11lisov11/mic_practice/artifacts/ipm_sd_fix_20261006/REPORT_RU.md

# Исправление SD и рабочая прошивка, 06.10.2026

## Итог

Исправлена реакция реального MCSDK-образа на внешний SD/BKIN.
Новый build Nucleo: 2026100601. Он установлен и проверен на плате.
UNO Q остаётся на рабочем build 2026092901; Linux HMI ранее обновлён.
Конечное состояние SAFE/VF, PWM=0, частота=0, disarmed, HV-профиль.
Сеть, силовая шина и двигатель в этом прогоне не включались; J4 не включался.
Разрешение на моторный пуск от сети этим отчётом не выдаётся.

## Изменение кода

В TIMx_BRK_M1_IRQHandler оба источника BRK/BRK2 теперь вызывают
PWMC_DP_Handler вместо PWMC_OVP_Handler. SD больше не классифицируется
как перенапряжение и не устанавливает BrakeActionLock.
Пороги Vbus, температура, PWM, deadtime и AutomaticOutput не ослаблялись.
Регрессионные guards в preflight и safety-check отвергают возвращение OVP.
При регенерации проекта эту проверку нужно прогонять, иначе изменение
сгенерированного IRQ-файла может быть перезаписано Workbench.

## Доказательства

| Проверка | Результат |
|---|---|
| STM32CubeIDE сборка | 0 ошибок, 0 предупреждений |
| Реальные C-функции IRQ/DP с host stubs | 4 комбинации флагов Break прошли |
| Программные тесты | 20 групп прошли |
| Настройки BKIN на работающей Nucleo | 13 проверок прошли |
| Flash Nucleo | 39020 байт побайтово совпадают с BIN |
| Живые команды Wi-Fi | 8 командных проверок прошли; без ARM |
| Рабочий простой | 60 отсчётов, 48,734 с, +850 UART сообщений, max age 51 мс |
| PWM в простое | Все шесть выходов LOW |

BIN/readback SHA-256:
71a3b59b1fdca9c8fd0e01326e0467c3c40da08246341204a1995b7bf6ef7c82.
HEX SHA-256:
62860c54b1b45c718567373fad7f2c38dc3d6587c0992ff8fa094b8e102d5fb6.

### Реальный IRQ, без генерации PWM

Выполнено внутреннее событие TIM1 EGR.BG при уже снятом MOE.
Адреса CurrentFaults/PastFaults получены из DWARF именно прошитого ELF;
они не угаданы по layout структуры.
PastFaults: 0x0004 -> 0x0404; добавился MC_DP_FAULT=0x0400,
MC_OVER_VOLT=0x0002 не добавился. Saleae одновременно записал все шесть
выходов LOW; Wi-Fi продолжал показывать SAFE/PWM=0.
Тестовый DP-флаг очищен перезапуском того же рабочего образа:
PastFaults вернулся к 0x0004, штатному undervoltage при нулевой шине.

Это проверка программного IRQ на реальном MCU при выключенном PWM.
Она НЕ является новым физическим замыканием SD и НЕ подтверждает
активный shutdown силовых ключей под напряжением.
Первая попытка сохранила регистры, но не смогла экспортировать Saleae
из-за относительного пути; pass=false сохранён. Повтор с абсолютным
путём прошёл: internal_break_no_pwm_retry/report.json.

## Пакеты

Обновлены firmware/ready_to_flash, ready_to_flash_vf_air56b2_20260929,
готовый датированный ready_to_flash_sd_20261006 и все три ZIP.
По 30 артефактов проходят проверку; содержимое ZIP сверено с manifest.
Прежние Nucleo-образы сохранены в previous_release_images для восстановления.
Старые осциллограммы не переобозначены как проверка нового HEX.

## От оператора сейчас ничего не требуется

Принято его сообщение: перемычки штатные заводские, 15 В на драйвере нет.
Фото, перестановки перемычек и повторное замыкание через 1 кОм не запрашиваются.
Это исходные условия оператора, не заявленная независимая проверка перемычек.

После смены build нулевая точка Vbus заново связана с текущей идентичностью
через штатный API: использовано ранее подтверждённое оператором 0 В при той же
обесточенной конфигурации, собрано 20 новых MCU-отсчётов. Прежняя запись
сохранена. Высокая точка не выдумана и HV-разрешение не выставлено.

## Граница следующего этапа

Программный дефект SD исправлен, рабочие образы на платах актуальны.
Следующий контролируемый этап — питание драйверов J4 +15 В при физически
отключённом силовом источнике/DC-вводе, без ARM/START: оценить SD и датчики
через Wi-Fi. Это не разрешение подключать 220 В.
Внешний soft-start, реальные силовые токи/напряжения и работа ключей ещё
не испытаны этим прогоном. Формальные powered-HIL gates остаются открытыми;
нельзя закрыть их компиляцией, прежней диагностикой или нулевыми показаниями.
