11lisov11/mic_practice/artifacts/power_stage_audit_20261006/REPORT_RU.md

# Пассивная проверка силового тракта, 06.10.2026

Последующее исправление выполнено и установлено: Nucleo build 2026100601.
Актуальный результат: artifacts/ipm_sd_fix_20261006/REPORT_RU.md.
Ниже сохранены первоначальные findings, а не описание текущего дефекта.

ШИМ, ARM, START, питание, flash, reset и halt в этом прогоне не включались.
Прочитаны телеметрия по Wi-Fi и регистры G431 через ST-Link HOTPLUG.
Реальный силовой тест IGBT при нагрузке этим прогоном не выполнен.

## Что подтверждено на работающей прошивке

`live_readonly_retry/report.json`: все 13 проверок регистров прошли.
MOE=0; TIM1 Break включён; внешний BKIN активен LOW; инверсия источника
соответствует полярности Break; AutomaticOutput выключен. Interrupt BIE и
NVIC включены. PA6 настроен как AF6 TIM1, open-drain с pull-up, уровень HIGH.
До/после: SAFE, PWM=0, disarmed, Vdc=0, живая связь. Исходный регистровый
журнал сохранён в `registers.log`. Замыкание через 1 кОм повторно не требуется.

## Найденное несоответствие ПО

В `Src/stm32g4xx_mc_it.c` текущего MCSDK-проекта обработчик внешнего BRK
вызывает `PWMC_OVP_Handler`, устанавливающий OverVoltageFlag и BrakeActionLock.
В штатном профиле ST `STEVAL-IPM15B.json` линия MC1 описана как DriverProtection,
активная LOW. Сам IPM формирует SD при OC и UVLO; это не измерение перенапряжения
DC-шины. В библиотеке есть специализированный `PWMC_DP_Handler` с отключением
PWM и driverProtectionFlag. Требуется согласовать IRQ и конфигурацию проекта
с этим источником. Проверка исходников намеренно возвращает false.

Это не доказательство отказа аппаратного Break: его настройка подтверждена.
Это неверная программная классификация/обработка источника аварии. Силовое
включение не выполнялось; текущие MCU-образы этим аудитом не изменялись.
Дальнейшая правка требует сборки нового идентифицированного образа и тестов;
нельзя объявить старый HEX исправленным только по изменению исходников.

Источники: [схема STEVAL-IPM15B](https://www.st.com/resource/en/schematic_pack/steval-ipm15b_schematic.pdf),
[STGIB15CH60TS-L, раздел 4](https://www.st.com/resource/en/datasheet/stgib15ch60ts-l.pdf),
локальный официальный профиль ST MC SDK 6.4.2:
`Utilities/PC_Software/STMCWB/assets/hardware/board/power/STEVAL-IPM15B.json`.

## Перемычки: заводская конфигурация со слов оператора

Прошивка использует Rshunt=0,04 Ом, усиление 2,1 и температурную модель
штатного NTC: V0=0,408 В при 25 C, gain=0,025 В/C. Эти параметры соответствуют
профилю ST. TSO и NTC нельзя считать взаимозаменяемыми при одном коэффициенте.

| Перемычки | Ожидаемая конфигурация |
|---|---|
| SW1, SW2, SW4 | 1–2: усиленные токовые сигналы |
| SW3 | 2–3: NTC; не 1–2 TSO |
| SW5, SW6 | Разомкнуты: режим не single-shunt |
| SW7, SW8 | Замкнуты: три раздельных шунта |

Сверено визуально по UM2014, рисункам 4 и 7; SW3 дополнительно указан в
профиле ST. Оператор сообщил, что ничего не менял относительно завода.
Это принято как исходное условие; запрос фото снят. Независимая визуальная
проверка не заявляется. Ничего переставлять не требуется.

## Сохранённая проверка Vbus

На UNO Q найден один файл `~/.config/mic-ai/vbus_calibration.json`:
есть zero, meter=0 В, 20 отсчётов; high отсутствует. HMI сообщает
`known-HV capture is required`. Это описание сохранённого результата,
не утверждение, что оператор никогда раньше не выполнял измерение.
Повторное измерение в этом прогоне не запрашивалось и не выполнялось.

## Что нельзя подтвердить удалённо сейчас

Без питаемого силового тракта и независимых измерений нельзя проверить
выпрямитель/soft-start, фактические напряжения J4 и bootstrap, проводимость
IGBT, ток под нагрузкой, изоляцию и целостность силовых проводов. Saleae на
выводах Nucleo не измеряет эти величины; уровень SD HIGH не доказывает их.
Моторный пуск остаётся неподтверждённым. Несоответствие IRQ уже устранено
и проверено последующим прогоном; повторная фотография не требуется.
