11lisov11/mic_practice/artifacts/current_pwm_20261007/async_clear_708/REPORT_RU.txt

ОБНОВЛЕНИЕ ДИАГНОСТИКИ 2026100708: УСТАНОВЛЕНО И ПРОВЕРЕНО

Условия
Оператор отключил силовое питание, затем 15 В J4. Перед обновлением
пассивные проверки дождались шины <=2 В, SAFE, PWM=0 и ARM=0.
В этом прогоне двигатель не запускался; ENABLE/START не выдавались.

Что изменено
Nucleo: исправлен повторный захват пустого MCSDK_FAULT после CLEAR,
когда ACK уже очистил маски, но scheduler еще не перевел FAULT_OVER в IDLE.
Захват реальных масок и FAULT_NOW сохранен; блокировка ENABLE при
FAULT_OVER, реакции на UART_NE, watchdog, BKIN и остальные защиты сохранены.
Сверка SHA256 реконструированного исходника 707 подтвердило, что изменены
только build ID и условие захвата диагностического снимка. ADC, PWM и
силовые параметры в этом обновлении не менялись.
Uno Q: новый ID и разрешение декодирования диагностики Nucleo 708.
Linux HMI: сохранение ответа START и быстрых переходов в истории аварии,
без дополнительных RPC во время START; сохранена исходная калибровка.

Проверки на ПК
41 проверка исходного async-ACK сценария воспроизвела старую ошибку.
41 проверка исправленного сценария PASS.
412901 проверка production UART/control, 262144 сочетания команд,
256 однобитных повреждений и обнаружение 10 мутаций PASS.
66312 проверок декодера, 48 flight-recorder, 162 guard,
38 calibration identity, 41 безопасной установки,
12 доступа/heartbeat/STOP и 26 допуска ограниченного пуска PASS.
Статический контракт Uno/Nucleo PASS после актуализации ожидаемых build ID.
Это программные проверки, не измерение силовых токов или напряжений.

Запись и проверка плат
Uno Q 708 записан; loader/sketch verification PASSED (uno_verify.log).
Nucleo 708 записан; CubeProgrammer download verify PASSED.
Дополнительное считывание 40676 байт Nucleo побайтно совпало с BIN.
MCU IDs из Wi-Fi: 2026100708 / 2026100708, диагностика valid=1.
30 пассивных контрольных опросов за 42,292 с: +682 корректных сообщений,
bad_count=0, ошибок integrity/sequence нет. Все наблюдения SAFE/PWM=0/ARM=0,
в начале и в конце шина 1 В.
MCSDK_UNDER_VOLT при выключенной шине ожидается и не маскируется.

Промежуточные остановки установщика сохранены, а не удалены:
install_attempt1.json: Uno записан, Nucleo защелкнул timeout при перезапуске peer.
После проверки выключенных выходов и шины <=2 В выполнен только CLEAR.
install_attempt2.json: обе платы записаны, проверка остановилась на чтении
шины >2 В непосредственно после reset. До дальнейших действий выполнен
новый пассивный опрос: шина 1 В. Затем проведены readback и проверка связи.
Причина краткого показания >2 В отдельно не установлена; обход порога не применялся.
Итог: install_report.json, RESULTS.json; все команды восстановления записаны.

Хэши
Nucleo HEX: 1999ec79cce0bd36110c7b1a9f5481a3417577e032882da2110fad1065c2a6b0
Nucleo BIN: 66a0851c0d129ef9a4edbe5457a4ef8f4b0e6b5e2aad797e75842b03e47a2cce
Uno sketch: 774f2e06ef8719caaeea09f6381d2cf2c2293125e43d54370339764ea2c1e3be
Linux HMI: fbf9de8e875f4ecc565a8385c3f4c6e4f4d81b0bbd0c630c5b14308d10d82fbf
Исходная калибровка: a89603c26f3dfa6287c304134121028db6ebdb9adeda4b58d99040530ffeea17
Хэши HMI/калибровки подтверждены на плате после обновления.

Ограничения
UART_NE и I2C сбой при силовом ШИМ НЕ устранены этим обновлением.
Их физическая причина пока неизвестна. Движения в последнем HV-пуске не было.
Силовой запуск, фазные токи/напряжения, автономная устойчивость под коммутацией
и скорость AS5600 не приняты. Это не разрешение на следующий HV-пуск.
Готов архив diagnostic_update_2026100708.zip с точными образами и манифестом.
Предыдущий полный ready_to_flash пакет не заменялся.
Следующее действие: проверить реальные соединения UART/GND и питание плат/датчика
на обесточенном стенде, затем выбрать безопасный способ измерения помех при коммутации.
