11lisov11/mic_practice/artifacts/current_pwm_20261007/fault_context_logging_r1/REPORT_RU.txt

Логирование аварий установлено на Linux Uno Q 07.10.2026.

Установленный server.py:
8091c26a8e260ff016ff116ac21436a72b2fbce6b637c2508cdba15f5c748d64
Резервная копия предыдущего сервера:
/home/arduino/ArduinoApps/UNOQ_MOTOR/web_hmi/backups/vbus_reuse_20261007_161547
Прошивки Uno Q и Nucleo не изменены: обе 2026100707.
Калибровка не изменена; SHA256 файла:
a89603c26f3dfa6287c304134121028db6ebdb9adeda4b58d99040530ffeea17

Новый формат: MC_FAULT_CONTEXT, schema mic_ai.fault_context.v1.
При новом событии сохраняются последние доступные наблюдения за 5 секунд,
снимок аварии и дальнейшие наблюдения за 5 секунд под одним event_id.
Объём памяти ограничен 64 снимками. Во время активного управления берутся
существующие опросы watchdog; в простое добавлен опрос раз в секунду,
чтобы собирать предысторию даже без открытой страницы телефона.
Обычный STAT может ограничиваться частотой, запись нового события — нет.

Записываются UART NE/FE/ORE/PE, первая причина и последняя причина роста
счётчика, seq, снимок масок MCSDK, PWM/state, напряжение и его свежесть,
температура, ошибки/состояние I2C AS5600, параметры связи и идентичности.
Шаблон первого диагностического снимка MCSDK не выдаётся за текущую
аппаратную маску; отметка времени — момент наблюдения Linux, не точное
время аппаратного IRQ. Между опросами возможны незафиксированные импульсы.
Поля токов/скорости Uno Q не используются как доказательство физического
тока или вращения двигателя. Источник электрической помехи не установлен.

Событие хранится в существующем persistent-журнале Uno Q и выгружается
по Wi-Fi через защищённый /api/logs. В /api/status доступны
hmi_fault_log_schema, hmi_last_fault_event_id, hmi_last_fault_summary.
Холодный старт закономерно имеет пустую предысторию; дальнейшие события
получают накопленные снимки. Ротация журнала ограничивает срок хранения.

Проверки:
43 проверки регистратора, включая проигрывание неудачного силового пуска,
сохранение NE и роста I2C 0->5, параллельные запросы без дублей,
ограничения памяти, сброс/CLEAR, выгрузку JSON и автономный холостой опрос.
66056 проверок декодера причин, 162 проверки защит HMI,
12 проверок доступа/heartbeat/STOP, 35 проверок калибровки,
37 проверок безопасной установки сервера — пройдены.
Живая проверка: 671 новое сообщение за окно приблизительно 30 секунд,
новых ошибок нет; SAFE, PWM=0, ARM=0. По Wi-Fi скачаны 6 новых блоков
регистратора: одно событие низкого напряжения при старте сервиса и
5 последующих снимков. Это не новый силовой пуск и не доказательство
устранения помех UART.

Следующее действие оператора:
Для отдельного диагностического повторного пуска убрать USB обеих плат
от ПК и все провода логического анализатора, включая GND. Оставить
автономное питание и Wi-Fi. Силовой ввод до проверки автономного состояния
не подавать. После готовности выполняется отдельный ограниченный тест;
ошибка не игнорируется, защиты и обязательный STOP остаются включены.
