11lisov11/mic_practice/artifacts/current_pwm_20261007/full_debug_r1/REPORT_RU.txt

Дебаг стенда и программной части, 07.10.2026

Область: USB-подключённый обесточенный стенд, команды по Wi-Fi,
проверки кода на ПК и индикации. Это НЕ приёмка силового пуска двигателя.

Найдены и исправлены:
1. Веб-ползунок показывал локальную рабочую уставку freq вместо принятого
   задания freq_cmd. Задание теперь постоянно видно числом; проверены
   нулевое задание, режим SAFE, перетаскивание и некорректные числа.
2. Пассивная проверка связи ошибочно считала остановкой UART насыщение
   счётчика корректных пакетов на 65535. Теперь учитывается изменение
   номера принятого ответа; неизменный номер и устаревшие данные не проходят.
   После насыщения точное количество новых пакетов не заявляется.
3. Истёкший срок самотеста матрицы не очищался и мог снова считаться активным
   примерно через 25 суток. Исправлены очистка срока и переход millis через
   ноль. Общая функция используется и отрисовщиком, и телеметрией.

Установлено:
- Uno Q MCU: 2026100709; запись и независимая проверка образа прошли.
- Nucleo: остаётся 2026100708, в этом прогоне не перепрошивалась.
- Linux HMI и веб-индикация обновлены, резервные копии сохранены на Uno Q.
- Файл калибровки не изменён, совместимость подтверждена тестами.
- Отдельная обратная реконструкция исходника 708 побайтно подтверждает:
  изменения Uno ограничены идентификатором и временем самотеста матрицы.
  Алгоритмы управления, ADC, UART, защиты и формат измерений не менялись.

Подтверждено:
- 17 из 17 выбранных программных наборов тестов прошли на конечном коде.
  Это не утверждение о выполнении всех существующих тестов репозитория.
- 8 браузерных сценариев прошли на desktop/mobile; все запросы перехвачены,
  команд стенду браузерные проверки не посылали.
- Отрисовщик: 1000 значений частоты, 48148 проверок; тесты обнаруживают
  намеренную подмену задания нулевой уставкой и всех цифр нулём.
- На самой Uno Q прочитана SRAM матрицы без сброса, останова CPU и записи.
  Кадры для 0, 5 и 20 Гц соответствуют ожидаемым 104 пикселям;
  изменяющийся индекс сканирования подтверждает работу таймера матрицы.
- Повторный 30-секундный пассивный прогон после прошивки: 393 новых
  корректных сообщения, максимальный возраст ответа 49 мс, новых ошибок нет.
- AS5600 отвечает по I2C без ошибок, но сигнализирует слабое магнитное поле:
  enc_status=0x33, enc_ok=0. Угол и скорость не квалифицированы как измеренные.
- На конечной версии по Wi-Fi приняты MODE VF и задания 5/20/0 Гц,
  подтверждён STOP, выгружены журналы. Проверка прошла только без включения
  ШИМ; ARM/START не выдавались. Финально SAFE, ШИМ 0, задание 0, ARM 0.

Что остаётся открытым:
- Наблюдаемое пользователем свечение матрицы: результат видимого самотеста
  ещё не получен. Правильные кадры и работа таймера не заменяют фото/наблюдение
  физических LED. Причина сообщения «постоянные нули» пока не установлена.
- Причина UART NE при предыдущих силовых пусках не установлена. Исправление
  индикации и проверки счётчика не устраняет и не доказывает устранение NE.
- Питание от PC USB не подтверждает автономный общий провод после удаления
  отдельного GND-проводника UART.
- Release preflight не проходит два аппаратных пункта: подтверждение
  автономного soft-start и связанное с образом свидетельство SD/BKIN.
  Статические настройки и host-тест SD проходят, новые измерения силового
  тракта и аппаратного отключения в этой сессии не выполнялись.
- Старые готовые к прошивке пакеты автоматически не заменялись; актуальный
  образ Uno находится в подпапке uno_matrix_709 этого отчёта.

Итог: программный прогон выбранных частей и низковольтная связь проходят.
Полная приёмка проекта, физическое исправление матрицы и успешный пуск
двигателя НЕ объявляются. Силовое включение этим отчётом не разрешается.

Основные доказательства: RESULTS.json, regressions_709/report.json,
matrix_709_live/report.json, passive_709/report.json, matrix_709_install.json,
matrix_only_source_audit.json, release_preflight.json.
