11lisov11/mic_practice/artifacts/current_pwm_20261007/ground_wire_removed_usb_wifi_commands_r1/REPORT_RU.txt

ПРОВЕРКА ПОСЛЕ УДАЛЕНИЯ ОТДЕЛЬНОГО ПРОВОДА GND, USB ПЛАТ К ПК ОСТАЮТСЯ

07.10.2026, Uno Q / Nucleo: 2026100708 / 2026100708.
USB Uno Q обнаружен ADB, Nucleo обнаружена как ST-Link COM13.
Телеметрия перед тестом: SAFE, PWM=0, ARM=0, шина 0 В, UART counters=0.
Удаление провода сообщил оператор; маршрут общей опоры не измерен.

Пассивный прогон: ../ground_wire_removed_pc_connected_r1/report.json.
За окно наблюдения 30 с получено 389 новых корректных UART сообщений.
Максимальный наблюденный возраст UART: 53 мс.
Новых ошибок UART (включая аппаратный bad_count), integrity/sequence и I2C нет.
AS5600 отвечает, но magnet_angle_valid=false: скорость/угол не приняты.

Функциональная проверка по Wi-Fi: report.json и wifi_logs.txt.
MODE VF, SET FREQ 5, SET FREQ 20, SET FREQ 0 приняты.
Задания freq_cmd проверены отдельными чтениями телеметрии.
STOP подтвержден; все наблюдения SAFE/PWM=0/ARM=0 при нулевой шине.
ARM/START не выдавались, защиты не отключались, MCU не перепрошивались.
Изменение задания не означает измеренную электрическую частоту или вращение.

ОГРАНИЧЕНИЯ
USB обеих плат к ПК может обеспечивать общую землю через компьютер.
Этот прогон не доказывает общую опору после отключения ПК и не проверяет
устойчивость UART/I2C при коммутации силового инвертора.
Нельзя заключать, что устранены UART_NE или причина неудачного HV-пуска.
Следующий отдельный этап: автономная схема питания с подтвержденной общей
опорой для прямого UART, сначала без силового. Силовой тест при USB к ПК
для этого неизолированного стенда не выполняется.
