11lisov11/mic_practice/artifacts/current_pwm_20261007/production_trial_707_logging_r2/REPORT_RU.txt

ПУСК 07.10.2026 С РАСШИРЕННЫМ ЖУРНАЛОМ: НЕУСПЕШНЫЙ

Состояние: рабочие MCU 2026100707/2026100707, команды и журналы по Wi-Fi,
USB плат и анализатор отключены. Запрошен один ограниченный пуск V/f
с заданием 10 Гц. Повторного запуска после отказа не было.

Наблюдения
1. До START: SAFE, PWM=0, шина 322 В, bad_count=0, I2C errors=0.
2. После CLEAR: текущий fault=0, но first_reason сохранил MCSDK_FAULT,
   state=11 (FAULT_OVER), current/occurred masks=0/0, seq=32.
3. START принят: VF_RUN, PWM=1 по телеметрии контроллера, шина 319 В.
   Уже в ответе START AS5600 I2C bus_ok=0, errors=1, io_error=-5.
4. К первому наблюдению тестового цикла (1,297 с от начала запроса START):
   SAFE, PWM=0, bad_count=1, last_bad_reason=12 (UART_RX_ERROR), flags=0x04 (NE).
   Wi-Fi heartbeat без ошибок; шина 322 В. I2C связь к этому моменту восстановилась.
5. Финальный STOP подтвержден HTTP 200, SAFE, PWM=0, ARM=0, estop=1.
6. Оператор сообщил: вал не двигался, силовое питание выключено.
7. Последующий пассивный опрос: SAFE, PWM=0, ARM=0, шина 30 В.
   Это не подтверждение полного разряда и не разрешение подключения USB.

Полный журнал аварии
event_id: 5e3cada2c7bc5e12
7 наблюдений до ошибки и 5 после; последнее через 4,291 с после обнаружения.
История и хронология: fault_context_complete.json, fault_timeline.json.
Полный экспорт по Wi-Fi: wifi_logs_complete.txt.
Точность времени: время наблюдения Linux/RPC, не время IRQ микроконтроллера.
Самостоятельная история журнала не содержала короткого VF_RUN; его подтверждает
сохраненный start_response в report.json. Локальная доработка устраняет этот пробел.

Что установлено и что НЕ установлено
Команда по Wi-Fi дошла; контроллер сообщил работающий PWM, затем отказ RX UART.
Программная остановка с фиксацией ошибки подтверждена телеметрией.
Одновременное ухудшение UART/I2C воспроизвелось во втором HV-пуске.
Это основание исследовать сигнал RX, опорную землю и питание во время коммутации,
но не доказательство конкретного кабеля, источника помех или просадки питания.
Физические импульсы IPM, фазные напряжения и токи в этом пуске не измерялись.
Скорость AS5600 невалидна; местные speed/freq/ia/ib/ic Uno не являются
подтвержденными измерениями скорости и фазных токов двигателя.
Нельзя считать двигатель, силовой тракт или устойчивость UART при PWM принятыми.

Найденная отдельная ошибка диагностики
MCI_FaultAcknowledged очищает PastFaults и ставит команду ACK, но FAULT_OVER -> IDLE
происходит в следующем medium-frequency task. uno_send_reply успевает снова
записать MCSDK_FAULT с пустыми масками после CLEAR. Так исторический снимок
маскирует первую причину следующего отказа; поле last_bad все же сохраняет NE.
Раньше host mock MC_AcknowledgeFaultMotor1 синхронно устанавливал IDLE
и не моделировал этот переход.

Новый offline-тест: ../async_clear_diagnostics_r1/report.json.
Исходный код воспроизвел ошибку (41 проверка), диагностический кандидат
сохранил реальную первую причину (41 проверка). Кандидат меняет только
условие захвата пустого FAULT_OVER-снимка. FAULT_NOW, реальные fault masks,
запрет ENABLE при FAULT_OVER и остановка по NE сохраняются.
Кандидат проверен с host mocks, не собран и НЕ прошит на Nucleo.
Он исправляет атрибуцию ошибки, а не причину UART_NE.

Локальная доработка Linux-журнала (НЕ развернута на стенде)
Сохраняется уже полученный ответ при подтверждении START, без дополнительных RPC.
Краткие переходы state/PWM/fault/I2C сохраняются внутри обычного интервала
дискретизации; буфер по-прежнему ограничен 64 наблюдениями и окном 5 с.
48 проверок recorder PASS; 162 guard PASS; 66056 decoder PASS;
12 access/heartbeat/STOP PASS; 35 calibration identity PASS.
Защиты, калибровка, MCU прошивки, параметры PWM не менялись.

Дальше
Не повторять HV-пуск без разбора устойчивости UART и питания при коммутации.
Сначала завершить разряд; подключение ПК только после отключения силового ввода
и проверки напряжения мультиметром. Затем проверить реальные маршруты
RX/TX/GND, места соединения общих проводов и питание Uno/Nucleo/AS5600.
Измерения на включенном неизолированном силовом стенде требуют подходящих
изолированных средств; обычный USB-анализатор не использовать.
Не отключать реакцию на NE и не снимать защиты ради продолжения вращения.
