11lisov11/mic_practice/artifacts/live_bench_20261008/read_only_connected_r1/REPORT_RU.txt

ПАССИВНАЯ ПРОВЕРКА ПОДКЛЮЧЁННОГО СТЕНДА, 08.10.2026

Установленные версии по телеметрии: UNO Q 2026100709 / Nucleo 2026100708.
Подготовленная версия Nucleo 2026100801 ещё не записана.
Не выполнялись START, ARM, CLEAR, STOP, сброс или прошивка плат.

Wi-Fi и UART
Статус и журналы получены через HTTP по Wi-Fi 192.168.1.138:8080,
с транспортом WSL; данные не передавались через ADB-forward.
ADB использован отдельно для инвентаризации и чтения ключа доступа к логам.
За 30-секундный прогон: 399 новых UART-сообщений,
56 наблюдаемых изменений ACK-последовательности, максимальный возраст 52 мс.
Счётчики UART/целостности/последовательности не выросли, ошибок I2C нет.
В выборках SAFE, PWM=0, ARM=0, Vdc=0 по телеметрии, калибровка принята HMI.
Эти сведения не заменяют проверку мультиметром и физического отключения ввода.

Анализатор
Обнаружен физический Saleae A7D1BB81883C0092.
Сохранены capture.sal и CSV, выборка 4 МГц, фактическая длительность 0.24576 с.
Все CH0..CH5: LOW, 0 фронтов. CH6: HIGH, 0 фронтов.
CH6 трактуется как PA6 согласно ранее согласованной разводке;
само соответствие проводов независимо не проверялось.
Первый экспорт с относительным путём завершился ошибкой каталога.
Повтор с абсолютным путём успешен; это не ошибка прошивки.

Диагностика
Текущая зарегистрированная причина: MCSDK_FAULT.
В снимке first_current_mask=0x0004 (MC_UNDER_VOLT), UART flags=0.
Накопленная маска first_occurred_mask=0x0404:
MC_UNDER_VOLT | MC_DP_FAULT. Физическая причина исторического DP-флага
этим пассивным наблюдением не устанавливается; счётчики не очищались.
AS5600 отвечает по I2C без новых ошибок, но enc_ok=0, status=0x33.
Угол не подтверждён как достоверный; показание 340.8 градуса не используется
как доказательство исправности позиционной обратной связи.

Границы результата
Подтверждены Wi-Fi-чтение, продвижение UART и статические уровни входов Saleae.
Не подтверждены активная несущая ШИМ, фазировка, deadtime, реакция BKIN на
работающем ШИМ и работа с силовым питанием.
Новое исправление UART 801 на этой плате пока не проверено, поскольку стоит 708.
Новая ошибка UART в этом прогоне не наблюдалась.
