11lisov11/mic_practice/BLUEPILL_THERMAL_DIAGNOSTIC_RU.md

# Проверка нагрева Blue Pill

Эта процедура предназначена только для платы, у которой нагревается корпус STM32F103. Её нельзя подключать к STEVAL-IPM15B, двигателю или силовой шине во время диагностики.

## Подготовка

1. Полностью снять J7/310 В и 15 В со STEVAL.
2. Отсоединить от Blue Pill все провода: IPM, UNO Q, AS5600, Saleae, реле и датчики.
3. Осмотреть пайку, остатки флюса, перемычки и ориентацию STM32.
4. На обесточенной плате проверить сопротивление между `3V3-GND` и `5V-GND`; явное короткое замыкание блокирует дальнейшее включение.
5. Питать голую Blue Pill от источника с ограничением тока. Начать с лимита `50 мА`; если старт не происходит, поднять не более чем до `100 мА` только для диагностики.
6. Немедленно снять питание, если ток упирается в лимит, корпус STM32 быстро нагревается или температура корпуса превышает примерно `50 °C`.

## Этап 1: минимальная прошивка без UART

```powershell
py -3 -m platformio run -d C:\mic_practice\bluepill_uart_pwm_pio -e bluepill_thermal_diag -t upload
```

Прошивка использует только HSI 8 МГц и коротко мигает PC13 один раз в секунду. Все прикладные GPIO переведены в аналоговый высокоимпедансный режим, SWD оставлен включённым.

Оставить плату включённой не более 2 минут, контролируя ток и температуру. Если сам STM32 греется уже здесь на полностью голой плате, плата считается повреждённой и больше не используется с IPM.

## Этап 2: только UART

Выполнять только если этап 1 не вызвал нагрева.

```powershell
py -3 -m platformio run -d C:\mic_practice\bluepill_uart_pwm_pio -e bluepill_thermal_diag_uart -t upload
```

Подключение UART после запуска:

| Blue Pill | UART-адаптер или UNO Q | Назначение |
|---|---|---|
| `PA2/TX` | `RX` | строка `BLUEPILL_THERMAL_DIAG_UART` раз в секунду |
| `PA3/RX` | `TX` | вход, данные не обрабатываются |
| `GND` | `GND` | только в низковольтном тесте без STEVAL/J7 |

Сначала соединить только `GND` и `PA2 -> RX`. Если нагрева нет, добавить `TX -> PA3`. На обоих UART-сигналах допустим только уровень `3,3 В`.

## Интерпретация

- Нагрев на этапе 1 означает повреждение STM32, платы или стабилизатора/питания.
- Нагрев появляется после соединения UART: проверить перепутанные TX/RX, подачу 5 В на GPIO, питание двух плат от разных источников и обратное питание через сигнальные выводы.
- Нагрев появляется только на полной прошивке: не подключать IPM; проверять конфликт GPIO и внешнюю нагрузку по одному проводу.
- Исправная запасная Blue Pill в тех же условиях является контрольным образцом, но подозрительную плату нельзя возвращать в силовой стенд только потому, что она временно перестала греться.
