11lisov11/mic_practice/docs/AIR56_NAMEPLATE_WEB_AUDIT_RU.md

# Проверка АИР56 по открытым паспортам и совместимости с IPM15B

Дата проверки: 2026-08-21.

## Вывод

Одной надписи `АИР56` недостаточно: серия содержит разные мощности и числа полюсов. Оператор указал именно `АИР56В2`; для первого разомкнутого V/f используем паспортные данные официальной таблицы IEK. Это подтверждает конфигурацию выбранной модели, но не индивидуальные параметры конкретного экземпляра и не заменяет аппаратный допуск к силовому пуску.

Актуальный V/f-проект находится в `mcsdk_reference/AIR56B2_025KW_220V_DELTA_NAMEPLATE_VF_NOT_FOR_HV`. Старый Siemens reference не использовать для этого двигателя.

## Что дают открытые каталоги

В опубликованной таблице серии АИР/DRIVE приведены следующие разные исполнения с рамой 56 мм:

| Маркировка | Pn | n | U | In Delta/Y | Следствие |
| --- | ---: | ---: | --- | --- | --- |
| АИР56A2 | 0.18 kW | 2700 rpm | 220/380 V | 0.93/0.54 A | 1 пара полюсов |
| АИР56A4 | 0.12 kW | 1325 rpm | 220/380 V | 0.84/0.49 A | 2 пары полюсов |
| АИР56B2 | 0.25 kW | 2720 rpm | 220/380 V | 1.24/0.72 A | 1 пара полюсов |
| АИР56B4 | 0.18 kW | 1325 rpm | 220/380 V | 1.14/0.66 A | 2 пары полюсов |

Это только каталожная справка: у разных заводов и исполнений значения отличаются. В частности, опубликованные таблицы не подтверждают прежнее предположение `AIR56, 0.25 kW, 1380 rpm, 380 V Y` для данного экземпляра.

Для подтверждённой оператором модели `АИР56B2 0.25 kW` V/f-профиль `docs/mcsdk_acim_motor_profile.iek_air56b2_catalog_operator_confirmed_vf_candidate.json` использует `220 V Delta`, `1.24 A`, `50 Hz`, `2720 rpm`, `1` пару полюсов. Проверка `--control-mode vf` принимает этот профиль как паспортный кандидат; `--control-mode foc` отвергает его до измерения параметров модели. Оба режима отдельно требуют аппаратных HIL-доказательств.

Источник паспортных величин: [таблица IEK DRIVE](https://cdn-01.iek.ru/media/original/78c31060549010eaa9a1bb1f4f6d2d8cb3155062b138bfd13478f55521c38a47.pdf), строка `АИР56В2`.

## Напряжение и соединение

Официальная страница `STEVAL-IPM15B` указывает вход `125...400 V DC`. На схеме стенда 220 VAC после моста даёт примерно 310...325 V DC. Теоретический максимум линейного действующего напряжения инвертора в этом диапазоне примерно 220...230 V.

Поэтому:

- если на шильдике действительно `220/380 V Delta/Y`, для этой силовой части следует использовать `220 V Delta`; перемычки в клеммной коробке ставятся в Delta, а параметры MCSDK должны быть сгенерированы именно для Delta. `220 V Star` для такого мотора неверно: на каждой обмотке будет около `127 V`, то есть ниже номинала `220 V`;
- вариант `380 V Y` требует около `sqrt(2) * 380 = 537 V DC`, что одновременно выше шины стенда и выше официального предела `400 V DC` платы `STEVAL-IPM15B`; применять его с этой платой нельзя;
- если шильдик содержит только `380 V Y`, этот мотор несовместим с данным 220 VAC + IPM15B стендом без другой сертифицированной силовой части. Не пытаться получать 540 V DC на IPM15B.

Официальные данные платы: [ST STEVAL-IPM15B](https://www.st.com/en/evaluation-tools/steval-ipm15b.html), [UM2014](https://www.st.com/resource/en/user_manual/um2014-1500-w-motor-control-power-board-based-on-stgib15ch60tsl-sllimm-2nd-series-ipm-stmicroelectronics.pdf).

## Дальнейшая идентификация

Для начального V/f измеренные `Rs`, `Rr`, `Lls`, `Llr`, `Lm` и инерция не требуются. Перед FOC их получают на конкретном двигателе с протоколом измерения; каталожные значения нельзя выдавать за измеренные. Физическое соединение обмоток должно соответствовать паспортному варианту `220 V Delta`.

После идентификации создаётся отдельный измеренный профиль и заново генерируется FOC-проект. V/f-прошивка не превращается в FOC заменой одного JSON.
