11lisov11/mic_practice/docs/FIRMWARE_STAGES_RU.md

# Этапы прошивок MIC AI

## Базовая конфигурация

Целевой тракт: `UNO Q -> прямой UART -> NUCLEO-G431RB (STM32G431RBT6) -> X-NUCLEO-IHM09M2 -> STEVAL-IPM15B -> AIR56B2`, обмотки двигателя соединены треугольником на 220 В. UNO Q и Nucleo имеют общую `HOT_GND`, электрически равную `STEVAL J7 DC-`, и в силовом режиме находятся внутри закрытого корпуса; наружу выходит только Wi-Fi. Перед выпрямителем устанавливается автономный сетевой модуль плавного пуска с NTC и собственным внутренним реле. Контакта управления этим реле от Nucleo или UNO Q нет.

В протоколе UART старый бит `0x08` оставлен только для совместимости и всегда равен нулю. Nucleo измеряет шину, ждёт диапазон `250...385 В` непрерывно не менее `3,5 с` и только затем разрешает запуск MCSDK. `STOP`, E-stop, ошибка MCSDK или потеря UART немедленно выключают PWM.

## Последовательность

| Этап | Управление | Роль датчика | Текущее состояние |
|---|---|---|---|
| S1 | ACIM V/F бездатчиковое | не используется | исходники и бинарники собираются; первый аппаратный запуск |
| S2 | ACIM LSO-FOC бездатчиковое | не используется | заблокировано до измерения модели двигателя |
| S3 | принятый S1/S2 | AS5600 только эталон/разметка | I2C и ручное вращение проверены; поле при вращении нестабильно, скорость не принята |
| S4 | LSO-FOC основной | AS5600 только для оценки | AI работает в shadow-режиме и не влияет на PWM |
| S5 | AI-наблюдатель + LSO fallback | датчик не требуется в принятом режиме | заблокировано до HIL и доказанной автоматики возврата |

## S1: первый пуск

Используется только `ACIM-NUCLEOG431RB-IPM15B-VF_OL.hex`. Начиная с версии обеих плат `2026100705`, Uno Q передаёт конечное задание частоты; разгон выполняет только Nucleo. Длительность не менее 3 секунд и ограничение не быстрее 5 Гц/с: для 0→10 Гц задано 3 с, для 0→50 Гц 10 с. Неизменные heartbeat-команды не перезапускают разгон. Начинать с 5 Гц без нагрузки, с ограниченным временем запуска. Затем проверить 10, 20 и 30 Гц. Переход к 50 Гц допускается после проверки токов, температуры, формы PWM, направления вращения и стабильной телеметрии.

S1 считается принятым не по факту вращения, а после сохранения журнала: заданная частота, оценка оборотов, `Vbus`, токи, fault-код, состояние E-stop, тайм-аут связи и подтверждение PWM.

Версия `2026100705` отключает только неприменимый к данной топологии локальный порог тока по неподключённым ADC Uno Q; этот порог сохранён для старого локального PWM backend. Защиты MCSDK/IPM и BKIN не отключены. Токи фаз с Nucleo ещё не передаются как квалифицированное измерение. Потеря диапазона удержания шины `200...385 В` вызывает STOP в основном цикле Nucleo без ожидания новой команды UART; восстановление напряжения не снимает защёлку. Успешное вращение после этих изменений ещё не подтверждено. Результаты: `artifacts/startup_recheck_20261007/RESULTS.json`.

Повторная проверка 07.10.2026: Uno Q обновлена до `2026100706`, Nucleo остаётся `2026100705`. Задание 0 Гц в активном V/f вызывает штатный STOP, а не ENABLE с нулевой частотой. Повторный RUNLIMIT не продлевает уже действующий срок; RUNLIMIT=0 при активном приводе вызывает STOP. Нулевая временная метка при переполнении счётчика больше не отключает лимит. Проверки выполнены на исходном коде с заглушками; физический пуск после обновления ещё не принят.

## S2: LSO-FOC

Бинарник LSO-FOC нельзя формировать как готовый к силовой прошивке из каталожных данных. Перед генерацией нужны измеренные `Rs`, `Rr`, `Lls`, `Llr`, `Lm` и момент инерции с отчётом происхождения. Параметры из демонстрационного проекта ST не являются параметрами AIR56B2.

После заполнения профиля `source_kind=nameplate_and_measurement` отдельный проект создаётся командой:

```powershell
.\tools\prepare_air56_lso_foc.ps1 `
  -MotorProfile C:\path\to\air56_measured.json `
  -OutputProject C:\mic_practice\mcsdk_reference\generated\AIR56B2_LSO_FOC
```

Сценарий берёт LSO-структуру из официального примера MCSDK 6.4.2, переносит только измеренные параметры AIR56B2, сохраняет UNO Q interlock, собирает проект и требует полный release-gate. При неполном профиле бинарник не создаётся.

## S3: AS5600 как учитель

AS5600 не включается в контур первого пуска. После принятия S1 он используется для независимой разметки положения и скорости. Набор данных записывает `tools/capture_as5600_teacher_dataset.py`; файл отклоняется при ошибке датчика, fault-коде, активном устаревшем бите реле или недостаточной доле валидных отсчётов.

Текущий транспорт AS5600: Uno Q `SDA/D20/PB11` и `SCL/D21/PB10`, шина I2C2, адрес `0x36`, 100 кГц. Это контакты возле AREF, не A4/A5 и не Qwiic/I2C4. Питание модуля, поддерживающего 3,3 В, берётся с 3V3 Uno Q; GND общий. Старые схемы с Qwiic требуют актуализации перед монтажом. Драйвер в версии Uno Q `2026100612` опрашивает датчик в отдельной задаче Zephyr и не передаёт его угол в закон V/f. `enc_bus_ok` отражает свежий ответ шины, `enc_ok` дополнительно требует корректного магнитного поля; `enc_speed_ok` отличает валидную оценку скорости от прогрева и пропусков выборки. `enc_init_error`, `enc_scl`, `enc_sda` служат диагностикой, а не доказательством правильного монтажа.

Нельзя подключать AS5600 к UART, связывающему Uno Q MCU и Nucleo. Штатный разъём `Encoder/Hall` STEVAL предназначен для сигналов `A/B/Z`, а не для I2C. Чтение AS5600 ещё не является принятой аппаратной разметкой S3: требуется стабильное поле на полном обороте и оценка точности скорости. Сохранённая проверка Vbus повторяется только при изменении измерительного тракта или неизвестной прошивке; проверенные диагностические обновления сохраняют её согласно `docs/AUTONOMOUS_VBUS_CALIBRATION_RU.md`.

## Диагностика отказа при первом пуске

Пуск 07.10.2026 по Wi-Fi был принят рабочей Nucleo `2026100601`, но к 0,81 с от команды START контроллер уже вернулся в SAFE с кодом `5` и новым `bad_count=1`. Оператор движения вала не наблюдал. Причина этого старого события не восстановлена: прошивка объединяла несколько ветвей отказа в `UNO_FAULT_INTERNAL`. Нельзя называть это установленной перегрузкой, помехой UART или отказом IPM.

В окончательной версии пары Uno Q/Nucleo `2026100704` добавлено наблюдение, не отменяющее защиты и не меняющее V/f:

- первая обнаруженная причина, состояние MCSDK, текущая и накопленная маски MCSDK, последний принятый seq и HAL-статус TX;
- отдельно причина последнего увеличения `bad_count`, последние флаги USART `PE/FE/NE/ORE` и статус передачи;
- первая причина не заменяется STOP/ESTOP; сброс выполняется только штатным чистым CLEAR;
- причина выводится в API и HMI, запись `MC_FAULT_DIAG` не ограничивается периодом обычного журнала STAT;
- UART остаётся v0x02, 32 байта. Диагностический тег `0x90` использует свободные поля ответного кадра MCSDK; байт реле остаётся нулём, поля Vbus/температуры/build ID не сдвинуты. RPC v3 расширен с 79 до 91 элементов добавлением в конец;
- `ia/ib/ic` существующей Uno Q пока являются её локальными ADC-отсчётами, а не принятой телеметрией фазных токов Nucleo. По ним нельзя доказывать перегрузку двигателя или качество токового ограничения.

В обесточенном прогоне промежуточной `2026100702` обнаружено увеличение счётчика с `last_bad=UART_RX_ERROR`, `last_UART_flags=0x08` (ORE). Это конкретное переполнение USART, но не доказательство причины прежнего силового события. В `2026100704` приём перенесён в `USART1_IRQHandler`: включён аппаратный FIFO и SPSC-очередь на 128 байт (127 полезных). ISR только читает байты/флаги; разбор кадров, MCSDK-вызовы и фиксация остановки остаются в основном потоке. Приоритет UART `3` ниже ADC `2`, но выше SysTick `4`, чтобы принимать данные во время среднечастотной задачи; приоритеты существующих ADC/TIM не менялись. Аппаратный BKIN отключает таймер независимо от UART IRQ; новую задержку программного обработчика BKIN отдельно не измеряли. Ошибки USART и переполнение очереди по-прежнему останавливают привод и требуют CLEAR. Переполнение очереди имеет собственную причину `RX_BUFFER_OVERFLOW` (`14`).

Модельные проверки запускаются `tools/production_mcsdk_link_dynamic_selftest.py` и `tools/fault_diagnostics_selftest.py`. Только чтение с физического стенда и выгрузка журнала: `tools/capture_fault_diagnostics.py --logs --outdir <новый каталог>`. Однократный пуск: `tools/wifi_motor_first_start.py --confirm-operator-ready --outdir <новый каталог>`; требует обе сборки `2026100704`, достоверную диагностику, рабочую шину, отсутствие неисправностей и оператора у аварийного выключателя. Не выполнять с USB/ST-Link/Saleae на силовом стенде. Исправление RX и успешная диагностика не являются доказательством вращения двигателя или приёмкой силового режима.

## S4 и S5

В S4 нейросеть получает те же входные признаки, что планируются для бездатчикового режима, но её оценка только журналируется и сравнивается с AS5600. В S5 влияние AI на управление допускается лишь через ограничитель и с детерминированным возвратом к LSO-FOC. До выполнения этих условий отдельного «боевого» AI-бинарника нет.

Машинное описание этапов находится в `firmware/firmware_stages.json` и включается в пакет прошивки.
