11lisov11/mic_practice/docs/IPM_SD_BKIN_HIL_RU.md

# HIL-проверка аварийной линии STEVAL-IPM15B SD -> Nucleo BKIN

## Зачем нужен отдельный тест

Проверка шести сигналов PWM логическим анализатором подтверждает частоту, dead-time и отсутствие перекрытия логических сигналов. Отсутствие сквозного тока IGBT и аварийное отключение силового модуля этим не подтверждаются. Поэтому `ipm_sd_bkin_hardware_trip_validated` остаётся отдельным обязательным release-gate.

## Проверка MCSDK 6 октября 2026

Подготовлена и испытана отдельная обесточенная оснастка именно рабочего
MCSDK-бэкенда: [методика](MCSDK_LOGIC_BENCH_RU.md). Шесть выходов работают
на 16 кГц; измеренный минимальный deadtime около 1,333 мкс при задании
1350 нс, перекрытие не обнаружено. Проверены генератор V/f на 5/20 Гц,
непрерывные START/STOP/ESTOP, внутренний `EGR.BG` при активном PWM и
входной тракт BKIN краткой сменой входной полярности.

PA6 в этих опытах оставался HIGH; реальный SD-сигнал IPM не создавался.
Поэтому `ipm_sd_bkin_hardware_trip_validated` не изменён. Код ключевых
PWM/IRQ-функций сопоставлен с производственной сборкой; временные
изменения оснастки перечислены отдельно. Производственная прошивка
`2026100601` восстановлена с побайтовой проверкой flash.

## Ранее выполненные диагностические проверки

Отдельный тест `tools/run_wifi_nucleo_pwm_bench.py --software-break-test`
собирает временный образ с включённым TIM1 BKIN и автоматически генерирует
`TIM1 EGR.BG` через 1,2 с после начала ШИМ. Он проверяет аппаратный сброс
`MOE`, останов шести выходов и защёлку отказа в UART-контроллере. Это
**внутренний software break**, при котором уровень PA6 остаётся HIGH;
он не проверяет провод `STEVAL SD -> IHM09M2 -> PA6` и не закрывает
`ipm_sd_bkin_hardware_trip_validated`. После опыта сценарий возвращает обе
рабочие прошивки.

Захват `artifacts/wifi_nucleo_pwm_bench_20260929_live_r3` не является тестом
BKIN: диагностическая прошивка задаёт `BreakState = TIM_BREAK_DISABLE` и
принудительно держит PA6 низким. Её PWM не доказывает работу аппаратного
разрыва в рабочей прошивке. В рабочем MCSDK-проекте BKIN включён, но при
отключённом силовом входе и измеренных примерно 11 В на шине V/f не выдаёт
PWM: разрешение начинается только после 250 В и выдержки 3,5 с.

Поэтому пассивный захват `PA6=HIGH, CH0...CH5=LOW` при J4=15 В подтверждает
только состояние покоя. Нельзя заполнить `pass=true` ниже на основании
этого захвата, диагностического PWM или одной прозвонки земли. Оснастка
рабочего MCSDK с включённым TIM1 BKIN подготовлена и испытана 06.10.2026;
её отличия перечислены в методике выше. Для доказательства физического
SD остаются отдельные требования этого HIL-протокола. Такое
испытание цепи не заменит проверку рабочей прошивки при допустимой шине;
до неё пуск двигателя не считается подтверждённым. Первый отдельный
контролируемый ввод питания для проверки внешнего плавного пуска и показаний
Vbus без двигателя, ARM и START не является испытанием вращения.

По официальной документации ST:

- `STEVAL-IPM15B J2-1` называется `emergency stop` и электрически связан с двунаправленным open-drain выводом `SD`; контрольная точка этой цепи - `TP23`;
- `X-NUCLEO-IHM09M2 J7-1` проводит этот сигнал на `PA6/PA11 DIAG/ENABLE/BKIN1`;
- в текущем проекте `STM32G431RBT6` выбран `PA6 = TIM1_BKIN`, внешний сигнал активен низким уровнем, а `TIM_AUTOMATICOUTPUT_DISABLE` запрещает самопроизвольное восстановление PWM.

Источники: [ST UM2014](https://www.st.com/resource/en/user_manual/um2014-1500-w-motor-control-power-board-based-on-stgib15ch60tsl-sllimm-2nd-series-ipm-stmicroelectronics.pdf), [ST UM3030](https://www.st.com/resource/en/user_manual/um3030-getting-started-with-the-xnucleoihm09m2-motor-control-connector-expansion-board-for-stm32-nucleo-stmicroelectronics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), [схема X-NUCLEO-IHM09M2](https://www.st.com/resource/en/schematic_pack/x-nucleo-ihm09m2_schematic.pdf).

## Условия низковольтного HIL

Этот тест выполняется отдельно от силового пуска. На этом этапе ПК и Saleae подключать разрешается, потому что сеть и DC-шина физически отсутствуют.

Обязательные условия:

- сетевой ввод отсоединён;
- до подачи J4 мультиметр подтверждает разряд DC-шины до менее `2 В` между `DC+` и `DC-`; после подачи J4 значение на J1 измеряют и записывают отдельно (на этом стенде ранее наблюдалось около `11,7 В`);
- силовой разъём `STEVAL J1` (`INPUT-dc` на схеме и маркировке платы) физически отключён; в таблице разъёмов UM2014 этот же вход ошибочно назван `J7`, что не следует путать с `IHM09M2 J7`;
- двигатель отключён от `J3 U/V/W`;
- используется только низковольтное питание логики и вспомогательное питание `J4`, не выше предела платы;
- общий провод Saleae подключён к общей логической земле только при физически отключённом силовом входе и отсутствии сети; вспомогательные 15 В на J4 допустимы для этого низковольтного этапа.

Не считать отключение сетевого выключателя достаточным доказательством: требуется физически отключённый силовой вход `STEVAL J1` и измеренная разряженная шина.

## Что записать

На Saleae одновременно записываются:

| Канал | Сигнал Nucleo | Назначение |
|---|---|---|
| CH0 | `PA8` | `UH` |
| CH1 | `PA7` | `UL` |
| CH2 | `PA9` | `VH` |
| CH3 | `PB0` | `VL` |
| CH4 | `PA10` | `WH` |
| CH5 | `PB1` | `WL` |
| CH6 | `PA6` или `STEVAL TP23` | `SD/BKIN`, active-low |

Названия относятся к текущему проекту MCSDK для `NUCLEO-G431RB + IHM09M2`; старую распиновку Blue Pill применять нельзя.

Запись должна доказать полный цикл:

1. При высоком уровне `SD` все шесть PWM работают в разрешённом низковольтном тестовом режиме.
2. Перевод `SD` в низкий уровень аппаратно прекращает переключения всех шести выходов.
3. После отпускания `SD` PWM не возобновляется сам.
4. Телеметрия Nucleo содержит ненулевой защёлкнутый отказ и `PWM_ACTIVE=0`.
5. Повторный запуск невозможен без явных `CLEAR`, нового `ARM` и новой команды `START`.

Линию `SD/TP23` разрешается принудительно тянуть вниз только в заранее проверенной низковольтной оснастке с последовательным резистором. Не замыкать контрольную точку случайным проводом и не выполнять этот тест при подключённом силовом входе `STEVAL J1`.

## Протокол доказательства

Release-gate принимает только JSON `mic_ai.ipm_sd_bkin_hil.v1`, связанный SHA-256 с прошитым Nucleo HEX и исходным файлом захвата. Минимальная структура:

```json
{
  "schema": "mic_ai.ipm_sd_bkin_hil.v1",
  "pass": true,
  "tested_at": "2026-09-14T12:00:00+03:00",
  "operator": "Фамилия И.О.",
  "power_stage": "STEVAL-IPM15B",
  "adapter": "X-NUCLEO-IHM09M2",
  "mcu": "STM32G431RBT6",
  "trip_source": "external_sd_pin",
  "conditions": {
    "mains_disconnected": true,
    "dc_bus_below_2v": true,
    "j7_disconnected": true,
    "motor_disconnected": true,
    "auxiliary_vcc_only": true
  },
  "checks": {
    "sd_normal_high": true,
    "sd_forced_low": true,
    "all_six_pwm_inactive_on_trip": true,
    "mc_fault_latched": true,
    "pwm_stays_inactive_after_sd_release": true,
    "explicit_clear_and_rearm_required": true
  },
  "nucleo_hex_sha256": "<SHA-256 прошитого HEX>",
  "capture": {
    "path": "capture/sd_bkin_trip.csv",
    "sha256": "<SHA-256 исходного захвата>"
  }
}
```

Проверка запускается вместе со сборкой:

```powershell
powershell -ExecutionPolicy Bypass -File tools\build_firmware_bundle.ps1 `
  -IpmSdBkinEvidence C:\path\to\ipm_sd_bkin_hil.json
```

До появления такого протокола отсутствие ошибок компиляции, обычная осциллограмма PWM и программный `ESTOP` не закрывают этот gate.

## Результат низковольтной проверки 29.09.2026

При отключённых силовом входе и J4 пользователь измерил `0 В` на `STEVAL J1`. Команда `START` поступила по Wi-Fi на UNO Q и далее по UART на Nucleo. Временная диагностическая прошивка сформировала шесть PWM: около `10,025 кГц`, минимальный dead-time около `2,0 мкс`, без перекрытия верхнего и нижнего ключей. Через `1,2 с` программное событие `TIM1 EGR.BG` вызвало аппаратное снятие `MOE`; все шесть выходов стали низкими и оставались низкими до конца захвата. Nucleo сообщил защёлкнутый `FAULT_BREAK_SELFTEST=7`, повторный `START` без `CLEAR` был отклонён (`HTTP 409`). Во время теста `PA6/SD` оставался высоким.

Исходный отчёт и CSV: `artifacts/bkin_software_break_release_2026092901/report.json` и `software_break_capture/csv/digital.csv`. После автоматического восстановления образов рабочая прошивка UNO Q имеет build ID `2026092901`, Nucleo MCSDK — `2026091401`. Отдельная проверка рабочего простоя (`artifacts/production_2026092901_postbreak_idle/report.json`) прошла 60 выборок за 48,3 с: SAFE, PWM=0, шесть выходов LOW, новых ошибок UART нет, запуск без ARM запрещён.

Это доказательство внутреннего программного break и цепочки команд, а **не** проверки физического сигнала `STEVAL SD → PA6/BKIN` или работы IPM при поданных 15 В и силовой шине. Поле `hardware_validated` в пакете прошивок остаётся `false`; подавать сетевое напряжение на основании этого теста нельзя.

## Переход к автономному HV

После низковольтного HIL все провода ПК, ST-Link, USB, Saleae и осциллографа снимаются физически. Нулевая и рабочая точки Vbus затем проверяются отдельно с телефона по Wi-Fi и автономным мультиметром по `AUTONOMOUS_VBUS_CALIBRATION_RU.md`. Эти две проверки не заменяют друг друга.
