11lisov11/mic_practice/docs/MIC_AI_PDF_AUDIT_RU.md

# Аудит схемы `MIC_AI.pdf` от 2026-06-12

Статус: схема не является схемой сборки для текущего набора `NUCLEO-G431RB + X-NUCLEO-IHM09M2 + STEVAL-IPM15B + UNO Q`. Она показывает предыдущую архитектуру с `STM32F103C8T6` и не должна использоваться для включения силовой части.

## Блокирующие несоответствия

1. В PDF контроллер `U6` - `STM32F103C8T6` (Blue Pill). Фактический проект MCSDK собран для `STM32G431RB` на Nucleo. Номера и функции выводов между ними не переносимы.
2. Катушка `RELAY1` на исходном листе управлялась от `B1` Blue Pill. В актуальной архитектуре MCU-управляемого байпасного реле нет: перед выпрямителем устанавливается автономный внешний модуль плавного пуска, а `PB4` Nucleo оставлен свободным. Поэтому старую часть PDF с `RELAY1` использовать нельзя; в сформированной ревизии 2.2 она удалена.
3. Прошивка Nucleo не управляет внешним soft-start. Она разрешает запуск MCSDK только после непрерывного нахождения Vbus в диапазоне `250...385 В` не менее `3,5 с`; при падении ниже `200 В` или превышении `385 В` готовность сбрасывается. Аппаратное HIL-подтверждение внешнего модуля ещё не выполнено.
4. `U3` обозначен как сам модуль `STGIB15CH60TS-L`, а не как плата `STEVAL-IPM15B` с 32-pin интерфейсом и `X-NUCLEO-IHM09M2`. Поэтому документ не описывает фактические разъёмы, джамперы single/three-shunt и контактную распиновку используемых плат.
5. На листе не показан установленный DC-link bulk-конденсатор. По UM2014 у STEVAL-IPM15B на плате есть посадочное место, но конденсатор не ставится по BOM и должен быть выбран под приложение. Не включать мост, предзаряд или PWM, пока не определены его ёмкость, допустимый пульсационный ток, рабочее напряжение и монтаж.
6. Называть минус выпрямителя `GND` нельзя без уточнения домена. На листе такой `GND` повторяется и для HV-шины, и для 15/5/3.3 V. Это легко соединяет USB/ST-Link, ПК и логику с VDC-. У платы ST все цепи не изолированы от линейного ввода; подключение USB, Saleae или осциллографа допустимо только после проверки изоляционной архитектуры квалифицированным специалистом и с предусмотренной изоляцией измерений.
7. Для входа J1 не показаны PE, номиналы/характеристики F1, проводов, разъёмов и предохранителей. Для внешнего soft-start также нужны паспортные ток, мощность, напряжение, время шунтирования NTC и допустимый повторный пуск.
8. Линии `+220V` и `-220V` подписывают вход переменного тока. Их надо заменить на `AC_L` и `AC_N`; после моста использовать только `VDC+`/`VDC-`. Автономный soft-start должен стоять в разрыве AC-входа перед выпрямителем согласно своей паспортной схеме.
9. UART на старом PDF показан между UNO и Blue Pill. Текущая схема использует прямой UART `UNO D1 -> Nucleo PB7`, `Nucleo PB6 -> UNO D0` и общую `HOT_GND`. Изолятора нет, поэтому UNO Q, Nucleo и все их разъёмы находятся внутри закрытого HOT-корпуса; при силовом питании наружу выходит только Wi-Fi.

## Подтверждённые данные ST

Официальный предел `STEVAL-IPM15B` - `125...400 VDC`, входной источник должен дополнительно питать вход `VCC` до `20 VDC`. Руководство UM2014 указывает, что bulk capacitor не установлен по BOM, а оценочная плата работает с опасным высоким напряжением и её цепи не изолированы от линейного ввода.

Источники: [страница STEVAL-IPM15B](https://www.st.com/en/evaluation-tools/steval-ipm15b.html), [UM2014](https://www.st.com/resource/en/user_manual/um2014-1500-w-motor-control-power-board-based-on-stgib15ch60tsl-sllimm-2nd-series-ipm-stmicroelectronics.pdf).

## До следующего шага

Не использовать этот старый PDF для монтажа. Его заменяет `output/pdf/MIC_AI_NUCLEO_SYSTEM_WIRING.pdf` с Nucleo/IHM09/IPM15B, FC-34P, прямым UART и единой HOT-опорой. Следующий этап - проверка монтажа и низковольтный HIL без J7, затем автономный тест soft-start и первый V/f-пуск с аппаратным ограничением тока и без внешних проводов к цифровому контуру.
