11lisov11/mic_practice/firmware/ready_to_flash/FLASHING_RU.md

# Комплект прошивок MIC_AI

Этот комплект предназначен для `NUCLEO-G431RB` (`STM32G431RBT6`), переходной платы `X-NUCLEO-IHM09M2`, силового модуля `STEVAL-IPM15B` и `Arduino UNO Q`. Это именно UNO Q: бинарник не подходит для классической Arduino Uno AVR.

## Что прошивается

- `nucleo/ACIM-NUCLEOG431RB-IPM15B-VF_OL.hex` - MCSDK 6.4.2, разомкнутое скалярное V/f для IEK AIR56B2: 1 пара полюсов, 50 Гц, 2720 об/мин, двигатель соединён треугольником на 220 В.
- `uno_q_mcu/UNOQ_MOTOR.ino.elf-zsk.bin` - MCU-часть UNO Q: HMI/RPC, UART с Nucleo, ограничения запуска и тайм-ауты.
- `linux/web_hmi` - Linux-часть UNO Q: веб-интерфейс, журналирование и последовательность START/STOP.

## Перед записью

На новой UNO Q сначала завершить первичную настройку Arduino App Lab: сменить пароль пользователя `arduino` и настроить Wi-Fi. Заводское состояние `password must be changed` блокирует cron и не позволяет считать автозапуск готовым. Установщик проверяет это при использовании cron вместо systemd. Не запускать демонстрационные скетчи поверх прошивки проекта.

1. Полностью отключить J7/DC+ и DC-, дождаться разряда конденсаторов и проверить напряжение прибором.
2. Оставить двигатель и силовую сеть отключёнными. Питать только логическую часть плат от USB.
3. Штатный UART собрать напрямую: UNO Q `D1/TX` -> Nucleo `PB7/USART1_RX`; Nucleo `PB6/USART1_TX` -> UNO Q `D0/RX`; UNO Q `GND` -> Nucleo `GND`. Линии `3V3` плат не соединять.
4. После объединения GND UNO Q становится частью HOT-контура. В силовом режиме обе платы находятся внутри закрытого корпуса, а наружу выходит только Wi-Fi.
5. `PB4` никуда не подключать. Автономный сетевой soft-start устанавливается перед выпрямителем и не имеет управляющего соединения с Nucleo или Uno Q. Для отладки Nucleo использовать SWD (`PA13/PA14`), не полный JTAG.
6. При питании DC-шины от сетевого моста Nucleo относится к HOT-стороне. Перед подачей сети отключить от него USB/ST-Link и любые неизолированные приборы, связанные с ПК. Прошивка выполняется только при отключённой и разряженной DC-шине.

Из корня репозитория проверка пакета и пробный запуск без записи:

```powershell
py -3 tools/verify_board_flash_package.py firmware/ready_to_flash
.\tools\flash_mic_ai_boards.ps1 -Target All -UnoPort COM5
```

Из корня распакованного `ready_to_flash.zip` используются локальные команды:

```powershell
py -3 .\tools\verify_board_flash_package.py .
.\tools\flash_mic_ai_boards.ps1 -Target All -UnoPort COM5
```

Реальная запись трёх частей:

```powershell
.\tools\flash_mic_ai_boards.ps1 -Target All -UnoPort COM5 -Execute -ConfirmDcBusDisconnected
```

Можно прошивать отдельно через `-Target Nucleo`, `-Target UnoQ` или `-Target Linux`. Для нескольких ST-Link укажите `-StLinkSerial`, для нескольких ADB-устройств - `-AdbDevice`.

Для UNO Q скрипт явно задаёт путь `upload.artifacts.sketch`, чтобы Arduino CLI не добавлял расширение `.elf-zsk` повторно. После загрузки выполняется отдельное сравнение загрузчика и скетча с памятью платы через `verify_unoq_sketch.cfg`. Это проверка записи, а не проверка силового управления.

На чистой Linux-системе установщик создаёт каталоги и Python-окружение. При отсутствии `ensurepip` зависимость `msgpack` может быть доставлена с ПК через ADB как wheel для Python 3.13/aarch64; доступ платы к интернету для этого не требуется.

После записи, пока силовая часть физически отключена, выполнить read-only проверку. Она не отправляет команды двигателю:

```powershell
py -3 .\tools\board_bringup_readonly.py --device <ADB_ID> --output .\reports\board_bringup_readonly.json --samples 10 --expect-uart
```

Отчёт должен иметь `pass=true`, `state_safe_all_samples=true`, `pwm_disabled_all_samples=true`, одинаковые build ID обеих прошивок, живой UART и ровно один настроенный механизм автозапуска HMI. Для штатной установки ожидается `hmi_autostart_backend=systemd`, `hmi_service_active=active`, `hmi_service_enabled=enabled` и отсутствие `start_unoq_hmi.sh` в cron.

## Что проверено программно

- чистая сборка Nucleo: 0 ошибок, 0 предупреждений;
- сборка UNO Q для `arduino:zephyr:unoq`;
- совпадение UART-протокола v0x02 и числа пар полюсов;
- старый UART-бит реле всегда равен нулю, а GPIO управления реле в Nucleo отсутствует;
- PWM разрешается только после непрерывно допустимого Vbus `250...385 В` в течение не менее 3,5 с;
- переход к новой частоте V/f выполняется рампой 3 секунды;
- HMI ждёт фактический `PWM_ACTIVE` от Nucleo, а не только локальную команду START;
- контроль SHA-256 всех файлов пакета.
- append-only RPC v3 передаёт build ID Nucleo; сохранённая проверка Vbus автоматически аннулируется при смене любой из двух прошивок.

## Что нельзя подтвердить без стенда

Для V/f-кандидата AIR56B2 паспортные величины берутся из официальной таблицы IEK для указанной оператором модели; измеренную FOC-модель от него не требуют. В `reports/mcsdk_release_preflight.json` намеренно остаются открытыми аппаратная HIL-проверка внешнего soft-start и физический тест линии `STEVAL SD -> IHM09M2 -> PA6/TIM1_BKIN`. Прошивка является проверенным кандидатом для записи, но не доказательством готовности к вращению двигателя. Проверка soft-start и рабочей точки Vbus требует первого отдельного контролируемого силового ввода с заблокированным START, отключённым двигателем, физически снятыми проводными соединениями с ПК и независимыми средствами отключения. Этот ввод не заменяет проверку защиты и не разрешает автоматически запуск S1.

Первый низковольтный тест выполняется без двигателя и без силового входа STEVAL J1: проверить загрузку, UART, нулевой устаревший бит реле и телеметрию. При первом отдельном силовом вводе без двигателя и без START проверить ограничение пускового тока, время внутреннего шунтирования NTC, устойчивость DC-шины и повторное включение внешнего модуля. Только по результатам этой проверки можно менять `MIC_EXTERNAL_SOFTSTART_HIL_VALIDATED` на `1`; отдельно остаются проверка SD/BKIN и допуск к пуску S1 по `FIRMWARE_STAGES_RU.md`.

Проверка измерения DC-шины и последовательность действий без кабеля к ПК описаны в `AUTONOMOUS_VBUS_CALIBRATION_RU.md`, который входит в комплект прошивок.

Физическая проверка аварийного отключения выполняется отдельно, без сети, без `J7` и без двигателя, по `IPM_SD_BKIN_HIL_RU.md`. Обычная проверка формы шести PWM её не заменяет.
