11lisov11/mic_practice/artifacts/board_flash_20260908/UART_LINK_OK_RU.md

# UART UNO Q — Nucleo: связь подтверждена

Дата: 08.09.2026, итоговый прогон 20:36:39–20:37:50 МСК.
Проверка выполнена после повторного подключения проводов пользователем.
Прошивки, параметры UART и защиты в этом прогоне не менялись.

## Результаты

| Проверка | Результат |
|---|---|
| Linux UNO Q ↔ MCU UNO Q, RPC | PASS во всех 60 выборках |
| UART MCU UNO Q ↔ Nucleo | PASS во всех 60 выборках |
| Принятые ответы на UNO Q | 2354 → 3653, прирост 1299 |
| Принятые команды на Nucleo | 3887 → 5186, прирост 1299 |
| Ошибочные кадры на UNO Q | 0 |
| Ошибочные кадры на Nucleo | 0 |
| Возраст последнего ответа в выборках | 16–51 мс при пороге 300 мс |
| Режим и состояние UNO Q | VF, SAFE, PWM=0 |
| Все шесть ШИМ-выходов, физический анализатор | LOW, переключений нет |

Возрасты ответов не являются измерением задержки передачи или RTT.
Непрерывность вне зарегистрированных выборок отдельно не измерялась;
ошибок по накопительным счётчикам за прогон не зарегистрировано.

## Защитный статус не является ошибкой связи

В телеметрии `mc_status=9`: LINK_OK и FAULT. `mc_fault=5` является
общим кодом ошибки MCSDK в текущем UART-протоколе.

Причина установлена чтением SRAM через ST-Link: `Mci[0].CurrentFaults`
по адресу 0x20000744 равен 0x0004, `PastFaults` также 0x0004.
По `Inc/mc_type.h` текущей прошивки это `MC_UNDER_VOLT`.
Сообщаемое напряжение DC-шины 0 В. При отключённой силовой части
такой статус ожидаем; защита не отключалась и не обходилась.

## Подтверждённое соединение

- UNO Q D1/TX → Nucleo PB7 / CN7-21.
- UNO Q D0/RX ← Nucleo PB6 / CN10-17.
- Общий GND; силовая часть отключена.
- UART 115200, 8N1; рабочие прошивки из ready_to_flash.

## Доказательства

- `unoq_uart_recheck_03.json`: первый успешный прогон, 10 выборок.
- `unoq_uart_stability_01.json`: итоговый прогон, 60 выборок.
- `nucleo_uart_connected_safe_01/report.json`: физическая проверка LOW.
- `nucleo_uart_connected_safe_01/nucleo_pwm.sal`: исходный захват.

Дополнительные CH6/CH7 для поиска обрыва больше не обязательны:
двусторонний обмен подтверждён ответами и счётчиками обеих плат.

**Граница результата:** связь и выключенные выходы проверены.
Пуск двигателя, работа инвертора, силовые защиты и работа под нагрузкой
этим прогоном не подтверждаются. Команд START не отправлялось.
