11lisov11/mic_practice/artifacts/board_flash_20260908/UART_RECHECK_RU.md

# Повторная проверка UART, 08.09.2026

**Обновление 20:37 МСК:** после повторного подключения проводов связь
подтверждена. См. `UART_LINK_OK_RU.md`. Ниже сохранён прежний
диагностический протокол состояния до исправления подключения.

По запросу пользователя повторно проверены текущие платы без команд
START, без сброса и без перепрошивки.

## Наблюдения

- Два прогона HMI (10 и 5 выборок): Linux–MCU RPC работает, SAFE,
  PWM=0, `mc_good=0`, `mc_bad=0`, ответов Nucleo нет.
- Ядро Arduino Zephyr 0.90.0: Serial1 соответствует USART1 на PB6/PB7
  UNO Q, то есть физическим D1/TX и D0/RX. Скорость задана 115200 8N1.
- Прямое чтение UNO Q через встроенный SWD: USART1 включён,
  PB6/PB7 назначены AF7. За 3000 чтений GPIOB на PB6/TX обнаружены
  64 изменения уровня и 66 низких отсчётов; PB7/RX оставался высоким.
- Прямое чтение Nucleo через ST-Link: процессор работает, HAL tick
  вырос с 0x176088 до 0x1775eb (5475 мс). USART1 включён,
  PB6/PB7 назначены AF7, BRR=0x5c4 соответствует 115200 при 170 МГц.
- За 5000 чтений входов Nucleo PB6 и PB7 оставались высокими;
  изменений уровня не обнаружено. Структура приёмника `uno_link`
  оставалась нулевой до и после измерения.

Измерения двух плат выполнялись последовательно. Редкое чтение GPIO
через SWD не заменяет захват UART и не декодирует байты. Однако
наблюдаемая активность передатчика UNO Q при отсутствии активности
приёмника Nucleo указывает прежде всего на необходимость проверить
физический путь сигнала. Неисправность провода или неверный контакт
пока не доказаны; нельзя исключить проблему уровня сигнала или входа.

## Контакты повторно сверены

По ST UM2505, таблица 16, страницы 32–33:

- Nucleo PB7 = CN7-21: сюда приходит UNO Q D1/TX.
- Nucleo PB6 = CN10-17: отсюда сигнал идёт на UNO Q D0/RX.
- Общий GND, например Nucleo CN10-20.

Источник: https://www.st.com/resource/en/user_manual/um2505-stm32g4-nucleo64-boards-mb1367-stmicroelectronics.pdf

## Следующее измерение

При отключённой силовой части добавить CH6 логического анализатора
к UNO Q D1/TX и CH7 к Nucleo PB7/CN7-21. Существующий соединительный
провод и CH0–CH5 не снимать. Это два конца одной линии, не TX/RX-пара.
После подтверждения подключённых щупов выполнить пассивный захват
`tools/uart_wire_capture.py` с декодированием Saleae Async Serial.

## Доказательства

- `unoq_uart_recheck_01.json`, `unoq_uart_recheck_02.json`.
- `nucleo_uart_pins_recheck_01.log`.
- `unoq_uart_pins_recheck_01.log`.

Итог: связь UART не подтверждена, рабочие прошивки не менялись,
запуск двигателя не выполнялся.
