11lisov11/mic_practice/firmware/ready_to_flash/FIRMWARE_STAGES_RU.md

# Этапы прошивок MIC AI

## Базовая конфигурация

Целевой тракт: `UNO Q -> прямой UART -> NUCLEO-G431RB (STM32G431RBT6) -> X-NUCLEO-IHM09M2 -> STEVAL-IPM15B -> AIR56B2`, обмотки двигателя соединены треугольником на 220 В. UNO Q и Nucleo имеют общую `HOT_GND`, электрически равную `STEVAL J7 DC-`, и в силовом режиме находятся внутри закрытого корпуса; наружу выходит только Wi-Fi. Перед выпрямителем устанавливается автономный сетевой модуль плавного пуска с NTC и собственным внутренним реле. Контакта управления этим реле от Nucleo или UNO Q нет.

В протоколе UART старый бит `0x08` оставлен только для совместимости и всегда равен нулю. Nucleo измеряет шину, ждёт диапазон `250...385 В` непрерывно не менее `3,5 с` и только затем разрешает запуск MCSDK. `STOP`, E-stop, ошибка MCSDK или потеря UART немедленно выключают PWM.

## Последовательность

| Этап | Управление | Роль датчика | Текущее состояние |
|---|---|---|---|
| S1 | ACIM V/F бездатчиковое | не используется | исходники и бинарники собираются; первый аппаратный запуск |
| S2 | ACIM LSO-FOC бездатчиковое | не используется | заблокировано до измерения модели двигателя |
| S3 | принятый S1/S2 | AS5600 только эталон/разметка | регистратор выборки готов, аппаратный транспорт датчика уточняется на платах |
| S4 | LSO-FOC основной | AS5600 только для оценки | AI работает в shadow-режиме и не влияет на PWM |
| S5 | AI-наблюдатель + LSO fallback | датчик не требуется в принятом режиме | заблокировано до HIL и доказанной автоматики возврата |

## S1: первый пуск

Используется только `ACIM-NUCLEOG431RB-IPM15B-VF_OL.hex`. В Nucleo задан плавный переход к новой частоте за 3 секунды. Начинать с 5 Гц без нагрузки, с ограниченным временем запуска. Затем проверить 10, 20 и 30 Гц. Переход к 50 Гц допускается после проверки токов, температуры, формы PWM, направления вращения и стабильной телеметрии.

S1 считается принятым не по факту вращения, а после сохранения журнала: заданная частота, оценка оборотов, `Vbus`, токи, fault-код, состояние E-stop, тайм-аут связи и подтверждение PWM.

## S2: LSO-FOC

Бинарник LSO-FOC нельзя формировать как готовый к силовой прошивке из каталожных данных. Перед генерацией нужны измеренные `Rs`, `Rr`, `Lls`, `Llr`, `Lm` и момент инерции с отчётом происхождения. Параметры из демонстрационного проекта ST не являются параметрами AIR56B2.

После заполнения профиля `source_kind=nameplate_and_measurement` отдельный проект создаётся командой:

```powershell
.\tools\prepare_air56_lso_foc.ps1 `
  -MotorProfile C:\path\to\air56_measured.json `
  -OutputProject C:\mic_practice\mcsdk_reference\generated\AIR56B2_LSO_FOC
```

Сценарий берёт LSO-структуру из официального примера MCSDK 6.4.2, переносит только измеренные параметры AIR56B2, сохраняет UNO Q interlock, собирает проект и требует полный release-gate. При неполном профиле бинарник не создаётся.

## S3: AS5600 как учитель

AS5600 не включается в контур первого пуска. После принятия S1 он используется для независимой разметки положения и скорости. Набор данных записывает `tools/capture_as5600_teacher_dataset.py`; файл отклоняется при ошибке датчика, fault-коде, активном устаревшем бите реле или недостаточной доле валидных отсчётов.

Нельзя подключать AS5600 к тому же UART, который связывает Uno Q MCU и Nucleo. Окончательный датчиковый транспорт фиксируется после проверки доступных выводов на реальных платах. Штатный разъём `Encoder/Hall` STEVAL предназначен для сигналов `A/B/Z`, а не для I2C.

## S4 и S5

В S4 нейросеть получает те же входные признаки, что планируются для бездатчикового режима, но её оценка только журналируется и сравнивается с AS5600. В S5 влияние AI на управление допускается лишь через ограничитель и с детерминированным возвратом к LSO-FOC. До выполнения этих условий отдельного «боевого» AI-бинарника нет.

Машинное описание этапов находится в `firmware/firmware_stages.json` и включается в пакет прошивки.
