11lisov11/mic_practice/research/MODEL_VARIANT_GAP_AUDIT_RU.md

# Аудит вариантов математических моделей и базовых регуляторов

Дата исходного аудита: 27 августа 2026 г.
Дата закрывающего обновления: 28 августа 2026 г.

Область аудита: активная научная ветвь `C:\mic_practice`, документ
`research/MIC_AI_RESEARCH_AUDIT_RU.md`, срез `research/mic_ai_theory`, активный
модуль `motor_identification` и исследовательские ветви `model_identification`
и `snh_pwm`.

> Разделы 1-9 ниже сохраняют исходный gap-анализ до выполнения работ. Их
> формулировки о недостающем коде являются исторической точкой отсчёта.
> Актуальный статус после реализации приведён в разделе 10 и в машинном
> манифесте `artifacts/air56b2_research_manifest.json` версии v5. При
> расхождении приоритет имеют манифест v5 и раздел 10.

Ограничение исходных данных: для целевого двигателя AIR56B2 сейчас доступны
только паспортные данные. Рабочее соединение обмоток: `220 В Delta`. Аппаратные
измерения параметров эквивалентной схемы ещё не выполнены.

## 1. Итог аудита

В репозитории уже есть пригодная для исследований программная основа:

- потоковая модель асинхронного двигателя в неподвижных координатах alpha-beta;
- модель двухуровневого инвертора с допустимыми векторами, dead-time,
  минимальным импульсом и приближенными потерями;
- базовые FOC-SVM, FCS-MPC, DTC, DTC-SVM, deadbeat-current и исследовательский
  sensorless/adaptive FOC;
- прямые методы выбора вектора Protected H1, SNH-PWM и C6-RV-PWM;
- защитный шлюз с проверками тока, напряжения, температуры, dead-time,
  watchdog и атомарности последовательности;
- модельно-ориентированная идентификация с SVD/rank-gate, независимой
  валидацией и запретом выпуска deployment-профиля из синтетических данных;
- паспортно-ограниченный ансамбль AIR56B2, F1S/F2/F3, многорежимный V/f и
  encoder-observer FOC с раздельными train/validation/evidence-файлами;
- статистические валидаторы, парные Monte Carlo серии, conformal-анализ и
  машинные аудиты допустимых научных утверждений.

Главный пробел состоит не в количестве алгоритмов, а в отсутствии единого
физически независимого экспериментального контура. В большинстве host-сравнений
объект, предиктор и часть наблюдателя основаны на одной alpha-beta модели. Это
создаёт риск inverse crime: алгоритм может выигрывать на той же структуре, по
которой он прогнозирует. Кроме того, полные исходники обучения FOC+PPO в текущий
срез не перенесены, классический loss-model/flux-optimization baseline отсутствует
как исполняемый регулятор, а sensorless baseline ещё использует недоступные на
реальном стенде потоковые состояния.

Поэтому текущую модель AIR56B2 нельзя считать точной моделью конкретного
двигателя. На правильном этапе до получения плат следует строить и использовать
**nameplate-constrained ensemble**, то есть семейство физически допустимых моделей,
согласованных с паспортом, и проверять каждый алгоритм на всём семействе и на
отдельном holdout-семействе.

## 2. Граница знания об AIR56B2

### 2.1. Паспортные и прямо вычислимые величины

| Величина | Значение | Статус | Комментарий |
|---|---:|---|---|
| Номинальная механическая мощность `P_N` | `250 Вт` | паспорт | Не входная электрическая мощность. |
| Линейное напряжение `U_LL` | `220 В RMS` | паспорт | Только для соединения Delta. |
| Линейный ток `I_L` | `1,24 А RMS` | паспорт | Ток линии при Delta. |
| Коэффициент мощности `cos phi_N` | `0,78` | паспорт IEK | Используется для проверки активной входной мощности. |
| КПД `eta_N` | `0,68` | паспорт IEK | Используется для независимой проверки входной мощности и потерь. |
| Частота `f_N` | `50 Гц` | паспорт | Номинальная электрическая частота. |
| Скорость `n_N` | `2720 об/мин` | паспорт | Номинальная механическая скорость. |
| Число пар полюсов `p` | `1` | паспорт/следствие исполнения B2 | Даёт синхронную скорость 3000 об/мин при 50 Гц. |
| Схема обмоток | `Delta` | паспорт IEK: 220/380 В Delta/Y | Физическое напряжение каждой обмотки равно 220 В RMS. |
| Кратность пускового тока | `I_start/I_N = 5,3` | паспорт IEK | Ограничивает эквивалентную схему при `s=1`. |
| Кратность пускового момента | `M_start/M_N = 2,2` | паспорт IEK | Проверяется отдельной расширенной моделью пуска. |
| Кратность максимального момента | `M_max/M_N = 2,2` | паспорт IEK | Проверяется отдельной механической характеристикой. |
| Ток обмотки | `I_phase = I_L/sqrt(3) = 0,716 А RMS` | прямо вычисляется | Не заменять им линейный ток в поле MCSDK, если API ожидает линейный ток. |
| Эквивалентное phase-neutral напряжение MCSDK | `U_LL/sqrt(3) = 127,017 В RMS` | прямо вычисляется | Это координатный эквивалент для контроллера, а не физическое напряжение обмотки Delta. |
| Синхронная скорость | `n_sync = 60 f_N/p = 3000 об/мин` | прямо вычисляется | Для `p=1`. |
| Номинальное скольжение | `s_N = 9,33 %` | прямо вычисляется | `(3000-2720)/3000`. |
| Номинальная угловая скорость | `omega_N = 284,84 рад/с` | прямо вычисляется | Из 2720 об/мин. |
| Номинальный момент на валу | `M_N = P_N/omega_N = 0,878 Н·м` | прямо вычисляется | Средний момент при паспортной выходной мощности. |
| Полная входная мощность | `S_N = sqrt(3) U_LL I_L = 472,48 В·А` | прямо вычисляется | Не является активной мощностью и не определяет потери. |
| Активная мощность по `U/I/cos phi` | `P_1 = 368,55 Вт` | прямо вычисляется | Независимая паспортная проверка. |
| Активная мощность по `P_2/eta` | `P_1 = 367,65 Вт` | прямо вычисляется | Расхождение 0,246 % объясняется округлением паспорта. |
| Суммарные потери | `P_loss = 117,65 Вт` | прямо вычисляется | Их разбиение по видам не определяется однозначно. |

Официальный каталог позволяет вычислить активную входную мощность, КПД и общую
мощность потерь. Он не позволяет однозначно разделить потери и восстановить
`Rs/Rr/Lls/Llr/Lm/J/B`. Ранее записанные `cos_phi=0,68`, `eta=0,75` были
ошибочны и исправлены на паспортные `0,78` и `0,68`. Значение `J=0,01` никогда
не являлось паспортным и сохраняет только статус устаревшего simulation prior.

Значение `RS=0,35 Ом` в сгенерированном V/f-проекте также нельзя трактовать как
измеренное сопротивление AIR56B2. Для разомкнутого V/f оно является служебной
заготовкой и не разрешает выпуск LSO-FOC.

### 2.2. Невосстанавливаемые из паспорта параметры

| Параметр | Почему не определяется однозначно | Допустимое использование до измерений |
|---|---|---|
| `Rs` | Нужны DC/AC измерения обмотки и температура. Общие паспортные потери не разделяют медь статора и остальные потери. | Случайная положительная величина ансамбля; температурный закон задаётся отдельно. |
| `Rr` | Зависит от скольжения, схемы замещения и разделения потерь; одна номинальная точка недостаточна. | Случайная величина ансамбля с проверкой воспроизведения номинального скольжения. |
| `Lls`, `Llr` | Раздельные рассеяния структурно слабо различимы по доступным сигналам; текущий rank-аудит подтверждает потерю ранга. | Использовать наблюдаемое `Lsigma` и nuisance-коэффициент распределения между `Lls/Llr`. |
| `Lm` | Требуется опыт холостого хода или динамическая идентификация; по одному `U/I` нельзя отделить намагничивание от нагрузки и потерь. | Случайная величина ансамбля, возможно с нелинейной кривой насыщения. |
| `J` | Паспорт двигателя не задаёт инерцию ротора и присоединённой механики. | Широкое семейство `J_motor + J_load`; отдельно проверять чувствительность. |
| `B` | Механические, вентиляционные и нагрузочные потери не разделены. Часто закон не является чисто вязким. | Семейство моделей трения: вязкое, кулоновское и аэродинамическое. |

Ни оптимизация, ни нейросеть не могут превратить эти величины в идентифицированные
без дополнительных наблюдений. Подгонка к одной паспортной точке определяет
множество допустимых параметров, а не единственную физическую точку.

## 3. Инвентаризация моделей, регуляторов и валидаторов

Обозначения приоритета:

- `P0`: необходимо до публикационных выводов и обучения финальных политик;
- `P1`: необходимо до переноса FOC/MIC на плату;
- `P2`: необходимо до HIL/силового эксперимента прямого PWM;
- `P3`: расширение исследования после основного доказательства.

| Класс | Вариант | Что уже имеется | Текущий статус | Недостающий вариант или разрыв | Приоритет | Критерий готовности | Аппаратная зависимость |
|---|---|---|---|---|---|---|---|
| Объект | Паспортный профиль AIR56B2, 220 В Delta | Паспортный JSON, F1-ансамбль из 256 моделей, SHA-связанный manifest v4 | Nameplate-constrained ensemble реализован; эквивалентная схема конкретного двигателя неизвестна | Нужны аппаратное сужение семейства и структурно независимый OOD plant | P0 | Все члены семейства физически допустимы; train/validation/holdout разделены по seed; hardware claim отсутствует | Нет для построения; да для последующего сужения семейства |
| Объект | Alpha-beta потоковая модель АД | `snh_pwm/source/models/induction_motor_alpha_beta.py`: потоки статора/ротора, момент, механика, температура `Rs/Rr`, опциональное насыщение `Lm` | Реализована и протестирована | Независимая reference-plant модель с другой структурой и численным решателем | P0 | Контроллер обучается на одной модели, а принимается на независимой модели; проведён convergence test по `dt` | Нет |
| Объект | Модель для активной идентификации | `motor_identification/model.py` и `model_identification/source`: `Rs/Rr/Lsigma/Lm/J/B/Tload`, fit, SVD/Fisher | Реализована; синтетически проверена | Nameplate-only режим должен выдавать prior/ensemble, а не estimate; аппаратная оценка пока отсутствует | P0 | Без capture формируется только uncertainty family; deployment bundle разрешён только accepted hardware result | Измерение параметров требуется только для финальной валидации и FOC |
| Объект | Насыщение магнитной цепи | В alpha-beta модели есть простая зависимость `Lm(psi)` через `psi_sat/sat_exp` | Частично | Нет данных кривой намагничивания; нет независимого варианта насыщения и cross-saturation | P1 | Минимум три семейства: linear, bounded saturation, adverse saturation; вывод устойчив к выбору семейства | Аппаратная кривая улучшит модель, но не нужна для первого ensemble |
| Объект | Потери двигателя | Медные потери возникают через `Rs/Rr`; в статьях есть метрики мощности | Частично | Нет явной модели потерь в стали, механических и добавочных потерь, пригодной для loss-model baseline | P0 | Баланс мощности замыкается; потери разделены и неотрицательны; sensitivity по неопределённым loss coefficients опубликован | Аппаратные измерения нужны для калибровки, не для создания варианта |
| Объект | Механическая нагрузка | Постоянная, ступенчатая, случайная, периодическая, ударная, `two_mass_proxy`; V/f-матрица использует вентиляторный закон | Частично | Нет настоящей двухмассовой динамики, люфта и тягового профиля в канонической AIR56B2-проверке | P1 | Отдельные модели constant torque, fan/pump, traction profile, two-mass; одинаковая полезная работа при сравнении | Нет; параметры нагрузки позднее измеряются |
| Преобразователь | Идеальный инвертор | `model_identification/source/models/inverter_ideal.py` | Реализован | Использовать только как lower-fidelity reference, не как единственный plant | P1 | Результаты явно маркированы уровнем fidelity | Нет |
| Преобразователь | Двухуровневый инвертор с неидеальностями | `two_level_inverter.py`: векторы, SVM schedule, `R_on`, падение напряжения, dead-time/min-pulse, switching/conduction loss proxy, common-mode | Реализован и протестирован | Нет DC-link ripple, diode recovery, асимметрии ключей, измеренных IPM loss maps и реального dead-time distortion | P1 | Есть low/nominal/high uncertainty варианты; energy balance и dead-time polarity tests проходят | HIL/осциллограф нужны для окончательной калибровки |
| Регулятор | Разомкнутый scalar V/f | MCSDK V/f для G431; host `Air56B2ScalarVfBaselineController`; F1/F1S/F2/F3 и калибровка нуля ADC | 24/24 в канонической точке и 48/48 в матрице 5/15/30/50 Гц; скрытой обратной связи нет | Нужны fault matrix, энергетические профили и аппаратное подтверждение | P1 | Пик матрицы 3,470 А; 0 fault/reject/ADC clipping; результат не является hardware claim | Плата нужна для фактического допуска |
| Регулятор | FOC-SVM с PI | `foc_svm_key_baseline.py`, oracle sweep и отдельный encoder-observer F1/F1S/F2/F3 контур | Oracle holdout PASS; encoder-observer 24/24 PASS при 30 % скорости и 50 % нагрузки | Нет принятого честного sensorless режима, широкого operating matrix и аппаратной идентификации | P0 | Oracle и измерительный контракты разделены; true state запрещён API/evidence; диапазон скорости/нагрузки расширен | Нет для host; да для финальной настройки |
| Регулятор | FOC+PPO supervisory по `i_d_ref` | Статья, итоговые таблицы трёх двигателей, LUT и deploy contract; действие и reward описаны | Artifact-only в текущем срезе | Нет полного локального training environment, checkpoints, registry и воспроизводимого export pipeline | P0 | Из чистого checkout одной командой обучаются фиксированные seeds, строятся paired FOC/PPO результаты и бит-в-бит экспортируется LUT/policy | Нет |
| Регулятор | Классический loss-model/flux optimization | В статье есть offline `i_d_ref` headroom sweep | Не реализован как контроллер | Нужен физический loss-model optimizer, online search/LUT и простой extremum-seeking baseline | P0 | При одинаковой работе нагрузки сравниваются fixed-flux FOC, loss-model FOC, offline optimum, extremum seeking и PPO; PPO оценивается по добавочному выигрышу | Нет; измерения позднее калибруют коэффициенты потерь |
| Регулятор | FCS-MPC one-step | `fcs_mpc_baseline.py`, перебор восьми векторов, ток/момент/поток/коммутация/потери | Реализован и протестирован | Нужна робастная версия на ensemble и tuning parity по compute budget | P1 | Настройка выполняется на train family, оценка на holdout family; WCET proxy и число model evaluations публикуются | Нет; WCET требует G431/HIL |
| Регулятор | DTC hysteresis | `dtc_baseline.py` | Реализован и протестирован | Настройка полос и sensor-realistic flux estimator | P1 | Не использует истинный поток в validation режиме; настройка не хуже заранее заданного качества | Нет |
| Регулятор | DTC-SVM | `dtc_svm_baseline.py` | Реализован и протестирован | Та же проблема доступности потоковых состояний и tuning parity | P1 | Observer-fed paired benchmark на holdout ensemble | Нет |
| Регулятор | Deadbeat current | `deadbeat_current_baseline.py` | Реализован и протестирован | Robust/parameter-mismatch версия и явный voltage feasibility gate | P1 | Стабилен на holdout ensemble, не нарушает current/voltage limits, сравнивается при равной частоте | Нет |
| Наблюдатель | Current-voltage flux observer | `current_voltage_flux_observer.py`; F3 ADC, предзапусковая zero-current calibration, reconstructed voltage и дискретный AS5600 | Encoder-observer FOC принят на 24 моделях; истинное состояние не поступает в контроллер | Не является полноценным sensorless speed observer; нет low-speed blending и аппаратной калибровки offset/gain | P0 | Входы только `i_abc`, reconstructed voltage, Vdc и доступные датчики; истинные flux/speed запрещены API/evidence | Нет для simulation; AS5600 нужен для аппаратной валидации |
| Наблюдатель | Sensorless/adaptive FOC | `sensorless_adaptive_foc_baseline.py`, MRAS-like speed и `Rs` adaptation | Исследовательский proxy | В host-прогоне `measured_state` содержит истинные потоки; это не честный sensorless baseline | P0 | Контроллер получает только синтетические ADC/voltage samples; сравнение с true speed допускается только в метриках | Нет |
| Direct PWM | Protected AI-PWM H1 | `protected_ai_pwm_h1_baseline.py` и общий gateway | Реализован host baseline | Нет обученной политики и MCU mapping | P2 | Host/HIL trace проходит timing, fault injection и fixed-point equivalence | HIL и G431 нужны перед силовой частью |
| Direct PWM | SNH-PWM | `safe_neural_horizon_pwm.py`, MC30 на 31 сценарии, парное сравнение восьми контроллеров | Сильный host prototype | `NeuralCostShaper` имеет фиксированные веса; runtime twin остаётся physics model, residual weights evidence не включены; нет CUDA/vectorized ядра | P1 | Обучение/идентификация shaper и residual twin воспроизводимы; независимая plant validation; CPU/GPU numeric parity; universal claim не требуется | Нет для host; HIL/G431 для WCET |
| Direct PWM | C6-RV-PWM | `cyclic_robust_viability_pwm.py`, sigma points, CVaR, lazy predecessor, falsifier | Exploratory host result | MC5 недостаточно для publication; predecessor ни разу не отклонил кандидат; `braking` хуже FOC | P2 | MC30 с поправкой множественных сравнений; отдельное исправление braking; польза viability блока подтверждена ablation | Нет; WCET требует G431 |
| Uncertainty | C6-BCR conformal reachability | Полный код, replay, независимые серии и estimator-fed exploratory | Математически развито; строгий replication gate не пройден | Oracle-to-estimator gap огромен; нет drift gate и рекурсивной safety bound | P2 | Две заранее зафиксированные серии >=897 probes, estimator-fed coverage gate, другой motor family без смены score | Нет для статистики; hardware нужен для внешней валидности |
| Sim-to-real | Domain randomization | `randomized_motor_params` варьирует `Rs/Rr/Lm/J/B`; сценарии шумов, задержек, Vdc и отказов | Частично | Диапазоны не выведены из паспорта; не варьируются `Lsigma`, loss model, ADC/PWM timing и topology mismatch; train/test distributions не образуют единый паспортный ensemble | P0 | Версионированный sampler с hard constraints, disjoint train/validation/OOD seeds и отчётом coverage по каждому измерению | Нет |
| Sim-to-real | Sensor/actuator chain | F3 моделирует ADC quantization/offset/gain/delay, AS5600 quantization/delay, Vdc ripple и неидеальности ключей | Реализовано для V/f и encoder-observer FOC; zero-current calibration проверяется; 168/168 gateway fault cases PASS | Ещё нет окон реконструкции реальных фазных токов, UART/Wi-Fi jitter и динамических отказов датчиков внутри plant loop | P1 | Controller-in-the-loop использует только delayed quantized channels; источник каждого сигнала фиксируется | Нет для simulation; позднее калибруется на плате |
| Validator | Unit/regression tests | Изолированные серии охватывают `model_identification` и `snh_pwm`; текущий результат `158 + 17 = 175 passed` | Работает в `.venv-research-gpu`; manifest v4 проверяет SHA и feedback contracts | Нужна дальнейшая фиксация полного training environment для PPO | P1 | Одна команда повторяет обе серии, пересобирает F1/F1S/F2/F3, V/f matrix, fault matrix и oracle/encoder FOC | Нет |
| Validator | Snapshot provenance | `SNAPSHOT_MANIFEST.json`, `PROVENANCE.json`, `mic_theory_snapshot_check.py` | Проверка прошла, 222 файла | Срез MIC+PPO неполон относительно исходного `C:\mic_theory`; source worktree был dirty | P0 | Полный минимальный training/reproduce subset перенесён, hash-замкнут и не зависит от внешнего каталога | Нет |
| Validator | Paired scenario benchmark | SNH MC30: 31 сценарий, 30 общих реализаций, 0,2 с; CI и отрицательные результаты | Реализован | 0,2 с мало для энергетических и тепловых выводов; normal CI не всегда достаточен; tuning/test leakage нужно исключить | P0 | Электрические тесты плюс многосекундные mechanical/energy profiles; bootstrap/robust CI; frozen tuning split | Нет, но bench нужен для внешней валидации |
| Validator | Identification gate | SVD/Fisher/rank, bounded multistart, independent validation, hardware-only deployment gate | Реализован; synthetic evidence | Не проведён на AIR56B2; отдельные `Lls/Llr` правильно отклонены | P1 | Hardware capture с калибровками, разными run_id, независимым validation и accepted report | Да |
| Validator | Safety gateway | Shoot-through/dead-time/current/Vdc/temperature/confidence/watchdog tests и fault injection | Реализован на host | Нет соответствия реальному таймеру, драйверу и IPM propagation delay | P2 | SIL trace эквивалентен HIL/Saleae trace; fail-safe подтверждён при reset/brownout/timeout | Да |

## 4. Рекомендуемое семейство AIR56B2 до аппаратной идентификации

### 4.1. Не одна модель, а иерархия fidelity

Минимально необходимы пять уровней объекта:

1. `F0 linear`: линейная alpha-beta модель, идеальный инвертор, постоянный момент.
   Нужна для отладки формул и быстрых тысяч прогонов.
2. `F1 uncertainty`: та же электрическая структура, но ансамбль
   `Rs/Rr/Lsigma/Lm/J/B/Tload` и nuisance-разделение `Lls/Llr`.
3. `F1S starting`: феноменологическая потеря при большом скольжении, которая
   согласует пусковой и максимальный моменты с паспортом, но не выдаётся за
   уникально идентифицированную схему ротора.
4. `F2 loss-thermal`: насыщение, temperature-dependent `Rs/Rr`, потери в стали,
   механические потери и динамика температуры.
5. `F3 sim-to-real`: неидеальный инвертор, ripple Vdc, dead-time distortion,
   ADC/AS5600 quantization, offset, gain drift, sampling delay, packet jitter и
   отказы датчиков.

Финальный алгоритм не должен обучаться и приниматься на одном уровне. Например,
PPO обучается на смеси `F1/F2`, настраивается по отдельным seed, а окончательно
оценивается на невидимом `F3` и на структурно независимом reference plant.

### 4.2. Параметризация ансамбля

Рекомендуемый вектор неопределённости:

```text
theta = {
  Rs_20, alpha_Rs, Rr_20, alpha_Rr,
  Lsigma, leakage_split_k, Lm0, psi_sat, sat_exp,
  J_motor, J_load, B_viscous, T_coulomb, k_fan,
  Tload_profile,
  inverter_Ron, inverter_Vdrop, dead_time, Vdc_ripple,
  current_gain, current_offset, voltage_gain, sample_delay,
  speed_quantization, speed_delay
}
```

Положительные электрические параметры следует выбирать в log-space. Вместо
ложной отдельной идентификации `Lls/Llr` используется `Lsigma` и коэффициент
`leakage_split_k`, который остаётся nuisance-параметром. Для каждого кандидата
проверяются положительность параметров, невырожденность индуктивной матрицы,
численная устойчивость и допустимость токов.

Паспорт используется как система ограничений, а не как формула восстановления:

- при `50 Гц`, `220 В Delta` и нагрузке около `0,878 Н·м` должна существовать
  устойчивая номинальная область;
- скорость должна быть согласована с `2720 об/мин`, а линейный ток с `1,24 А`
  в заранее объявленных допусках;
- выходная механическая мощность должна быть согласована с `250 Вт`;
- модели, которым для этого нужны отрицательные потери, неустойчивая матрица или
  недопустимые токи, отбрасываются;
- паспортные `cos phi=0,78` и `eta=0,68` используются как независимые constraints;
  их согласованность по входной мощности проверяется с учётом округления.

Такой отбор оставит широкое множество параметров. Это правильный результат:
неопределённость должна сохраняться до аппаратных измерений.

### 4.3. Разделение выборок

Для каждого зафиксированного протокола нужны три непересекающихся семейства:

- `train ensemble`: обучение PPO, residual twin и настройка регуляторов;
- `validation ensemble`: выбор гиперпараметров и acceptance thresholds;
- `blind holdout ensemble`: итоговое сравнение, которое не используется при
  настройке;
- `OOD stress family`: параметры и структурные варианты за границей принятого
  паспортно-ограниченного семейства. Это проверка отказоустойчивости, а не часть
  заявления о nominal performance.

Seed, диапазоны, ограничения, число отклонённых кандидатов и причина отклонения
должны сохраняться в evidence JSON.

## 5. Минимальная матрица базовых методов

До вывода о научном преимуществе FOC+PPO следует сравнить при одной полезной
работе нагрузки и одинаковом измерительном интерфейсе:

1. Scalar V/f.
2. FOC с постоянным `i_d_ref`.
3. FOC с расписанием потока по скорости/нагрузке.
4. FOC с классической loss-model optimization.
5. FOC с extremum seeking по измеряемой входной мощности.
6. FOC+PPO supervisory.
7. Дистиллированная LUT из PPO.
8. Oracle offline optimum по `i_d_ref`, используемый только как верхняя граница.

Для прямого PWM это отдельная статья и отдельная матрица:

1. FOC-SVM.
2. DTC hysteresis.
3. DTC-SVM.
4. Deadbeat current control.
5. One-step FCS-MPC.
6. Robust FCS-MPC/C6-RV-PWM.
7. Protected H1.
8. SNH-PWM.

Смешивать FOC+PPO supervisory и direct PWM в один главный вывод не следует. Первый
вопрос: даёт ли интеллектуальная коррекция потока дополнительный энергетический
выигрыш относительно сильной классической оптимизации. Второй вопрос: может ли
прямой выбор вектора улучшить динамику/коммутации при сохранении независимой
защиты.

## 6. Приоритетный план до получения плат

### P0: сделать сейчас

1. Перенести в репозиторий полный минимальный FOC+PPO training/reproduce pipeline,
   включая environment, checkpoint registry, фиксированные seeds и export LUT.
2. Генератор nameplate-constrained ensemble AIR56B2 реализован; сохранить запрет
   на присвоение ему статуса hardware identification.
3. Добавить независимую reference-plant модель и запретить итоговую приёмку на
   той же модели, которую использует controller twin.
4. Реализовать классические loss-model, extremum-seeking и offline-oracle
   flux baselines.
5. Encoder-observer API уже запрещает true flux/true speed; отдельно переделать
   и принять полноценный sensorless validation API.
6. V/f operating matrix зафиксирована; отдельно нужны долгие энергетические
   сценарии с одинаковой полезной работой для FOC/loss-model/PPO.

### P1: завершить до FOC на плате

1. Расширить уже добавленные fidelity `F2/F3`: окна реконструкции токов,
   UART/Wi-Fi jitter, отказы датчиков и многосекундные модели нагрузки.
2. Выполнить common benchmark всех FOC-supervisory вариантов на ensemble.
3. Векторизовать наиболее дорогие прогоны и только после проверки CPU/GPU parity
   использовать RTX 5070. Простая установка CUDA PyTorch без переписывания
   Python-циклов ускорения не даст.
4. Подготовить аппаратный capture protocol для `Rs/Rr/Lsigma/Lm/J/B/Tload`, но
   не подставлять синтетические значения в MCSDK LSO-FOC.

### P2: после появления плат

1. Сузить ensemble по hardware capture, сохранив posterior uncertainty.
2. Проверить observer-fed FOC и MIC в shadow mode.
3. Измерить WCET, jitter, ADC timing и gateway transitions на G431/HIL.
4. Только затем переносить direct PWM и выполнять силовые испытания.

## 7. Критерий общей готовности исследования

Компьютерную часть можно считать готовой к переносу на платы, когда одновременно
выполнены следующие условия:

- ни один файл или отчёт не называет nameplate prior идентифицированной моделью;
- обучение и итоговая приёмка используют разные модели и разные seed;
- FOC+PPO полностью воспроизводится из этого репозитория;
- PPO сравнен с сильным классическим loss-model baseline и oracle bound;
- sensorless контроллер не получает истинные скрытые состояния;
- energy claim использует одинаковую полезную работу нагрузки и многосекундные
  сценарии;
- минимум 30 парных повторов или заранее рассчитанная статистическая мощность;
- все защитные и regression tests проходят в чистом зафиксированном окружении;
- результат содержит не только среднее, но CI, worst case, failure count и
  чувствительность к model family;
- hardware measurement явно остаётся будущей внешней валидацией, пока реальный
  capture не принят аппаратным gate.

## 8. Выполненные проверки аудита

- `.venv-research-gpu`: `158 passed` для SNH/PWM и `17 passed` для
  идентификации двигателя, всего `175` тестов.
- `tools/run_air56b2_research_pipeline.ps1`: PASS; пересобраны F1 (256),
  F1S/F2/F3 (256), scalar V/f (24 опыта), V/f operating matrix (48 опытов),
  fault matrix (168 случаев), oracle/encoder FOC и канонический manifest v4 с
  проверкой SHA-256, split и feedback contracts.
- `py -3 tools/mic_theory_snapshot_check.py`: `ok=true`, проверено `222` файла,
  нарушений hash/required-file состава нет.
- Тесты прошли через системный Python 3.12 с NumPy/SciPy. Текущая
  `C:\mic_practice\.venv` не содержит NumPy, поэтому её нельзя считать
  воспроизводимой научной средой без переустановки зависимостей.

## 9. Изменённые файлы

- `research/MODEL_VARIANT_GAP_AUDIT_RU.md` - новый файл аудита.

## 10. Закрывающее обновление программной части

На 28 августа 2026 г. программные пункты P0/P1, выполнимые без реального
двигателя и силовых плат, закрыты следующим образом:

| Исходный разрыв | Реализованный результат | Статус |
|---|---|---|
| Нет локального FOC+PPO-контура | Создан hash-связанный изолированный порт `research/mic_ai_foc_ppo`, профиль AIR56B2, детерминированный CUDA replay, checkpoint bundle и 34 теста | Закрыт для воспроизведения; длительное обучение и аппаратный результат не заявлены |
| Нет loss-model baseline | Добавлена модель медных, магнитных, механических и инверторных потерь; 480/480 режимов классической оптимизации `i_d_ref` | Закрыт как SIL baseline |
| Нет независимого объекта | Добавлена независимая current/flux RK4-модель с иным состоянием и решателем | Закрыт для текущей sensorless-проверки |
| Sensorless использует скрытые состояния | Новый observer получает только alpha-beta напряжение, ток и шаг времени; train/validation-модели разделены | Закрыт как честный интерфейс SIL; низкие скорости и стенд остаются открыты |
| Нет воспроизводимого policy/LUT export | Добавлены непересекающиеся train/validation/holdout, checkpoint replay, JSON-LUT и C-header | Закрыт для дистилляции классического оптимума; это не аппаратно обученная PPO-политика |
| Нет общего evidence-конвейера | `tools/run_air56b2_research_pipeline.ps1 -Full` запускает 220 тестов и все исследования; manifest v6 фиксирует 41 ворота и SHA-256 | Закрыт |
| Нет оформленного результата | Сформированы научно-технический отчёт и программа аппаратной верификации в DOCX/PDF | Закрыт |

За пределами программного этапа намеренно остаются только действия, для которых
нужны физические образцы: измерение `Rs/Rr/Lsigma/Lm/J/B`, калибровка каналов,
низковольтный V/f-пуск, encoder-assisted FOC, sensorless shadow mode, измерение
WCET/задержек защит и лишь затем перенос интеллектуального управления.

Финальное условие безопасности не изменено: `hardware_release_ready=false`.
Расчётный `PASS` разрешает переход к аппаратной идентификации по утверждённой
программе, но не разрешает подключение высоковольтной шины или автономный
силовой пуск.
