11lisov11/mic_practice/output/pdf/MIC_AI_REV2_SCHEMATIC.pdf

MIC_AI REV 2.2 | Архитектура и домены земли

Каноническая схема: SAFE_GND никогда напрямую не соединяется с HV_DC-/HOT_GND

Лист 1/6 2026-08-26

SAFE DOMAIN | ISOLATION BARRIER | HOT / HV DOMAIN

## UNO Q / ПК

Питание UNO Q: VIN 7-24V или USB-C 3.3V и 5V на UNO Q не подпитывать UART source: UNO Q либо PC USB-UART

## Saleae Logic

Только SAFE_GND
CH0..CH7 после ISO7740F
Изоляционная задержка не более десятков нс

## Аппаратный PWM inhibit

Нормально-замкнутый изолированный контур
Обрыв питания/провода = PWM STOP
Настоящий E-STOP также отключает сетевой контактор

## SAFE питание

SAFE_GND отдельно от PE и HOT_GND SAFE_3V3: UNO Q OUT либо внешний источник SAFE_5V питает только E-STOP loop

## U_UART_ISO

ISO7721DWR
UART 1 канал туда
1 канал обратно
8 mm creepage package

## U_LA1 + U_LA2

2 x ISO7740FDWR
8 hot-to-safe channels
PWM/EM_STOP/reserved
default LOW

## U_ESTOP_OPTO

LTV-817
Безопасный loop
74LVC1G14 + AND

НЕТ медного соединения земель

## Blue Pill

Питание только HOT_3V3
USART2 PA2/PA3
TIM1 PWM + safety
HOT_GND = HV_DC-

## STEVAL-IPM15B

J2 signals + J4 15V
J7: 125..400VDC
J2 GND = J7 DC-Внутри закрытого корпуса

AS5600

PB10 SCL / PB11 SDA
HOT_3V3 / HOT_GND
Кабель и модуль недоступны при включенной HV

## 4-pin PWM fan

HOT_12V постоянно
PB3 -> NPN open collector
PA11 TACH
3-pin: только полная скорость

## Силовое питание

230VAC -> F1/MOV -> autonomous soft-start -> KBPC5010 HV_DC- = HOT_GND только внутри опасного домена PE идет только на корпус/раму/двигатель, не на HV_DC-HLK-20M15 питает горячие 15V/12V/5V/3.3V

## Запрещено при поданной HV

USB Blue Pill, обычный ST-Link, прямой Saleae, заземленный осциллограф Любая пайка и перестановка проводов - только после разряда DC-шины

MIC_AI REV 2.2 | 230VAC, автономный soft-start, мост и питание

Soft-start установлен до BR1 и не имеет управляющего соединения с MCU

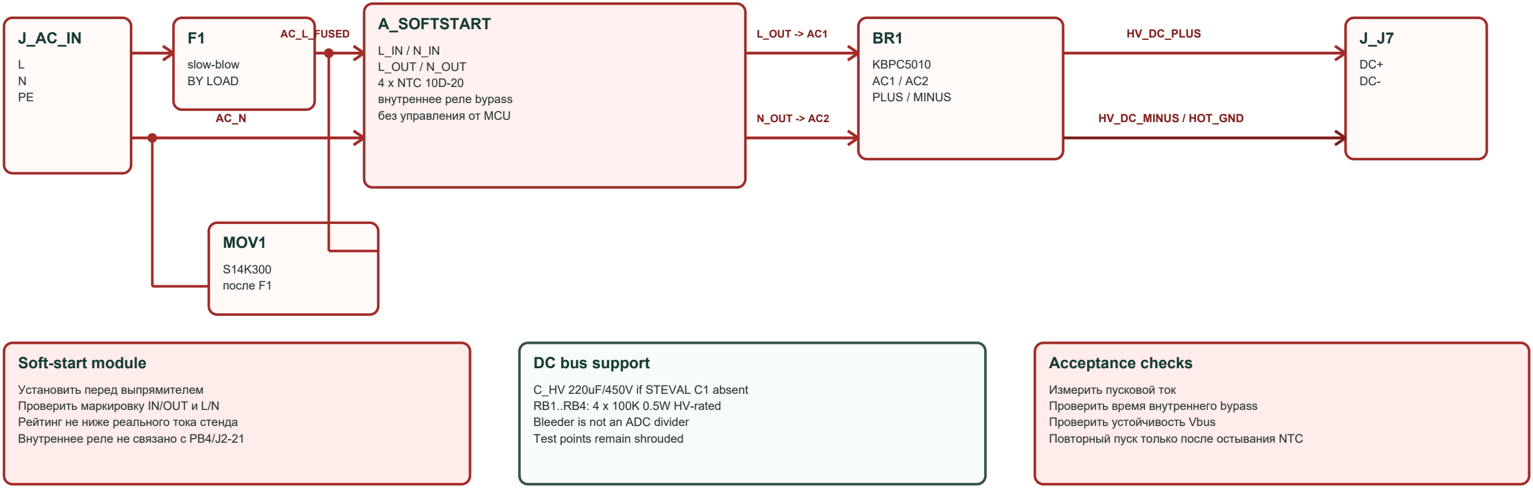
[picture p1: figure]
slow-blow BY LOAD; A_SOFTSTART; L_IN / N_IN L_OUT / N_OUT 4 x NTC 10D-20 внутреннее реле bypass без управления от MCU; KBPC5010 AC1 / AC2 PLUS / MINUS; MOV1; S14K300 после F1; AC_L_FUSED; L_OUT -> AC1; N_OUT -> AC2; HV_DC_PLUS; HV_DC_MINUS / HOT_GND; Soft-start module; Установить перед выпрямителем Проверить маркировку IN/OUT и L/N Рейтинг не ниже реального тока стенда Внутреннее реле не связано с PB4/J2-21; DC bus support; C_HV 220uF/450V if STEVAL C1 absent RB1..RB4: 4 x 100K 0.5W HV-rated Bleeder is not an ADC divider Test points remain shrouded; Acceptance checks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
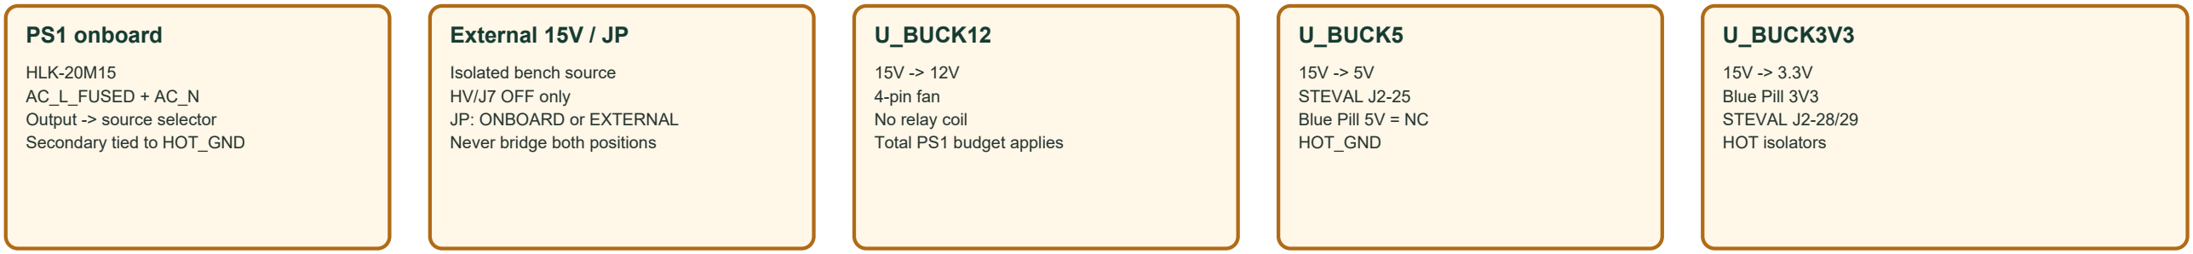
[picture p2: figure]
PS1 onboard; HLK-20M15 AC_L_FUSED + AC_N Output -> source selector Secondary tied to HOT_GND; External 15V / JP; Isolated bench source HV/J7 OFF only JP: ONBOARD or EXTERNAL Never bridge both positions; U_BUCK12; 15V -> 12V 4-pin fan No relay coil Total PS1 budget applies; U_BUCK5; 15V -> 5V STEVAL J2-25 Blue Pill 5V = NC HOT_GND; U_BUCK3V3; 15V -> 3.3V Blue Pill 3V3 STEVAL J2-28/29 HOT isolators

Лист 2/6 2026-08-26

Повторный пуск только после остывания NTC

HOT_15V существует только после JP_HOT15_SRC; внешний БП отключить перед подачей сети/HV.

ПЕРЕД 230VAC | Проверить омметром: AC_L-AC_N не КЗ; BR1 AC1/AC2 не соединены с MINUS; SAFE_GND изолирован от HOT_GND.

F1 выбирается только после известного тока двигателя и сечения проводов. Не увеличивать номинал для маскировки ошибки.

PCB/layout требует отдельного DRC по creepage/clearance, прорезей и ширины HV дорожек. Эта принципиальная схема не заменяет layout review.

MIC_AI REV 2.2 | Blue Pill - STEVAL-IPM15B J2

Все сигналы этого листа относятся к HOT_GND = J7 DC-; J2-21 и J2-34 намеренно не подключены

Лист 3/6 2026-08-26

J2 | Сигнал STEVAL | Blue Pill / питание | Примечание
1 | EM_STOP | PB12 через hardware interlock + 220R | LOW = shutdown
3 | PWM-1H | PA8 TIM1_CH1 через 33R | Saleae isolated CH0
5 | PWM-1L | PB13 TIM1_CH1N через 33R | Saleae isolated CH1
7 | PWM-2H | PA9 TIM1_CH2 через 33R | Saleae isolated CH2
9 | PWM-2L | PB14 TIM1_CH2N через 33R | Saleae isolated CH3
11 | PWM-3H | PA10 TIM1_CH3 через 33R | Saleae isolated CH4
13 | PWM-3L | PB15 TIM1_CH3N через 33R | Saleae isolated CH5
14 | HV bus voltage | PA5 ADC1_IN5 через 100R | 0..3.3V from STEVAL
15 | current phase A | PA0 ADC1_IN0 через 100R | ADC
17 | current phase B | PA1 ADC1_IN1 через 100R | ADC
19 | current phase C | PA4 ADC1_IN4 через 100R | ADC
21 | NTC bypass relay | NC | Сеть не используется на STEVAL-IPM15B
23 | dissipative brake PWM | PB9 TIM4_CH4 через 100R | Default OFF
25 | +V power | HOT_5V | Не GPIO
26 | heat sink temperature | PB0 ADC1_IN8 через 100R | SW3 = TSO 1-2
27 | PFC sync | PB5 через 100R | GPIO output
28 | VDD_m | HOT_3V3 | Power/reference
29 | PWM VREF | HOT_3V3 | PWM reference
31 | measure phase A | PA6 ADC1_IN6 через 100R | Real sample
33 | measure phase B | PA7 ADC1_IN7 через 100R | Real sample
34 | measure phase C | NC | Virtual C computed from A/B
2,4,6,8,10,12 | GND | HV_DC-/HOT_GND | Connect all
16,18,20,22,24 | GND | HV_DC-/HOT_GND | Connect all
30,32 | GND | HV_DC-/HOT_GND | Connect all
Важно: | PB4, PB1 и STEVAL J2-21 оставлены NC. Автономный soft-start не имеет MCU-control.

Blue Pill питается через HOT_3V3; его 5V pin остается NC. J4 RETURN - это HOT_GND, а не отрицательные -15V.

MIC_AI REV 2.2 | Изолированные интерфейсы и аппаратный запрет PWM

UART/monitor barrier рассчитан на гальваническое разделение SAFE и HOT доменов

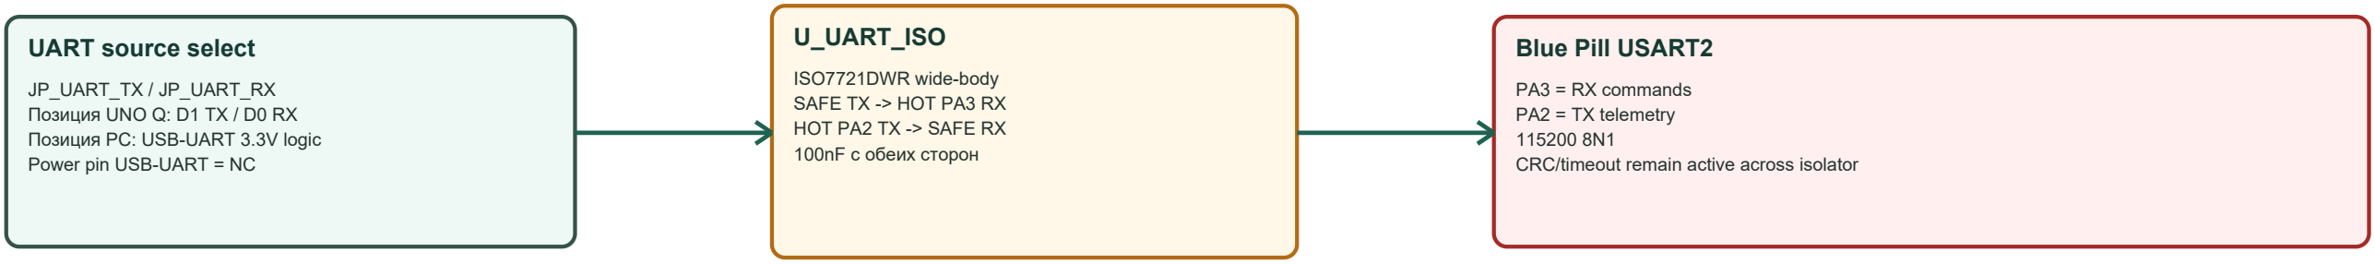
[picture p3: figure]
UART source select; JP_UART_TX / JP_UART_RX Позиция UNO Q: D1 TX / D0 RX Позиция PC: USB-UART 3.3V logic Power pin USB-UART = NC; U_UART_ISO; ISO7721DWR wide-body SAFE TX -> HOT PA3 RX HOT PA2 TX -> SAFE RX 100nF с обеих сторон; Blue Pill USART2; PA3 = RX commands PA2 = TX telemetry 115200 8N1 CRC/timeout remain active across isolator
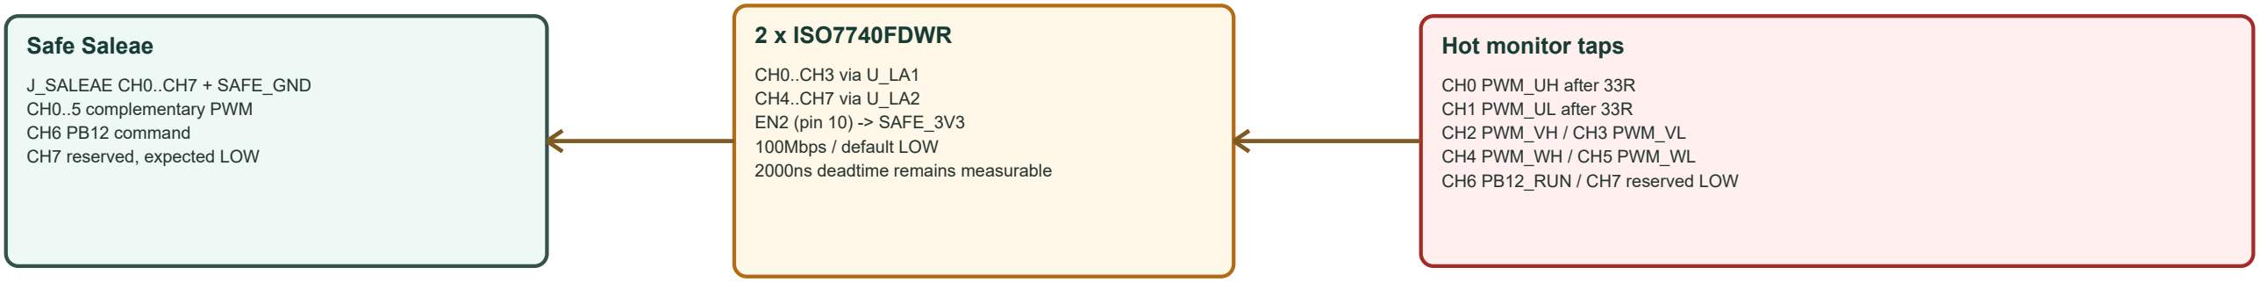
[picture p4: figure]
Safe Saleae; J_SALEAE CH0..CH7 + SAFE_GND CH0..5 complementary PWM CH6 PB12 command CH7 reserved, expected LOW; 2 x ISO7740FDWR; CH0..CH3 via U_LA1 CH4..CH7 via U_LA2 EN2 (pin 10) -> SAFE_3V3 100Mbps / default LOW 2000ns deadtime remains measurable; Hot monitor taps; CH0 PWM_UH after 33R CH1 PWM_UL after 33R CH2 PWM_VH / CH3 PWM_VL CH4 PWM_WH / CH5 PWM_WL CH6 PB12_RUN / CH7 reserved LOW
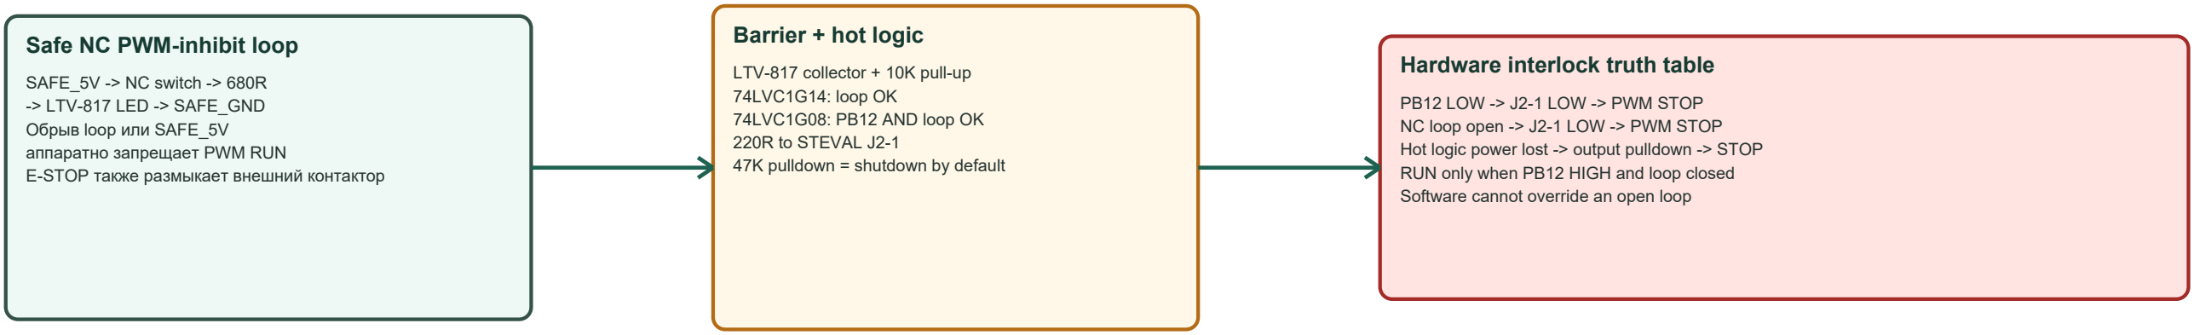
[picture p5: figure]
Safe NC PWM-inhibit loop; SAFE_5V -> NC switch -> 680R -> LTV-817 LED -> SAFE_GND Обрыв loop или SAFE_5V аппаратно запрещает PWM RUN E-STOP также размыкает внешний контактор; Barrier + hot logic; LTV-817 collector + 10K pull-up 74LVC1G14: loop OK 74LVC1G08: PB12 AND loop OK 220R to STEVAL J2-1 47K pulldown = shutdown by default; Hardware interlock truth table; PB12 LOW -> J2-1 LOW -> PWM STOP NC loop open -> J2-1 LOW -> PWM STOP; RUN only when PB12 HIGH and loop closed Software cannot override an open loop

Лист 4/6 2026-08-26

Hot logic power lost -> output pulldown -> STOP

SAFE_3V3 выбирается джампером: UNO Q OUT_3V3 либо внешний safe 3.3V. Это выход UNO Q, не вход питания платы.

Wide-body isolators и прорезь/keepout под barrier обязательны на PCB; дорожки или полигоны под корпусами изоляторов запрещены.

MIC_AI REV 2.2 | Вентилятор, AS5600, SWD и сборочные проверки

Стандартный fan header: 1 GND, 2 +12V, 3 TACH, 4 PWM open-collector

Лист 5/6 2026-08-26

## Fan power

HOT_15V -> buck -> HOT_12V +12V и GND подаются постоянно 100uF + 100nF у разъема
3-pin fan на контактах 1..3
работает только на полной скорости

## 4-pin PWM control

PB3 -> 1K -> MMBT2222A base
47K base pulldown
Collector -> FAN PWM; emitter -> HOT_GND 25kHz; timer polarity active-low
Loss of MCU drive -> fan full speed

## Fan tach

TACH -> 1K -> PA11
10K pull-up to HOT_3V3
Не использовать Blue Pill USB при PA11 Проверить pin order и ток вентилятора Вентилятор/кабель относятся к HOT domain

AS5600

PB10 -> SCL
PB11 -> SDA
HOT_3V3 -> VCC; HOT_GND -> GND
4.7K pull-ups DNP if module already has pull-ups AS5600 and cable stay inside insulated HV enclosure

## SWD

VREF HOT_3V3 / PA13 SWDIO / PA14 SWCLK HOT_GND / NRST
HV/J7 disconnected and bus discharged before use Do not power target from ST-Link
Unplug ST-Link before applying HV

## Предпусковая проверка A

1. Омметр: SAFE_GND - HOT_GND = разрыв.
2. Омметр: AC_N - HV_DC- = разрыв при снятом BR1.
3. Проверить BR1 по маркировке + / - / ~ / ~.
4. Проверить PB4/PB1/J2-21: NC.
5. Проверить все J2 GND pins.
6. Проверить UNO Q: только VIN или USB-C.

## Предпусковая проверка B

7. Выбрать один HOT_15V source; подать low voltage без J7.
8. Проверить E-STOP truth table.
9. Проверить UART и isolated Saleae static LOW.
10. Проверить soft-start отдельно от MCU.
11. Проверить PWM overlap при EM_STOP active.
12. E-STOP должен также снимать питание внешним контактором.

Эта ревизия исправляет принципиальную схему. PCB/макет на 230VAC нельзя включать без отдельной проверки зазоров и механической защиты.

MIC_AI REV 2.2 | Контроль физических выводов

Номера указаны для выбранных корпусов; ориентацию всегда проверять по метке pin 1 на корпусе

Лист 6/6 2026-08-26

## U_UART_ISO: ISO7721DWR

1,7 GND1 -> SAFE_GND; 3 VCC1 -> SAFE_3V3 4 OUTA -> SAFE RX; 5 INB <- SAFE TX
9,16 GND2 -> HOT_GND; 14 VCC2 -> HOT_3V3 12 OUTB -> PA3 RX; 13 INA <- PA2 TX 2,6,8,10,11,15 = NC
Корпус DW-16 wide-body, вид сверху

## U_LA1/U_LA2: ISO7740FDWR

1 VCC1 -> HOT_3V3; 2,8 GND1 -> HOT_GND
3 INA / 4 INB / 5 INC / 6 IND <- HOT signals
7 = NC
9,15 GND2 -> SAFE_GND; 16 VCC2 -> SAFE_3V3 10 EN2 -> SAFE_3V3 (выходы разрешены)
14 OUTA / 13 OUTB / 12 OUTC / 11 OUTD -> Saleae Суффикс F: при потере входа выход LOW

## Аппаратный PWM inhibit

LTV-817: 1 LED_A, 2 LED_K, 3 E, 4 C SN74LVC1G14DBVR: 1 NC, 2 A, 3 GND, 4 Y, 5 VCC SN74LVC1G08DBVR: 1 A, 2 B, 3 GND, 4 Y, 5 VCC DBV = SOT-23-5, вид сверху
J2-1 имеет 47K pulldown: питание пропало -> STOP

## Автономный soft-start

L_IN/N_IN <- F1/MOV и сеть L_OUT/N_OUT -> BR1 AC1/AC2 Внутри: 4 x NTC 10D-20 + bypass relay Нет контакта управления от MCU Сверить маркировку реального модуля Проверить ток и изоляционные расстояния

## Вентилятор

Q_FAN_N MMBT2222A-7-F: 1 B, 2 E, 3 C J_FAN: 1 GND, 2 +12V, 3 TACH, 4 PWM
PWM = open collector, 25kHz
PA11 принимает TACH через 1K
3-pin fan: только pins 1..3, без регулирования

## Силовые маркировки

BR1: использовать только marks ~, ~, +, - на корпусе J7: PLUS -> DC+, MINUS -> DC- / HOT_GND
SS14: полоса на корпусе обозначает катод
PE никогда не соединять с HOT_GND на этой плате SAFE_GND никогда не соединять с HOT_GND

## ОБЯЗАТЕЛЬНО ПЕРЕД ПАЙКОЙ

1. Сверить фактический MPN каждой микросхемы с MIC_AI_REV2_PINMAP.csv; заменять производителя без повторной проверки pinout нельзя.
2. Soft-start оформить как внешний четырёхпроводный модуль; не переносить его неизвестную разводку на основную PCB.
3. После разводки выполнить ERC/DRC, проверку creepage/clearance и прозвонку SAFE_GND - HOT_GND - PE - AC_N как четырех разных сетей.
4. Номинал F1 остаётся F1_VALUE_BY_LOAD до расчёта по двигателю, проводам и допустимому току входа.
