11lisov11/mic_practice/research/mic_ai_theory/snh_pwm/historical_host_release/trace_evidence/trace_summary.csv

scenario | controller | mean_abs_speed_error | speed_error_rms | current_rms | current_max | current_thd_like | current_high_freq_energy_ratio | current_dominant_freq_hz | torque_rms | torque_thd_like | torque_high_freq_energy_ratio | torque_dominant_freq_hz | torque_ripple_rms | switch_events | feedback_usage_ratio | fallback_count | fault_latch_count | safety_violations
load_step | protected_ai_pwm_h1_baseline | 44.84299539795818 | 50.978660347773044 | 2.687188362753245 | 3.6217727185897814 | 0.8372125270575164 | 0.02096735462433032 | 19.53125 | 3.347363964410101 | 1.1880713269579088 | 0.008357286270842767 | 19.53125 | 0.08701978997194527 | 177.0 | 0.9609375 | 2.0 | 0.0 | 0.0
load_step | fcs_mpc_one_step_baseline | 44.232858435807124 | 49.489792649699396 | 2.7300056345057078 | 3.4777527264372505 | 0.9487869582735018 | 0.0595735446912621 | 19.53125 | 3.125833502025199 | 1.219104261992171 | 0.016754695560495723 | 19.53125 | 0.09155261188544643 | 233.0 | 1.0 | 0.0 | 0.0 | 0.0
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
