11lisov11/mic_practice/artifacts/current_pwm_20261007/REPORT.md

# Проверка ШИМ анализатором, 07.10.2026

Итоговый прогон: `capture_r3/report.json`, PASS. Анализатор: физический Saleae `A7D1BB81883C0092`, Logic 2.4.46. Команды пуска и остановки передавались по LAN Wi-Fi.

Питание силовой шины и J4 отключено по подтверждению оператора. Перед прошивкой телеметрия показывала 0 В, SAFE, ARM=0. Uno Q `2026100706` не перепрошивалась. Nucleo временно использовала явно обозначенную нулевую стендовую копию `2026100799`, созданную из рабочей `2026100705`.

## Измерено

| Проверка | Результат |
|---|---|
| Шесть логических выходов | Все активны |
| Несущая каждого канала | 16 000 Гц |
| Минимальный deadtime U/V/W | Приблизительно 1,333 мкс |
| Перекрытие верхнего и нижнего ключа | Не обнаружено в записях |
| STOP по Wi-Fi | Все шесть выходов LOW, хвост записи 2,112 с |
| E-STOP по Wi-Fi | Все шесть выходов LOW, хвост 1,982 с |
| SET FREQ 0 по Wi-Fi | Штатный STOP, fault=0, LOW 2,063 с |
| RUNLIMIT | Автоматическое отключение, LOW 1,981 с |
| Ошибки контроллера в четырёх проверках | bad_count=0 |

Deadtime измерен короткой записью на 24 МГц; шаг дискретизации около 41,7 нс. Записи переходов выполнены на 4 МГц. Это цифровые уровни Nucleo, не токи двигателя и не напряжения затворов IPM. Задания 5 и 20 Гц проверены в коротком пуске; установившаяся электрическая частота этих заданий этим прогоном не подтверждена.

Осциллограмма реальных данных: `capture_r3/oscillogram.png`. Исходные `.sal` и CSV сохранены в каталогах `high_resolution`, `STOP`, `ESTOP`, `FREQ_ZERO`, `RUNLIMIT` внутри `capture_r3`.

## Найдено И Исправлено

Первый прогон прерван ReadTimeout анализатора на длинной записи 24 МГц. Рабочая прошивка восстановлена; неудачная запись не засчитана. Для последующего прогона использованы короткая запись 24 МГц и длинные записи 4 МГц.

Второй прогон обнаружил после SET FREQ 0 тайм-аут контроллера и аварийную реакцию HMI. Точный механизм задержки UART не установлен. Wi-Fi-команда 0 Гц теперь использует подтверждаемую процедуру STOP с немедленным снятием ARM вместо простого изменения задания. Регрессионный HTTP-тест подтверждает отправку STOP, подтверждение выключенных выходов и снятие ARM. После установки исправления третий физический прогон прошёл все четыре проверки.

Установленный HMI `server.py`: SHA256 `b915f07648692e13e06a4ca50a235c385310cbb4439d1cd14accc41ec17f4c79`. Исходная калибровка сохранена без новых измерений. Предыдущий архив `startup_update_2026100706.zip` содержит более ранний HMI без этого исправления; не использовать его Linux-файл для отката текущего сервера.

## Восстановлено

После теста Nucleo прошита исходным рабочим HEX `2026100705`; проверка записи и отдельное чтение BIN совпали. Итоговая пара: Uno Q `2026100706`, Nucleo `2026100705`, HMI-профиль HV, SAFE, PWM=0, Vbus=0, калибровка действительна.

Функции включения/выключения PWM, обработчики TIM1 и процедура защиты сравнивались по машинному коду объектов и совпали между рабочей прошивкой и копией. Инициализация таймера также совпала. Стендовая копия отличается разрешением работы при измеренной нулевой шине и виртуальным напряжением только для нормирования модуляции; при реальной шине выше 2 В копия блокирует выходы. Производственный исходный код не изменён этой генерацией.

Активный ШИМ неизменённого производственного образа с рабочим напряжением шины, силовой IPM, вращение и токи двигателя этим тестом не приняты. Новый физический тест внешнего BKIN не выполнялся. Стендовая прошивка не оставлена на плате.
