11lisov11/mic_practice/artifacts/mcsdk_logic_bench_final_production_20261006/REPORT_RU.md

# Проверка MCSDK ШИМ по Wi-Fi 6 октября 2026

Логический этап завершён: испытан V/f-бэкенд рабочего проекта MCSDK на
обесточенном стенде. Производственная прошивка Nucleo `2026100601`
восстановлена и побайтово сверена. UNO Q `2026092901` и Linux HMI
не перепрошивались. Заключение относится к логическим выходам и управлению,
не к переключению силовых IGBT или вращению двигателя.

## Результаты

| Проверка | Итог |
|---|---|
| Wi-Fi -> UNO Q -> UART -> MCSDK | START, задания 5/20 Гц, STOP и ESTOP прошли |
| Генератор V/f в MCU | Достигнуты 5,0 и 20,0 Гц; это не измерение скорости ротора |
| Частота модуляции из скважностей, независимо от MCU RAM | 4,99953 и 19,99937 Гц |
| Относительные фазы U/V/W из записи | 0 / -120,05 / +119,91 градуса на 5 Гц; 0 / -120,01 / +119,99 на 20 Гц |
| Несущая на CH0...CH5 | 16,000 кГц |
| Deadtime U/V/W | Минимум около 1,333 мкс на 24 Мвыб/с; настройка 1350 нс |
| Перекрытие H/L | Не обнаружено во всём исходном захвате |
| Непрерывные START/STOP и START/ESTOP | Рабочая пачка PWM и затем устойчивый LOW у всех шести выходов |
| EGR.BG во время PWM | Шесть выходов выключены; в журнале MCI защёлкнут MC_DP_FAULT 0x0400 |
| START без CLEAR после Break | HTTP 409, запуск отклонён |
| Входной тракт BKIN | При краткой инверсии входной полярности PWM отключён и не возобновился после восстановления |
| GPIO и полярность после теста | Исходные настройки сохранены/восстановлены |
| Восстановление flash | Совпадение всех 39020 байт производственного BIN |

Итоговый сквозной протокол со свежими сборкой и захватами, без повторного
использования подпроверок:
`../mcsdk_logic_one_command_20261006_r1/live/report.json`.
В нём явно сохранены хеши временного и рабочего образов, сравнение
машинных секций шести PWM/IRQ-функций и совпадение исходного
инициализатора TIM1. Это не утверждение об идентичности всего временного
образа рабочему: нормировка 310 В и разрешение работы без HV существуют
только в отдельно перечисленной оснастке.

Предыдущий успешный протокол `r18` использовал прошедшие подпроверки
`r14` при совпадении хешей образов. Общий отрицательный статус `r14`
сохранён: первая попытка непрерывной записи потеряла событие после
ReadTimeout. В сквозном прогоне вся последовательность выполнена заново
одной командой, код возврата 0; результаты модуляции находятся в
`../mcsdk_logic_one_command_20261006_r1/modulation/report.json`.

## Достоверность измерений

Сохранены исходные SAL и CSV. Для установившегося deadtime отдельно
указано исключение первых 4096 отсчётов из-за ранее установленного
буферного артефакта Saleae; проверка перекрытия охватывает и этот участок.
Непрерывные START/STOP/ESTOP анализируются целиком. Задержка HTTP STOP
до отключения ключей не вычислялась: часы хоста и анализатора не
синхронизированы.

После EGR.BG зарегистрирован LOW-хвост дольше одной секунды. Входной
опыт использует реальный высокий уровень PA6 и временную инверсию
TIM1.AF1.BKINP; PA6 не притягивался к земле, авария IPM не генерировалась.
Штатная аппаратная блокировка GPIO не снималась. Неудачная попытка
изменить режим PA6 сохранена в `r17` и не объявлена успешной.

## Конечное состояние

Рабочий HEX SHA-256:
`62860c54b1b45c718567373fad7f2c38dc3d6587c0992ff8fa094b8e102d5fb6`.
Рабочий BIN/readback SHA-256:
`71a3b59b1fdca9c8fd0e01326e0467c3c40da08246341204a1995b7bf6ef7c82`.

В конце протокола: SAFE/VF, PWM=0, профиль HV, ARM=0, Vbus не выше 2 В по
стабилизированному фильтру. Пассивный аудит `readonly/report.json`
проверяет 13 настроек Break/GPIO на рабочем образе. Отказ undervoltage
при нулевой шине является ожидаемым состоянием производственной защиты.

## Что остаётся вне этого заключения

После сквозного прогона выполнена дополнительная проверка рабочего
простоя: `production_idle_final/report.json`. За 48,5 с добавилось 842
корректных сообщения между первым и последним отсчётами; максимальный
возраст UART 51 мс. Накопленный счётчик ошибок целостности, оставшийся
после диагностических сеансов, сохранён: 5 до и 5 после; ошибок
последовательности 0 до и 0 после. Новых ошибок нет. Все шесть выходов
LOW, итог SAFE/VF без ARM.

Питание J4 и силовой ввод в этом испытании отключены; двигатель не работал.
Не проверены реальные фазные токи, переключение IGBT, генерация SD
самим IPM, энергетическая работа внешнего soft-start и двухточечная
калибровка Vbus при известном рабочем напряжении. Сохраняются
`hardware_validated=false` и незакрытые powered-HIL gates.

Таким образом, прежний круг «нужен HV для проверки PWM» устранён:
MCSDK-логика проверена без HV. Следующий этап является отдельным
контролируемым вводом силового тракта, а не повторением логического теста.
