11lisov11/mic_practice/artifacts/motor_start_checks_20261006/REPORT_RU.md

# Проверки перед пуском двигателя: 06.10.2026

## Условия и итог

Оператор подтвердил: силовой J1 отсоединён, двигатель и J4 отключены,
мультиметр показывает 0 В. Разрешение на силовой пуск не выдано.

Актуализация рабочего образа: SD/DriverProtection исправлен, новый Nucleo
build 2026100601 прошит и проверен. Итог: artifacts/ipm_sd_fix_20261006/REPORT_RU.md.
Предыдущие образные IDs и findings ниже сохранены как история испытаний.
Запросы фото и повторного замыкания сняты: заводская конфигурация принята
со слов оператора. Силовое питание в последующем прогоне не включалось.

Последующий пассивный аудит силового тракта сохранён отдельно:
`artifacts/power_stage_audit_20261006/REPORT_RU.md`. Все 13 регистровых проверок
рабочего BKIN проходят, но выявлено несоответствие: SD вызывает OVP-handler,
хотя штатный профиль ST описывает эту линию как DriverProtection.
Фактические перемычки требуют фото; новые силовые измерения не выполнялись.
Этот новый результат добавлен в `acceptance_results.json` как непрошедшая
проверка исходников. Он не отменяет ранее снятые осциллограммы и не скрывается
за успешными тестами HMI. MCU-прошивки данным пассивным аудитом не менялись.

## Финальное уточнение: хвосты и подтверждение STOP

После просьбы продолжить выполнен отдельный контролируемый опыт
`stop_tail_persistent_halt_final/report.json`: PASS, три цикла.
START и STOP выдавались по Wi-Fi. После STOP ядро G431 удерживалось
остановленным постоянным соединением OpenOCD. До и после двух захватов
прочитаны регистры: TIM1 CEN=0, MOE=0, шесть CCER enable-битов=0;
все шесть GPIO в режиме push-pull output, ODR=0 и IDR=0. S_HALT=1
сохранялся до завершения захватов. Первый захват при этом содержал хвост:

| Дискретизация | Последний фронт, мс | Последний фронт, номер отсчёта |
|---|---:|---:|
| 2 МГц | 0,512 | 1024 |
| 4 МГц | 0,512 | 2048 |
| 24 МГц | 0,085333 | 2048 |

Во всех трёх циклах следующий захват полностью LOW. Файлы `persistent_halt.log`
и `result.json` содержат аппаратные инварианты и исходные записи.
Повторное программное включение ШИМ в этом окне исключено: ядро остановлено,
таймер выключен, выводы статически LOW. Хвост относится к трактам получения
данных, а не доказывает повторный запуск Nucleo. Остаточный буфер — основное
объяснение; внутренний механизм USB/драйвера отдельно не инструментирован.
Это не измерение задержки HTTP STOP и не проверка силовых ключей.

Первый опыт `stop_tail_halted_probe` не удержал ядро на всём окне:
CubeProgrammer возобновляет его при завершении команды. Две промежуточные
попытки `stop_tail_persistent_halt` и `_retry` остановились на накопленном
счётчике ошибок UART после длительного debug halt. Их `pass=false` сохранён.
В диагностическом bridge CLEAR не обнуляет lifetime bad_count; в итоговом
опыте после каждого halt явно начата новая диагностическая сессия reset,
без ослабления ARM-guard и без изменения прошивочного счётчика.

### Исправление HMI

Воспроизведён баг: `stop_sequence` мог подтверждать outputs_off по старым
SAFE-значениям при stale/link-down. Теперь STOP/ESTOP всегда отправляется,
но подтверждение требует свежей связи и LINK_OK Nucleo. Отрицательный возраст
телеметрии также отвергается. Без ключа безопасный STOP по-прежнему разрешён;
при непроверяемом выключении ответ остаётся неуспешным, а не ложным OK.

- Все 19 групп офлайн-проверок прошли. HMI guards: 162 случая; HTTP/auth: 11.
- Исправление реально установлено на UNO Q, сервис перезапущен без root;
  remote/source/package SHA-256 совпадают:
  `97ac3e61136da65b847a7615a21b27cab57354eed9b92bcb71c8c4b8ac952114`.
- Обновлены Linux HMI в обоих пакетах и ZIP; каждый пакет проходит проверку
  30 артефактов. MCU-бинарники и пороги защит не менялись.
- `production_guards_after_stop_fix`: восемь живых проверок команд прошли.
- `stop_confirmation_fix/public_stop_after_deploy.json`: STOP без токена
  по Wi-Fi подтверждён, HTTP 200, SAFE/VF/disarmed.
- `stop_confirmation_fix/production_tim1_readonly.json`: MOE=0 рабочей
  прошивки подтверждён отдельным read-only чтением через ST-Link.

После итогового опыта рабочие MCU-образы восстановлены и верифицированы,
HMI возвращён в HV-профиль без ARM, все шесть выходов LOW.
Повторное замыкание через 1 кОм не проводилось.

`production_idle_after_stop_fix/report.json`: итоговая проверка проходит,
60 отсчётов за 48,438 с, 840 новых сообщений UART, максимальный возраст 51 мс,
новых integrity/sequence ошибок нет. Все шесть выходов LOW; SAFE/VF,
freq_cmd=0, disarmed, HV-профиль. Нулевая точка сохранена, рабочая точка
по-прежнему не измерена: `known-HV capture is required`.
Актуальный сводный результат и хеши — `acceptance_results.json`.
Готовность к силовому пуску остаётся false; контрольный опыт исключил
повторный программный запуск как причину хвостов, но не измерил задержку
STOP рабочей MCSDK-прошивки под напряжением.

## Новый прогон после переподключения UNO Q

ADB восстановлен. Конфликт двух экземпляров Logic 2 устранён: остановлен
запущенный агентом лишний процесс, API включён в уже открытом экземпляре
оператора. Физический Saleae A7D1BB81883C0092 снова доступен.
Первая повторная попытка `software_break_live_retry` остановилась до прошивки
из-за отсутствия анализатора в API; этот неудачный отчёт сохранён отдельно.

### ШИМ и внутренний break

`software_break_live_retry2/report.json`: PASS. Реальные команды через Wi-Fi,
захват семи каналов физическим Saleae при 4 МГц. На шести выходах измерено
10025,06 Гц, минимальный deadtime всех трёх плеч 2,00 мкс, HIGH-перекрытий нет.
После 1,20 с ШИМ внутренний TIM1 BG выключил выходы; LOW сохранялся до конца
захвата 0,629 с. PA6 оставался HIGH: это НЕ физический внешний тест BKIN.
Повторный START без CLEAR отвергнут, HTTP 409.

### Автоматические сценарии Wi-Fi

`wifi_all_scenarios_live/report.json`: PASS по заданным критериям.
29 записей проверок, включая захваты состояний, и 3 непрерывные записи
START/STOP/ESTOP. Повторные пуски, авторизация, отсутствие ARM, неправильная
фраза ARM, защёлка ESTOP, запрет повторного пуска, лимит работы и потеря
heartbeat проверены. При watchdog 3 с остановка замечена через 3,047 с
после последней команды; лимит 3 с завершил работу, наблюдение выключения
через 3,640 с от начала HTTP-запроса START. Это времена наблюдения хостом,
не аппаратные задержки по синхронизированным часам.

В первых отдельных захватах после STOP/ESTOP/таймаутов сохранены хвосты PWM
длительностью 0,256...1,024 мс от начала записи. Следующие захваты полностью
LOW. Непрерывные записи содержат один PWM-пакет и LOW после остановки.
На этом этапе причина хвостов (буфер анализатора или реальный переход) не была доказана;
гарантию нулевых выбросов и точное время от HTTP STOP до выключения не даём.
См. `capture_observations` и `stop_capture_tail_summary.json`; исходные
неудачные LOW-захваты сохранены, а не заменены успешными. Последующее
уточнение с остановленным ядром приведено в начале этого отчёта.

Оба прогона использовали диагностические образы, а НЕ рабочий MCSDK V/f.
После каждого рабочие образы реально записаны назад и проверены:
CubeProgrammer подтвердил Nucleo, OpenOCD — загрузчик и sketch UNO Q.
Журналы записи/верификации находятся в каталогах `logs` каждого прогона.

### Рабочая прошивка после восстановления

- `production_guard_semantics_retry/report.json`: все 8 проверок прошли.
  Без токена — 401; FOC принудительно остаётся VF; частота ограничена 0...50 Гц;
  NaN/inf отвергаются; START при нулевой шине запрещён. После каждой команды
  сохранён полный статус. ARM не выдавался, логи скачаны по Wi-Fi.
- `production_final_idle_retry/report.json`: PASS, 60 отсчётов за 48,516 с.
  Счётчик UART 211 → 1051, максимальный возраст телеметрии 51 мс,
  integrity/sequence ошибок нет, CLEAR завершён. Все шесть выходов LOW.
  SAFE, VF, PWM=0, disarmed, HV-профиль; build UNO Q 2026092901,
  Nucleo 2026091401. Fault=5 при 0 В — штатный undervoltage, а не разрешение пуска.
- `vbus_zero_capture/report.json`: нулевая точка записана штатным API по
  подтверждённому оператором показанию мультиметра 0 В. 20 отсчётов raw/Vdc:
  среднее и отклонение 0. Рабочая HV-точка отсутствует, разрешение HV снято.

Проверочный код дополнен `verify_production_guard_semantics.py` с 6 офлайн
регрессиями. В `verify_production_wifi_idle.py` исправлено ложное определение
зависшей связи при насыщении счётчика 65535: учитывается изменение соседних
номеров UART-пакетов, включая wrap; stale и неизменные значения отвергаются.
Все 5 регрессий idle-верификатора и повторные 21 тест анализатора проходят.
Рабочие алгоритмы и пороги защит этим изменением не ослаблялись.

Оператор напомнил о выполненном ранее замыкании через 1 кОм и отказался
от повторения этого опыта. Повторный диагностический TP23/SD/BKIN снят
с текущего чеклиста; новых действий по замыканию не требуется. Используем
сохранённый внешний захват 29.09 и его повторный анализ ниже. Его область
применимости не расширяется на рабочий MCSDK-образ. ШИМ выключен.

## Выполнено до переподключения

- Все 17 групп программных проверок прошли: прошивочные guards, UART-контракт,
  HMI/авторизация, протокол, сценарии анализатора, обработка аварии, пакеты.
  Подробности: `software_summary.json` и индивидуальные журналы.
- Собраны оба диагностических образа Nucleo: внутренний TIM1 BG и внешний
  SD/BKIN; также собран диагностический образ UNO Q. Это не рабочие образы.
- Прочитаны 39020 байт действительной flash Nucleo, начиная с 0x08000000.
  Полное побайтовое совпадение с рабочим BIN подтверждено; SHA-256
  `7580682b9959be3cd7ca805c5e28d267c597d291663d6071549b12da2d49897b`.
  Запись flash при этой проверке не выполнялась. Лог и подтверждение:
  `nucleo_flash_readback.log`, `nucleo_flash_readback.verification.json`.
- Восстановлен запуск Logic 2 с API автоматизации. Физический анализатор
  A7D1BB81883C0092 обнаружен. Новый пассивный захват: все шесть выходов LOW,
  PA6 HIGH; `logic_reconnected_idle/analysis.json`.
- Исправлен анализатор внешнего BKIN: требуется непрерывный LOW-интервал,
  а не сумма коротких импульсов. Синтетическая регрессия отвергает 25 импульсов
  по 1 мс; допускается погрешность одного отсчёта для границы 20 мс.
  После исправления все 21 тест анализатора прошли.
- Старый внешний захват 29.09 повторно разобран текущим анализатором:
  диагностический PWM соответствует критериям, непрерывный LOW 108,72 мс,
  выключение всех шести выходов через 0,5 мкс; повторный анализ проходит.
  Это исторический тест диагностического образа, НЕ новый физический тест
  и НЕ доказательство рабочего MCSDK-образа. Сохранён отдельно в
  `historical_bkin_reanalysis.json`; исходный старый отчёт не переписан.

## История первого отказа активного теста

`software_break_live/report.json`: ADB-соединение UNO Q стало `offline`.
Сценарий остановился при чтении токена, ДО записи на любую плату, ДО ARM/START.
Флаги `restored=true` в этом раннем отказе означают, что образ не менялся,
а не что выполнено восстановление после нового физического теста.
Повторное соединение и перезапуск ADB на ПК не восстановили устройство.
Wi-Fi HMI продолжает отвечать SAFE, PWM=0; ST-Link работает.

На этом этапе требовалось переподключить USB UNO Q. План был: внутренний break,
Wi-Fi START/STOP/потеря heartbeat/ограничение времени/ESTOP, затем отдельный
внешний BKIN с согласованным действием оператора. После каждого диагностического
опыта рабочие образы восстанавливаются и проверяются; их проверки не подменяются
результатами диагностики.

## Замечание о дополнительном тестовом скрипте

`production_negative_guards.json` содержит исходный неудачный эксперимент
с неверным предположением о HTTP-кодах. Он НЕ является доказательством
неисправности всех проверяемых guards: отсутствие токена штатно даёт 401,
а не предполагавшийся 403; прошивка намеренно переводит запрос FOC в VF,
ограничивает частоту диапазоном 0..50 Гц и отвергает NaN. После запросов
подтверждены SAFE/PWM=0/disarmed/VF/freq_cmd=0. Строгая проверка семантики
повторена в `production_guard_semantics_retry` с правильными ожидаемыми результатами и сохранением каждого
промежуточного статуса. Этот исходный `pass=false` не скрывается и не объявляется
успешным тестом.

## Что остаётся до пуска

1. Проверка защиты рабочего MCSDK-образа; диагностическое замыкание через
   1 кОм уже выполнено ранее и повторно в текущем чеклисте не требуется.
2. Проверка внешнего soft-start на реальном силовом тракте и устойчивости Vbus.
3. Рабочая точка Vbus по независимому мультиметру; нулевая точка уже записана,
   HMI сообщает `known-HV capture is required`. Нельзя подставить выдуманную точку.
4. Подтверждение токовых измерений, настроек и соединения конкретного двигателя.
5. Контролируемый пуск рабочей VF-прошивки автономно по Wi-Fi, без проводного
   соединения ПК/анализатора с неразвязанной силовой установкой.

Все эти пункты нельзя закрыть одним фактом успешной компиляции или статическим
LOW-захватом. Пакет VF прошёл проверку 30 артефактов, но его два физических
release-gate остаются открытыми: soft-start HIL и рабочий SD/BKIN HIL.
