11lisov11/mic_practice/artifacts/startup_recheck_20261007_repeat/REPORT.md

# Повторная проверка 07.10.2026

Установлено: Uno Q `2026100706`, Nucleo `2026100705`. Новая прошивка Uno Q проверена чтением обратно. Nucleo в этом прогоне не перепрошивалась: её образ не менялся, предыдущая проверка записи сохранена, текущий ID подтверждён через Wi-Fi.

## Дополнительно исправлено

- При задании 0 Гц во время работы отправляется штатный STOP, а не ENABLE с нулевой частотой. Добавлена защита также на уровне формирования кадра.
- Повторный RUNLIMIT не продлевает срок текущего пуска. Сокращение разрешено; RUNLIMIT=0 при работающем приводе вызывает STOP.
- Переполнение счётчика времени до нулевой временной метки не отключает лимит.
- Комплект обновления проверяет соответствие ID в отчёте и манифестах обоих образов, в том числе при разных версиях Uno Q и Nucleo.

Регрессионный тест выполнил настоящий обработчик RUNLIMIT с заглушками оборудования: до исправления он падал на повторной настройке лимита, после исправления проходят 20 проверок, включая настоящий фрагмент обработки нулевой частоты.

## Проверки

Повторены 390882 проверки обработчика Nucleo, 250636 проверок задания частоты/разгона, 66055 проверок декодера, 162 проверки командного допуска HMI. Все восемь намеренно внесённых ошибок в тестовых копиях обнаружены. Проверки не модифицировали прошивку на платах.

После обновления: 60 секунд чтения по Wi-Fi, 93 отсчёта, 859 новых сообщений UART, новых ошибок нет. Текущий код 5 расшифрован как ожидаемое отсутствие напряжения шины (`MC_UNDER_VOLT`, маска `0x0004`), а не ошибка UART. ШИМ и ARM оставались выключенными.

Команды 5→20→0 Гц подтверждены по Wi-Fi в состоянии SAFE; завершающий STOP подтверждён, HTTP 200. ARM и START не отправлялись. Исходная калибровка сохранена без новых измерений.

## Не Подтверждено Этим Прогоном

Физический активный ШИМ и вращение после обновления не измерены. Проверка команд при выключенном ШИМ не заменяет эту проверку. Токи фаз Nucleo ещё не являются квалифицированной телеметрией. Старые измерения deadtime не объявляются новым измерением текущей пары прошивок. Силовой пуск в этом прогоне не выполнялся; автоматических повторных попыток не было.

Подробные результаты и контрольные суммы: `RESULTS.json`. История предыдущих проверок и прошивка 705 сохранены отдельно, не перезаписаны. Старый общий `firmware/ready_to_flash` не обновлялся.
