11lisov11/mic_practice/artifacts/current_pwm_20261008/recheck_801_r2/REPORT_RU.txt

ПОВТОРНАЯ ПРОВЕРКА 801, РЕВИЗИЯ ОТЧЁТОВ R2, 08.10.2026

Новых дефектов в проверенных программных сценариях не обнаружено.
Все 27 наборов прошли. Прошивки и сервер HMI не изменялись.
Nucleo: 2026100801. Uno Q: 2026100709. Платы не прошивались.

Новая проверка
Ранее функция чтения FIFO в host-тесте была заглушкой с постоянным false.
Новый тест выполняет производственный USART1_IRQHandler с моделью FIFO:
- все 32 позиции частичного кадра и пачки по 0..160 байт;
- точную границу переполнения 128-байтной кольцевой очереди (127 доступных);
- все 15 непустых сочетаний NE/FE/ORE/PE вместе с принятыми байтами;
- CLEAR с ошибкой и последующий чистый CLEAR без автоматического START;
- 225 сочетаний последовательных ошибок с отдельными first/last причинами;
- насыщение счётчика ошибок;
- timeout 0..600 мс, в том числе с переполнением 32-битного времени.

Новый тест: 8994 сценария, 86371 проверка, PASS.
Все четыре намеренные регрессии обнаружены:
невыставленный overflow, приём ошибочных данных, перезапись первой причины,
срабатывание watchdog на миллисекунду раньше.
Длительность чтения реального FIFO и прерываний на Cortex-M4 не измерялась.

Повторены общие проверки команд, V/f-рампы, STOP/ESTOP, UART-защёлки,
SD/BKIN-кода, диагностики, HMI, доступа, калибровки, логов и AS5600.
Основной динамический тест: 412901 проверка, 262144 сочетания команд,
256 однобитных повреждений, 10 обнаруженных намеренных регрессий.
Тест границ IRQ/START: 2240 сценариев очереди и 1844 API-сценария;
START и рампа после опубликованной ошибки: 0.
Негативный контроль удаления USART1-секции остаётся чувствительным.
Архив прошёл 14 проверок целостности и достоверности квалификационных отчётов.

Комплект с расширенными отчётами:
C:/mic_practice/firmware/updates/uart_guard_2026100801_r2.zip
SHA-256: 177b4d0a66fdf821582d8ae06d38865fa123945798ffd4e2bc1e378263206ac7
Бинарные образы те же, что в uart_guard_2026100801.zip.

Это программная проверка, а не аппаратная квалификация силового стенда.
Нет доступа к платам и команд START/ARM в этом задании.
Источник силовых UART-помех, физический deadtime/ШИМ, длительность USART1-
секции и аппаратное отключение новой прошивки остаются неподтверждёнными.
Разрешение на 220 В не выдавалось, прежние ограничения защиты не ослаблены.
