11lisov11/mic_practice/artifacts/current_pwm_20261008/uart_guard_801/REPORT_RU.txt

ПОВТОРНАЯ ПРОГРАММНАЯ ПРОВЕРКА, 08.10.2026

Итог: подготовлен исправленный комплект UNO Q 2026100709 / Nucleo 2026100801.
Платы не прошивались. Команды стенду не отправлялись.

Обнаружение
Расширены точки инъекции UART IRQ: возврат из последней проверки ошибок
и граница вызова MCSDK START. В версии 2026100710 выявлены 8 случаев START
после уже опубликованной ошибки UART из 1860 проверенных API-сценариев.
Результат сохранён отдельно: ../recheck_710_commit_boundaries/report.json.
Прежний успешный тест не проверял эти границы; его результаты не переписаны.

Исправление
Проверка RX-флагов и публикация рампы/START объединены USART1-only секцией.
ADC/TIM защитные прерывания не маскируются. MCSDK API здесь только ставят
команды в очередь, без ожидания UART. После разрешения USART1 ошибки
обрабатываются повторно с STOP, защёлкой и сохранением причины.
Пороговые защиты, протокол v2, 115200 бод и преобразования измерений сохранены.
HMI допускает новую пару версий для неизменённого измерительного контракта.

Результаты
- 26 программных наборов: PASS.
- Основной динамический тест: 412901 проверка, 262144 сочетания команд,
  256 однобитных повреждений; все 10 намеренных регрессий обнаружены.
- Планировщик UART: 2240 сценариев очереди и 1844 API-сценария.
  START после опубликованной ошибки: 0; рампа после ошибки: 0.
  STOP и фиксация причины проверены во всех этих сценариях.
- Негативный контроль: удаление новой USART1-секции воспроизводит
  12 нарушений START и 4 нарушения рампы; тест чувствителен к исправлению.
- Рампа: 250636 проверок математической семантики и производственных helpers.
- Nucleo собрана: 0 ошибок, 0 предупреждений.
- HEX и ELF преобразованы в BIN: все три содержимых идентичны.
- Uno Q пересобрана: flash-образ идентичен ранее проверенной версии 709.
- Архив: 157 файлов с SHA-256, автономный verifier работает из комплекта.
- Проверка архива: 14 случаев PASS, включая повреждения образов,
  неверные build IDs, ложное аппаратное подтверждение и противоречивые отчёты.

Комплект
C:/mic_practice/firmware/updates/uart_guard_2026100801.zip
SHA-256: a8b5b1b0a50a7a2a0d59e51072ed762b22184e8b2954a829832e897a9b555908
Nucleo BIN SHA-256:
b10b9cda5bc2cf7ed6329bef7c14b42527ac6c745f76a75f304bc945014b4275
Uno Q flash SHA-256:
8390249e06eae200c793b8652fe37f7476ba8f67d3ac3338154ba9a97a76c06b

Границы вывода
Тесты используют реальный производственный код с host HAL/MCSDK mocks.
Перебор не является доказательством всех инструкционных чередований.
Физические ШИМ/deadtime, задержки отключения, работа с нагрузкой и источник
UART_NE при силовом запуске в этом задании не проверены.
Preflight сохраняет незакрытые аппаратные проверки soft-start и SD/BKIN.
Новая USART1-секция требует проверки длительности на целевой плате.
Готовность к 220 В не подтверждается. Старый архив 710 оставлен как история,
но заменён версией 801 для дальнейшей установки и проверки.
