11lisov11/mic_practice/artifacts/live_bench_20261008/uno_timing_803/REPORT_RU.txt

АЛЬТЕРНАТИВА ПАРАЛЛЕЛЬНОМУ UART-ПРОБНИКУ, 08.10.2026

Оператор не может подключить CH7 параллельно существующему UART-проводу.
Выбран другой подход: пассивные счётчики времени в Uno Q при сохранённой связи.
Проверка TX одной платы отдельно допустима только как отдельная проверка
передатчика; она не воспроизводит замкнутую командно-ответную связь при пуске.

Подготовлена Uno 2026100803. НЕ ЗАПИСАНА на плату.
Текущая наблюдаемая пара остаётся Uno 2026100802 / Nucleo 2026100801.
Новых START/ARM, сбросов или flash в этом задании не выполнялось.

Счётчики
uno_loop_active_max_us: максимальная пауза между итерациями основного цикла
на границе активного управления, включая выход из активного состояния.
uno_tx_active_max_gap_us: максимальная пауза между завершениями вызовов
Serial1.write при активном запросе или на его выходной границе.
uno_rx_active_max_gap_us: пауза между принятыми коррелированными ответами.
uno_tx_call_max_us: максимальная длительность вызова Serial1.write.
uno_rpc_max_us: построение текстового ответа get, без последующей сериализации
и передачи библиотекой RouterBridge. В ответе показывается максимум прошлых вызовов.
uno_tx_short_writes: число вызовов write, вернувших не 32 байта.
uno_tx_count / uno_rx_count: насыщаемые счётчики вызовов отправки и принятия ответа.

Счётчики не доказывают наличие фронтов на физическом TX-пине.
Максимумы копятся от загрузки, не стираются CLEAR; для опыта нужны исходные
и итоговые значения. Независимые снимки двух MCU не синхронизированы.
Дополнительный текст телеметрии может влиять на измеряемую нагрузку;
нельзя автоматически считать корреляцию с get доказанной причиной сбоя.

Что сохранено
UART 115200, период отправки 50 мс, протокол v2 и 300-мс watchdog Nucleo.
Защиты и алгоритм управления не заменены независимым heartbeat-потоком.
Краткие IRQ-lock секции защищают только диагностические обновления/снимки;
вызовы Serial1.write и построение строки не выполняются под этим lock.
В HMI отсутствующие метрики старых прошивок обозначаются None, а не нулём.
Новая совместимость калибровки разрешена только для пары 803/801.

Проверки
Отдельный native тест link_timing_selftest: PASS, включая rollover,
насыщение, границы активного/неактивного режима и старую телеметрию.
Все 27 основных программных наборов в regression_final: PASS.
Ранее заблокированный тест декодера выполнен: 67081 случай, без повторов запуска.
Защита Windows не отключалась; причину прежних ошибок исполнения это не устанавливает.
Исправленный build: uno_q_rebuild_r2, flash-образ 128712 байт.
Первая предварительная сборка uno_q_rebuild не предназначена для установки:
счётчик loop был поставлен в неактивную тестовую ветку. Проверка места вызова
добавлена в selftest, во второй сборке счётчик находится в рабочем loop.

Почему запись пока не выполнена
ADB serial 3880458060 отображается offline. Одна попытка adb reconnect
не восстановила USB-канал; плата не перезагружалась.
По Wi-Fi она отвечает: SAFE, PWM=0, ARM=0, Vdc=0 по телеметрии.
Нужно переподключить только USB Uno Q к ПК, не менять UART-провода,
оставляя ранее отключённые 15 В и 220 В выключенными.
После записи можно искать паузу без CH7; причина LINK_TIMEOUT пока не доказана.
