11lisov11/mic_practice/POWER_INPUT_NO_RELAY_RU.md

# Силовой Ввод Без Управляемого Реле K1

## Принятая Конфигурация

В текущей сборке управляемое реле предзаряда/байпаса отсутствует.

- `K1`, диод катушки, транзистор драйвера и его резисторы не устанавливать.
- Blue Pill `PB4` никуда не подключать. Прошивка держит его в аналоговом высокоомном режиме.
- STEVAL-IPM15B `J2-21 NTC bypass relay` и Blue Pill `PB1` оставить `NC`.
- Saleae `CH7` оставить свободным. Для ШИМ использовать `CH0..CH5`, для аппаратного разрешения `CH6/PB12`.
- Команда `PRECHARGE ON` запрещена. Статусы `precharge` и `bp_ext & 0x08` всегда должны быть равны нулю.

Удаление K1 не является защитой микроконтроллера от силового напряжения. Эту защиту обеспечивают разделение `SAFE_GND/HOT_GND`, изолированный UART, изолированные каналы анализатора и запрет USB/ST-Link при подключенной силовой шине.

## Что Обязательно Остается Перед Выпрямителем

Силовую шину нельзя подключать напрямую к сети и накопительному конденсатору без ограничения броска тока. Ранее такое включение уже приводило к перегоранию предохранителя.

Обязательная последовательность:

`AC_L -> двухполюсный выключатель/контактор -> F1 -> ограничитель пускового тока -> BR1.AC1`

`AC_N -> двухполюсный выключатель/контактор -> ограничитель пускового тока по схеме производителя -> BR1.AC2`

`BR1.PLUS -> HV_DC+`, `BR1.MINUS -> HV_DC-/HOT_GND`.

Ограничителем должен быть готовый сетевой модуль soft-start/inrush limiter либо рассчитанный под реальный входной ток NTC/аналогичное устройство. Номинал нельзя выбирать без емкости DC-шины, мощности двигателя и максимального входного тока. Постоянные резисторы `20 Ом 5 Вт` и `68 кОм 5 Вт` для этой функции не подходят.

Пока ограничитель не выбран и не проверен, подача 230 В запрещена. Программные защиты STM32 не ограничивают первый заряд конденсатора, потому что бросок возникает до запуска прошивки и ШИМ.

## Поведение Прошивок

- Blue Pill: `USE_PRECHARGE_RELAY=0`, `PB4` high-Z, протокольный бит `0x08` маскируется.
- UNO Q: `PRECHARGE ON` отклоняется, передаваемый бит `0x08` всегда сброшен.
- Wi-Fi HMI: `START` выполняет safety-check, устанавливает ограничение времени, отправляет `START` и подтверждает `pwm=1`; релейного шага нет.
- `STOP`, `ESTOP`, watchdog и потеря связи по-прежнему выключают ШИМ и аппаратное разрешение IPM.

## Контроль Перед Низковольтным Тестом

1. Отключить сеть и J7, разрядить DC-шину и измерить ее мультиметром.
2. Проверить отсутствие деталей K1/Q1/Dcoil и отсутствие провода на PB4.
3. Подать только низковольтные питания логики.
4. Требовать `SAFE`, `pwm=0`, `precharge=0`, `(bp_ext & 0x08)=0`, `bp_fault=0`, `bp_bad=0`.
5. На Saleae проверить CH0..CH5 и CH6. CH7 в новой конфигурации не используется.

## Архивная Схема

Материалы `hardware/mic_ai_rev2` и `FLUX_AI_PCB_TASK_RU.md` описывают предыдущую ревизию с K1. Их нельзя использовать для изготовления текущей платы без переработки силового ввода и повторного ERC/DRC/ревью.
