11lisov11/mic_practice/firmware/ready_to_flash_vf_air56b2_20260929/MCSDK_LOGIC_BENCH_RU.md

# Логическая проверка рабочего MCSDK без силового питания

Проверка воспроизводит рабочий V/f-бэкенд Nucleo, а не прежний отдельный
генератор PWM на PlatformIO. Производственная прошивка остаётся
`2026100601`; временный стендовый образ имеет идентификатор `2026100699`
и хранится только в каталоге артефактов. Для силового питания он запрещён.

## Граница проверки

Тест подтверждает логические выходы Nucleo, доставку команд по Wi-Fi,
STOP/ESTOP, внутренний Break и входную цепь BKIN при отключённой силовой
части. Он не подтверждает вращение, токи двигателя, переключение IGBT,
физическую генерацию аварии IPM или готовность всей установки к сети.

Перед активным тестом силовой J1, J4 и двигатель физически отключены,
мультиметр показывает менее 2 В на DC-шине. Для воспроизводимости
тестовый инструмент требует явного подтверждения этого состояния.

UNO Q и Linux HMI используются без изменения прошивок. START, задания
частоты, STOP и ESTOP приходят по HTTP через Wi-Fi, не через ADB-forward
или отладчик. ADB читает только токен доступа; SWD загружает/проверяет
Nucleo и создаёт контролируемые аварийные стимулы.

## Отличия временной сборки

В отдельную копию проекта внесены три изменения исходных файлов:

- `main.c`: отдельный build ID; разрешение стендового режима по свежим
  низковольтным показаниям вместо ожидания 250 В и 3,5 с.
- `mc_tasks.c`: в этой оснастке снимается только ожидаемый undervoltage;
  сохраняются температура, overvoltage и Driver Protection. После
  стабилизации отслеживается штатное отфильтрованное напряжение не выше
  2 В, свежесть ADC и ограничение непрерывного PWM 15 секундами.
- `acim_vf_control.c`: внутренняя нормировка модуляции использует виртуальные
  310 В. Передаваемая телеметрия Vbus не заменяется этим числом.

Код включения/отключения PWM, обновления CCR, IRQ Break/Update и Driver
Protection сравнивается по машинным секциям объектных файлов. Инициализатор
TIM1 сравнивается по исходному тексту, поскольку компилятор встраивает его
в `main`. Это не побайтовая идентичность всего образа: перечисленные
стендовые изменения остаются явными.

## Измерительные условия

Рабочая настройка: 16 кГц, программный deadtime 1350 нс. На Saleae пишутся
CH0...CH5: PA8, PA7, PA9, PB0, PA10, PB1; CH6: PA6.

Установившиеся сигналы измеряются на 24 Мвыб/с. Полный исходный захват
проверяется на перекрытие; для измерения установившегося deadtime первые
4096 отсчётов отдельно исключаются как зона ранее установленного
буферного артефакта Saleae. Исходный CSV сохраняется. Непрерывные захваты
START/STOP/ESTOP на 4 Мвыб/с анализируются целиком, без такого исключения.

Команды внутри непрерывного захвата выполняются только после успешного
`start_capture`. Нельзя повторить только запись после ReadTimeout и
засчитать её как запись ранее выполненного события.

MCSDK при запуске инициализирует фильтр Vbus средним между порогами
защиты. До его стабилизации это не измеренное напряжение. Поэтому
оснастка ждёт готовности тракта до CLEAR и ARM. Сырые отсчёты от
обесточенной платы сохраняются как диагностика, но не выдаются за
независимо измеренное напряжение шины.

## Проверки Break

`EGR.BG` проверяет внутреннее событие Break при уже работающем PWM.
Дополнительный тест кратко меняет `TIM1.AF1.BKINP`, превращая существующий
высокий уровень внешнего входа в активный. Затем исходная полярность
восстанавливается; GPIO не меняются и PA6 остаётся HIGH. Это проверка
входного тракта таймера, не физическое притягивание SD и не авария IPM.

Штатная блокировка GPIO MCSDK не отключается. Попытка заменить режим
PA6 на GPIO была отвергнута аппаратной защёлкой; этот отрицательный
диагностический опыт не считается успешным тестом SD.

## Повторный прогон

Из корня исходного репозитория (не архива готовых прошивок), при указанных физических условиях:

```powershell
powershell -NoProfile -ExecutionPolicy Bypass -File tools\test_mcsdk_logic_fixture.ps1 `
  -ConfirmIsolatedZeroBus `
  -OutputDirectory C:\mic_practice\artifacts\mcsdk_fixture_next_run
```

Команда проверяет оснастку на ПК, клонирует и собирает проект, выполняет
активный тест и в `finally` восстанавливает производственный HEX.
Затем flash считывается и побайтово сравнивается с производственным BIN;
проверяются SAFE, PWM=0, профиль HV без ARM и стабилизированная шина.
При ошибке смотреть `live/report.json`, особенно поля восстановления.
После восстановления анализатор скважностей независимо восстанавливает
частоту модуляции, направление вращения её вектора и разность фаз
U/V/W из CSV. Это не измерение частоты вращения ротора или фазного напряжения.

Успешный протокол 06.10.2026:
`artifacts/mcsdk_logic_bench_live_20261006_r18/report.json`.
Установившиеся 5/20 Гц взяты из прошедших подпроверок
`artifacts/mcsdk_logic_bench_live_20261006_r14/report.json` при совпадающих
хешах обоих образов. Общий неуспешный статус прежнего прогона не изменён.

Затем вся команда выполнена повторно со свежей сборкой и свежими захватами,
без повторного использования подпроверок:
`artifacts/mcsdk_logic_one_command_20261006_r1/live/report.json`.
Все проверки и анализ модуляции прошли, производственный образ восстановлен.
