11lisov11/mic_practice/artifacts/active_probe_pilot_20260909/ABORTED_RU.md

# Незавершённая ревизия 1

Расчёт остановлен после 87/224 заданий из-за замечаний независимого ревью.
Полный study.json и манифест результата не опубликованы. Это не пилотный итог.
Продолжение: active_probe_pilot_20260909_rev2. Протокол сохранён для истории.
