11lisov11/mic_practice/artifacts/active_probe_refinement_20260909/ABORTED_RU.md

# Незавершённая ревизия 1

Расчёт остановлен после 12/21 заданий из-за замечаний независимого ревью.
Это не проверка сходимости. Продолжение: active_probe_refinement_20260909_rev2.
