11lisov11/mic_practice/artifacts/probe_budget_pilot_20260909/ASSUMPTIONS_RU.md

# Проверка предпосылок и компонентов метода

Диагностика выполнена после основной серии. Истинная мощность парного исходного прогона
используется только здесь, не в регуляторе. Проверка на прореженной сетке способна опровергать
предпосылки, но не доказывает их выполнение между сохранёнными отсчётами.

| Горизонт, с | Ступень нагрузки | Проверенных адаптивных прогонов | Нарушена полоса исходной мощности | Нарушен предел превышения мощности |
|---|---|---:|---:|---:|
| 3 | нет | 32 | 4 | 0 |
| 3 | да | 32 | 32 | 0 |
| 6 | нет | 32 | 4 | 0 |
| 6 | да | 32 | 32 | 0 |

## Попарное отключение ограничений

Это дополнительное описательное сравнение на общей пригодной выборке четырёх вариантов с
запланированным возвратом. Исходный fit не включён в эту выборку, поскольку у него другой
протокол завершения. Число исключённых сценариев показано; статистическая значимость не заявляется.

| Горизонт, с | Общих сценариев / всего | Бюджет против ungated, Дж | Окупаемость против ungated, Дж | Оба против ungated, Дж |
|---|---:|---:|---:|---:|
| 3 | 16/16 | 0.00294 | 0.00000 | 0.00294 |
| 6 | 16/16 | -0.67660 | -0.63565 | -0.67660 |

Нарушение априорных границ отменяет их теоретическую гарантию, даже если ток и скорость
прошли численные критерии. Успешный возврат и отказ от настройки сами по себе не доказывают
энергетического преимущества. Фигуры: budget_all_cases.png и budget_trace.png.
