11lisov11/mic_practice/research/AIR56B2_ENERGY_CORE_THEORY_RU.md

# AIR56B2: энергетически согласованная модель и динамическая адаптация

Дата: 08.09.2026. Исследовательская версия, не идентифицированная модель стенда.
Активная прошивка первого запуска остаётся V/f; приведённый код работает на ПК.

## 1. Исправляемая физическая проблема

В предшествующем статическом эксперименте потери стали прибавлялись к мощности,
но ток стали не входил в электрические уравнения. Такая функция годится как
суррогатная целевая функция, но недостаточна для проверки измеряемой мощности
и энергии переходов. В новой модели сопротивление Rc находится параллельно
ветви намагничивания, после сопротивления и индуктивности рассеяния статора.
Такое расположение используется в динамических моделях асинхронных машин
с потерями стали [1].

Здесь и далее координаты alpha-beta амплитудно-инвариантные, токи и напряжения
пиковые. Все роторные величины приведены к статору. p обозначает число пар полюсов,
Jm - момент инерции. Оператор K(a,b)=(-b,a), произведение a×b=aαbβ-aβbα.

## 2. Уравнения объекта

Состояния: x = (ψsα, ψsβ, ψrα, ψrβ, ψmα, ψmβ, ω).

\[
 i_s=(\psi_s-\psi_m)/L_{\ell s},\qquad
 i_r=(\psi_r-\psi_m)/L_{\ell r},
\]
\[
 i_m=\frac{\psi_m}{L_m}
       \left(1+\kappa\frac{|\psi_m|^2}{\psi_k^2}\right),\qquad
 i_c=i_s+i_r-i_m.
\]
\[
 \dot\psi_s=v-R_si_s,\quad
 \dot\psi_r=-R_ri_r+p\omega K\psi_r,\quad
 \dot\psi_m=R_ci_c.
\]
\[
 T_e=-\frac32p(\psi_r\times i_r),\qquad
 J_m\dot\omega=T_e-T_L-B\omega-T_c\tanh(\omega/\epsilon).
\]

Крутящий момент нагрузки TL - внешний знаковый момент. Механическое трение
добавляется ровно один раз. Постоянный положительный TL не моделирует пассивный
тормоз при реверсе: в данной серии рассматривается положительное вращение.
Нельзя переносить в эту систему прежнюю формулу момента без поправки на ток стали.

Накопленная энергия:

\[
 W=\frac34L_{\ell s}|i_s|^2+\frac34L_{\ell r}|i_r|^2+
 \frac32\left(\frac{|\psi_m|^2}{2L_m}
 +\frac{\kappa|\psi_m|^4}{4L_m\psi_k^2}\right)
 +\frac12J_m\omega^2.
\]

Из приведённых уравнений непосредственно получаем:

\[
 \dot W=\frac32v\cdot i_s-
 \frac32(R_s|i_s|^2+R_r|i_r|^2+R_c|i_c|^2)
 -T_L\omega-B\omega^2-T_c\omega\tanh(\omega/\epsilon).
\]

Это собственный вывод для реализованной модели. При положительных сопротивлениях,
индуктивностях, инерции и неотрицательных коэффициентах трения и насыщения
внутренние потери неотрицательны. Параметры проверяются, состояния не обрезаются.

## 3. Численная схема и границы гарантии

Rc и малые индуктивности рассеяния создают жёсткую систему. Использован
неявный дискретный градиент [3]. Квадратичные члены вычисляются в средней точке,
а ток намагничивания на шаге h задаётся как

\[
 \bar i_m=\frac{\psi_{m,1}+\psi_{m,0}}{2L_m}
 \left[1+\kappa\frac{|\psi_{m,1}|^2+|\psi_{m,0}|^2}{2\psi_k^2}\right].
\]

Он точно воспроизводит приращение нелинейной магнитной энергии. Семь неизвестных
следующего шага решаются совместно методом Ньютона с аналитическим якобианом
и уменьшением шага коррекции. Невязка или несходимость запрещает обновление состояния.
Входная работа, потери и работа вала интегрируются по тем же средним величинам.

Равенство баланса на дискретном шаге не доказывает точность траектории.
Средняя точка не L-устойчива и может сохранять быстрые знакопеременные моды.
Поэтому отдельно проверяются сходимость при уменьшении h, решение Radau,
пассивное затухание, якобиан конечными разностями и динамический опыт
при h = 100, 50 и 25 мкс. Вывод о точности относится к проверенным режимам,
не ко всем возможным возмущениям и значениям Rc.

В основной итоговой серии h объекта = 50 мкс, период регулятора = 100 мкс.
Дополнительное измельчение объекта: 25 и 12,5 мкс, без изменения регулятора.
Исходная 100-мкс сетка объекта не выдержала принятого допуска по вариации
энергии; знак выигрыша сохранился, но основная серия была пересчитана.

В дополнительном опыте уменьшается только шаг объекта при неизменном
100-мкс периоде контроллера/датчиков и тех же отсчётах шума. Отдельный тест
начинается с намагниченного состояния, проверяет всю траекторию токов
и интегралы потерь при Rc = 1200 и 4000 Ом, а не только конечную точку.
Для этого быстрого перехода нужна существенно более мелкая сетка (0,5 мкс).

## 4. Какие параметры известны, а какие предполагаются

- Паспорт берётся из единого `Air56B2Nameplate`; в нём нет скрытых измерений двигателя.
- F1 даёт ограниченное паспортом семейство схем, а не единственное решение идентификации.
- Rs, Rr, механические потери и коэффициент изменения потерь стали берутся из явных F2-приоров.
- Rc = Rc_F1 / scale_F2. Это сохранение опорного сопротивления, а не новая идентификация стали.
- Насыщение: kappa = 0 или 0,4; ψk = 0,5 Вб (амплитуда), отдельная новая гипотеза.
- Постоянный Rc описывает квадратичную зависимость от ЭДС. Гистерезис, неодинаковая
  зависимость от частоты и вращения потока требуют более общей модели [2].
- Сопротивления постоянны в каждом коротком опыте; нагрев во времени не интегрируется.
- Проверка этой расширенной модели по всем паспортным точкам, включая пусковые
  отношения, остаётся отдельной задачей. Никакая поправка момента F1S не вводится:
  независимое масштабирование момента разрушило бы энергетическое равенство.

## 5. Регулятор и измерительное окно

Использованы PI-регуляторы, ограничение напряжения и anti-windup из существующего
FOC. Модель усреднённая: генератор ШИМ, коммутационные потери и аппаратный шлюз
не исполняются. Граница мощности - клеммы двигателя, не сеть и не звено DC.

Для ориентации используется токовый наблюдатель с измеренной скоростью:

\[
 \dot{\hat\psi}_r=
 (-R_r/L_r+jp\hat\omega)\hat\psi_r+(R_rL_m/L_r)i_s.
\]

Шаг вычисляется аналитически при постоянных на шаге измеренных токе и скорости.
Такой подход к sensored FOC описан, в частности, в документации TI [4].
Наблюдатель не получает истинного потока, но остаётся параметрическим: ошибки
Rr/Lr, насыщения и неучтённого тока стали никуда не исчезают. Это не sensorless
и не model-free FOC. AS5600 здесь используется для механической скорости,
а угол потока не отождествляется с механическим углом ротора.

Надстройка получает только наблюдения мощности, тока, напряжения, скорости
и задание скорости. Пять последовательных окон включают повтор исходного
режима и проверку кандидата. По трём установившимся точкам аппроксимируется
P(id)=a id²+b/id²+c; при непригодной аппроксимации используется допустимая
измеренная точка. Такой кандидат требует новой проверки, а не немедленного применения.

Проверенный скачок нагрузки происходит во время проб (2,6 с). После принятия
кандидат удерживается; продолжается проверка конечности наблюдений и электрических
пределов. Повторный запуск оптимизации при более поздней смене режима ещё не
реализован. Для нового цикла требуется новый supervisor или отдельная событийная
логика с паузой между опытами. Поэтому тест отказа при дрейфе нельзя трактовать
как доказательство непрерывного отслеживания оптимума.

## 6. Проверяемые гипотезы следующего этапа

H1. Выгода изменения потока зависит от скорости, нагрузки и ожидаемой длительности
режима; частые полные пробы способны увеличить общие потери. Следует сравнить
периодические пробы с событийным запуском по ожидаемой окупаемости и неопределённости.

H2. Нейросеть полезнее проверять как предсказатель выгодности/необходимости пробы
и начального кандидата. Она должна экономить измерения при тех же ограничениях,
а не получать скрытый момент или дополнительные привилегии относительно аналитического метода.

H3. Для адаптации Rr/Lr требуется возбуждение, достаточное для различения параметров.
Одна постоянная рабочая точка не гарантирует идентифицируемость; нужно исследовать
ранг и обусловленность чувствительностей наблюдаемых величин к параметрам.

H4. Пусковые отношения следует уточнять структурой объекта, а не независимым
множителем момента. Кандидат для следующей проверки - две пассивные роторные
ветви: ψrj = Llj irj + ψm, dψrj/dt = -Rrj irj + pωKψrj,
ic = is + ir1 + ir2 - im; Te = -(3/2)p Σj(ψrj×irj).
В энергию добавляется (3/4) Σj Llj|irj|². При положительных параметрах
такая конструкция сохраняет тот же баланс с суммой роторных медных потерь.
Это предложенная постановка, ещё не реализованная и не идентифицированная:
паспортных отношений недостаточно, чтобы однозначно определить обе ветви.

Новые нейронные веса в этой серии не обучались и не переносились на платы.
Требуются разделение данных по объектам, независимый validation-набор,
включение переходов/отказов и проверка против аналитического метода с тем же бюджетом проб.

## Источники

1. De la Barrera et al. On-line iron loss resistance identification by a state observer
   for rotor-flux-oriented control of induction motor. 2008.
   https://doi.org/10.1016/j.enconman.2008.03.021
2. Ranta et al. Inclusion of hysteresis and eddy current losses in dynamic induction
   machine models. 2009.
   https://aaltodoc.aalto.fi/items/c0c04436-2f08-49d8-a374-fe9561c0eb06
3. McLachlan, Quispel, Robidoux. Geometric integration using discrete gradients. 1999.
   https://doi.org/10.1098/rsta.1999.0363
4. Texas Instruments. Sensored Field Oriented Control of 3-Phase Induction Motors.
   https://www.ti.com/lit/an/sprabp8/sprabp8.pdf

## Воспроизведение и файлы

`tools/run_air56b2_dynamic_power.ps1` запускает тесты, основную серию,
проверку шага и генерацию результатов. Итоги:
`research/AIR56B2_DYNAMIC_POWER_RESULTS_RU.md`.
