11lisov11/mic_practice/research/mic_ai_theory/model_identification/RESEARCH_RU.md

# Модельно-ориентированная идентификация параметров MIC AI

Дата расчетной ревизии: 9 августа 2026 г.

## Задача

Цель этапа — определить, какие параметры асинхронного двигателя действительно
можно восстановить по доступным сигналам стенда, а не просто получить результат
численного оптимизатора. Используются известные векторы напряжения `v_alpha`,
`v_beta`, два тока статора и скорость ротора. Истинные параметры синтетического
двигателя доступны только после подгонки для вычисления ошибки.

Целевые параметры:

- `Rs`, `Rr` — сопротивления статора и ротора;
- `Lm` — индуктивность намагничивания;
- `J` — момент инерции;
- `B` — эффективный коэффициент вязкого трения.

В подгонку дополнительно включены два nuisance-параметра:

- `Lsigma=(Lls+Llr)/2`, потому что `Lls` и `Llr` отдельно неразличимы;
- `Tload`, потому что неизвестный постоянный момент иначе смещает оценку `B`.

## Исправленные ошибки прежнего контура

1. Старый `run_full_identification` инициализировал `J` и `B` истинными
   параметрами симулятора. Утечка удалена; теперь используются только явные
   priors или переданное пользователем начальное приближение.
2. `DirectVoltageEnv.set_torque_command()` фактически подавал q-напряжение, но
   называл его моментом. Теперь этот канал обозначается `iq_ref` и не разрешает
   механическую идентификацию как по известному моменту.
3. Оптимизатор раньше возвращал параметры без проверки ранга. Новый контур
   вычисляет чувствительность по логарифмам физических параметров, SVD,
   Fisher-матрицу, condition number и корреляции. Неполный ранг блокирует fit.

## Экспериментальный профиль

Профиль `c6_multiscale` состоит из трех частей:

1. Заблокированный ротор: все шесть активных векторов инвертора проходят
   выдержки `1, 2, 4, 8, 16` тактов с нулевыми интервалами.
2. Свободный ротор: C6-сбалансированная последовательность выполняет прямой
   разгон, выбег, реверс и второй выбег.
3. Измеряемый механический выбег: начальная скорость `20 рад/с`, напряжение
   равно нулю, длительность `5 с`. Он разделяет `B`, `J` и `Tload`.

Односекторный baseline имеет ранг `6/7` после добавления общего выбега и поэтому
блокируется. Если пытаться оценивать `Lls` и `Llr` отдельно, получается ранг
`7/8`; подстановка симметричной комбинации `Lsigma` дает полный ранг `7/7`.

## Протокол проверки

Выполнены две независимые серии с корневыми seed `20260820` и `20260821`.
Каждая содержит 12 неизвестных двигателей. Варьируются `Rs`, `Rr`, `Lm`, `J`,
`B`, отдельно `Lls/Llr` в диапазоне ±20%, неизвестный постоянный момент в
диапазоне ±0,005 Н·м и измерительный шум. На каждый двигатель выполняется
двухзапусковая ограниченная подгонка в логарифмическом пространстве.

Для проверки дизайна в каждой серии C6 сравнивается с 32 новыми PRBS-профилями.
Итоговый confirmatory-аудит не требует, чтобы C6 выигрывал каждую конечную
ошибку. Он требует полный ранг, D-информационный выигрыш минимум над 90% PRBS,
медианную максимальную ошибку пяти целевых параметров не более 5% и отсутствие
превышения модельного ограничения тока.

## Результаты

### Информативность

- C6: `log10 det(Fisher)=37,8281`, condition number `74,8235`.
- Exploratory PRBS: медиана `35,6417`, диапазон `34,4162...37,2389`.
- Confirmatory PRBS: медиана `36,1299`, диапазон `35,1583...37,0663`.
- C6 выиграл `32/32` сравнений в каждой серии; односторонний sign-test
  `p=2,3283e-10` в каждой серии.

Condition number не дает универсального преимущества C6. В exploratory-серии
condition выбранного PRBS был `32,9212`, то есть ниже C6; в confirmatory —
`80,5125`, то есть выше C6. Поэтому утверждается увеличение D-информации, а не
улучшение всех направлений чувствительности.

### Точность пяти целевых параметров

- Exploratory C6: медианная максимальная ошибка `0,5581%`.
- Confirmatory C6: медианная максимальная ошибка `0,9194%`.
- Exploratory PRBS: `0,3838%`.
- Confirmatory PRBS: `0,5499%`.
- В парном сравнении C6 дал меньшую максимальную ошибку только на `9/24`
  двигателях; медианное отношение ошибки C6/PRBS равно `1,3610`.

Это отрицательный, но важный результат: больший Fisher determinant в локальной
модели не гарантирует меньшую ошибку при структурном расхождении `Lls != Llr`.
Результат PRBS нельзя скрывать или называть проигрышем.

### Ток и границы

- Максимальный ток C6 в двух сериях: `0,735 А` при лимите `1,75 А`.
- Максимальный ток PRBS: `0,541 А`; превышений нет.
- Односекторный baseline достигал `2,56 А` и дополнительно должен быть
  заблокирован токовым gate до физического исполнения.
- Это только расчет в цифровой модели. MCU, HIL и силовая часть не проверялись.

## Научная значимость

Защищаемый кандидат формулируется так:

**Идентификационно-гейтированное C6-многомасштабное возбуждение конечными
векторами инвертора с явными nuisance-параметрами рассеяния и нагрузки для
совместной оценки электрических и механических параметров асинхронного
двигателя.**

Его научная значимость состоит в объединении четырех проверяемых элементов:

1. Предварительный запрет оценки при неполном ранге, а не проверка только
   сходимости оптимизатора.
2. Использование циклической симметрии реального двухуровневого инвертора и
   нескольких временных масштабов возбуждения.
3. Автоматический переход от неразличимых `Lls/Llr` к наблюдаемому `Lsigma` и
   совместная оценка неизвестного `Tload`.
4. Раздельная отчетность D-информации и фактической ошибки, включая случай,
   когда более информативный профиль оказался менее точным из-за model mismatch.

По целевому поиску не найден прямой предшественник с точно такой комбинацией.
Это обосновывает проверяемый кандидат предметной новизны, но не мировой
приоритет. Нужны систематический обзор и физическая валидация.

## Граница относительно литературы

Идентификация асинхронных двигателей по напряжениям, токам и скорости известна;
из-за ненаблюдаемого потока ротора не все исходные параметры можно оценить
независимо. Это явно обсуждается в работе по LS/GA-идентификации
[Alonge et al., 2001](https://doi.org/10.1016/S0967-0661(01)00024-7).

Чувствительность отдельных комбинаций даже при persistent excitation ранее
показана в
[IFAC, 2002](https://doi.org/10.3182/20020721-6-ES-1901.00285), а локальные
условия наблюдаемости сопротивлений и момента — в
[IFAC, 2013](https://doi.org/10.3182/20130703-3-FR-4038.00056).

Современный экспериментальный метод уже использует многочастотную инжекцию
`5/200 Гц` и отдельный динамический тест для электрических параметров и инерции:
[IEEE Access, 2024](https://doi.org/10.1109/ACCESS.2024.3467381). Модельная
идентификация по пусковым данным промышленных датчиков также показана в
[Fagiano et al., 2019](https://doi.org/10.1109/TCST.2018.2859209).

Следовательно, новизна не может состоять в «оценке параметров двигателей» как
таковой. Проверять нужно конкретно C6-многомасштабный дизайн, rank-gate и работу
с nuisance-параметрами.

## Следующий физический этап

До силового теста необходимы:

1. Калибровка двух токовых каналов, Vbus и энкодера с сохранением сырых данных.
2. Реализация профиля с масштабированием напряжения по току; расчетные `48 В`
   не являются разрешением напрямую повторять профиль на шине `310 В`.
3. Аппаратный fail-closed gate по току, STO/SD и времени команды.
4. Низковольтный standstill-тест, затем свободный реверсивный тест и выбег.
5. Слепая оценка параметров без паспортных ответов, затем проверка на другом
   профиле скорости и нагрузки.

## Воспроизведение

```powershell
.\.venv\Scripts\python.exe tools\run_model_based_identification_study.py `
  --seed 20260820 --motors 12 --steps-per-stage 1920 --starts 2 `
  --design-repetitions 32 --output outputs\model_based_identification\exploratory_20260820.json

.\.venv\Scripts\python.exe tools\run_model_based_identification_study.py `
  --seed 20260821 --motors 12 --steps-per-stage 1920 --starts 2 `
  --design-repetitions 32 --output outputs\model_based_identification\confirmatory_20260821.json

.\.venv\Scripts\python.exe tools\analyze_model_based_identification_study.py `
  outputs\model_based_identification\exploratory_20260820.json `
  outputs\model_based_identification\confirmatory_20260821.json `
  --output outputs\model_based_identification\aggregate_20260820_20260821.json
```
