11lisov11/mic_practice/research/mic_ai_theory/snh_pwm/c6_conformal_reachability/RESEARCH_RU.md

# C6-BCR: блочно-конформное множество достижимости для FCS-привода

Дата фиксации гипотезы: 9 августа 2026 г.

## Статус результата

Сформулирован **кандидат научной новизны** и получено воспроизводимое свидетельство
уменьшения гиперобъёма. Исправленный inferential-контур использует независимые пары
`calibration -> одна test-траектория`. В двух prospectively locked сериях агрегат
`759/800` прошёл exact 99% coverage non-inferiority gate, а медианный C6/raw volume
ratio составил `0,784784`. Строгий общий replication gate не пройден: индивидуальные
LCB `0,918599` и `0,915549` ниже заранее заданного порога `0,92`. Мировая новизна не
установлена; также отсутствуют HIL-, MCU- и аппаратные гарантии.

Рабочее название метода: **C6-BCR** (`C6 Block-Conformal Reachability`).

## Научная проблема

Робастный FCS-контроллер C6-RV-PWM использовал вручную заданные радиусы параметров
`Rs`, `Rr`, `Lm`, `J`. Такое множество легко сделать слишком узким или слишком
консервативным, но оно не имеет конечновыборочной гарантии покрытия фактической ошибки
модели. Обычный conformal-box также теряет геометрическую эффективность: остатки из
шести электрических секторов накладываются в неподвижных координатах alpha-beta и
раздувают осевой гиперпрямоугольник.

## Предложенный метод

Для каждого перехода вычисляется пятикомпонентный остаток

`r_t = x_(t+1) - f_nom(x_t, u_t)`,

где компоненты соответствуют потокам статора и ротора по alpha-beta и механической
скорости. Сектор `k_t` определяется по углу потока статора. Две пары электрических
компонентов поворачиваются на `-k_t*pi/3`, то есть переход приводится к одному
каноническому представителю C6-орбиты. Скорость не поворачивается.

Независимая обучающая выборка определяет только форму `a_j` нормирующего
гиперпрямоугольника. Для каждой калибровочной траектории из `H` переключений строится
один блочный score:

`S_i = max_(t=1..H, j=1..5) |[T_(-k_t) r_(i,t)]_j| / a_j`.

По `n` обменным калибровочным траекториям берётся порядковая статистика ранга

`ceil((n + 1) * (1 - alpha))`.

Один score на всю траекторию принципиален: независимость соседних PWM-тактов не
предполагается, а событием покрытия считается одновременное попадание всех пяти
компонент на всех `H` тактах. После обратного C6-поворота получается секторно
адаптивное множество ошибки в физических alpha-beta координатах.

## Конечновыборочное утверждение

Пусть обучающая выборка независима, а `n` калибровочных траекторий и одна будущая
траектория обменны как целые блоки. Тогда их scores обменны. При отсутствии случайных
совпадений ранг test-score среди `n+1` scores равномерен, поэтому квантиль с поправкой
`n+1` обеспечивает

`P(S_test <= q_(1-alpha)) >= 1 - alpha`.

Следовательно, весь остаточный блок длины `H` одновременно содержится в обратных
C6-поворотах канонического гиперпрямоугольника с маргинальной вероятностью не ниже
`1-alpha`. Доказательство не требует независимости внутри блока. Сам conformal-факт
сохраняется для любой детерминированной канонизации; C6-эквивариантность нужна для
физически корректной геометрии и уменьшения консерватизма.

Это утверждение **не** является условной гарантией для каждого фиксированного split,
рекурсивной гарантией бесконечного горизонта или гарантией при distribution shift.

## Зафиксированный протокол

- `alpha=0.05`, целевое маргинальное покрытие `95%`;
- 24 независимых разбиения на серию;
- 220 обучающих, 400 калибровочных, 800 контрольных и 200 OOD-траекторий на разбиение;
- 20 тактов burn-in и 40 оцениваемых PWM-тактов на траекторию;
- калибровочный ранг `381` из `400`;
- три метода: неподвижный global-box, шесть независимых sectorwise-box и C6-канонический box;
- параметры двигателя случайно изменяются по `Rs/Rr +/-40%`, `Lm +/-15%`,
  `J/B +/-50%`; для OOD радиусы умножаются на `1.75`;
- train, calibration, test и OOD используют разные seed; повёрнутые копии не
  считаются независимыми наблюдениями.
- для inferential coverage-gate дополнительно используются не менее 400 независимых
  пар `calibration -> одна test-траектория` при фиксированной отдельной training-выборке;
  только эти Bernoulli-наблюдения используются для exact Clopper-Pearson lower bound;
- заранее задан non-inferiority margin `3 п.п.`: односторонняя 99%-ная нижняя
  граница coverage должна быть не ниже `0,95 - 0,03 = 0,92`; простое
  неотклонение гипотезы undercoverage не считается положительным доказательством;
- 800 test-траекторий каждого основного split используются описательно для coverage,
  OOD и sharpness, но не объединяются в биномиальный p-value.
- sharpness-гипотеза проверяется относительно порога `C6/raw < 0,90`, ties
  исключаются из exact sign-test;
- JSON содержит SHA-256 полного протокола, параметров базовой модели и исходников;
  независимый analyzer повторно генерирует траектории по seed и пересчитывает tube,
  scores, coverage, sharpness и C6-equivariance;
- predictor использует точное текущее состояние и сектор истинного потока, поэтому
  результат относится к one-step oracle-state модели, а не к estimator-fed контуру.

## Независимая ревалидация 20260826/20260827

Протокол и root seeds были зафиксированы в Git до вычислений. Обе серии прошли
детерминированный replay и все проверки целостности.

- seed `20260826`: `380/400`, coverage `0,95000`, exact 99% LCB `0,918599`,
  C6/raw ratio `0,793302`, wins `20/24`, sign-test `p=0,00077194`;
- seed `20260827`: `379/400`, coverage `0,94750`, exact 99% LCB `0,915549`,
  C6/raw ratio `0,781685`, wins `20/24`, sign-test `p=0,00077194`;
- агрегат: `759/800`, coverage `0,94875`, exact 99% LCB `0,927645`, C6/raw ratio
  `0,784784`, wins `40/48`, sign-test `p=1,6526e-6`.

Агрегированный coverage-gate и sharpness-gate пройдены. Итоговый
`confirmatory_replication_pass=false`, поскольку оба индивидуальных coverage-gate
не пройдены. При истинном coverage `0,95` мощность одной серии из 400 проб равна
только `0,467970`, а совместного прохождения двух таких серий - `0,218996`.
Post-run power-анализ не меняет результат; новый протокол должен заранее задавать
не менее 897 проб на серию для мощности 90% или 1069 для мощности 95%.

## Estimator-fed exploratory-этап

Добавлен voltage/current observer, который не получает истинные потоки. Его входы -
измеренные токи alpha-beta, восстановленное приложенное напряжение и обработанная
скорость энкодера. В paired-серии из восьми split median sector accuracy составила
`0,973875`, median estimator-fed coverage - `0,9550` описательно, а C6/raw volume
ratio - `0,824788`. Полный replay прошёл.

При этом estimator/oracle volume ratio достиг `6,73e6`: ошибка наблюдения полностью
доминирует над почти нулевым oracle residual. Это важный отрицательный результат,
показывающий, что перенос C6-BCR на реальный привод требует offset/Rs correction,
модели дискретного энкодера и отдельной estimator-fed calibration. Подробности:
`revalidation/ESTIMATOR_FED_20260828_RU.md`.

## Архивные результаты до исправления coverage-аудита

Ниже сохранены исходные bulk coverage и sharpness-результаты. Числа coverage являются
описательными. Приведённые в старых JSON pooled-binomial p-value больше не считаются
валидным подтверждением маргинального coverage, поскольку 800 test-блоков одного
split используют общий случайный calibration tube.

### Seed 20260809: development evidence

Этот корневой seed пересекается с коротким exploratory-прогоном rev2 и поэтому не
используется как независимая подтверждающая серия.

- совокупное C6-покрытие: `94.765625%` при цели `95%`;
- прежний pooled p-value `0.0710672` исключён из inferential gate;
- медианное отношение C6/global 5D-гиперобъёма: `0.759127`;
- C6 меньше global в `19/24` разбиениях;
- парный односторонний sign-test: `p=0.00330538`;
- OOD-покрытие: `53.604167%`.

### Seed 20260810

- совокупное C6-покрытие: `94.973958%`;
- прежний pooled p-value `0.438859` исключён из inferential gate;
- медианное отношение C6/global 5D-гиперобъёма: `0.707827`;
- C6 меньше global в `22/24` разбиениях;
- парный односторонний sign-test: `p=1.7941e-5`;
- OOD-покрытие: `54.791667%`.

### Seed 20260811: второй слепой confirmatory seed

- совокупное C6-покрытие: `95.151042%`;
- прежний pooled p-value `0.835628` исключён из inferential gate;
- медианное отношение C6/global 5D-гиперобъёма: `0.750623`;
- C6 меньше global в `20/24` разбиениях;
- парный односторонний sign-test: `p=0.00077194`;
- OOD-покрытие: `54.5625%`.

### Агрегат слепых seed 20260810 и 20260811

- 48 разбиений и 38 400 ранее не виденных контрольных траекторий;
- описательное совокупное покрытие: `95.0625%`; прежний p-value `0.716102`
  исключён из inferential gate;
- медианное отношение C6/global гиперобъёма: `0.739117`;
- C6 меньше global в `42/48` разбиениях;
- парный sign-test: `p=5.04374e-8`;
- совокупное OOD-покрытие: `54.677083%`.

Таким образом, две архивные слепые серии воспроизвели сжатие медианного гиперобъёма
примерно на `26%`. Они не подтверждают и не опровергают целевое маргинальное coverage
на выбранном уровне значимости после исправления единицы статистического анализа.
Результат sharpness относится к отношению смешанных по единицам 5D-гиперобъёмов;
абсолютный гиперобъём физического смысла не имеет.

## Важные отрицательные результаты

Первый вариант канонизировал остаток по направлению приложенного вектора, а не по
потоку статора. Он ухудшил медианный объём в `1.6538` раза. Этот вариант отклонён.

В короткой второй серии канонизация по потоку уже дала отношение `0.8344`, но два
фиксированных split показали низкое условное coverage. Это не противоречит
маргинальной split-conformal гарантии и дополнительно показывает, почему bulk test
одного calibration split нельзя выдавать за независимые marginal coverage-пробы.

При увеличении радиусов неопределённости в `1.75` раза OOD-покрытие падает примерно
до `54%`. Следовательно, метод нельзя использовать как distribution-free защиту от
произвольного дрейфа: нужен online drift gate или адаптивная перекалибровка.

## Граница относительно литературы

- Split conformal prediction и поправка `n+1` известны.
- Общая predictive inference при групповых симметриях дана в
  [SymmPI](https://doi.org/10.1093/jrsssb/qkaf022).
- Симметризация conformal prediction предобученного predictor предложена в
  [eCP](https://arxiv.org/abs/2602.03986).
- Conformal prediction уже объединяется с reachability и safe control в
  [Conformal Reachability](https://arxiv.org/abs/2602.03799) и
  [Adaptive Conformal Safe Control](https://arxiv.org/abs/2407.03569).
- FCS-MPC силовой электроники и его вычислительное ускорение известны, например
  [High-Speed FCS-MPC](https://arxiv.org/abs/1510.05578).

По выполненному целевому поиску не найден прямой предшественник, который одновременно
использует C6-канонизацию остатка физической модели двухуровневого инвертора,
траекторный max-score по PWM-тактам и состояниям и split-conformal калибровку
множества ошибки асинхронного FCS-привода. Это обосновывает **кандидат** новизны, но
не право писать «впервые в мире».

## Защищаемая формулировка

Предложен метод C6-канонической блочно-конформной калибровки множества ошибки
конечновыборочной модели асинхронного электропривода. Метод использует физическую
циклическую симметрию инвертора для приведения остатков шести секторов к общей
системе координат и применяет один nonconformity score ко всем состояниям и тактам
траектории. Для обменных траекторий сохраняется теоретическое конечновыборочное
маргинальное покрытие всего блока. В новой независимой ревалидации агрегированный
5D-гиперобъём оказался на `21,5%` меньше обычного conformal-box, а aggregate exact
99% coverage lower bound превысил `0,92`. Строгий replication gate не пройден из-за
двух отрицательных индивидуальных lower-bound tests.

## Что делать дальше

1. До нового запуска зафиксировать две серии минимум по 897 независимых проб для
   мощности 90% или по 1069 проб для мощности 95%.
2. Добавить дискретную модель AS5600, offset/Rs correction и low-speed observer gate.
3. Проверить метод на другом наборе параметров двигателя и другой дискретизации,
   не меняя формулу score.
4. Добавить online-тест обменности/drift и fail-closed возврат к робастному
   сигма-множеству при OOD.
5. Преобразовать conformal flux-box в строгую верхнюю границу тока и встроить её
   в gateway C6-RV-PWM.
6. Сравнить WCET C6-box, sectorwise-box и девяти сигма-точек на Nucleo G431.
7. Провести систематический обзор IEEE Xplore, Scopus, Web of Science и патентов
   перед публикационным заявлением о мировой новизне.

## Воспроизведение

```powershell
py -3 -u tools\run_cyclic_conformal_reachability_lab.py `
  --repetitions 24 --train 220 --calibration 400 --test 800 --ood 200 `
  --steps 40 --burn-in 20 --coverage-probes 400 --seed 20260826 --out result.json

py -3 -u tools\analyze_cyclic_conformal_reachability_lab.py result.json `
  --out-json result_audit.json --out-md result_audit.md

py -3 -u tools\aggregate_cyclic_conformal_reachability.py seed_20260826.json seed_20260827.json `
  --out-json confirmatory_audit.json --out-md confirmatory_audit.md

py -3 -u tools\plan_binomial_noninferiority_power.py `
  --assumed-coverage 0.95 --threshold 0.92 --error-probability 0.01 `
  --out-json power.json --out-md power.md
```
