11lisov11/mic_practice/research/mic_ai_theory/snh_pwm/c6_rv_pwm/RESEARCH_RU.md

# C6-RV-PWM: математическая исследовательская ветка

## Статус

Это host-only исследование. Оно не является прошивкой, HIL-доказательством или
допуском к силовой шине. Новизна не считается установленной до систематического
обзора и внешнего рецензирования.

## Проверяемая гипотеза

Для двухуровневого трёхфазного инвертора проверяется комбинация трёх механизмов:

1. Циклическая симметрия `C6` переводит электрическое состояние и допустимые
   активные векторы между шестью секторами без изменения тока и момента.
2. Каждый кандидат оценивается не на одной модели, а на девяти сигма-точках
   параметров `Rs`, `Rr`, `Lm`, `J`; стоимость объединяет среднее, CVaR и худший
   случай.
3. Рядом с плановой границей тока лениво включается predecessor-проверка:
   для каждого прогнозируемого члена множества должно существовать хотя бы одно
   следующее переключение, сохраняющее ток внутри планового множества.

Для поворота на `k * pi/3` численно проверяется метаморфное соотношение

`T_k f(x, u, p) = f(T_k x, R_k u, p)`,

где `T_k` поворачивает потоки в плоскости alpha-beta, а `R_k` переставляет
векторы инвертора. Это тест симметрии конкретной дискретизированной модели, а не
общая теорема об аппаратном приводе.

## Почему это не просто ещё одна нейросеть

Рабочий контроллер не содержит обучаемых весов. Неопределённость представлена
явным конечным множеством моделей, риск — CVaR/наихудшей стоимостью, а безопасность
остаётся за независимым gateway. Нейросетевой SNH-PWM используется только как один
из базовых алгоритмов сравнения.

## Результат rev3

Протокол: 31 сценарий, 5 парных повторов, 2000 шагов по 100 мкс, четыре основных
контроллера, шесть абляций, 500 тестов симметрии и отдельный cross-entropy поиск
контрпримеров.

- C6-эквивариантность: максимальный численный остаток порядка `1.3e-15`.
- Ошибка скорости относительно текущего FOC-SVM: лучше в 29 сценариях, хуже в
  `braking`, статистически неразличима в `reverse`.
- Максимальный ток модели: `4.580244 А` при trip-пороге `6.125 А`.
- Неожиданных fault latch и программных shoot-through нарушений не найдено.
- Fault injection ожидаемо вызвал OC-защёлку без shoot-through.
- C6-вариант использовал около 4-5 кандидатов вместо восьми.
- Ленивый horizon снизил типичную цену примерно с 360 до 40-45 модельных
  переходов на такт; в OOD проверка активировалась чаще.
- Predecessor не отверг ни одного кандидата. Его вклад в качество или безопасность
  текущими данными не доказан.
- Falsification не нашёл небезопасный пример, но нашёл область с положительным
  speed-regret. Это ограничение, а не ошибка инструмента.

## Граница относительно известных работ

FCS-MPC, длинные горизонты, робастные модели, CVaR, barrier-функции, conformal
uncertainty и автоматический falsification известны по отдельности. В частности:

- multistep/high-speed FCS-MPC: [Stellato, Geyer, Goulart](https://arxiv.org/abs/1510.05578);
- терминальные периодические множества и гарантии предельного цикла FCS-MPC:
  [Xu, Lazar](https://arxiv.org/abs/2407.07615);
- робастное предсказание момента и потока асинхронного двигателя:
  [IEEE 9335479](https://ieeexplore.ieee.org/abstract/document/9335479/);
- Wasserstein distributionally robust nonlinear MPC:
  [Zhong et al.](https://arxiv.org/abs/2211.14595);
- adaptive conformal uncertainty с safety constraints:
  [Zhou, Zhang, Luo](https://arxiv.org/abs/2407.03569);
- автоматический поиск нарушающих входов по формальным требованиям:
  [Peltomaki, Porres](https://doi.org/10.1007/s10515-025-00503-x).

Поэтому допустимая формулировка — «кандидатная C6/robust/lazy-viability интеграция
для FCS-управления асинхронным приводом». Формулировка «первый в мире метод» по
текущему поиску недоказуема.

## Следующие математические гипотезы

1. Заменить ручные радиусы сигма-множества conformal-квантилизацией ошибки модели
   и проверить покрытие на отложенных seed.
2. Добавить периодическое terminal set для режима установившегося вращения и
   отдельно исследовать `braking`/`reverse`.
3. Проверить глубину predecessor больше одного шага только в области с малой
   текущей margin, используя branch-and-bound и memoization.
4. Добавить dual-control критерий информационной различимости параметров, но
   разрешать probing только внутри робастно безопасного множества.
5. Перевести требования в количественную temporal-logic robustness и направлять
   falsification не агрегированным score, а минимальной STL-робастностью.
6. Провести полный MC30 для 31 сценария, bootstrap-интервалы и коррекцию
   множественных сравнений до любых публикационных выводов.

## Воспроизведение

```powershell
python tools\run_cyclic_robust_viability_lab.py --scenarios <list> --mc 5 --steps 2000 --workers 16 --output result.json
python tools\analyze_cyclic_robust_viability_lab.py result.json --out-json audit.json --out-md audit.md
```
