11lisov11/mic_practice/research/AIR56B2_ACTIVE_PROBE_IDENTIFIABILITY_RU.md

# Что можно доказать по парным измерениям, а что нельзя

## 1. Точная компенсация только аффинной составляющей

Пусть мощность исходного режима при отсутствии пробы равна B(t)=a+b*t.
Для любого окна усреднения с нормированными неотрицательными весами
средняя мощность равна B(t_bar), где t_bar есть взвешенный центр времени.
Поэтому опора для окна пробы в момент t_B:

    B_hat(t_B) = (1-alpha)*P_A1 + alpha*P_A2,
    alpha = (t_B-t_A1)/(t_A2-t_A1)

точна при отсутствии ошибки измерения и влияния пробы на опорные окна A.
Это следует непосредственной подстановкой a+b*t. Неравномерность расстояний
между окнами не мешает, если использовать действительные временные центры.
Утверждение касается общего аддитивного дрейфа, не изменения эффекта пробы
под нагрузкой. Это известный принцип измерительных ABA-сравнений, не новизна.

Реализация использует мощность предыдущего такта и время его середины;
тест `test_bracket_cancels_affine_drift_and_measures_return_separately`
проверяет компенсацию и отдельный учёт положительной цены возврата.

## 2. Почему два опорных окна не доказывают точность между ними

Рассмотрим B0(t) и B1(t)=B0(t)+K*h(t), где h гладкая, равна нулю на обоих
опорных окнах и ненулевая в окне пробы. Показания в A одинаковы при любом K.
Отсюда два окна сами по себе не дают конечной гарантированной границы ошибки
между ними. Если неизвестен эффект пробы, можно одновременно изменить его
на K*h(t), сохранив также наблюдаемую мощность B во время воздействия.
Тогда доступная последовательность измерений одинакова при разном истинном
контрфактическом выигрыше. Это контрпример в классе произвольных аддитивных
нестационарных возмущений, не доказательство физической реализуемости всех
таких функций данным двигателем и не невозможность любых методов управления.

Для точечных опор и дополнительно известного |B''(t)| <= M стандартная
ошибка линейной интерполяции внутри интервала ограничена:

    |B(t)-B_hat(t)| <= M/2 * (t-t_A1)*(t_A2-t).

Для средних окон нужны ещё поправки на кривизну внутри самих окон. В проекте
M не измерена и не взята из паспорта, поэтому эта формула не превращена
в вымышленный численный сертификат. Нельзя заменить её обычным разбросом
отсчётов мощности: малый шум не исключает большой скрытый тренд.

## 3. Граница выводов об энергии

Для адаптивного опыта A и постоянного контрольного опыта 0:

    S_loss = E_in,0 - E_in,A
             - (A_shaft,0-A_shaft,A)
             - (Delta W_0-Delta W_A).

В цифровом испытании все слагаемые доступны независимому оценщику. Регулятор
их не получает. На стенде равные задания скорости не гарантируют одинаковой
работы вала, а возвращение задания возбуждения не гарантирует одинакового
магнитного запаса. Поэтому нельзя объявить наблюдаемое снижение входных
джоулей снижением потерь без контроля остальных слагаемых.

Цена завершённого цикла ABA может быть измерена относительно принятой модели
опоры. Цена следующего цикла остаётся прогнозом: скрытый поток, нагрузка и
температура меняют динамику. Даже если прошлый максимум не превышен в двух
измерениях, это не доказывает верхнюю границу на третьем.

## 4. Проверяемая научная гипотеза вместо обещания

Узкая постановка: при явно ограниченном семействе изменений режима можно ли
получать из причинной истории совместную область неопределённости выигрыша,
стоимости и времени возврата, достаточную для полезного выбора следующей
пробы? Требуются не только границы, но и проверка их информативности: метод,
который всегда отказывает, не демонстрирует полезной адаптации.

Текущий прототип проверяет дешёвую эвристическую реализацию этой идеи.
Он не оценивает множество физических состояний и не доказывает достижимость
возврата по каждому состоянию. Семейство квадратичных откликов, взаимная
информация и перенос эмпирической цены сами по себе известные приёмы.
Научный результат потребует более сильной конструкции и проверки против
аналогов, перечисленных в `AIR56B2_ACTIVE_PROBE_PRIOR_ART_RU.md`.
