11lisov11/mic_practice/research/AIR56B2_ACTIVE_PROBE_PRIOR_ART_RU.md

# AIR56B2: ближайшие работы по активному выбору парных проб

Дата проверки первоисточников: 09.09.2026. Целевой, не исчерпывающий поиск; утверждений о научном приоритете нет.

## 1. Предмет сравнения

Прочитаны `AIR56B2_NOVELTY_AUDIT_20260909_RU.md` и `AIR56B2_RESEARCH_DECISIONS_20260909_RU.md`. Здесь рассматривается следующий вопрос, а не повторный аудит бюджетного фильтра: **выбор по данным амплитуды, порядка, длительности и повторов пары воздействий на возбуждение, с измерением цены полного цикла проба/возврат и решением продолжить/принять/отказаться при неопределённости**. Селектору не предоставляются параметры истинной модели двигателя, скрытый поток или будущая нагрузка.

«Без модели двигателя» не означает «без предположений»: нужны явно заданные условия измерения, допустимого изменения нагрузки и исполнения возврата. Это также не утверждение, что внутренний FOC не использует параметры. Изменение задания `id` в коротком окне нельзя отождествлять с известным изменением физического потока.

## 2. Шесть ближайших работ

**Т**: прочитан доступный первичный текст в указанных разделах, не выполнена независимая проверка доказательств. **А**: проверена первичная аннотация и доступные издательские фрагменты; отсутствие признака в полном тексте не устанавливалось. Последняя колонка содержит наше сопоставление постановок, не заявление об отсутствии аналогов вообще.

| Работа и прямой первоисточник | Существенное пересечение | Ограничение переноса на парные пробы AIR56B2 |
|---|---|---|
| **[1] Borisevich, 2015.** [Numerical Method for Power Losses Minimization of Vector-Controlled Induction Motor](https://ijpeds.iaescore.com/index.php/IJPEDS/article/view/5148). IJPEDS 6(3), 486-497; DOI `10.11591/ijpeds.v6.i3.pp486-497`. **А**. | Поиск минимума омических потерь по потокосоздающему току IM; предварительная компенсация динамики и адаптация управляющего воздействия для ускорения сходимости. Заявлены симуляция и стендовая проверка. Это близкий предметный предшественник поиска тока возбуждения с учётом переходного поведения. | Аннотация не подтверждает ни полностью безмодельную реализацию, ни обучение цене возврата, ни вероятностный stop. Нельзя объявить отличием просто поиск по току, адаптивный шаг или обработку перехода. [PDF издателя](https://ijpeds.iaescore.com/index.php/IJPEDS/article/download/5148/4412) при прямом открытии выдал защитную страницу; детальные формулы здесь не атрибутируются. |
| **[2] Carnevale, Mimmo, Notarstefano, 2024; v3 от 12.06.2025.** [Data-Driven LQR with Finite-Time Experiments via Extremum-Seeking Policy Iteration](https://arxiv.org/pdf/2412.02758v3). **Т**, §III-B, (9)-(10), Algorithm 1, §VI. | EXP-LQR меняет коэффициенты обратной связи по стоимости конечных экспериментов с dither; матрицы системы и квадратичного критерия неизвестны. Уже присутствует сочетание extremum seeking, обучения из интегрального критерия и ограниченной длительности эксперимента. | Для точной оценки критерия используются эксперименты с начальными состояниями `x0 = e_i`. Цена подготовки этих состояний не входит в определение `J_T`. Пример: линейная модель **асинхронной машины двойного питания**, постоянная скорость и квадратичный LQR-критерий, не клеммные джоули короткозамкнутого IM. В Algorithm 1 нет статистического правила остановки. Это не готовый метод последовательных проб без сброса состояния. |
| **[3] Swanson, Schlamminger, 2010.** [Removal of zero-point drift from AB data and the statistical cost](https://arxiv.org/pdf/1009.1894). Measurement Science and Technology 21, 115104; DOI `10.1088/0957-0233/21/11/115104`. **Т**, §1, начало §2. | ABA/ABBA устраняют линейную аддитивную составляющую дрейфа; предложена обработка ABAB для полиномиального дрейфа с анализом дисперсии. Обсуждаются неодинаковое влияние переключения на повторные B и потеря пригодности неполной последовательности. | Исходная модель: равномерные времена, постоянный полезный контраст, некоррелированный стационарный шум. «Statistical cost» означает рост неопределённости, **не энергию восстановления**. Смена нагрузки, меняющая сам контраст, и скрытая динамика возбуждения не становятся аддитивным дрейфом автоматически. Сама схема baseline/probe/baseline и компенсация тренда уже известны. |
| **[4] Li, Chen, Yang, Yan, 2023/2024.** [Dual Control of Exploration and Exploitation for Auto-Optimisation Control with Active Learning](https://arxiv.org/pdf/2301.11984). IEEE TASE; DOI `10.1109/TASE.2024.3375373`, прочитана v3. **Т**, §II-III, (1)-(3), (11)-(14), Assumptions 1-2. | DCEE выбирает управление с учётом приближения к оцениваемому оптимуму и уменьшения неопределённости; ансамбль оценивателей обновляется онлайн. Это прямое пересечение с выбором полезного следующего измерения, а не фиксированного dither. | Используются заданная параметризация критерия `J = phi(y)^T theta`, линейная динамика `A,B,C` в прогнозе и доступ к состоянию. Для анализа нужны возбуждение и условия шума. Пример MPPT не является IM. Дисперсия ансамбля не равна автоматически доверительному интервалу экономии; в рассмотренной постановке нет измеряемого полного цикла возврата возбуждения. |
| **[5] Liu, Wang, Wei, 2023.** [Bayesian Optimization with Switching Cost: Regret Analysis and Lookahead Variants](https://www.ijcai.org/proceedings/2023/0446.pdf). IJCAI, 4011-4018; DOI `10.24963/ijcai.2023/446`. **Т**, §2.1, §3, (9)-(16), Algorithm 1. | GP-оценка неизвестной функции, неопределённость, выбор следующего эксперимента с зависящей от пути ценой, многошаговый прогноз и прекращение поиска при недостаточном бюджете. Наиболее близкий здесь общий аналог **выбора эксперимента с учётом затрат**. | Цена задана евклидовым расстоянием между точками, а не обучается из измерений физического возврата. Функция цели статична, шум гауссовский с общей дисперсией. Бюджетная остановка не является проверкой достоверности положительной экономии. Замена расстояния эмпирическими джоулями сама по себе не создаёт нового принципа; стоимость со скрытой памятью требует иной модели данных. |
| **[6] Stumper, Dotlinger, Kennel, 2013.** [Loss Minimization of Induction Machines in Dynamic Operation, авторский полный текст](https://www.researchgate.net/publication/260540718_Loss_Minimization_of_Induction_Machines_in_Dynamic_Operation). IEEE TEC 28(3), 726-735; DOI `10.1109/TEC.2013.2262048`. **Т**, §II-IV. [Метаданные TUM](https://portal.fis.tum.de/en/publications/loss-minimization-of-induction-machines-in-dynamic-operation/). | Оптимизация потока учитывает переходные омические и железные потери при заданном отклике момента; экспоненциальная аппроксимация траектории пересчитывается онлайн. Эксперимент сравнивает режимы с одинаковым требуемым откликом. Учёт переходных энергетических затрат уже является предметом исследований IM. | Оптимизация опирается на модель машины; она не выбирает статистически информативные пары по измеренной цене возврата. Нельзя приписывать статье необходимость знать всю будущую нагрузку: авторы специально переходят от прежних офлайн-траекторий к причинному онлайн-расчёту. Различие следует искать в информации и идентификации стоимости, не просто в словах «динамический» или «без будущей нагрузки». |

## 3. Известные компоненты и непроверенный вопрос

**Известные компоненты:** поисковая адаптация возбуждения [1], конечные эксперименты для extremum seeking без известных матриц [2], компенсация дрейфа парными сравнениями [3], выбор действия по неопределённости [4], планирование с ценой переключения [5], энергетическая оптимизация переходов IM [6]. Их соединение в один супервизор следует пока трактовать как комбинацию известных методов. Нейросеть вместо регрессии, AIR56B2 вместо другой машины или новое название этого не меняют.

**Не установленный здесь результат:** получение из причинной истории достаточно точной и проверяемой оценки *совместной неопределённости* контраста, длительности восстановления и полной цены следующей пары, позволяющей улучшить решение при том же риске ошибки и том же бюджете. Полный цикл в измерениях не эквивалентен прогнозу цены ещё не выполненного цикла. В проверенных разделах не установлено решение всей этой задачи; это ограниченный вывод данного сравнения, не доказательство отсутствия решения в литературе.

Если длительность и амплитуда всегда фиксированы, а данные используются лишь для допуска или отбраковки, это не демонстрирует активного выбора параметров пары. Даже выбор из сетки по эвристике «дисперсия/цена» не доказывает оптимального уменьшения ошибки решения.

## 4. Сильнейшие научные риски

1. **Неидентифицируемость эффекта нагрузки и возбуждения.** Симметричные `id0 +/- delta` не образуют ABBA автоматически. Для схемы A-B-A интерполированная опора в момент `tB` имеет веса `(1-alpha), alpha`, где `alpha = (tB-tA1)/(tA2-tA1)`; для средних окон нужны их временные центры. Это убирает линейный общий тренд, но не скачок нагрузки, нелинейный тренд или взаимодействие нагрузки с пробой. Возврат мощности к прежнему значению не исключает скрытого изменения потока. Это наше следствие ограничений модели сравнения [3], не дополнительная гарантия.

2. **Подмена экономии разрядом запасённой энергии.** Измерять следует весь переход, выдержку и физическое восстановление. По балансу `E_terminal = E_loss + E_shaft + Delta W_magnetic + Delta W_kinetic`. Даже полный возврат задания не доказывает равенства конечных запасов; одинаковая скорость не доказывает одинаковой работы вала. Отсутствие датчика момента требует явно ограничивать неопределённость полезной работы, а не называть снижение клеммной энергии снижением потерь. Отдельно показывать знаковую разность энергий и положительный перерасход; не считать магнитную энергию повторно поверх полного интеграла.

3. **Измеренная цена не является верхней границей следующей цены.** Прошлый максимум времени/энергии возврата не даёт гарантии при иной нагрузке, температуре и скрытом потоке. Незавершённые и аварийно прерванные циклы нельзя исключать из статистики как будто дорогих наблюдений не было. Известная цена перехода в [5] и задаваемое начало эксперимента в [2] скрывают трудности, которые здесь остаются физическими.

4. **Ложная уверенность при адаптивном stop.** Выбор лучшей пары и повторная проверка на тех же данных создают селекционное смещение; обычный интервал для заранее фиксированного окна не обеспечивает заявленную ошибку при многократном просмотре. Общие baseline-окна создают ковариацию контрастов; частота отсчётов не равна числу независимых наблюдений. Нужны условия шума и контроль ошибки для всей последовательности, включая отказы; эмпирический разброс нельзя без проверки называть доверительной гарантией. Это методологическое требование к прототипу, не свойство, заимствованное из теорем [2-5].

5. **Неизвестное будущее исключает безусловную окупаемость.** Из положительного локального контраста не следует экономия на неизвестном остатке режима. При обоснованных `g_L > 0` и `C_U` можно сообщить условный срок `H_pay = C_U/g_L`, но нельзя выдавать его за гарантированную длительность полезной работы. Stop должен различать нехватку бюджета, недостаток информации и отсутствие обнаруженного выигрыша. Неопределённость означает «не установлено», а не «кандидат бесполезен».

## 5. Что различит механизм в исследовании

Минимальное сравнение на ПК: фиксированные парные пробы; поисковый регулятор с теми же ограничителями; активный селектор с постоянной ценой; тот же селектор с обучаемой ценой полного цикла. Всем дать одинаковые измерения, физическое непрерывное состояние, общий бюджет и время; параметры истинной модели, будущую нагрузку и контрфактический baseline оставить только независимому оценщику.

Отдельно отключать адаптацию амплитуды/длительности, учёт стоимости и коррекцию дрейфа. Варьировать порядок low/high; учитывать все опорные окна, повторы, отказы и восстановления без двойного начисления общих интервалов. Измерять итоговую энергию при сопоставимой работе и конечном состоянии, долю неверных принятий, покрытие интервалов, время решения и долю отказов. Выигрыш только от запрета почти всех проб не доказывает более полезного обучения. Модельный метод [6] допустим как отдельно обозначенный информированный ориентир, не как безмодельный конкурент.

## 6. Поиск и ограничения

Основные выполненные запросы: `induction motor loss minimization extremum seeking control flux current input power model free`; `paired measurements drift cancellation ABBA optimization extremum seeking`; `optimal experiment design online optimization transient cost Bayesian optimization experiments switching costs`; `Removal of zero-point drift from AB data`; `Loss Minimization of Induction Machines in Dynamic Operation pdf`. Затем открыты первичные ссылки таблицы; проверены определения затрат, исходных состояний и условий измерения.

Для [1] доступ ограничен; [2-6] прочитаны в обозначенных разделах. У [6] DOI подтверждён первой страницей авторского текста и карточкой TUM; разночтение старого каталога, отмеченное предыдущим аудитом, не принято за другой результат. Поиск не является полным обходом цитирований, патентов и платных баз. Теоремы первоисточников на будущий код не переносятся автоматически.

Эта записка фиксирует литературную часть, не испытание прототипа. Последующее программное ревью и исправления описаны отдельно в `AIR56B2_ACTIVE_PROBE_REVIEW_RU.md`. Проверка литературы не является аппаратной валидацией.
