11lisov11/mic_practice/research/AIR56B2_ACTIVE_PROBE_PROTOCOL_RU.md

# Протокол: парные пробы, измеряемая стоимость и выбор следующего измерения

## Статус и вопрос

Протокол записан до нового пилота. Предыдущий фиксированный бюджет не дал
преимущества. Здесь проверяется другая, ещё не признанная новой гипотеза:
поможет ли выбор проб по информации о полезном решении с учётом эмпирически
оценённой цены полного цикла, включая возврат? Нейросеть не обучается.
Это предварительное исследование метода экспериментального выбора, не решение
всех проблем асинхронного электропривода и не готовая прошивка.

## Только доступная информация

Регулятор получает время, оценку мощности на зажимах, ток, напряжение,
измеренную энкодером скорость и её задание. Параметры горячего объекта, истинный
поток, момент нагрузки, будущий скачок нагрузки и парный контрольный прогон
ему недоступны. Холодная модель внутри базового FOC остаётся: весь привод
не является model-free. Супервизор не использует электрические параметры.

## Измерительная процедура

1. Установившееся окно в исходном режиме A.
2. Плавная смена задания возбуждения на B и измерительное окно.
3. Возврат на A и новое окно при допустимой ошибке скорости и разбросе мощности.
4. Линейная интерполяция между временными центрами двух окон A даёт оценку
   контрфактической мощности в окне B. Разность с B оценивает выигрыш.
5. На каждом интервале полного цикла интегрируются знаковая разность и её
   положительная часть относительно той же интерполяции. Возврат учитывается
   также отдельно. Короткая экстраполяция до конца последнего окна записывается.

При строго аффинной зависимости исходной мощности от времени интерполяция
устраняет её дрейф точно (для одинакового временного усреднения). При нелинейном
дрейфе и изменении нагрузки это не гарантия. Можно добавить к исходной мощности
функцию, нулевую в обоих опорных окнах и ненулевую между ними: показания A
останутся прежними, а ошибка оценки в B изменится. Поэтому ширина интервала
«1 Вт + разброс окна + дрейф его концов» является эвристической, не доверительной
и не детерминированной границей. Это проверяется отдельно на парном объекте.

Возврат подтверждается мощностью и скоростью, но не измерением потокосцепления.
Окончательная оценка результата обязана вычитать изменение запасённой энергии.
Затраты незавершённых циклов не пропадают: они входят в полную энергию прогона,
хотя для них нельзя построить завершённую A-B-A оценку стоимости.

## Выбор пробы и остановка

Используются четыре задания между 0,65 и 1,00 А, исходное 0,83 А.
Семейство гипотез локального выигрыша: g(x)=a*x-b*x², где x нормировано
на максимальное отклонение задания; a=-24,-22,...,24 Вт, b=0,2,...,16 Вт.
Это 225 рабочих гипотез кривой отклика, не параметры двигателя из паспорта.
Гипотезы исключаются по завершённым парным измерениям. Пустое множество
означает отказ метода, а не подгонку нового семейства под результат.

Следующая проба максимизирует взаимную информацию квантованного исхода о
лучшем решении (включая сохранение A), делённую на прогноз стоимости.
Равные веса гипотез и квантование 2 Вт являются эвристикой, а не апостериорной
вероятностью. Прогноз после первой пробы использует максимальную измеренную
положительную цену цикла, запас 1,5, добавку 0,1 Дж и квадратичное масштабирование
при увеличении амплитуды. До измерений действует приор 10 Вт на время цикла.
Это прогноз, не доказанная верхняя граница; проверяем ошибки на новых циклах.

Не более двух проб. При согласии гипотез в пределах 2 Вт можно закончить раньше.
При исчерпании проб допустим лучший измеренный кандидат без доказательства
глобальной оптимальности. Для принятия требуются повторное окно B, запас
выигрыша не менее 2 Вт и положительная прогнозная окупаемость после учёта уже
потраченной энергии и ещё одного полного цикла. При смене задания, отклонении
скорости/мощности, пропуске отсчётов или электрическом нарушении выполняется
возврат. Прогноз при раннем возврате аннулируется. Аппаратные защиты не заменяются.

## Сравнение и воспроизводимость

Семь методов: постоянное возбуждение; прежний поиск с плановым возвратом без
ограничений; прежний фиксированный бюджет; полный факторный эксперимент 2x2:
фиксированный/информационный порядок и фиксированная/измеренная цена.
В парных методах остальная измерительная процедура и пороги одинаковые.

Новый seed 92062, два исходных F1 двигателя, по два варианта насыщения, скорости
0,3 и 0,7 номинальной, горизонт 3 и 6 с, без скачка и со скачком нагрузки
в 2,6 с. Варианты одного двигателя не независимые реплики. Это не подтверждающая
статистика: пилот только на двух ранее не использованных здесь исходных моделях.
Все методы в сценарии получают одинаковый шум seed 730. Все начальные
переходные процессы и пробы входят в полную энергию; бесплатных сбросов нет.

Основная метрика: снижение суммарных потерь относительно постоянного режима.
Также сохраняются входная энергия, работа вала, запасённая энергия, ток,
ошибка скорости, незавершённые пробы, отказы, ошибки цены и дрейфа.
Пригодная пара: оба прогона PASS, завершённая процедура, работа вала отличается
не более чем на 1% (масштаб не ниже 1 Дж). Основное сравнение на общей пригодной
выборке всех методов. Все непригодные случаи показываются отдельно.

Шаг регулятора 100 мкс; объекта 50 мкс. Отдельная заранее выбранная проверка:
первый двигатель без насыщения, скорость 0,7, без скачка, 6 с; шаг объекта
50/25/12,5 мкс при том же регуляторе, все семь методов. Критерий уточнения:
одинаковые исходы, разброс экономии потерь <0,05 Дж и пикового тока <0,05 А.
Наблюдатель, инвертор и ограничения те же, что в предыдущем исследовании.

Программные тесты и диагностический smoke могут выявить ошибки реализации.
Изменения параметров после просмотра пилота должны быть новой ревизией, а не
скрытой заменой результата. Источники и входы замораживаются SHA-256 на запуск.
Положительные результаты этого малого опыта не устанавливают научную новизну.

## Ревизия 2 после программного ревью

Пилот ревизии 1 остановлен до публикации: 87/224 завершённых заданий в консоли,
уточнение 12/21. Эти неполные серии не являются результатом. Диагностический
smoke сохранён отдельно. По ним не перенастраивались численные параметры селектора.

Исправлены контроль смены задания на всех измерительных стадиях, приоритет
некорректных/опасных наблюдений над плановым возвратом, применение лимита цены
также к финальной проверке. Добавлен журнал прерванных и финальных эпизодов,
включая возврат. При пропусках измерений он не восполняет неизвестную энергию
догадкой; общий интеграл объекта остаётся независимой оценкой полных затрат.

Добавлен одинаковый для всех методов участок восстановления 1 с после горизонта
3/6 с. Теперь полный опыт длится 4/7 с, вся энергия включена. Для пригодности
конечное задание должно вернуться к исходному, отличие скорости <=0,1 рад/с,
запасённой энергии <=0,01 Дж и каждого двухкомпонентного потокового состояния
<=0,001 Вб после выравнивания общего электрического угла по потоку ротора.
Это фазово-инвариантное сравнение симметричной модели, не датчик в регуляторе.
Контрольная поправка по запасённой энергии сохраняется и после этого фильтра.

Средние публикуются и на общей пригодной выборке, и описательно на всей сетке.
Первое всё равно условно по результатам отбора и не является несмещённой
оценкой эффективности на случайном двигателе. Непригодные исходы не скрываются.
