11lisov11/mic_practice/research/AIR56B2_ACTIVE_PROBE_REVIEW_RU.md

# Программное ревью активных проб

## Замечания и исправления ревизии 2

1. Изменение задания скорости внутри измерительной процедуры смешивало режимы.
   Теперь оно вызывает отказ также в baseline/query/return/candidateverify.
2. Возврат задания и расчёт изменения запасённой энергии не оплачивали возможный
   оставшийся переход. Добавлена общая 1 с восстановления с учётом энергии;
   пригодность требует совпадения конечных состояний с явными допусками.
3. Финальная проверка могла обойти лимит прогнозируемой стоимости.
   Этот лимит теперь применяется до выбора лучшего допустимого кандидата.
4. Прерванные и финальные эпизоды не имели журнала стоимости возврата.
   Журнал дополнен; незакрытый эпизод экспортирует известную входную энергию,
   длительность измерений, пропуски и прогноз. Полная цена остаётся неизвестной.
5. Плановый возврат мог скрыть NaN или превышение тока на той же отметке времени.
   Некорректные и опасные наблюдения теперь имеют приоритет; прогноз аннулируется.
6. Среднее по всей сетке могло превратить ранний аварийный выход в экономию.
   Сопоставимая экономия для неполного временного горизонта теперь null;
   авария сохраняется в исходах, но разность разно-длительных опытов не усредняется.
7. Дорогой лучший кандидат мог блокировать второго, допустимого по бюджету.
   Допустимость проверяется до ранжирования финальных кандидатов.
8. Незакрытый эпизод терял при экспорте пропуски и известную часть энергии.
   Эти сведения теперь сохраняются отдельно от неизвестной полной цены.

Все перечисленные случаи покрыты регрессионными тестами. Научные предпосылки
эта проверка не доказывает: аффинная опора, форма отклика, перенос стоимости
и сохранение будущего режима остаются рабочими гипотезами.

## Проверки перед повторным пилотом

- 112 целевых тестов нового метода, сравнения и независимого оценщика.
- 922 теста основного исследовательского набора.
- 34 теста FOC/PPO.
- Проверка манифеста исследовательского среза: PASS, 284 файла.
- Источники моделей и алгоритмов зафиксированы SHA-256 на начало каждого опыта.

Первый полный пилот и уточнение остановлены после замечаний ревью, не опубликованы
как законченные результаты. Диагностический smoke ревизии 1 сохранён с исходным
манифестом. Повторная серия имеет отдельные каталоги с суффиксом `_rev2`.

Аппаратные платы, прошивки, Wi-Fi/UART и силовая часть в этом этапе не менялись.
