11lisov11/mic_practice/research/AIR56B2_BUDGET_PROTOCOL_RU.md

# Протокол проверки энергетического бюджета проб

Дата фиксации: 2026-09-09, до вычислительной серии.

## Статус

Это механизм для проверки гипотезы, не заявка на установленную научную новизну.
FOC, аналитический подбор потока, conservative exploration и энергетическая
оптимизация переходных процессов уже известны. Само объединение этих слов не
является научным результатом. Отдельная таблица ближайших аналогов фиксирует
пересечения. Нейросеть и активный выбор следующей пробы пока не реализуются.

## Вопрос и опровержение

Может ли надзорный алгоритм, учитывающий неопределённость мощности, конечный
горизонт и физическое время возврата, уменьшить неудачные затраты на настройку
без потери большей части доступной экономии? Нулевая гипотеза: добавленные
ограничения не дают преимущества перед той же последовательностью проб.
Отказ от всех проб не считается успешной оптимизацией.

Прямые опровержения: нарушение бюджета при выполненных предпосылках; неверный
знак предсказанной чистой экономии при выполненных предпосылках; преимущество
только после удаления неудачных опытов; выигрыш, объясняемый недоотпуском работы
либо незавершённым переходом запасённой энергии.

## Условная граница

Пусть измеренная исходная мощность равна b, ошибка каждого измерения/среднего
не больше eps, а неизвестная контрфактическая мощность исходного регулятора
отличается от исходного уровня не быстрее rho_b Вт/с. Тогда на шаге k:

    q_k = max(0, P_meas,k - b + 2 eps + rho_b (t_k - t_anchor))
    B_k = sum(q_k * dt_k)

B_k ограничивает сверху сумму положительных превышений ЭНЕРГИИ ПО ИНТЕРВАЛАМ
при этих предпосылках и при корректной интерпретации отсчёта как средней
мощности предыдущего интервала. Это дискретная метрика: интеграл положительной
части непрерывной мощности может быть больше, если знак меняется внутри шага.
Без межотсчётной огибающей гарантии для такого непрерывного интеграла нет.
Это также не измеренная энергия потерь: мощность включает полезную работу и
изменение запасённой энергии.

Для возврата резервируется C_ret = q_max (|id-id0|/slew + T_settle).
Перед следующим шагом резерв включает также энергию шага и возможное увеличение
расстояния возврата на один шаг. При q <= q_max и соблюдении времени восстановления
индукция по шагам даёт B + C_ret <= B_max. Если предпосылки не выполнены,
гарантия не действует. Программное прибытие задания к id0 не равно физическому
установлению потока; T_settle здесь явный, пока не подтверждённый приор.

Для трактовки валидационной пробы как нижней границы выигрыша g0 ошибка eps
должна покрывать не только датчик, но и разницу среднего окна с мощностью на
его конце. Малая дисперсия и существующие пороги установления сами по себе этого
не гарантируют. Проверка runner по мгновенной ошибке реконструкции недостаточна
для полной проверки этой предпосылки. При допущении
g(t) >= g0 - rho_g t на будущем интервале H:

    G_lower = g0 H - rho_g H^2 / 2 - B_probe - C_ret.

Неравенство получается интегрированием, это не новый общий математический
результат. Отрицательную будущую экономию нельзя обрезать до нуля. Кандидат
принимается только при G_lower > margin. Неизвестная будущая нагрузка не
передаётся регулятору: он знает лишь объявленный срок окончания задания.
Сохранение режима до этого срока НЕ гарантировано. Поэтому вычисленная граница
условна, а не статистический доверительный интервал и не сертификат безопасности.

## Сравнения и фиксированные настройки

- `fixed`: исходный поток, без проб.
- `fit`: существующий аналитический подбор с проверкой мощности, без новой логики.
- `ungated`: та же проба с запланированным возвратом, без обоих новых ограничений.
- `budget_only`: только накопленный бюджет и резерв возврата.
- `payback_only`: только условная окупаемость.
- `budget_payback`: оба ограничения.

Все адаптивные методы получают одинаковые измерения и имеют тот же период FOC.
Новые варианты возвращаются к исходному заданию до конца объявленного горизонта;
поэтому `ungated` обязателен для отделения эффекта возврата от эффекта ограничений.
Параметры до результатов: Bmax=8 Дж, eps=1 Вт, rho_b=rho_g=0.5 Вт/с,
qmax=10 Вт, Tsettle=0.27 с, margin=0.1 Дж. Это приоры, не паспортные величины.
При их опровержении серия сохраняется, а граница отмечается неподтверждённой.

Матрица: два исходных F1-образца, два значения насыщения, скорости 30/70 %,
нагрузка 25 % с/без ступени до 50 % на 2.6 с, горизонты 3 и 6 с.
Период контроллера 100 мкс, шаг объекта 50 мкс. Одна реализация шума 730,
общая внутри сравнения. Всего 192 прогона. Это пилот, не оценка популяционной
статистики. Варианты одного двигателя не считаются независимыми двигателями.

## Измерения результата

Сохраняются все исходы, включая отказы, нарушения предпосылок и незавершённые
пробы. Для сравнимой энергии нужны завершение, ток <=3.1 А, MAE скорости <3 рад/с
после 1.2 с и отличие полезной работы <=1 %. Отдельно показываются доля пригодных
сравнений и данные непригодных: нельзя улучшать среднее отбрасыванием провалов.
Отчитываются входная энергия, потери, работа вала и запасённая энергия, число
принятий/отказов, затраты проб и объяснения отказов. Теоретическая граница не
сравнивается напрямую с энергией потерь: у них разные границы учёта.

Модель усреднённая, на клеммах двигателя, с энкодером. Потери инвертора, ШИМ,
реальное время MCU, аппаратная защита и бездатчиковость не проверяются.
Гауссовский измерительный шум не имеет конечной абсолютной границы; eps=1 Вт
не даёт безусловной гарантии даже при отсутствии обнаруженных нарушений.

## Поправки по независимому ревью реализации

Первый пилот `probe_budget_pilot_20260909` сохраняется как диагностическая
ревизия до исправлений. Ревью дало воспроизводимые контрпримеры; численные
параметры бюджета после просмотра исходов не подбираются. Исправленная серия
должна сохраняться отдельно с новым манифестом.

1. Для g0 учитывается средний возраст проверочного окна плюс один период
   измерения: поправка rho_g * (mean(t_now-t_sample) + dt). Предпосылка rho_g
   распространяется на окно и будущее, а не только на будущее после окна.
2. При раннем возврате прежняя проекция окупаемости помечается отменённой;
   число остаётся исторической записью, а не гарантией полученного результата.
3. Пропуск измерения при удержании отменяет предпосылки и запускает возврат.
4. Возврат завершён не раньше действительного прибытия задания и выдержки
   Tsettle. Эта выдержка всё равно не доказывает установление физического потока.
5. Отказ до первого изменения задания не расходует бюджет эксперимента.

Область Bmax - пробы и возврат. Во время принятого удержания этот счётчик
заморожен. Следовательно, Bmax не является верхним пределом положительного
перерасхода за весь цикл, особенно если допустимая огибающая g0-rho_g*t
становится отрицательной. Суммарная знаковая окупаемость проверяется отдельно.
