11lisov11/mic_practice/research/AIR56B2_ENERGY_VALUE_ADDITIONAL_REFINEMENT_RU.md

# Дополнительная проверка принятого режима

10.09.2026, во время выполнения основной замороженной серии rev4.

Обязательное заранее назначенное уточнение первого held-out двигателя сохраняется.
Оно может не включать принятие нового задания, поэтому дополнительно проверяется
первая по лексикографическому порядку `(case, speed_fraction)` пригодная траектория
EV с `ever_committed=true`, без скачка нагрузки, на горизонте 12 с.
Знак/величина экономии не участвуют в выборе. Если таких траекторий нет, опыт
не подменяется удачным случаем: записывается, что принятого режима не найдено.

Все восемь методов повторяются на выбранном сценарии с подшагами 2/4/8.
Исходники контроллера, объекта, пороги и настройки остаются строго теми же,
что в основном опыте. Допуски прежние: полный горизонт, работа вала 1%,
конечные состояния 0,001 Вб / 0,1 рад/с / 0,01 Дж, разброс экономии <0,05 Дж,
разброс пика тока <0,05 А, одинаковый исход на трёх шагах.

Это дополнительная проверка численной устойчивости ветви принятия, условно
выбранной по исходу. Она не заменяет первичную выборку, не является ещё одним
независимым двигателем и не используется для оценки среднего эффекта в популяции.
Малый разброс не объявляется доказательством физической достоверности модели.
