11lisov11/mic_practice/research/AIR56B2_ENERGY_VALUE_LIGHT_LOAD_PROTOCOL_RU.md

# Дополнительная гипотеза: малая нагрузка

Дата: 10.09.2026. Протокол записан до запуска новой серии. Это расширение области
исследования после просмотра промежуточных исходов основной проверки, а не часть
первоначальной независимой выборки. На момент решения основная серия ещё шла;
в первых 560 строках не было принятых кандидатов. Этот факт не скрывается, новая
серия не заменяет исходную и не используется для улучшения её среднего.

## Физический вопрос

При небольшой механической нагрузке проверяем, может ли снижение возбуждения
уменьшить суммарные потери без уменьшения полезной работы. Направление эффекта
не предполагается гарантированным: уменьшение потерь на намагничивание может
сопровождаться увеличением токовых потерь и затрат на переходы. Существующий
FOC и энергетический супервизор rev4 остаются без изменения.

## Проспективная матрица

- Новые seeds 92067 и 92068, по два исходных F1-двигателя; оба насыщения 0/0,4.
- Постоянная нагрузка 10% номинального момента, скорости 0,3 и 0,7.
- Горизонт 12 с плюс общая 1 с восстановления. Все восемь прежних методов.
- Шаг регулятора 100 мкс, объекта 50 мкс, тот же шум seed 730.
- Холодный контроллер прежний: первый F1 из seed 92062, не параметры нового объекта.
- Всего 128 прогонов. Никаких подборов seeds, порогов или порядка по результатам.
- Численное уточнение: заранее первый случай s92067_motor0_k0, скорость 0,7,
  тот же режим, шаг объекта 50/25/12,5 мкс, все методы; 24 прогона.

Допуски и правила парного сравнения совпадают с исходным протоколом.
Для вывода о полезной адаптации нужны действительное принятие нового задания,
положительное среднее относительно fixed, сопоставимая работа и конечные состояния.
Положительный эффект, если найден, относится только к новой условной области
10% нагрузки; не доказывает универсальное преимущество, нейроуправление или новизну.
Четыре F1 являются четырьмя исходными моделями, не 16 независимыми двигателями.

Показываются все исходы, все исходные модели и прямые сравнения с сильными
конкурентами. Уточнение одного заранее выбранного случая не доказывает сходимость
всей матрицы. Положительный development-результат не переносится в эту серию.

## Воспроизведение

```powershell
.\.venv-research-gpu\Scripts\python.exe tools/run_air56b2_light_load.py --stage light_load --out artifacts/energy_value_light_load_reproduction --workers 14
.\.venv-research-gpu\Scripts\python.exe tools/run_air56b2_light_load.py --stage light_load_refinement --out artifacts/energy_value_light_load_refinement_reproduction --workers 14
```
