11lisov11/mic_practice/research/AIR56B2_ENERGY_VALUE_PROTOCOL_RU.md

# Протокол проверки энергетической ценности следующей пробы

Записан до новой серии. Цель: получить воспроизводимый положительный эффект,
не менять выводы за счёт отбора удачных случаев, ослабления защиты или скрытой
информации о двигателе. Нейросеть не обучается, новизна не считается установленной.

## Изменённый механизм

Процедура измерения, допуска, повторной проверки и возврата наследуется от
активных парных проб без изменения порогов. Вместо энтропии определяется
ожидаемая будущая энергия после следующей пробы: время двух переходов и окон
вычитается из горизонта, цена пробы оплачивается независимо от её исхода,
последующая проверка и возврат также имеют цену. Допустимы только измеренные
кандидаты. Сохранение исходного режима имеет нулевую будущую ценность; ранее
потраченная энергия сохраняется в условии полной окупаемости.

Неизвестная цена планируется по трём рабочим долям 0,25/0,5/1 от текущего
консервативного прогноза допуска, с одинаковыми весами. Для исходной проверки
допуска используется полный прогноз, не его четверть. Все 225 гипотез отклика
также имеют равные веса. Это явные приоры планирования, не калиброванные
вероятности и не доказанные границы. После измерений цена и допустимые отклики
обновляются той же существующей процедурой. Параметры паспортом не объявляются.

Сравниваются восемь вариантов: постоянное возбуждение; прежний поиск;
прежний поиск с таким же контролем смены режима при удержании; прежний
информационный селектор; простой алгоритм «первая подтверждённая выгодная
проба low/high»; тот же first-good с порядком high/low; first-good с полным меню
четырёх заданий (не более двух исполненных проб); новый энергетический выбор. Это предотвращает объявление
простого раннего принятия или дополнительной защиты научным преимуществом.

## Разделение данных

- Разработка: только уже использованный seed 92062, два исходных двигателя,
  насыщение 0/0,4, скорости 0,3/0,7, 6/12 с, постоянная нагрузка 25%.
- Основная проверка: ранее не использованные seed 92063/92064, по два исходных
  двигателя, насыщение 0/0,4, скорости 0,3/0,7, горизонты 3/6/12 с, без скачка
  и со скачком 25% -> 50% в 2,6 с. Всего 768 прогонов.
- Дополнительная проверка: новые seed 92065/92066, по два двигателя, оба
  насыщения и скорости; 6 с, поздний скачок 25% -> 50% в 4,2 с и постоянная
  нагрузка 50%. Всего 256 прогонов. Анализируется отдельно, не смешивается
  с основной выборкой для улучшения среднего.
- Уточнение: первый двигатель seed 92063, без насыщения, скорость 0,7,
  постоянная нагрузка 25%, 6/12 с; шаг объекта 50/25/12,5 мкс, все методы (48 прогонов).

## Журнал до раскрытия независимых данных

Ревизия 1: 48 development-прогонов, архив сохранён без перезаписи. На горизонте
6 с энергетический селектор оставил исходное задание во всех восьми сценариях.
Ревизия 2, до held-out: добавлен 12-секундный горизонт, чтобы проверить окупаемость
при более длительном удержании; короткие горизонты сохранены. Добавлен first-good
обратного порядка по независимому ревью. Ожидание теперь группирует одинаковые
наблюдаемые исходы (интервалы шириной два error floor) вместо отдельного решения
для каждой скрытой гипотезы (ширина интервала равна двум прогнозируемым ширинам
ошибки окна). Приоры, бюджет, электрические и итоговые допуски
не менялись. Это выбор дизайна по development, не независимое открытие эффекта.

Ревизия 3, также до held-out: по регрессионным тестам независимого ревью
исправлен прогноз бюджета второй операции: после гипотетически измеренной цены
пробы применяется полный штатный эмпирический прогноз verification/return,
а не ещё одно умножение на долю цены. Время первой пробы включает накопленный
прогноз возврата. В охраняемом поиске авария имеет приоритет перед плановым
возвратом; потеря отсчётов прекращает удержание. First-good LH/HL ограничены
своими двумя заданиями, дополнительный greedy_menu имеет те же четыре задания,
что EV. Все исходы rev2 development сохранены с архивом исходников.

В суррогате будущая цена завершённой пробы считается наблюдаемой. Свежая проверка
прогнозируется успешной. Эти предположения проверяются фактической симуляцией
и не являются гарантией.

Ревизия 4, 10.09.2026, до первого held-out: закрыт последний пункт ревью R6,
авария во время уже начавшегося возврата теперь также записывается в журнал.
Добавлено сохранение каждого завершённого расчёта и ошибок работников в JSONL.
Численная политика rev3 не менялась: её 128 development-прогонов завершены,
исходники сохранены в архиве. Последнее изменение журнала проверяется отдельными
тестами; новая версия замораживается на основную, стрессовую и уточняющую серии.

Холодный контроллер одинаков во всех сериях: первый двигатель seed 92062.
Истинные параметры новых объектов не передаются ему. Шум seed 730 одинаков
в парных методах. Во всех случаях есть дополнительная общая секунда
восстановления, и её энергия включена. Цифровой объект усреднённый, с энкодером.

## Критерии

Сохраняются допуски предыдущей серии: полное время, отсутствие нарушения
токовых/численных критериев, завершённая процедура, работа вала в пределах 1%,
конечные состояния в пределах 0,001 Вб / 0,1 рад/с / 0,01 Дж после выравнивания
общего электрического угла. Неполное время не даёт оценки экономии.

Положительный результат относительно постоянного возбуждения: положительное
среднее снижение потерь на независимой проверке, реальные принятые кандидаты,
сохранённые ограничения и воспроизведение знака при уточнении шага.
Отдельно показываются все исходы, каждый исходный двигатель и обе скорости.
Преимущество именно нового критерия требует дополнительного выигрыша над
простым greedy и охраняемым прежним поиском на тех же сценариях. Если это
не выполнено, можно сообщить полезную адаптацию, но не преимущество усложнения.

Общая пригодная выборка и все завершённые по времени случаи публикуются
раздельно. Общая выборка условна по исходам и не является несмещённой оценкой
популяции. Варианты насыщения и режимы не считаются независимыми двигателями.
После просмотра основной проверки код не подстраивается под неё: любые
следующие изменения требуют новой серии и нового статуса проверки.
