11lisov11/mic_practice/research/AIR56B2_ENERGY_VALUE_PUBLICATION_REVIEW_RU.md

# AIR56B2: узкое ревью инструментов публикации

Дата: 10.09.2026. Проверены только анализатор, accepted-refinement runner и
PowerShell wrapper. Контроллер, методика, пороги и source freeze не менялись.
**Текущие trials, неполные и завершённые результаты исследования не читались.**
Все контрпримеры синтетические; файлы данных и результаты тестируемых функций
живут в памяти. Объект и реальные jobs не исполнялись. Wrapper проверен статически,
не запускался. Исходные тестовые наборы и полные матрицы не запускались.

## Находки

**[P1] P1. Количество строк не проверяет состав и уникальность матрицы.**
[load, строка 50](C:/mic_practice/tools/analyze_air56b2_energy_value.py:50)
принимает две копии одного полного блока вместо двух различных запланированных
сценариев. При том же числе строк проходят также незапланированные case, скорость,
подшаг или noise seed. Хеши синтетических файлов при этом корректны.
[Accepted runner](C:/mic_practice/tools/run_air56b2_accepted_refinement.py:42)
вообще не проверяет полноту родительской матрицы до select_case: половина набора
запускает 24 mock-job уточнения. Это позволяет отбирать случай до проверки полного
набора. Нужно сравнивать точное множество уникальных job keys с protocol и
проверять согласованность rows/pairs; одинаковая длина недостаточна. Шесть падений.

**[P1] P2. Численное уточнение может сопоставить разные сценарии.**
[refine, строка 117](C:/mic_practice/tools/analyze_air56b2_energy_value.py:117)
группирует только по методу и горизонту. Три записи с substeps 2/4/8, но разными
двигателями, скоростями, нагрузками, моментами скачка либо dt регулятора проходят
как успешное уточнение при одинаковых энергиях. Нужно проверять идентичность
всего scenario key, кроме plant_substeps, и однозначное соответствие rows/pairs.
Это проверка воспроизводимости прежней постановки, не новый допуск. Пять падений.

**[P1] P3. Устаревшие флаги pairs превращают усечённую строку в экономию.**
[direct_comparisons](C:/mic_practice/tools/analyze_air56b2_energy_value.py:69)
берёт full_horizon/eligible из сохранённых pairs без сверки с rows. Если EV-row
имеет FAIL, complete=False и 10 шагов вместо 130000, но pairs остались прежними,
получается eligible=True и преимущество +3 Дж. Нужно отказать при противоречии
или перепроверить длительность/пригодность по исходным строкам. При согласованных
метаданных обычное усечение корректно даёт null. Одно падение.

**[P1] P4. Accepted-refinement не привязан к публикуемой validation-серии.**
[main анализатора](C:/mic_practice/tools/analyze_air56b2_energy_value.py:303)
сравнивает только source manifests. Проходит accepted-refinement с заведомо чужим
`source_study_sha256`, хотя поле записывает сам runner. Совпадающие исходники
не означают одинаковый родительский набор. Нужно проверить этот SHA-256 против
study.json именно выбранной validation-серии до записи analysis/report.
Синтетический тест сейчас публикует несовместимые серии в память. Одно падение.

**[P2] P5. Проверка целостности допускает нехешированный study.json.**
[load, строка 43](C:/mic_practice/tools/analyze_air56b2_energy_value.py:43)
проверяет только перечисленные outputs. Удаление study.json из manifest не мешает
загрузке. До чтения результата нужно требовать как минимум хеши study.json и
protocol.json, затем сверять содержимое. Само несовпадение присутствующего хеша
обнаруживается правильно. Одно падение.

**[P2] P6. Отчёт не раскрывает условный выбор принятого случая.**
[report](C:/mic_practice/tools/analyze_air56b2_energy_value.py:232)
не выводит `conditional_selection` и `selection_rule`. Общее предупреждение об
endpoint-conditioned выборке не объясняет, что дополнительный сценарий выбран
по факту пригодности и принятия EV после просмотра исходной серии. Нужно явно
подписать accepted-refinement как условную диагностическую проверку выбранной
траектории, не независимую репликацию, и указать правило выбора. Само правило
select_case менять не требуется. Одно падение.

## Что проходит

- Правильный знак: `loss_competitor - loss_EV`; перестановка строк не меняет парность.
- Усечённый опыт с согласованными rows/pairs не получает экономию.
- Прямое сравнение проверяет endpoint между EV и конкурентом: два отклонения
  +/-0,09 рад/с от fixed не превращаются в допустимую разность 0,18 рад/с.
- Отказы, смена исхода и отсутствующий подшаг не исчезают из refine.
- Accepted-case выбирается лексикографически, а не по наибольшей экономии;
  при отсутствии принятого случая сохраняется NO_ACCEPTED_CASE без подмены.
- Runner формирует ровно 8 методов x 3 подшага и сохраняет хеш родительского study.
  В тесте executor только возвращает готовые строки; вызов run_job запрещён ловушкой.
- Wrapper проверяет exit code каждого процесса, условно добавляет дополнительное
  уточнение при наличии study.json и восстанавливает рабочий каталог.

## Проверка и статус

Создан [test_air56b2_energy_value_publication_review.py](C:/mic_practice/tests/test_air56b2_energy_value_publication_review.py).
Запускался только этот файл: **26 случаев, 11 passed, 15 failed**, exit code 1.
Падения не помечены xfail/skip. Старые 1035 тестов не перезапускались. Обычный
`pytest -q` wrapper использует другие testpaths, поэтому этот review нужно вызвать
явно, как ниже; существующие зелёные наборы не заменяют эту проверку публикации.

```powershell
python -B -m pytest -p no:cacheprovider -q --tb=short tests/test_air56b2_energy_value_publication_review.py
```

SHA-256 до/после ревью совпали:

| Инструмент | SHA-256 |
|---|---|
| analyze_air56b2_energy_value.py | E21C830873272160AC0ED7AEB62909D3E7EFC299A498FB4108649D0431295F61 |
| run_air56b2_accepted_refinement.py | 25616056F03C9B73EB429B46DFAC0D08550B02C1CF50DB93543A8454330CD67A |
| run_air56b2_energy_value.ps1 | 959A3BC256ED37D3C00BC08DFF5616719F0219E40D22E969E5BDE21BA40A3789 |

**Вывод:** перечисленные проверки следует закрыть до публикации и отбора
дополнительного случая. Это дефекты валидации/описания публикационного набора,
а не доказательство повреждения фактических независимых результатов. Оснований
изменять контроллер, пороги, правила опыта либо подбирать seeds этот аудит не даёт.
Исправление публикационных проверок само по себе не требует пересчёта численных
серий. Записаны только новый review-тест и эта краткая записка.

## Закрытие находок, 10.09.2026

Основной агент исправил P1-P6 в инструментах публикации: проверяется точное
множество заданий, пары и сводки пересчитываются из строк, уточнение требует
одного сценария, дополнительная серия связана с родительским SHA-256,
обязательные файлы должны иметь хеши, условный отбор раскрыт в отчёте.
Субагент согласовал положительные синтетические фикстуры с этим контрактом;
намеренно повреждённые данные не смягчены. Повтор: **26 passed**.
Совместный запуск с 15 тестами анализа основным агентом: **41 passed**.
Приведённые выше 11/15 и хеши относятся к исходному состоянию до исправлений.
Эти изменения не меняют замороженный регулятор и фактические результаты опытов.
