11lisov11/mic_practice/research/AIR56B2_NOVELTY_AUDIT_20260909_RU.md

# AIR56B2: аудит научной новизны энергетически ограниченной адаптации

Дата поиска: 09.09.2026. Статус: предварительный исследовательский аудит, не подтверждение новизны, не патентное заключение и не доказательство безопасности стенда.

## 1. Объект и вывод

Рассматривается заданный контракт кандидата поверх `DynamicProbeSupervisor`: измеренная опорная мощность с явными границами погрешности и дрейфа; верхняя оценка накопленной положительной избыточной энергии на клеммах двигателя; резерв на ограниченное по скорости изменение задания и физическое восстановление; проверка окупаемости на оставшемся горизонте. Обучение нейросети, выбор информативности/длительности проб и адаптивное планирование эксперимента в этот этап **не входят**.

Прочитаны существующий `C:/mic_practice/research/mic_ai_theory/snh_pwm/source/control/air56b2_dynamic_probe.py` и `C:/mic_practice/research/AIR56B2_ENERGY_CORE_THEORY_RU.md`. Исходный супервизор выполняет фиксированную последовательность baseline / low / high / baseline_repeat / candidateverify, проверяет наблюдения и ограничивает скорость задания. Его документация прямо исключает сертификацию установления тока/потока по этим наблюдениям. Реализация нового энергетического слоя другим агентом здесь не проверялась.

**Главный вывод:** сейчас обоснована инженерная конкретизация известных подходов, а не новый общий метод. Оптимизация потока и переходных потерь, гибрид «модель + поиск», обучение оптимальным траекториям, консервативный бюджет относительно базовой стратегии, неизвестная базовая эффективность и прогнозная стоимость резервной политики уже представлены в первичных работах ниже. Особенно близок SOOPER [12]. Отсутствие идентичного названия статьи или модели AIR56B2 ничего не доказывает.

## 2. Матрица ближайших первоисточников

Уровень чтения: **Т** = доступен первичный текст, проверены указанные разделы; **А** = первичная аннотация/издательские фрагменты, полный текст не проверен. Правая колонка содержит гипотезу для проверки, а не установленное отсутствие признака у предшественника.

| № | Первичный источник и доступ | Существенное пересечение | Точное потенциальное отличие и его статус |
|---|---|---|---|
| 1 | Pryymak, Moreno-Eguilaz, Peracaula, 2006. [Neural network flux optimization using a model of losses in induction motor drives](https://www.sciencedirect.com/science/article/pii/S0378475406000486). DOI `10.1016/j.matcom.2006.02.015`. **А** | Нейросеть выдаёт оптимальный поток асинхронного двигателя по модели потерь с магнитными и температурными отклонениями; входы включают момент, скорость, сопротивление ротора. | Кандидат ограничивает цену онлайн-пробы по измеренной энергии, а не обучает отображение оптимального потока. Возможное отличие относится к сертификату эксперимента; «NN для экономии энергии» уже известно. |
| 2 | Stumper, Dötlinger, Kennel, 2013. [Loss Minimization of Induction Machines in Dynamic Operation](https://www.researchgate.net/publication/260540718_Loss_Minimization_of_Induction_Machines_in_Dynamic_Operation). IEEE TEC 28(3), 726-735; DOI `10.1109/TEC.2013.2262048`. **Т**, авторская копия, разделы II-III | Оптимизация траектории потока с учётом переходных медных/стальных потерь и требуемого отклика момента; стационарный оптимум может давать дорогой переход. | Бюджет допустимого ущерба от неизвестного кандидата относительно ненаблюдаемой базовой траектории, включая возврат, отличается от оптимизации по заданной модели. Наличие такого сертификата у нас ещё требует обоснования; сам учёт переходов не нов. |
| 3 | Plathottam, 2017. [Optimal Control Of Induction Machines To Minimize Transient Energy Losses](https://commons.und.edu/theses/2313/). Диссертация, UND. **А** | Оптимальное управление переходными потерями с состояниями скорости/потока и ограничениями качества; NN аппроксимирует численные оптимальные траектории, используется supervisory logic и FEM в реальном времени моделирования. | Не обученный оптимальный переход, а ограничение стоимости короткого измерительного эксперимента без доступа к истинным потерям. Нельзя заявлять впервые «NN + супервизор + динамическая энергооптимизация»; полный текст диссертации требует дальнейшего сравнения. |
| 4 | Farhani, Zaafouri, Chaari, 2017. [Real time induction motor efficiency optimization](https://www.sciencedirect.com/science/article/abs/pii/S001600321730073X). DOI `10.1016/j.jfranklin.2017.02.012`. **А** | Быстрая модельная оценка потока, затем адаптивный поиск simulated annealing; обсуждаются внезапная нагрузка, устойчивость и плавность оптимизации. | Явный интегральный лимит энергии эксперимента и остаточная окупаемость могут отличаться от гибридного поиска. Простые fit, fallback и проверка кандидата сами по себе новой гибридной архитектуры не образуют. |
| 5 | Ishnazarov и соавт., 31.07.2026. [Energy-Optimal and Thermally Robust Predictive Flux Control of Industrial Induction Motor Drives](https://www.mdpi.com/1996-1073/19/15/3608). DOI `10.3390/en19153608`. **А**, издательские фрагменты | Конечногоризонтный экономический MPC асинхронного привода: потери машины/инвертора, температурная адаптация и резервирование потока при ожидаемом росте нагрузки. Количественные результаты только симуляционные. | Предполагаемый сертификат относительно неизвестного контрфактического baseline и фиксированная цена проб, а не модельный минимум потерь. Ни конечный горизонт, ни резерв потока отдельно не являются достаточным отличием. Теоремы этой работы не проверялись. |
| 6 | Wu, Shariff, Lattimore, Szepesvari, 2016. [Conservative Bandits](https://arxiv.org/abs/1602.04282). **А** | Ограничение накопленного ухудшения относительно baseline равномерно по времени при исследовании альтернатив; вероятностные/ожидаемые гарантии в соответствующих постановках. | Предлагается абсолютный бюджет в джоулях для положительной части перерасхода и физические переходы. Это иная специализация стоимости, но не доказанная новая концепция консервативного исследования. |
| 7 | Kazerouni, Ghavamzadeh, Abbasi-Yadkori, Van Roy, 2017. [Conservative Contextual Linear Bandits](https://arxiv.org/html/1611.06426v2). [NeurIPS](https://proceedings.neurips.cc/paper_files/paper/2017/hash/bdc4626aa1d1df8e14d80d345b2a442d-Abstract.html). **Т**, §2.2, §4, Algorithm 2 | CLUCB2 уже работает с неизвестным вознаграждением базовой политики, строит доверительные множества и проверяет консервативное условие. | Отличие пришлось бы доказывать для зависимой от состояния динамики асинхронной машины, накопленной магнитной энергии и платного восстановления. «Неизвестный baseline» сам по себе занят; заданная вручную полоса дрейфа проблему идентификации не решает. |
| 8 | Li, Chen, Yang, Yan, 2023/2024. [Dual Control of Exploration and Exploitation for Auto-Optimisation Control with Active Learning](https://arxiv.org/abs/2301.11984). DOI `10.1109/TASE.2024.3375373`. **А** | Управление совмещает поиск неизвестного оптимума и уменьшение неопределённости через ансамбль оценивателей; активное исследование встроено в действие. | Текущий кандидат является фильтром допуска фиксированных проб, не DCEE: нет информационного критерия и адаптивного плана. Возможное будущее отличие: ограничение физической цены информации и её окупаемости, но оно ещё не реализовано и не проверено. |
| 9 | Zuo, Yu, Yang, Chen, 2024. [Auto-Optimized Maximum Torque Per Ampere Control of IPMSM Using Dual Control for Exploration and Exploitation](https://arxiv.org/abs/2404.18176). **А** | DCEE для электропривода, несколько RLS-оценивателей параметров и поиск MTPA; проверка в симуляции. | Это **IPMSM, синхронная машина с внутренними постоянными магнитами, не асинхронный двигатель**. Перенос постановки на IM требует иной динамики потока и потерь, но замена типа машины не доказывает самостоятельной новизны. |
| 10 | Varshney, Jain, 2025. [Developing dynamic models of inverter-based motor loads using active probing-based system identification techniques](https://www.sciencedirect.com/science/article/abs/pii/S0378779625004973). EPSR 248, 111906; DOI `10.1016/j.epsr.2025.111906`. **А** | Активные возмущения и измерения для динамических моделей инверторных моторных нагрузок; аппаратная валидация, моделирование сетевых переходов. | Цель кандидата: снижение энергии управления IM при ограниченной стоимости проб, а не получение агрегированной модели нагрузки для сети. Не следует приписывать статье именно наш тип двигателя/FOC по одному названию. Пробирование моторной нагрузки уже известно. |
| 11 | Wabersich, Zeilinger, 2018/2021. [A predictive safety filter for learning-based control of constrained nonlinear dynamical systems](https://arxiv.org/abs/1812.05506). DOI `10.1016/j.automatica.2021.109597`; [издатель](https://www.sciencedirect.com/science/article/pii/S0005109821001175). **А** | Модульный фильтр предложения управляющего действия, прогноз с неопределённостью, ограничения состояний/входов и резервная политика. | Бюджет энергии можно добавить как состояние известного safety filter. Отличие могло бы состоять в вычислимой IM-специфичной границе стоимости восстановления по малым данным, а не в архитектуре «предложение + проверка + rollback». |
| 12 | Wendl, As, Prajapat, Pollak, Coros, Krause, 2026. [Safe Exploration via Policy Priors](https://arxiv.org/html/2601.19612v1). [ICLR 2026, первичный текст](https://openreview.net/pdf/37f8892bcfcb3ed70c715fed7806e0263fed138f.pdf). **Т**, §3-4, Algorithm 1, Theorem 1 | **Наиболее близкий общий аналог:** SOOPER сравнивает уже накопленную стоимость плюс пессимистическую стоимость действия с последующей резервной политикой с бюджетом. Постановка использует ожидаемую дисконтированную стоимость CMDP; гарантии условны по калибровке и предположениям. | Возможная специализация: недисконтированный конечный горизонт, детерминированные границы, положительный перерасход относительно неизвестного baseline, измеряемая энергия клемм IM и её разделение с запасённой энергией. Каждый признак может оказаться обычной модификацией известной схемы; превосходство и новый результат не установлены. |

Библиографическая оговорка к [2]: [карточка TUM](https://mediatum.ub.tum.de/1183905) содержит иной DOI `10.1109/TEC.2013.2278772`. Выше использован DOI, напечатанный на первой странице авторской копии самой статьи: `10.1109/TEC.2013.2262048`. Разночтение не скрыто.

## 3. Что именно может означать энергетическая гарантия

Это анализ условий контракта, **не доказательство корректности нового кода**.

1. **Неизвестный контрфактический режим.** `P0(t)` означает мощность при неизменной базовой политике, одинаковом начальном состоянии и той же внешней нагрузке. После начала пробы этот сигнал непосредственно не измеряется. Опорное окно даёт `P_anchor`, но полоса `P0(t) >= P_anchor - eps_anchor - D(t)` требует отдельного предположения о дрейфе, нагрузке и погрешности окна. Два совпавших baseline-окна не доказывают покрытие между ними или в будущем.
2. **Условная верхняя оценка.** Пусть на всём интервале `I_j` известны действительные границы `P(t) <= P_U,j` и `P0(t) >= P0_L,j`. Тогда по монотонности положительной части:

   `E_plus(t_k) = integral [P(t)-P0(t)]_+ dt <= U_k = sum_j |I_j| max(0, P_U,j-P0_L,j)`.

   Это элементарное интервальное неравенство, не новая теорема управления. `E_plus` не равно ни знаковой разности энергий, ни положительной части её интеграла. Выигрыш других интервалов не пополняет этот бюджет. Точечные отсчёты или средняя мощность не дают границу непрерывного `E_plus` без межотсчётного ограничения/оценки интегрирования; ограниченность среднего не исключает краткого пика.
3. **Резерв должен быть перспективным.** Допуск следующего действия требует `U_k + D_next^U + R_rollback^U <= B` до его применения, с учётом всех достижимых следующих состояний. `D_next^U` покрывает задержку до реакции, `R_rollback^U` покрывает возврат задания, реальные токи/поток и установление. Остановка после наблюдаемого превышения уже не предотвращает превышение. Верхний предел скорости изменения задания сам по себе не задаёт верхней границы времени физического восстановления; нужны гарантии исполнения, дискретизации и динамики. Достижение `id_ref = baseline_id` не означает возврата состояния двигателя.
4. **Не переносить измеренный предел в будущее.** Прошлые `current_peak`/`voltage_peak`, дисперсия окна, эмпирический максимум или несколько стандартных отклонений не являются детерминированным ограничением будущей мощности. Нарушение принятой полосы, пропуск данных или неизвестная задержка должны явно снимать сертификат. Энергетический бюджет не заменяет быструю аппаратную токовую/напряженческую защиту.
5. **Окупаемость является отдельным условием.** Например, достаточный условный gate: `g_L * H_use >= U_spent + C_remaining^U + margin_J`. Здесь `g_L > 0` действительно ограничивает снизу будущую экономию мощности; `H_use` исключает оставшиеся пробы, переходы и восстановление; правая часть не считает уже учтённые затраты повторно. Измеренный выигрыш в одном окне не гарантирует `g_L` на остатке горизонта. При прогнозируемой, но не гарантированной длительности режима это эвристическая экономическая проверка, а не гарантия выигрыша. До получения кандидата его положительный `g_L` вообще может быть неизвестен.
6. **Мощность клемм не равна потерям.** Для согласованной границы модели: `E_terminal = E_loss + E_shaft + Delta W_magnetic + Delta W_kinetic`. Снижение потока способно временно уменьшать потребление за счёт запасённой энергии. Сравнение потерь требует одинаковой полезной работы и сопоставимых конечных запасов либо явной поправки; сравнение энергии эксперимента должно включать восстановление. Не следует прибавлять магнитную энергию второй раз, если она уже учтена интегралом клеммной мощности полного цикла. Это также не гарантия экономии со стороны сети/DC: потери инвертора находятся за выбранной границей.

При истинных интервальных предположениях и обеспеченном резерве можно формулировать условную сохранность **заданного бюджета**. Из неё не следуют устойчивость FOC, идентифицируемость параметров, оптимальность, физическая безопасность во всех режимах или обязательная положительная итоговая экономия.

## 4. Наиболее сильный оставшийся исследовательский вопрос

**Можно ли по короткой причинно доступной последовательности электрических измерений и скорости получить невырожденный сертификат конечногоризонтной экономии асинхронного привода относительно ненаблюдаемой базовой траектории, явно ограничив неопределённость магнитной энергии, дрейф нагрузки и стоимость физического возврата, без полного заранее идентифицированного двигателя и без бесплатных сбросов состояния?**

Здесь «невырожденный» означает, что сертификат разрешает полезные изменения, а не запрещает все пробы. Основная трудность не в суммировании джоулей: необходимо обосновать узкие границы контрфактической мощности и восстановления из доступной информации. Без ограничений внешней нагрузки, скрытого потока и межотсчётного поведения конечные данные допускают разные ненаблюдаемые продолжения; достаточность дополнительной информации должна стать частью результата.

Возможный вклад, пока не доказанный: связанная с физическим состоянием оценка `R_rollback^U` и полосы `P0`, которая при том же подтверждённом уровне ограничений заметно менее консервативна, чем постоянные worst-case пределы. Сам детерминированный супервизор с задаваемыми пользователем границами может остаться полезной **инстанциацией известных методов**. Наличие иной метрики, малого двигателя или меньшего объёма кода не заменяет сравнительного результата.

Минимальные различающие проверки для следующего этапа, не выполненные этим аудитом:

- Сравнить фиксированный baseline, исходные фиксированные пробы и энергетический фильтр при одинаковых наблюдениях, лимитах и времени; добавить одинаковый ограничитель к разным селекторам кандидата.
- Снять по одному бюджет, резерв возврата и gate окупаемости; отделить эффект запрета дорогих проб от собственно лучшего поиска оптимума.
- Проверить короткий остаток режима, смену нагрузки внутри/после проверки кандидата, смещение датчика, паузы измерений, границы дрейфа и задержки, размагничивание/намагничивание. Показывать знаковую энергию и положительный перерасход отдельно.
- Сопоставлять одинаковую работу вала и конечное состояние либо учитывать их интервальные различия; истинную baseline-траекторию использовать только для независимой проверки в симуляции, не отдавать супервизору.
- Установить происхождение каждого bound и область покрытия; сравнить с бюджетным фильтром общего вида [11-12]. Дополнительный исследовательский результат нужен сверх условного интервального неравенства. Аппаратная проверка потребует отдельного безопасного протокола и в этот этап не входит.

## 5. Воспроизводимый журнал поиска

Выполнены web-поиск и открытие первоисточников 09.09.2026. Ниже ключевые фактически выполненные запросы, пригодные для повторного поиска; выдача изменяется со временем. Указания результата обозначают найденные работы, не отсутствие остальных.

| Группа | Точный запрос или прямое открытие | Результат / ограничение |
|---|---|---|
| Q01 | `"10.1016/j.matcom.2006.02.015"`; `"Neural network flux optimization using a model of losses in induction motor drives"` | [1], подтверждены название/метод издателем. |
| Q02 | `"Neural network flux optimization" Pryymak UPC`; `"Neural network flux optimization using a model of losses" site:upc.edu` | Дополнительный поиск авторской копии; выводы опираются на ScienceDirect. |
| Q03 | `Stumper 2013 induction motor dynamic loss minimization`; `"Loss Minimization of Induction Machines in Dynamic Operation" "pdf" Stumper` | [2], авторская полная копия и карточка TUM с разночтением DOI. |
| Q04 | `"Loss Minimization of Induction Machines in Dynamic Operation" site:arxiv.org`; `"Loss Minimization of Induction Machines in Dynamic Operation" "2262048" IEEE` | Дополнительная проверка доступа/метаданных, не доказательство отсутствия копий. |
| Q05 | `"10.1016/j.jfranklin.2017.02.012"`; `"Real time induction motor efficiency optimization" hybrid loss search Farhani` | [4], гибридный алгоритм и экспериментальная направленность. |
| Q06 | Открыты `https://commons.und.edu/theses/2313/`, `https://arxiv.org/abs/1602.04282`, `https://arxiv.org/abs/2301.11984`, `https://arxiv.org/abs/2404.18176` | Первичные аннотации [3,6,8,9]; IPMSM отделён от IM. |
| Q07 | `"S0378779625004973"`; `"S0378779625004973" motor`; `"active probing" "motor" inverter 2025`; `"active probing" "motor loads"` | [10]; прямые открытия ScienceDirect иногда возвращали ошибку. |
| Q08 | `"Developing dynamic models of inverter-based motor loads" authors 2025` | [10], Varshney/Jain, DOI и том; дата выпуска November 2025, не дата обхода поисковика. |
| Q09 | `conservative linear bandits unknown baseline performance Kazerouni 2017`; открытие `https://arxiv.org/html/1611.06426v2` | [7], проверен §4 и CLUCB2, неизвестный baseline уже рассмотрен. |
| Q10 | `"predictive safety filter" Wabersich Zeilinger 2021 nonlinear control safety learning` | [11], общая прогнозная архитектура ограничения и резервной политики. |
| Q11 | `"Loss-Minimizing Flux Level Control of Induction Motor Drives" Qu Ranta`; `"Efficiency-optimized flux trajectories" Lorenz Yang` | Дополнительные исторические направления поиска; не подменяют детальное сравнение включённых 12 работ. |
| Q12 | `"induction motor" "energy budget" "optimization"`; `"induction motor" "loss minimization" "finite horizon"` | Второй запрос привёл к свежей работе [5]; первый давал также нерелевантные энергетические балансы. |
| Q13 | `"induction motor" "extremum seeking" "transient" energy`; `"induction motor" "payback" optimization flux` | Поиск по функции, не по совпадению заголовка; payback преимущественно выводил экономику замены двигателя. |
| Q14 | `"safe exploration" "cumulative cost" "backup" control`; `"Safe Exploration via Policy Priors" SOOPER` | [12], выявлено близкое условие accumulated cost + pessimistic fallback cost. |
| Q15 | `"Energy-Optimal and Thermally Robust Predictive Flux Control of Industrial Induction Motor Drives" "2026"` | [5], первичная издательская страница и авторский препринт; использована журнальная версия. |
| Q16 | Открытие `https://arxiv.org/html/2601.19612v1`; поиск внутри: `Online cost tracking`, `expected`, `Theorem 1` | [12], проверены различия ожидаемой дисконтированной и детерминированной конечногоризонтной стоимости. |

## 6. Ограничения и допустимая формулировка результата

- Отбор целевой, не систематический и не исчерпывающий: нет полного обхода цитирований, платных баз, патентов, непроиндексированных диссертаций и всех русскоязычных работ. Включены первичные источники до даты аудита, в том числе 2026 года.
- Для строк **А** выводы ограничены аннотациями и доступными фрагментами самого издателя/автора. Ошибка прямого открытия не считалась отсутствием работы: использовалась индексированная выдача первичной страницы. Вторичные агрегаторы служили только навигационными подсказками, не основанием технических выводов.
- Чтение раздела с теоремой не равно независимой проверке доказательства. Гарантии bandits, DCEE, MPC и SOOPER нельзя автоматически переносить на код AIR56B2, иной шум, иной горизонт и иную измерительную границу.
- Нет обучения NN, новых симуляций, аппаратного запуска или численно установленного превосходства в рамках этого аудита. Прочие существовавшие изменения рабочего дерева не затрагивались; создан только настоящий файл.

Корректная рабочая формулировка: **«Предварительный детерминированный энергетический фильтр допуска проб для асинхронного привода с явно заданными границами погрешности/дрейфа, резервом восстановления и проверкой остаточной окупаемости. Самостоятельная научная новизна и физическая применимость границ пока не установлены».**
