11lisov11/mic_practice/research/AIR56B2_RESEARCH_DECISIONS_20260909_RU.md

# Решение по кандидату научной новизны: энергетический бюджет проб

## Что было проверено

Кандидат добавляет к существующему аналитическому поиску потока счётчик
избыточной энергии, резерв на возврат и условную проверку окупаемости.
Это ещё не новый обучающийся регулятор: последовательность проб фиксирована,
нейросеть не обучается, параметры физических моделей не подменяются паспортом.

Аудит 12 близких первичных работ находится в
`AIR56B2_NOVELTY_AUDIT_20260909_RU.md`. Он выявил существенное пересечение
с conservative exploration, predictive safety filters и SOOPER (2026).
Поэтому бюджет с резервной политикой как общий принцип не объявляется новизной.

## Чему научило независимое ревью

Регрессионные тесты воспроизвели пять ошибок первой реализации: начисление
стоимости непринятого эксперимента, устаревание среднего окна, сохранение
проекции после раннего отказа, удержание кандидата при пропуске данных и
преждевременное завершение физически задержанного возврата задания.
В ревизии 2 они исправлены. Дополнительно сужена трактовка бюджета:
положительные средние превышения по шагам не ограничивают все внутритактовые
пики, а бюджет проб/возврата не является бюджетом всего интервала удержания.

Зелёные тесты подтверждают эти программные свойства, а не достоверность модели,
достаточность приоров и научную новизну. Методика: `AIR56B2_BUDGET_PROTOCOL_RU.md`.

## Почему нельзя гарантировать выигрыш по любому короткому фрагменту

Рассмотрим только иллюстративное семейство установившихся потерь

    L(i,b) = a*i^2 + b/i^2,    a>0, b>=0.

Это известная упрощённая форма конкурирующих составляющих потерь, не новая
модель AIR56B2 и не замена динамического испытания. При выборе i1<i0:

    L(i0,b)-L(i1,b) = (i0^2-i1^2) * (a - b/(i0^2*i1^2)).

Следовательно, уменьшение возбуждения полезно при b < a*i0^2*i1^2 и вредно
при b > a*i0^2*i1^2. Два режима могут иметь одинаковую историю до момента
решения, но разные будущие нагрузки, меняющие b по разные стороны порога.
По прошлым измерениям заранее различить такие продолжения нельзя.

Это алгебраический контрпример к безусловной гарантии для фиксированной настройки
на будущем интервале, не доказательство невозможности адаптивного управления
вообще. Для гарантий нужны ограничения изменения нагрузки, новая информация
или повторное решение с контролируемой задержкой и стоимостью возврата.
Более мощная нейросеть не устраняет эту информационную границу.

## Какой вопрос остаётся для нового метода

Не добавление ещё одного фиксированного порога, а **получение достаточно узких
и проверяемых оценок стоимости восстановления и полезности следующего измерения
из доступной истории**, при неопределённом потоке и изменении нагрузки.

Возможный следующий эксперимент, пока не выполненный:

1. Сохранять множество допустимых состояний/параметров, а не одну угаданную
   модель; явно учитывать неразличимые по прошлым измерениям варианты.
2. Строить связанную с этим множеством границу энергии и времени возврата.
   Сам по себе баланс пассивности даёт не любую нужную верхнюю границу;
   необходимы отдельные динамические предпосылки и проверка достижимости.
3. Выбирать следующую пробу по ожидаемому сокращению неопределённости решения
   и её полной цене, включая восстановление; короткий режим может требовать
   отказа от пробы ещё до её начала.
4. Сравнить с фиксированным бюджетом и ближайшим общим бюджетным фильтром
   при одинаковом подтверждённом уровне ограничений, без бесплатного сброса
   состояния между пробами и без доступа к будущей нагрузке.

Критерий продолжения: разрешённые полезные изменения и воспроизводимый выигрыш
на новых двигателях/режимах, который сохраняется после учёта всех затрат и
исчезает при отключении предполагаемого нового механизма. Новизна этого
следующего решения также ещё должна пройти проверку литературы.

## Разделение с аппаратным проектом

Этот этап выполняется только на ПК. Прошивки, управляющие команды и параметры
подключённых плат не менялись. Из результатов не следует готовность ИИ/FOC
к силовому запуску. Работы по Wi-Fi/UART и аппаратной безопасности сюда не входят.
