11lisov11/mic_practice/research/AIR56B2_SIMULATION_STATUS_RU.md

# AIR56B2: статус компьютерного моделирования

Динамический этап 08.09.2026: [баланс энергии и полная стоимость адаптации](AIR56B2_DYNAMIC_POWER_RESULTS_RU.md),
[модель и теоретические ограничения](AIR56B2_ENERGY_CORE_THEORY_RU.md).
Статические нейросетевые веса не прошли перенос в этот новый динамический контур.

Дата фиксации: 28 августа 2026 г.

Дополнение 08.09.2026: прежние результаты оптимизации потерь и нейрополитики
ниже являются историческими. Выявлены ошибки интерпретации момента и формулы
напряжения; они исправлены в отдельном новом измерительном эксперименте.
Актуальная интерпретация: [результаты](AIR56B2_MEASUREMENT_ADAPTATION_RESULTS_RU.md)
и [математическая постановка](AIR56B2_MEASUREMENT_ADAPTATION_THEORY_RU.md).
Это уточнение не относится автоматически ко всем независимым динамическим
V/f, FOC и защитным моделям проекта.

## 1. Исходные данные

Единственный первичный источник чисел двигателя — официальный каталог IEK для
AIR56B2: 0,25 кВт; 220/380 В Delta/Y; 1,24/0,72 А; 50 Гц; 2720 об/мин;
`cos phi=0,78`; `eta=0,68`; две полюсные ступени, одна пара полюсов;
`I_start/I_N=5,3`; `M_start/M_N=2,2`; `M_max/M_N=2,2`.

Источник: <https://cdn-01.iek.ru/media/original/78c31060549010eaa9a1bb1f4f6d2d8cb3155062b138bfd13478f55521c38a47.pdf>

Физическое соединение двигателя для инвертора 220 В — треугольник. Внутри
alpha-beta/dq-модели используется эквивалентная звезда: 127,017 В фазного RMS и
1,24 А фазного RMS. Это математическое преобразование не меняет перемычки на
клеммнике двигателя.

Однозначно вычислены:

- синхронная скорость: 3000 об/мин;
- номинальное скольжение: 9,333 %;
- угловая скорость: 284,838 рад/с;
- момент на валу: 0,87769 Н·м;
- полная мощность: 472,503 В·А;
- входная активная мощность по `U/I/cos phi`: 368,553 Вт;
- входная активная мощность по `P2/eta`: 367,647 Вт;
- суммарные потери: 117,647 Вт.

Два расчёта входной мощности расходятся на 0,246 %, что соответствует
округлению паспортных значений.

## 2. Что рассчитано, но не измерено

`Rs`, `Rr`, `Lls`, `Llr`, `Lm`, сопротивление ветви потерь в стали, `J` и `B`
не восстанавливаются из одной паспортной точки единственным образом. Поэтому
`models/air56b2_nameplate_ensemble.py` строит детерминированное семейство, а не
объявляет один набор истинным.

В активной конфигурации эти величины не входят в `NAMEPLATE_DEFAULT`. Удалён
старый эвристический путь с `J=0,01 кг·м²`, фиксированными индуктивностями и
произвольным разбиением потерь. `create_default_env()` теперь выбирает
центральный наблюдавшийся элемент канонического ансамбля (256 моделей,
seed 560225); источник результата явно остаётся `simulation prior only`.

В JSON параметры разделены на три класса: `official_nameplate`,
`deterministically_derived` и `constrained_estimates`. Только первый класс
считается паспортными данными, второй вычисляется из него однозначно, третий
зависит от явно записанных границ и до стендовой идентификации не является
параметрами конкретного экземпляра двигателя.

Каждая модель семейства проходит установившийся расчёт схемы замещения и
воспроизводит ток, `cos phi`, выходную мощность, КПД и пусковую кратность в
пределе 1 %. Центральный пакет из 256 моделей находится в
`artifacts/air56b2_nameplate_ensemble.json`. Это `F1 linear`: насыщение не
включено, поскольку кривая намагничивания отсутствует.

Кратности момента из паспорта не подменяются модельными значениями:
`M_start/M_N=2,2`, `M_max/M_N=2,2`. Проверка выявила ограничение F1:
одноклеточная линейная схема при согласовании перечисленных выше пяти величин
даёт `M_start/M_N=5,91...6,48` и такую же нижнюю границу максимального момента.
Поэтому F1 запрещено использовать как количественное доказательство пускового
момента. Паспортные кратности сохранены как точные цели валидации. Для пуска
добавлен уровень `F1S`: феноменологическая добавочная потеря при большом
скольжении сохраняет номинальную точку F1, пусковой ток `5,3 I_N` и приводит
пусковой и максимальный моменты к паспортным `2,2 M_N`. Для 256 моделей
максимальная относительная ошибка этих двух моментных целей не превышает
`1,12e-15`. Параметр перехода `0,15` явно помечен как допущение, отсутствующее
в паспорте. Это не идентифицированная двухклеточная схема и не замена испытанию
короткого замыкания. Полный результат находится в
`artifacts/air56b2_fidelity_bundle.json`.

Уровень `F2` вводит ограниченные priors температуры, насыщения и механических
потерь. Уровень `F3` вводит ripple DC-bus, dead-time, падение напряжения ключей,
сопротивление открытого ключа, разрядность, смещение, масштаб и задержку АЦП,
а также квантование и задержку AS5600. Нижняя граница диапазона канала тока
проверяется по пиковому паспортному пусковому току, а канала напряжения — по
максимальному DC-bus с ripple. Все эти величины остаются simulation priors.
В текущем V/f-прогоне температурно-масштабированные сопротивления, насыщение,
вязкое и кулоновское трение входят в динамику, но коэффициент потерь в стали
пока только записывается в метаданные F2: отдельная динамическая ветвь core-loss
ещё не реализована. Добавочная потеря F1S также пока не связана с тепловым
состоянием.

Инженерный prior для суммарной индуктивности рассеяния `4...15 мГн` записан в
манифесте. Более широкие корни должны использоваться как OOD-проверка, а не
скрываться. Аппаратные опыты холостого хода, короткого замыкания, DC-тест и
выбег позднее сузят семейство.

## 3. Исправления и контракты FOC

В host FOC исправлены четыре ошибки:

1. скольжение теперь вычисляется как `(Rr/Lr)*(iq/id)`, а не размерностно
   неверное выражение через момент и поток;
2. внешний PI скорости имеет conditional anti-windup;
3. PI токов имеет anti-windup с обратным расчётом при ограничении напряжения;
4. перекрёстная компенсация использует `sigma*Ls`, а q-канал учитывает поток
   ротора; preflux входит в общее ограничение напряжения.

Старый контур настройки получает полное состояние моделируемого двигателя. Он
теперь явно маркируется `oracle_full_simulated_state` и используется только как
верхняя оценка реализуемости алгоритма. Отдельный encoder-observer контур получает
задержанные квантованные токи alpha-beta, DC-bus и скорость, вычисленную из
AS5600. Перед подачей PWM выполняется калибровка нуля токовых каналов; истинные
потоки, скорость, угол и фактический момент нагрузки контроллеру не передаются.
Это encoder-assisted FOC, а не бездатчиковый FOC.

## 4. Зафиксированные результаты

Oracle-настройка выполнена на шести train-моделях, выбор — на десяти
validation-моделях. Blind holdout при настройке не использовался.

Выбранная конфигурация: кандидат 3 в
`artifacts/air56b2_foc_matched_tuning.json`.

Validation, 20 опытов:

- худшая установившаяся ошибка скорости: 0,221 рад/с;
- худшая финальная ошибка: 0,110 рад/с;
- максимальный ток alpha-beta: 3,321 А;
- нарушений защиты и fault latch: 0;
- gate: PASS.

Blind holdout, 30 новых моделей и 60 опытов по 0,5 с:

- model-matched FOC: установившаяся ошибка 0,091 рад/с, финальная 0,105 рад/с,
  пик 3,293 А, gate PASS;
- frozen central nameplate model: gate FAIL;
- hardware release: запрещён до измерения параметров.

Для encoder-observer FOC проведена отдельная настройка по измерительному
контракту F3: три train-модели и шесть непересекающихся validation-моделей.
Выбран кандидат 5. На независимом каноническом наборе из 24 моделей по 1,0 с
получено 24/24 PASS: пик истинного тока 3,929 А, худшая средняя установившаяся
ошибка скорости 4,965 рад/с, худшая финальная ошибка 2,828 рад/с, 0 отказов
шлюза и 0 обращений к истинному состоянию объекта. Максимальное мгновенное
расхождение оценки скорости наблюдателя составило 22,971 рад/с. Режим проверки:
30 % номинальной скорости, вентиляторная нагрузка 50 %, разгон 0,2 с.

Sensorless scalar V/f прогнан через общую цепочку F1/F1S/F2/F3 на 24
комбинациях priors по 0,4 с. Контроллер получает только команду частоты,
задержанный квантованный модуль тока и задержанный квантованный DC-bus; истинные
скорость, угол, поток и фактический момент нагрузки ему не передаются. AS5600
записывается только как будущий teacher-канал. При задании 15 Гц и вентиляторной
нагрузке 50 % получено: 24/24 PASS, пик истинного тока 2,595 А, конечная скорость
855,46...876,44 об/мин, 0 отказов шлюза и 0 клиппингов АЦП. Это проверка
программной интеграции, а не доказательство поведения реального двигателя.

Дополнительно V/f проверен на одной и той же выборке из 12 моделей в четырёх
режимах: 5/15/30/50 Гц и вентиляторная нагрузка 25/50/75/100 %. Все 48 опытов
длительностью 1,0...2,5 с прошли; суммарное модельное время 72 с, пик тока
3,470 А, отказов шлюза и клиппингов АЦП нет. Минимальная конечная доля
синхронной скорости по режимам: 0,98; 0,96; 0,88 и 0,76 соответственно. Это
многорежимная проверка запуска и установления, но ещё не энергетический
benchmark и не fault-injection campaign.

Защитный шлюз дополнительно проверен на 24 вариантах F3 по семи критическим
авариям: overcurrent, under/overvoltage, overtemperature, watchdog, nonfinite
current и invalid vector. Все 168 случаев прошли: запрос отклоняется, PWM и все
шесть затворов отключаются, fault остаётся защёлкнутым на следующей исправной
команде и снимается только явным reset. Это SIL-проверка логики; задержки DESAT,
UVLO, аппаратного компаратора и драйвера IPM должны измеряться на HIL/стенде.

Канонический состав и SHA-256 каждого evidence-файла фиксируются в
`artifacts/air56b2_research_manifest.json`. Статус `PASS` означает готовность
компьютерной части к аппаратной идентификации, но не разрешение силового пуска.

Итог трактуется строго: oracle-FOC показывает алгоритмическую реализуемость, а
encoder-observer FOC показывает работу измерительного контура в текущей
симуляции. Один паспорт не гарантирует устойчивость реального замкнутого FOC.
Честный sensorless speed observer ещё не принят. Первый аппаратный пуск остаётся
scalar V/f; FOC включается только после принятого отчёта идентификации.

## 5. Воспроизведение

Создание или восстановление среды:

```powershell
powershell -ExecutionPolicy Bypass -File tools/setup_research_gpu_env.ps1
```

Быстрая проверка:

```powershell
powershell -ExecutionPolicy Bypass -File tools/run_air56b2_research_pipeline.ps1
```

Конвейер выполняет три изолированные тестовые серии: 167 тестов SNH/PWM, 34
теста перенесённого FOC+PPO-контура и 17 тестов идентификации двигателя, всего
218. Раздельный запуск нужен из-за разных корней импортов исследовательских
срезов.

Полная перестройка ансамбля, V/f-матрицы, oracle/encoder FOC-настройки и blind
holdout:

```powershell
powershell -ExecutionPolicy Bypass -File tools/run_air56b2_research_pipeline.ps1 -Full
```

Среда: `.venv-research-gpu`, PyTorch CUDA 12.8, RTX 5070. Пошаговая модель
двигателя пока выполняется на CPU; CUDA используется для будущего обучения
сетей. Перенос объекта на Torch допускается только вместе с проверкой численного
совпадения CPU/GPU.

## 6. Закрытие программного этапа 28 августа 2026 г.

После исходной фиксации добавлены и включены в единый конвейер:

- изолированный воспроизводимый порт FOC+PPO с паспортным профилем AIR56B2,
  поддержкой CUDA, фиксированными seed, checkpoint bundle и запретом
  аппаратного выпуска;
- явная модель медных, магнитных, механических и инверторных потерь и
  классическая оптимизация `i_d_ref`: 480/480 сопоставимых режимов, медианный
  расчётный выигрыш 9,649 %, ухудшений нет;
- независимая RK4-модель объекта и sensorless observer, принимающий только
  приложенное напряжение и ток: на 15/30/45 Гц средняя относительная ошибка
  скорости 3,351 %, доля валидного времени 1,0;
- детерминированная дистилляция классического оптимума в нейросетевую политику
  с непересекающимися train/validation/holdout: 600 holdout-режимов, 0 нарушений
  ограничений, медианный разрыв с классическим оптимумом 0,373 %;
- JSON-LUT и C-заголовок для последующего переноса, в которых аппаратный выпуск
  принудительно выключен до приёмки стендовых измерений.

Полный конвейер завершён со статусом `PASS`; манифест версии v5 проверяет 39
ворот и SHA-256 evidence-файлов. Флаг `hardware_release_ready` остаётся `false`.
Это означает завершение доступной компьютерной части, но не подтверждение
работы конкретного двигателя, инвертора, датчиков или защиты.

Оформленные результаты:

- `output/documents/AIR56B2_научно_технический_отчет_2026-08-28.docx`;
- `output/documents/AIR56B2_программа_аппаратной_верификации_2026-08-28.docx`;
- соответствующие PDF в `output/pdf`;
- машинный итог `artifacts/air56b2_research_manifest.json`;
- краткий протокол `research/AIR56B2_FINAL_RESULTS_RU.md`.
