11lisov11/mic_practice/research/MIC_AI_RESEARCH_AUDIT_RU.md

# MIC AI: критический аудит и научная значимость

Дата аудита: 9 августа 2026 г.

Ревизия статистики C6-BCR: 26 августа 2026 г.

## Итог в одном абзаце

Проект содержит пять связанных, но разных научных результатов. Первый — MIC AI как
защищённая надстройка над FOC, изменяющая только задание намагничивающего тока и
переносимая в LUT. В цифровой модели на трёх двигателях она дала среднюю экономию
положительной входной мощности `0,849 %`; минимальное среднее по двигателю и режиму
в итоговой приёмочной таблице составило `0,356 %`. Второй — SNH-PWM, архитектура
прямого выбора вектора инвертора с коротким горизонтом, адаптацией функции стоимости,
событийной обратной связью и независимым защитным шлюзом. Второй результат пока
подтверждён только программно: в полном парном исследовании ошибка скорости была
статистически меньше, чем у текущей настройки FOC-SVM, в 26 из 31 сценария, больше
в трёх и статистически неразличима в двух. Поэтому универсальное превосходство не
подтверждено. Третий — не нейросетевой C6-RV-PWM: робастный конечный выбор
вектора с использованием циклической симметрии инвертора, CVaR по множеству
параметров и ленивой проверкой достижимости безопасного следующего состояния. В
MC5-серии на 31 сценарии он дал меньшую ошибку скорости в 29 сценариях, большую в
`braking` и статистически неразличимую в `reverse`; это перспективная гипотеза.
Четвёртый результат — C6-BCR, блочно-конформная калибровка ошибки модели FCS-привода.
Две архивные слепые серии показали описательное bulk coverage около 95% и уменьшили
агрегированный медианный 5D-гиперобъём на 26,1% относительно обычного conformal-box.
Прежний pooled-binomial coverage-тест признан некорректным из-за общего calibration
tube для test-блоков одного split. Новые prospectively locked серии дали `759/800`
независимых покрытий и aggregate exact 99% LCB `0,927645`, но строгий общий gate не
пройден: индивидуальные LCB `0,918599` и `0,915549` ниже порога `0,92`. Кандидат
новизны сохраняется как гипотеза; мировая новизна без полного поиска и рецензирования
не объявляется. Пятый —
модельно-ориентированная идентификация `Rs/Rr/Lm/J/B`: оптимизация разрешается
только после SVD-проверки ранга, а C6-многомасштабный профиль совместно оценивает
наблюдаемое рассеяние `Lsigma` и неизвестный момент `Tload`. В двух независимых
сериях C6 превысил `64/64` случайных PRBS-дизайна по Fisher determinant и сохранил
медианную максимальную ошибку пяти целевых параметров ниже 1%, но PRBS чаще давал
меньшую конечную ошибку. Поэтому заявляется D-информативность, а не универсальная точность.

## Что подтверждено

### MIC AI над FOC

- Итоговый пакет содержит три двигателя: AIR56, AL31 и AO2; все три прошли
  собственные модельные acceptance-gates.
- Среднее снижение `Pвх+` по трём двигателям равно `0,8491405 %`.
- Минимум показателя из приёмочной таблицы равен `0,3555319 %`.
- Среднее изменение интегрального КПД равно `+1,0281771 %`, но минимальное
  значение `-0,000206 %`; поэтому нельзя писать, что КПД улучшался в каждом
  отдельном случае.
- Это результаты физически параметризованного цифрового двойника, а не
  физического стенда.

### SNH-PWM

- Исторический host-release воспроизводим по своему манифесту и содержит 31
  сценарий, 8 контроллеров, MC100/MC500 smoke evidence и программные проверки
  защитного шлюза.
- Исправлена ошибка: нейросетевой формирователь стоимости раньше всегда получал
  `current_ratio=0`; теперь используется ток, вычисленный из состояния модели.
- Сравнение контроллеров сделано парным: один и тот же trial seed задаёт одни и
  те же параметры двигателя и шумы для каждого контроллера.
- В результаты добавлены `time_step_s`, `simulated_duration_s` и автоматический
  gate: вывод о механической динамике запрещён при длительности менее `0,2 с`.
- Исправленная ревизия проходит 43 целевых теста, включая полное совпадение
  последовательного и многопроцессного расчёта и feedback-решения с фактически
  использованной обратной связью.
- Финальная серия охватывает `31 сценарий × 30 парных повторов × 8 контроллеров ×
  2000 шагов`, то есть 7440 контроллер-прогонов длительностью `0,2 с` каждый.
- Автоматический аудит дал `host_long_horizon_ready=true`, но намеренно оставил
  `hardware_ready=false` и `universal_superiority_supported=false`.

### C6-RV-PWM без нейросети

- Электрическая модель и векторы инвертора прошли 500 метаморфных C6-тестов;
  максимальный численный остаток составил примерно `1,3e-15`.
- Финальная exploratory-серия содержит 31 сценарий, 5 парных повторов и окно
  `0,2 с`; это полный набор режимов, но ещё не публикационный MC30.
- Относительно текущего FOC-SVM ошибка скорости статистически меньше в 29
  сценариях, больше в `braking`, неразличима в `reverse`.
- Максимальный ток модели равен `4,580244 А` при `i_trip=6,125 А`; неожиданных
  защёлок и программных shoot-through нарушений не обнаружено.
- C6-сокращение оставляет около 4-5 кандидатов вместо восьми. Ленивый constraint
  horizon уменьшил типичную вычислительную цену примерно с 360 до 40-45 модельных
  переходов на такт, активируясь чаще в OOD.
- Predecessor-проверка ни разу не отклонила кандидат. Её самостоятельная польза
  текущим экспериментом не подтверждена.
- Автоматический falsification не нашёл небезопасного примера, но нашёл область
  параметров с положительным speed-regret; поиск является неполным.

### C6-BCR: смешанный результат locked-ревалидации

- Остаток однопереходной модели по четырём потоковым координатам и скорости
  канонизируется поворотом `C6` по сектору потока статора.
- Один nonconformity score берёт максимум по пяти состояниям и всем 40 PWM-тактам
  траектории. Поэтому гарантия относится ко всему блоку и не предполагает
  независимость соседних тактов.
- Train, calibration, test и OOD seed разделены; повёрнутые копии не выдаются за
  независимые наблюдения. Квантиль использует конечновыборочный ранг
  `ceil((n+1)(1-alpha)) = 381` при `n=400`, `alpha=0,05`.
- Серия `20260809` дала описательное coverage `94,765625%` и отношение C6/global `0,759127`,
  но её seed пересекается с exploratory rev2; это development evidence, а не
  независимое подтверждение.
- В слепой серии `20260810` описательное coverage составило `94,973958%`, отношение
  гиперобъёма `0,707827`, C6 выиграл `22/24`, sign-test `p=1,7941e-5`.
- В слепой серии `20260811` описательное coverage составило `95,151042%`, отношение
  гиперобъёма `0,750623`, C6 выиграл `20/24`, sign-test `p=0,00077194`.
- Агрегат двух слепых серий: 48 разбиений, описательное coverage `95,0625%`, отношение
  гиперобъёма `0,739117`, `42/48` выигрышей, sign-test `p=5,04374e-8`.
- Прежние p-value совокупного недопокрытия исключены из inferential gate: test-блоки
  одного split условно зависимы через общий calibration tube. Новый exact gate
  использует одну test-траекторию на каждую независимую calibration-выборку и
  требует одностороннюю 99%-ную Clopper-Pearson lower bound не ниже `0,92` при
  целевом coverage `0,95` и non-inferiority margin `0,03`.
- Обновлённый analyzer проверяет SHA-256 протокола и повторно генерирует траектории,
  tube и scores по seed; согласованного вручную JSON недостаточно для pass.
- Новые locked-серии `20260826/20260827` дали соответственно `380/400` и `379/400`
  покрытий. Aggregate `759/800` имеет coverage `0,94875` и exact 99% LCB `0,927645`,
  поэтому aggregate gate пройден; индивидуальные LCB `0,918599/0,915549` не прошли.
- Агрегированный C6/raw ratio равен `0,784784`, строгих выигрышей `40/48`, exact
  sign-test `p=1,6526e-6`. Полный replay обеих серий прошёл.
- Power-анализ показал, что 400 проб дают лишь `46,8%` мощности при истинном
  coverage `0,95`; для 90% мощности требуется минимум 897 проб на серию.
- Estimator-fed exploratory-серия исключила истинный flux из входов и использовала
  токи, восстановленное напряжение и обработанную encoder-speed. Median sector
  accuracy равна `0,973875`, C6/raw ratio `0,824788`, полный replay прошёл.
- Estimator/oracle volume ratio `6,73e6` показывает, что ошибка наблюдения доминирует
  над oracle residual; estimator-fed coverage `0,955` остаётся описательным и ещё
  не прошло независимый coverage-gate.
- Текущая модель использует точное состояние и сектор истинного потока, поэтому
  C6-BCR evidence относится к one-step oracle-state predictor, не к estimator-fed
  контроллеру.
- Первый вариант по направлению приложенного вектора ухудшил объём в `1,6538`
  раза и сохранён как отрицательный результат.
- При OOD-радиусах `1,75x` покрытие падает примерно до `54%`; произвольный
  distribution shift методом не покрывается.

### C6-ID: модельно-ориентированная идентификация параметров

- В `C:\mic_practice` добавлен активный офлайн-модуль `motor_identification`, а
  не только исследовательский скрипт: JSON/CSV-контракт реальных записей,
  преобразование фазных величин в αβ, SVD/rank-gate, bounded multi-start fit,
  независимый validation, CLI и read-only HTTP API без команд на PWM.
- Контракт требует разные `run_id` для fit/validation, обнаруживает точное
  повторное использование выборок, требует калибровки тока/напряжения/скорости,
  хеш прошивки, равномерный высокочастотный sampling и отдельные standstill,
  free-run и coast эксперименты.
- Программный end-to-end self-test имеет ранг `7/7`, fit NRMSE `1,016`,
  validation NRMSE `0,996` и максимальную относительную ошибку шести оцениваемых
  параметров `1,93%` на независимой синтетической записи.
- Выход совместим с существующим `mic_theory`-загрузчиком параметров; отображение
  наблюдаемого рассеяния фиксировано как `Ls=Lr=Lm+Lsigma`.
- Science-readiness намеренно отклоняет синтетический PASS: требуется свежий
  `accepted=true` результат с `source_kind=hardware`. Поэтому программная
  реализация закончена, но параметры физического двигателя ещё не определены.
- Удалена утечка истинных `J/B` в начальное приближение старого `auto_id`.
- q-напряжение больше не выдается за калиброванный момент: такой канал помечается
  `iq_ref` и не разрешает механическую идентификацию старым методом.
- Односекторный профиль имеет ранг `6/7` и блокируется до оптимизации. Раздельные
  `Lls/Llr` дают ранг `7/8`; используется наблюдаемая комбинация `Lsigma`.
- C6-профиль объединяет многомасштабный standstill, прямой/обратный разгон и
  пятсекундный измеряемый выбег. Совместно оценивается неизвестный `Tload`.
- В сериях `20260820/20260821` использовано по 12 новых двигателей, ±20% скрытого
  разброса рассеяния, неизвестный момент ±`0,005 Н·м`, шум и по 32 PRBS-дизайна.
- C6 получил `log10 det(Fisher)=37,8281` и выиграл `32/32` D-информационных
  сравнений в каждой серии (`p=2,3283e-10`). Ранг равен `7/7`.
- Медианная максимальная ошибка C6 составила `0,558%` и `0,919%`; максимальный
  модельный ток `0,735 А` при лимите `1,75 А`.
- PRBS оказался точнее по конечной ошибке: C6 выиграл только `9/24` пар. Это
  сохраненный отрицательный результат о различии локальной информации и
  устойчивости к structural model mismatch.
- Результат является simulation evidence. Полный отчет: `model_identification/RESEARCH_RU.md`.

## Что выявила перепроверка

Исторический SNH-PWM release использовал `60` шагов по `100 мкс`, то есть только
`6 мс`. Такое окно подходит для smoke-проверки вычислений и коммутационной
безопасности, но недостаточно для вывода о разгоне и ошибке скорости асинхронного
двигателя. Кроме того, случайные реализации ранее последовательно расходовались
разными контроллерами, поэтому сравнение не было строго парным.

Первый парный прогон длиной `0,2 с` выявил OC-защёлки в `dc_sag` и
`sensor_dropout`. Причиной была не только настройка контроллера, но и небезопасный
host fallback: при мягком токовом ограничении шлюз удерживал предыдущий активный
вектор. В rev2 пороги защиты не повышались; добавлены robust current envelope,
барьер в стоимости и переход на ближайший нулевой вектор. Затем токовый риск был
отделён от риска модели, чтобы штатное токовое ограничение не вызывало ложный
OOD-fallback.

Финальный MC30-прогон по всем 31 сценариям не выявил неожиданных критических
отказов. Максимальный ток модели составил `5,652610 А` при неизменном пороге
`i_trip=6,125 А`; сценарий `fault_injection_runtime` ожидаемо вызвал защитную
реакцию. Решение event-trigger во всех сценариях совпало с фактическим применением
обратной связи. Confidence fallback сохранился в `regeneration`, `sensor_delay`,
`sensor_dropout` и `speed_sensor_failure`, что зафиксировано как предупреждение, а
не скрыто как успешный штатный режим.

Относительно текущей настройки FOC-SVM парные 95%-интервалы показали меньшую
ошибку скорости в 26 сценариях, большую в `reverse`, `braking` и `ood`, а в
`overload` и `rr_error` разница статистически неразличима. Дополнительные метрики
тока, коммутаций, пульсаций момента и fallback остаются частью Pareto-компромисса.
Это основание для дальнейшего исследования, но не доказательство универсального
превосходства.

Термин «neural twin» также нужно использовать осторожно. В рабочем контроллере
сейчас действует физическая модель с оценкой остатка и доверия. Обученные веса
остаточной модели присутствуют как отдельное evidence, но ещё не включены в
runtime-контроллер. Поэтому допустима формулировка «physics twin with a neural
cost shaper»; формулировка «обученный нейросетевой двойник в контуре» пока
недоказана.

### Вычислительный контур

На компьютере доступна RTX 5070 с 12 ГБ видеопамяти, но текущая среда
`C:\mic_theory\.venv` содержит CPU-сборку PyTorch, а основной расчёт SNH-PWM
реализован последовательными Python-циклами и не использует tensor/CUDA API.
Поэтому видеокарта в этой ревизии не ускоряет исследование. Вместо фиктивного
«GPU-ускорения» добавлено детерминированное выполнение через процессы. Финальная
серия `31 × 8 × 30 × 2000` завершилась примерно за 240 с на 16 worker-процессах;
её JSON совпал с контрольным расчётом при одинаковых seed. Рациональный следующий шаг — пакетная векторизация модели,
проверка численного совпадения CPU/GPU и только затем CUDA; установка CUDA-сборки
PyTorch без переписывания вычислительного ядра эффекта не даст.

## Научная значимость

Научная значимость MIC AI состоит не в самом применении PPO, LUT, FOC или MPC —
эти элементы известны по отдельности. Значимым результатом проекта является
проверяемая двухуровневая постановка безопасного интеллектуального управления:

1. Для энергоэффективности AI ограничен supervisory-уровнем и корректирует только
   `i_d_ref`, не получая прямого доступа к ключам инвертора.
2. Для исследования прямого AI-PWM введена независимая граница доверия: любой
   предложенный вектор проходит детерминированный шлюз тока, напряжения,
   температуры, минимального импульса, dead-time, watchdog и доверия.
3. Для сравнения вводится единый воспроизводимый протокол: парные возмущения,
   фиксированные seed, машинные acceptance-gates, provenance и явное разделение
   simulation, HIL и bench evidence.
4. Для проверки того, что выигрыш связан не только с AI, добавлен полностью
   не нейросетевой контур: симметрийное сокращение, явное множество моделей,
   tail-risk и автоматический поиск контрпримеров.
5. Для снижения ручного консерватизма предложен C6-BCR: остатки физической модели
   приводятся к каноническому сектору, а единый conformal-score калибрует
   одновременное множество ошибки по состояниям и PWM-тактам.
6. Для определения параметров добавлен identifiability gate: оптимизатор не
   сообщает физические параметры при неполном ранге, а неразличимые и нагрузочные
   компоненты явно учитываются как `Lsigma` и `Tload`.

Таким образом, общий защищаемый научный вклад формулируется как **методика
безопасного включения обучаемого или адаптивного оптимизатора в управление
асинхронным электроприводом с машинно проверяемой границей полномочий и
воспроизводимым межалгоритмическим сравнением**. Новизна SNH-PWM может заявляться
только как проверяемая host-архитектурная комбинация событийной обратной связи,
адаптивной функции стоимости, конечного поиска векторов и fail-closed шлюза.

Отдельный кандидат новизны формулируется точнее: **C6-каноническая
блочно-конформная калибровка множества ошибки конечновыборочной модели
асинхронного FCS-привода, сохраняющая конечновыборочное маргинальное покрытие
целой траектории и уменьшающая секторный геометрический консерватизм**.

Второй предметный кандидат: **идентификационно-гейтированное C6-многомасштабное
возбуждение конечными векторами инвертора с nuisance-параметрами рассеяния и
нагрузки для совместной оценки электрических и механических параметров**. Пока
подтверждена только его D-информативность в синтетической модели; меньшая ошибка
относительно PRBS не подтверждена.

## Чего пока нельзя утверждать

- Что MIC AI уже дал экономию на физическом стенде.
- Что SNH-PWM лучше настроенного FOC, FCS-MPC или DTC.
- Что текущий SNH-PWM готов к MCU, HIL или силовой шине.
- Что C6-RV-PWM является новым в мировой литературе или лучше FOC во всех режимах.
- Что C6-BCR уже доказан как первый в мире, прошёл строгий replication gate,
  сохраняет покрытие при OOD или даёт
  рекурсивную/аппаратную гарантию безопасности.
- Что C6-ID уже определяет параметры физического двигателя, превосходит PRBS по
  точности или разрешает напрямую повторить модельные `48 В` на шине `310 В`.
- Что отсутствие небезопасного примера в неполном falsification является
  доказательством безопасности.
- Что отсутствие сквозного открытия в модели доказывает его отсутствие в драйвере,
  IPM и реальной разводке.
- Что текущая активная LUT в `UNOQ_MOTOR` получена из итогового трёхмоторного
  release: она является отдельной стендовой заготовкой и требует привязки к
  конкретному двигателю.

## Следующий научный эксперимент

1. Зафиксировать паспорт двигателя, схему измерения, калибровки Vbus/токов,
   температуру, нагрузку и версии прошивок.
2. На низком напряжении подтвердить HIL/Saleae safety-gates и WCET.
3. Выполнить парные FOC/MIC серии на одинаковых профилях скорости и нагрузки,
   не менее трёх повторов на точку.
4. Измерять энергию на входе и механическую работу на валу; без измерения работы
   нагрузки нельзя исключить «экономию» из-за недовыработки момента.
5. Публиковать среднее, разброс, доверительный интервал и все отказы, а не только
   лучший прогон.
6. Перенести фиксированную ревизию на целевой Nucleo G431, измерить WCET и jitter,
   затем подтвердить защитные переходы в HIL до подключения силовой шины.
7. Для C6-RV-PWM выполнить MC30, bootstrap и коррекцию множественных сравнений;
   отдельно переработать `braking`.
8. Для C6-BCR сначала добавить дискретный AS5600, offset/Rs correction и low-speed
   observer gate; затем prospectively зафиксировать estimator-fed серии минимум по
   897 независимых calibration/test-проб, проверить другой двигатель без изменения
   score, добавить drift-gate и сравнить WCET на G431.
9. Для C6-ID откалибровать токи/Vbus/энкодер, затем выполнить низковольтные
   standstill, реверсивный и coast-тесты с аппаратным токовым gate; проверить
   найденные параметры на отдельном профиле, не использованном при fit.

## Контекст относительно литературы

FCS-MPC, настройка весов нейросетями, событийное управление и цифровые двойники
уже представлены в литературе по отдельности. Например, нейросетевая оптимизация
весов FCS-MPC экспериментально исследована в работе
[Yao et al., IEEE TPEL, DOI 10.1109/TPEL.2023.3323627](https://doi.org/10.1109/TPEL.2023.3323627),
а event-triggered управление электродвигателем — в
[Zhang et al., 2018](https://doi.org/10.1155/2018/2394535).
Экспериментальный FCS-MPC для асинхронного двигателя также существовал до этой
работы, например
[Finite Control Set-Model Predictive Speed Control for Induction Motors with Optimal Duration](https://doi.org/10.1016/j.ifacol.2017.08.1056).
Поэтому научную новизну нужно доказывать для конкретной интеграции и протокола
безопасности, а не для каждого составляющего блока.

Для C6-BCR границу дополнительно задают общая статистика групповых симметрий
[SymmPI](https://doi.org/10.1093/jrsssb/qkaf022), симметризованная conformal
prediction [eCP](https://arxiv.org/abs/2602.03986) и
[Conformal Reachability](https://arxiv.org/abs/2602.03799). По выполненному
целевому поиску не найден прямой предшественник, который одновременно использует
C6-канонизацию остатка физической модели инвертора, траекторный max-score по
PWM-тактам и split-conformal множество ошибки асинхронного FCS-привода. Это
обосновывает кандидат предметной новизны, но не доказанный мировой приоритет.

Для идентификации границу задают известные методы по напряжениям, токам и
скорости, анализ чувствительности и многочастотная инжекция. Ненаблюдаемый поток
ротора и неразличимые комбинации параметров описаны в
[Alonge et al., 2001](https://doi.org/10.1016/S0967-0661(01)00024-7), а
современный многочастотный динамический тест — в
[IEEE Access, 2024](https://doi.org/10.1109/ACCESS.2024.3467381). Поэтому кандидат
C6-ID относится к конкретной комбинации C6-профиля, rank-gate и nuisance-модели,
а не к идентификации двигателя как таковой.
