11lisov11/mic_practice/output/documents/Марикин_А_Н_и_др_Исследование_прямого_нейроуправления_27_08_2026_скорость_момент_сокращено.docx

УДК 681.518:621.313.333

ИССЛЕДОВАНИЕ ОСОБЕННОСТЕЙ НЕЙРОУПРАВЛЕНИЯ АСИНХРОННЫМ ДВИГАТЕЛЕМ С ОБУЧЕНИЕМ В ЦИФРОВОМ ДВОЙНИКЕ

А. Н. Марикин, А.М. Евстафьев, В. Г. Жемчугов, А. Д. Онофрийчук

Петербургский государственный университет путей сообщения Императора Александра I, Российская Федерация, 190031, Санкт-Петербург, Московский пр., 9

Для цитирования: Марикин А.Н., Евстафьев А.М., Жемчугов В.Г., Онофрийчук А.Д. Исследование особенностей нейроуправления асинхронным двигателем с обучением в цифровом двойнике // Известия Петербургского государственного университета путей сообщения. СПб.: ПГУПС, 2026. – Т. 16, вып. 1. – С. 25–34. DOI:

Аннотация.

Цель: Оценить возможность прямого нейросетевого управления асинхронным электроприводом без полной предварительной идентификации конкретного двигателя и сопоставить MIC с FOC при постоянном задании скорости и изменении момента нагрузки.

Методы: Исследование выполнено на модели системы «инвертор - асинхронный двигатель - регулятор» в среде цифрового двойника. RL-агент обучали формировать управляющие воздействия в d-q координатах, после чего результаты сопоставляли с FOC по среднеквадратичному току статора, активной мощности и ошибке регулирования скорости.

Практическая значимость: Политику предполагается адаптировать к конкретному двигателю по короткому окну измерений и переносить на встроенную платформу, сокращая объём предварительной параметрической идентификации.

Ключевые слова: асинхронный электродвигатель; электропривод; обучение с подкреплением; цифровой двойник; нейросетевое управление; векторное управление.

Для асинхронного электропривода сохраняет актуальность задача одновременного обеспечения точного регулирования скорости, приемлемых динамических свойств и умеренного энергопотребления. На практике она, как правило, решается средствами векторного управления. Однако качество настройки FOC в заметной степени зависит от параметров двигателя и условий его работы, поэтому при их изменении требуется дополнительная корректировка регуляторов [1, 2].

В связи с этим представляет интерес схема, в которой закон управления не задаётся заранее структурой регуляторов, а формируется в процессе обучения агента при взаимодействии с моделью привода. В такой постановке методы обучения с подкреплением позволяют искать управляющие воздействия по критерию, одновременно учитывающему ошибку регулирования и энергетические показатели [3, 4].

Научная новизна состоит в прямом формировании RL-агентом воздействий в d-q координатах без токового каскада PI-регуляторов. Политика обучается на семействе цифровых моделей и адаптируется по короткому окну измерений, поэтому рабочий контур не требует полной идентификации конкретного двигателя.

В отличие от DeepMPC, использующего обучаемую модель в предиктивном контуре [6], MIC непосредственно формирует воздействия на инвертор. Агент обучается методом проб и ошибок по функции вознаграждения [4], что сокращает ручную настройку.

Цель работы состоит в оценке возможности обеспечения прямого нейросетевого управления асинхронным электроприводом для снижения потребления активной мощности по сравнению с FOC без заметного ухудшения качества регулирования скорости. Для этого RL-агент обучали в среде цифрового двойника, после чего анализировали устойчивость сформированной стратегии в типовых режимах и сопоставляли полученные результаты с базовым вариантом векторного управления. Такая постановка позволяет судить о практической применимости метода ещё до перехода к физическому стенду.

На рисунке 1 показан переход MIC (Motor Intelligent Control) от разработки к эксплуатации. Этап 1 (модельный): MIC обучается в среде математической модели АД на наборе режимов и разбросе параметров. Цель этапа – получить устойчивую стартовую политику и отладить процедуру обучения без риска для оборудования, обеспечив переносимость на разные двигатели. Этап 2 (перенос на стенд): MIC переносится на реальный привод (АИН–АД) и выполняется ускоренная адаптация под конкретный двигатель с использованием БЭК (бесконтактного энкодера) как источника обратной связи и средства контроля качества. Цель этапа – быстро подстроить политику к реальным нелинейностям, потерям, насыщению и задержкам, минимизируя число экспериментов. Этап 3 (эксплуатация без БЭК): обучение отключается, энкодер выводится из контура, и MIC управляет АИН без обратной связи по скорости, используя выученный закон управления [5]. Цель этапа – обеспечить работу привода без датчика скорости и снизить требования к измерительной части при сохранении заданного качества управления. В отличие от классической иерархии (скорость – ток – напряжение), здесь нейросеть решает задачу оптимального управления за один шаг.

Рисунок 1 – Схема обучения алгоритма MIC

Прямое обучение на реальном стенде на начальном этапе работы представляется нецелесообразным, поскольку большое число пробных воздействий повышает вероятность аварийных режимов и существенно увеличивает время отладки. Поэтому агент обучался на цифровом двойнике асинхронного двигателя. В этой среде многократно воспроизводились разгон, торможение и установившиеся режимы без риска для оборудования. Функция вознаграждения задавалась по двум основным признакам: ошибке по скорости и уровню потребляемой мощности. Тем самым агент настраивался не только на достижение требуемой скорости, но и на выбор более экономичного режима работы. Использование цифрового двойника позволило рассмотреть большое число эпизодов и получить стратегию, в которой динамические и энергетические требования учитываются одновременно.

Цифровой двойник использовался не только как безопасная среда обучения, но и как инструмент оценки чувствительности алгоритма к изменению параметров привода. В модели варьировали нагрузку, момент инерции и параметры двигателя, после чего проверяли, сохраняется ли работоспособность обученной политики. При переносе алгоритма с модели на физический объект необходимо учитывать эффект sim-to-real, то есть возможное расхождение между поведением цифрового двойника и реального привода. Для уменьшения этого расхождения целесообразно вводить случайный разброс параметров уже на этапе обучения. В таком случае агент взаимодействует не с единственным вариантом модели, а с семейством близких режимов, что обычно повышает устойчивость его поведения при переходе к реальному объекту [8-10].

Для обучения агента использовались современные алгоритмы глубокого RL, предназначенные для задач с непрерывным пространством действий. В частности, применялся метод Twin Delayed DDPG (TD3) и сравнительно – Proximal Policy Optimization (PPO). Эти алгоритмы на каждом шаге симуляции обновляют параметры нейросети агента, стремясь увеличить суммарное дисконтированное вознаграждение за эпизод. Обучение проводилось online – агент взаимодействовал с цифровым двойником в ходе множества эпизодов, постепенно улучшая стратегии.

Эпизоды моделировали стандартные рабочие циклы привода: разгон до требуемой скорости, удержание нагрузки, торможение. По мере накопления опыта агент уменьшал ошибку слежения за скоростью и энергопотребление, приближаясь к оптимальной политике по заданному критерию.

После завершения обучения полученную политику необходимо согласовать с вычислительными ограничениями встроенной платформы. Исходная модель агента, обученная в симуляции, содержит слишком большое число параметров для устойчивого выполнения в реальном времени на микроконтроллере. Поэтому на следующем этапе использовалась дистилляция: компактную сеть обучали воспроизводить действия исходного агента на тех же входных состояниях [7]. Такой приём позволяет уменьшить размер модели без существенной потери качества управления. В итоге формируется облегчённая политика, пригодная для исполнения на встроенном устройстве и сохраняющая основные особенности поведения исходного агента.

Обучение проводится офлайн на более мощном вычислителе, но итоговая инференс-модель приводится к форме, пригодной для микроконтроллера. Такой подход обеспечивает автономность системы MIC: после этапа лабораторного обучения «интеллектуальный» контроллер можно загрузить во встроенный блок управления привода и эксплуатировать подобно обычному частотному преобразователю, без постоянного подключения к внешнему компьютеру.

В MIC RL-агент по измеряемым скорости и токам формирует воздействия на инвертор. Цифровой двойник используется при обучении, а короткое окно измерений — при адаптации к конкретному приводу. После сжатия политика исполняется на встроенной платформе внутри независимых ограничений по току, напряжению, температуре и состояниям силовых ключей.

Сравнение MIC и FOC выполнено при неизменном задании скорости и двух значениях момента нагрузки: 0,5Mном (стадия 0) и 1,0Mном (стадия 1). Оценивались ток статора, активная мощность и ошибка скорости.

Энергетический эффект применения MIC оценивали по временной зависимости активной мощности и сопоставляли с результатами, полученными для FOC. В переходном процессе различие между кривыми оставалось небольшим, однако после выхода в установившийся режим зависимость для MIC располагалась ниже, чем для FOC. На выбранном интервале усреднения снижение активной мощности составило 8,4 %. Этот результат согласуется с уменьшением среднеквадратичного тока статора и показывает, что выигрыш по энергии достигается не за счёт ухудшения регулирования скорости, а вследствие более экономичного режима работы привода в установившемся состоянии.

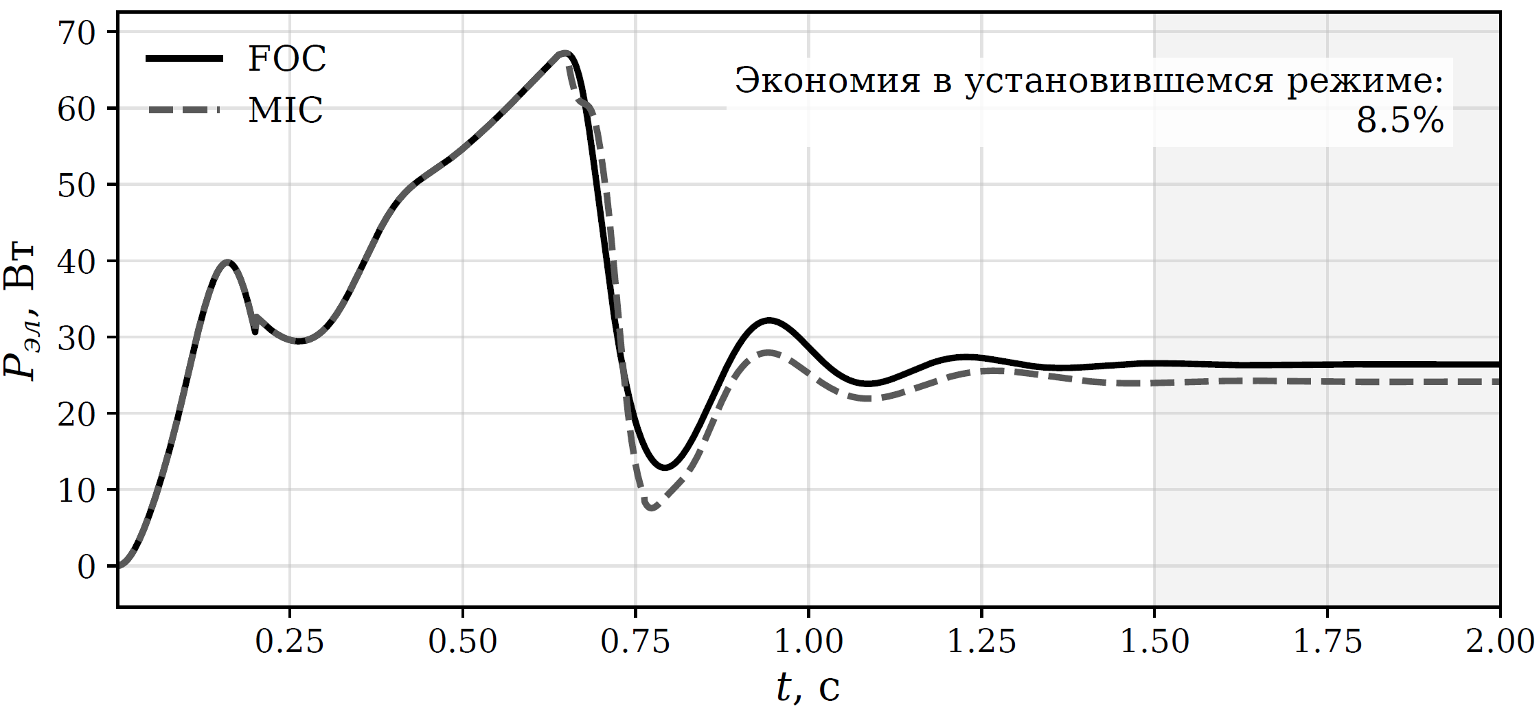
[picture p12: figure]

Рисунок 2 – Сравнение потребляемой электрической мощности при постоянном задании скорости и ступенчатом изменении момента нагрузки

На рисунке 3 представлены рабочие характеристики привода АИР-56 при управлении FOC и MIC.

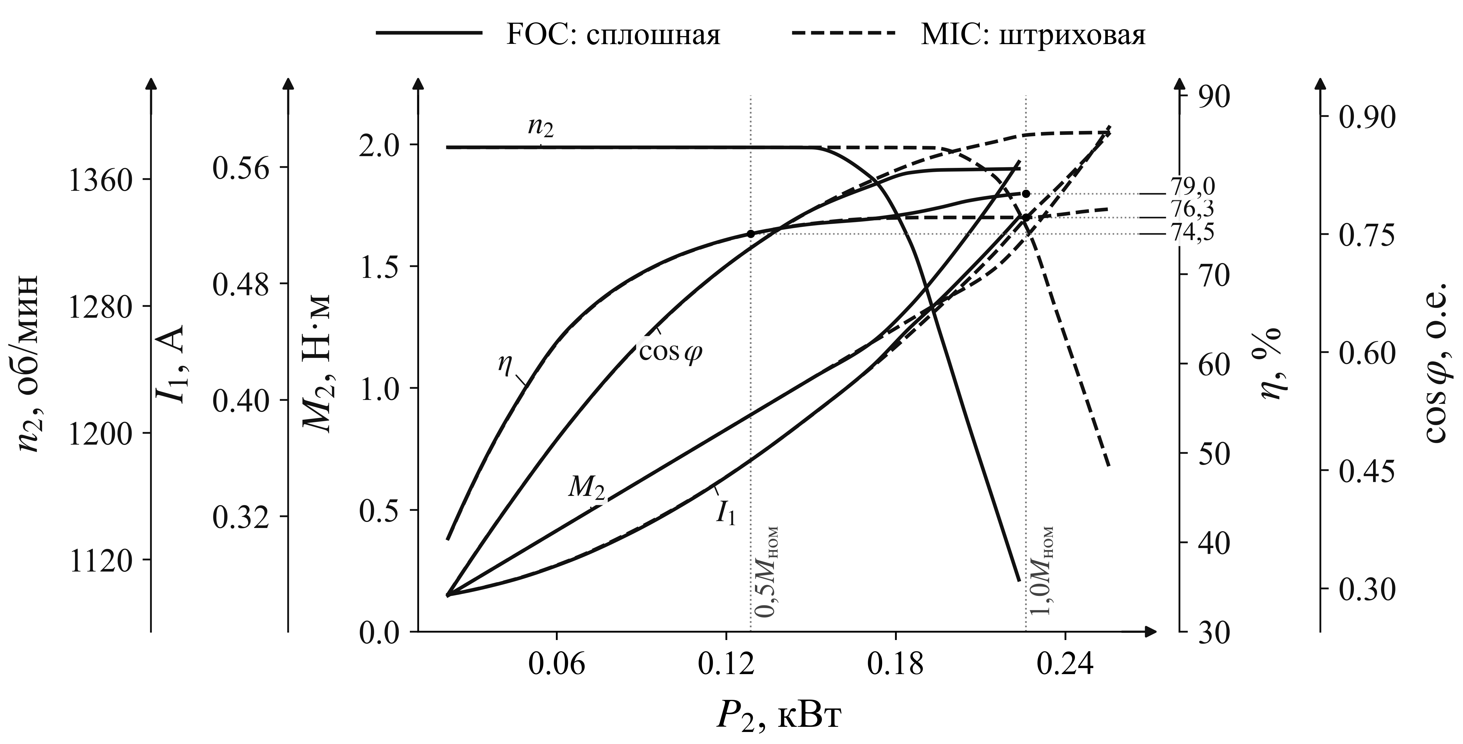
[picture p13: figure]
Рабочие характеристики асинхронного двигателя АИР-56 при FOC и MIC

Рисунок 3 – Рабочие характеристики при одинаковом задании скорости и изменении момента нагрузки

На рисунке 3 стадии 0 и 1 соответствуют нагрузкам 0,5Mном и 1,0Mном при одинаковом задании скорости. В первом режиме стратегии практически совпадают. Во втором MIC повышает скорость и выходную мощность на 10,4 %, но также ток на 7,6 %, входную мощность на 13,3 % и снижает КПД на 2,0 процентного пункта. Поэтому безусловный энергетический выигрыш не подтверждён.

По результатам моделирования могут быть сформулированы следующие выводы.

1. MIC формирует воздействия в d-q координатах; цифровой двойник используется только при обучении.

2. При 0,5Mном различий почти нет; при 1,0Mном ток MIC выше на 7,6 %, поэтому его снижение не подтверждено.

3. Снижение мощности на 8,4 % относится только к интервалу рисунка 2 и не доказывает общую экономию.

4. Энергетический эффект требует одинаковых скорости, момента и выходной мощности, а также повторных опытов.

5. Подход работоспособен и готов к стендовой адаптации с независимой защитой.

Библиографический список

1. Kazemikia D. Reinforcement Learning for Motor Control: A Comprehensive Review [Электронный ресурс] // arXiv preprint. 2024. – URL: https://arxiv.org/abs/2412.17936 (дата обращения: 15.12.2025).

2. Field-Oriented Control of PMSM Using Reinforcement Learning [Электронный ресурс] // MathWorks Motor Control Blockset Example. – URL: https://www.mathworks.com/help/mcb/gs/foc-of-pmsm-using-reinforcement-learning.html (дата обращения: 15.12.2025).

3. Benmalek E., Rayyam M., Gege A. et al. AI-Based Field-Oriented Control for Induction Motors // IAPGOS. 2024. Vol. 14, No. 4. P. 75–81. – URL: https://doi.org/10.35784/iapgos.6253 (дата обращения: 15.12.2025).

4. Saurabh P., Nagabhooshanam N., Kumar D. et al. Enhanced Induction Motor Control Using Deep Reinforcement Learning and PWM with DTC // Electric Power Components and Systems. 2023. Vol. 51, № 12. P. 1083–1095. – URL: https://doi.org/10.1080/15325008.2023.2274357 (дата обращения: 15.12.2025).

5. Abdullah Q., Farah N., Ahmed M. S. et al. Sensorless Speed Control of Induction Motor Drives Using Reinforcement Learning and Self-Tuning Simplified Fuzzy Logic Controller // IEEE Access. 2024. Vol. 12. P. 136485–136501. – URL: https://doi.org/10.1109/ACCESS.2024.3435529 (дата обращения: 15.12.2025).

6. Lenz I., Knepper R., Saxena A. DeepMPC: Learning Deep Latent Features for Model Predictive Control // Proc. of Robotics: Science and Systems. 2015. – URL: https://doi.org/10.15607/RSS.2015.XI.012 (дата обращения: 15.12.2025).

7. Xu Z., Wang J., Xu X. et al. A Survey of Reinforcement Learning-Driven Knowledge Distillation: Techniques, Challenges, and Applications [Электронный ресурс] // Preprints. 2025. – URL: https://doi.org/10.20944/preprints202503.0903.v2 (дата обращения: 15.12.2025).

8. Eschmann J., Albani D., Loianno G. RLtools: A Fast, Portable Deep Reinforcement Learning Library for Continuous Control // Journal of Machine Learning Research. 2024. Vol. 25, № 301. P. 1–19. – URL: https://www.jmlr.org/papers/v25/24-0248.html (дата обращения: 15.12.2025).

9. Szydlo T., Jayaraman P. P., Li Y. et al. TinyRL: Towards Reinforcement Learning on Tiny Embedded Devices // Proc. of the 31st ACM Int. Conf. on Information and Knowledge Management (CIKM). 2022. P. 4985–4988. – URL: https://doi.org/10.1145/3511808.3557206 (дата обращения: 15.12.2025).

10. Mouk Elele M. J., Pau D., Zhuang S., Facchinetti T. Enhancing Field-Oriented Control of Electric Drives with Tiny Neural Network Optimized for Micro-controllers [Электронный ресурс] // arXiv preprint. 2025. – URL: https://arxiv.org/abs/2502.00532 (дата обращения: 15.12.2025).

Дата поступления: 20.01.2026

Решение о публикации: 20.01.2026

Контактная информация

МАРИКИН Александр Николаевич - доктор техн. наук, профессор

ЕВСТАФЬЕВ Андрей Михайлович - доктор техн. наук, профессор

ЖЕМЧУГОВ Валерий Григорьевич - канд. техн. наук, доцент, zhemchugov@pgups.ru

ОНОФРИЙЧУК Андрей Дмитриевич – аспирант, 11lisov11@gmail.com

Study of Direct Neural Control of an Induction Motor Trained in a Digital Twin

A. N. Marikin, A. M. Evstafyev, V. G. Zhemchugov, A. D. Onofriychuk

Emperor Alexander I Petersburg State Transport University, 9, Moskovsky pr., Saint Petersburg, 190031, Russian Federation

For citation: Marikin A.N., Evstafyev A.M., Zhemchugov V.G., Onofriychuk A.D. Study of Direct Neural Control of an Induction Motor Trained in a Digital Twin. Proceedings of Petersburg Transport University, 2026, vol. 16, iss. 1, pp. 25–34. (In Russian) DOI:

Summary
Objective: To compare MIC with FOC at a constant speed reference under changing load torque without complete prior identification of the particular motor. Methods: A digital twin was used; current, active power, and speed error were evaluated at 0.5 and 1.0 rated torque. Practical importance: The policy can be adapted from a short measurement window and deployed on an embedded platform.

Keywords: induction motor; electric drive; reinforcement learning; digital twin; neural network control; field-oriented control.

References

1. Kazemikia D. Reinforcement Learning for Motor Control: A Comprehensive Review // arXiv preprint. 2024. URL: https://arxiv.org/abs/2412.17936 (accessed: 15.12.2025).

2. Field-Oriented Control of PMSM Using Reinforcement Learning // MathWorks Motor Control Blockset Example. – URL: https://www.mathworks.com/help/mcb/gs/foc-of-pmsm-using-reinforcement-learning.html (accessed: 15.12.2025).

3. Benmalek E., Rayyam M., Gege A. et al. AI-Based Field-Oriented Control for Induction Motors // IAPGOS. 2024. Vol. 14, No. 4. P. 75–81. – URL: https://doi.org/10.35784/iapgos.6253 (accessed: 15.12.2025).

4. Saurabh P., Nagabhooshanam N., Kumar D. et al. Enhanced Induction Motor Control Using Deep Reinforcement Learning and PWM with DTC // Electric Power Components and Systems. 2023. Vol. 51, No. 12. P. 1083–1095. – URL: https://doi.org/10.1080/15325008.2023.2274357 (accessed: 15.12.2025).

5. Abdullah Q., Farah N., Ahmed M. S. et al. Sensorless Speed Control of Induction Motor Drives Using Reinforcement Learning and Self-Tuning Simplified Fuzzy Logic Controller // IEEE Access. 2024. Vol. 12. P. 136485–136501. – URL: https://doi.org/10.1109/ACCESS.2024.3435529 (accessed: 15.12.2025).

6. Lenz I., Knepper R., Saxena A. DeepMPC: Learning Deep Latent Features for Model Predictive Control // Proc. of Robotics: Science and Systems. 2015. – URL: https://doi.org/10.15607/RSS.2015.XI.012 (accessed: 15.12.2025).

7. Xu Z., Wang J., Xu X. et al. A Survey of Reinforcement Learning-Driven Knowledge Distillation: Techniques, Challenges, and Applications // Preprints. 2025. – URL: https://doi.org/10.20944/preprints202503.0903.v2 (accessed: 15.12.2025).

8. Eschmann J., Albani D., Loianno G. RLtools: A Fast, Portable Deep Reinforcement Learning Library for Continuous Control // Journal of Machine Learning Research. 2024. Vol. 25, No. 301. P. 1–19. – URL: https://www.jmlr.org/papers/v25/24-0248.html (accessed: 15.12.2025).

9. Szydlo T., Jayaraman P. P., Li Y. et al. TinyRL: Towards Reinforcement Learning on Tiny Embedded Devices // Proc. of the 31st ACM Int. Conf. on Information and Knowledge Management (CIKM). 2022. P. 4985–4988. – URL: https://doi.org/10.1145/3511808.3557206 (accessed: 15.12.2025).

10. Mouk Elele M. J., Pau D., Zhuang S., Facchinetti T. Enhancing Field-Oriented Control of Electric Drives with Tiny Neural Network Optimized for Micro-controllers // arXiv preprint. 2025. URL: https://arxiv.org/abs/2502.00532 (accessed: 15.12.2025).

Received: January 20, 2026
Accepted: January 20, 2026

Author’s information
MARIKIN Alexander Nikolaevich – D.E.S, Professor

EVSTAFYEV Andrey Mihailovich – D.E.S, Professor

ZHEMCHUGOV Valery Grigoryevich - PhD in Engineering, Associate Professor

ONOFRIYCHUK Andrey Dmitrievich – Postgraduate student, 11lisov11@gmail.com
