11lisov11/mic_practice/docs/dissertation_2_9_3/Dissertation_2_9_3_ACIM_AI_working_draft.docx

ФЕДЕРАЛЬНОЕ АГЕНТСТВО ЖЕЛЕЗНОДОРОЖНОГО ТРАНСПОРТА

Федеральное государственное бюджетное образовательное учреждение высшего образования

«ПЕТЕРБУРГСКИЙ ГОСУДАРСТВЕННЫЙ УНИВЕРСИТЕТ ПУТЕЙ СООБЩЕНИЯ ИМПЕРАТОРА АЛЕКСАНДРА I»

На правах рукописи

[ФАМИЛИЯ ИМЯ ОТЧЕСТВО]

ПОВЫШЕНИЕ ЭНЕРГЕТИЧЕСКОЙ ЭФФЕКТИВНОСТИ АСИНХРОННОГО ТЯГОВОГО ЭЛЕКТРОПРИВОДА НА ОСНОВЕ ИНТЕЛЛЕКТУАЛЬНОЙ АДАПТАЦИИ АЛГОРИТМОВ ВЕКТОРНОГО УПРАВЛЕНИЯ

Специальность 2.9.3 — Подвижной состав железных дорог, тяга поездов и электрификация

Диссертация на соискание учёной степени кандидата технических наук

Научный руководитель:
[Ф.И.О., учёная степень, учёное звание]

Санкт-Петербург — 2026

# СТАТУС РУКОПИСИ

Настоящий документ является развёрнутой рабочей редакцией диссертации, подготовленной на основе фактических исходных кодов, конфигураций, каталожного профиля двигателя и результатов программной проверки проекта MIC_AI. Поля с фамилией соискателя, научным руководителем, апробацией, публикациями и актами внедрения оставлены для заполнения после согласования с научным руководителем.

В документе строго разделены три класса доказательств: подтверждённые сборкой и статическими проверками результаты; результаты моделирования на персональном компьютере; будущие стендовые и высоковольтные испытания. Моделирование не выдается за физический эксперимент, а подготовленный образ V/f не считается допуском к силовому пуску до измерения параметров двигателя, проверки предзаряда и аппаратных защит.

Таблица 1 — Статус основных частей исследования

Часть | Статус | Разрешённая формулировка
Скалярное V/f | Прошивка + SIL 48/48 | Кандидат S1; требуется стендовая проверка
Векторное FOC | Encoder-observer SIL 24/24 | Перенос после идентификации двигателя
ИИ-настройка | Policy holdout 600 точек | Расчётный выигрыш; supervisor обязателен
ИИ-ШИМ | Исследовательский прототип | Без утверждения о превосходстве и готовности к MCU

Перед подачей в диссертационный совет рабочая редакция должна быть дополнена протоколами экспериментов, подтверждёнными публикациями по теме, сведениями об апробации, актами внедрения при их наличии и итоговыми выводами, согласованными с научным руководителем.

ОГЛАВЛЕНИЕ

СПИСОК СОКРАЩЕНИЙ И ОБОЗНАЧЕНИЙ 4

ВВЕДЕНИЕ 5

1 АНАЛИЗ МЕТОДОВ УПРАВЛЕНИЯ АСИНХРОННЫМ ТЯГОВЫМ ЭЛЕКТРОПРИВОДОМ 11

1.1 Требования тягового применения 11

1.2 Скалярное управление V/f 12

1.3 Векторное управление и идентификация 13

1.4 Интеллектуальные методы и требования к доказательству 13

1.5 Постановка научной задачи 15

1.6 Выводы по главе 1 15

2 МАТЕМАТИЧЕСКИЕ МОДЕЛИ И КРИТЕРИИ КАЧЕСТВА 17

2.1 Каталожный профиль и расчётная модель двигателя АИР56В2 17

2.2 Модель асинхронной машины в координатах dq 18

2.3 Скалярный закон, номинальная область и ослабление поля 19

2.4 Преобразования Clarke и Park, структура FOC 20

2.5 Пространственно-векторная модуляция и ограничения 21

2.6 Критерии энергетической эффективности и робастности 23

2.7 Граница переноса к тяговому электроприводу 23

2.8 Выводы по главе 2 24

3 ПРОГРАММНО-АППАРАТНАЯ ПЛАТФОРМА И ПРОСЛЕЖИВАЕМОСТЬ 25

3.1 Архитектура стенда 25

3.2 Конфигурация MCSDK и двигателя 26

3.3 Контракт связи UNO Q — Nucleo 27

3.4 Безопасное состояние и аппаратные защиты 29

3.5 Сборка, хэширование и управление конфигурацией 30

3.6 Готовность к расширению 31

3.7 Выводы по главе 3 31

4 КОНЦЕПЦИЯ МЕТОДА ОГРАНИЧЕННОЙ ИНТЕЛЛЕКТУАЛЬНОЙ АДАПТАЦИИ FOC 33

4.1 Иерархическая организация управления 33

4.2 Адаптация параметров модели и регуляторов 34

4.3 Перспективное расширение: горизонтный выбор векторов 35

4.4 Safety Gateway и проверяемые инварианты 35

4.5 Цифровой двойник и цикл обучения 36

4.6 Программа сравнения алгоритмов 38

4.7 Выводы по главе 4 39

5 ПРОГРАММНАЯ ПРОВЕРКА И МЕТОДИКА ЭКСПЕРИМЕНТАЛЬНОГО ИССЛЕДОВАНИЯ 40

5.1 Подтверждённые результаты программной проверки 40

5.2 Результаты воспроизводимого SIL-исследования 41

5.3 Последовательность HIL- и стендовых испытаний 44

5.4 План экспериментов и измерительные каналы 45

5.5 Статистическая обработка 46

5.6 Критерии завершения этапов 47

5.7 Выводы по главе 5 48

ЗАКЛЮЧЕНИЕ 49

СПИСОК ИЛЛЮСТРАТИВНОГО МАТЕРИАЛА 51

СПИСОК ЛИТЕРАТУРЫ 52

ПРИЛОЖЕНИЕ А Каталожный и расчётный профиль двигателя АИР56В2 54

ПРИЛОЖЕНИЕ Б Таблица соединения UART верхнего уровня 55

ПРИЛОЖЕНИЕ В Форма протокола стендового испытания 56

ПРИЛОЖЕНИЕ Г Чек-лист допуска к силовому запуску 57

ПРИЛОЖЕНИЕ Д Матрица трассируемости задач и доказательств 58

# СПИСОК СОКРАЩЕНИЙ И ОБОЗНАЧЕНИЙ

Таблица 2 — Принятые сокращения

Обозначение | Расшифровка
АД | асинхронный двигатель
ВАК | Высшая аттестационная комиссия при Минобрнауки России
ДПТ | дискретное преобразование координат и/или данных
ИИ | искусственный интеллект
КПД | коэффициент полезного действия
МК | микроконтроллер
ПЧ | преобразователь частоты
ШИМ | широтно-импульсная модуляция
ACIM | asynchronous induction motor
FOC | field-oriented control, векторное управление с ориентацией по полю
HIL | hardware-in-the-loop, испытание аппаратуры в замкнутом контуре
MCSDK | STM32 Motor Control Software Development Kit
OCP | аппаратная защита от сверхтока
PI | пропорционально-интегральный регулятор
SVPWM | space-vector pulse-width modulation
UART | асинхронный последовательный интерфейс
V/f | скалярное управление с заданным отношением напряжения к частоте

# ВВЕДЕНИЕ

Актуальность темы исследования определяется необходимостью повышения энергетической эффективности, управляемости и диагностируемости тягового электропривода железнодорожного подвижного состава. Асинхронная машина в сочетании с полупроводниковым преобразователем обладает высокой конструктивной надёжностью, однако фактические потери, динамические качества и устойчивость управления зависят от качества идентификации параметров, структуры регуляторов, закона модуляции и ограничений силовой части. Для транспортного применения особенно важны воспроизводимость алгоритмов, отказобезопасное состояние и возможность доказать границы применимости результата.

Паспорт научной специальности 2.9.3 включает исследования тягового привода и силовых преобразователей, автоматизацию и управление подвижным составом, оценку энергетических потерь, а также компьютерное моделирование и испытания. Разрабатываемый подход соответствует этим направлениям, поскольку связывает модель асинхронного двигателя, микроконтроллерное управление преобразователем, программно-аппаратные защиты и методику сравнительных испытаний [1]. Лабораторный двигатель мощностью 0,25 кВт рассматривается как масштабная исследовательская установка, а не как непосредственный тяговый двигатель.

Степень разработанности темы характеризуется наличием хорошо исследованных законов V/f, векторного управления, прямого управления моментом и прогнозирующего управления [6-12]. Современные работы расширяют классические контуры нейросетевой идентификацией, настройкой регуляторов и оцениванием переменных состояния [13-18]. Вместе с тем публикационная новизна не может сводиться к простой замене PI-регулятора нейронной сетью. Требуется архитектура, в которой обучаемая часть действует в формально ограниченной области, а детерминированный контур реального времени сохраняет приоритет защиты.

Исходная инженерная база исследования включает NUCLEO-G431RB на микроконтроллере семейства STM32G431RBTx, переходную плату X-NUCLEO-IHM09M2, силовой модуль STEVAL-IPM15B, асинхронный двигатель IEK АИР56В2 и вычислительный узел Arduino UNO Q. Для этой конфигурации подготовлена сборка официального примера MCSDK ACIM V/f Open Loop, разработан программный контракт прямого UART внутри общего HOT-домена, сформирован комплект ELF, BIN и HEX и выпущена многостраничная схема соединений. Аппаратный UART-тракт, силовые платы и двигатель ещё не прошли совместные стендовые испытания, поэтому текущий результат является программно проверенным кандидатом.

До появления плат выполнен воспроизводимый SIL-этап: сформирован ансамбль из 256 допустимых вариантов неопределённых параметров, проверены V/f и матрица защит, настроен encoder-observer FOC, исследован независимый sensorless-наблюдатель и проведено парное сравнение стратегий управления на 600 отложенных режимах. Эти результаты уточняют научную гипотезу и сокращают объём будущей отладки, но не заменяют идентификацию параметров и аппаратный эксперимент.

Структура и оформление рабочей редакции приняты с учётом ГОСТ Р 7.0.11-2011 [2], действующего порядка присуждения учёных степеней [3], регламента диссертационного совета ПГУПС [4] и доступного примера защищённой диссертации по тематике подвижного состава [5]. Служебная страница статуса сохраняется только в рабочей редакции и перед официальной подачей удаляется.

Цель работы — разработать и экспериментально проверить метод ограниченной адаптации векторного управления, обеспечивающий статистически подтверждённое снижение удельных энергозатрат относительно настроенного FOC-SVPWM при неухудшении заданных показателей динамики и безопасности в установленном множестве параметрических и режимных возмущений.

Для достижения цели поставлены следующие задачи:

1. выполнить анализ методов управления асинхронным тяговым электроприводом и определить границы применения скалярного, векторного и интеллектуального управления;

2. разработать математическую модель асинхронного двигателя, преобразователя и измерительного тракта, пригодную для идентификации и сравнительного моделирования;

3. подготовить воспроизводимую программную конфигурацию и проект подключения платформы на базе NUCLEO-G431RB, STEVAL-IPM15B, АИР56В2 и UNO Q;

4. реализовать безопасный базовый режим V/f как исходную точку стендовой проверки;

5. разработать метод векторного управления и процедуру идентификации параметров целевого двигателя;

6. разработать метод ограниченной адаптации параметров модели и регуляторов FOC с детерминированной проверкой допустимости каждой коррекции;

7. сформировать программу HIL- и стендовых испытаний, систему метрик и правила статистического сравнения;

8. проверить программные контракты, воспроизводимость сборки и прослеживаемость результатов.

Объект исследования — процессы электромеханического преобразования энергии и управления в асинхронном тяговом электроприводе с автономным инвертором напряжения.

Предмет исследования — закономерности влияния параметрической неопределённости и ограниченной интеллектуальной адаптации модели и регуляторов FOC на энергетические, динамические и защитные показатели электропривода.

Методы исследования включают теорию электрических машин и электропривода, преобразования координат, теорию автоматического управления, численное моделирование, идентификацию параметров, анализ конечного множества состояний инвертора, методы машинного обучения, статическую проверку исходного кода и экспериментальный дизайн.

Научная гипотеза состоит в том, что энергетические и динамические показатели асинхронного привода могут быть улучшены без передачи обучаемому алгоритму неограниченного доступа к ключам инвертора, если разделить систему на детерминированный контур FOC, медленный адаптивный уровень и Safety Gateway, проектирующий каждое интеллектуальное действие на допустимое множество.

К проверяемым элементам научной новизны относятся: метод событийной ограниченной адаптации параметров модели и регуляторов FOC, отличающийся проекцией обновлений на физически допустимое множество и блокировкой адаптации при снижении достоверности идентификации; критерий допустимости интеллектуальной коррекции, совместно учитывающий ошибку регулирования, энергетические потери, коммутационную нагрузку и запас до ограничений; процедура доказательного сравнения адаптивного и базового управления при одинаковых режимах и ограничениях. Окончательные формулировки должны содержать численный эффект, доверительный интервал и область применимости.

Теоретическая значимость работы состоит в формализации условий включения ограниченного адаптивного уровня в детерминированную структуру FOC, определении допустимого множества изменяемых параметров и критериев перехода к базовому управлению при нарушении ограничений, выходе за область идентификации или превышении вычислительного времени.

Практическая значимость состоит в создании платформы, где версия протокола, профиль двигателя и хэши бинарных артефактов фиксируются совместно. Текущий SHA-256 однозначно идентифицирует готовый файл, но полная воспроизводимость происхождения потребует дополнительно хэшировать профиль, исходники, Git commit, версию компилятора и команду сборки. Такой подход снижает риск случайной прошивки неподходящего образа и позволяет постепенно переходить от V/f к FOC и интеллектуальному управлению.

Положения, подлежащие экспериментальной проверке, в рабочей редакции сформулированы как проверяемые утверждения; численные поля заполняются только после стендовой серии:

1. проекция событийного обновления на Θ сохраняет θk∈Θ при θ0∈Θ, а блокировка по информативности, доверию и времени выдержки предотвращает изменение оценки вне разрешённых условий; влияние на удельную энергию составляет [ΔE, CI95] в области [режимы];

2. логически обособленная детерминированная проверка коррекции исключает её применение при нарушении токовых, напряженческих, тепловых и временных ограничений; полнота обнаружения составляет [результат fault-injection];

3. прослеживаемая цепочка профиль—исходники—сборка—манифест—протокол обеспечивает воспроизводимость программной конфигурации с точностью до зафиксированных хэшей и версий;

4. перенос лабораторного результата к тяговой задаче допустим только через модель (2.18)-(2.19), тяговый цикл и ограничения сцепления; численная применимость устанавливается для [серия подвижного состава, цикл].

Достоверность будущих выводов будет обеспечиваться использованием официальной документации компонентов, независимой проверкой программных контрактов, сопоставлением расчётной и измеренной модели, повторными опытами, доверительными интервалами, A/B-сравнением на одинаковых режимах и публикацией отрицательных результатов. На текущем этапе достоверно подтверждены только перечисленные в главе 5 программные проверки.

Апробация и публикации: [заполнить фактическими докладами, статьями из перечня ВАК, свидетельствами о регистрации программ и иными результатами после их появления].

Структура работы. Диссертация включает введение, пять глав, заключение, список литературы и приложения. В первой главе сформулирована научная задача; во второй приведены модели; в третьей описана программно-аппаратная платформа; в четвёртой предложен интеллектуальный метод; в пятой представлены подтверждённые программные результаты и программа эксперимента.

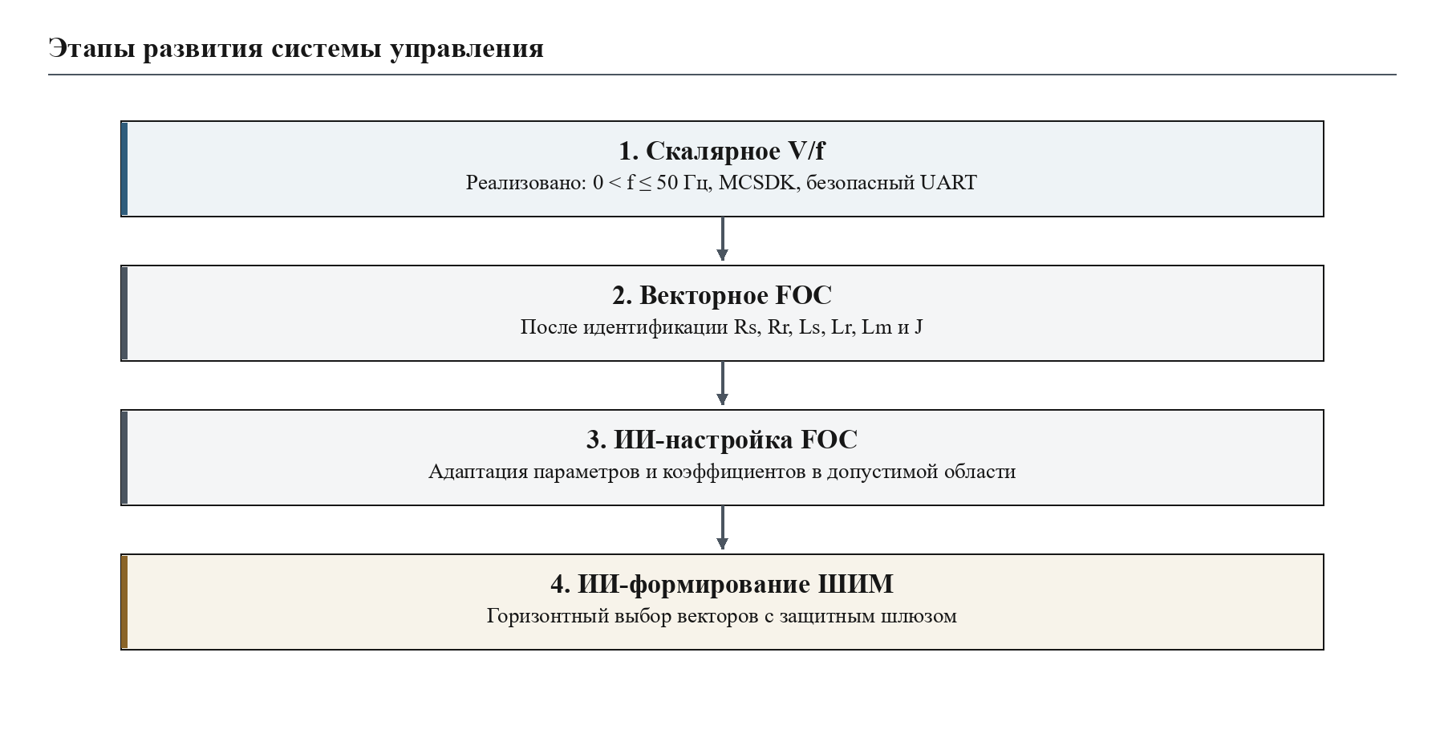
[picture p14: figure]
Рисунок 1 — Логика поэтапного развития исследуемой системы управления

Рисунок 1 — Логика поэтапного развития исследуемой системы управления

Последовательность на рисунке 1 является обязательной логикой получения доказательств. Каждый следующий уровень наследует измеренные ограничения предыдущего: FOC вводится после безопасной проверки силового тракта в режиме V/f; интеллектуальная настройка проверяется относительно устойчивого FOC; интеллектуальное формирование ШИМ допускается только после подтверждения логически обособленного защитного шлюза и аппаратных защит. Поэтому незавершённый аппаратный этап не маскируется результатами компьютерного моделирования следующего уровня.

Рабочая редакция фиксирует исходное состояние исследования и одновременно задаёт проверяемую программу его завершения. После получения стенда расчётные разделы должны быть дополнены протоколами идентификации, осциллограммами, балансом погрешностей и статистикой повторных опытов. Такая организация позволяет обновлять выводы без изменения заранее заявленных критериев качества и исключает выбор метрик после ознакомления с результатом.

# 1 АНАЛИЗ МЕТОДОВ УПРАВЛЕНИЯ АСИНХРОННЫМ ТЯГОВЫМ ЭЛЕКТРОПРИВОДОМ

## 1.1 Требования тягового применения

Тяговый электропривод работает в широком диапазоне скоростей и нагрузок, включая пуск, ограничение сцепления, ослабление поля, выбег, электрическое торможение и воздействие возмущений со стороны контактной сети. Критерий качества не может ограничиваться ошибкой скорости: существенны удельное энергопотребление, потери в меди и стали, пульсации момента, температура полупроводников, число коммутаций, устойчивость к изменению сопротивлений и поведение при отказах датчиков.

Для железнодорожного подвижного состава отказ алгоритма управления может перейти в опасное состояние силовой части. Поэтому обучаемый компонент допустим только при наличии детерминированного ограничения тока, напряжения, температуры, dead-time и последовательности включения. Связь с верхним уровнем не должна быть единственным каналом аварийной остановки. Эти требования определяют архитектуру, в которой UNO Q задаёт ограниченные параметры, а STM32G431 выполняет жёсткий цикл управления и аппаратные защиты.

Лабораторная установка мощностью 0,25 кВт не воспроизводит электромагнитные, тепловые и механические постоянные тягового двигателя в абсолютных единицах. Научно корректное масштабирование должно использовать относительные величины: ток и поток в долях номинальных, электромагнитный момент в долях базового, частоту коммутации относительно электрической постоянной времени, а тепловую нагрузку относительно допустимого нагрева. Вывод о применимости к тяге требует дополнительной проверки на модели соответствующего класса мощности.

Группы показателей и способы их подтверждения сведены в таблицу 1.1.

Таблица 1.1 — Группы требований к системе управления

Группа | Контролируемые показатели | Средство подтверждения
Энергетика | КПД, потери, Udc, ток | Баланс мощности, анализатор
Динамика | Ошибка скорости, момент, время перехода | Осциллограммы и идентичные задания
Качество тока | RMS, спектр, THD | Синхронная выборка токов
Безопасность | OCP, break, E-stop, watchdog | Fault injection, HIL
Воспроизводимость | Версии, хэши, профиль | Автоматизированная сборка

## 1.2 Скалярное управление V/f

Скалярный закон V/f поддерживает приблизительное постоянство магнитного потока за счёт пропорционального изменения амплитуды основной гармоники напряжения при изменении частоты. Его достоинствами являются простота, малое число требуемых параметров и удобство первичного запуска. Именно поэтому V/f выбран первым этапом: он позволяет проверить фазировку, направления, защиту, связь и силовой тракт до ввода чувствительной к параметрам модели FOC.

Недостатки V/f проявляются при низкой скорости, резком изменении нагрузки и необходимости регулировать момент. Падение напряжения на сопротивлении статора и инверторе нарушает пропорциональность потока, поэтому вводится низкочастотная добавка Uboost. Без обратной связи скольжение определяется нагрузкой и температура ротора влияет на рабочую точку. Следовательно, V/f является базовой линией сравнения, но не конечным способом высокодинамичного тягового управления.

В текущем проекте команда START задаёт частоту статора в диапазоне 0 < f ≤ 50 Гц. Нулевая частота реализуется командами STOP/OFF и не является допустимым заданием запуска. Поле амплитуды в UART-кадре сохранено для совместимости, но Nucleo его игнорирует: профиль V/f формируется средствами MCSDK. Это исключает возможность обхода паспорта двигателя произвольным коэффициентом, поступившим с верхнего уровня.

## 1.3 Векторное управление и идентификация

Векторное управление преобразует измеренные фазные токи в систему координат, связанную с оцененным потокосцеплением. Компонента тока по оси d регулирует поток, а компонента по оси q — электромагнитный момент. При корректной ориентации достигается приближённое развязывание каналов, аналогичное независимому управлению возбуждением и моментом машины постоянного тока [7-10].

Качество FOC зависит от сопротивлений статора и ротора, взаимной и рассеяющих индуктивностей, параметров датчиков и задержек вычисления. Сопротивление ротора заметно меняется при нагреве, а неточная взаимная индуктивность искажает оценку потока. Для предварительной V/f-конфигурации принятых каталожных данных достаточно, но для FOC их недостаточно. Параметры Rs, Rr, Lls, Llr, Lm и момент инерции должны быть измерены и помещены в версионируемый профиль.

Идентификация должна выполняться до высоковольтного пуска или в безопасной процедуре с ограниченным напряжением и током. Результат следует проверять не только по совпадению одного переходного процесса, но и на нескольких частотах и уровнях нагрузки. Неопределённость параметров становится входом для последующей интеллектуальной адаптации, а не скрывается подбором коэффициентов.

## 1.4 Интеллектуальные методы и требования к доказательству

Нейросетевые и адаптивные методы применяются для оценивания скорости, идентификации параметров, настройки регуляторов и непосредственного выбора управляющего воздействия [13-17]. Их потенциальное преимущество связано со способностью аппроксимировать нелинейные зависимости и учитывать контекст режима. Одновременно возникают риски поведения вне обучающей выборки, вычислительной недетерминированности и отсутствия физической интерпретируемости.

Научное сравнение должно включать сильные классические базовые алгоритмы: настроенный FOC-SVPWM, DTC, DTC-SVM, одношаговый FCS-MPC и регулятор тока конечного времени. Сравнение с заведомо слабой реализацией не подтверждает новизну. Для каждого алгоритма фиксируются ограничения тока и напряжения, частота дискретизации, вычислительный бюджет и процедура настройки.

В проекте имеется архивный host-прототип Safe Neural Horizon PWM. Он объединяет модельный прогноз, нейросетевую коррекцию стоимости, конечный поиск векторов и защитный шлюз. Прототип прошёл программную матрицу из 31 сценария, но не переносился на MCU, HIL или физический стенд. Поэтому его данные используются для формирования гипотез и программы исследования, а не как доказательство превосходства.

Сопоставление основных групп методов, доступных доказательств и ограничений приведено в таблице 1.2. Оно показывает, что исследовательский разрыв связан не с отсутствием ещё одного регулятора, а с недостатком прослеживаемых ограничений, тяговых сценариев и статистически доказанного выигрыша адаптации.

Таблица 1.2 — Критический обзор методов управления и адаптации

Подход | Подтверждённые достоинства | Ограничение для настоящей работы
V/f [6, 7] | Простота, малая параметрическая чувствительность | Низкая точность момента и низкоскоростных режимов
FOC [8-11] | Раздельное управление потоком и моментом | Зависимость от Rs, Rr, Lm и оценки состояния
DTC, FCS-MPC [12] | Быстрый отклик и явный выбор состояния | Пульсации, вычислительная стоимость, настройка стоимости
Нейросетевая идентификация [13, 14, 16, 17] | Аппроксимация нелинейностей и дрейфа | OOD-риск и недостаток детерминированных ограничений
Архивный SNH-PWM | Воспроизводимый host-прототип и fault-сценарии | Нет MCU, HIL и физической верификации

## 1.5 Постановка научной задачи

Требуется разработать и экспериментально проверить метод, который сохраняет детерминированную основу FOC, допускает адаптацию к нагреву и неопределённости параметров и обеспечивает статистически подтверждаемое снижение удельных энергозатрат при неухудшении заданных показателей динамики и безопасности в установленном множестве возмущений. Интеллектуальный уровень не должен формировать необработанные сигналы ключей, пока действие не прошло детерминированную проверку допустимости.

| min J = wₑEloss + wₙeₙ² + wᵢ||eᵢ||² + wₜrₜ + wₛwNₛw + wₛPₛ | (1.1)

Здесь Eloss — энергия потерь или её заранее определённый измеримый прокси, eₙ — ошибка скорости, eᵢ — ошибка токов, rₜ — показатель пульсации момента, Nₛw — число переключений, Pₛ — штраф за приближение к ограничениям. Робастность определяется как сохранение ограничений и допустимого качества во всём заданном множестве вариаций Rs, Rr, Lm, нагрузки, Udc и измерительных ошибок. Весовые коэффициенты и множество возмущений фиксируются до испытаний.

## 1.6 Выводы по главе 1

Выполненный анализ позволяет сформулировать следующие результаты первой главы:

1. скалярный режим V/f принят как обязательная базовая линия, обеспечивающая проверку фазировки, измерительных каналов и защит при минимальном числе неизвестных параметров;

2. векторное управление выбрано детерминированной основой перспективной системы, поскольку оно разделяет управление потокосцеплением и моментом и допускает формальное ограничение внутренних контуров;
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
