11lisov11/mic_practice/artifacts/active_probe_pilot_20260909_rev2/active_trace.png

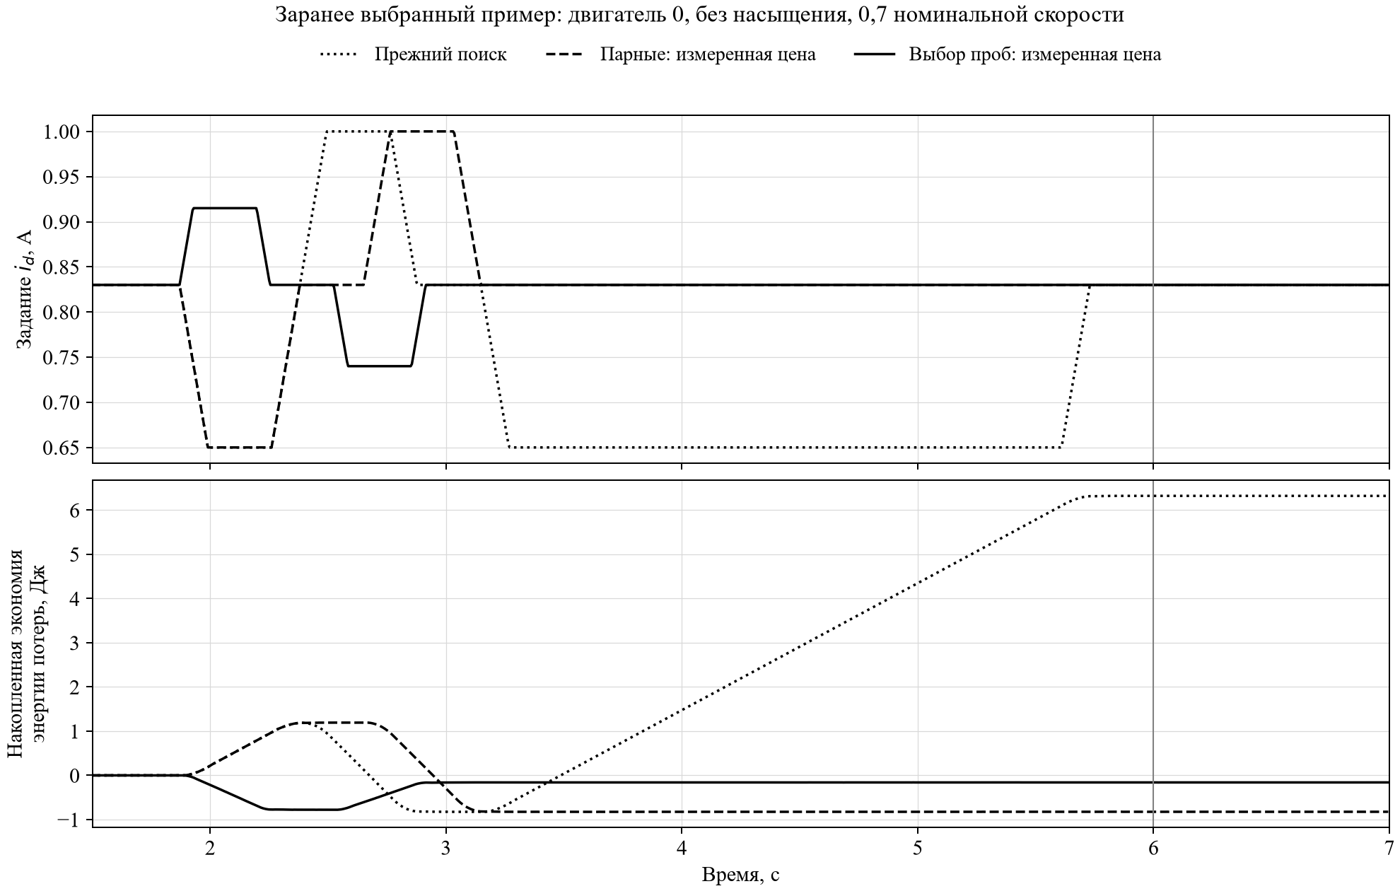
artifacts/active_probe_pilot_20260909_rev2/active_trace.png
