11lisov11/mic_practice/artifacts/active_probe_smoke_20260909/active_all_cases.png

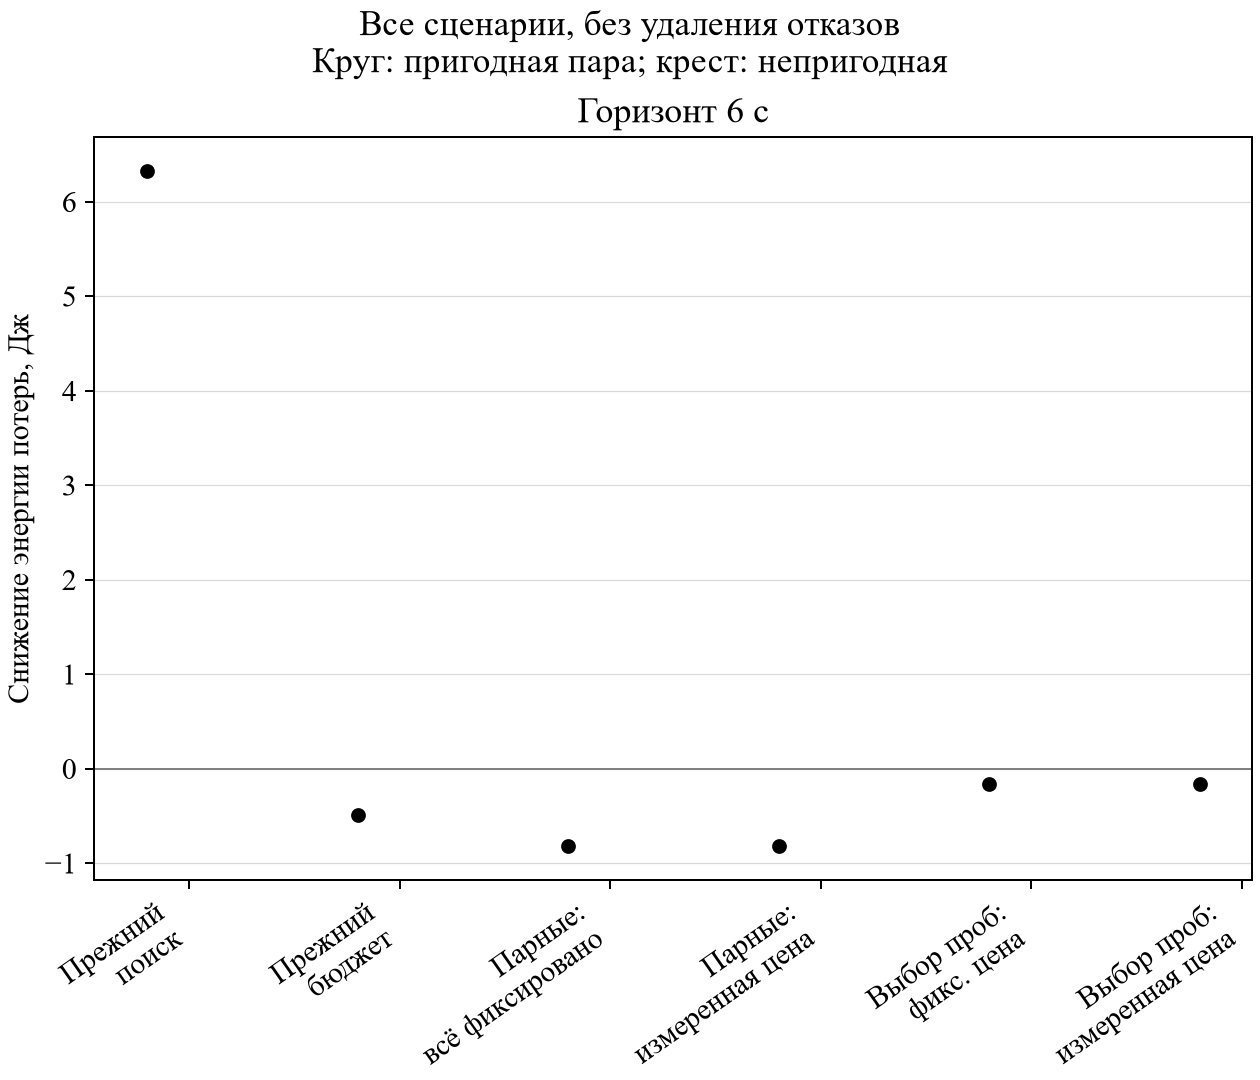
artifacts/active_probe_smoke_20260909/active_all_cases.png
