11lisov11/mic_practice/artifacts/current_pwm_20261007/capture_r3/oscillogram.png

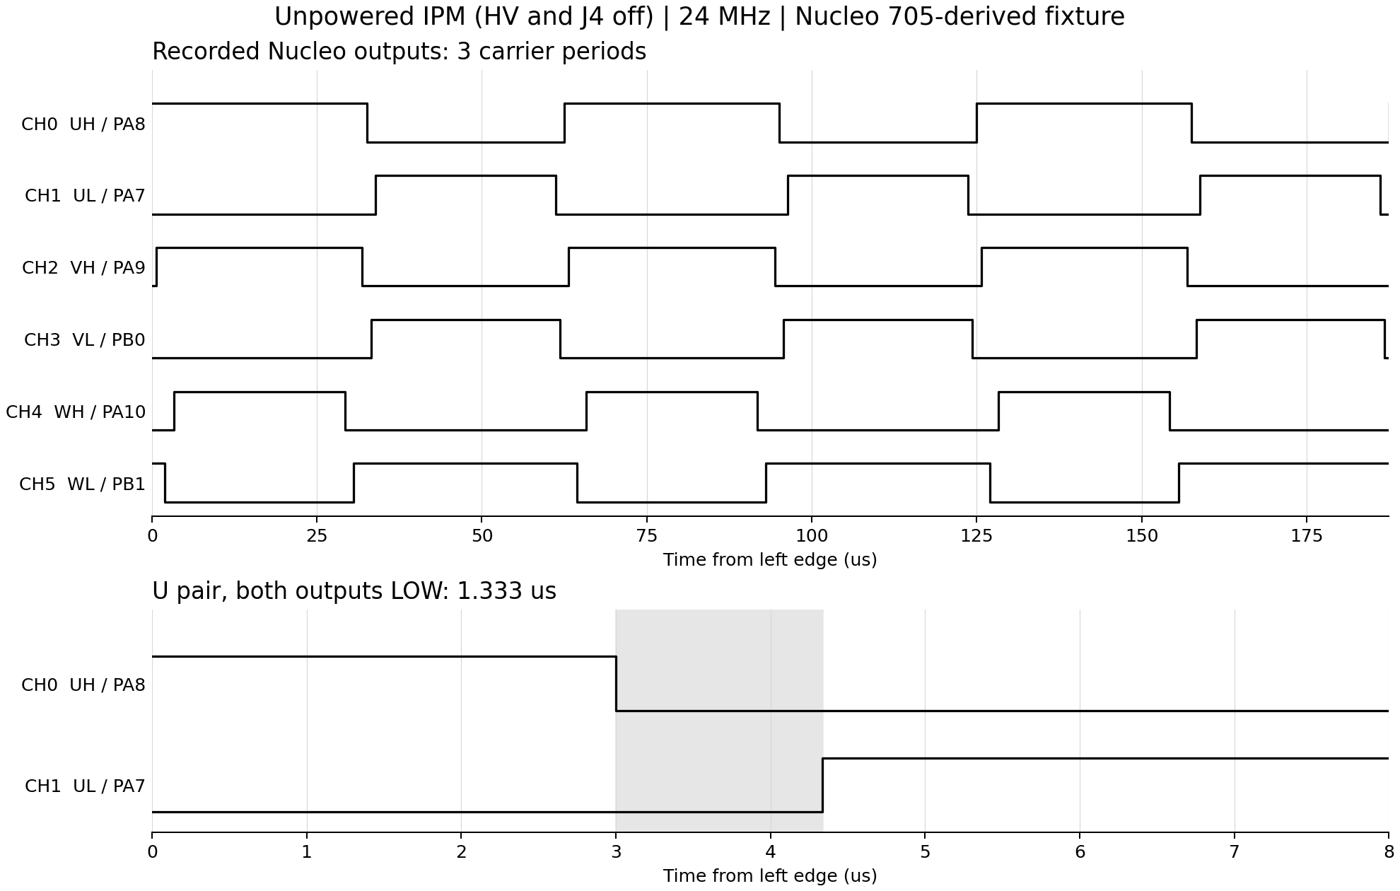
artifacts/current_pwm_20261007/capture_r3/oscillogram.png
