11lisov11/mic_practice/artifacts/energy_value_development_20260909_rev3/energy_value_trace.png

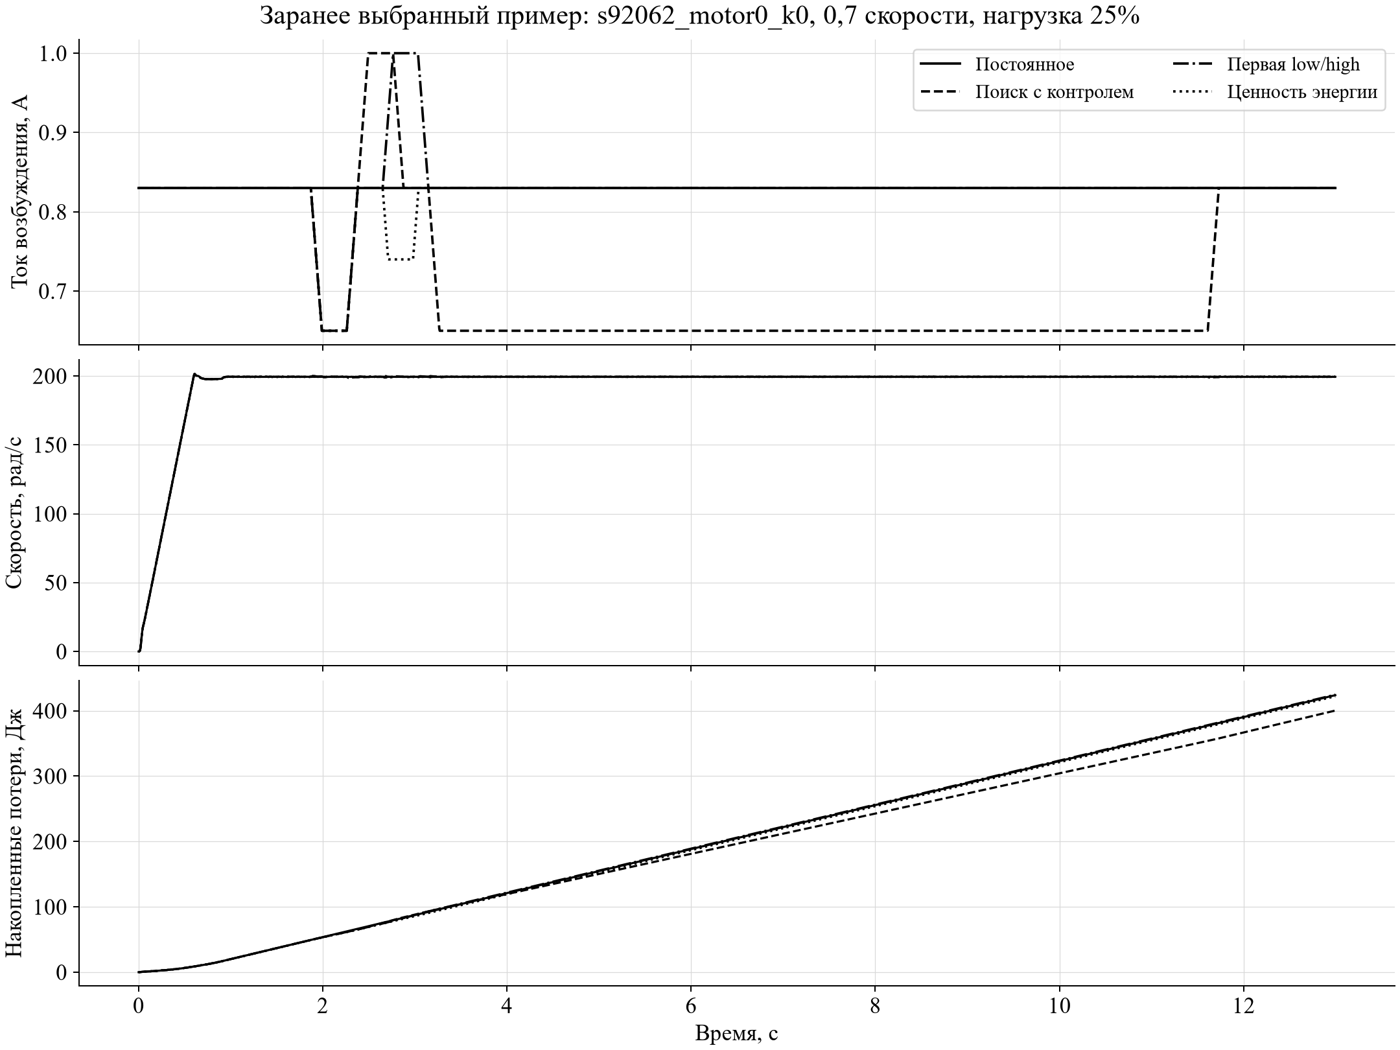
artifacts/energy_value_development_20260909_rev3/energy_value_trace.png
