11lisov11/mic_practice/artifacts/power_stage_audit_20261006/um2014_page7.png

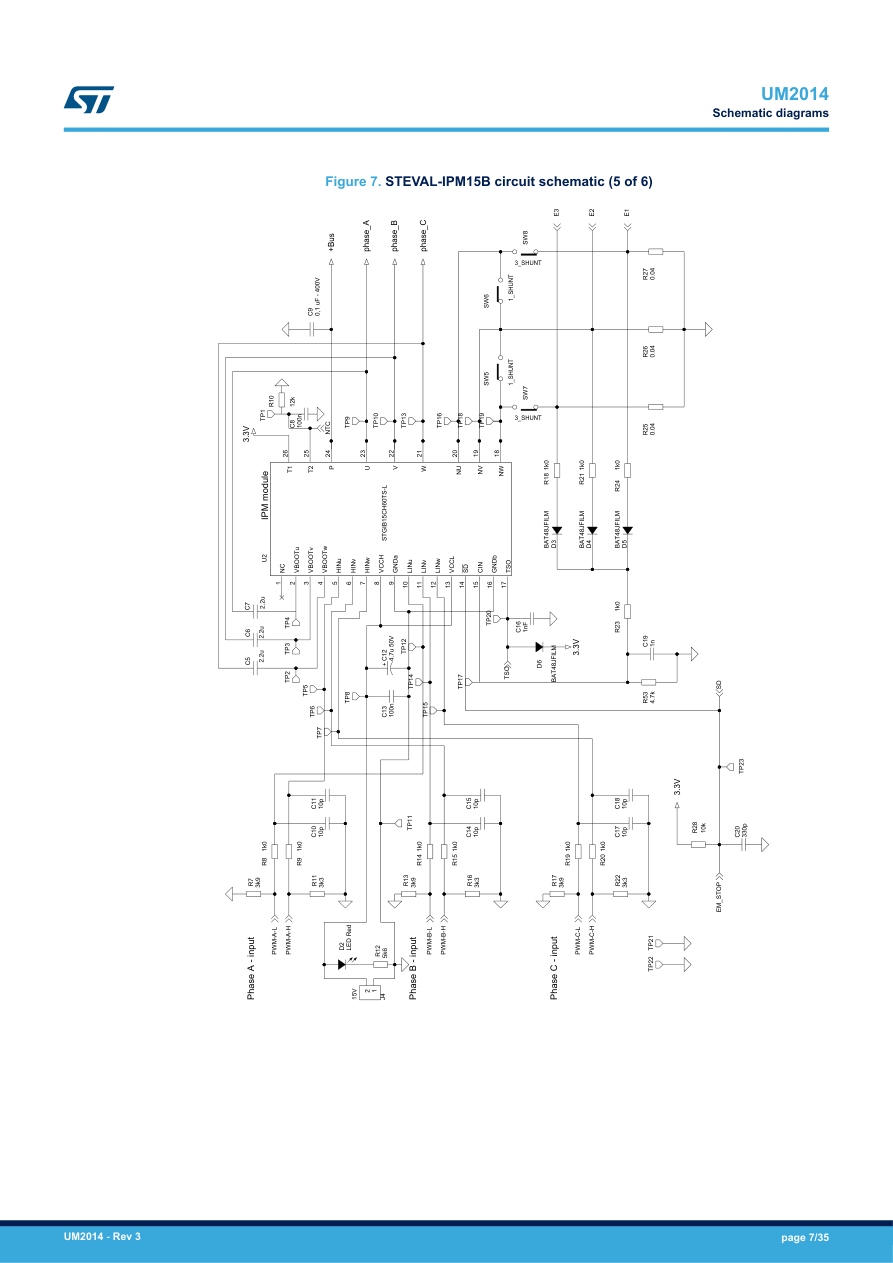
artifacts/power_stage_audit_20261006/um2014_page7.png
