11lisov11/mic_practice/artifacts/probe_budget_pilot_20260909_rev2/budget_all_cases.png

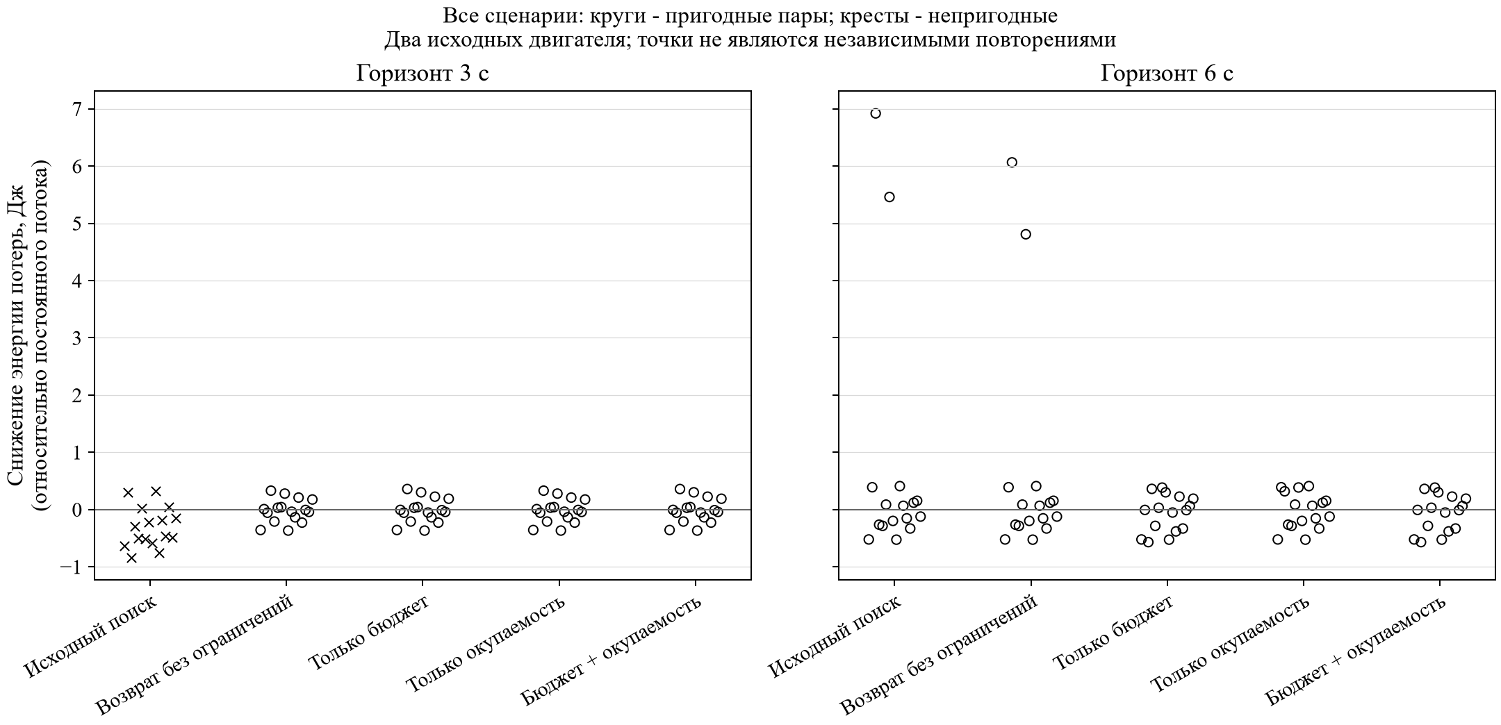
artifacts/probe_budget_pilot_20260909_rev2/budget_all_cases.png
