11lisov11/mic_practice/docs/dissertation_2_9_3/figures/fig03_vf_curve.png

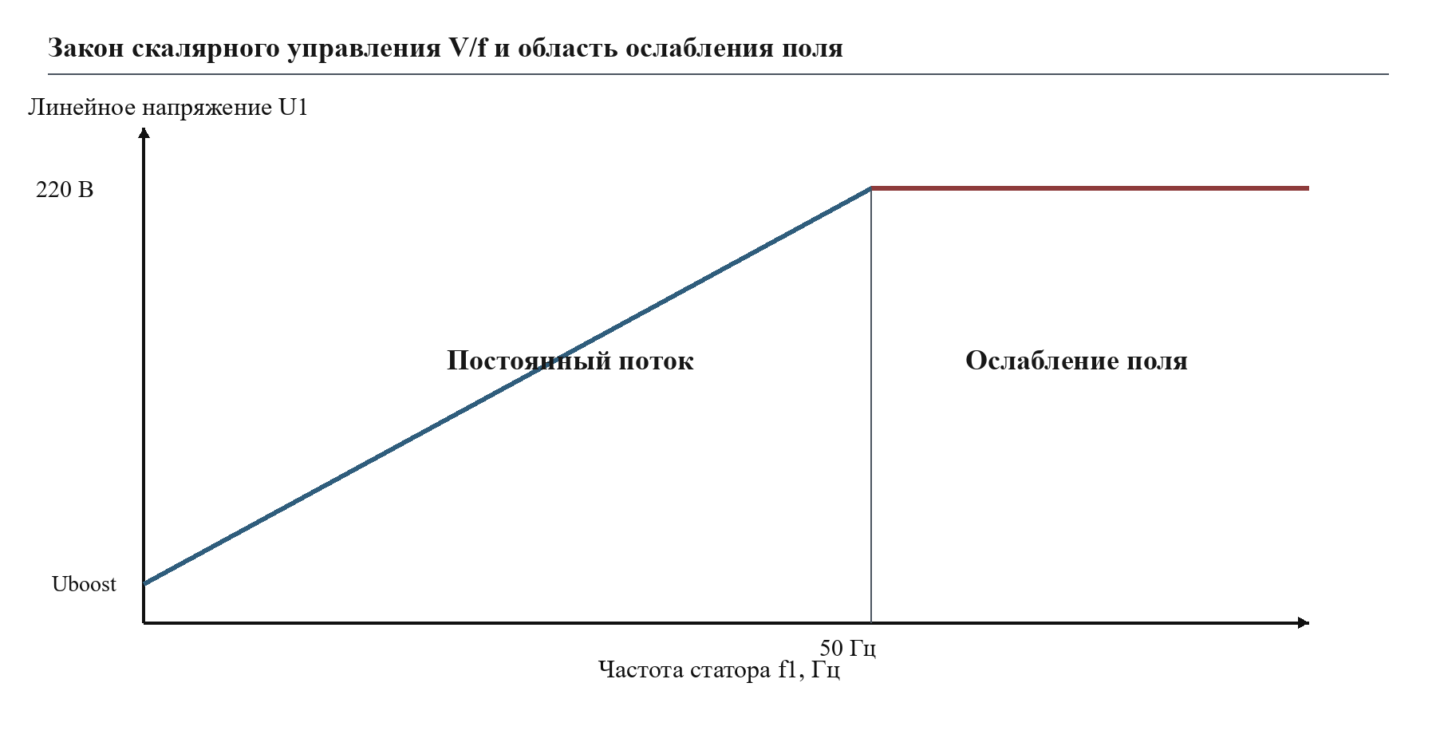
docs/dissertation_2_9_3/figures/fig03_vf_curve.png
