11lisov11/mic_practice/docs/dissertation_2_9_3/figures/fig08_states.png

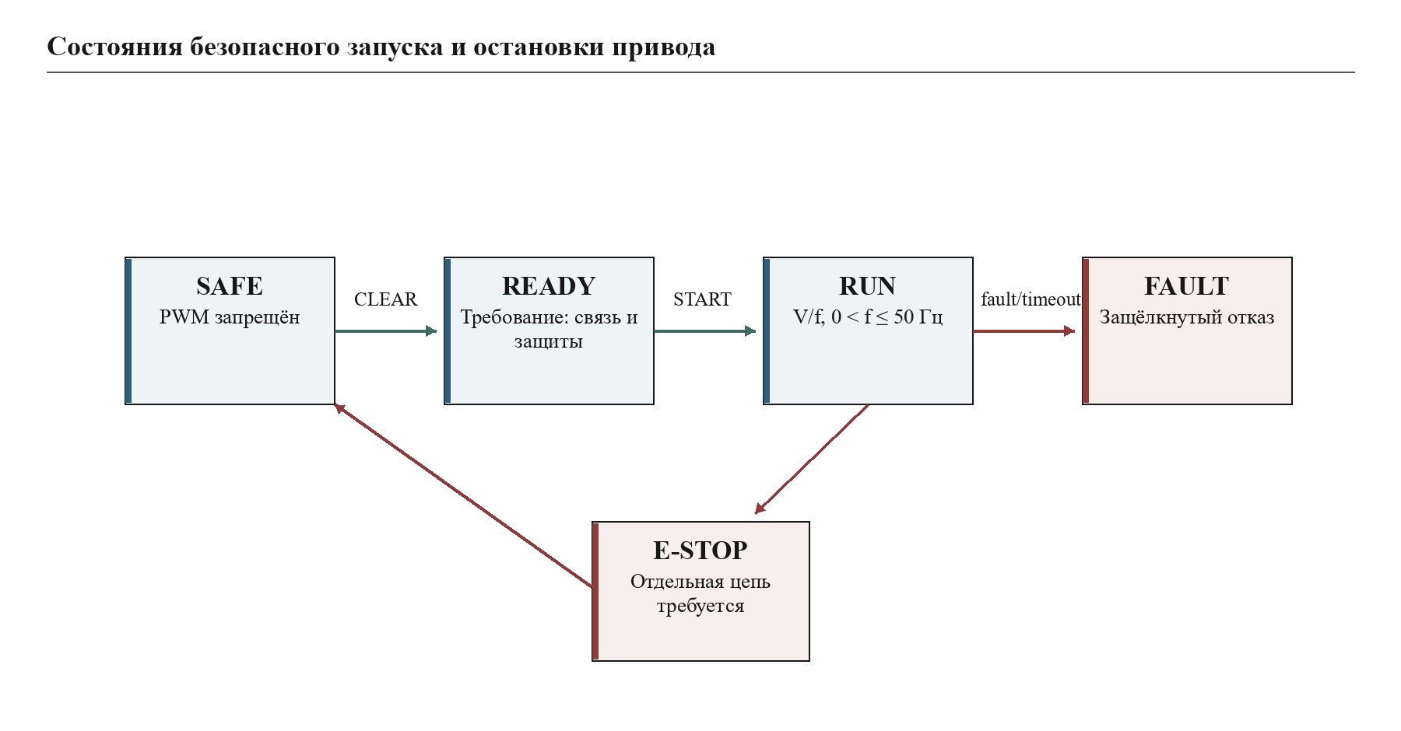
docs/dissertation_2_9_3/figures/fig08_states.png
