11lisov11/mic_practice/docs/dissertation_2_9_3/figures/fig10_ai_pipeline.png

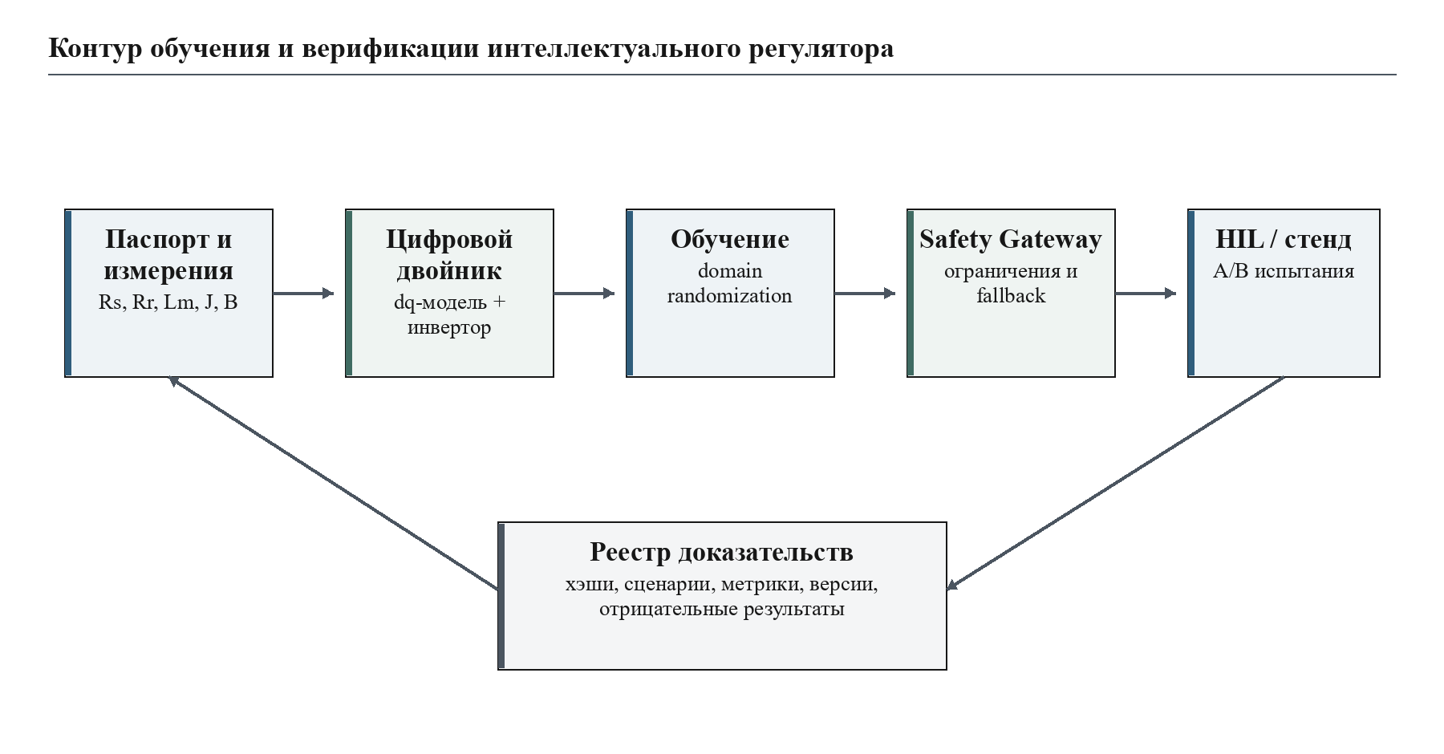
docs/dissertation_2_9_3/figures/fig10_ai_pipeline.png
