11lisov11/mic_practice/docs/dissertation_2_9_3/figures/fig12_evidence.png

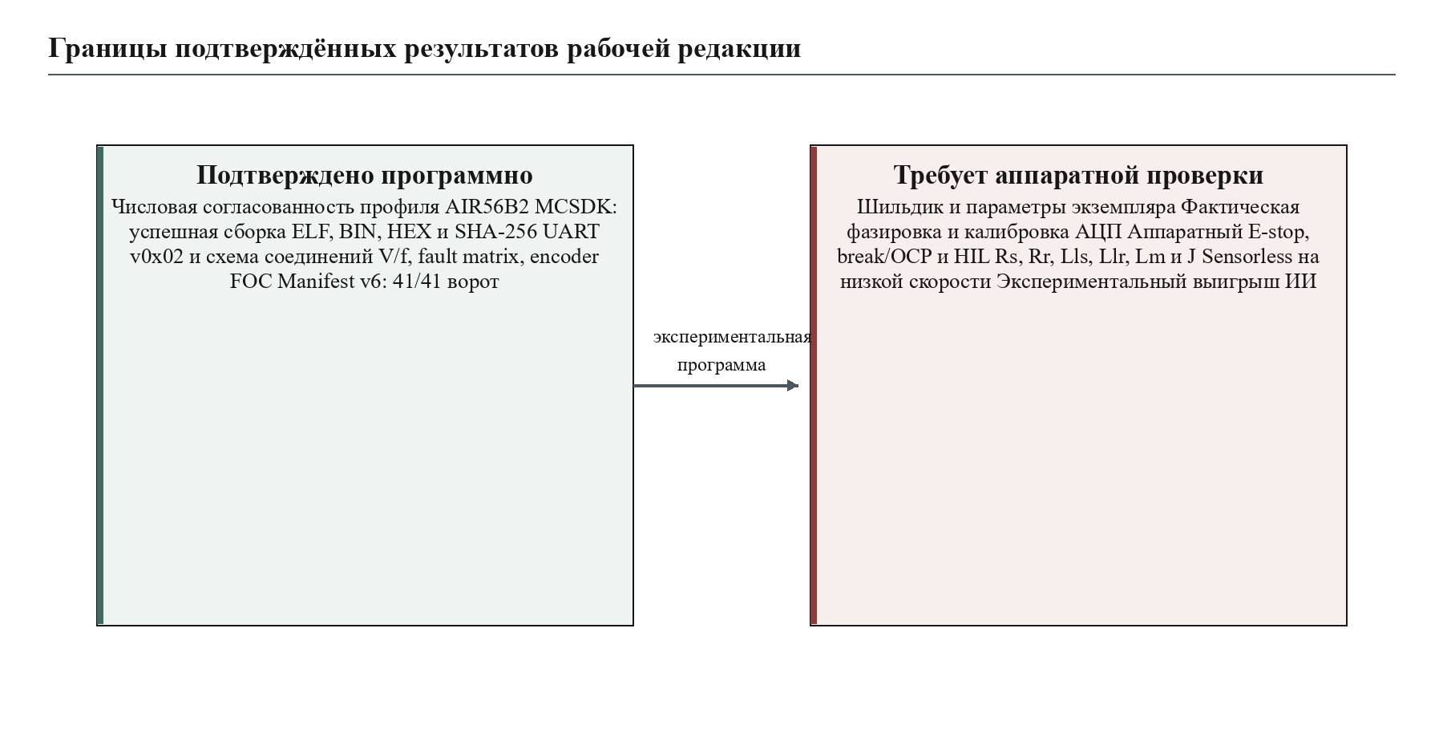
docs/dissertation_2_9_3/figures/fig12_evidence.png
