11lisov11/mic_practice/output/documents/air56b2_report_assets/pipeline.png

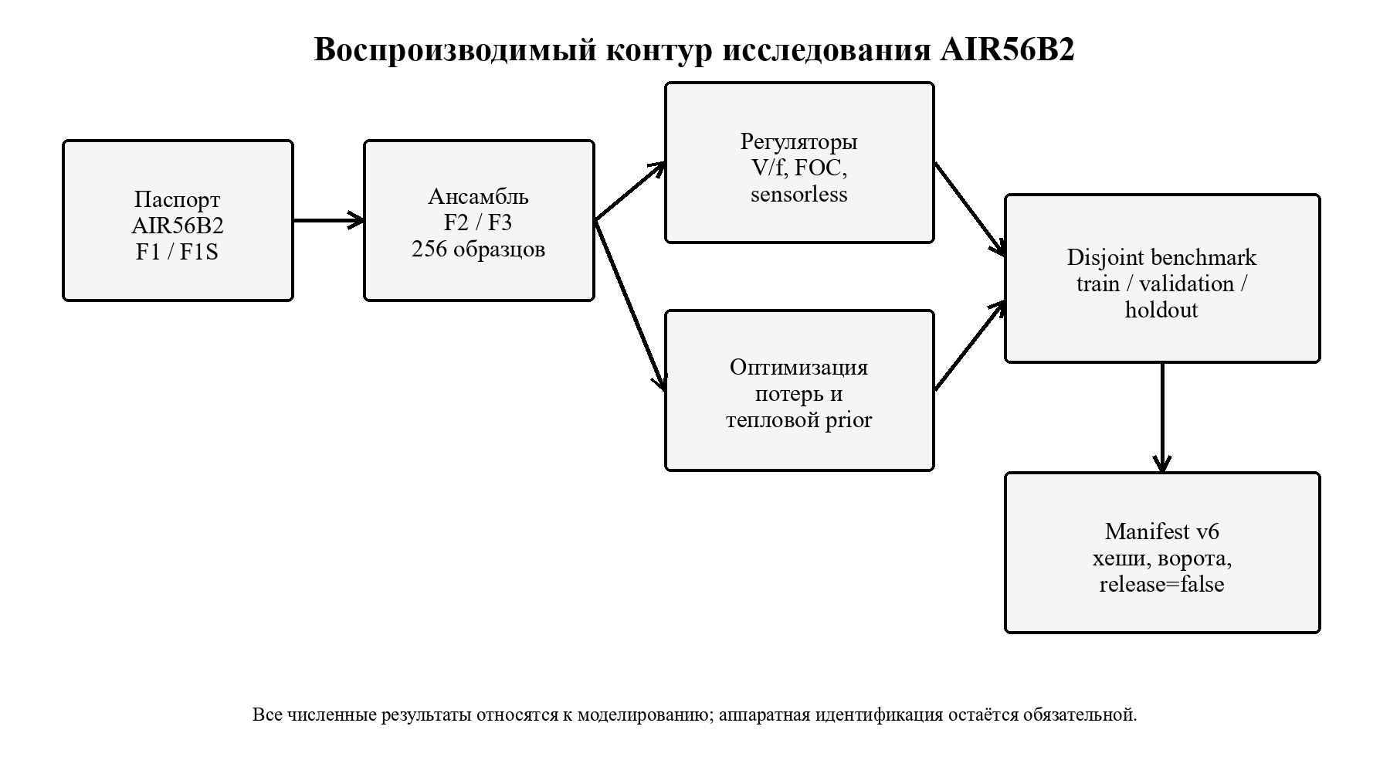
output/documents/air56b2_report_assets/pipeline.png
