11lisov11/mic_practice/output/documents/air56b2_report_assets/policy_holdout.png

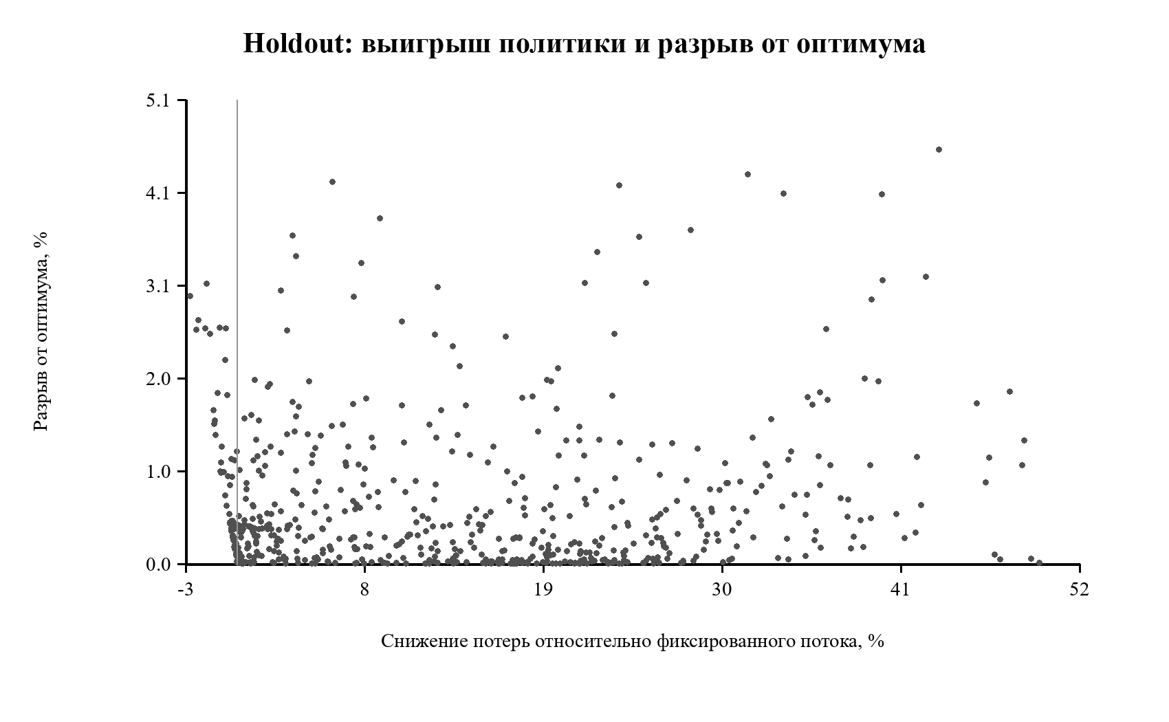
output/documents/air56b2_report_assets/policy_holdout.png
