11lisov11/mic_practice/output/figures/dynamic_power_adaptation_20260908/dynamic_probe_energy.png

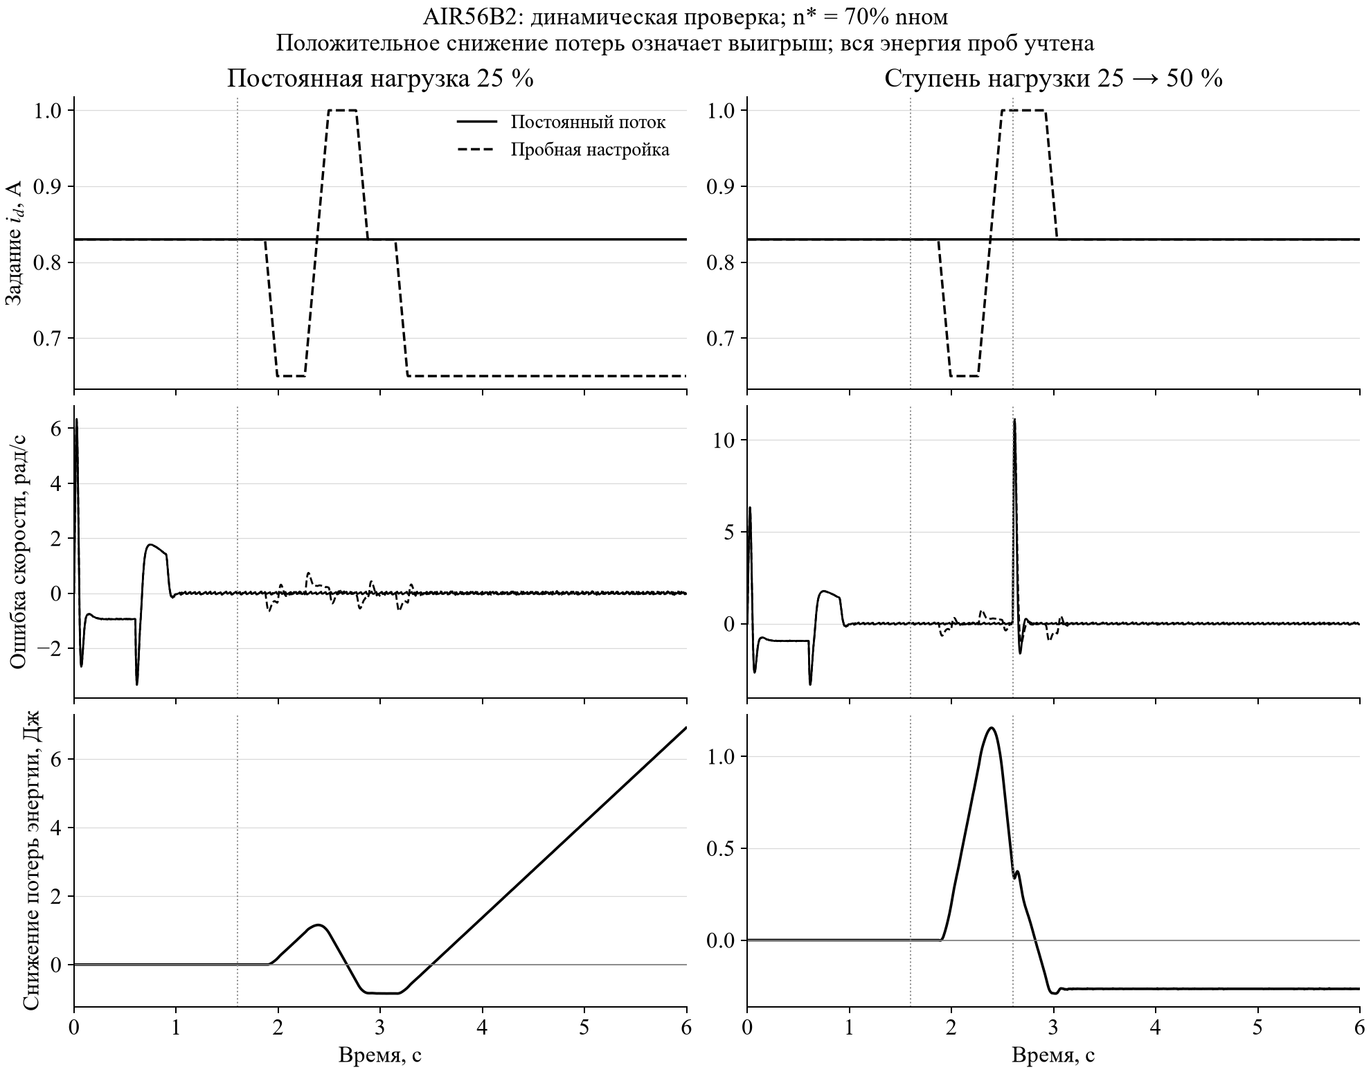
output/figures/dynamic_power_adaptation_20260908/dynamic_probe_energy.png
