11lisov11/mic_practice/output/figures/dynamic_power_adaptation_20260908/pdf_render_check.png

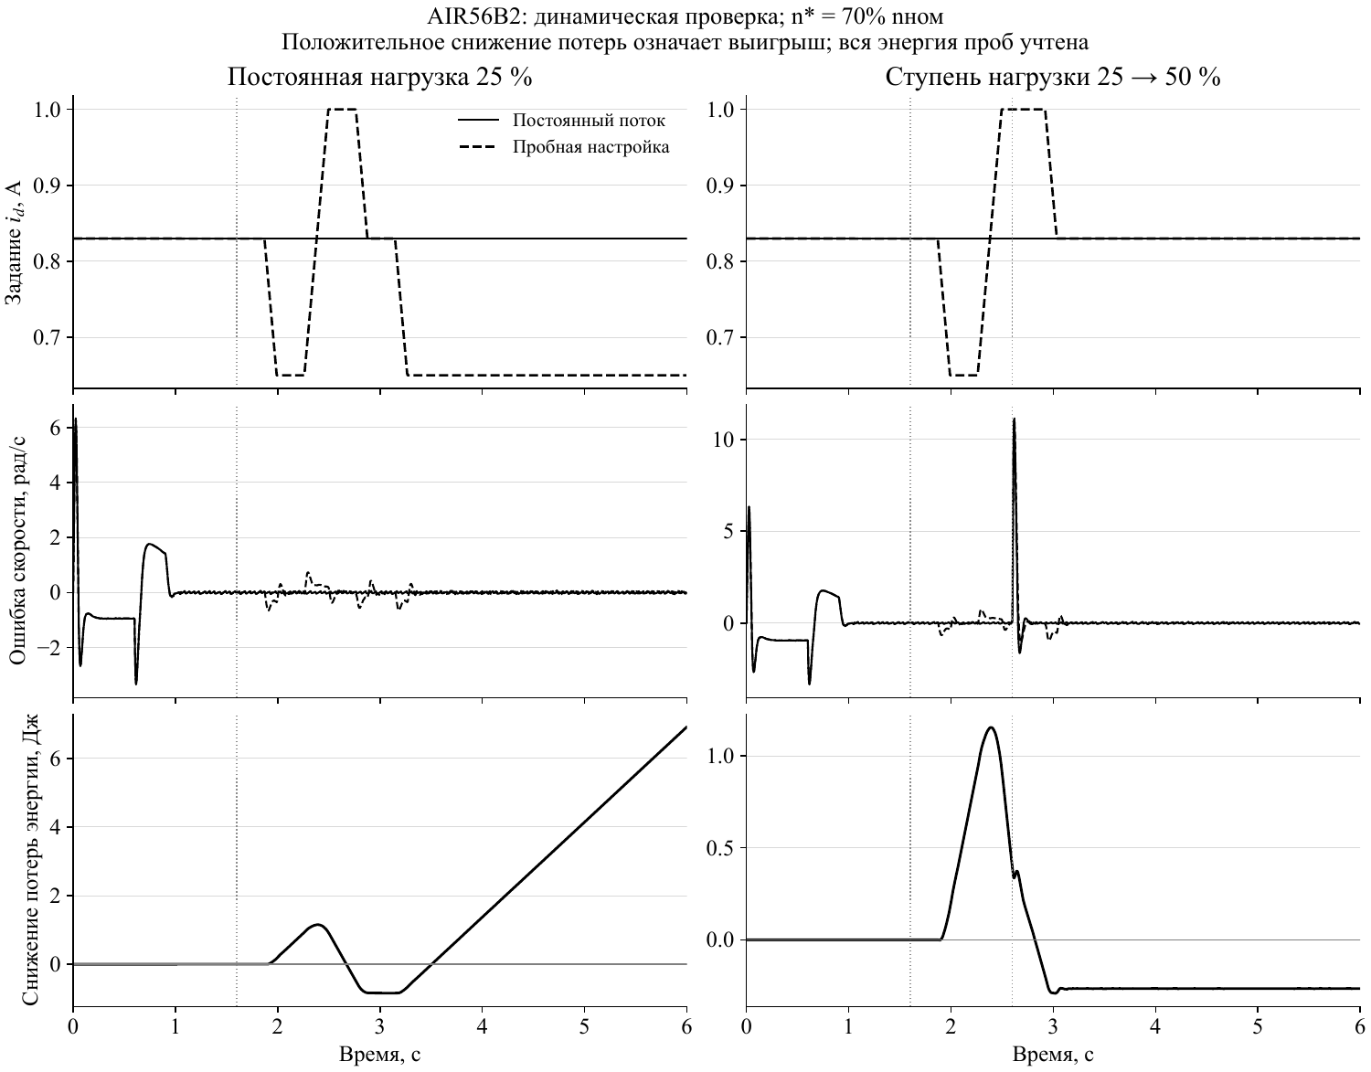
output/figures/dynamic_power_adaptation_20260908/pdf_render_check.png
