11lisov11/mic_practice/output/playwright/fault_diagnostics_20261007/uart_ore_1440.png

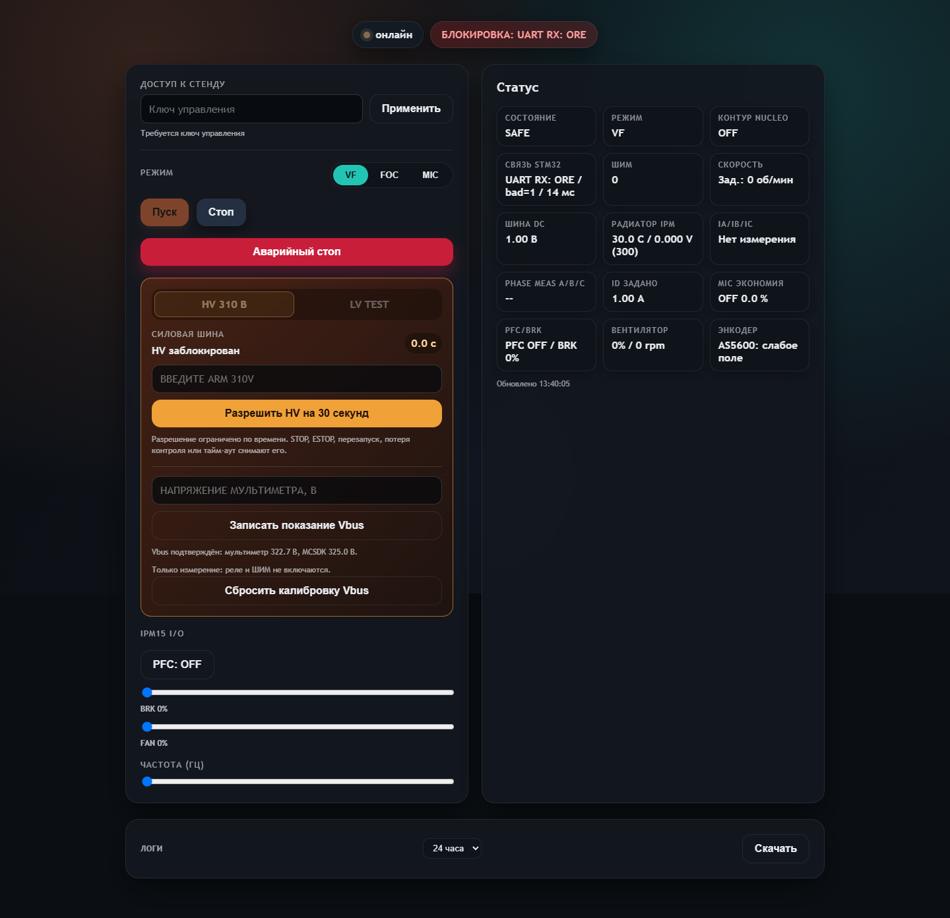
output/playwright/fault_diagnostics_20261007/uart_ore_1440.png
