11lisov11/mic_practice/output/playwright/frequency_setpoint_20261007/setpoint_20_1440.png

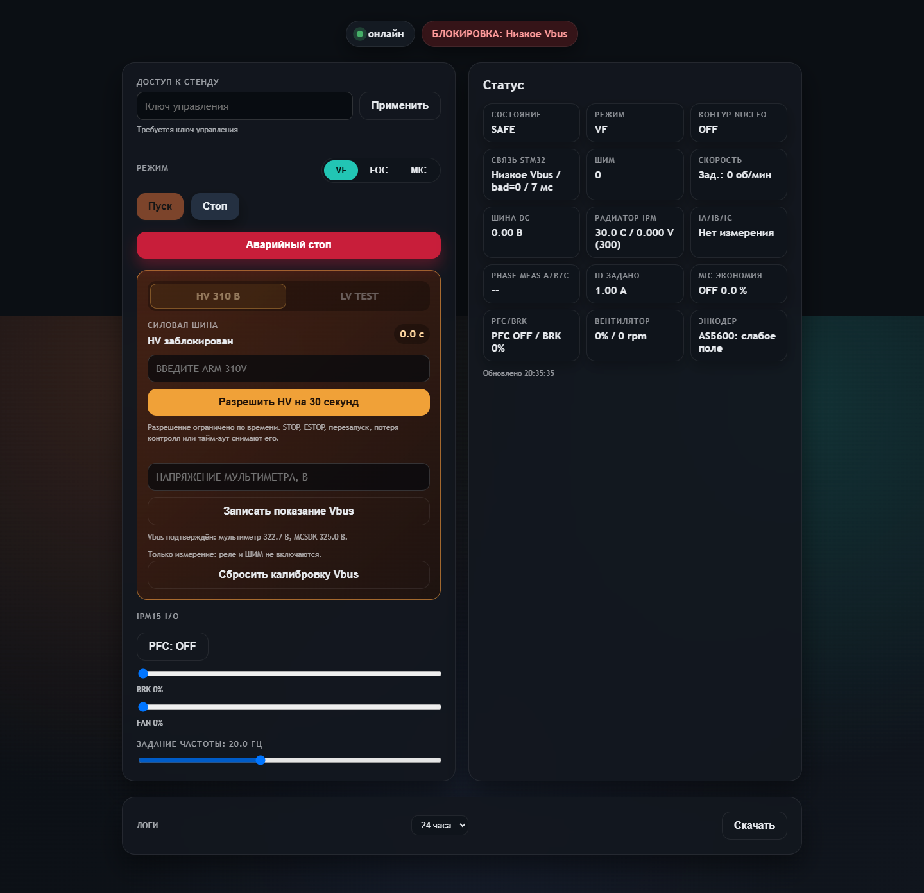
output/playwright/frequency_setpoint_20261007/setpoint_20_1440.png
