11lisov11/mic_practice/hardware/nucleo_system_wiring/ASSEMBLY_RU.md

# MIC_AI: схема соединения Nucleo

Главный документ: `../../output/pdf/MIC_AI_NUCLEO_SYSTEM_WIRING.pdf`.

## Принятая архитектура

`Телефон/ноутбук <-Wi-Fi-> Arduino UNO Q -> прямой UART -> NUCLEO-G431RB -> X-NUCLEO-IHM09M2 -> FC-34P 1:1 -> STEVAL-IPM15B -> AIR56B2`.

- S1: бездатчиковое V/f, AIR56B2 соединён треугольником 220 В.
- AS5600 вводится только на S3 и подключается к QWIIC UNO Q; датчик и его кабель являются частью HOT-контура.
- Внешний soft-start автономный; управляющего провода от MCU нет.
- `PB4` не подключён; `PC10/J2-21` физически есть в 34-жильном шлейфе, но не используется прошивкой.
- UNO Q и Nucleo соединены прямым UART 3.3 В и общей `HOT_GND`; их шины 3.3 В не соединяются.
- На STEVAL `HOT_GND` электрически является `J1 DC-` (общая опорная точка VDC- по UM2014); это не SELV.
- При сетевом выпрямителе UNO Q, Nucleo, AS5600 и STEVAL являются HOT-стороной и находятся в закрытом корпусе.
- В силовом режиме наружу выходит только Wi-Fi. USB/ST-Link/Ethernet/HDMI разрешены только при физически отключённом силовом входе STEVAL J1, отключённой сети и измеренно разряженном DC-link.
- HMI работает через существующий роутер (STA) или автономную WPA2-точку доступа UNO Q (AP); журналы хранятся на UNO Q и скачиваются через HMI.
- Команды и скачивание логов защищены отдельным ключом; потеря операторского heartbeat более 3 секунд вызывает STOP/ESTOP.

## Генерация

```powershell
& C:\Users\USER\.cache\codex-runtimes\codex-primary-runtime\dependencies\python\python.exe .\tools\generate_nucleo_system_wiring.py
```

Генератор одновременно обновляет PDF, семь SVG-листов, CSV соединений и `manifest.json`.
