11lisov11/mic_practice/docs/dissertation_2_9_3/figures/fig11_test_steps.png

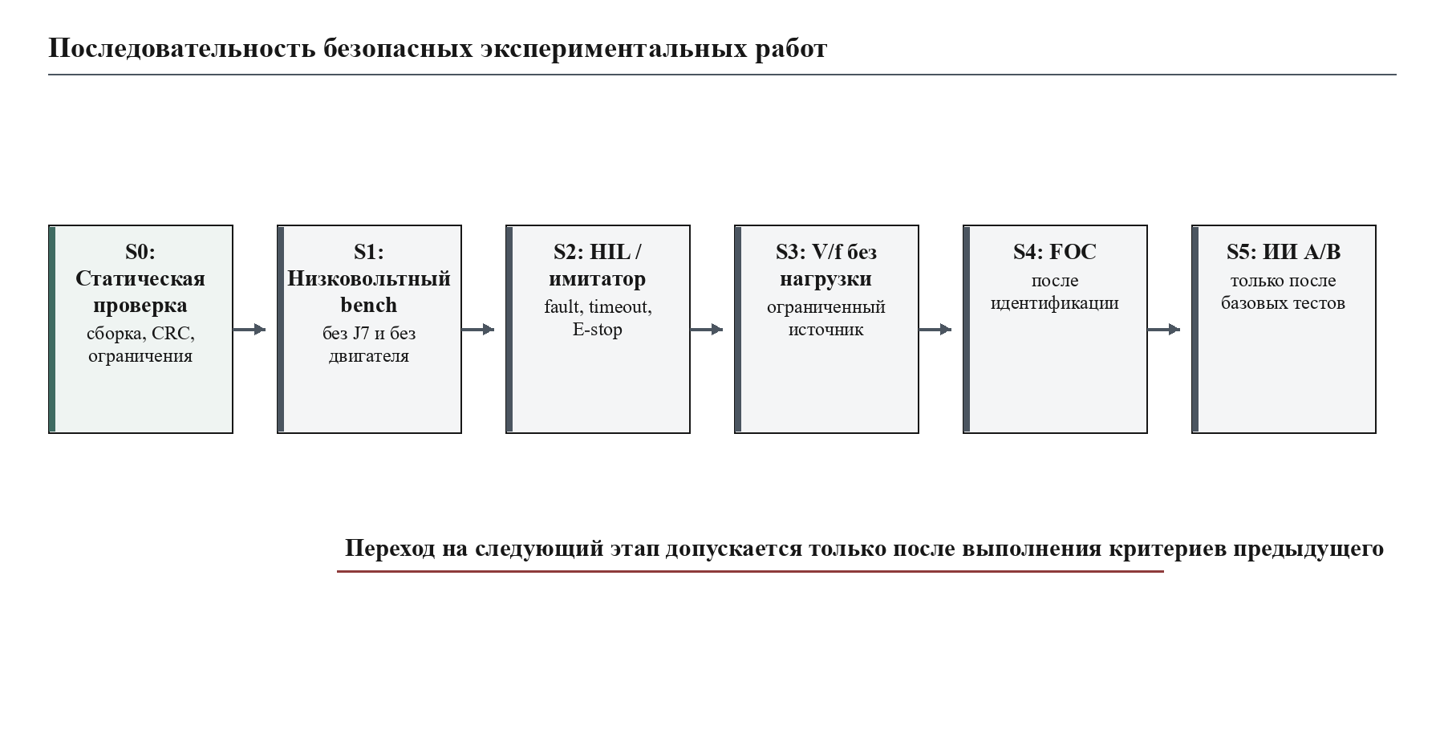
docs/dissertation_2_9_3/figures/fig11_test_steps.png
