11lisov11/mic_practice/output/png/MIC_AI_NUCLEO_SYSTEM_WIRING/contact-sheet.png

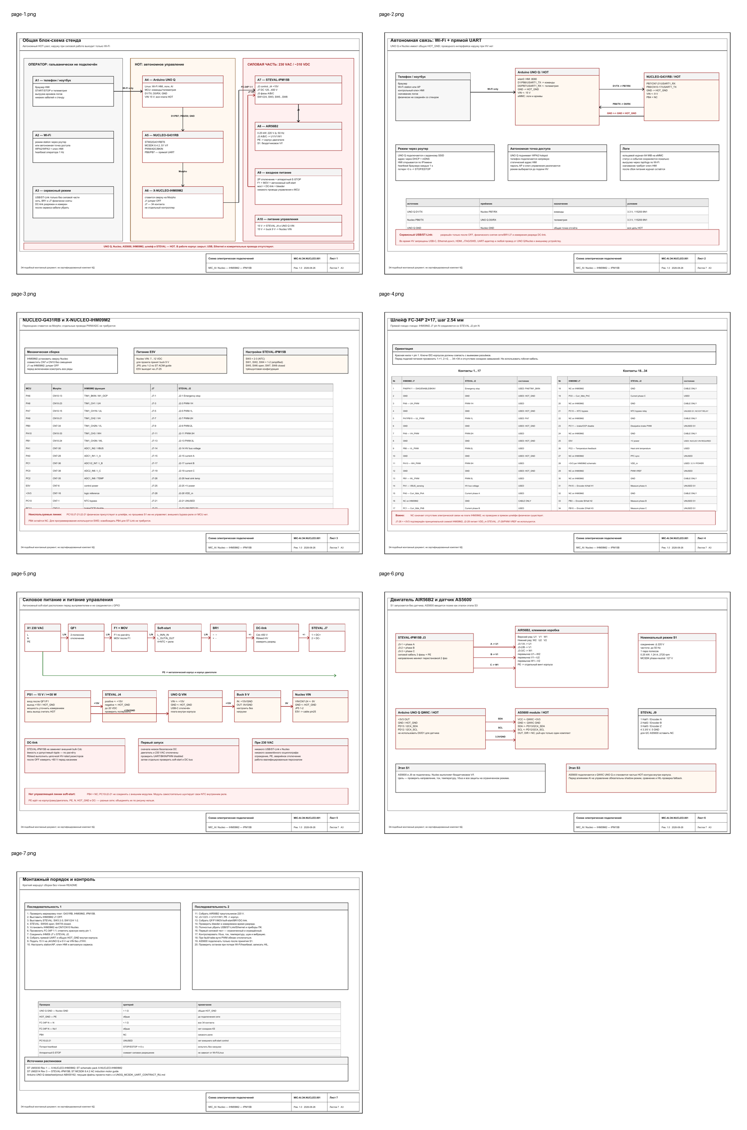
output/png/MIC_AI_NUCLEO_SYSTEM_WIRING/contact-sheet.png
