11lisov11/mic_practice/output/png/MIC_AI_NUCLEO_SYSTEM_WIRING/page-5.png

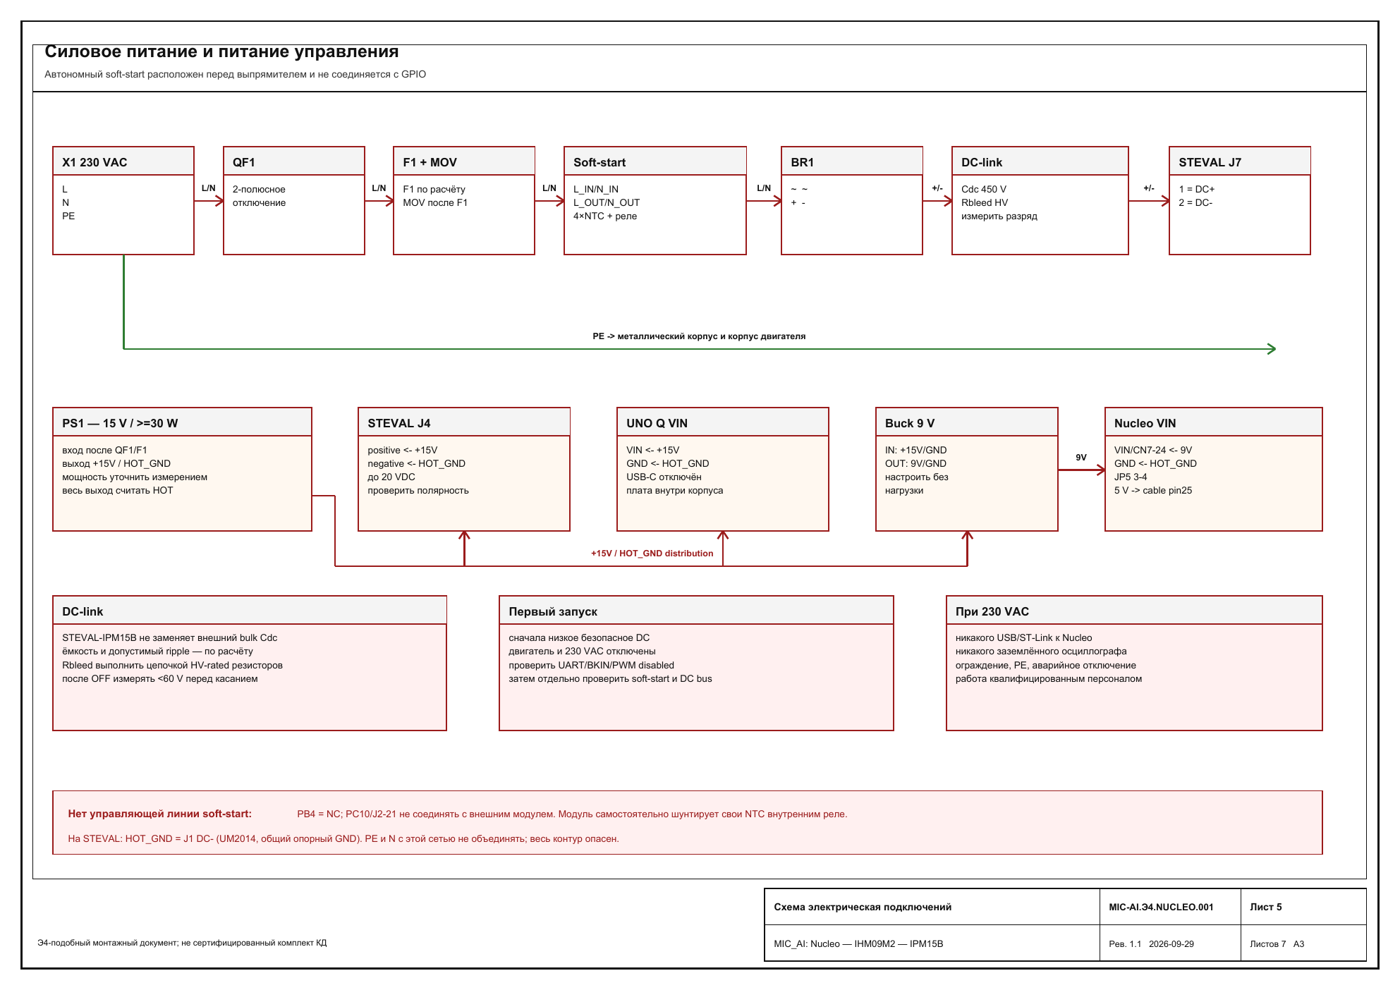
output/png/MIC_AI_NUCLEO_SYSTEM_WIRING/page-5.png
