11lisov11/mic_practice/output/png/MIC_AI_NUCLEO_SYSTEM_WIRING/page-7.png

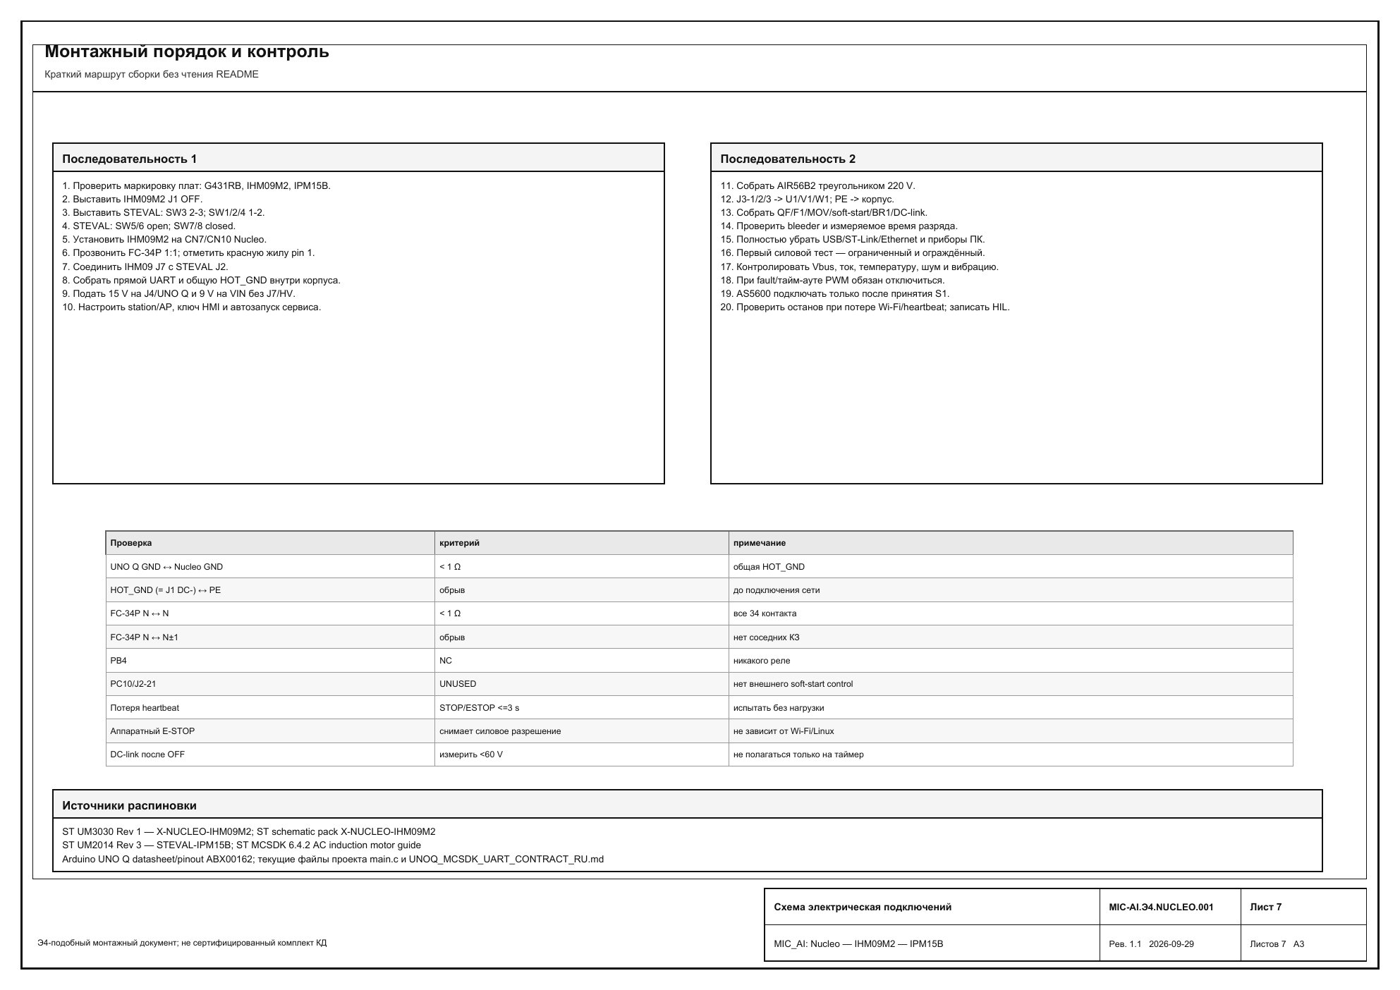
output/png/MIC_AI_NUCLEO_SYSTEM_WIRING/page-7.png
