11lisov11/mic_practice/AUTONOMOUS_HV_CALIBRATION_RU.md

# Автономная Проверка И Калибровка HV Bus

## Назначение

Сценарий переводит стенд из низковольтной проверки с ПК в автономный режим:

`телефон -> изолированная Wi-Fi сеть -> UNO Q -> изолированный UART -> STM32 -> STEVAL-IPM15B`.

Во время подачи силового напряжения USB, ST-Link, Saleae и заземленный осциллограф отключены. ПК не участвует в управлении.

## Жесткие Условия Остановки

Не подавать силовое напряжение, если выполнено хотя бы одно условие:

- `state != SAFE`, `pwm != 0`, `estop != 0`;
- `bp_fault != 0`, `bp_bad_cnt != 0`, `bp_rsp_age_ms > 1000`;
- `precharge != 0`, `pfc != 0`, `brake != 0`, `bp_ext != 0` до начала утвержденной последовательности;
- температура TSO недостоверна или `bp_temp_fault != 0`;
- нет внешнего E-STOP, предохранителя, штатного предзаряда/ограничения тока или закрытого корпуса;
- подключен любой нештатный USB, ST-Link, Saleae или заземленный щуп к HOT-домену;
- напряжение на конденсаторе не проверено мультиметром;
- нулевой сигнал `J2-14 -> PA5` плавает или не соответствует физическому напряжению.

Программные блокировки не заменяют аппаратный shutdown IPM, предохранитель, предзаряд и внешний E-STOP.

## Подтвержденная Низковольтная Точка

Историческая калибровка, которую пока сохраняем до получения второй известной точки:

- `raw_zero = 1763` при 0 В;
- `raw_cal = 3256` при 315 В.

Мультиметром подтверждено одинаковое напряжение `0.09 В` на `STEVAL J2-14` и `STM32 PA5` относительно одной `HOT_GND`. Следовательно, провод, контакт J2 и общая земля исправны.

До исправления режима выборки АЦП показание плавало с диапазоном около `61..196`. После перехода на длинное время выборки, отбрасывания первой конверсии после переключения канала и усреднения 64 выборок получено:

- среднее `raw = 123.28`;
- стандартное отклонение `2.81` отсчета;
- диапазон `119..130`, размах `11` отсчетов;
- эквивалентное напряжение входа АЦП около `0.099 В`.

Низковольтная точка устойчива и соответствует мультиметру. Коэффициенты `ADC_VBUS_*` и `BP_VBUS_*` не менять до получения второй точки при известном напряжении шины; запуск двигателя во время этой калибровки запрещен.

## Этап 1. Низковольтный Допуск С ПК

1. Физически отключить 310 В и проверить мультиметром разряд шины ниже 5 В.
2. Подать только штатные низковольтные питания.
3. Проверить `J2-14 -> PA5` и `J2 GND/HV_DC- -> HOT_GND`.
4. Прогнать build-only regression.
5. Прогнать PWM self-test CH0..CH6 и проверить три комплементарные пары.
6. Прогнать три цикла реле с контролем CH7.
7. Прошить production-профиль `bluepill_uart_pwm` с включенной температурной защитой.
8. Подтвердить static LOW на CH0..CH6.
9. Получить `ready_for_active_pwm=true` в bench-gate.

Критерии PWM:

- активность всех шести PWM-линий подтверждена;
- overlap каждой пары равен нулю;
- минимальный handoff gap не меньше 1 мкс;
- после теста все PWM-линии LOW.

## Этап 2. Подготовка Автономной HMI

1. При отключенной и разряженной HV установить HMI с режимом `--standalone-hv`.
2. Перезапустить UNO Q и STM32 от их штатных источников питания.
3. Проверить с телефона `http://<UNOQ_IP>:8080`.
4. В статусе требовать `hmi_hv_enabled=1` и `hmi_hv_armed=0`.
5. При 0 В кнопка `Разрешить HV` обязана отказать, потому что Vbus ниже 100 В.
6. Ввести в поле мультиметра `0.0` и нажать `Записать показание Vbus`.

Кнопка Vbus только читает 20 выборок. Она не включает PWM, реле, PFC или тормоз. Результат сохраняется в журнале строкой `VBUS_CAPTURE`.

Критерии устойчивой нулевой точки:

- диапазон `raw_max - raw_min <= 20` отсчетов;
- стандартное отклонение `raw_std <= 5` отсчетов;
- сигнал не находится у 0 или 4095;
- повторные захваты отличаются по среднему не более чем на 10 отсчетов.

## Этап 3. Полное Отделение От ПК

1. Отправить `STOP`, выключить реле и убедиться в `SAFE/pwm=0`.
2. Отключить USB UNO Q от ПК.
3. Отключить USB-UART, ST-Link и USB Blue Pill.
4. Отключить Saleae и все щупы осциллографа от HOT-домена.
5. Оставить UNO Q на отдельном штатном питании и связь с STM32 только через изолированный UART.
6. Оставить телефон и UNO Q в одной изолированной Wi-Fi сети без VPN-маршрутизации управления.
7. Проверить внешний E-STOP, предохранитель, предзаряд и закрытие корпуса.

## Этап 4. HV-Точка Только Для Калибровки

На этом этапе двигатель не запускается, `ARM 310V` не вводится и кнопка `Пуск` не нажимается.

1. Подать 15 В и дождаться `SAFE`, исправной температуры и живого UART.
2. Подать силовое питание через штатный ограничитель тока/предзаряд.
3. Измерить мультиметром напряжение строго между `DC+` и `DC-`.
4. С телефона проверить, что `pwm=0`, реле/PFC/тормоз выключены и нет fault.
5. Ввести фактическое значение мультиметра в поле HMI.
6. Нажать `Записать показание Vbus` и сохранить результат/скриншот.
7. Не нажимать `Разрешить HV` и `Пуск` до проверки новой калибровки.
8. Отключить сеть, дождаться разряда ниже 5 В и подтвердить это мультиметром.
9. При сохраненном низковольтном питании записать вторую точку `0.0 В`.

## Этап 5. Расчет Калибровки

Из двух записей взять:

- `raw_zero` как среднее устойчивой точки при 0 В;
- `raw_hv` как среднее при известном `meter_vdc`.

Расчет:

```text
scale_v_per_count = meter_vdc / (raw_hv - raw_zero)
vbus = max(0, raw - raw_zero) * scale_v_per_count
```

Обновить одинаковые точки в двух местах:

- `bluepill_uart_pwm_pio/include/config.h`: `ADC_VBUS_ZERO_RAW`, `ADC_VBUS_CAL_RAW`, `ADC_VBUS_CAL_V`;
- `UNOQ_MOTOR/UNOQ_MOTOR.ino`: `BP_VBUS_ZERO_RAW`, `BP_VBUS_CAL_RAW`, `BP_VBUS_CAL_V`.

После изменения прошивать платы только при отключенной и разряженной HV.

## Этап 6. Проверка Новой Калибровки

1. Повторить нулевую точку без HV.
2. Полностью отключить ПК и повторить известную HV-точку с телефона.
3. Требовать расхождение HMI и мультиметра не более `max(3 В, 2%)`.
4. Проверить отсутствие скачков, saturation ADC и stale telemetry.
5. Снова отключить и разрядить шину.

Только после прохождения этого этапа разрешается отдельный план первого ограниченного запуска двигателя.
