11lisov11/mic_practice/docs/AUTONOMOUS_VBUS_CALIBRATION_RU.md

# Автономная проверка Vbus перед HV-пуском

## Назначение

Процедура подтверждает, что показание DC-шины, получаемое MCSDK на Nucleo, согласуется с независимым мультиметром. Она не изменяет коэффициент делителя и не заменяет аппаратные защиты. До успешной нулевой и рабочей точек HMI не выдаёт разрешение HV.

Для `STEVAL-IPM15B` документация ST указывает диапазон входной DC-шины `125...400 В` и делитель измерения `1/125`. В схеме платы делитель образован `470 кОм + 470 кОм + 7,5 кОм`, что даёт `7,5 / 947,5 = 0,00791557`. Этот коэффициент уже задан в MCSDK. Проверка выполняется около фактической рабочей шины `310...325 В`, а не на произвольном низком напряжении.

Источники: [ST UM2014, STEVAL-IPM15B](https://www.st.com/resource/en/user_manual/um2014-1500-w-motor-control-power-board-based-on-stgib15ch60tsl-sllimm-2nd-series-ipm-stmicroelectronics.pdf), [страница STEVAL-IPM15B](https://www.st.com/en/evaluation-tools/steval-ipm15b.html), [ST UM3030, X-NUCLEO-IHM09M2](https://www.st.com/resource/en/user_manual/um3030-getting-started-with-the-xnucleoihm09m2-motor-control-connector-expansion-board-for-stm32-nucleo-stmicroelectronics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).

## Обязательная топология

- UNO Q, Nucleo, IHM09M2 и STEVAL находятся внутри закрытого стенда.
- UNO Q и Nucleo питаются автономно. К ним не подключены USB, ST-Link, Ethernet, HDMI, UART-адаптер, Saleae или осциллограф.
- Управление выполняется с телефона через Wi-Fi.
- Напряжение измеряет автономный мультиметр не ниже `CAT III 600 V` с исправными щупами соответствующей категории.
- На данном экземпляре STEVAL силовой вход маркирован `J1` (`J1-2` = `+Bus`, `J1-1` = DC− по принципиальной схеме UM2014). Щупы закрепляются между этими контактами только при отключённой сети и разряженной шине. Таблица разъёмов UM2014 называет вход `J7`, но на схеме и плате он `J1`; не путать с 34-контактным `IHM09M2 J7`. К открытым проводникам при поданном питании не прикасаться.
- Аппаратный двухполюсный выключатель и независимый E-stop остаются доступными оператору.

## Шаг 1. Нулевая точка

1. Отключить сеть двухполюсным выключателем.
2. Дождаться разряда DC-link и мультиметром подтвердить `0...2 В` между `DC+` и `DC-`.
3. В HMI убедиться: `SAFE`, `PWM=0`, E-stop не активен, связь с Nucleo живая.
4. Ввести фактическое показание мультиметра и нажать «Записать показание Vbus».
5. HMI собирает 20 отсчётов, держит HV-разрешение снятым и допускает только штатный MCSDK undervoltage. Показание MCSDK должно быть не выше `5 В`, стандартное отклонение не выше `0,5 В`.

После шага 1 интерфейс показывает: «Нулевая точка записана; рабочая HV-точка ещё не подтверждена». Запуск остаётся заблокирован.

## Шаг 2. Рабочая точка

1. Закрыть корпус и убедиться, что все внешние проводные интерфейсы физически отключены.
2. Включить сеть через внешний автономный soft-start и дождаться завершения его задержки.
3. Дождаться устойчивого показания мультиметра. Допустимая точка проверки HMI: `250...360 В`; рекомендуется фактическая рабочая область `300...340 В`.
4. Если после заряда сохранён штатный undervoltage, выполнить `CLEAR` в HMI. Перед захватом должны быть `SAFE`, `PWM=0`, `fault=0`, `bad=0` и свежая телеметрия.
5. Ввести точное показание мультиметра и нажать «Записать показание Vbus».
6. HMI собирает 20 отсчётов. Допуск расхождения равен большему из `5 В` и `3 %`; допустимое стандартное отклонение равно большему из `1 В` и `0,5 %` показания.

Только после успешного шага 2 появляется статус «Vbus подтверждён». Затем оператор отдельно выполняет обычную последовательность `ARM` и `START`; автоматического пуска после калибровки нет.

## Что хранится

Запись `~/.config/mic-ai/vbus_calibration.json` содержит обе точки, статистику, build ID UNO Q, build ID Nucleo, версию RPC и SHA-256 контроль целостности. Файл записывается атомарно с правами `0600`.

Нулевая и рабочая точки сохраняются между включениями; повторять процедуру перед каждым пуском не требуется. Разрешены следующие проверенные пары `(Uno Q, Nucleo)`: `(2026092901, 2026100601)`, `(2026100612, 2026100601)`, `(2026100701, 2026100601)`, `(2026100701, 2026100701)`, `(2026100702, 2026100601)`, `(2026100702, 2026100701)`, `(2026100702, 2026100702)`. Требуются RPC `3`, возможности `VF` и телеметрия MCSDK. Добавление AS5600 и диагностики причин отказа в этих сборках не меняет измерительные параметры Nucleo или масштаб Vbus (`0,1 В` на единицу слова UART), не сдвигает поля Vbus и не сбрасывает точки. Исходная запись, её измерения и build ID не переписываются автоматически. Смешивание старого моста и нового диагностического формата вне этого списка не разрешается. Это правило действует в обновлённом HMI; установленный экземпляр нужно обновить отдельно при снятом силовом питании.

Для версий моста `2026100703` и `2026100704` дополнительно проверены сочетания с Nucleo `2026100601` и диагностическими сборками от `2026100701` до номера самого моста включительно. Обновление IRQ/FIFO меняет только приём UART и диагностику отказа, не меняя измерение Vbus. Предыдущие пары сохраняют прежние ограничения. Обе точки переносятся без перезаписи исходного файла.

Разрешение автоматически теряет силу при:

- смене прошивки UNO Q вне указанной проверенной пары;
- смене прошивки Nucleo;
- переходе на старую RPC-схему без build ID Nucleo;
- повреждении или ручном изменении файла;
- нажатии «Сбросить калибровку Vbus».

## Если точки не совпали

Не запускать двигатель и не расширять допуск. Выполнить `STOP`, отключить сеть, дождаться разряда и только в сервисном режиме проверить цепь Vbus, номиналы делителя и `VBUS_PARTITIONING_FACTOR` в `power_stage_parameters.h`. После изменения MCSDK обе прошивки собираются и прошиваются заново, а процедура повторяется с нулевой точки.

Успешная проверка Vbus не подтверждает фазировку двигателя, токовые каналы, аппаратный break/OCP, внешний soft-start или устойчивость привода под нагрузкой. Эти пункты остаются отдельными воротами HIL.
