11lisov11/mic_practice/artifacts/j4_15v_live_20260929_retry/RESULT_RU.md

# J4 15 V: пассивная проверка рабочей прошивки

При поданных пользователем 15 В на J4 проверены только показания рабочей
прошивки по Wi-Fi и уровни входов Saleae. Команды ARM, START, CLEAR и
перепрошивка не выполнялись.

- Пять ответов HMI: `SAFE`, `PWM=0`, `mc_fault=5`, `mc_softstart_ready=0`,
  `hmi_hv_armed=0`; возраст ответа UART 10-51 мс, `mc_bad_cnt=1` без роста.
- Показание `Vbus` стабилизировалось на 11 В. Это программное показание,
  не новое измерение мультиметром на J1. В предыдущем опыте пользователь
  измерил 11,7 В непосредственно между DC+ и DC- J1 при питании J4.
- [Пассивный захват Saleae](csv/digital.csv): CH0-CH5 постоянно LOW,
  CH6/PA6 постоянно HIGH, фронтов нет. [Исходный захват](capture.sal).

Это подтверждает состояние покоя и свежую связь в текущем низковольтном
режиме. Не проверены переключение PWM рабочей прошивкой, отключение через
SD/BKIN, работа силового каскада или двигатель. Пользователь исправил
сообщение о `1,44 В` между землями: это было ошибочное значение; на
обесточенном стенде он подтвердил прозвонку J4- и GND Nucleo. Этот
пассивный опыт не заменяет первый контролируемый силовой ввод.
