11lisov11/mic_practice/artifacts/j4_15v_readonly_20260929/RESULT_RU.md

# Пассивная проверка после подачи 15 В на J4

На J4 подано вспомогательное питание 15 В; по сообщению пользователя других источников питания силовой шины нет. Пользователь уточнил и подтвердил точку измерения: мультиметр показывает **11,7 В между «+» и «−» разъёма J1 самой STEVAL-IPM15B**, не J7 (также сообщалось 11,9 В). Это не измерение между клеммами Nucleo и не нулевая шина в точке J1. Напряжение непосредственно на разъёме, обозначенном J7, отдельно не измерялось. Ранее записанное здесь «менее 2 В» было ошибочным переносом предварительного подтверждения на состояние после включения J4. Проверка выполнялась без команд START, ARM, CLEAR и без перепрошивки.

## Наблюдения

- HMI по Wi-Fi: `SAFE`, `PWM=0`, `bp_status=9`, `bp_fault=5`, HV-разрешение снято. Показание Nucleo `vdc` после включения J4 изменилось от 9 до 11 В, что согласуется с мультиметром на J1 (11,7 В).
- На A1/PA1 относительно GND Nucleo измерено `0,0943 В`. При коэффициенте делителя `0,00791557` это соответствует примерно `11,9 В` на линии `+Bus`. Разница с измеренными на J1 11,7 В около 0,2 В; по этим данным **ошибки масштаба измерения Vbus не обнаружено**.
- Исправление со слов пользователя: сообщение о `1,44 В` между минусом J4 и GND Nucleo было ошибочным. Позднее он проверил цепь на обесточенном стенде и сообщил об уверенной прозвонке. Не считать `1,44 В` измеренным напряжением или блокером запуска.
- Поле `bp_vbus_raw=110` в текущем MCSDK-протоколе означает 110 десятых долей вольта, а не 110 отсчётов АЦП: Nucleo передаёт уже пересчитанное напряжение. Поэтому расхождение нельзя объяснить только форматированием HMI.
- За 30 секунд Wi-Fi-наблюдения: 38 выборок; `vdc` от 10 до 11 В; `bp_bad` вырос с 2 до 3; `bp_bad_cnt` остался 5. Счётчик `bp_good` достиг насыщения 65535, поэтому его неизменность не доказывает остановку обмена; возраст последнего ответа оставался 3–51 мс. [Сводка](wifi_30s/summary.json). Ретроспективный прогон с `--max-vdc 2` был поставлен по ошибочной предпосылке о нулевой шине: его отказ по напряжению не свидетельствует о неисправности АЦП. Рост `bp_bad` остаётся отдельной проблемой UART.
- Read-only диагностика Uno Q: `bp_bad_integrity=0`, `bp_bad_sequence=3`, `bp_superseded=0`, `bp_clear_pending=0`. Третья ошибка на Uno Q относится к последовательности ответов, не к проверке целостности. Счётчик Nucleo `bp_bad_cnt=5` может увеличиваться при ошибках UART, CRC или передаче ответа; конкретная причина не выведена в текущую телеметрию.
- Пассивная запись Saleae после подачи J4: CH0–CH5 статически низкие, CH6/PA6 статически высокий. [CSV](saleae/csv/digital.csv). Рабочий PWM и реакция аппаратного BKIN этой записью не проверены.

## Вывод и дальнейшая проверка

По [принципиальной схеме ST, рисунок 5](https://www.st.com/resource/en/user_manual/um2014-1500-w-motor-control-power-board-based-on-stgib15ch60tsl-sllimm-2nd-series-ipm-stmicroelectronics.pdf), **J1 на STEVAL-IPM15B** (`INPUT-dc`) соединён с линиями `+Bus` и GND, а делитель R1/R2/R4 измеряет именно `+Bus`. Пользователь подтвердил, что измерял J1 STEVAL: ненулевой сигнал PA1 согласуется с **измеренными 11,7 В на нём**. В том же UM2014 таблица разъёмов называет разъём DC-питания J7, хотя схема и перечень элементов обозначают его J1; для данного экземпляра ориентироваться на маркировку платы J1. Это не `IHM09M2 J7` (34-контактный интерфейсный разъём). При единственном заявленном источнике 15 В путь появления 11,7 В отдельно не установлен, но это не свидетельствует о наличии сетевого напряжения и не является самостоятельным запретом низковольтного теста. Делитель и программный масштаб Vbus сейчас менять нельзя.

[Регламент нулевой точки](../../docs/AUTONOMOUS_VBUS_CALIBRATION_RU.md) применим только после фактического разряда шины, а не при наличии измеренных 11,7 В. Сейчас его результат нельзя считать провалом калибровки. Активный ШИМ и подача сетевого/HV питания не разрешены из-за невыясненного пути питания шины и разности земель; затем отдельно нужно разобрать новые ошибки UART и провести низковольтный HIL `SD/BKIN`.
