11lisov11/mic_practice/artifacts/wifi_scenarios_20260927_r4/RESULT_RU.md

# Проверка управления по Wi-Fi, 27.09.2026

## Условия и метод

Пользователь подтвердил отключение силового питания и снятый J7 либо отсутствие подключения IPM. Управляющие команды передавались HTTP на 192.168.1.138:8080; этот адрес подтверждён на wlan0 UNO Q. ADB использовался для получения ключа без его вывода, USB/ST-Link для загрузки и восстановления прошивок. Измерения выполнены физическим Saleae A7D1BB81883C0092.

Активные испытания выполнены на диагностических образах UNO Q и Nucleo. Nucleo выдаёт фиксированный комплементарный ШИМ и синтетическую телеметрию нулевой шины. Это проверка цепочки команд, таймера и остановки; она не подтверждает работу производственного MCSDK V/f, вращение двигателя или регулирование тока. Фазы диагностического ШИМ не являются трёхфазной синусоидальной модуляцией.

## Подтверждено

- START через штатный HMI start-sequence приводит к физическому ШИМ на всех шести подключённых каналах.
- Измеренная частота первого захвата: 10020,84 Гц; минимальный dead time каждой пары: 2,00 мкс. Одновременный высокий уровень верхнего и нижнего каналов не обнаружен.
- Три повторных цикла START/STOP: активный ШИМ и последующее устойчивое выключение подтверждены захватами.
- Запуск без ключа управления отклонён HTTP 401; без ARM, с неверной фразой ARM, после STOP без нового ARM и при защёлкнутом ESTOP отклонён HTTP 409.
- ESTOP выключает ШИМ и устанавливает защёлку аварийного останова.
- Ограничитель времени 3 с выключает ШИМ при продолжающемся heartbeat. После активного захвата до наблюдения выключения прошло 2,09 с; это не точное измерение длительности импульсного пакета.
- При прекращении heartbeat и сохранении только GET /api/status наблюдено выключение и ESTOP через 3,38 с. Независимый лимит MCU в этом сценарии установлен 8 с. Журнал HMI содержит OPERATOR_HEARTBEAT_LOST age=3.30s и успешные STOP/ESTOP.
- 29 проверок сценариев завершились успешно в указанной области проверки.
- Рабочие прошивки обеих плат восстановлены и проверены загрузчиками. После восстановления: SAFE, VF, PWM=0, HV ARM=0, версия обеих плат 2026091401. Финальный захват: все шесть каналов LOW.
- На рабочих прошивках отдельно подтверждён отказ START при mc_fault=5 (нулевая шина) и отказ HV ARM при отсутствии калибровки Vbus.

## Открытые замечания

- В пяти первых захватах после останова были начальные переключения. Независимые повторные захваты подтвердили устойчивый LOW. Причина начальных переключений не установлена: задержка выключения и отсутствие коротких импульсов в момент STOP не доказаны. Нужен непрерывный захват, охватывающий саму команду STOP, и независимая привязка времени команды.
- Зафиксировано семь ReadTimeout Saleae; все шесть затронутых захватов завершены повтором, ошибки сохранены в capture_errors.json. Надёжность непрерывного захвата остаётся открытым вопросом.
- CH6 не подтвердил удержание PA6/SD в LOW. Подключение этого канала не подтверждено; аппаратный SD/BKIN не проверен. Диагностическая прошивка не выполняет тест BKIN производственного MCSDK.
- Физический обрыв UART, отключение питания, реальное отключение Wi-Fi-радиоканала, силовые аварии и двигатель под нагрузкой не испытывались. Потеря heartbeat проверена прекращением запросов клиента.
- На рабочей прошивке остаётся один накопленный ошибочный UART-кадр. Калибровка Vbus и аппаратные условия выпуска остаются незакрытыми.

## Материалы

- report.json: команды, 29 проверок, результаты анализа, замечания и восстановление образов.
- production_wifi_guards.json: проверки рабочих прошивок и строка журнала watchdog.
- Подкаталоги сценариев: исходные capture.sal и CSV; при повторных попытках данные находятся в retry_N.
- logs: сборка, запись и проверка восстановления прошивок.

Итог: цепочка Wi-Fi -> UNO Q -> UART -> диагностический PWM и перечисленные программные блокировки подтверждены. Полная аппаратная готовность к силовому пуску не подтверждена.
