11lisov11/mic_practice/artifacts/board_flash_20260908/nucleo_pwm_active_02/RESULT_RU.md

# Проверка подключённых плат, 08.09.2026

**Обновление 20:37 МСК:** последующая проверка UART прошла после
повторного подключения проводов. См. `../UART_LINK_OK_RU.md`.
Раздел о нерешённом UART ниже описывает состояние во время теста ШИМ.

## Область проверки

Пользователь подтвердил отключение Nucleo от IPM и силовой части.
Проверены только логические выходы платы. Двигатель не запускался.
Использована отдельная диагностическая прошивка, не рабочий режим MCSDK.
Это не подтверждение готовности силового стенда, FOC или ИИ-регулятора.

## Оборудование и прошивки

- NUCLEO-G431RB, ST-Link `003A002C3335510933383531`, питание 3,26 В.
- Физический логический анализатор `A7D1BB81883C0092`, 24 Мвыб/с.
- UNO Q, ADB `3880458060`, MCU обновлён до сборки `2026082601`.
- Linux HMI обновлён; хеши пяти файлов совпадают с пакетом.
- MCU UNO Q и Linux RPC отвечают, режим VF, состояние SAFE, PWM=0.
- Установлен запуск HMI через cron; перезагрузка в этом прогоне не проверялась.

## ШИМ: полный повторный прогон пройден

| Канал | Сигнал | Вывод Nucleo | Измеренный коэффициент заполнения |
|---|---|---|---|
| CH0 | UH | PA8 / CN10-23 | 17,845 % |
| CH1 | UL | PA7 / CN10-15 | 77,861 % |
| CH2 | VH | PA9 / CN10-21 | 47,852 % |
| CH3 | VL | PB0 / CN7-34 | 47,851 % |
| CH4 | WH | PA10 / CN10-33 | 77,845 % |
| CH5 | WL | PB1 / CN10-24 | 17,863 % |

Задания фаз 20/50/80 % различаются намеренно, чтобы выявлять перестановку
каналов. Длительности высокого уровня уменьшены за счёт dead-time.

- Несущая на всех шести каналах: 16 032 Гц (номинально 16 000 Гц).
- Минимальная измеренная пауза в каждой паре: 1,333 мкс.
- Шаг регистрации: 41,67 нс. Это цифровой замер, не измерение формы
  фронтов и не проверка сквозного тока силовых транзисторов.
- Одновременный высокий уровень в парах U/V/W: не обнаружен в записи.
- Интервал от первого до последнего переключения: 299,425 мс.
- TIM2 завершил тест штатно, диагностическое состояние 3 (DONE).
- До команды все выходы были LOW.
- Повторная команда без сброса не создала новых импульсов.
- После возврата рабочей прошивки все шесть выходов оставались LOW.

В первом прогоне (`../nucleo_pwm_active_01`) сам ШИМ прошёл проверки,
но при следующем захвате Saleae вернул USB ReadTimeout. Первый прогон
оставлен со статусом FAIL. Второй прогон завершился полностью: PASS.

## Возврат рабочей прошивки

Диагностическая прошивка снята. Восстановлен и проверен программатором
`ACIM-NUCLEOG431RB-IPM15B-VF_OL.hex` из `firmware/ready_to_flash`.
Дополнительно считаны обратно 39 004 байта Flash; они совпадают с BIN.

SHA-256 рабочего BIN и считанной Flash:
`693eec675ce2599ad45dd608b2baab7c2e365dda09af8afb7a1ff34544341ebe`.

Рабочие ограничения запуска и защиты не отключались.

## Нерешённое: UART UNO Q — Nucleo

10 последовательных чтений HMI после теста: `mc_good=0`, ответов нет.
Состояние `uno_link` в SRAM Nucleo после восстановления прошивки:
60 нулевых байтов, включая счётчики принятых и ошибочных кадров.
Это указывает на отсутствие зарегистрированного обмена, но само по себе
не устанавливает причину: требуется проверить проводку и сигналы UART.

Правильные соединения для текущей прошивки:

- UNO Q D1/TX → Nucleo PB7 / CN7-21.
- UNO Q D0/RX ← Nucleo PB6 / CN10-17.
- Общий GND; выходы питания 3,3/5 В между платами не объединять.
- UART 115200, 8N1, уровни 3,3 В. Nucleo D0/D1 здесь не используются.

Следующий диагностический шаг: при отключённой силовой части проверить
эти три провода; при необходимости добавить CH6 к PB7 и CH7 к PB6,
не снимая CH0–CH5, и записать обе линии UART.

## Файлы доказательств

- `report.json`: полный машинный протокол, PASS только логического теста.
- `burst/capture.sal`: исходный захват, открыт в Logic 2.
- `burst/csv/digital.csv`: исходные переходы всех шести каналов.
- `pwm_measured.png`: увеличение реальной записи, не синтетический график.
- `production_flash_readback.bin`: считанная рабочая прошивка.
- `production_uart_state.bin`: состояние приёмника UART Nucleo.
- `../unoq_after_pwm_uart.json`: проверка UNO Q, общий FAIL из-за UART.

**Итог:** логический ШИМ проверен; UART и работа силового привода пока
не подтверждены. Подача высокого напряжения этим тестом не разрешается.
