11lisov11/mic_practice/research/mic_ai_theory/snh_pwm/revalidation/FINAL_MC30_SUMMARY_RU.md

# SNH-PWM rev4: итоговая длинная перепроверка

## Протокол

- Сценарии: все 31 сценарий из исследовательской матрицы.
- Контроллеры: 8, включая FOC-SVM, FCS-MPC, DTC и SNH-PWM H2.
- Повторы: 30 парных реализаций с общими случайными параметрами и шумами.
- Длительность: `2000 × 100 мкс = 0,2 с` на каждый контроллер-прогон.
- Объём: 7440 контроллер-прогонов, выполненных в 16 процессах.
- Пороги защиты: `i_soft=4,375 А`, `i_trip=6,125 А`; пороги при исправлениях не повышались.
- Претензия на аппаратное подтверждение: `false`.

## Результат автоматического аудита

- `host_long_horizon_ready=true`.
- `hardware_ready=false`.
- Неожиданных критических отказов: 0.
- Максимальный ток модели: `5,652610 А`, ниже `i_trip=6,125 А`.
- Защитная реакция в `fault_injection_runtime`: ожидаемо подтверждена.
- Несовпадений решения event-trigger с фактической обратной связью: 0.
- Confidence fallback зафиксирован в `regeneration`, `sensor_delay`,
  `sensor_dropout` и `speed_sensor_failure`.

## Сравнение с FOC-SVM

Парная разность определена как `SNH-PWM минус FOC-SVM`; для ошибки скорости
отрицательное значение лучше. По нормальной 95%-аппроксимации доверительного
интервала получено:

- лучше: 26 сценариев;
- хуже: 3 сценария (`reverse`, `braking`, `ood`);
- статистически неразличимо: 2 сценария (`overload`, `rr_error`).

Эти данные не подтверждают универсальное превосходство SNH-PWM. Они подтверждают,
что исправленная host-реализация выдержала заданный длинный программный протокол и
в большинстве сценариев уменьшила ошибку скорости относительно конкретной
текущей настройки FOC-SVM. Для научного вывода по реальному приводу необходимы
WCET, HIL и парные стендовые измерения энергии и механической работы.

## Воспроизводимость

Канонический результат:
`snh_paired_mc30_all31_0p2s_rev4_final.json`.

Машинный аудит:
`snh_paired_mc30_all31_0p2s_rev4_final_audit.json`.

Повторный финальный расчёт совпал с предыдущим rev4 JSON после исключения нового
служебного блока `safety_thresholds`; тем самым подтверждена детерминированность
результата при фиксированных seed.
