11lisov11/mic_practice/research/mic_ai_theory/snh_pwm/revalidation/REV3_SUMMARY_RU.md

# SNH-PWM rev3: парная перепроверка

## Протокол

- Сценарии: `start_no_load`, `load_step`, `dc_sag`, `sensor_dropout`.
- Контроллеры: восемь, включая FOC-SVM, FCS-MPC, DTC и SNH-PWM H2.
- Повторы: `10` общих random-number trials на сценарий.
- Длительность: `2000 × 100 мкс = 0,2 с`.
- Выполнение: восемь worker-процессов; последовательный и параллельный режимы
  проверены на полное совпадение JSON-результатов.
- Hardware claim: `false`.

## Результат SNH-PWM H2 относительно FOC-SVM

Парная разность определена как `SNH-PWM минус FOC-SVM`; отрицательная ошибка
скорости лучше. Интервалы ниже — нормальная 95%-аппроксимация для десяти пар.

| Сценарий | Средняя ошибка SNH, рад/с | Парная разность ошибки, рад/с | 95% ДИ разности | Доля побед | Максимальный ток, А |
|---|---:|---:|---:|---:|---:|
| start_no_load | 47,201 | -33,647 | [-39,460; -27,834] | 1,0 | 3,908 |
| load_step | 59,474 | -18,733 | [-31,381; -6,086] | 0,7 | 3,902 |
| dc_sag | 68,872 | -16,124 | [-28,628; -3,620] | 0,8 | 4,155 |
| sensor_dropout | 51,257 | -28,060 | [-44,670; -11,451] | 1,0 | 3,890 |

Во всех четырёх сценариях: `feedback_decision_mismatch_count=0`,
`fault_latch_events=0`, `OC steps=0`, `safety_violations=0`. Пороги
`i_soft=4,375 А` и `i_trip=6,125 А` не повышались.

## Интерпретация

Исправление устранило host-level OC-защёлки: robust current envelope входит в
стоимость горизонта, а soft-current fallback переводит инвертор в ближайший
нулевой вектор вместо удержания предыдущего активного вектора. В rev3 решение
event-trigger вычисляется один раз и совпадает с реально использованным feedback.
При этом SNH-PWM
улучшил слежение за скоростью относительно текущей настройки FOC-SVM, но потребовал
больше среднего тока, коммутаций, пульсаций момента и fallback. Следовательно,
результат подтверждает Pareto-компромисс, а не универсальное превосходство.

Следующий обязательный gate: полный набор из 31 сценария с длинным окном,
MC не менее 30, затем WCET/HIL. До этого MCU/bench claim запрещён.
