11lisov11/mic_practice/research/mic_ai_theory/snh_pwm/c6_conformal_reachability/revalidation/ESTIMATOR_FED_20260828_RU.md

# Estimator-fed C6-BCR: exploratory-ревалидация

Дата выполнения: 26 августа 2026 г.  
Root seed: `20260828`.

## Цель

Предыдущий C6-BCR использовал истинные потоки, скорость и сектор потока как вход
predictor. Такой oracle-интерфейс недоступен на Nucleo. В этой серии добавлен
детерминированный наблюдатель, принимающий только:

- измеренные токи статора в координатах alpha-beta;
- восстановленное по состоянию ключей и Vbus приложенное напряжение alpha-beta;
- обработанную механическую скорость от энкодера, соответствующего роли AS5600.

Поток статора интегрируется по voltage model `d psi_s/dt = u_s - Rs*i_s`.
Поток ротора восстанавливается из потокосцепления статора и измеренного тока по
номинальной индуктивной матрице. Истинный поток не передаётся наблюдателю и
используется только как simulation target и для диагностических метрик.

## Протокол

- 8 независимых разбиений;
- 120 training, 200 calibration, 400 test и 100 OOD траекторий на split;
- 20 burn-in и 40 оцениваемых PWM-тактов;
- одинаковые actual plant, векторы, нагрузки и random streams для oracle/estimator;
- шум тока `0,4% I_limit`, постоянный offset `0,2% I_limit`;
- ошибка масштаба напряжения sigma `0,5%`, шум/offset напряжения `0,1% Vdc`;
- шум обработанной скорости `0,40 рад/с`, bias `0,20 рад/с`;
- разброс `Rs/Rr +/-40%`, `Lm +/-15%`, `J/B +/-50%`;
- OOD-радиусы увеличены в `1,75` раза.

## Результаты

- полный детерминированный replay: `pass`;
- median estimated-sector accuracy: `0,973875`;
- median oracle C6 coverage: `0,9575`, описательно;
- median estimator-fed C6 coverage: `0,9550`, диапазон `0,9150..0,9825`;
- median estimator-fed OOD coverage: `0,8450`, диапазон `0,7400..0,9000`;
- median estimator C6/raw volume ratio: `0,824788`, то есть C6 уменьшает
  estimator-fed box примерно на `17,5%`;
- median estimator/oracle volume ratio: `6,731681e6`;
- median oracle log10-volume: `-11,141148`;
- median estimator log10-volume: `-4,298299`;
- stator-flux RMSE alpha/beta: `0,008595/0,008289 Вб`;
- rotor-flux RMSE alpha/beta: `0,008905/0,008577 Вб`;
- speed RMSE: `0,268117 рад/с`;
- flux clip events: `0`.

Рост относительно oracle на несколько порядков не является переполнением. Oracle
prediction стартует из точного состояния и имеет почти нулевой однопереходный
остаток. Estimator-fed tube дополнительно покрывает накопленную ошибку интегратора,
offset датчиков, неизвестный load torque и параметрический разброс. Поэтому для
практического алгоритма сравнение C6 с estimator raw-box информативнее, чем отношение
к искусственно сильному oracle.

Высокое описательное OOD coverage также не означает OOD-устойчивость: estimator tube
намного шире, и увеличение coverage оплачено потерей sharpness.

## Ограничения

- Bulk test-траектории одного split используют общий calibration tube; их coverage
  не образует независимый биномиальный inferential gate.
- Скорость подаётся как уже обработанное измерение. Реальные задержка, частота
  обновления, квантование и пропуски AS5600 пока не воспроизведены.
- Voltage model чувствителен к offset тока, ошибке `Rs`, dead-time и дрейфу при
  малой скорости.
- Истинный flux-target доступен только в host-модели; для аппаратной калибровки
  потребуется независимый reference или иная наблюдаемая target-переменная.
- Не проверены recursive safety, HIL, WCET и fixed-point реализация на G431.

## Следующий этап

1. Добавить модель дискретного энкодера с независимой частотой, quantization,
   transport delay и dropout.
2. Добавить offset/Rs correction и low-speed observability gate.
3. Повторить independent calibration/test coverage probes уже для estimator-fed
   residual, заранее рассчитав размер выборки.
4. После появления платы измерить ADC offsets, Vbus scale и реальную скорость
   обновления энкодера, затем выполнить низковольтную HIL/стендовую проверку.
