11lisov11/mic_practice/research/mic_ai_theory/snh_pwm/c6_conformal_reachability/revalidation/STATUS_RU.md

# Статус C6-BCR revalidation

Дата пересмотра coverage-аудита: 26 августа 2026 г.

Файлы `c6_conformal_lab_seed_20260809..20260811*` и агрегированный аудит сохранены
как исторические артефакты. Их bulk coverage, OOD coverage и сравнение гиперобъёмов
остаются воспроизводимой описательной информацией.

Прежние `pooled_undercoverage_p_value` больше не являются подтверждающей
статистикой. В каждом split сотни test-траекторий проверялись одним случайным
calibration tube и поэтому не образуют независимую биномиальную выборку.

Актуальный генератор использует отдельный inferential-контур:

- фиксируется независимая training-выборка, определяющая форму score;
- для каждой coverage-пробы заново формируется calibration-выборка;
- из того же распределения формируется ровно одна независимая test-траектория;
- exact one-sided Clopper-Pearson 99% lower bound применяется только к таким пробам;
- положительный coverage-gate требует lower bound не ниже `0,92` при цели `0,95`
  и заранее заданном non-inferiority margin `0,03`;
- bulk test-траектории используются только описательно.

Параметры и два root seed до запуска зафиксированы в
`PROTOCOL_LOCK_20260826_RU.md`: `20260826` и `20260827`. Фиксация является
внутренней записью в Git и не называется внешней пререгистрацией.

Обе серии выполнены и полностью воспроизведены независимым analyzer:

- seed `20260826`: `380/400`, coverage `0,95000`, exact 99% LCB `0,918599`;
- seed `20260827`: `379/400`, coverage `0,94750`, exact 99% LCB `0,915549`;
- агрегат: `759/800`, coverage `0,94875`, exact 99% LCB `0,927645`;
- агрегированный C6/raw hypervolume ratio: `0,784784`, wins `40/48`, sign-test
  `p=1,6526e-6`.

Агрегированный coverage и sharpness gates пройдены. Строгий общий replication gate
остаётся **не пройден**, потому что зафиксированный протокол требовал LCB не ниже
`0,92` также отдельно в каждой серии. Подробности и power-анализ приведены в
`RESULTS_20260826_20260827_RU.md`.

```powershell
py -3 -u tools\run_cyclic_conformal_reachability_lab.py `
  --repetitions 24 --train 220 --calibration 400 --test 800 --ood 200 `
  --steps 40 --burn-in 20 --coverage-probes 400 --seed 20260826 `
  --out c6_conformal_lab_seed_20260826.json
```

Вторая серия запускается с той же конфигурацией и `--seed 20260827`. Сохранённые
JSON и audit-файлы являются результатами этих команд.
