11lisov11/mic_practice/artifacts/live_bench_20261008/ACTIVE_PWM_RESULT_RU.txt

АКТИВНЫЙ ОБЕСТОЧЕННЫЙ ПРОГОН, 08.10.2026

Оператор подтвердил: 15 В и 220 В выключены.
Использован отдельный тестовый Nucleo 2026100899, производный от 2026100801.
Контроль нулевой ADC-шины, свежести ADC и ограничение выходов 15 сек сохранены.
Профиль HMI LV ограничивает каждый запуск 3 сек; этот лимит не увеличивался.
Команды START/STOP/задания отправлялись по Wi-Fi; анализатор снимал сигналы.

Подтверждено физическими захватами
- Импульсы на всех шести логических выходах.
- Несущая около 16000 Гц.
- В коротком захвате 24 МГц минимальный комплементарный зазор 1.333 мкс.
- В проверенных захватах перекрытия комплементарных импульсов не обнаружены.
- Есть захват непрерывного пуска/остановки с заданием 5 Гц на 4 МГц
  с исправленным декодером Uno 802 (active_pwm_801_r6).

Это не подтверждает устойчивое достижение электрических 5 или 20 Гц,
частоту ротора, пуск двигателя или защиту силового IPM.
Снятые импульсы относятся к ограниченному переходному процессу.
Производственная прошивка 801 при нулевой шине не запускалась: она сохраняет
защиту от недостаточного напряжения. Тест выполнен на отдельном образе 899.

Обнаруженные ограничения и дефекты
1. Тест ошибочно ждал дольше лимита LV 3 сек. Исправлено время захвата;
   защиты не ослаблены. Ошибочные ранние результаты сохранены как FAIL.
2. Длинный захват 24 МГц сорвался с ReadTimeout. Динамические захваты
   перенесены на 4 МГц; успешный короткий высокоточный подрезультат не скрывает
   общего FAIL предшествующего прогона.
3. В Uno 709 новые ID Nucleo 801/899 не были разрешены декодером диагностики.
   Причины аварий отображались как unavailable, а резервные байты могли
   отображаться как фиктивная телеметрия вентилятора.
   Исправлен только список известных диагностических ID и build ID Uno (802).
   Образ Uno 802 собран, записан и проверен штатным OpenOCD verify.
   Пассивно на плате подтверждено mc_diag_valid=1 для 801; причина LINK_TIMEOUT
   при тесте 899 также расшифрована. Режим управления не менялся.
4. В активном прогоне повторилась настоящая LINK_TIMEOUT: Nucleo зарегистрировала
   больше 300 мс без принятой команды. В снимке state=RUN (6), UART flags=0,
   MCSDK masks=0, first reason=13. Отсутствие принятой команды не означает,
   что физическая причина паузы уже найдена.
   Нельзя объявлять это NE-помехой, повышать watchdog или игнорировать аварию.
5. Отдельный host-тест нового декодера в Windows не выполнился: запуск
   decoder.exe получил access/sharing denial, затем файл не найден.
   Настройки защиты Windows/антивируса не отключались. Все 27 наборов для
   нового изменения не считаются пройденными: 26 PASS, один запуск заблокирован.
   Это ограничение сохранено в uno_decoder_802/regression_final/report.json.

Не завершено
Устойчивый пуск с заданием 20 Гц, полная последовательность STOP/ESTOP,
нулевого задания, runlimit, независимый heartbeat timeout и аппаратный BKIN.
Последовательность прерывалась и восстанавливала рабочую прошивку при сбое.
Нельзя считать выключенный уровень после watchdog доказательством STOP-команды.
Нельзя считать программный TIM1 BG доказательством всей защиты IPM; до этого
сценария данный прогон не дошёл.

Окончательное состояние
Рабочая Nucleo 2026100801 восстановлена после тестов и побайтно сверена
с подготовленным BIN: b10b9cda5bc2cf7ed6329bef7c14b42527ac6c745f76a75f304bc945014b4275.
Uno Q: 2026100802, исправленный диагностический декодер.
Её штатный flash verify прошёл; SHA-256 образа:
af84249cf0a0ada8b7ab5be186749d86bc69e2240563b6b7c9ea6add9aaeae23.
HMI обновлена для совместимости 802/801. Калибровка не переписана:
a89603c26f3dfa6287c304134121028db6ebdb9adeda4b58d99040530ffeea17.
В финальном 10-секундном Wi-Fi наблюдении: SAFE, PWM=0, ARM=0,
132 новых UART-сообщения, новых ошибок нет, максимальный возраст 52 мс.
AS5600 отвечает, но статус угла остаётся недостоверным.

Следующее необходимое действие
Добавить CH7 параллельно проводу Uno TX/D1 -> Nucleo RX/PB7, не разрывая UART.
Это позволит сопоставить принятые/переданные команды с ШИМ и измерить паузу.
220 В не подавать: полный прогон и физическая причина таймаута не закрыты.
