11lisov11/mic_practice/artifacts/production_recheck_20260927/RESULT_RU.md

# Повторная проверка стенда, 27.09.2026

## Результат

Рабочая прошивка UNO Q обновлена до **2026092702**, запись и чтение для проверки завершились успешно. Nucleo осталась на **2026091401**. Стенд оставлен в SAFE, VF, PWM=0, разрешение силового запуска снято. Высокое напряжение не подавалось.

## Исправления

1. При постоянной ошибке пониженного напряжения CLEAR раньше повторялся бесконечно. Nucleo при каждом CLEAR обнуляла счётчик ошибок приёма, что могло маскировать ошибки связи. Теперь завершение CLEAR подтверждается соответствующим ответом на конкретный запрос при выключенных выходах. Физическая ошибка напряжения сохраняется и продолжает блокировать запуск.
2. Проверка рабочего состояния теперь контролирует завершение CLEAR и изменение накопительных счётчиков ошибок, которые CLEAR не сбрасывает. Проверяются обе версии прошивок, конечный STOP, отсутствие разрешения запуска и корректность числовой телеметрии.
3. Утилита обновления по Wi-Fi теперь передаёт отдельный ключ управления для восстановительного CLEAR. Без него команда не отправляется; ключ прошивки не подставляется вместо ключа управления. Отсутствующие, отрицательные и нечисловые значения состояния больше не принимаются за исправный контроллер. Ошибка undervoltage по-прежнему не считается готовностью к работе двигателя.
4. Исправлены устаревшие тестовые данные STOP и тест номера сборки. Добавлены проверки отказа при неподтверждённом выключении выходов и отсутствующем ключе управления.

## Реальные измерения

Источник: `idle_validation/report.json`.

- 240 опросов за 195,218 с; принято 3428 новых ответов UART.
- Максимальный возраст ответа: 52 мс.
- CLEAR завершён: `bp_clear_pending=0` до и после наблюдения.
- Ошибки целостности: 0 -> 0; ошибки последовательности: 1 -> 1.
- Одна ошибка последовательности уже существовала до начала окна наблюдения. Её причина этим измерением не установлена. Корректный вывод: новых ошибок за окно не обнаружено, а не «ошибок никогда не было».
- Сбрасываемые счётчики ошибок на всём интервале равны нулю.
- Ожидаемая ошибка Nucleo: 5, undervoltage при отключённой шине.
- Запрос START без разрешения отклонён по Wi-Fi: HTTP 409.
- Физический Saleae, 24 Мвыб/с, фактическая запись 0,256 с: CH0-CH5 постоянно LOW, переходов нет. Это проверка выключенных выходов, не активного ШИМ.
- Завершающий STOP по Wi-Fi: HTTP 200, состояние SAFE подтверждено.
- 14 проверок отчёта пройдены.

Управляющие запросы отправлялись напрямую на Wi-Fi HTTP-интерфейс. ADB использовался для прошивки, чтения ключа и дополнительного чтения счётчиков, а не для управления двигателем.

## Программные проверки

Успешно выполнены:

- `verify_production_wifi_idle_selftest.py`: 4 теста.
- `superseded_reply_selftest.cpp`: проверка запоздалых ответов и подтверждения CLEAR.
- `uno_nucleo_mcsdk_contract_check.py`.
- `nucleo_firmware_safety_check.py`.
- `web_hmi_command_guard_selftest.py`: 155 проверок.
- `web_hmi_control_access_selftest.py`: 10 проверок.
- `unoq_wifi_firmware_update_selftest.py`.
- `configure_unoq_autonomous_wifi_selftest.py`.
- `mcsdk_release_preflight_selftest.py`.
- `saleae_pwm_analyze_selftest.py`.
- `run_wifi_nucleo_pwm_bench_selftest.py`: 13 тестов.
- `verify_board_flash_package_selftest.py`.

## Пакет и ограничения

Обновлены `firmware/ready_to_flash` и ZIP. Проверены 30 артефактов. Отчёт выключенных выходов привязан к текущим образам по SHA-256. Проверка физической силовой части остаётся `hardware_validated=false`.

Предыдущие активные диагностические испытания находятся в `artifacts/wifi_transitions_20260927_r7`. Они проводились с диагностическими прошивками и не являются испытанием активного ШИМ текущего рабочего образа. Предыдущий длительный тест нулевых счётчиков недостаточен сам по себе из-за обнаруженного повторения CLEAR; настоящий отчёт дополнительно проверяет несбрасываемые счётчики.

Не подтверждены аппаратное отключение SD/BKIN, точное подключение CH6 и питание J4, калибровка измерений шины, испытание внешнего плавного пуска и соответствие реального двигателя конфигурации. Для SD/BKIN необходимо уточнить фактическую схему подключения; ответ «вроде да» не доказывает её. Разрешение на силовой запуск этим отчётом не выдаётся.
