11lisov11/mic_practice/artifacts/active_probe_pilot_20260909_rev2/RESULTS_RU.md

# AIR56B2: информационный выбор парных проб

Численное исследование с энкодером и усреднённым инвертором. Не стенд и не доказательство новизны.
Прогонов: 224; численные критерии PASS: 224.
Незавершённые процедуры, отказы и отрицательная экономия не удалены.

Ревизия 2: после горизонта управления всем дан общий 1-секундный участок восстановления.
Его затраты включены. Проверяются также конечные потоковые состояния (с точностью общего угла),
скорость и запасённая энергия. Это численная сопоставимость с заданным допуском, не точное равенство.

| Горизонт, с | Метод | Пригодно / всего | Общая выборка | Принятий | Среднее снижение потерь, Дж |
|---|---|---:|---:|---:|---:|
| 3 | ungated | 15/16 | 15 | 0 | 0.121745 |
| 3 | budget_payback | 15/16 | 15 | 0 | 0.225213 |
| 3 | paired_fixed | 16/16 | 15 | 0 | 0.000000 |
| 3 | paired_cost | 16/16 | 15 | 0 | 0.000000 |
| 3 | active_fixed_cost | 16/16 | 15 | 0 | 0.000000 |
| 3 | active_cost | 16/16 | 15 | 0 | 0.000000 |
| 6 | ungated | 16/16 | 15 | 4 | 1.507090 |
| 6 | budget_payback | 15/16 | 15 | 0 | 0.232172 |
| 6 | paired_fixed | 15/16 | 15 | 0 | 0.181380 |
| 6 | paired_cost | 15/16 | 15 | 0 | 0.181380 |
| 6 | active_fixed_cost | 16/16 | 15 | 0 | -0.496445 |
| 6 | active_cost | 16/16 | 15 | 0 | -0.496445 |

Общая выборка требует пригодности всех шести адаптивных методов в одном сценарии.
Это условное сравнение после отбора по исходам, не несмещённая оценка на всей популяции.
Все затраты пуска, проб, удержания и возврата включены. Выигрыш по входной энергии не подменяет
снижение потерь: работа вала и запасённая энергия сохранены отдельно в study.json.

## Вся сетка: завершённые по времени

Средние ниже описательные: отказ или нарушение критериев не превращается в успешный опыт.
Аварийно прерванные временные горизонты не имеют сопоставимой экономии и в среднее не входят.
| Горизонт, с | Метод | Полный горизонт / всего | Среднее, Дж | Несовпавшие конечные состояния |
|---|---|---:|---:|---:|
| 3 | ungated | 16/16 | 0.118363 | 1 |
| 3 | budget_payback | 16/16 | 0.215364 | 1 |
| 3 | paired_fixed | 16/16 | 0.000000 | 0 |
| 3 | paired_cost | 16/16 | 0.000000 | 0 |
| 3 | active_fixed_cost | 16/16 | 0.000000 | 0 |
| 3 | active_cost | 16/16 | 0.000000 | 0 |
| 6 | ungated | 16/16 | 1.808055 | 0 |
| 6 | budget_payback | 16/16 | 0.186625 | 1 |
| 6 | paired_fixed | 16/16 | 0.118511 | 1 |
| 6 | paired_cost | 16/16 | 0.118511 | 1 |
| 6 | active_fixed_cost | 16/16 | -0.475384 | 0 |
| 6 | active_cost | 16/16 | -0.475384 | 0 |

## Проверка оценщика

Эталон ниже использует парный постоянный режим только после расчёта. Он недоступен регулятору.
Диагностика на редкой сетке трассы 5 мс, а не непрерывная или сертифицированная граница.
Завершённых парных циклов с сопоставимой трассой: 112; несопоставимых трасс: 0; оценка выигрыша вне своей эвристической ширины: 32.
Занижений прогнозной цены относительно редкосеточной оценки: 8; занижений времени возврата: 16.
Отдельно проверено эпизодов с учётом прерванных/финальных: 112; занижений цены без удержания: 8; незакрытых: 0.
Эти числа включают повторения сценариев разными методами и не являются независимой статистикой.

## Исходы

- 3 с, ungated: {'scheduled_return': 16}.
- 3 с, budget_payback: {'scheduled_return': 7, 'probe_energy_budget': 9}.
- 3 с, paired_fixed: {'no_profitable_measured_candidate': 16}.
- 3 с, paired_cost: {'no_profitable_measured_candidate': 16}.
- 3 с, active_fixed_cost: {'no_profitable_measured_candidate': 16}.
- 3 с, active_cost: {'no_profitable_measured_candidate': 16}.
- 6 с, ungated: {'insufficient_improvement': 4, 'baseline_repeat_drift': 8, 'scheduled_return': 4}.
- 6 с, budget_payback: {'insufficient_improvement': 3, 'probe_energy_budget': 12, 'payback_not_established': 1}.
- 6 с, paired_fixed: {'response_hypotheses_falsified': 2, 'baseline_drift': 8, 'no_profitable_measured_candidate': 6}.
- 6 с, paired_cost: {'response_hypotheses_falsified': 2, 'baseline_drift': 8, 'no_profitable_measured_candidate': 6}.
- 6 с, active_fixed_cost: {'no_profitable_measured_candidate': 8, 'baseline_drift': 8}.
- 6 с, active_cost: {'no_profitable_measured_candidate': 8, 'baseline_drift': 8}.

## Уточнение шага

Один заранее выбранный сценарий, шаг объекта 50/25/12,5 мкс; шаг регулятора неизменен.
| Метод | Разброс экономии, Дж | Разброс тока, А | Критерии выполнены |
|---|---:|---:|---|
| ungated | 0.021140 | 0.000650907 | True |
| budget_payback | 0.024716 | 0.000650907 | False |
| paired_fixed | 0.000958 | 0.000259441 | False |
| paired_cost | 0.000958 | 0.000259441 | False |
| active_fixed_cost | 0.000163 | 0.0002564 | True |
| active_cost | 0.000163 | 0.0002564 | True |

## Ограничения

Форма гипотез, линейность дрейфа, перенос цены между амплитудами и будущее сохранение режима
не доказаны. Завершение по мощности/скорости не удостоверяет восстановление магнитного состояния.
Два исходных двигателя не дают подтверждающего вывода о популяции. Нейросеть не обучена,
прошивки не менялись, научная новизна не установлена. Ближайшие известные методы разобраны
в research/AIR56B2_ACTIVE_PROBE_PRIOR_ART_RU.md; нельзя выдавать их сочетание за новое решение.
