11lisov11/mic_practice/artifacts/active_probe_smoke_20260909/RESULTS_RU.md

# AIR56B2: информационный выбор парных проб

Численное исследование с энкодером и усреднённым инвертором. Не стенд и не доказательство новизны.
Прогонов: 7; численные критерии PASS: 7.
Незавершённые процедуры, отказы и отрицательная экономия не удалены.

| Горизонт, с | Метод | Пригодно / всего | Общая выборка | Принятий | Среднее снижение потерь, Дж |
|---|---|---:|---:|---:|---:|
| 6 | ungated | 1/1 | 1 | 1 | 6.323307 |
| 6 | budget_payback | 1/1 | 1 | 0 | -0.495296 |
| 6 | paired_fixed | 1/1 | 1 | 0 | -0.823984 |
| 6 | paired_cost | 1/1 | 1 | 0 | -0.823984 |
| 6 | active_fixed_cost | 1/1 | 1 | 0 | -0.159588 |
| 6 | active_cost | 1/1 | 1 | 0 | -0.159588 |

Общая выборка требует пригодности всех шести адаптивных методов в одном сценарии.
Все затраты пуска, проб, удержания и возврата включены. Выигрыш по входной энергии не подменяет
снижение потерь: работа вала и запасённая энергия сохранены отдельно в study.json.

## Проверка оценщика

Эталон ниже использует парный постоянный режим только после расчёта. Он недоступен регулятору.
Диагностика на редкой сетке трассы 5 мс, а не непрерывная или сертифицированная граница.
Завершённых парных циклов: 8; оценка выигрыша вне своей эвристической ширины: 0.
Занижений прогнозной цены относительно редкосеточной оценки: 1; занижений времени возврата: 0.
Эти числа включают повторения сценариев разными методами и не являются независимой статистикой.

## Исходы

- 6 с, ungated: {'scheduled_return': 1}.
- 6 с, budget_payback: {'probe_energy_budget': 1}.
- 6 с, paired_fixed: {'no_profitable_measured_candidate': 1}.
- 6 с, paired_cost: {'no_profitable_measured_candidate': 1}.
- 6 с, active_fixed_cost: {'no_profitable_measured_candidate': 1}.
- 6 с, active_cost: {'no_profitable_measured_candidate': 1}.

## Уточнение шага

Не выполнено для этого отчёта; численные выводы предварительные.

## Ограничения

Форма гипотез, линейность дрейфа, перенос цены между амплитудами и будущее сохранение режима
не доказаны. Завершение по мощности/скорости не удостоверяет восстановление магнитного состояния.
Два исходных двигателя не дают подтверждающего вывода о популяции. Нейросеть не обучена,
прошивки не менялись, научная новизна не установлена. Ближайшие известные методы разобраны
в research/AIR56B2_ACTIVE_PROBE_PRIOR_ART_RU.md; нельзя выдавать их сочетание за новое решение.
