11lisov11/mic_practice/artifacts/energy_value_validation_20260910_rev4/RESULTS_RU.md

# AIR56B2: энергетическая ценность измерений

Источник результата: цифровая модель, усреднённый инвертор, энкодер и неизменный FOC.
Нейросеть, бездатчиковое управление и аппаратная безопасность этим опытом не подтверждаются.
Новый критерий исследуется как эвристика; научный приоритет не установлен.

## validation

Полная матрица: 768 прогонов; статусы {'PASS': 768}.

| T, с | Метод | Пригодны / всего | Принятия | Общая выборка n | Средняя экономия, Дж | Все полные, Дж |
|---|---|---|---|---|---|---|
| 3 | ungated | 31/32 | 0 | 31 | -0.0403 | -0.0507 |
| 3 | guarded_fit | 31/32 | 0 | 31 | -0.0403 | -0.0507 |
| 3 | entropy | 32/32 | 0 | 31 | 0.0000 | 0.0000 |
| 3 | greedy | 32/32 | 0 | 31 | 0.0000 | 0.0000 |
| 3 | greedy_high | 32/32 | 0 | 31 | 0.0000 | 0.0000 |
| 3 | greedy_menu | 32/32 | 0 | 31 | 0.0000 | 0.0000 |
| 3 | energy_value | 32/32 | 0 | 31 | 0.0000 | 0.0000 |
| 6 | ungated | 32/32 | 2 | 31 | 0.3240 | 0.3177 |
| 6 | guarded_fit | 32/32 | 2 | 31 | 0.3240 | 0.3177 |
| 6 | entropy | 32/32 | 0 | 31 | -0.5011 | -0.5309 |
| 6 | greedy | 31/32 | 0 | 31 | -0.1298 | -0.1020 |
| 6 | greedy_high | 31/32 | 0 | 31 | -0.8658 | -0.8974 |
| 6 | greedy_menu | 31/32 | 0 | 31 | -0.1298 | -0.1020 |
| 6 | energy_value | 32/32 | 0 | 31 | 0.0000 | 0.0000 |
| 12 | ungated | 32/32 | 2 | 31 | 1.4108 | 1.3587 |
| 12 | guarded_fit | 32/32 | 2 | 31 | 1.4108 | 1.3587 |
| 12 | entropy | 31/32 | 0 | 31 | -0.5176 | -0.5312 |
| 12 | greedy | 32/32 | 0 | 31 | -0.1471 | -0.1020 |
| 12 | greedy_high | 32/32 | 0 | 31 | -0.8572 | -0.8974 |
| 12 | greedy_menu | 32/32 | 0 | 31 | -0.1471 | -0.1020 |
| 12 | energy_value | 32/32 | 0 | 31 | 0.5854 | 0.6077 |

Общая выборка условна по исходам всех методов. Все полные прогоны включают
непригодные случаи и служат диагностикой, не доказательством эквивалентности работы.

Диагностика прогноза: 464 парных проб; выходов за эвристическую ширину: 144; недооценок цены эпизодов: 76 из 464 записей.

| T, с | EV минус конкурент | Прямо сопоставимы / всего | Преимущество EV, Дж |
|---|---|---|---|
| 3 | guarded_fit | 31/32 | 0.0403 |
| 3 | greedy | 32/32 | 0.0000 |
| 3 | greedy_high | 32/32 | 0.0000 |
| 3 | greedy_menu | 32/32 | 0.0000 |
| 3 | entropy | 32/32 | 0.0000 |
| 6 | guarded_fit | 32/32 | -0.3177 |
| 6 | greedy | 31/32 | 0.1298 |
| 6 | greedy_high | 31/32 | 0.8658 |
| 6 | greedy_menu | 31/32 | 0.1298 |
| 6 | entropy | 32/32 | 0.5309 |
| 12 | guarded_fit | 32/32 | -0.7510 |
| 12 | greedy | 32/32 | 0.7096 |
| 12 | greedy_high | 32/32 | 1.5050 |
| 12 | greedy_menu | 32/32 | 0.7096 |
| 12 | entropy | 31/32 | 1.1030 |

### Каждый исходный двигатель: EV

| Двигатель | T | Скорость | Скачок | Нач. нагрузка | Пригодны/всего | Экономия, Дж | Потери, % |
|---|---|---|---|---|---|---|---|
| s92063_motor0 | 3 | 0.3 | False | 0.25 | 2/2 | 0.0000 | 0.0000 |
| s92063_motor0 | 3 | 0.3 | True | 0.25 | 2/2 | 0.0000 | 0.0000 |
| s92063_motor0 | 3 | 0.7 | False | 0.25 | 2/2 | 0.0000 | 0.0000 |
| s92063_motor0 | 3 | 0.7 | True | 0.25 | 2/2 | 0.0000 | 0.0000 |
| s92063_motor0 | 6 | 0.3 | False | 0.25 | 2/2 | 0.0000 | 0.0000 |
| s92063_motor0 | 6 | 0.3 | True | 0.25 | 2/2 | 0.0000 | 0.0000 |
| s92063_motor0 | 6 | 0.7 | False | 0.25 | 2/2 | 0.0000 | 0.0000 |
| s92063_motor0 | 6 | 0.7 | True | 0.25 | 2/2 | 0.0000 | 0.0000 |
| s92063_motor0 | 12 | 0.3 | False | 0.25 | 2/2 | 0.2381 | 0.0868 |
| s92063_motor0 | 12 | 0.3 | True | 0.25 | 2/2 | 0.0968 | 0.0202 |
| s92063_motor0 | 12 | 0.7 | False | 0.25 | 2/2 | 1.1000 | 0.2197 |
| s92063_motor0 | 12 | 0.7 | True | 0.25 | 2/2 | 0.6767 | 0.0941 |
| s92063_motor1 | 3 | 0.3 | False | 0.25 | 2/2 | 0.0000 | 0.0000 |
| s92063_motor1 | 3 | 0.3 | True | 0.25 | 2/2 | 0.0000 | 0.0000 |
| s92063_motor1 | 3 | 0.7 | False | 0.25 | 2/2 | 0.0000 | 0.0000 |
| s92063_motor1 | 3 | 0.7 | True | 0.25 | 2/2 | 0.0000 | 0.0000 |
| s92063_motor1 | 6 | 0.3 | False | 0.25 | 2/2 | 0.0000 | 0.0000 |
| s92063_motor1 | 6 | 0.3 | True | 0.25 | 2/2 | 0.0000 | 0.0000 |
| s92063_motor1 | 6 | 0.7 | False | 0.25 | 2/2 | 0.0000 | 0.0000 |
| s92063_motor1 | 6 | 0.7 | True | 0.25 | 2/2 | 0.0000 | 0.0000 |
| s92063_motor1 | 12 | 0.3 | False | 0.25 | 2/2 | 0.1639 | 0.0506 |
| s92063_motor1 | 12 | 0.3 | True | 0.25 | 2/2 | 0.0606 | 0.0105 |
| s92063_motor1 | 12 | 0.7 | False | 0.25 | 2/2 | 1.0949 | 0.1851 |
| s92063_motor1 | 12 | 0.7 | True | 0.25 | 2/2 | 0.6991 | 0.0853 |
| s92064_motor0 | 3 | 0.3 | False | 0.25 | 2/2 | 0.0000 | 0.0000 |
| s92064_motor0 | 3 | 0.3 | True | 0.25 | 2/2 | 0.0000 | 0.0000 |
| s92064_motor0 | 3 | 0.7 | False | 0.25 | 2/2 | 0.0000 | 0.0000 |
| s92064_motor0 | 3 | 0.7 | True | 0.25 | 2/2 | 0.0000 | 0.0000 |
| s92064_motor0 | 6 | 0.3 | False | 0.25 | 2/2 | 0.0000 | 0.0000 |
| s92064_motor0 | 6 | 0.3 | True | 0.25 | 2/2 | 0.0000 | 0.0000 |
| s92064_motor0 | 6 | 0.7 | False | 0.25 | 2/2 | 0.0000 | 0.0000 |
| s92064_motor0 | 6 | 0.7 | True | 0.25 | 2/2 | 0.0000 | 0.0000 |
| s92064_motor0 | 12 | 0.3 | False | 0.25 | 2/2 | 0.1505 | 0.0625 |
| s92064_motor0 | 12 | 0.3 | True | 0.25 | 2/2 | 0.0529 | 0.0118 |
| s92064_motor0 | 12 | 0.7 | False | 0.25 | 2/2 | 1.0940 | 0.2568 |
| s92064_motor0 | 12 | 0.7 | True | 0.25 | 2/2 | 0.7040 | 0.1128 |
| s92064_motor1 | 3 | 0.3 | False | 0.25 | 2/2 | 0.0000 | 0.0000 |
| s92064_motor1 | 3 | 0.3 | True | 0.25 | 2/2 | 0.0000 | 0.0000 |
| s92064_motor1 | 3 | 0.7 | False | 0.25 | 2/2 | 0.0000 | 0.0000 |
| s92064_motor1 | 3 | 0.7 | True | 0.25 | 2/2 | 0.0000 | 0.0000 |
| s92064_motor1 | 6 | 0.3 | False | 0.25 | 2/2 | 0.0000 | 0.0000 |
| s92064_motor1 | 6 | 0.3 | True | 0.25 | 2/2 | 0.0000 | 0.0000 |
| s92064_motor1 | 6 | 0.7 | False | 0.25 | 2/2 | 0.0000 | 0.0000 |
| s92064_motor1 | 6 | 0.7 | True | 0.25 | 2/2 | 0.0000 | 0.0000 |
| s92064_motor1 | 12 | 0.3 | False | 0.25 | 2/2 | 0.4497 | 0.1719 |
| s92064_motor1 | 12 | 0.3 | True | 0.25 | 2/2 | 0.2605 | 0.0577 |
| s92064_motor1 | 12 | 0.7 | False | 0.25 | 2/2 | 1.7322 | 0.3843 |
| s92064_motor1 | 12 | 0.7 | True | 0.25 | 2/2 | 1.1487 | 0.1712 |

Процент относится к потерям двигателя в данном сценарии, не к его КПД в процентных пунктах.

## Интерпретация

Положительная экономия относительно fixed означает полезную адаптацию в указанных режимах,
но не превосходство над лучшим простым поиском. Для последнего нужны прямые сравнения выше.
В деталях сохранены каждый двигатель, скорость, нагрузка, отказы и неполные/несопоставимые опыты.
Варианты насыщения и режимы одного F1 не являются независимыми двигателями.
Цена прогнозируется эвристически; её 8 Дж не являются доказанным физическим ограничением.
Симуляция оплачивает электрические переходы и общий возврат, но не энергию процессора и задержки расчёта.
Все версии development сохранены; независимые результаты не использованы для изменения кода.

Архив source_snapshot.zip содержит вычислительное ядро, входные параметры и анализатор.
Это не полный репозиторий: установленный Python и полный набор тестов в архив не входят.
PowerShell-команда полного воспроизведения рассчитана на рабочий репозиторий с зависимостями.
