11lisov11/mic_practice/artifacts/probe_budget_pilot_20260909/RESULTS_RU.md

# AIR56B2: пилот энергетического бюджета проб

Новизна и преимущество не установлены заранее. Это усреднённая модель с энкодером, не стенд.
Предпосылки границ заданы приорами. Даже отсутствие обнаруженного нарушения не доказывает их выполнение.

Прогонов: 192; PASS численных критериев: 192.
Отказы и незавершённые пробы не удалены из study.json. Варианты насыщения не являются независимыми двигателями.

| Горизонт, с | Метод | Пригодно / всего | Общая выборка | Принятия | Средняя экономия потерь на общей выборке, Дж |
|---|---|---:|---:|---:|---:|
| 3 | fit | 0/16 | 0 | 0 | нет общей выборки |
| 3 | ungated | 16/16 | 0 | 0 | нет общей выборки |
| 3 | budget_only | 16/16 | 0 | 0 | нет общей выборки |
| 3 | payback_only | 16/16 | 0 | 0 | нет общей выборки |
| 3 | budget_payback | 16/16 | 0 | 0 | нет общей выборки |
| 6 | fit | 16/16 | 16 | 2 | 0.69870 |
| 6 | ungated | 16/16 | 16 | 2 | 0.60454 |
| 6 | budget_only | 16/16 | 16 | 0 | -0.07207 |
| 6 | payback_only | 16/16 | 16 | 0 | -0.03111 |
| 6 | budget_payback | 16/16 | 16 | 0 | -0.07207 |

Общая выборка требует пригодности всех пяти адаптивных вариантов в том же сценарии.
Её отсутствие не исправляется усреднением разных удобных подмножеств. В JSON дополнительно есть среднее
по завершившимся численно допустимым прогонам: это диагностика, а не сопоставимый итог.

## Исходы

- 3 с / fit: {'unfinished': 16}; предпосылки не опровергнуты наблюдениями: 0/16.
- 3 с / ungated: {'scheduled_return': 16}; предпосылки не опровергнуты наблюдениями: 8/16.
- 3 с / budget_only: {'scheduled_return': 8, 'probe_energy_budget': 8}; предпосылки не опровергнуты наблюдениями: 8/16.
- 3 с / payback_only: {'scheduled_return': 16}; предпосылки не опровергнуты наблюдениями: 8/16.
- 3 с / budget_payback: {'scheduled_return': 8, 'probe_energy_budget': 8}; предпосылки не опровергнуты наблюдениями: 8/16.
- 6 с / fit: {'insufficient_improvement': 6, 'baseline_repeat_drift': 8, 'held_candidate': 2}; предпосылки не опровергнуты наблюдениями: 0/16.
- 6 с / ungated: {'insufficient_improvement': 6, 'baseline_repeat_drift': 8, 'scheduled_return': 2}; предпосылки не опровергнуты наблюдениями: 8/16.
- 6 с / budget_only: {'insufficient_improvement': 4, 'probe_energy_budget': 12}; предпосылки не опровергнуты наблюдениями: 8/16.
- 6 с / payback_only: {'insufficient_improvement': 6, 'baseline_repeat_drift': 8, 'payback_not_established': 2}; предпосылки не опровергнуты наблюдениями: 8/16.
- 6 с / budget_payback: {'insufficient_improvement': 4, 'probe_energy_budget': 12}; предпосылки не опровергнуты наблюдениями: 8/16.

## Границы

Граница окупаемости относится к входной энергии, таблица показывает потери. Работа вала и запасённая
энергия сохранены отдельно в pairs. Прогноз будущей нагрузки отсутствует; объявленный срок задания
не гарантирует постоянства режима. Проверка погрешности мощности использует истинную энергию объекта
только для оценки результата, не передаёт её регулятору. Отдельный прогон с уменьшенным шагом для нового
механизма ещё необходим перед окончательными численными выводами. ИИ здесь не обучался.
