11lisov11/mic_practice/artifacts/probe_budget_smoke_20260909/RESULTS_RU.md

# AIR56B2: пилот энергетического бюджета проб

Новизна и преимущество не установлены заранее. Это усреднённая модель с энкодером, не стенд.
Предпосылки границ заданы приорами. Даже отсутствие обнаруженного нарушения не доказывает их выполнение.

Прогонов: 6; PASS численных критериев: 6.
Отказы и незавершённые пробы не удалены из study.json. Варианты насыщения не являются независимыми двигателями.

| Горизонт, с | Метод | Пригодно / всего | Общая выборка | Принятия | Средняя экономия потерь на общей выборке, Дж |
|---|---|---:|---:|---:|---:|
| 3 | fit | 0/1 | 0 | 0 | нет общей выборки |
| 3 | ungated | 0/1 | 0 | 0 | нет общей выборки |
| 3 | budget_only | 0/1 | 0 | 0 | нет общей выборки |
| 3 | payback_only | 0/1 | 0 | 0 | нет общей выборки |
| 3 | budget_payback | 0/1 | 0 | 0 | нет общей выборки |

Общая выборка требует пригодности всех пяти адаптивных вариантов в том же сценарии.
Её отсутствие не исправляется усреднением разных удобных подмножеств. В JSON дополнительно есть среднее
по завершившимся численно допустимым прогонам: это диагностика, а не сопоставимый итог.

## Исходы

- 3 с / fit: {'held_candidate': 1}; предпосылки не опровергнуты наблюдениями: 0/1.
- 3 с / ungated: {'scheduled_return': 1}; предпосылки не опровергнуты наблюдениями: 1/1.
- 3 с / budget_only: {'scheduled_return': 1}; предпосылки не опровергнуты наблюдениями: 1/1.
- 3 с / payback_only: {'scheduled_return': 1}; предпосылки не опровергнуты наблюдениями: 1/1.
- 3 с / budget_payback: {'scheduled_return': 1}; предпосылки не опровергнуты наблюдениями: 1/1.

## Границы

Граница окупаемости относится к входной энергии, таблица показывает потери. Работа вала и запасённая
энергия сохранены отдельно в pairs. Прогноз будущей нагрузки отсутствует; объявленный срок задания
не гарантирует постоянства режима. Проверка погрешности мощности использует истинную энергию объекта
только для оценки результата, не передаёт её регулятору. Отдельный прогон с уменьшенным шагом для нового
механизма ещё необходим перед окончательными численными выводами. ИИ здесь не обучался.
