11lisov11/mic_practice/docs/experiments/AIR56B2_PREREGISTRATION_RU.md

# Предрегистрация стендового исследования AIR56B2

Версия: 1.0

Дата фиксации: 2026-08-28
Статус: подготовлено до получения силовых плат; аппаратные результаты отсутствуют.

## 1. Цель

Проверить, снижает ли ограниченная адаптация потоковой уставки расчётные и затем измеренные электрические потери асинхронного привода AIR56B2 относительно двух базовых алгоритмов: фиксированного потока и классической оптимизации потерь. Сравнение выполняется при совпадающих скорости, нагрузке, температурном коридоре и временном окне.

## 2. Проверяемые гипотезы

- H0: средняя парная разность первичной метрики между исследуемым алгоритмом и настроенным классическим FOC равна нулю или хуже нуля.
- H1: исследуемый алгоритм уменьшает первичную метрику без ухудшения заранее заданных ограничений по току, скорости, температуре и срабатываниям защиты.
- Результат не считается положительным, если снижение входной энергии получено за счёт меньшей механической нагрузки, меньшей скорости или неполного выполнения задания.

## 3. Алгоритмы и порядок допуска

1. `VF_FIXED`: скалярное V/f, только ввод в эксплуатацию и проверка фазировки.
2. `FOC_FIXED`: FOC с фиксированной потоковой уставкой после аппаратной идентификации.
3. `FOC_CLASSICAL`: классическая ограниченная оптимизация потерь или проверенный LUT.
4. `AI_SHADOW`: нейронная политика вычисляет предложение, но оно не применяется.
5. `AI_ACTIVE`: предложение политики проходит supervisor, ограничения скорости изменения и fallback.
6. `EXTREMUM_SEARCH`: ограниченный поиск экстремума допускается только после определения измеримого прокси потерь и времени установления режима.

Переход через этап запрещён, если не закрыт предыдущий gate. Порядок активных алгоритмов внутри разрешённой серии рандомизируется; V/f не участвует в энергетическом сравнении с FOC как равноправный оптимум.

## 4. Первичная и вторичные метрики

Первичная метрика до установки датчика момента: парная входная энергия звена постоянного тока на установившемся интервале при совпадающих скорости и внешней нагрузке,

`E_dc = integral(U_dc * I_dc dt)`.

Если установлен и откалиброван датчик момента или нагрузочная машина, первичной метрикой становится КПД `eta = P_mech / P_dc`, а входная энергия сохраняется вторичной метрикой.

Вторичные метрики: средняя и максимальная ошибка скорости, RMS и пик фазного тока, температура двигателя и радиатора, число переключений, оценка пульсаций момента, число fallback, OOD-события, fault-коды и время безопасной остановки.

## 5. Факторы и блокирование

- Частоты: 5, 15, 30 и 50 Гц. Sensorless-режим при 5 Гц заранее считается неподтверждённым и исследуется только диагностически.
- Нагрузки: 25, 50, 75 и 100 % номинального момента после допуска нагрузочной системы.
- Температурные блоки: холодный и прогретый; границы уточняются пилотной серией и затем не меняются.
- Каждый блок содержит парные прогоны алгоритмов на одном механическом режиме.
- Между прогонами контролируются начальная температура, напряжение звена и состояние защит.

## 6. Объём выборки

Сначала выполняется пилотная серия не менее пяти полных пар на безопасной нагрузке. По дисперсии парных разностей рассчитывается число повторов для двустороннего уровня значимости `alpha=0,05` и мощности не ниже `0,8`. Пилотные данные не объединяются с подтверждающей серией, если по ним изменялись алгоритм, метрика, фильтрация или критерии исключения.

Доверительные интервалы строятся парным bootstrap. Кластером является физический цикл или температурный блок, а не отдельный отсчёт телеметрии. Для множественных вторичных сравнений заранее применяется поправка Holm.

## 7. Критерии включения и исключения

Включается только опыт с валидными хэшами прошивок и конфигурации, завершённой калибровкой, совпадающим заданием, устойчивым интервалом и полным журналом.

До анализа исключаются:

- операторский аварийный останов по внешней причине;
- потеря питания измерительной системы;
- доказанный обрыв или насыщение измерительного канала;
- выход начальной температуры за заранее установленный коридор;
- изменение механической нагрузки или конфигурации между членами пары.

Fault, OOD, fallback, превышение тока, потеря UART/Wi-Fi и срабатывание защиты не исключаются как «неудобные данные». Они остаются результатом опыта и учитываются как нарушение ограничений.

## 8. Критерии безопасности и остановки

Серия немедленно прекращается при превышении аппаратного или программного тока, отказе break/OCP/E-stop, недопустимом нагреве, потере управления PWM, неустойчивом росте скорости, неверной фазировке либо невозможности подтвердить разряд звена. Средняя экономия не компенсирует ни одного нарушения безопасности.

## 9. Прослеживаемость

Для каждого опыта обязательны Git commit и tag, SHA-256 прошивок Nucleo и UNO Q, версия MCSDK, ревизии плат, идентификатор двигателя, схема соединений, напряжение звена, лимиты тока, калибровки, температура, алгоритм, seed рандомизации и полный fault-log. Исходные журналы являются неизменяемыми; очищенные наборы строятся отдельным воспроизводимым скриптом.

## 10. Границы текущего утверждения

SIL-результаты формируют гипотезу и проверяют программную реализацию. Они не доказывают экономию на физическом двигателе. Аппаратная формулировка допускается только после выполнения настоящего протокола и публикации сырых журналов, калибровок, кода обработки и доверительных интервалов.

До закрытия всех стендовых ворот программный флаг `hardware_release_ready=false` не изменяется.
