11lisov11/mic_practice/artifacts/live_bench_20261008/uno_async_804/RESULT_RU.txt

РЕЗУЛЬТАТ ОТЛАДКИ БЕЗ ВМЕШАТЕЛЬСТВА В UART-ПРОВОДА, 08.10.2026

Установлены: Uno Q 2026100804 / Nucleo 2026100801.
Изменение проводки и параллельный CH7 не потребовались.
Силовое и J4 выключены; активные логические проверки выполнялись на отдельном
Nucleo 2026100899, производном от 801, с контролем нулевой шины и лимитом 15 сек.
HMI LV ограничивает каждую попытку 3 сек; этот лимит не увеличивался.
Рабочая Nucleo 801 восстановлена после каждого прогона и сверена с BIN.

Наблюдавшаяся проблема
В версии Uno 803 измерена пауза основного цикла 365867 мкс,
между завершениями вызовов отправки 365866 мкс, ответов 423832 мкс.
Максимальный вызов write занимал 77 мкс, неполных write не было.
Nucleo зафиксировала LINK_TIMEOUT без флагов UART hardware errors.
Это показывает локальную задержку обслуживания на Uno, но не является
прямым измерением фронтов на TX и не устанавливает точную длительность
какого-либо одного mutex/RPC ожидания.

Изменение 804
Убраны синхронные Monitor-логи и bridge_tick из основной петли.
Логи попадают в ограниченную очередь 16 x 96 байт; служба низкого приоритета
обслуживает Monitor/RPC, регистрация и переподключение разрешены вне активного PWM.
Отложенные строки помечаются LOG DEFERRED с исходным MCU timestamp, не выдаются
за текущую STAT-телеметрию. Переполнение/слишком длинная строка считаются явно.
UART-отправка и все управляющие/защитные решения остаются на прежнем пути.
Не создан отдельный поток, бесконтрольно продолжающий ENABLE при зависшем цикле.
115200, 50 мс, 300-мс watchdog и пределы ARM/RUNLIMIT сохранены.

Проверки ПО
27 основных наборов: PASS. Дополнительные link_timing_selftest и
deferred_log_selftest: PASS. Проверены FIFO/переполнение очереди, насыщение,
переходы активного/неактивного состояния, rollover и отсутствие blocking IPC
в основной петле. Образ 804 собран, записан и сверён штатным flash verify.
Ранее блокировавшийся тест декодера теперь выполнился без изменения защиты ОС.

Два последовательных активных логических прогона
active_pwm_804_async_r1/report.json: PASS.
active_pwm_804_async_r2/report.json: PASS.
В обоих прошли снимки несущей/комплементарных выходов при заданиях 5 и 20 Гц,
STOP, ESTOP, частота 0, RUNLIMIT, программное событие TIM1 BG и отказ повторного
START после защиты. После прекращения heartbeat выходы LOW; в логе есть
OPERATOR_HEARTBEAT_LOST. Точная независимая задержка этой остановки не измерена.
Высокоточный короткий подрезультат deadtime (~1.333 мкс, 24 МГц) взят из
предыдущего захвата с идентичным Nucleo-образом и Uno 709; его происхождение
и общий FAIL старого прогона явно сохранены в high_resolution_reuse.
Текущие непрерывные переходы снимались на 4 МГц, перекрытия не обнаружены.

Показатели 804
После r1: loop max=171062 мкс, TX gap max=211296 мкс, RX gap max=219059 мкс.
После r2: loop max=171601 мкс, TX gap max=215575 мкс, RX gap max=219059 мкс.
Счётчики Uno между этими прогонами не перезагружались; вторые значения —
накопленные максимумы, не независимая статистическая выборка.
Снижение наблюдаемого TX max относительно проблемного 803: около 41%.
Неполных write=0, потерянных логов=0, очередь после прогона пуста.
Новых ошибок целостности/последовательности в финальной телеметрии нет.
Это поддерживает гипотезу о блокирующем IPC в основном пути, но не является
сертифицированной границей jitter, доказательством всех нагрузок или EMI-тестом.

Финальная проверка
По Wi-Fi за 15 сек: 182 новых UART-сообщения, без новых ошибок,
максимальный возраст 53 мс. SAFE, PWM=0, ARM=0, Vdc=0 по телеметрии.
Профиль HMI восстановлен HV, существующая калибровка сохранена побайтно:
a89603c26f3dfa6287c304134121028db6ebdb9adeda4b58d99040530ffeea17.
Uno 804 flash SHA-256:
fa2410d4775bdf264c35d77a10c44d283deaf39cea02444eda312a0137a43c36.
Рабочая Nucleo 801 BIN SHA-256:
b10b9cda5bc2cf7ed6329bef7c14b42527ac6c745f76a75f304bc945014b4275.

Не подтверждено
Работа производственной 801 с силовым питанием, истинная установившаяся
электрическая частота 20 Гц и вращение ротора, физическая цепь PA6/IPM OC/UVLO,
силовой soft-start, поведение при исходных силовых NE-помехах.
AS5600 отвечает, но angle_ok остаётся false (status 0x33).
Программный BG не заменяет физический стимул PA6/защиты IPM.
Логический прогон не является разрешением включить 220 В.
