11lisov11/mic_practice/research/AIR56B2_ACTIVE_PROBE_RESULTS_RU.md

# AIR56B2: результат следующего исследовательского этапа

Дата: 09.09.2026. Основной результат: `artifacts/active_probe_pilot_20260909_rev2`.
Это законченная проверка конкретного прототипа, не завершение всей научной задачи.

## Краткий вывод

Информационный выбор парных проб с эмпирической ценой возврата **не дал
преимущества** в этом пилоте. Он не принимается как основной метод исследования
или кандидат доказанной научной новизны. Настройки ради положительного итога
не подгонялись; отрицательные результаты и отказы сохранены.

Разработаны причинный супервизор ABA, отбор гипотез отклика, выбор пробы по
информации о решении, оценка цены цикла/возврата по измерениям, повторная
проверка кандидата и журнал завершённых/прерванных эпизодов. Контроллер не
получает истинные параметры объекта, скрытый поток, будущую нагрузку или
результат парного контрольного прогона. Это не обучение нейросети.

## Итог по энергии

224 прогона: 32 сценария, семь методов. Два исходных двигателя, два варианта
насыщения каждого, две скорости, два горизонта, без скачка/со скачком нагрузки.
Все 224 прошли численные критерии, но не все пары прошли конечные допуски.

Ниже среднее снижение потерь относительно постоянного возбуждения, на **одной
общей пригодной выборке 15 сценариев**. Горизонт управления 6 с, после него
ещё 1 с восстановления у всех методов; энергия посчитана за полные 7 с.

| Метод | Снижение потерь, Дж |
|---|---:|
| Прежний поиск с плановым возвратом, без бюджетных ограничений | +1,507090 |
| Прежний фиксированный бюджет | +0,232172 |
| Парные пробы фиксированного порядка | +0,181380 |
| Информационный выбор проб | -0,496445 |

Включение измеренной цены вместо фиксированной не изменило ни одной
управляющей траектории в обоих порядках выбора: максимальное отличие `id_ref`
равно нулю, последовательности фаз и суммарные потери совпадают. Значит,
полезность именно обучения стоимости данным опытом **не показана**.

Все четыре парных варианта приняли ноль кандидатов. На горизонте 3 с они
вообще не меняли исходное задание: одинаковые нулевые результаты не являются
успешным обучением. Прежний поиск принял четыре кандидата на горизонте 6 с.

Общая выборка условна по исходам и не является несмещённой оценкой популяции.
На всей сетке из 16 завершённых 7-секундных опытов описательные средние:
прежний поиск +1,808055 Дж; парные фиксированные +0,118511 Дж;
активный выбор -0,475384 Дж. Здесь также присутствуют случаи, не прошедшие
допуски конечного состояния; они не объявлены пригодными задним числом.

## Проверка самого оценщика

Офлайн-аудит на сетке трассы 5 мс, не строгая непрерывная граница:

- 112 завершённых парных циклов; в 32 оценка выигрыша вышла за свою
  эвристическую ширину. Все эти нарушения пришлись на сценарии со скачком
  нагрузки: 32 из 48 циклов против 0 из 64 без скачка.
- Прогноз цены занижен в восьми циклах варианта `paired_cost`.
- Прогноз длительности возврата занижен в 16 циклах фиксированного порядка.
- Одинаковые сценарии повторены разными методами: 112 циклов не означают
  112 независимых двигателей или независимых статистических испытаний.

Дрейф опорного режима обнаруживался после измерения, и кандидат отвергался.
Но такой отказ не делает предыдущую оценку выигрыша достоверной. Эмпирическая
цена, разброс окна и максимум прошлых возвратов не стали сертификатами.

## Уточнение шага и ограничения

21 дополнительный прогон: один заранее выбранный сценарий, семь методов,
шаг объекта 50/25/12,5 мкс при неизменном шаге регулятора 100 мкс.
Для активного селектора разброс итоговой экономии всего 0,000163 Дж:
его отрицательный результат в этом примере не исчез при уточнении.

Прежний бюджет и оба фиксированных парных варианта не прошли **полный** критерий
уточнения: на шаге 50 мкс конечное отличие скорости составляло 0,129-0,132 рад/с
при заранее принятом допуске 0,1. Поток и запасённая энергия укладывались
в свои допуски; разброс энергии между шагами был менее 0,025 Дж.
Допуски не ослаблялись.

Дополнительная, не предзаданная диагностика среднего за последние 0,2 с дала
отличия скорости 0,0003-0,0025 рад/с. Это указывает на чувствительность проверки
по единственному конечному отсчёту, а не доказывает устойчивое невосстановление
скорости. Эта диагностика не меняет исходную пригодность. Для будущего опыта
нужен заранее определённый критерий восстановления по окну и состояниям.

Это усреднённый цифровой объект с энкодером и модельным внутренним FOC.
Переключательные потери, реальное железо, sensorless и нейропрошивка не проверены.
Двух исходных моделей недостаточно для подтверждающего статистического вывода.

## Что действительно продвинулось

1. Закрыты восемь замечаний программного/методического ревью, включая ложную
   экономию при раннем аварийном выходе и потерю журналов прерванного возврата.
2. Проверены 922 теста основного исследования и 34 теста FOC/PPO.
3. Получено разделение: измеренная стоимость прошлого цикла, прогноз будущего
   и независимая оценка результата. Они больше не выдаются друг за друга.
4. Зафиксирована граница идентифицируемости: ABA точно убирает аффинный общий
   тренд, но не произвольную смену нагрузки или скрытое изменение состояния.
5. Шесть ближайших первичных работ не позволяют объявить само сочетание ABA,
   активного обучения и цены переключения новым научным принципом.

## Следующая проверяемая постановка

Сначала проверить оценивание и различимость, затем выбор действия. Нужна
совместная область допустимых **эффекта нагрузки, полезного контраста и
состояния восстановления**, а не только множество стационарных кривых мощности.
При неразличимости правильный результат может быть «нужна дополнительная
проба/измерение», но полезность такого запроса должна окупаться.

Отдельная рабочая гипотеза: выбирать пробу по ожидаемому уменьшению ошибки
энергетического решения, а не по количеству бит информации о номере лучшего
кандидата. Это ещё не реализованный и не доказанно новый метод. Нужны сравнение
с value-of-information/dual-control аналогами, калибровка ошибок при меняющейся
нагрузке и независимые двигатели. Простая замена сетки гипотез нейросетью
выявленные ограничения не устраняет.

## Файлы и воспроизведение

- `research/AIR56B2_ACTIVE_PROBE_PROTOCOL_RU.md`: протокол и исправления v2.
- `research/AIR56B2_ACTIVE_PROBE_IDENTIFIABILITY_RU.md`: выводы и контрпримеры.
- `research/AIR56B2_ACTIVE_PROBE_PRIOR_ART_RU.md`: шесть близких первоисточников.
- `research/AIR56B2_ACTIVE_PROBE_REVIEW_RU.md`: замечания и регрессионные тесты.
- `artifacts/active_probe_pilot_20260909_rev2/RESULTS_RU.md`: автоматически
  построенные таблицы; рядом полные `study.json`, аудит, PNG/SVG и манифесты.
- `artifacts/active_probe_pilot_20260909_rev2/source_snapshot.zip`: 74 исходных
  файла/входа из манифеста плюс протокол и средства сборки отчёта. Это снимок
  исходников, не архив установленной среды Python.

Из корня репозитория одна команда, с новым каталогом результата:

```powershell
powershell -ExecutionPolicy Bypass -File tools/run_air56b2_active_probe.ps1
```

Платы и прошивки в этом этапе не трогались.
