11lisov11/mic_practice/research/AIR56B2_BUDGET_RESULTS_RU.md

# AIR56B2: результат проверки кандидата с бюджетом проб

Дата: 09.09.2026. Основной результат: **преимущество текущей конфигурации не
подтвердилось, самостоятельная научная новизна не установлена**. Это не означает
бесполезность любых энергетических ограничений; отклоняется именно проверенный
набор механизма, приоров и фиксированной последовательности проб как основание
для заявления о новом эффективном регуляторе.

## Что выполнено

- Аудит 12 ближайших первичных работ, включая 2026 год.
- Реализованы счётчик дискретных энергозатрат проб, резерв возврата и условная
  проверка окупаемости; выполнены отключения каждого ограничения отдельно.
- Первая серия 192 опытов сохранена как диагностическая ревизия.
- Независимое ревью выявило контрпримеры; исправлены устаревание среднего,
  преждевременное завершение возврата, пропуски данных при удержании,
  историческая проекция после раннего отказа и стоимость не начатой пробы.
- Основная исправленная серия: 192 опыта, все прошли численные критерии модели.
  810 исследовательских тестов и отдельные 34 теста FOC/PPO прошли.
- Рисунки PNG/SVG открыты и визуально проверены. Прошивки и платы не изменялись.

## Сопоставимые результаты

Два исходных F1-образца, два варианта насыщения, две скорости, наличие/отсутствие
ступени нагрузки и два горизонта. Варианты одного двигателя не считаются
независимыми двигателями. Одна реализация шума, без статистического обобщения.
Сравнение относительно FOC с постоянным возбуждением; положительная величина
означает снижение полной энергии потерь, отрицательная - её увеличение.

Горизонт 6 с, общая пригодная выборка 16/16 сценариев для всех методов:

| Метод | Принято настроек | Среднее снижение потерь, Дж |
|---|---:|---:|
| Исходный аналитический поиск | 2/16 | +0,69870 |
| Поиск с запланированным возвратом, без новых ограничений | 2/16 | +0,60454 |
| Только бюджет | 0/16 | -0,07207 |
| Только проверка окупаемости | 0/16 | -0,03111 |
| Бюджет и окупаемость | 0/16 | -0,07207 |

В сравнении с одинаковым протоколом возврата добавленные ограничения ухудшили
среднюю экономию на 0,67660 Дж за 6 с. Это описательное среднее небольшого пилота,
не доверительный интервал. Отказы не исключались из сравнения. Полезная работа
между сравниваемыми опытами отличается не более чем на 1 %; запасённая энергия
и входная энергия опубликованы отдельно.

За 3 с исходная последовательность не завершилась в 16/16 сценариев, поэтому
общая пригодная выборка с этим методом отсутствует. Четыре варианта с возвратом
завершились, но не приняли ни одной новой настройки. Дополнительное сравнение
между ними дало около +0,00294 Дж эффекта бюджета, при этом сам бюджетный вариант
в среднем расходовал на 0,02123 Дж больше энергии потерь, чем постоянный поток.
Такой небольшой межалгоритмический эффект не используется как доказательство
нового преимущества, тем более без отдельной проверки шага для коротких циклов.

## Почему нет энергетического сертификата

В 72 из 128 офлайн-проверок четырёх вариантов с бюджетным учётом истинная
контрфактическая мощность исходного прогона вышла за заданную полосу дрейфа.
Это включает все проверенные случаи ступени нагрузки и часть стационарных
случаев; число 128 не является числом независимых двигателей.

Онлайн-супервизор этой истинной мощности не получал. В офлайн-проверке она
использовалась только для попытки опровергнуть предпосылки. Даже отсутствие
выявленного выхода на прореженной сетке не доказывает межотсчётное покрытие.
Для исходного `fit` эта проверка неприменима, поскольку он не строит бюджетных
границ; ноль в служебном счётчике его отчёта не означает провал такой гарантии.

Фиксированные границы оказались одновременно ограничительными для полезных
настроек и недостаточно обоснованными для изменяющегося режима. Простой подбор
более удобных порогов после этих результатов не будет новым методом.

## Проверка численного шага

Дополнительно выполнены 12 прогонов: один исходный объект `motor0_k0`, скорость
70 %, без ступени нагрузки, постоянный период регулятора/датчиков 100 мкс и
шаги объекта 50 / 25 / 12,5 мкс. Настройки, датчики и шум при измельчении объекта
не менялись. Разброс экономии потерь: `ungated` 0,014261 Дж, `payback_only`
0,001972 Дж, `budget_payback` 0,005477 Дж. Все три проверки прошли порог
0,05 Дж; исходы решений сохранились. Максимальный разброс пикового тока
около 0,000096 А. Это проверка одного контрольного случая, не всех 32 сценариев.

Данные: `artifacts/probe_budget_refinement_20260909_rev2/refinement.json`.
Они дополняют основной автоматически сформированный отчёт, созданный до
завершения проверки шага; итог проверки включён в `ASSUMPTIONS_RU.md`.

## Решение по исследованию

Текущий код сохраняется как воспроизводимый сравнительный метод и отрицательный
результат. Не переносится в прошивку как новый ИИ-регулятор. Более содержательная
следующая гипотеза: получать связанную с неопределённым состоянием двигателя
оценку стоимости восстановления и выбирать информативные пробы по их цене.
Она пока не реализована и не признана новой: см. `AIR56B2_RESEARCH_DECISIONS_20260909_RU.md`.

## Файлы и воспроизведение

- `artifacts/probe_budget_pilot_20260909_rev2/RESULTS_RU.md`: автоматически сформированная таблица.
- `artifacts/probe_budget_pilot_20260909_rev2/ASSUMPTIONS_RU.md`: диагностика предпосылок и отключений.
- `artifacts/probe_budget_pilot_20260909_rev2/study.json`: все 192 опыта и парные результаты.
- `artifacts/probe_budget_pilot_20260909_rev2/budget_all_cases.png`: все сценарии, включая непригодные пары.
- `artifacts/probe_budget_pilot_20260909_rev2/budget_trace.png`: иллюстративные траектории, не средний результат.
- `AIR56B2_BUDGET_PROTOCOL_RU.md`: предпосылки, исходный протокол и поправки ревью.
- `AIR56B2_NOVELTY_AUDIT_20260909_RU.md`: литература и границы новизны.

Из корня проекта одной командой:

```powershell
powershell -ExecutionPolicy Bypass -File tools/run_air56b2_probe_budget.ps1
```

Команда выполняет тесты, серию, анализ, рисунки и проверку измельчения объекта.
Она требует нового выходного каталога, чтобы не перезаписать предыдущий опыт.
Манифесты фиксируют исходники, настройки и контрольные суммы результатов.
Модель усреднённая, с энкодером; потери инвертора, ШИМ и аппаратная безопасность
в эту проверку не входят. Паспортное соответствие расширенной модели во всех
режимах и аппаратное подтверждение остаются отдельными задачами.
