11lisov11/mic_practice/research/AIR56B2_DYNAMIC_POWER_RESULTS_RU.md

# AIR56B2: динамическая проверка энергетической адаптации

## Статус и границы вывода

Это воспроизводимый вычислительный пилот, не испытания двигателя и не подтверждение готовности прошивки. Проверяется усреднённая модель на клеммах двигателя. Потери инвертора, переключения ключей, аппаратная защита, Wi-Fi/UART и время исполнения на MCU в этот эксперимент не входят. Энкодер используется; бездатчиковый режим не проверен.

- Прогонов: 32; прошли численные критерии: 32.
- Независимых исходных F1-образцов: 2; варианты насыщения, скоростей и нагрузок не считаются новыми независимыми двигателями. В этой серии используется одна реализация измерительного шума для каждой пары, без статистического обобщения на парк двигателей.
- Допустимых пар для сравнения: 16 из 16. Оба прогона должны завершиться, сохранить допустимые ток и ошибку скорости; различие полезной работы не более 1 %. Нужен завершённый цикл проб, включая откат.
- Финальное принятие настройки: 2 из 16.
- Среднее снижение энергии потерь по допустимым парам за 6 с: 0.6987 Дж. Отрицательный результат означает увеличение потерь. Это описательное среднее, не доверительный интервал.
- Максимальная невязка баланса одного шага: 2.634e-14 Дж.

Токовый критерий: максимальная наблюдаемая в расчёте амплитуда вектора тока не более 3,1 А. Скоростной критерий: средняя абсолютная ошибка на интервале от 1,2 с до конца опыта менее 3 рад/с. Это не ограничение мгновенного всплеска ошибки; переходы нагрузки включены в это среднее.

## Методика

Сравниваются одинаковые разгон, нагрузка, модель двигателя и реализация шума. Регулятор получает ток, реконструированное напряжение и оценку скорости по квантованному энкодеру. Истинные момент нагрузки, температуры и поток регулятору не передаются. Для всех объектов используются одни холодные параметры первого F1-образца.

Исходная F1-модель ограничена округлёнными паспортными данными. Горячие сопротивления и механические потери взяты из F2-приоров. Новая ветвь Rc влияет на ток, а не добавляется к мощности постфактум. Насыщение задано отдельной пассивной гипотезой, не параметрами, якобы измеренными по паспорту. После изменения структуры модели паспортное соответствие всех режимов заново не доказано.

Последовательность: исходный поток → пониженный → повышенный → повтор исходного → проверка кандидата. Учитываются ограничение скорости изменения задания, выдержка, устойчивость мощности и скорости, дрейф повторной пробы и минимальный выигрыш 2 Вт. Нарушение условий вызывает отказ и возврат к исходному заданию. Это надзорная логика, не аппаратная защита.

Ступень нагрузки в этой серии задаётся на 2,6 с, во время проб. После принятия кандидата сохраняется проверка корректности наблюдений и электрических пределов, но повторная оптимизация после позднего изменения нагрузки автоматически не запускается. Для неё нужен отдельный детектор смены режима.

Полезная работа и изменение запасённой энергии учитываются отдельно: Eвх = Aвала + ΔW + Eмедь_с + Eмедь_р + Eсталь + Eтрение. Поэтому разгон, недоотпущенная работа и изменение магнитной энергии не выдаются за снижение потерь.

## Все парные результаты

| Объект | Скорость / nном | Ступень нагрузки | Допустима | ΔEвх, Дж | ΔEпотерь, Дж | ΔAвала, Дж | ΔW, Дж |
|---|---:|---|---|---:|---:|---:|---:|
| motor0_k0 | 30% | Нет | Да | -0.5241 | -0.5238 | -0.0000 | 0.0003 |
| motor0_k0 | 70% | Нет | Да | 6.9996 | 6.9194 | 0.0095 | -0.0898 |
| motor0_k0 | 30% | Да | Да | 0.3835 | 0.3883 | 0.0048 | -0.0000 |
| motor0_k0 | 70% | Да | Да | -0.2701 | -0.2653 | 0.0048 | 0.0000 |
| motor0_k0.4 | 30% | Нет | Да | -0.2865 | -0.2865 | 0.0000 | -0.0000 |
| motor0_k0.4 | 70% | Нет | Да | 5.5030 | 5.4590 | 0.0229 | -0.0669 |
| motor0_k0.4 | 30% | Да | Да | 0.0649 | 0.0849 | 0.0200 | 0.0000 |
| motor0_k0.4 | 70% | Да | Да | -0.2199 | -0.1998 | 0.0203 | -0.0002 |
| motor1_k0 | 30% | Нет | Да | -0.5275 | -0.5276 | -0.0000 | -0.0001 |
| motor1_k0 | 70% | Нет | Да | 0.0651 | 0.0641 | -0.0001 | -0.0009 |
| motor1_k0 | 30% | Да | Да | 0.4023 | 0.4080 | 0.0057 | 0.0000 |
| motor1_k0 | 70% | Да | Да | -0.1609 | -0.1546 | 0.0061 | 0.0001 |
| motor1_k0.4 | 30% | Нет | Да | -0.3326 | -0.3327 | -0.0000 | -0.0001 |
| motor1_k0.4 | 70% | Нет | Да | 0.1514 | 0.1520 | 0.0001 | 0.0005 |
| motor1_k0.4 | 30% | Да | Да | 0.0960 | 0.1179 | 0.0218 | 0.0001 |
| motor1_k0.4 | 70% | Да | Да | -0.1446 | -0.1242 | 0.0229 | -0.0025 |

ΔE = постоянный поток минус адаптация; ΔAвала и ΔW = адаптация минус постоянный поток.

## Исходы проб

- `baseline_repeat_drift`: 8.
- `committed`: 2.
- `insufficient_improvement`: 6.

## Проверка численного шага

Контрольный случай: первый объект, линейное намагничивание, скорость 70 % номинальной, нагрузка 25 %.
В whole-loop меняются также частота регулятора и физическая постоянная фильтра скорости. В plant-only период регулятора и датчиков остаётся 100 мкс; напряжение и нагрузка удерживаются между обновлениями, используются те же отсчёты шума. Это отделяет дискретизацию объекта от изменения контроллера.

| Проверка | Шаг объекта, мкс | Шаг регулятора, мкс | ΔEпотерь, Дж | Исход |
|---|---:|---:|---:|---|
| Основная | 50 | 100 | 6.91941 | committed |
| Whole-loop | 50 | 50 | 7.00906 | committed |
| Whole-loop | 25 | 25 | 7.01057 | committed |
| Plant-only | 50 | 100 | 6.91941 | committed |
| Plant-only | 25 | 100 | 6.93421 | committed |
| Plant-only | 12.5 | 100 | 6.93490 | committed |

Контроль сходимости объекта при неизменном контроллере: PASS. Разброс снижения потерь 0.01549 Дж (порог 0,05 Дж); разброс пикового тока 0.00010 А (порог 0,05 А). Дополнительно во всех вариантах требуются сохранение допустимости пары, токового критерия и исхода принятия настройки. Whole-loop показан отдельно: смена регулятора/фильтра не является чистой ошибкой интегрирования объекта.
Основная серия использует шаг объекта 50 мкс при периоде регулятора 100 мкс. Исходный шаг объекта 100 мкс дал около 7,002 Дж в контрольном опыте, но не выполнил допуск 0,05 Дж относительно измельчения объекта; поэтому он не оставлен основным результатом.

Отдельный тест сравнивает всю траекторию токов и интегралы потерь с Radau при Rc = 1200 и 4000 Ом из предварительно намагниченного состояния. Шаг 100 мкс не разрешает произвольный быстрый переход тока стали; при 0,5 мкс в проверенном тесте ошибка траектории меньше 0,005 А. Сохранение энергии не подменяет эту проверку.

## Что это меняет в гипотезе исследования

1. Статический минимум потерь недостаточен. Критерий запуска проб должен учитывать ожидаемую длительность режима и полную энергию настройки. Проверять нужно условие Eзатрат < ΔP × Tоставшееся, а не только ΔP > 0.
2. Устойчивость наблюдателя важнее малой прибавки эффективности. Токовый наблюдатель избегает чистого интегрирования ошибки Rs, но сохраняет зависимость от Rr/Lr и ошибки из-за насыщения и тока стали. Его преимущество не является доказательством model-free управления.
3. Старые нейросетевые веса пока нельзя объявлять пригодными для этой динамики: они обучались на другом статическом отображении мощности. Следующий набор данных должен содержать полные переходы, время установления, затраты проб и отказы. Разделять обучение и проверку нужно по двигателям, а не по соседним отсчётам.
4. При сравнении ИИ с аналитическим регулятором нужны одинаковые датчики, токовые ограничения, качество отработки нагрузки и бюджет проб. Отказы остаются в статистике; итоговое улучшение не обещается заранее.

## Воспроизведение

`powershell -ExecutionPolicy Bypass -File tools/run_air56b2_dynamic_power.ps1`

Данные: `artifacts/dynamic_power_adaptation_20260908/`. Манифест сохраняет хеши исходников, параметров и результатов. Рисунок: `output/figures/dynamic_power_adaptation_20260908/`. Уравнения и источники: `research/AIR56B2_ENERGY_CORE_THEORY_RU.md`.
