11lisov11/mic_practice/research/AIR56B2_ENERGY_VALUE_VALIDATION_REVIEW_RU.md

# AIR56B2: независимое ревью проверки энергетической ценности проб

Дата: 09.09.2026. Статус: **предлагаемый проспективный протокол, не результат испытаний**.
Последующее ревью реализаций rev2/rev3 и актуальное решение перед held-out находятся
в дополнении в конце документа; исходная проектная записка сохранена ниже.
В этой работе прочитаны результаты, prior art, протокол v2, супервизоры и средства
сравнения. Новая реализация не проверялась; расчёты объекта и тесты не запускались.
Изменён только этот документ. Код, платы, прошивки и прежние результаты не менялись.

## 1. Вопрос и граница вывода

Проверяемая гипотеза: при неизменной измерительной процедуре выбор следующего
действия по прогнозу **чистой энергии за оставшийся горизонт**, включая время и
цену пробы, проверки и возврата, полезнее прежнего information/cost. Действия:
сохранить A, проверить и принять уже измеренного кандидата, выполнить ещё одну ABA.
Раннее принятие означает переход в `candidateverify`, а не обход свежей проверки.

Положительный результат требует сравнения не только с неудачным информационным
селектором, но и с прежним сильным аналитическим поиском `ungated` и простым
парным first-good. Преимущество над entropy/cost само по себе недостаточно.

Основание: в [результатах пилота](C:/mic_practice/research/AIR56B2_ACTIVE_PROBE_RESULTS_RU.md)
на общей пригодной выборке 15 сценариев с горизонтом 6 с прежний ungated дал
`+1,507090 Дж`, информационный селектор `-0,496445 Дж` относительно постоянного
возбуждения. Все парные варианты приняли ноль кандидатов; при 3 с не двигали
задание. Это уже просмотренные design-данные, не независимое подтверждение
следующей гипотезы. Их условную выборку нельзя переносить в новый опыт.

Ожидаемый вклад пока следует называть **проверкой KG/VOI-подобной эвристики
управления измерениями**. Новый научный принцип, байесовская оптимальность,
калиброванная вероятность и аппаратная безопасность не установлены.

## 2. Неизменяемый контракт

Главная реализация: decision-only subclass от `ActiveProbeSupervisor`.
Допустимы новая логика `_decide`, чистые функции оценки действий и её журнал.
Не менять `step`, `_accept_window`, сбор окон, ABA-оценку, отсев гипотез,
slew, проверку кандидата, возврат, приоритет аварии или критерии оценки результата.
Для одинаковой истории и принудительно одинакового решения измерительный автомат
должен выдавать те же фазы и задания, что исходный класс.

Настройки сверены с [активным супервизором](C:/mic_practice/research/mic_ai_theory/snh_pwm/source/control/air56b2_active_probe.py),
[измерительным автоматом](C:/mic_practice/research/mic_ai_theory/snh_pwm/source/control/air56b2_dynamic_probe.py)
и [протоколом v2](C:/mic_practice/research/AIR56B2_ACTIVE_PROBE_PROTOCOL_RU.md).

| Что заморожено | Значение / правило |
|---|---|
| Задания | A = 0,83 А; low = 0,65; high = 1,00; внутренние = 0,74 и 0,915 А |
| Измерения | Начало не ранее 1,6 с; slew 1,5 А/с; settle 0,15 с; окно 0,12 с; deadline стадии 1,2 с |
| Установление и допуск | Ошибка скорости 3 рад/с; power CV 0,03; абсолютный допуск мощности 2 Вт; repeat drift 4 Вт |
| Электрические ограничения | Ток 3,1 А; напряжение 170 В; наблюдаемый voltage cap может только ужесточать предел |
| Эвристические ограничения | gain error floor 1 Вт; baseline slope 4 Вт/с; improvement margin 2 Вт |
| Бюджет парных методов | Не более 2 проб; прогноз потраченного плюс следующего цикла <= 8 Дж; projected net строго > 0,1 Дж |
| Прогноз цены | Приор 10 Вт; floor 0,1 Дж; multiplier 1,5; прежний перенос по амплитуде без изменений |
| Прогноз времени возврата | Прежняя `return_s`, включая margin 0,15 с и эмпирическое увеличение времени |
| Модель отклика | Те же 225 гипотез; пустое множество = отказ; не расширять сетку после неудачи |
| Время опыта | Горизонт T = 3 или 6 с; затем одинаковый хвост восстановления 1 с; энергия за 4 или 7 с |
| Численная схема | Регулятор 100 мкс; объект 50 мкс; уточнение 25/12,5 мкс при том же регуляторе |

`decision_regret_w = 2` остаётся неизменным у прежнего entropy-селектора.
Его использование как старого правила остановки не обязательно для нового EV:
именно сравнение stop/continue заменяется. Это не разрешение менять порог
фактического принятия 2 Вт или энергетический порог 0,1 Дж.

Сохранить FOC, его tuning, наблюдатель, инвертор, датчики и начальные состояния
объекта, интеграторов, угла, фильтров и истории энкодера. Каждый метод стартует
из одинакового состояния сценария; внутри прогона никаких сбросов или бесплатного
preconditioning. Предыдущий измерительный интервал поступает до нового действия.
Разрешены время, измеренные мощность/ток/напряжение, скорость энкодера и её задание.
Истинные внутренние состояния объекта, нагрузка и парный контрольный прогон
доступны только офлайн-оценщику. Объявленный T доступен всем; будущий скачок
нагрузки недоступен.

## 3. Проверяемое определение ценности действия

### 3.1. Одинаковый момент отсчёта

Решение принимается после исходного окна A или завершённого ABA, при времени t
и причинной истории D. Два разных регистра затрат не смешивать:

- `S_plus(D)`: прежний положительный перерасход завершённых циклов, для бюджета
  и существующего payback gate. Он не обнуляется при новом решении.
- Знаковая энергия полного прогона: итог эффективности, включая все отказы,
  отрицательные выигрыши, восстановление и незаконченные эпизоды.

Для ранжирования **будущих** действий уже понесённая стоимость общая и сокращается.
Нельзя вычесть её только из commit, но не из probe, или повторно на каждом уровне
lookahead. При этом прежний допуск принятия, включающий `S_plus`, сохраняется:
данный эксперимент не проверяет отмену этого консервативного ограничения.

### 3.2. Stop, commit и ещё одна проба

Обозначения: `K(D)` = уже измеренные кандидаты, допустимые по прежним gates;
`g_k` = прогноз контраста мощности; `C_vr(k)` = стоимость перехода на k, свежей
проверки и окончательного возврата; `tau_vr(k)` = их суммарное время.
Безразмерных битов в энергетической оценке нет: Вт умножаются на секунды.

```text
H_k(t) = max(0, T - t - tau_vr(k))
U(k | D,t) = E[g_k * H_k(t) - C_vr(k) | D]
V_stop(D,t) = max(0, max_{k in K(D)} U(k | D,t))

Q_probe(q | D,t) = E_Y[-C_ABA(q,Y) + V_stop(D_qY, t + tau_ABA(q,Y)) | D]
Delta_probe(q) = Q_probe(q | D,t) - V_stop(D,t)
```

Здесь 0 означает оставаться в A **с текущего момента**, а не стереть ранее
истраченную энергию. `D_qY` содержит результат гипотетического наблюдения Y и
обновлённый бюджет. Стоимость ABA включает её собственный возврат; `C_vr` относится
к следующему отдельному эпизоду verification/hold/return. Ни один возврат не
учитывается дважды. Общий хвост 1 с не добавляется к выгодному времени удержания.

Это эталон смысла оценки, а не требование добавить модель двигателя. Если
используются прежние `cycle_cost` по положительному перерасходу и равные веса
гипотез, U/Q являются **энергетическим суррогатом**, не математическим ожиданием
фактической знаковой экономии. Не приписывать ему точную байесовскую интерпретацию.
Если возможность отказа свежей проверки не моделируется, явно записать допущение
успешной проверки и проверить его ошибки; не называть такой прогноз безусловным.

Сначала применять прежние ограничения допустимости; затем сравнивать лучший
commit, лучшую пробу и A на одном остатке времени. Продолжать только если лучшая
проба строго выгоднее остановки. При равенстве предпочесть допустимый commit,
затем A; ничьи проб разрешать исходным индексом. Численную точность сравнения
заморозить до held-out, не превращать её в подбираемый энергетический запас.
Перед commit и после свежего окна выполняются **все прежние** пороги принятия.

Для ветви q -> k прогноз должен тратить время/цену q и затем k, а не два раза
дешёвой q. Исходный `3*stage_s(q)+return_s(q)` не доказывает осуществимость
будущего перехода на другое k. Проверять остаток, накопленный бюджет и возможность
verification/return отдельно в каждой ветви. Невыполнимая ветвь заканчивается A
с уже уплаченной ценой, а не удаляется из среднего.

Одношаговый lookahead с энергетическим горизонтом следует так и называть.
Он не решает точно всю конечногоризонтную задачу: две последовательно полезные
пробы могут иметь ценность, не видимую одношаговому правилу. Рекурсию глубины 2,
если она выбрана вместо глубины 1, необходимо объявить до теста, а не включать
после просмотра неудачи. Ограничение исполнения в две пробы не меняется.

### 3.3. Защита от оракула в ожидании

Правильная структура: усреднить по наблюдению Y, **внутри каждой наблюдаемой
ветви** выбрать действие по условному среднему оставшихся гипотез.
`E_Y[max_k E[U_k | D,Y]]` не равно `E_h[max_k U_k(h)]`: второе разрешает
узнать истинную гипотезу бесплатно и систематически завышает пользу исследования.
При одинаковом Y решение должно быть одинаковым, даже если скрытые h разные.

Заморозить разбиение исходов, веса, прогноз ширины нового окна и правило
обновления. Каждая гипотеза/шумовой исход учитывается один раз; вероятности ветвей
суммируются в 1. Перекрывающиеся интервалы совместимости нельзя считать
непересекающимися исходами. Пустые, дорогие, неокупаемые и дрейфующие ветви не
выбрасывать с перенормировкой на благоприятные. Жёсткий отсев и равные веса
существующего набора не превращаются автоматически в posterior.

## 4. Обязательные конкуренты и контроль механизма

| Метод | Точное назначение |
|---|---|
| `fixed` | Постоянные 0,83 А; полный одинаковый горизонт и хвост; опорный энергетический контроль |
| `ungated` | Существующий `BudgetedDynamicProbeSupervisor` с `budget_gate=False`, `payback_gate=False`; аналитический fit, штатная проверка и плановый возврат |
| `greedy_LH` | ABA(low); при первом достаточном измеренном кандидате немедленно штатная verification; иначе ABA(high), затем штатное решение или отказ |
| `greedy_HL` | То же с заранее обращённым порядком; обязательная защита от специально неудобного порядка у простого baseline |
| `active_cost` | Прежний information/cost с измеренной ценой без изменений |
| `energy_value` | Новый порядок/stop по энергетическому суррогату, тот же измерительный автомат и цена |

**First-good**: достаточность определяется прежним измеренным нижним суррогатом
выигрыша, временем, бюджетом и projected net; не ожиданием доказательства
глобального максимума. Он не обязан выполнить high после уже достаточного low.
Если свежая проверка не прошла, сохраняется штатный отказ, без нового бесплатного
поиска. Budget, cost learning, возврат, журналирование и отказы гипотез такие же,
как у нового парного метода; меняется только решение. Две отдельные ABA, а не
low/high без промежуточного A. Равные бюджеты не требуют равного фактического
числа проб: именно возможность потратить меньше и проверяется.

`ungated` нельзя ослабить, добавив ему новый gate 8 Дж/0,1 Дж, или заменить
прежним неудачным `budget_payback`. Он намеренно ungated, с исходной ценой
реального исполнения. Его аналитический fit может предлагать промежуточное
задание: запрещать это ради равенства с четырьмя точками нового метода нельзя.
Это сравнение полных методов, а не контролируемая абляция одной строки.

Для утверждения о механизме, а не только об эффективности пакета, до теста
назначить две абляции: EV-порядок с first-good stop; фиксированный low/high-порядок
с EV-stop. Все остальные правила прежние. Поскольку EV может выбирать внутренние
точки, дополнительно сравнить EV с тем же меню `{low, high}` либо явно ограничить
вывод эффектом всего пакета «меню + порядок + stop». Нельзя приписывать выигрыш
сложному VOI, если его воспроизводит простой first-good или только смена меню.
Для отдельного заявления об обучении цены нужны fixed-cost/learned-cost варианты
с реально различными действиями. Это не обязательное заявление данного этапа.

## 5. Design, заморозка и held-out

1. **Design:** seeds 92061 и 92062 вместе со всеми уже просмотренными вариантами,
   smoke, rev1/rev2 и уточнениями. На них разрешены выбор глубины, discretization,
   tie-break и исправление ошибок. Их результаты не входят в prospective summary.
2. **Заморозка:** одна основная версия кандидата, сравнения, матрица, число исходных
   двигателей, прогнозная модель, метрики, допуски и правила остановки серии.
   Сохранить SHA-256 точных файлов, конфигов, генераторов и входов, версии среды.
   Git HEAD недостаточен: исследовательские файлы сейчас также untracked/modified.
3. **Ограниченный следующий пилот:** предлагается seed 92063, первые 8 базовых F1;
   у каждого насыщение 0/0,4, скорости 0,3/0,7, T=3/6, без/со скачком в 2,6 с.
   Получается 128 сценариев и 768 прогонов шести основных методов. Шум seed 730
   одинаков по времени для методов сценария. Это фиксированный объём, не расчёт
   мощности подтверждающего исследования. Иной ресурсный объём допустим только
   как явно записанная замена **до открытия held-out**.
4. **Следующие seeds 92064+:** не резерв «искать до успеха». Для репликации заранее
   задать полный диапазон и N либо отдельную следующую серию. После просмотра
   92063 любые изменения делают его design для новой версии; результаты первой
   версии остаются опубликованными. Повтор того же seed не новый holdout.
5. Все методы получают те же исходные модели/сценарии и детерминированные шумовые
   последовательности, не RNG, расход которого зависит от числа проб. Нельзя
   передавать селектору seed, case id или disturbance flag как подсказку будущего.

Предварительно проверить фактическую неизученность 92063 по журналам основного
исследования. В `build_cases(count, seed)` генератор F2 использует `seed+1`:
число 92063 могло уже использоваться как **другой** поток случайности. Само
совпадение чисел не доказывает повтор двигателей, а новый номер не доказывает
независимость; проверять роль потока и фактические векторы параметров. Не менять
генератор после обнаружения неудобных двигателей. При overlap до оценки энергии
отвести новую непересекающуюся серию. Основанием замены служит пересечение наборов,
а не энергетический исход; сохранить причину и все уже полученные результаты.

В [генераторе прогона](C:/mic_practice/research/mic_ai_theory/snh_pwm/source/tools/run_air56b2_dynamic_power.py)
холодная модель FOC строится из `f1[0]` для всей серии. Нельзя дать EV отдельный
FOC или ретюнинг по held-out. Для статистики различать независимые базовые моторы
и общий случайно полученный контроллер серии: вариации насыщения, режимы, шумы,
циклы и разные методы не являются независимыми двигателями. Если FOC меняется
между seed-блоками по прежнему генератору, вывод условен для этих блоков; нельзя
считать каждый режим независимой репликой нового привода.

## 6. Энергетический исход и полный знаменатель

Основной эффект против каждого конкурента B:

```text
d_i(B) = loss_j(B, i) - loss_j(energy_value, i)
```

Положительное значение означает преимущество EV. Обе энергии за один полный
опыт 4/7 с, от общего начала; не среднее только после commit. Основная матрица
равновзвешена по базовым двигателям и 16 режимам внутри каждого. Отдельные
таблицы 3/6 с, со скачком/без него и насыщения обязательны, но не выбирают
главный результат задним числом. Экономия против `fixed` и прямой эффект
против `ungated`/greedy показываются одновременно.

Баланс: `E_terminal = E_loss + E_shaft + Delta W`. Поэтому
`loss_B-loss_EV = input_B-input_EV - (shaft_B-shaft_EV) - (DeltaW_B-DeltaW_EV)`.
Показывать все члены и остаток. Не вычитать магнитную энергию ещё раз из уже
посчитанной `loss_j`. Контроллер оптимизирует суррогат клеммной мощности, а не
имеет доступ к истинным потерям; их совпадение требует проверки работы и состояний.

Сохранить существующие `PASS` и пригодность из
[средства сравнения](C:/mic_practice/research/mic_ai_theory/snh_pwm/source/tools/run_air56b2_active_probe.py):

- Полный горизонт и число шагов; нет observer clipping; нет превышений 3,1 А
  на подшагах объекта; установившаяся MAE скорости < 3 рад/с; ошибка баланса
  каждого шага < 1e-8 Дж. Не заменять это одним флагом «вернулся».
- Работа относительно fixed отличается не более чем на `0,01*max(abs(W_fixed),1 Дж)`.
- Финальное задание равно 0,83 А с прежней точностью `1e-12`; отличие скорости
  <= 0,1 рад/с, изменения запасённой энергии <= 0,01 Дж, потокового состояния
  после прежнего выравнивания общего угла <= 0,001 Вб; процедура завершена.

Для прямого EV-B вывода дополнительно показывать их взаимные work/state-разности:
пригодность каждого относительно fixed сама по себе не гарантирует такой же
допуск между ними. Требование прямой сопоставимости может только ужесточить
сравнение, не исправляет старые отказы.

**Три обязательных представления, без смены знаменателя:**

1. Полный список запланированных сценариев: PASS/FAIL, endpoint/work mismatch,
   таймаут, invalid measurements, отказ гипотез, отказ проверки, ранний возврат,
   пропуски и незаконченные эпизоды. Отказ без движения не равен аварии, но
   остаётся исходом стратегии; нулевая экономия не равна успешному обучению.
2. Энергия всех полно-длительных прогонов, включая непригодные по допускам,
   с явной меткой «описательная, не доказательство равноценной работы».
   При аварийном усечении `d_i=null`, не ноль и не выгодная разность с полным B.
3. Общая пригодная выборка основных методов и парные пригодные выборки,
   с числами исключений по причинам и всем двигателям. Среднее здесь условно
   по исходам и не является несмещённым средним всей популяции.

Отдельно дать таблицу для каждой пары: оба пригодны / только EV / только B /
оба непригодны; внутри первой группы выигрыши, ничьи, проигрыши. Это не
энергетическая импутация авариям. Не «компенсировать» новые аварии средними джоулями.
Для безусловного заявления об энергетическом превосходстве на всей матрице
нужны полные и сопоставимые исходы всех обязательных сравнений. Иначе допускается
только явно условный энергетический вывод вместе с результатом по отказам.

## 7. Что считать положительным результатом

**Следующий малый пилот:** честный положительный описательный результат возможен,
если на заранее назначенной сетке EV экономит относительно fixed и обоих сильных
типов конкурентов, выдерживает неизменные допуски и уточнение. Числа и отрицательные
страты публикуются целиком. Это результат на этих цифровых объектах, не доказанная
эффективность на случайном двигателе. Победа только над `active_cost` означает
исправление прежней неудачной стратегии, а не превосходство над поиском вообще.

**Для подтверждающего вывода:** до отдельного held-out назначить число независимых
базовых объектов, минимально значимый эффект и анализ мощности по design, с учётом
внутридвигательной зависимости. Два design-мотора не дают надёжной оценки мощности.
Предлагаемый минимальный эффект для протокола: `delta = 0,10 Дж` за полный опыт,
а не 0,1 Вт или процент от выбранной части траектории. Это отдельный критерий
результата, хотя численно он совпадает с прежним payback margin.

Для каждого независимого базового объекта сначала получить среднее парное d по
его режимам. Доверительные интервалы строить по этим объектам/независимым блокам,
не по отсчётам, ABA и строкам методов. При cluster bootstrap сохранять вместе
все варианты объекта; метод и RNG анализа фиксируются до теста. Малое число
независимых блоков не исправляется большим числом bootstrap-повторов.

Четыре заранее назначенных энергетических требования: против fixed, ungated,
greedy_LH, greedy_HL. Консервативный критерий: односторонние нижние границы с
Bonferroni `alpha=0,05/4` каждая выше delta, без ухудшения допустимости; проверка
численной устойчивости тоже обязательна. Нельзя выбрать лучший seed, один
горизонт или удобный порядок greedy по итогам. Непройденная граница означает
«преимущество не установлено», а не равенство методов. Простое ненахождение
значимого роста отказов не является доказательством неухудшения безопасности.

Механизм оценивать отдельно: число и амплитуды проб, время входа в verification
и commit, оставшееся удержание, стоимость query/return и verification/return,
ошибки прогнозов, доля ложных принятий и отказов. Определение ложного принятия
заморозить: например, `ever_committed` при неположительной полной экономии
относительно fixed среди сопоставимых опытов; несопоставимые принятые вынести
отдельно. Показать также случаи полезного удержания, не окупившего прошлые пробы.
Одинаковые `id_ref` и фазы означают отсутствие доказанного влияния компонента.

## 8. Минимальный независимый аудит до раскрытия held-out

Это задания основной реализации/проверке, **не выполненные здесь тесты**.

1. На ручных конечных примерах: дорогая/долгая информативная проба проигрывает
   доступному commit; дешёвая проба, способная изменить решение, выигрывает;
   нулевой остаток времени не разрешает probe/commit; отсутствие полезных
   кандидатов сохраняет A. Включить вариант, где ценна только пара будущих проб,
   чтобы явно показать ограничение одношаговой аппроксимации.
2. Проверить условное ожидание по совпадающим наблюдениям, массу ветвей,
   невозможный исход, все отрицательные выигрыши, дорогого лучшего кандидата
   и второго допустимого. Проверить реальную стоимость перехода q -> A -> k.
3. Sunk cost: равная прибавка к прошлым затратам не меняет разность будущих
   ценностей при неактивных gates; при срабатывании прежнего бюджета/payback
   отказ законен. Нет обнуления spent, бесплатной verification, отрицательной
   длительности, двойного кредита полезного участка или возврата.
4. Replay одной и той же истории при разных скрытых параметрах/метках будущего
   даёт одинаковое решение. Контрфактический fixed, истинные потери и будущие
   измерения отсутствуют среди входов селектора и его rollout.
5. При принудительно одинаковых решениях автомат наследника совпадает с исходным.
   Регрессии: NaN/ток/напряжение одновременно с scheduled return; смена задания
   во всех фазах; sample gap; пустое множество гипотез; отказ свежей проверки;
   прерванный возврат. Опасное измерение имеет приоритет над плановым завершением.
6. Независимый бухгалтер проверяет отсутствие дыр и двойного учёта интервалов.
   Исторические окна A могут коррелировать контрасты; частота 10 кГц не создаёт
   10 тысяч независимых наблюдений в секунду. При скачке нагрузки прежняя
   эвристическая ширина не превращается в доверительную границу.
7. Воспроизвести прежние design-выводы и траектории untouched-конкурентов в пределах
   прежней численной схемы. Не использовать новые значения только у baseline.
   Для прогнозов стоимости/длительности публиковать ошибки и недооценки, включая
   открытые эпизоды с неизвестной полной ценой, а не только удачные завершения.

Отдельно измерить время вычисления решения и память lookahead. Усреднённая
симуляция с неизменным dt не оплачивает автоматически задержку вычислений:
соблюдение периода 100 мкс на железе и энергия процессора здесь не проверяются.
Не объявлять выигрыш энергии двигателя выигрышем всего вычислительного привода.

Уточнение заранее: первый held-out мотор, без насыщения, скорость 0,7, без скачка,
T=6; **все основные методы**, подшаг 50/25/12,5 мкс. Требования прежние:
одинаковые исходы, разброс экономии < 0,05 Дж, пика тока < 0,05 А и полный
endpoint/work PASS на каждом шаге. Дополнительно знак прямого преимущества
EV-ungated/greedy не должен исчезать. Если новая политика меняет победителя
при уточнении, это нерешённая численная чувствительность, не подтверждение.
Диагностику по последним 0,2 с можно показать, но она не заменяет конечный отсчёт.
Расширение уточнения на дополнительные случаи не должно вытеснять этот тест.

## 9. Главные способы получить ложное превосходство

| Ловушка | Защита протокола |
|---|---|
| Сравнить только с неудачным entropy или gated budget | Обязательны исходный ungated и first-good обоих порядков |
| Заставить greedy всегда сделать две пробы | Принять первый достаточный измеренный вариант через штатную verification |
| Выдать экономию от early stop за новый VOI | Отдельные абляции порядка/stop и контроль одинакового меню |
| Максимизировать отдельно для каждой скрытой h | Решение одно на наблюдаемую ветвь; максимум условных средних |
| Считать биты, умноженные на T, энергетической ценностью | U/Q в джоулях, явные gain, time, costs и branch feasibility |
| Не оплатить задержку, проверку, повтор или возврат | Общий физический таймер, отдельные полные эпизоды, общий хвост |
| Назвать равные веса posterior, а floor доверительным интервалом | Явная модельная эвристика; независимый аудит ошибок и смены режима |
| Прогнозировать успешную проверку во всех ветвях | Указать допущение и ошибки; не удалять неудачные исходы из ожидания |
| Получить эффект за счёт разряда потока или меньшей работы | Полный баланс, work/state допуски и прямое сравнение EV-B |
| Выбросить невосстановившиеся/аварийные сценарии | Полный знаменатель, null для усечения, таблица всех причин |
| Ослабить endpoint после неудобного финального отсчёта | Прежние допуски; окно только как дополнительная диагностика |
| Перенастроить сетку, FOC, noise, horizon или вернуть holdout в тест | Заморозка и журнал ревизий; новый просмотренный набор становится design |
| Использовать 128 режимов как 128 независимых двигателей | Кластер базового F1; учитывать общий FOC seed-блока |
| Остановить серию после положительного среднего | Фиксированные N, seed-список и полный список jobs до запуска |

Все попытки сохраняются: параметры, исходники/хеши, строки каждого job, полные
доступные трассы, решения до наблюдения исхода, завершённые и открытые эпизоды,
исключения и причины остановки. Новый каталог каждой ревизии; никаких перезаписей
rev1 положительным rev2. Сбой инфраструктуры отличать от отказа метода; повторять
только тот же зафиксированный job с сохранением обеих попыток. Публикация должна
объяснять каждую отсутствующую строку, даже если процесс не дошёл до `study.json`.

## 10. Три ближайших первичных VOI/KG-источника

Поиск и чтение первичных текстов выполнены через web 09.09.2026. Запросы:
`Frazier Powell Dayanik knowledge gradient sequential information collection`,
`knowledge gradient stopping rule ranking selection cost`,
`Ryzhov Powell Frazier finite horizon online learning`. Проверены указанные
разделы, не воспроизведены доказательства. Это целевой поиск, не полный обзор.

| Первичный источник | Что уже известно | Граница переноса на AIR56B2, наша оценка |
|---|---|---|
| **Frazier, Powell, Dayanik (2008), A Knowledge-Gradient Policy for Sequential Information Collection.** SIAM J. Control Optim. 47(5), 2410-2439, DOI `10.1137/070693424`. [Авторский PDF, разделы 2-4](https://optimallearning.princeton.edu/Papers/FrazierPowellDayanik_KnowledgeGradientSICON.pdf) | Измерение выбирается по ожидаемому улучшению ценности конечного решения, а не только вероятности угадать номер лучшего варианта. Одношаговый KG и различие линейной и 0-1 потери уже сформулированы. | Нормальные независимые исходы с известной общей дисперсией и заданным числом измерений. Это не динамический двигатель с оплачиваемым восстановлением; равновесный набор 225 кривых не удовлетворяет предпосылкам автоматически. |
| **Frazier, Powell (2008), The Knowledge-Gradient Stopping Rule for Ranking and Selection.** WSC, 305-312, DOI `10.1109/WSC.2008.4736082`. [Первичный PDF proceedings, разделы 3-4, (5)-(7)](https://www.informs-sim.org/wsc08papers/035.pdf) | Совместно выбираются следующая проба и остановка: терминальная ценность минус стоимость измерений; остановка сравнивается с ещё одним измерением. Следовательно, само «commit сейчас или платить за ещё одну пробу» не ново. | Стоимость задаётся выпуклой неубывающей функцией числа измерений, а не измеряется как зависящий от состояния возврат. KG может останавливаться слишком рано; результат статьи об этой ошибке нельзя переносить на некалиброванный EV-суррогат. |
| **Ryzhov, Powell, Frazier (2012), The Knowledge Gradient Algorithm for a General Class of Online Learning Problems.** Operations Research 60(1), 180-195, DOI `10.1287/opre.1110.0999`. [Авторский PDF, разделы 2-3, (9)-(14)](https://optimallearning.princeton.edu/Papers/Ryzhov%20Powell%20Frazier%20-%20KG%20for%20oneline%20learning_OR_March2012.pdf) | Конечногоризонтное online learning сочетает текущую награду и ценность информации для оставшихся решений; рассматривается stop-learning policy. Это особенно близко к обмену времени удержания на новую пробу. | Гауссовские награды и заданная модель знаний, а не ABA со скрытой динамикой, длительностью окна и ограничениями возврата. Множитель остатка горизонта не освобождает от физической цены и задержки измерения. |

Дополняет, но не заменяет [предыдущий prior-art аудит](C:/mic_practice/research/AIR56B2_ACTIVE_PROBE_PRIOR_ART_RU.md),
где уже рассмотрены switching-cost BO, DCEE и потери IM в переходах.
Наш вывод из сопоставления: научно честная цель следующего опыта состоит не в
переименовании известного KG, а в воспроизводимом улучшении энергетического
решения при тех же доступных измерениях, допусках и полной цене исполнения.

## Решение ревью

**Допустить к отдельному prospective-пилоту после проверки перечисленных
инвариантов и заморозки протокола.** Сейчас положительное превосходство не
установлено. Сильный приемлемый исход: выигрыш над ungated и first-good на новой
заранее назначенной сетке с полным учётом цены и неизменной пригодностью.
Также научно значим отрицательный исход: простой first-good объясняет эффект,
прогноз EV не калибруется при скачке, или дополнительная информация не окупается.
Ни один из этих исходов не разрешает подбирать следующий seed до победы.

## Дополнение: проверка реализации rev2 до held-out

Дата: 09.09.2026. **Рекомендация: не раскрывать held-out до устранения замечаний
ниже и новой фиксации исходников.** Это программное ревью с unit-тестами, не
проверка экономии на двигателе. Симуляции, development/validation/stress/refinement
runner не запускались, их результаты не открывались. Изменены только этот файл
и [test_air56b2_energy_value_review.py](C:/mic_practice/research/mic_ai_theory/snh_pwm/source/tests/test_air56b2_energy_value_review.py).
Падающие регрессии оставлены без `xfail`/`skip`, чтобы не скрывать несоответствия.

Прочитан обновлённый [протокол rev2](C:/mic_practice/research/AIR56B2_ENERGY_VALUE_PROTOCOL_RU.md).
Добавление 12 с явно объявлено после development, но до held-out; это допустимый
выбор дизайна, **не замечание о cherry picking**. Проектные числа предыдущих
разделов этого ревью не заменяют зафиксированную основную матрицу: сейчас
92063/92064, четыре базовых двигателя, 3/6/12 с, семь методов; стресс отдельно.
В runner холодный FOC заморожен по 92062, исходный ungated сохранён рядом с guarded.
Причин для пересмотра этих настроек по данному аудиту нет.

### Подтверждённые дефекты

**[P1] R1. GuardedFixed маскирует электрическую ошибку плановым возвратом.**
В [step нового компаратора](C:/mic_practice/research/mic_ai_theory/snh_pwm/source/control/air56b2_energy_value_probe.py:46)
электрические входы проверяет родитель после своей логики scheduled return.
В [Budgeted.step](C:/mic_practice/research/mic_ai_theory/snh_pwm/source/control/air56b2_probe_budget.py:207)
раньше защёлкивается нормальный отказ; затем
[Dynamic._reject](C:/mic_practice/research/mic_ai_theory/snh_pwm/source/control/air56b2_dynamic_probe.py:237)
не повышает уже существующий отказ до аварии.

Контрпример: committed, T=12 с, t=11,6099 с, ток 4 А. Получается
`reason='scheduled_return', aborted=False`, вместо `current_limit` и аннулирования
прогноза. Аналогично превышение напряжения, NaN электрического канала, отрицательный
ток и недопустимый/пониженный voltage cap. Ошибка на следующем отсчёте уже начатого
возврата также теряется. При одновременном дрейфе мощности и превышении тока
сохраняется `observed_regime_change`, а электрическая причина исчезает.
У EV, наследующего исправленный Active.step/_reject, эти же тесты проходят.

Это прежде всего ошибка классификации отказа и статуса прогноза: возврат команды
в данном примере всё равно начинается. Не утверждается, что весь offline PASS
обязательно станет ложноположительным: независимый токовый контроль объекта может
обнаружить превышение. Но новая обёртка не сохраняет заявленный приоритет fault.
Исправление основной реализации: проверять все входы до normal stop и повышать
нормальный возврат до fault при ошибке в его процессе, не отключая ungated search.

**[P2] R2. GuardedFixed продолжает holding после пропуска измерения.**
В [holding guard](C:/mic_practice/research/mic_ai_theory/snh_pwm/source/control/air56b2_energy_value_probe.py:36)
нет проверки интервала. Родитель только отмечает `bounds_valid=False`; при
`payback_gate=False` это не прекращает holding. При интервале 200 мкс вместо
100 мкс новый компаратор остаётся `committed=True, completed=True`, EV возвращается
с `sample_gap` и аннулирует прогноз. Заявление об одинаковом контроле удержания
поэтому неверно для потерянных отсчётов. Исправление: одинаковое правило gap во
время holding, без включения бюджетного/payback gate у сильного компаратора.

**[P2] R3. EV оценивает как доступную будущую verification, которую собственный
полный прогноз бюджета после наблюдения отвергает.**
[Скидка cost_fraction](C:/mic_practice/research/mic_ai_theory/snh_pwm/source/control/air56b2_energy_value_probe.py:94)
используется не только для ожидаемой стоимости, но и внутри проверки допустимости.
В [ветви после запроса](C:/mic_practice/research/mic_ai_theory/snh_pwm/source/control/air56b2_energy_value_probe.py:118)
обновляется spent, но не воспроизводится штатное обновление `cycle_cost` по этому
уже считающемуся наблюдаемым циклу.

При стандартных временных настройках полный приор low = 7,804 Дж. Реальная
плановая ветвь fraction=0,5 даёт наблюдаемую цену 3,902 Дж. После добавления такого
цикла штатный forecast следующей verification равен
`0,1 + 1,5*3,902 = 5,953 Дж`: вместе 9,855 Дж, больше лимита 8 Дж. Воссозданный
post-query `_decide` корректно останавливается. Но изолированная та же ветвь
lookahead даёт `+157,98 Дж` вместо `-3,902 Дж` за уже оплаченную бесполезную пробу.
В тесте fraction=0,5 выделена из существующих трёх исходов, новый приор для
исследования не вводился.

**Это не обнаруженный обход реального runtime-бюджета.** Вход в реальную query
и непосредственная verification используют полный forecast и соответствующие
тесты проходят. Дефект в ценности планируемого действия: оно получает кредит
за запрещённое последующее исполнение. Задекларированная неопределённость цены
не делает доступным действие, уже недопустимое по известной истории той ветви.
Исправление: разделить ожидаемую цену и полный admission forecast и применять
последний к обновлённой истории каждой ветви, включая её бюджет и amplitude transfer.

**[P2] R4. EV не резервирует собственный обученный возврат будущей query.**
[duration = 2*stage_s](C:/mic_practice/research/mic_ai_theory/snh_pwm/source/control/air56b2_energy_value_probe.py:99)
отводит query два минимальных stage, хотя `return_s` уже может быть больше по
истории завершённых возвратов. `_hold_s` резервирует такой возврат только один
раз, для окончательного deployment. Возврат самой query остаётся укороченным.

Unit-контрпример: наблюдавшийся high-return 1 с, t=2 с, синтетический deadline
4,6 с. Для low `stage_s=0,3902 с`, `return_s=1,156667 с`; query + verification +
оба прогнозируемых возврата требуют 3,093733 с, доступно 2,6 с. Несмотря на это,
`expected_query_value=+6,232740 Дж`. Это отдельный тест граничного состояния,
**не добавленный горизонт симуляционного протокола**. Исправление: query должна
тратить собственное время возврата перед расчётом остатка для verification/hold.
Даже после исправления return_s остаётся прогнозом, а не физической гарантией.

**[P2] R5. Reverse first-good может незаявленно заменить low внутренней пробой.**
[Перебор query_order](C:/mic_practice/research/mic_ai_theory/snh_pwm/source/control/air56b2_energy_value_probe.py:133)
для greedy включает все четыре точки; выбирается первая допустимая, а не только
следующая из объявленных high/low. Если первая high дала недостаточный выигрыш
и стоила 3 Дж, полный forecast low с увеличением амплитуды превышает остаток:
сумма около 8,145 Дж. Внутренняя high-half 0,915 А укладывается в 7,6 Дж.
Вместо stop компаратор начинает именно эту query. В обычном случае high -> low
и принятие первого хорошего high работают: ошибка только в fallback вне меню.

Это не обязательно ослабляет baseline; направление влияния на энергию неизвестно.
Но проверяется уже другая стратегия, не заявленный простой двухточечный high/low.
Исправление основной реализации: ограничить меню simple greedy двумя крайними
точками. Четырёхточечный вариант можно оставить отдельно обозначенным методом,
но не менять смысл существующего компаратора после раскрытия held-out.

### Что проверку прошло

- В rev2 один расчёт действия на пару `(bin, cost_fraction)`, не на скрытую
  гипотезу. Тест с двумя h в одном bin и третьей в другом проверяет число вызовов
  и взвешенную ценность; перестановка/полное дублирование гипотез не меняют ответ.
- Изменение h внутри того же bin и недоступных координат других кандидатов не
  меняет условный прогноз данной query. Это проверяет отсутствие прежнего
  per-hypothesis oracle, но не делает bin midpoint байесовским средним.
- Первоначальный допуск query использует полную цену, включает spent; граница
  8 Дж сохранена. Непосредственный commit не допускает дорогого кандидата и
  выбирает второго доступного, если он есть. Runtime-превышения бюджета не найдено.
- Оба порядка first-good начинают с нужной крайней точки и сразу переходят к
  свежей verification первого достаточного измеренного кандидата, не выполняя
  обязательную вторую пробу. Этот переход ещё не означает `ever_committed`.
- GuardedFixed остаётся ungated; отдельные дрейф мощности, ошибка скорости и
  смена задания вызывают возврат. Точные границы допусков сохранены. Опора holding
  берётся из среднего verification-окна, не последнего отсчёта мощности.
- Ошибки GuardedFixed до scheduled return, когда нет конкурирующего normal stop,
  обрабатываются правильно; некорректное время не меняет внутреннее состояние.

### Тесты и воспроизведение

Запускался только новый review-файл, без построения `EnergyCoreMotor`, генерации
двигателей и вызова study runner. Применены синтетические истории/окна и отдельные
наблюдения супервизоров. Команда из `C:\mic_practice`:

```powershell
python -B -m pytest -p no:cacheprovider -q --tb=short research/mic_ai_theory/snh_pwm/source/tests/test_air56b2_energy_value_review.py
```

Итог: **60 тестовых случаев, 47 passed, 13 failed**, exit code 1. R1 даёт девять
падений: семь одновременных electrical/scheduled случаев, fault после начала
normal rollback и electrical/holding-drift priority. R2-R5 дают по одному.
Падения показывают ожидаемое исправленное поведение, а не закрепляют баг как норму.
Полный набор тестов и аппаратные измерения не запускались.

Проверенная реализация `air56b2_energy_value_probe.py`, SHA-256:
`6A048F5F74DABB719106518718E3AFECBB66AEBE2FB444E02DBD79076EAD6E33`.
Протокол rev2, SHA-256:
`6A0DC4C3B6F6871522499FC59DF5CF551349E9D1C3559893206C36F54808EFC5`.
Runner, SHA-256:
`E1C374D2F40BA5A9D28B4EF1B2C1CBE45914348186D2F1841BC52FFB7E35B93B`.
Хеши 110 существовавших к началу аудита Python-файлов/протокола сохранены в
контексте проверки и сверены после тестов: изменений этих файлов не обнаружено.
Параллельно появился отдельный `test_air56b2_energy_value_audit.py`; этот sidecar
его не создавал, не менял и не запускал.

Исправления здесь не применялись из-за development freeze. До повторной фиксации
не следует начинать held-out и затем объяснять обнаруженные ошибки подбором
горизонта, порогов или seed. Выводов о знаке фактической экономии этот аудит не даёт.

## Завершение аудита rev3: один открытый пункт

Дата: 09.09.2026. Объём проверки закрыт, методика дальше не расширяется.
Пять замечаний rev2 устранены в проверенных сценариях. Старые падающие регрессии
проходят без ослабления; исправлено только устаревшее ожидание аргумента mock:
теперь `deployment_cost_j = 0,475 / 0,85 / 1,6 Дж`, а не fraction.
Проверки группировки, числа вызовов и итоговой взвешенной ценности сохранены.

Добавлены 12 сверок `forecast_after_query` с живым `cycle_cost` после append
гипотетического завершённого bracket: без истории и с историей, рост/уменьшение
амплитуды, доминирование старой/новой цены, нулевая цена и `learned_cost=False`.
Проверено отсутствие изменения исходной истории. Все сверки проходят.
`greedy_full_menu` отдельно разрешает внутренний fallback, сохраняет first-good
и лимит двух проб; простой greedy остаётся двухточечным. Подключение восьмого
компаратора проверено с заглушкой `run_trial`, без объекта и симуляции.

**[P2] R6, OPEN: событие fault-upgrade отсутствует в журнале GuardedFixed.**
В [GuardedFixed._reject](C:/mic_practice/research/mic_ai_theory/snh_pwm/source/control/air56b2_energy_value_probe.py:25)
при электрической ошибке во время уже начатого scheduled rollback поля `reason`,
`aborted`, `payback_status` теперь меняются правильно. Но новый `DynamicProbeEvent`
не создаётся; родительский `_reject` уже защёлкнут. Поэтому хронология событий
не содержит фактическое время и причину новой ошибки, хотя итоговый статус верен.
[Регрессионный тест](C:/mic_practice/research/mic_ai_theory/snh_pwm/source/tests/test_air56b2_energy_value_review.py:475)
падает только для guarded; тот же случай у EV проходит. Это остаточный дефект
журналирования, не прежняя ошибка управления или приоритета защит.

Фактический итог review-файла: **83 passed, 1 failed**. Совместно с исходным
`test_air56b2_energy_value_probe.py`: **94 passed, 1 failed**, exit code 1.
Никаких `xfail`/`skip` для сокрытия замечания не добавлено.

```powershell
python -B -m pytest -p no:cacheprovider -q --tb=short research/mic_ai_theory/snh_pwm/source/tests/test_air56b2_energy_value_review.py research/mic_ai_theory/snh_pwm/source/tests/test_air56b2_energy_value_probe.py
```

Проверенный rev3 source SHA-256:
`C643A0211524D2924D2E63EE2895ED57D98349E0DA1F40FDE18950819CD0341D`.
Протокол SHA-256:
`1DFCB91A4EE66EE793F05E7D5C2643A034C43CE624EA2B26BDAE546EB292E7B8`.
111 существовавших к началу этого повторного аудита Python-файлов/протокола
сверены по хешам и не изменились. Изменены только review-тест и эта записка.

Согласованный следующий шаг основной работы: завершить и архивировать текущую
development-серию, добавить событие `return_fault`, выполнить тесты и зафиксировать
rev4 **до held-out**. Исправление rev4 здесь ещё не проверено, R6 не закрывается
авансом. По сообщению основной работы development-проходы штатные; пересчёт серии
этим аудитом не выполнялся и не требуется как новое условие. Новых требований
к матрице, порогам, seeds или методике не добавляется. Независимые серии могут
начаться после указанного исправления, успешных тестов и новой фиксации.

### Закрытие R6 основным исполнителем, 10.09.2026

После завершения всех 128 development-прогонов rev3 сохранён архив исходников.
В rev4 добавлено событие `return_fault`; правило управления не менялось.
Review-тесты вместе с тестами сохранения прогонов: 87 passed. Полный корневой
набор на момент фиксации: 1035 passed; FOC отдельно: 34 passed.
Это повторная проверка основным исполнителем, не заявление о новом независимом
аудите. Замороженная rev4 запущена на ранее не использованных seed 92063/92064
и на обязательное уточнение шага. R6 закрыт тестом фактической записи события.
