11lisov11/mic_practice/research/AIR56B2_FINAL_RESULTS_RU.md

# AIR56B2: итог программного исследовательского этапа

Новый отдельный динамический пилот: [энергетическая модель и стоимость проб](AIR56B2_DYNAMIC_POWER_RESULTS_RU.md).
Он не подтверждает автоматически старые проценты экономии и не заменяет стендовую проверку прошивки.

Дата: 28 августа 2026 г.

Обновление 08.09.2026: документ ниже сохраняет историческую контрольную точку.
Новый аудит выявил подмену момента на валу электромагнитным и неполное
рассеяние в формуле напряжения модели потерь. Численные выводы об экономии,
оптимуме и нейрополитике ниже требуют пересчёта и не являются окончательными.
Новый исправленный эксперимент и ограничения:
[результаты измерительной адаптации](AIR56B2_MEASUREMENT_ADAPTATION_RESULTS_RU.md),
[теория и дальнейшие гипотезы](AIR56B2_MEASUREMENT_ADAPTATION_THEORY_RU.md).

Объект: IEK AIR56B2, 0,25 кВт, 220 В, физическое соединение обмоток Delta.
Назначение документа: единая точка фиксации воспроизводимых результатов до
получения двигателя, NUCLEO-G431RB и силового модуля.

## 1. Итоговый статус

Запланированный на 28.08.2026 программный этап был выполнен. Полный конвейер
`tools/run_air56b2_research_pipeline.ps1 -Full` выполнен успешно. Пройдено 218
автоматических тестов: 167 SNH/PWM, 34 FOC+PPO и 17 идентификационных. Манифест
`artifacts/air56b2_research_manifest.json` имеет схему v5, статус `PASS`, 39
успешных ворот и SHA-256 всех обязательных evidence-файлов.

Статусы трактуются раздельно:

- `pc_research_ready_for_hardware_identification=true` - компьютерная часть
  готова к началу измерений и низковольтной наладки;
- `hardware_release_ready=false` - силовой пуск, FOC и ИИ на реальном стенде
  ещё не приняты и автоматически не разрешены.

## 2. Зафиксированные результаты

| Контур | Проверка | Результат |
|---|---|---:|
| Паспортный ансамбль | Физически допустимые F1-модели | 256 |
| Scalar V/f | Канонический набор | 24/24 PASS |
| Scalar V/f | 5/15/30/50 Гц, 25/50/75/100 % нагрузки | 48/48 PASS |
| Защитный шлюз | 7 классов аварий на 24 вариантах F3 | 168/168 PASS |
| Encoder-observer FOC | Независимый evidence-набор | 24/24 PASS |
| Классическая loss optimization | Сопоставимые режимы | 480/480 |
| Классическая loss optimization | Медианное снижение расчётных потерь | 9,649 % |
| Независимый sensorless observer | 15/30/45 Гц | 3,351 % средней относительной ошибки скорости |
| Нейросетевая `i_d`-политика | Blind holdout | 600 режимов, 0 нарушений |
| Нейросетевая `i_d`-политика | Медианный разрыв с offline optimum | 0,373 % |
| Нейросетевая `i_d`-политика | Медианный выигрыш против fixed flux | 12,295 % |

Нейросетевая политика является детерминированной дистилляцией классического
оптимума в симуляции. Она не называется PPO-результатом, не обучалась на
реальном двигателе и не имеет аппаратного допуска. FOC+PPO-код перенесён,
проверен на воспроизводимый smoke/replay и подготовлен к будущему обучению.

## 3. Готовые артефакты

- `output/documents/AIR56B2_научно_технический_отчет_2026-08-28.docx` -
  оформленный научно-технический отчёт;
- `output/pdf/AIR56B2_научно_технический_отчет_2026-08-28.pdf` - PDF отчёта;
- `output/documents/AIR56B2_программа_аппаратной_верификации_2026-08-28.docx` -
  пошаговая программа стендовых испытаний;
- `output/pdf/AIR56B2_программа_аппаратной_верификации_2026-08-28.pdf` - PDF
  программы;
- `artifacts/air56b2_research_manifest.json` - машинный статус и контрольные
  суммы;
- `artifacts/air56b2_nameplate_ensemble.json` - паспортный ансамбль;
- `artifacts/air56b2_loss_optimization_study.json` - классический baseline;
- `artifacts/air56b2_sensorless_independent_plant_study.json` - независимая
  sensorless-проверка;
- `artifacts/air56b2_policy_benchmark.json` - blind holdout нейрополитики;
- `artifacts/air56b2_id_ref_lut.json` и `.h` - отключённый до стенда LUT-export.

## 4. Воспроизведение

Подготовка среды:

```powershell
powershell -ExecutionPolicy Bypass -File tools/setup_research_gpu_env.ps1
```

Полное повторение результатов:

```powershell
powershell -ExecutionPolicy Bypass -File tools/run_air56b2_research_pipeline.ps1 -Full
```

Сборка DOCX-отчёта и программы испытаний:

```powershell
.venv-research-gpu\Scripts\python.exe tools/build_air56b2_final_report.py
```

## 5. Аппаратный этап

Проверка работы с реальным двигателем требует аппаратуры и выполняется последовательно:

1. Проверка разводки без сети и калибровка измерительных каналов.
2. DC-тест обмоток, холостой ход, короткий тест с ограничением и выбег;
   формирование принятого профиля `Rs/Rr/Lsigma/Lm/J/B`.
3. Первый низковольтный запуск только scalar V/f с внешним аварийным
   отключением.
4. Encoder-assisted FOC с AS5600 и сопоставлением логов с SIL.
5. Sensorless observer только в shadow mode, затем отдельная приёмка.
6. Интеллектуальная коррекция потока, а direct neural PWM - последним этапом
   после проверки WCET, dead-time, токовых защит и аппаратного shutdown.

До выполнения этих пунктов никакой расчётный результат не является основанием
для подключения высоковольтной шины. Именно поэтому все экспортируемые политики
и LUT сохраняют `hardware_release_ready=false`.

Теоретическое развитие до получения плат продолжается: измерительные контракты,
согласованная модель потерь, динамические пробы и адаптация при неопределённости.
