11lisov11/mic_practice/research/AIR56B2_MEASUREMENT_ADAPTATION_RESULTS_RU.md

# AIR56B2: результаты адаптации по измерительному окну

Дата: 08.09.2026. Источник: `artifacts/measurement_adaptation_20260908_v2/study.json`.
Тип результата: квазистационарное моделирование, не стендовые измерения.
Мощность поступает от виртуального ваттметра. Ветвь потерь в стали пока не
согласована с измерительными токами и напряжениями; реальный оценщик мощности
и динамика FOC этим опытом не проверены.

## Главный результат

Нейросеть с наблюдаемым контекстом уступила аналитической настройке.
При шуме измерений её среднее снижение расчётных потерь относительно общего
фиксированного тока 0,83 А составляет 9.299%,
у аналитического метода 9.364%.
Парная разность потерь «аналитика минус НС» равна -0.0615 Вт,
95%-интервал [-0.0848; -0.0380] Вт. Знак плюс означал бы преимущество НС.
Это небольшой эффект в модели; перенос такой точности на физический стенд не доказан.

Дополнительные пробы относительно абляции нейросети дают
+0.0027 Вт, интервал
[-0.0073; +0.0138] Вт.
Сами по себе более богатые входы не обеспечили доказанного практического выигрыша.

## Что реально выполнено

- Семейство AIR56B2 взято из существующего F1/F2/F3-пакета. Новые измеренные
  параметры двигателя не выдумывались; сопротивления, насыщение и тепловые
  константы остаются симуляционными допущениями.
- Разбиение по моделям: 96 train,
  32 validation, 32 holdout,
  32 отдельных моделей для изменённых параметров.
- На модель приходится 24 режима: три скорости, четыре момента на валу,
  два тепловых состояния. Эти режимы общие у train/test; проверка не является
  тестом переноса на невиданные скорости и нагрузки.
- Обучены две архитектуры с 3 начальными seed:
  полное измерительное окно и абляция с током, напряжением и скоростью
  исходной пробы. 4555 обучающих и 1530 проверочных окон.
- Каждый обучающий seed проверен на тех же 2 реализациях
  измерительного шума. Их выбор не зависит от порядка перечисления seed.
- Исключения при подготовке обучения: `{'measurement_gate': 1, 'infeasible_training_probe': 26}`;
  при подготовке validation: `{'measurement_gate': 2, 'infeasible_training_probe': 2}`. Все запланированные
  тестовые режимы сохранены, включая недопустимые.
- Обучение выполнено на `cuda`, PyTorch `2.11.0+cu128`.
  Битовый повтор обучения с тем же seed: `True`.
- Сохранено 115200 записей сравнения пяти методов и пяти сценариев.
  Это не 115200 независимых двигателей: независимыми кластерами
  для доверительных интервалов служат модели, а seed и режимы остаются внутри них.

## Сравнение при шуме

Во всех строках сравниваются одинаковые скорость и момент на валу.
Потери и входная мощность имеют разные знаменатели. Временные переходы и
затраты энергии на получение проб в эти проценты не входят.

| Метод | Снижение потерь, среднее % | Снижение входной мощности, среднее % | Медианный разрыв с оптимумом, % | Ухудшений |
|---|---:|---:|---:|---:|
| Фиксированный ток | 0.000 | 0.000 | 10.353 | 0 |
| Лучшая проба | 9.196 | 5.481 | 0.000 | 0 |
| Аналитическая настройка | 9.364 | 5.577 | 0.000 | 3 |
| НС: исходная проба | 9.283 | 5.531 | 0.085 | 0 |
| НС: полное окно | 9.299 | 5.542 | 0.096 | 0 |

Оптимум рассчитан офлайн на том же ограниченном интервале 0,55–1,11 А.
Это не глобальный оптимум по всему диапазону токов. Идеальный регулятор
момента внутри модели предполагается, но не реализуется этой нейросетью.
В 55.99% чистых тестовых режимов ограниченный оптимум находится
на границе этого интервала. Аналитический метод достигает границы точно,
а выход sigmoid приближается к ней. Это один из факторов сравнения данной
архитектуры; результат не доказывает бесполезность любых нейросетевых методов.

Сравнение методов

## Проверка отказов и ограничений

Таблица относится к нейросети с полным окном. «Сопоставимые» означает общую
выборку, где исходный режим и результаты всех пяти методов допустимы в модели
и ни один метод не запросил STOP. Это условное сравнение потерь на успешно
обслуженных режимах, его нужно читать вместе с частотой отказов.
Остановки и недопустимые действия не засчитываются как экономия. Все отклонённые и недопустимые
опыты сохранены в `rows.jsonl.gz`.

| Сценарий | Все записи | Сопоставимые | STOP | Нарушения в пробах | В проверочной пробе | После решения | Ухудшений |
|---|---:|---:|---:|---:|---:|---:|---:|
| Без шума | 4608 | 4608 | 0 | 36 | 0 | 0 | 0 |
| Дрейф нагрузки | 4608 | 4608 | 0 | 0 | 0 | 0 | 0 |
| Шум измерений | 4608 | 4608 | 0 | 36 | 0 | 0 | 0 |
| Изменённые параметры | 4608 | 4389 | 216 | 726 | 3 | 3 | 3 |
| Систематическая ошибка | 4608 | 4608 | 0 | 36 | 0 | 0 | 45 |

Сначала диагностический прогон выявил ошибку постоянного ограничения напряжения.
В ревизии v2 оно следует за измеренной DC-шиной; исходный режим, нарушающий
измеренное ограничение, запрашивает STOP. Данные первого прогона сохранены
в `artifacts/measurement_adaptation_20260908` и не подменены улучшенной ревизией.

Сохранившиеся нарушения во время проб показывают предел этого протокола.
Отклонение результата после измерения не защищает саму пробу. Потребуется
динамический ограничитель тока и предварительный выбор допустимого возбуждения.
Ноль нарушений после решения нельзя выдавать за безопасность всей траектории.

## Проверка гипотез

| Сценарий | Соперник НС | Средняя разность потерь, Вт | 95%-интервал, Вт |
|---|---|---:|---|
| Без шума | Аналитическая настройка | -0.0809 | [-0.0999; -0.0629] |
| Без шума | НС: исходная проба | +0.0007 | [-0.0097; +0.0118] |
| Шум измерений | Аналитическая настройка | -0.0615 | [-0.0848; -0.0380] |
| Шум измерений | НС: исходная проба | +0.0027 | [-0.0073; +0.0138] |
| Систематическая ошибка | Аналитическая настройка | -0.0079 | [-0.0260; +0.0118] |
| Систематическая ошибка | НС: исходная проба | +0.0099 | [-0.0056; +0.0259] |
| Дрейф нагрузки | Аналитическая настройка | +0.0000 | [+0.0000; +0.0000] |
| Дрейф нагрузки | НС: исходная проба | +0.0000 | [+0.0000; +0.0000] |
| Изменённые параметры | Аналитическая настройка | -0.0870 | [-0.1218; -0.0572] |
| Изменённые параметры | НС: исходная проба | +0.0307 | [+0.0043; +0.0603] |

Интервалы получены парным bootstrap по моделям двигателя; все повторы одной
модели переносятся в выборку вместе. При каждом повторе пересчитывается
отношение суммы к числу строк, что совпадает с оценкой среднего в таблице.
Это интервалы для исследованного семейства
priors при фиксированных обучающих выборках, а не доверительные границы ошибки
физической модели. Основное сравнение зафиксировано до открытия новых holdout
результатов. Ревизия v2 использует уже просмотренные наборы и является
исследовательской перепроверкой, не независимым подтверждающим испытанием.

## Вывод для дальнейшей разработки

Текущий результат обосновывает простую аналитическую адаптацию как обязательную
базу сравнения. Обучать более крупную сеть только ради уменьшения ошибки на том
же стационарном наборе сейчас недостаточно: разность мала, а систематическая
ошибка измерителя и допустимость проб влияют сильнее.

Следующие содержательные направления: согласованная электрическая модель
с потерями в стали; динамическое планирование проб; проверенный оценщик мощности;
обучаемая остаточная поправка и выбор момента повторной адаптации. Для sensorless
ветки требуется отдельное исследование наблюдателя с AS5600 как эталоном скорости.

Математика, критерии опровержения и первичные источники:
[AIR56B2_MEASUREMENT_ADAPTATION_THEORY_RU.md](AIR56B2_MEASUREMENT_ADAPTATION_THEORY_RU.md).

## Воспроизведение

```powershell
powershell -ExecutionPolicy Bypass -File tools/run_air56b2_measurement_adaptation.ps1
```

Только проверка контрольных сумм:

```powershell
.venv-research-gpu/Scripts/python.exe tools/build_air56b2_measurement_report.py --verify-only
```

Артефакты: шесть checkpoint-файлов, protocol, summary, полные сжатые записи,
manifest SHA-256, рисунок PNG/SVG/PDF. Прошивки плат этим этапом не изменялись.
`hardware_release_ready=false`.
