11lisov11/mic_practice/research/AIR56B2_MEASUREMENT_ADAPTATION_THEORY_RU.md

# AIR56B2: адаптация потока по короткому измерительному окну

Дата: 08.09.2026. Статус: исследовательская постановка и воспроизводимый
квазистационарный эксперимент. Этот этап относится к будущей надстройке над FOC;
первый запуск стенда остаётся скалярным V/f.

## 1. Что именно проверяем

Практическая цель: выбрать ток намагничивания по наблюдаемому отклику двигателя,
без передачи нейросети истинного момента нагрузки, температур обмоток и
параметров схемы замещения. Полная идентификация двигателя и определение
достаточных для управления признаков являются разными задачами.

Исследуем отображение

\[
 i_d^*=\pi_\theta(z),\qquad
 z=g\bigl(\{i_{d,k},\widehat P_k,\widehat I_k,\widehat U_k\}_{k=1}^{4},
          \widehat\omega\bigr).
\]

Нейросеть обучается на симуляционных примерах. Истинные параметры доступны
только генератору обучающих целей и оценщику результатов. В рабочее отображение
они не передаются. Это дистилляция решения задачи оптимизации, а не PPO,
прямая нейронная коммутация инвертора или доказанное sensorless-управление.
Скорость пока считается измеренной, например AS5600. Динамика внутреннего FOC
предполагается идеальной и в данном эксперименте не моделируется.

## 2. Энергетически корректное сравнение

Для одинаковых положительных скорости и момента на валу:

\[
 T_e=T_{\rm shaft}+B\omega_m+T_c,\qquad
 P_{\rm in}=T_{\rm shaft}\omega_m+P_{\rm loss}.
\]

Требуемый электромагнитный момент включает трение. Механические потери
добавляются в баланс мощности ровно один раз. Иначе можно занизить необходимый
ток и получить неверный оптимум потока.

При фиксированной рабочей точке и локально постоянной индуктивности:

\[
 \psi_r=L_m i_d,\quad
 i_q=\frac{T_e}{1.5p(L_m/L_r)\psi_r},\quad
 L_\sigma=L_{ls}+\frac{L_mL_{lr}}{L_r},
\]
\[
 u_d=R_si_d-\omega_eL_\sigma i_q,\qquad
 u_q=R_si_q+\omega_e\left(L_\sigma i_d+\frac{L_m}{L_r}\psi_r\right).
\]

Эти выражения согласуют электрическую мощность без ветви потерь в стали:

\[
 \frac32(u_di_d+u_qi_q)=P_{s,cu}+P_{r,cu}+T_e\omega_m.
\]

В старом расчёте использовалось только статорное рассеяние в формуле напряжения,
а заданный момент на валу сразу подставлялся в формулу электромагнитного момента.
Новая обёртка `evaluate_shaft_point` исправляет оба места. Исторические проценты
энергоэффективности от 28.08.2026 требуют пересчёта; их старый статус PASS
подтверждает прохождение тогдашних проверок, но не устраняет найденные ошибки.

Потери в стали и инверторе пока остаются добавочными функциями. Поэтому
`P_in` здесь является выходом **виртуального ваттметра**. Мы не утверждаем,
что этот сигнал уже можно корректно восстановить из реальных АЦП и PWM.
Для такого утверждения нужен согласованный электрический объект с ветвью
потерь в стали и отдельно проверенный измеритель мощности.

## 3. Сильный простой соперник нейросети

При постоянной нагрузке уменьшение потока снижает часть потерь, но повышает
моментный ток. Локальная аппроксимация имеет вид

\[
 P(i_d)\simeq a i_d^2+\frac b{i_d^2}+c,\qquad
 i_d^*=\left(\frac ba\right)^{1/4},\quad a,b>0.
\]

Три различных значения тока позволяют оценить три коэффициента. Постоянное
смещение измерителя мощности входит в `c` и не меняет оптимум. Это можно
проверить численно независимо от конкретного двигателя. При почти совпадающих
пробах задача становится плохо обусловленной: оценку нужно отклонять.
Три точки точно интерполируются тремя коэффициентами, поэтому нулевой остаток
по трём точкам сам по себе не доказывает отсутствие шума или правильность модели.

Идентификация `a,b,c` не означает идентификацию `Rs,Rr,Lm,Lsigma,J,B`.
Для выбора действия иногда достаточно отношения `b/a`; восстановление всех
физических параметров из того же короткого окна может быть неединственным.
Локальная чувствительность оптимума:

\[
 \frac{\delta i_d^*}{i_d^*}\simeq\frac14
 \left(\frac{\delta b}{b}-\frac{\delta a}{a}\right).
\]

Насыщение, изменение скольжения, частотно-зависимые потери в стали и падение
напряжения ключей нарушают точность этой простой формы. Именно остаточную
ошибку аппроксимации может быть полезно обучать; само наличие нейросети
не является достаточным основанием ожидать выигрыш.

## 4. Измерительный протокол

Общий исходный ток: 0,83 А. Это фиксированный ток, не утверждение о поддержании
паспортного потока. Последовательность: 0,83; 0,55; 1,11; 0,83 А.
Четыре установившихся окна дают три различных уровня возбуждения и повтор
исходного режима. После предложения действия допускается пятое окно проверки.
Нейросеть, аналитическая аппроксимация и выбор лучшей измеренной пробы получают
одинаковые данные, пределы действий и правило принятия.

Разность мощности двух исходных проб больше 4 Вт отклоняет окно как
нестационарное. Это проверка суммарного изменения за окно: промежуточный
скачок с возвратом она может не обнаружить. Кандидат принимается только
при измеренном улучшении больше 2 Вт и соблюдении измеренных ограничений.
Предел напряжения следует за измеренной DC-шиной:

\[
 U_{\rm lim}=\min\left(170\text{ В},\;0.95\widehat U_{dc}/\sqrt3\right).
\]

Непригодный исходный режим формирует STOP. Остановке не присваиваются нулевые
потери и положительная экономия: она считается отказом обслуживания режима.
Нарушения ограничений во время проб и проверочного воздействия считаются
отдельно от состояния после возврата. Проверка после пробы не доказывает
безопасность самой пробы или перехода между ними.

Нет доказанного времени адаптации в миллисекундах: усреднение, установление
потока, механические переходы и затраты энергии на возбуждение ещё не включены
в этот квазистационарный опыт. Число измерительных окон можно сравнивать уже
сейчас; скорость адаптации и интегральную экономию энергии пока нельзя.

## 5. Проверяемые гипотезы

| Гипотеза | Критерий | Что может её опровергнуть |
|---|---|---|
| H1: доступные измерения достаточны для полезной настройки | Снижение потерь на новых моделях относительно общего 0,83 А при той же полезной мощности | Ошибки, STOP, нарушения ограничений и отрицательная экономия |
| H2: нейросеть лучше аналитической аппроксимации | Положительный парный 95%-интервал разности потерь в ваттах, одинаковый бюджет измерений | Интервал включает ноль или преимущество аналитики |
| H3: дополнительные пробы полезнее одного рабочего наблюдения | Нейросеть с полным контекстом лучше абляции с исходными током, напряжением и скоростью | Нет различимой прибавки качества |
| H4: повтор исходной пробы отсеивает дрейф нагрузки | Доля отклонённых окон в заранее заданном сценарии дрейфа | Пропуск нестационарности или ложные отклонения |
| H5: проверка мощности гарантирует отсутствие ухудшений | Нет ухудшений при шуме и систематической ошибке | Хотя бы один ложно принятый кандидат |

H5 особенно строга. Если ошибка измерения каждой мощности ограничена `epsilon`,
то при постоянной полезной мощности запас принятия должен превышать
`2 epsilon`. Гауссовский шум не имеет конечной абсолютной границы, поэтому
фиксированный запас без вероятностной модели не даёт строгой гарантии.
Зависящая от возбуждения ошибка измерителя `b(i_d)` неотличима от части
истинной функции потерь: наблюдается `P(i_d)+b(i_d)`. Повтор одной и той же
пробы такое смещение также не устраняет.

## 6. Что дорабатывать дальше

1. Согласовать модель потерь в стали с токами и напряжениями. Проверять баланс
   мощности во всём диапазоне скоростей, нагрузки и насыщения.
2. Перенести протокол в динамический FOC с наблюдателем: ограничить скорость
   изменения `i_d`, ждать установления, учитывать накопленную энергию и
   моментные пульсации. Проценты потерь заменить интегралом энергии при равной
   полезной работе.
3. Проверить динамическое сужение диапазона проб по измеренным запасам тока
   и напряжения. Сначала исключить опасные пробные режимы, затем обучать политику.
4. Для дообучения использовать неопределённость и нестационарность измерителя:
   остаточную поправку к аналитическому решению, выбор момента повторной
   адаптации и отказ от настройки при недостаточной информации. Сравнить
   с такой же адаптивной классической стратегией.
5. После появления стенда калибровать наблюдения и оценить перенос на двигатель.
   AS5600 использовать как эталон скорости для обучения и проверки sensorless
   наблюдателя. Поток ротора асинхронного двигателя не равен механическому углу.

## 7. Граница научной новизны и источники

Обучение нейросети оптимальному потоку по модели потерь уже описывалось
Pryymak, Moreno-Eguilaz и Peracaula в 2006 г., включая влияние температуры
и магнитной нелинейности. Поэтому «нейросеть вместо формулы оптимального
потока» сама по себе не новая идея:
[Neural network flux optimization using a model of losses in induction motor drives](https://doi.org/10.1016/j.matcom.2006.02.015).

Гибридное сочетание модели и поиска по установившейся мощности тоже известно:
[Blanusa, Simple Hybrid Model for Efficiency Optimization of Induction Motor Drives with Its Experimental Validation, 2013](https://doi.org/10.1155/2013/371842).

Обучаемая адаптация по истории наблюдений и действий имеет прецеденты в
управлении движением, например RMA. Это методологическая аналогия, а не
подтверждение результата для асинхронного электродвигателя:
[Kumar et al., RMA, RSS 2021](https://roboticsproceedings.org/rss17/p011.html).

Для данного проекта проверяемый кандидат вклада: ограниченная по бюджету
измерений адаптация регулятора асинхронного привода с явной проверкой
стационарности, неопределённости измерений и потери качества при переносе.
Утверждать мировую новизну или превосходство алгоритма до сравнений нельзя.

Численные результаты формируются одной командой в
`research/AIR56B2_MEASUREMENT_ADAPTATION_RESULTS_RU.md`.
