11lisov11/mic_practice/research/mic_ai_theory/snh_pwm/c6_conformal_reachability/revalidation/RESULTS_20260826_20260827_RU.md

# Результаты независимой ревалидации C6-BCR

Дата выполнения: 26 августа 2026 г.

Протокол, критерии и root seeds были зафиксированы и отправлены в Git коммитом
`49a8f5d` до вычислений. Это внутренняя prospective-фиксация, а не внешняя
пререгистрация.

## Итог

Строгий заранее заданный общий gate **не пройден**. Обе серии прошли полный
детерминированный replay, проверку seed-потоков, хеша протокола, C6-эквивариантности
и sharpness, но каждая отдельно не достигла exact 99% lower coverage bound `0,92`.

| Метрика | Seed 20260826 | Seed 20260827 | Агрегат |
|---|---:|---:|---:|
| Независимые coverage-пробы | 400 | 400 | 800 |
| Покрытые пробы | 380 | 379 | 759 |
| Эмпирическое coverage | 0,95000 | 0,94750 | 0,94875 |
| Exact 99% lower bound | 0,918599 | 0,915549 | 0,927645 |
| Coverage lower-bound gate | fail | fail | pass |
| Медиана C6/raw volume ratio | 0,793302 | 0,781685 | 0,784784 |
| Строгие sharpness wins | 20/24 | 20/24 | 40/48 |
| Exact sign-test p-value | 0,00077194 | 0,00077194 | 0,000001653 |
| Детерминированный replay | pass | pass | pass |

Описательное bulk coverage агрегата равно `0,950495` по 38 400 test-траекториям.
Оно не используется как биномиальная inferential-выборка. Описательное OOD coverage
при радиусах неопределённости `1,75x` равно `0,522917`.

## Интерпретация

Агрегат 800 независимых calibration/test-пар проходит coverage non-inferiority gate,
а C6-box воспроизводимо примерно на `21,5%` компактнее raw global box. Однако
зафиксированный протокол требовал также положительного результата каждой серии,
поэтому `confirmatory_replication_pass=false`. После просмотра данных ослаблять этот
критерий нельзя.

Отрицательный индивидуальный gate не является свидетельством систематического
недопокрытия: точечные оценки близки к цели `0,95`. Причина связана с мощностью
строгого exact 99% теста. При истинном coverage `0,95`:

- 400 проб требуют минимум 381 успех и имеют мощность `0,467970`;
- совместное прохождение двух независимых 400-probe серий имеет мощность `0,218996`;
- 800 объединённых проб имеют мощность `0,853783`;
- для мощности не менее 90% требуется минимум 897 проб на серию;
- для мощности не менее 95% требуется минимум 1069 проб на серию.

Этот post-run power-анализ объясняет результат, но не исправляет непройденный
протокол. Следующее исследование должно отдельно и заранее зафиксировать новый
размер выборки и новые seeds.

## Граница вывода

Получено программное свидетельство aggregate marginal block-coverage
non-inferiority и воспроизводимого уменьшения гиперобъёма в one-step oracle-state
модели. Не подтверждены прохождение строгого replication gate, estimator-fed или
recursive coverage, устойчивость к OOD, аппаратная безопасность и мировая новизна.
