11lisov11/mic_practice/research/mic_ai_theory/snh_pwm/c6_conformal_reachability/revalidation/PROTOCOL_LOCK_20260826_RU.md

# Внутренняя фиксация протокола C6-BCR

Дата фиксации: 26 августа 2026 г.

Этот файл фиксирует вычислительный протокол до запуска двух новых серий. Это
внутренняя prospective-фиксация в истории Git, а не внешняя пререгистрация и не
подтверждение научной новизны.

## Гипотезы и критерии

1. Для каждой серии 400 индикаторов покрытия строятся независимо условно на одной
   заранее сформированной training-выборке: новая calibration-выборка и ровно одна
   новая test-траектория на каждую пробу.
2. Целевое покрытие равно `0,95`. Non-inferiority margin заранее установлен равным
   `0,03`, поэтому exact one-sided Clopper-Pearson 99% lower bound должен быть не
   ниже `0,92` отдельно в каждой серии и после объединения 800 проб.
3. Отношение гиперобъёма C6 canonical tube к raw global tube должно иметь медиану
   не выше `0,90`. Односторонний exact sign test считает успехом только строгое
   `ratio < 0,90`; значения, равные порогу, исключаются как ties; требуется
   `p < 0,05` отдельно в каждой серии и после объединения.
4. Все seed-потоки должны быть уникальны и не пересекаться. Хеш полного протокола
   и исходников должен совпадать между сериями. Независимый анализатор должен
   полностью воспроизвести сохранённые результаты из seeds.
5. Bulk held-out coverage и OOD coverage являются только описательными величинами
   и не входят в положительный статистический gate.

## Зафиксированная конфигурация

| Параметр | Значение |
|---|---:|
| repetitions | 24 |
| training trajectories | 220 |
| calibration trajectories | 400 |
| bulk test trajectories | 800 |
| OOD trajectories | 200 |
| scored steps | 40 |
| burn-in steps | 20 |
| independent coverage probes | 400 |
| alpha | 0,05 |
| shape quantile | 0,80 |
| coverage error probability | 0,01 |
| root seed, серия A | 20260826 |
| root seed, серия B | 20260827 |

## Границы вывода

Модель использует истинное состояние и сектор потока статора как oracle-вход.
Эксперимент проверяет одношаговое marginal block coverage при принятых модельных
распределениях. Он не устанавливает recursive coverage, корректность оценивателя,
аппаратную безопасность, внешнюю пререгистрацию или мировую научную новизну.
