11lisov11/mic_practice/output/figures/measurement_adaptation_20260908/measurement_adaptation_comparison.pdf

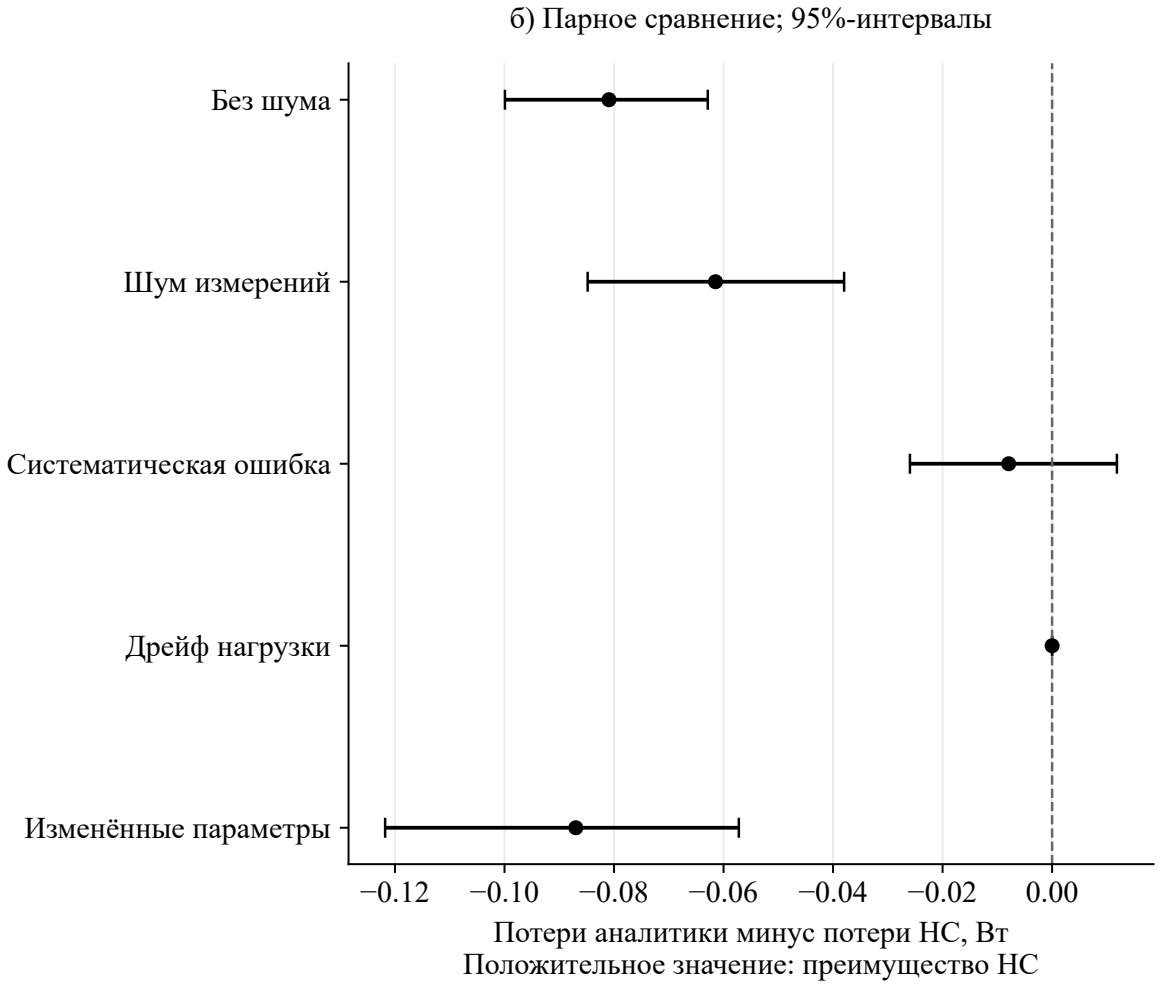
[picture p66: figure]
Потери аналитики минус потери НС, Вт Положительное значение: преимущество НС; Без шума; Шум измерений; Систематическая ошибка; Дрейф нагрузки; Изменённые параметры; б) Парное сравнение; 95%-интервалы

0 | 2 | 4 | 6 | 8 | 10
Снижение расчётных потерь, %

Лучшая проба

Аналитическая настройка

НС: исходная проба

НС: полное окно

а) Одинаковые скорость и нагрузка
