11lisov11/mic_practice/artifacts/board_flash_20260908/nucleo_pwm_active_02/pwm_measured.png

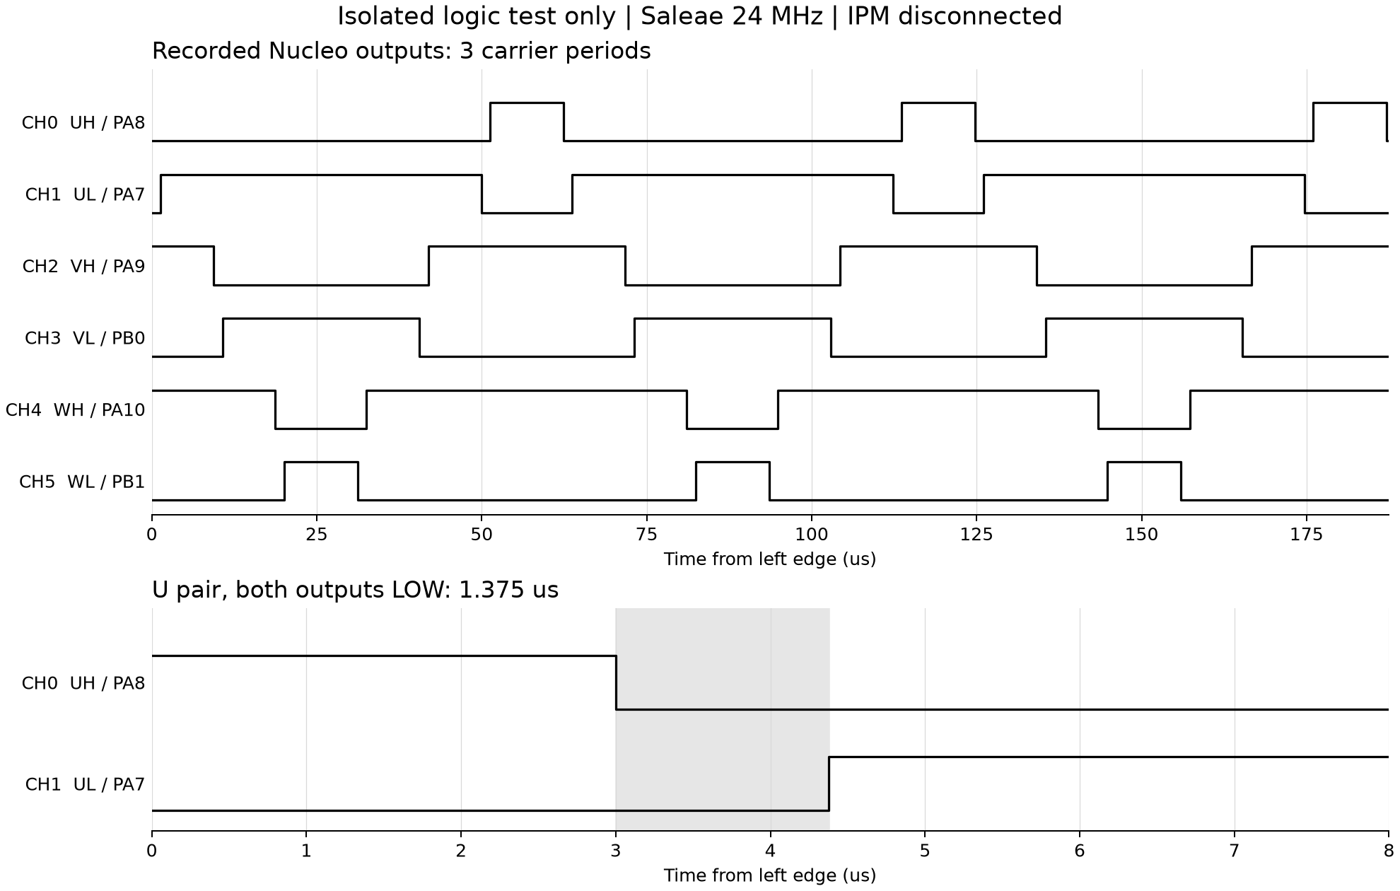
artifacts/board_flash_20260908/nucleo_pwm_active_02/pwm_measured.png
