11lisov11/mic_practice/artifacts/energy_value_validation_20260910_rev4/energy_value_comparison.png

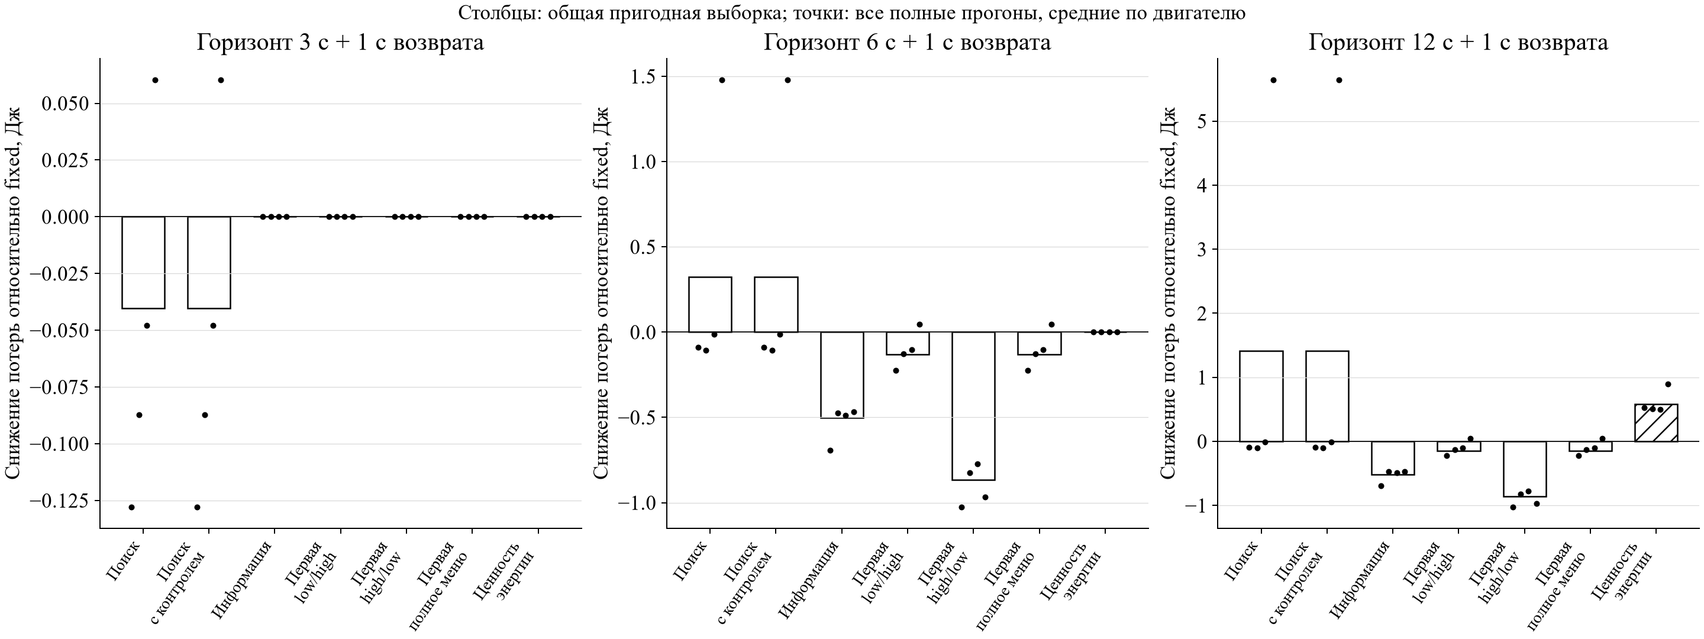
artifacts/energy_value_validation_20260910_rev4/energy_value_comparison.png
