11lisov11/mic_practice/docs/dissertation_2_9_3/figures/fig13_common_benchmark.png

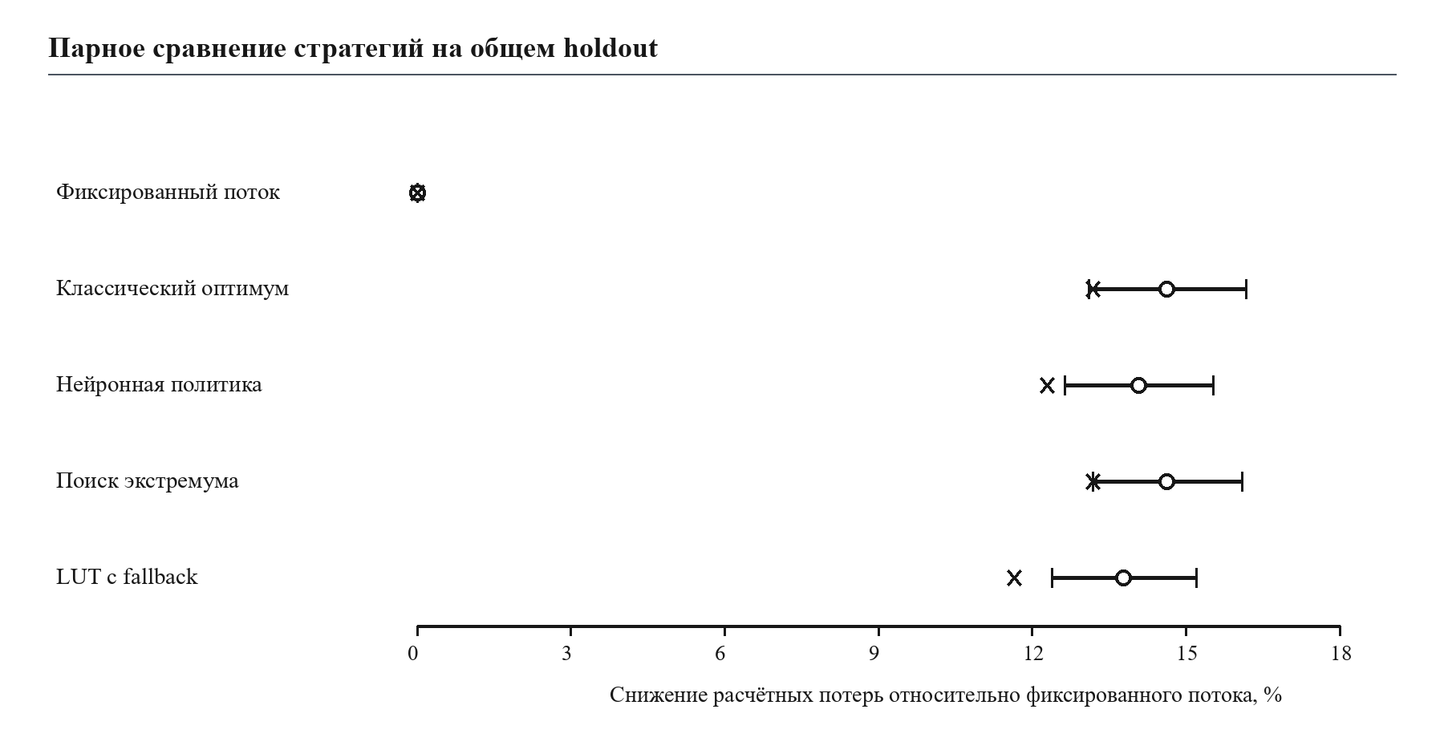
docs/dissertation_2_9_3/figures/fig13_common_benchmark.png
