11lisov11/mic_practice/output/documents/air56b2_report_assets/common_control_benchmark.png

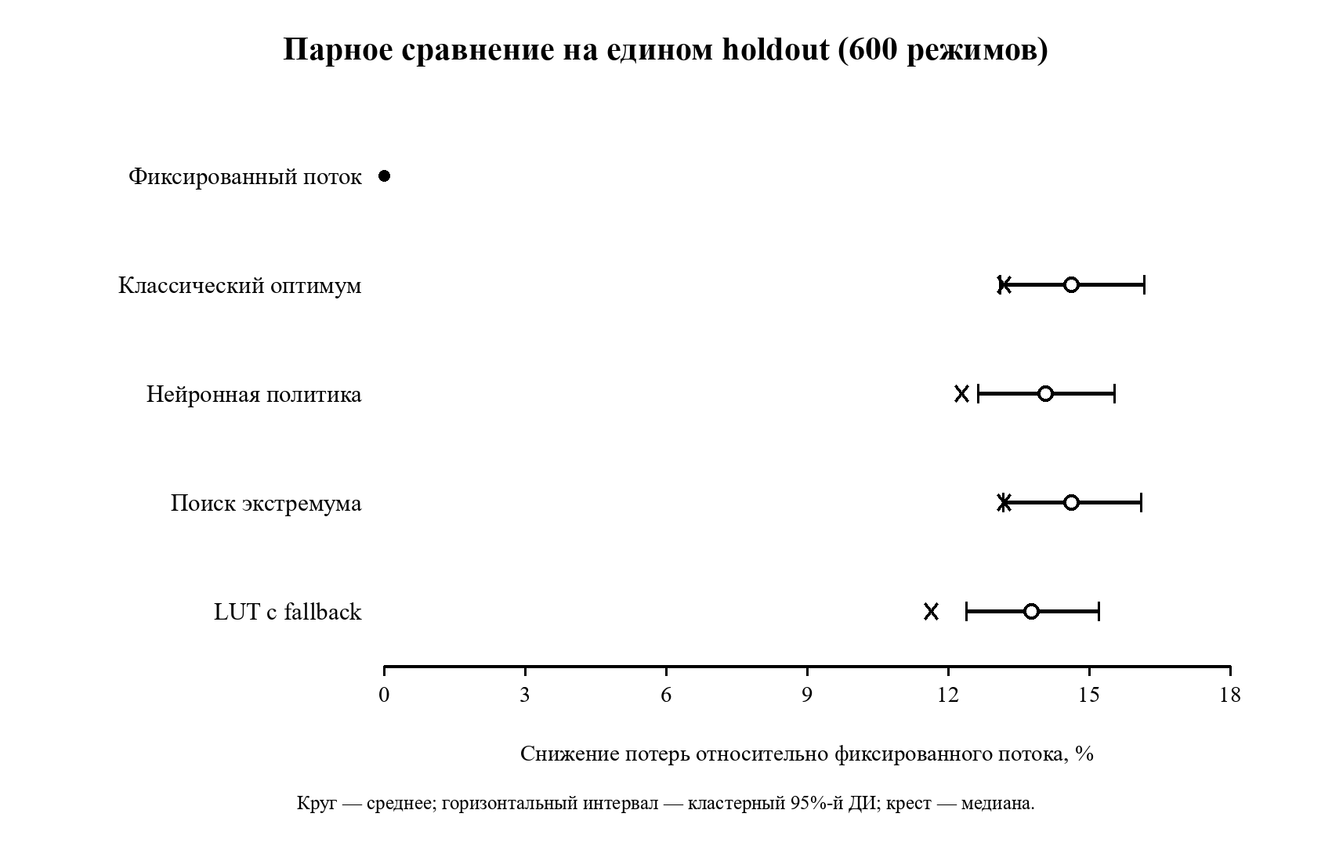
output/documents/air56b2_report_assets/common_control_benchmark.png
