11lisov11/mic_practice/output/figures/measurement_adaptation_20260908/measurement_adaptation_comparison.png

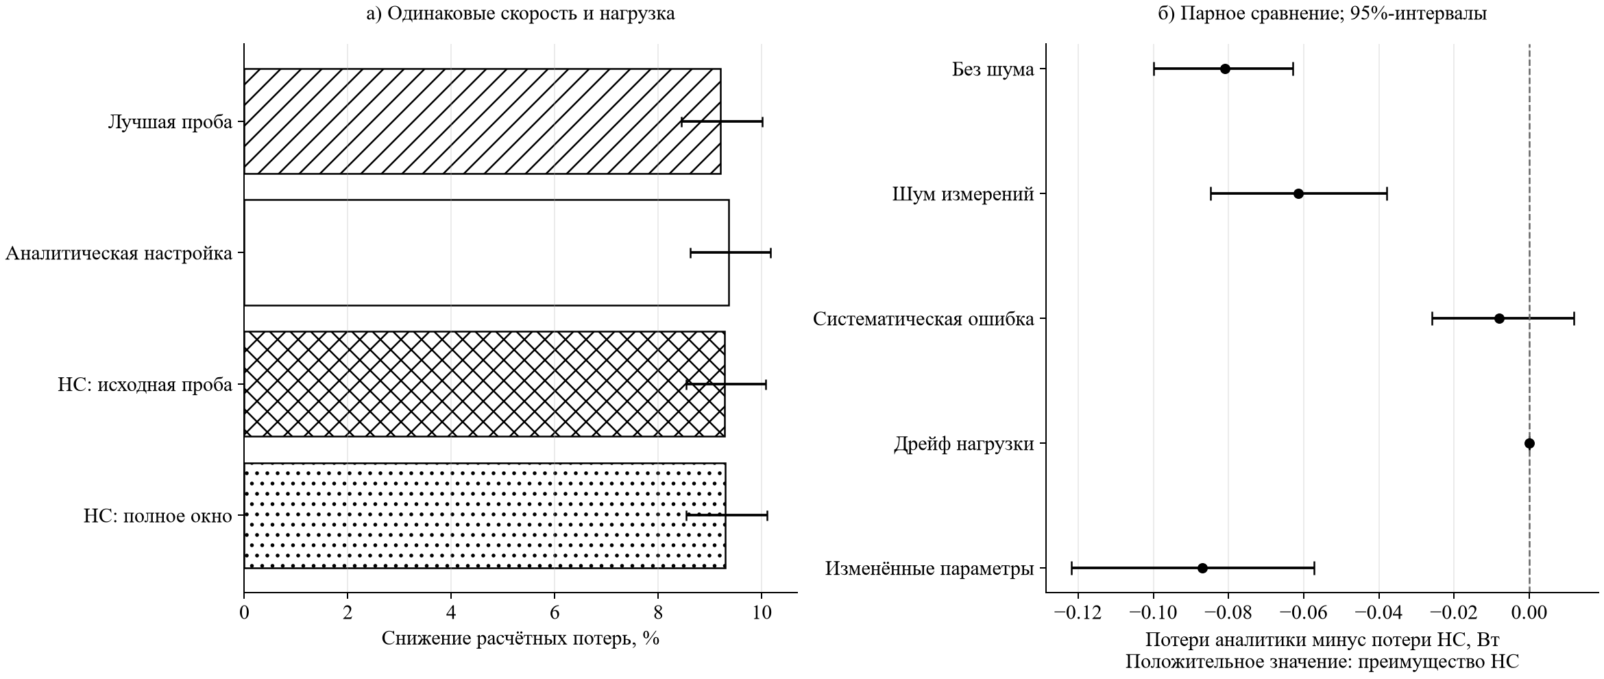
output/figures/measurement_adaptation_20260908/measurement_adaptation_comparison.png
