11lisov11/mic_practice/output/figures/dynamic_power_adaptation_20260908/dynamic_probe_energy.pdf

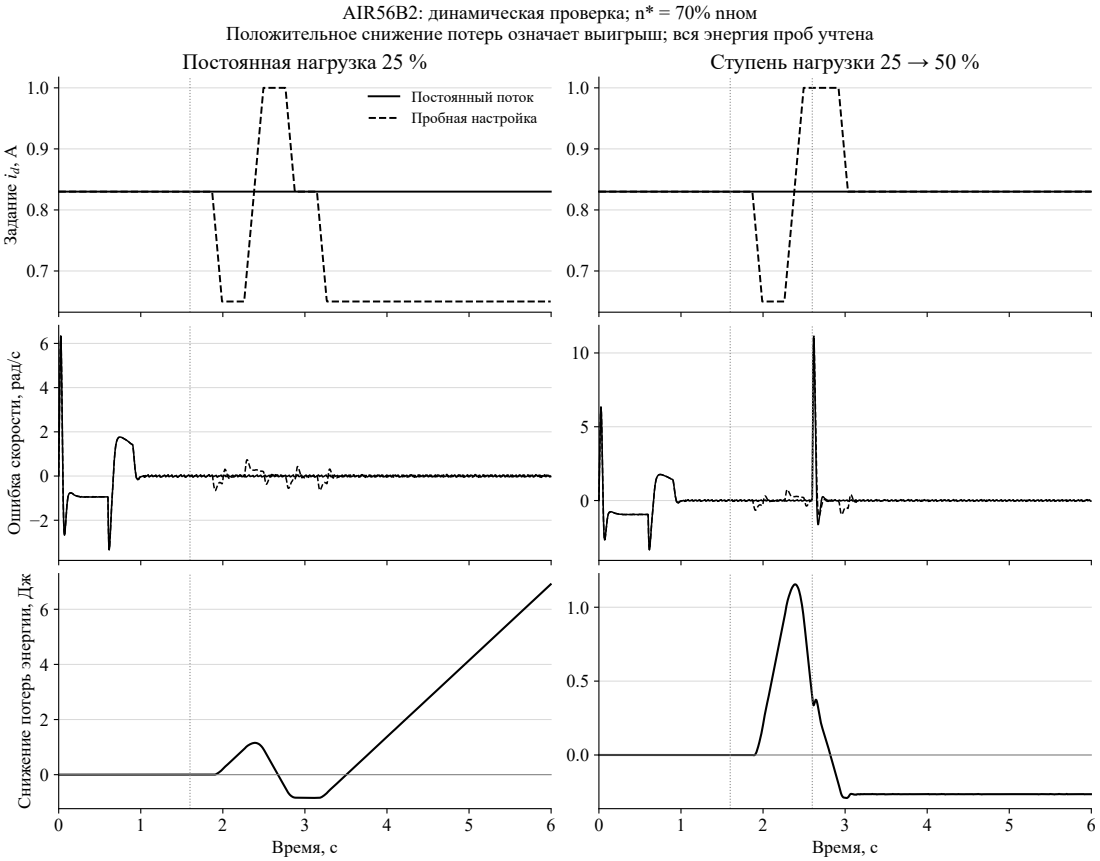
[picture p72: page 1]
Постоянный поток Пробная настройка; Ступень нагрузки 25 → 50 %; Время, с

AIR56B2: динамическая проверка; n* = 70% nном

Положительное снижение потерь означает выигрыш; вся энергия проб учтена
Постоянная нагрузка 25 %

Ошибка скорости, рад/с

Снижение потерь энергии, Дж
