11lisov11/mic_practice/firmware/updates/uart_guard_2026100801/source/nucleo/Inc/parameters_conversion.h

#define PARAMETERS_CONVERSION_H
#include "mc_math.h"
#include "arm_math.h"
#include "parameters_conversion_g4xx.h"
#include "acim_motor_parameters.h"
#include "drive_parameters.h"
#include "acim_lso_parameters.h"
#include "acim_vf_parameters.h"
#include "power_stage_parameters.h"
#define PI_VF_SPEED_OUTPUT_LIMIT (0.10f*NOMINAL_FREQ*2.0f*PI)
#define ACIM_VF
#define ADC_REFERENCE_VOLTAGE  3.30
#define TF_REGULATION_RATE 	(uint32_t) ((uint32_t)(PWM_FREQUENCY)/(REGULATION_EXECUTION_RATE))
#define TF_REGULATION_RATE_SCALED (uint16_t) ((uint32_t)(PWM_FREQUENCY)/(REGULATION_EXECUTION_RATE*PWM_FREQ_SCALING))
#define DPP_CONV_FACTOR (65536/PWM_FREQ_SCALING)
#define REP_COUNTER 			(uint16_t) ((REGULATION_EXECUTION_RATE *2u)-1u)
#define SYS_TICK_FREQUENCY          2000
#define UI_TASK_FREQUENCY_HZ        10
#define SERIAL_COM_TIMEOUT_INVERSE  25
#define SERIAL_COM_ATR_TIME_MS 20
#define MEDIUM_FREQUENCY_TASK_RATE	(uint16_t)SPEED_LOOP_FREQUENCY_HZ
#define CURRENT_CONV_FACTOR                    (uint16_t)((65536.0 * RSHUNT * AMPLIFICATION_GAIN)/ADC_REFERENCE_VOLTAGE)
#define CURRENT_CONV_FACTOR_INV                (1.0 / ((65536.0 * RSHUNT * AMPLIFICATION_GAIN) / ADC_REFERENCE_VOLTAGE))
#define MF_TASK_OCCURENCE_TICKS  (SYS_TICK_FREQUENCY/SPEED_LOOP_FREQUENCY_HZ)-1u
#define UI_TASK_OCCURENCE_TICKS  (SYS_TICK_FREQUENCY/UI_TASK_FREQUENCY_HZ)-1u
#define SERIALCOM_TIMEOUT_OCCURENCE_TICKS (SYS_TICK_FREQUENCY/SERIAL_COM_TIMEOUT_INVERSE)-1u
#define SERIALCOM_ATR_TIME_TICKS (uint16_t)(((SYS_TICK_FREQUENCY * SERIAL_COM_ATR_TIME_MS) / 1000u) - 1u)
#define MAX_APPLICATION_SPEED_UNIT ((MAX_APPLICATION_SPEED_RPM*SPEED_UNIT)/U_RPM)
#define MIN_APPLICATION_SPEED_UNIT ((MIN_APPLICATION_SPEED_RPM*SPEED_UNIT)/U_RPM)
#define MAX_APPLICATION_SPEED_UNIT2 ((MAX_APPLICATION_SPEED_RPM2*SPEED_UNIT)/U_RPM)
#define MIN_APPLICATION_SPEED_UNIT2 ((MIN_APPLICATION_SPEED_RPM2*SPEED_UNIT)/U_RPM)
#define OVERVOLTAGE_THRESHOLD_d   (uint16_t)(OV_VOLTAGE_THRESHOLD_V*65535/\
                                  (ADC_REFERENCE_VOLTAGE/VBUS_PARTITIONING_FACTOR))
#define UNDERVOLTAGE_THRESHOLD_d  (uint16_t)((UD_VOLTAGE_THRESHOLD_V*65535)/\
                                  ((uint16_t)(ADC_REFERENCE_VOLTAGE/\
                                                           VBUS_PARTITIONING_FACTOR)))
#define INT_SUPPLY_VOLTAGE          (uint16_t)(65536/ADC_REFERENCE_VOLTAGE)
#define DELTA_TEMP_THRESHOLD        (OV_TEMPERATURE_THRESHOLD_C- T0_C)
#define DELTA_V_THRESHOLD           (dV_dT * DELTA_TEMP_THRESHOLD)
#define OV_TEMPERATURE_THRESHOLD_d  ((V0_V + DELTA_V_THRESHOLD)*INT_SUPPLY_VOLTAGE)
#define DELTA_TEMP_HYSTERESIS        (OV_TEMPERATURE_HYSTERESIS_C)
#define DELTA_V_HYSTERESIS           (dV_dT * DELTA_TEMP_HYSTERESIS)
#define OV_TEMPERATURE_HYSTERESIS_d  (DELTA_V_HYSTERESIS*INT_SUPPLY_VOLTAGE)
#define ALIGNMENT_ANGLE_S16      (int16_t)  (M1_ALIGNMENT_ANGLE_DEG*65536u/360u)
#define PWM_PERIOD_CYCLES (uint16_t)(ADV_TIM_CLK_MHz*\
                                      (uint32_t)1000000u/((uint32_t)(PWM_FREQUENCY)))
#define DEADTIME_NS  SW_DEADTIME_NS
#define DEAD_TIME_ADV_TIM_CLK_MHz (ADV_TIM_CLK_MHz * TIM_CLOCK_DIVIDER)
#define DEAD_TIME_COUNTS_1  (DEAD_TIME_ADV_TIM_CLK_MHz * DEADTIME_NS/1000uL)
#if (DEAD_TIME_COUNTS_1 <= 255)
#define DEAD_TIME_COUNTS (uint16_t) DEAD_TIME_COUNTS_1
#elif (DEAD_TIME_COUNTS_1 <= 508)
#define DEAD_TIME_COUNTS (uint16_t)(((DEAD_TIME_ADV_TIM_CLK_MHz * DEADTIME_NS/2) /1000uL) + 128)
#elif (DEAD_TIME_COUNTS_1 <= 1008)
#define DEAD_TIME_COUNTS (uint16_t)(((DEAD_TIME_ADV_TIM_CLK_MHz * DEADTIME_NS/8) /1000uL) + 320)
#elif (DEAD_TIME_COUNTS_1 <= 2015)
#define DEAD_TIME_COUNTS (uint16_t)(((DEAD_TIME_ADV_TIM_CLK_MHz * DEADTIME_NS/16) /1000uL) + 384)
#else
#define DEAD_TIME_COUNTS 510
#endif
#define DTCOMPCNT (uint16_t)((DEADTIME_NS * ADV_TIM_CLK_MHz) / 2000)
#define TON_NS  500
#define TOFF_NS 500
#define TON  (uint16_t)((TON_NS * ADV_TIM_CLK_MHz)  / 2000)
#define TOFF (uint16_t)((TOFF_NS * ADV_TIM_CLK_MHz) / 2000)
#define SAMPLING_TIME ((ADC_SAMPLING_CYCLES * ADV_TIM_CLK_MHz) / ADC_CLK_MHz)
#define TRISE ((TRISE_NS * ADV_TIM_CLK_MHz)/1000U)
#define TDEAD ((uint16_t)((DEADTIME_NS * ADV_TIM_CLK_MHz)/1000U))
#define TNOISE ((uint16_t)((TNOISE_NS*ADV_TIM_CLK_MHz)/1000U))
#define HTMIN 1
#define TW_BEFORE ((uint16_t)((ADC_TRIG_CONV_LATENCY_CYCLES + ADC_SAMPLING_CYCLES) * ADV_TIM_CLK_MHz) / ADC_CLK_MHz  + 1U)
#define TW_BEFORE_R3_1 ((uint16_t)((ADC_TRIG_CONV_LATENCY_CYCLES + ADC_SAMPLING_CYCLES*2 + ADC_SAR_CYCLES) * ADV_TIM_CLK_MHz) / ADC_CLK_MHz  + 1U)
#define TW_AFTER ((uint16_t)(((DEADTIME_NS+MAX_TNTR_NS)*ADV_TIM_CLK_MHz)/1000U))
#define MAX_TWAIT ((uint16_t)((TW_AFTER - SAMPLING_TIME)/2U))
#define M1_VIRTUAL_HEAT_SINK_TEMPERATURE_VALUE   25U
#define M1_TEMP_SW_FILTER_BW_FACTOR      250U
#define PQD_CONVERSION_FACTOR (float_t)(((1.732 * ADC_REFERENCE_VOLTAGE) /\
             (RSHUNT * AMPLIFICATION_GAIN)) / 65536.0f)
#define USART_IRQHandler USART2_IRQHandler
#define COM_ENABLE | OPT_COM
#define DAC_ENABLE | OPT_DAC
#define DAC_OP_ENABLE | UI_CFGOPT_DAC
#define FW_ENABLE
#define DIFFTERM_ENABLE
 #if (!defined(MAIN_LSO_FOC)&&(!defined(MAIN_VF_OL)))
  #define MAIN_SCFG UI_SCODE_ENC
 #else
  #define MAIN_SCFG UI_SCODE_LSO
 #endif
#define AUX_SCFG 0x0
#define PLLTUNING_ENABLE
#define UI_CFGOPT_PFC_ENABLE
#define UI_CONFIG_M1 ( UI_CFGOPT_NONE DAC_OP_ENABLE FW_ENABLE DIFFTERM_ENABLE \
  | (MAIN_SCFG << MAIN_SCFG_POS) | (AUX_SCFG << AUX_SCFG_POS) | UI_CFGOPT_SETIDINSPDMODE PLLTUNING_ENABLE UI_CFGOPT_PFC_ENABLE | UI_CFGOPT_PLLTUNING)
#define UI_CONFIG_M2
#define DIN_ACTIVE_LOW Bit_RESET
#define DIN_ACTIVE_HIGH Bit_SET
#define DOUT_ACTIVE_HIGH   DOutputActiveHigh
#define DOUT_ACTIVE_LOW    DOutputActiveLow
#define M1_PULSE_NBR ( (4 * (M1_ENCODER_PPR)) - 1 )
#define M1_ENC_IC_FILTER  12
#define SPD_TIM_M1_IRQHandler TIM2_IRQHandler
#define MAX_MODULE 32439
#define SAMPLING_CYCLE_CORRECTION 0.5
#define LL_ADC_SAMPLINGTIME_1CYCLES_5 LL_ADC_SAMPLINGTIME_1CYCLE_5
#define LL_ADC_SAMPLING_CYCLE(CYCLE) LL_ADC_SAMPLINGTIME_ ## CYCLE ## CYCLES_5
#define DEFAULT_TORQUE_COMPONENT (DEFAULT_TORQUE_COMPONENT_A * CURRENT_CONV_FACTOR)
#define DEFAULT_FLUX_COMPONENT (DEFAULT_FLUX_COMPONENT_A * CURRENT_CONV_FACTOR)
#define M1_MAX_READABLE_CURRENT  (ADC_REFERENCE_VOLTAGE / (2 * RSHUNT * AMPLIFICATION_GAIN))
#define M2_MAX_READABLE_CURRENT (ADC_REFERENCE_VOLTAGE / (2 * RSHUNT2 * AMPLIFICATION_GAIN2))
