11lisov11/mic_practice/firmware/updates/uart_guard_2026100710/source/nucleo/Inc/main.h

#define Start_Stop_Pin GPIO_PIN_13
#define Start_Stop_GPIO_Port GPIOC
#define Start_Stop_EXTI_IRQn EXTI15_10_IRQn
#define M1_CURR_AMPL_W_Pin GPIO_PIN_0
#define M1_CURR_AMPL_W_GPIO_Port GPIOC
#define M1_CURR_AMPL_V_Pin GPIO_PIN_1
#define M1_CURR_AMPL_V_GPIO_Port GPIOC
#define M1_TEMPERATURE_Pin GPIO_PIN_2
#define M1_TEMPERATURE_GPIO_Port GPIOC
#define M1_CURR_AMPL_U_Pin GPIO_PIN_0
#define M1_CURR_AMPL_U_GPIO_Port GPIOA
#define M1_BUS_VOLTAGE_Pin GPIO_PIN_1
#define M1_BUS_VOLTAGE_GPIO_Port GPIOA
#define UART_TX_Pin GPIO_PIN_2
#define UART_TX_GPIO_Port GPIOA
#define UART_RX_Pin GPIO_PIN_3
#define UART_RX_GPIO_Port GPIOA
#define M1_OCP_Pin GPIO_PIN_6
#define M1_OCP_GPIO_Port GPIOA
#define M1_PWM_UL_Pin GPIO_PIN_7
#define M1_PWM_UL_GPIO_Port GPIOA
#define M1_PWM_VL_Pin GPIO_PIN_0
#define M1_PWM_VL_GPIO_Port GPIOB
#define M1_PWM_WL_Pin GPIO_PIN_1
#define M1_PWM_WL_GPIO_Port GPIOB
#define M1_PWM_UH_Pin GPIO_PIN_8
#define M1_PWM_UH_GPIO_Port GPIOA
#define M1_PWM_VH_Pin GPIO_PIN_9
#define M1_PWM_VH_GPIO_Port GPIOA
#define M1_PWM_WH_Pin GPIO_PIN_10
#define M1_PWM_WH_GPIO_Port GPIOA
#define TMS_Pin GPIO_PIN_13
#define TMS_GPIO_Port GPIOA
#define TCK_Pin GPIO_PIN_14
#define TCK_GPIO_Port GPIOA
