11lisov11/mic_practice/firmware/updates/uart_guard_2026100801_r2/source/nucleo/Inc/acim_motor_parameters.h

/**
  ******************************************************************************
  * @file    acim_motor_parameters.h
  * @author
  * @version
  * @date
  * @project
  * @path
  * @brief   This file contains the parameters needed for the Motor Control SDK
  *          in order to configure the ACIM FOC speed and current control.
  *      It is created by the ACIM GUI solving compatibility issues with the official release.
  *
  ******************************************************************************
  * @attention
  *
  * <h2><center>&copy; Copyright (c) 2026 STMicroelectronics International N.V.
  * All rights reserved.</center></h2>
  *
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
  ******************************************************************************
  */

/* Define to prevent recursive inclusion -------------------------------------*/
#ifndef __ACIM_MOTOR_PARAMS_H
#define __ACIM_MOTOR_PARAMS_H

/* Private defines ------------------------------------------------------------*/
#define RAD3DIV3        0.577350269f

/* Motor parameters ----------------------------------------------------------*/
#define POLE_PAIR_NUM   1 /* Number of motor pole pairs */
#define RS              0.35 /* Stator resistance , ohm*/
#define NOMINAL_CURRENT 1.24

/* Required by V/f control */
#define NOMINAL_PHASE_VOLTAGE  127 /* Nominal stator phase-to-neutral voltage, Vrms */

/* K = Vn/fn , it should be defined considering the pulsation we instead the frequency */
#define FLUX_K          ((float)(0.5717009))

#define NOMINAL_FREQ    50 /* Nominal frequency, Hz */

#define MOTOR_MAX_SPEED_RPM    3000 /*!< Maximum rated speed  */

/* ##@@_USER_CODE_START_##@@ */
/* ##@@_USER_CODE_END_##@@ */

#endif /*__ACIM_MOTOR_PARAMS_H*/

/******************* (C) COPYRIGHT 2026 STMicroelectronics *****END OF FILE****/
