11lisov11/mic_practice/UNOQ_MOTOR/UNOQ_MOTOR.ino

// Arduino UNO Q motor-control sketch (RouterBridge RPC + Nucleo UART)
// Target: arduino:zephyr:unoq (STM32U585)
//
// IMPORTANT (UNOQ): /dev/ttyHS1 on the Linux side is the control link to the MCU.
// In RouterBridge mode the core maps that internal link to the router serial and
// exposes debug/control logs through Monitor. D0/D1/Serial1 stay dedicated to
// the Nucleo motor-controller link.
#define USE_ROUTER_BRIDGE 1
#define USE_MSGPACK_RPC 0
#include <Arduino.h>
#include <Arduino_LED_Matrix.h>
#include <SPI.h>
#if USE_ROUTER_BRIDGE
#include <Arduino_RouterBridge.h>
#endif
#if defined(ARDUINO_ARCH_ZEPHYR)
#include <zephyr/kernel.h>
#endif
#include "id_ref_lut_motor1.h"

#include <stdint.h>
#include <string.h>
#include <stdlib.h>
#include <math.h>
#include "uno_q_control.h"
#include "superseded_reply.h"
#include "as5600_teacher.h"
#include "nucleo_fault_diagnostics.h"
#include "mcsdk_supervisory.h"
#include "link_timing.h"
static LinkTiming g_link_timing;
#include "deferred_log.h"
static DeferredLogQueue g_deferred_log;
#if USE_ROUTER_BRIDGE
#define LOG_SERIAL Monitor
#elif USE_MSGPACK_RPC
// Router RPC link to the Linux side (/dev/ttyHS1).
#define LOG_SERIAL Serial1
#else
#define LOG_SERIAL Serial
#endif
// RouterBridge aliases Serial to Monitor on UNO Q. Serial1 is the physical D0/D1
// UART used for the Nucleo link; do not also poll it as a text UI stream.
#if USE_ROUTER_BRIDGE
#define NUCLEO_SERIAL Serial1
#else
#define NUCLEO_SERIAL Serial
#define UI_SERIAL Serial1
#endif
#define RPC_BAUD 115200
static const uint32_t FW_BUILD_ID = 2026100804U;
static const uint8_t RPC_SCHEMA_VERSION = 3U;
static const uint8_t MC_CAP_VF = 0x01U;
#ifndef UART_ECHO_TEST
#define UART_ECHO_TEST 0
#endif
#ifndef PIN_TOGGLE_TEST
#define PIN_TOGGLE_TEST 0
#endif
#ifndef UART_TEST_SERIAL1
#define UART_TEST_SERIAL1 0
#endif
// ----------------------- Pins -----------------------
// PWM pins for IPM (6 signals)
// J2: 3=PWM-1H, 5=PWM-1L, 7=PWM-2H, 9=PWM-2L, 11=PWM-3H, 13=PWM-3L
static const uint8_t PWM_UH_PIN = 3;   // D3  (TIM3_CH3) -> PWM-1H
static const uint8_t PWM_UL_PIN = 5;   // D5  (TIM1_CH4) -> PWM-1L (invert in overlay)
static const uint8_t PWM_VH_PIN = 6;   // D6  (TIM3_CH4) -> PWM-2H
static const uint8_t PWM_VL_PIN = 8;   // D8  (TIM3_CH1) -> PWM-2L (enable PWM)
static const uint8_t PWM_WH_PIN = 9;   // D9  (TIM4_CH3) -> PWM-3H
static const uint8_t PWM_WL_PIN = 10;  // D10 (TIM4_CH4) -> PWM-3L (invert in overlay)
static const bool PWM_LOW_INVERTED = true;
// Safety mode: drive only high-side PWM, keep low-sides OFF to avoid shoot-through.
static const bool PWM_THREE_PWM_MODE = true;
// External PWM bridge to Nucleo (SPI/UART) for hardware dead-time + complementary outputs.
static const bool USE_EXTERNAL_PWM = true;
// MCSDK owns the PWM pins and accepts only a scalar V/F setpoint over UART.
#if defined(UNOQ_LOGIC_BENCH) && UNOQ_LOGIC_BENCH
// Logic-only image used with the isolated Nucleo PWM bench. Never release it
// as the production UNO Q firmware.
static const bool NUCLEO_MCSDK_ACIM_BACKEND = false;
#else
static const bool NUCLEO_MCSDK_ACIM_BACKEND = true;
#endif
static const bool USE_NUCLEO_SPI = false;
static const bool FORCE_SPI_BITBANG = false;
static const bool USE_NUCLEO_UART_FALLBACK = true;
static const uint32_t NUCLEO_UART_BAUD = 115200;
static const uint32_t NUCLEO_HEARTBEAT_MS = 50;
// Nucleo closes the fast control loops; UNO Q only sends supervisory setpoints.
// A 20 Hz command stream survives concurrent RouterBridge status polling without
// overflowing the small Zephyr UART receive buffer.
static const uint32_t NUCLEO_RUN_MIN_SEND_US = 50000;
// Scalar V/f is generated locally by the Nucleo. The same 20 Hz heartbeat is
// enough for the frequency ramp and cuts UART activity near switching nodes.
static const uint32_t NUCLEO_SCALAR_MIN_SEND_US = 50000;
static const uint32_t NUCLEO_RUN_REPLY_GUARD_US = 8000;
// Motor-controller UART protocol. BP_* identifiers are retained as wire-ABI
// compatibility names; the active peer is the STM32G431RB Nucleo firmware.
static const size_t BP_FRAME_LEN = 32;
static const size_t BP_CRC_OFF = BP_FRAME_LEN - 1;
static const uint8_t BP_VER = 0x02;
static const uint8_t BP_FLAG_ENABLE = 0x01;
static const uint8_t BP_FLAG_ESTOP = 0x02;
static const uint8_t BP_FLAG_DIAG_PWM = 0x04;
static const uint8_t BP_FLAG_CLEAR_FAULT = 0x08;
static const uint8_t BP_FLAG_VECTOR_ROTATE = 0x10;
static const uint8_t BP_STATUS_LINK_OK = 0x01;
static const uint8_t BP_STATUS_ENABLED = 0x02;
static const uint8_t BP_STATUS_ESTOP = 0x04;
static const uint8_t BP_STATUS_FAULT = 0x08;
static const uint8_t BP_STATUS_TIMEOUT = 0x10;
static const uint8_t BP_STATUS_PWM_ACTIVE = 0x20;
static const uint8_t BP_MODE_OFF = 0;
static const uint8_t BP_MODE_DIAG = 1;
static const uint8_t BP_MODE_DUTY = 2;
static const uint8_t BP_MODE_SCALAR = 3;
static const uint8_t BP_MODE_VECTOR = 4;
static const uint8_t BP_MODE_FOC = 5;
static const uint8_t BP_EXT_RESERVED_0 = 0x01;
static const uint8_t BP_EXT_PFC = 0x02;
static const uint8_t BP_EXT_BRAKE_PWM = 0x04;
static const uint8_t BP_EXT_PRECHARGE_RELAY = 0x08;
// Wire-protocol compatibility only. The current hardware does not install K1,
// so no command may assert the legacy precharge relay bit.
static const bool BP_PRECHARGE_RELAY_PRESENT = false;
static const uint8_t BP_CMD_FAN_DUTY_LO = 17;
static const uint8_t BP_CMD_FAN_DUTY_HI = 18;
static const uint8_t BP_RSP_FAN_DUTY_Q8 = 22;
static const uint8_t BP_RSP_FAN_TACH_X30 = 30;
static const float BP_FAN_TACH_RPM_STEP = 30.0f;
// New motor-controller zero capture; the high point remains provisional and HV arming
// is blocked by the HMI until a known-voltage capture is recorded.
static const uint16_t BP_VBUS_ZERO_RAW = 1966U;
static const uint16_t BP_VBUS_CAL_RAW = 3459U;
static const float BP_VBUS_CAL_V = 315.0f;
static const uint32_t BP_VBUS_STALE_MS = 500;
static const float BP_TEMP_VREF = 3.3f;
static const uint8_t BP_TEMP_SENSOR_NTC = 0;
static const uint8_t BP_TEMP_SENSOR_TSO = 1;
static const uint8_t BP_TEMP_SENSOR_MODE = BP_TEMP_SENSOR_TSO;
static const float BP_TEMP_PULLUP_OHM = 12000.0f;
static const float BP_TEMP_NTC_R25_OHM = 85000.0f;
static const float BP_TEMP_NTC_BETA_K = 4092.0f;
static const float BP_TEMP_TSO_V25 = 1.16f;
static const float BP_TEMP_TSO_MV_PER_C = 18.0f;
static const uint8_t BP_TEMP_FLAG_VALID = 0x01;
static const uint8_t BP_TEMP_FLAG_FAULT = 0x02;
static const float BP_PHASE_VREF = 3.3f;
static const uint8_t BP_PHASE_FLAG_VALID = 0x01;
static const uint8_t BP_PHASE_FLAG_C_VIRTUAL = 0x02;
static const uint8_t MC_TELEMETRY_FLAG_FW_BUILD_VALID = 0x10;
static const uint8_t MC_TELEMETRY_FLAG_SOFTSTART_READY = 0x20;
static const uint8_t MC_TELEMETRY_FLAG_VBUS_VALID = 0x40;
static const uint8_t MC_TELEMETRY_FLAG_MCSDK_UNITS = 0x80;
// SPI pins for UNOQ header
static const uint8_t NUCLEO_SPI_CS = 10;   // D10
static const uint8_t NUCLEO_SPI_SCK = 13;  // D13
static const uint8_t NUCLEO_SPI_MOSI = 11; // D11
static const uint8_t NUCLEO_SPI_MISO = 12; // D12
static SPISettings g_spi_settings(1000000, MSBFIRST, SPI_MODE0);
static const uint8_t PWM_MAX = 255;
static const uint16_t PWM_FULL = PWM_MAX + 1;
// Button input (external button to GND), internal pull-up enabled
static const uint8_t BUTTON_PIN = 2; // D2
// LED
static const uint8_t LED_PIN = LED_BUILTIN;
// Brake / enable output (to inverter brake/enable input)
static const uint8_t BRAKE_PIN = 4; // D4
static const bool BRAKE_ACTIVE_HIGH = true;
// Analog pins for sensing (optional)
static const uint8_t ADC_VDC_PIN = A0;
static const uint8_t ADC_IA_PIN  = A1;
static const uint8_t ADC_IB_PIN  = A2;
static const uint8_t ADC_IC_PIN  = A3;
static const bool USE_IC_SENSOR = true;
// ----------------------- Control constants -----------------------
static const uint32_t CONTROL_HZ = 1000;                  // 1 kHz control loop (PWM stays 10 kHz)
static const uint32_t CONTROL_US = 1000000UL / CONTROL_HZ;
static const uint32_t TELEMETRY_MS = 20;                  // 50 Hz telemetry
#define LOG_TELEMETRY_DATA 0
// IEK AIR56B2 is a 2-pole induction motor: one electrical pole pair.
static const float POLE_PAIRS = 1.0f;
static const float VDC_NOMINAL = 24.0f;
static const float VDC_ADC_VREF = 3.3f;
static const float VDC_ADC_DIVIDER = 11.0f;
static const float VDC_ADC_MIN_V = 5.0f;
static const float VDC_ADC_MAX_V = 60.0f;
static const float CURRENT_GAIN_A_PER_LSB = 0.004f;
static const float ADC_OFFSET_DEFAULT = 2048.0f;
static const uint32_t OFFSET_CAL_SAMPLES = 1024;
static const float DUTY_MIN = 0.03f;
static const float DUTY_MAX = 0.97f;
static const float PWM_DEADTIME_DUTY = 0.02f;
static const float ALIGN_TIME_MS = 400.0f;
static const float ALIGN_ID_REF_A = 1.0f;
static const float RUN_ID_REF_A = 1.0f;
static const float RUN_IQ_REF_A = 1.5f;
static const float IQ_RAMP_A_PER_S = 5.0f;
static const float FREQ_RAMP_HZ_PER_S = 5.0f; // scalar open-loop startup must not outrun the rotor
static const float CONTROL_DT = 1.0f / CONTROL_HZ;
static const float IQ_RAMP_STEP = IQ_RAMP_A_PER_S * CONTROL_DT;
static const float FREQ_RAMP_STEP = FREQ_RAMP_HZ_PER_S * CONTROL_DT;
static const float MIC_FREQ_TOL_HZ = 0.2f;
static const float MIC_FREQ_TOL_REL = 0.05f;
static const float MIC_FREQ_MIN_HZ = 1.0f;
static const float MIC_IQ_NOM_A = RUN_IQ_REF_A;
static const float MIC_ID_MIN_A = 0.5f * RUN_ID_REF_A;
static const float MIC_ID_MAX_A = 1.2f * RUN_ID_REF_A;
static const float MIC_ID_RATE_LIMIT_A_PER_S = 0.8f;
static const uint32_t MIC_ENC_STALE_MS = 500;
static const float MIC_SLIP_GATE_HZ = 0.5f;
static const float MIC_SLIP_GATE_REL = 0.02f;
static const float MIC_RS = 3.2f;
static const float MIC_LM = 0.25f;
static const float MIC_K_FE = 1e-4f;
static const float MIC_K_SW = 1e-5f;
static const float MIC_F_SW = 10000.0f;
static const uint32_t MODE_SWITCH_DEADTIME_MS = 500;
// ESTOP must stay latched until an explicit CLEAR/ESTOP CLEAR command.
static const uint32_t ESTOP_AUTO_CLEAR_MS = 0;
static const uint32_t BP_REPLY_TIMEOUT_MS = 500;
// Every START must be a bounded test/run. This prevents raw serial/RPC commands
// from bypassing the PC/HMI bench gate and leaving the inverter enabled.
static const bool START_REQUIRE_RUN_LIMIT = true;
static const float CURRENT_LIMIT_A = 6.0f;
// Experimental opt-in backend: UNO Q sends id/iq setpoints and the motor controller closes
// measured-angle FOC from AS5600/Hall/current ADC. Disabled by default so the
// already-validated duty backend remains the safe preflight baseline.
static const bool BP_FOC_BACKEND_DEFAULT = false;
static const float BP_FOC_CURRENT_A_PER_PU = CURRENT_LIMIT_A;
static const float AIR56B2_RATED_ELECTRICAL_FREQ_HZ = 50.0f;
static const float AIR56B2_MAX_ELECTRICAL_FREQ_HZ = AIR56B2_RATED_ELECTRICAL_FREQ_HZ;
static const float VF_BASE_FREQ_HZ = AIR56B2_RATED_ELECTRICAL_FREQ_HZ;
static const float VF_VOLT_PER_HZ_RATIO = 0.5f;
// Low-frequency scalar boost: enough startup voltage to overcome stiction
// without changing the high-frequency V/Hz slope.
static const float VF_START_BOOST_V = 24.0f;
static const float VF_START_BOOST_TAPER_HZ = 10.0f;
static const float VF_START_BOOST_MIN_FREQ_HZ = 0.1f;
static const float CTRL_PI = 3.1415926f;
static const float CTRL_TWO_PI = 6.2831852f;
static const float INV_SQRT3 = 0.5773503f;
// ----------------------- Types -----------------------
typedef enum {
  STATE_SAFE = 0,
  STATE_VF_RUN,
  STATE_FOC_ALIGN,
  STATE_FOC_RUN,
  STATE_FAULT
} ControlState;
typedef enum {
  MODE_VF = 0,
  MODE_FOC,
  MODE_MIC
} ControlMode;
typedef struct {
  float kp;
  float ki;
  float integrator;
  float out_min;
  float out_max;
} PIController;
static void pwm_force_off(bool force_link = false);
static void schedule_mode_switch(ControlMode next_mode, bool restart_after_switch);
static void request_mode(ControlMode next_mode, bool duty_mode, bool diag_pwm);
static void matrix_init();
static bool matrix_test_active();
static void matrix_start_test(uint32_t duration_ms);
static void matrix_update();
static void matrix_set_pixel(int x, int y);
static void matrix_draw_digit(int x0, int y0, int digit);
static void hard_stop(bool clear_cmd, bool force_link = false);
static void request_normal_stop();
static void ext_brake_set(float duty);
static void fan_set(float duty);
static void io_test_set(bool on);
static const char *start_precheck(uint32_t now_ms);
static void nucleo_uart_init();
static void nucleo_send_pwm(float d_u, float d_v, float d_w, bool enable, bool force = false);
static void nucleo_send_stop(bool force = false);
// ----------------------- Globals -----------------------
static ControlState g_state = STATE_SAFE;
static ControlMode g_mode = MODE_VF;
static ControlMode g_mode_pending = MODE_VF;
static bool g_mode_change_pending = false;
static bool g_pwm_enabled = false;
static bool g_pwm_outputs_active = false;
static bool g_pwm_forced_gpio = false;
static bool g_stop_requested = false;
static bool g_start_req = false;
static bool g_stop_req = false;
static bool g_toggle_req = false;
static uint32_t g_run_limit_ms = 0;
static uint32_t g_run_deadline_ms = 0;
static float g_vdc = VDC_NOMINAL;
static float g_v_limit = 12.0f;
static float g_vf_v_per_hz = 0.0f;
static float g_vf_volt_per_hz_ratio = VF_VOLT_PER_HZ_RATIO;
static float g_vf_start_boost_v = VF_START_BOOST_V;
static float g_theta = 0.0f;
static float g_omega_ref = 0.0f;
static float g_freq_cmd = 0.0f;
static float g_freq_ref = 0.0f;
static float g_id_ref = 0.0f;
static float g_iq_ref = 0.0f;
static float g_id_target = 0.0f;
static float g_iq_target = 0.0f;
static float g_offset_a = ADC_OFFSET_DEFAULT;
static float g_offset_b = ADC_OFFSET_DEFAULT;
static float g_offset_c = ADC_OFFSET_DEFAULT;
static uint32_t g_offset_count = 0;
static float g_offset_acc_a = 0.0f;
static float g_offset_acc_b = 0.0f;
static float g_offset_acc_c = 0.0f;
static bool g_offset_ready = false;
static PIController g_pi_id;
static PIController g_pi_iq;
static uint32_t g_align_ticks = 0;
static uint32_t g_last_control_us = 0;
static uint32_t g_last_telem_ms = 0;
static uint32_t g_last_button_ms = 0;
static bool g_led_on = false;
static uint32_t g_led_tick = 0;
static uint32_t g_link_led_ms = 0;
static bool g_link_led_state = false;
static uint32_t g_nucleo_last_rx_ms = 0;
static uint16_t g_nucleo_rx_good = 0;
static uint16_t g_nucleo_rx_bad = 0;
static uint32_t g_nucleo_last_tx_ms = 0;
static uint16_t g_bp_enc_raw = 0;
static bool g_bp_enc_ok = false;
static uint32_t g_bp_enc_ms = 0;
static As5600Sample g_as5600;
// Encoder speed estimate computed on UNO Q from motor-controller AS5600 samples.
// Units: RPM is mechanical (shaft) rpm. Electrical Hz assumes POLE_PAIRS.
static float g_enc_rpm = 0.0f;
static float g_enc_mech_hz = 0.0f;
static float g_enc_elec_hz = 0.0f;
static bool g_enc_speed_valid = false;
static uint16_t g_enc_prev_raw = 0;
static uint32_t g_enc_prev_ms = 0;
static int32_t g_enc_accum_counts = 0;
static uint32_t g_enc_accum_ms = 0;
// Motor-controller reply fields (decoded from the UART reply frame).
static uint8_t g_bp_status = 0;
static uint8_t g_bp_fault_code = 0;
static uint8_t g_bp_last_mode = 0;
static uint8_t g_bp_ext_flags = 0;
static uint16_t g_bp_brake_q15 = 0;
static uint16_t g_bp_vbus_raw = 0;
static float g_bp_vdc = 0.0f;
static uint32_t g_bp_vbus_ms = 0;
static uint16_t g_bp_temp_raw = 0;
static uint8_t g_bp_temp_flags = 0;
static float g_bp_temp_v = 0.0f;
static float g_bp_temp_c = 0.0f;
static uint32_t g_bp_temp_ms = 0;
static uint16_t g_bp_phase_a_raw = 0;
static uint16_t g_bp_phase_b_raw = 0;
static uint16_t g_bp_phase_c_raw = 2048;
static uint8_t g_bp_phase_flags = 0;
static uint32_t g_bp_fw_build = 0;
static NucleoFaultDiagnostics g_mc_diagnostics;
static bool g_bp_mcsdk_telemetry = false;
static bool g_bp_vbus_valid = false;
static bool g_bp_softstart_ready = false;
static float g_bp_phase_a_v = 0.0f;
static float g_bp_phase_b_v = 0.0f;
static float g_bp_phase_c_v = 0.0f;
static uint32_t g_bp_phase_ms = 0;
static uint16_t g_bp_good_cnt = 0;
static uint16_t g_bp_bad_cnt = 0;
static uint8_t g_bp_last_seq = 0;
static uint32_t g_bp_last_rsp_ms = 0;
// Motor-controller boot ping (0x5A 0xA5 ...) detector for wiring/baud diagnostics.
static uint32_t g_bp_ping_pairs = 0;
static uint32_t g_bp_ping_ms = 0;
static uint8_t g_bp_ping_prev = 0;
static const bool SELFTEST_ON_BOOT = false;
static uint8_t g_selftest_step = 0;
static uint32_t g_selftest_ms = 0;
static bool g_scope_test = false;
static bool g_scope_u = false;
static bool g_scope_v = false;
static bool g_scope_w = false;
static uint32_t g_scope_last_u_us = 0;
static uint32_t g_scope_last_v_us = 0;
static uint32_t g_scope_last_w_us = 0;
static bool g_pwm_test = false;
static float g_pwm_test_duty = 0.5f;
static bool g_diag_pwm = false;
static bool g_duty_mode = false;
static bool g_bp_foc_backend = BP_FOC_BACKEND_DEFAULT;
static uint8_t g_bp_cmd_mode = BP_MODE_OFF;
static float g_duty_u = 0.2f;
static float g_duty_v = 0.4f;
static float g_duty_w = 0.6f;
static char g_line_buf[96];
static uint8_t g_line_len = 0;
static char g_line_buf_ui[96];
static uint8_t g_line_len_ui = 0;
static ControlState g_last_state = STATE_SAFE;
static uint8_t g_last_fault = 0;
static bool g_last_pwm = false;
static uint32_t g_last_reg_ms = 0;
static float g_last_ia = 0.0f;
static float g_last_ib = 0.0f;
static float g_last_ic = 0.0f;
static float g_last_id = 0.0f;
static float g_last_iq = 0.0f;
static float g_last_i_rms = 0.0f;
static float g_last_vd = 0.0f;
static float g_last_vq = 0.0f;
static uint8_t g_fault = 0;
static bool g_mic_active = false;
static float g_mic_id_ref = RUN_ID_REF_A;
static float g_mic_saving_pct = 0.0f;
static float g_mic_p_loss = 0.0f;
static float g_mic_p_loss_base = 0.0f;
static int16_t g_mic_id_ref_q10 = (int16_t)(RUN_ID_REF_A * 1024.0f);
static uint8_t g_mic_gated = 0;
static uint8_t g_mic_enable_ai = 0;
static bool g_mic_enc_used = false;
static float g_mic_freq_meas_hz = 0.0f;
static float g_mic_speed_err_hz = 0.0f;
static float g_mic_speed_tol_hz = 0.0f;
static uint16_t g_mic_link_flags = 0u;
static uint16_t g_mic_status_flags = 0u;
static bool g_estop_latched = false;
static uint32_t g_estop_auto_clear_deadline_ms = 0;
static bool g_mode_switch_pending = false;
static uint32_t g_mode_switch_deadline_ms = 0;
static bool g_restart_after_mode_switch = false;
static float g_last_nonzero_freq = 10.0f;
static bool g_last_mic_active = false;
static bool g_brake_on = false;
static uint8_t g_ext_flags = 0;
static uint16_t g_brake_q15 = 0;
static uint16_t g_fan_q15 = 0;
static uint8_t g_bp_fan_duty_q8 = 0;
static uint8_t g_bp_fan_tach_x30 = 0;
static float g_bp_fan_duty = 0.0f;
static float g_bp_fan_rpm = 0.0f;
static bool g_io_test_mode = false;
static bool g_clear_fault_req = false;
static uint8_t g_nucleo_seq = 0;
static uint32_t g_nucleo_last_send_ms = 0;
static uint32_t g_nucleo_last_send_us = 0;
static bool g_nucleo_waiting_rsp = false;
static bool g_nucleo_waiting_clear = false;
static SupersededReplies g_nucleo_superseded;
static uint16_t g_nucleo_rx_superseded = 0;
static uint16_t g_nucleo_rx_bad_integrity = 0;
static uint16_t g_nucleo_rx_bad_sequence = 0;
static uint8_t g_nucleo_waiting_seq = 0;
static uint32_t g_nucleo_last_ack_us = 0;
static uint32_t g_nucleo_keepalive_ms = 0;
static uint32_t g_uart_bridge_ms = 0;
static Arduino_LED_Matrix g_matrix;
static bool g_matrix_ready = false;
static uint32_t g_matrix_last_ms = 0;
static uint32_t g_matrix_test_until_ms = 0;
static uint8_t g_matrix_pixels[104];
static uint32_t g_matrix_frame[4];
static const uint8_t MATRIX_W = 13;
static const uint8_t MATRIX_H = 8;
static const uint8_t DIGIT_3X5[10][5] = {
  {0x7, 0x5, 0x5, 0x5, 0x7},
  {0x2, 0x6, 0x2, 0x2, 0x7},
  {0x7, 0x1, 0x7, 0x4, 0x7},
  {0x7, 0x1, 0x7, 0x1, 0x7},
  {0x5, 0x5, 0x7, 0x1, 0x1},
  {0x7, 0x4, 0x7, 0x1, 0x7},
  {0x7, 0x4, 0x7, 0x5, 0x7},
  {0x7, 0x1, 0x2, 0x2, 0x2},
  {0x7, 0x5, 0x7, 0x5, 0x7},
  {0x7, 0x5, 0x7, 0x1, 0x7}
};
#if USE_ROUTER_BRIDGE
static bool g_bridge_ready = false;
static bool g_bridge_cmd_ready = false;
static bool g_bridge_get_ready = false;
static bool g_monitor_ready = false;
static bool g_bridge_announced = false;
static uint32_t g_bridge_last_ms = 0;
#endif
// ----------------------- MsgPack RPC -----------------------
#define RX_BUF_SIZE 256
#define TX_BUF_SIZE 256
static uint8_t g_rx_buf[RX_BUF_SIZE];
static size_t g_rx_len = 0;
static uint8_t g_tx_buf[TX_BUF_SIZE];
static size_t g_tx_len = 0;
static int32_t g_rpc_msgid = 1;
static void mp_tx_reset(void) {
  g_tx_len = 0;
}
static bool mp_tx_u8(uint8_t v) {
  if (g_tx_len >= TX_BUF_SIZE) {
    return false;
  }
  g_tx_buf[g_tx_len++] = v;
  return true;
}
static bool mp_tx_bytes(const void *data, size_t len) {
  if ((g_tx_len + len) > TX_BUF_SIZE) {
    return false;
  }
  memcpy(&g_tx_buf[g_tx_len], data, len);
  g_tx_len += len;
  return true;
}
static bool mp_tx_u16(uint16_t v) {
  uint8_t b[2];
  b[0] = (uint8_t)((v >> 8) & 0xFF);
  b[1] = (uint8_t)(v & 0xFF);
  return mp_tx_bytes(b, 2);
}
static bool mp_tx_u32(uint32_t v) {
  uint8_t b[4];
  b[0] = (uint8_t)((v >> 24) & 0xFF);
  b[1] = (uint8_t)((v >> 16) & 0xFF);
  b[2] = (uint8_t)((v >> 8) & 0xFF);
  b[3] = (uint8_t)(v & 0xFF);
  return mp_tx_bytes(b, 4);
}
static bool mp_tx_int(int32_t v) {
  if (v >= 0 && v <= 127) {
    return mp_tx_u8((uint8_t)v);
  }
  if (v >= -32 && v < 0) {
    return mp_tx_u8((uint8_t)v);
  }
  if (v >= -128 && v <= 127) {
    if (!mp_tx_u8(0xD0)) return false;
    return mp_tx_u8((uint8_t)v);
  }
  if (v >= -32768 && v <= 32767) {
    if (!mp_tx_u8(0xD1)) return false;
    return mp_tx_u16((uint16_t)v);
  }
  if (!mp_tx_u8(0xD2)) return false;
  return mp_tx_u32((uint32_t)v);
}
static bool mp_tx_bool(bool v) {
  return mp_tx_u8(v ? 0xC3 : 0xC2);
}
static bool mp_tx_nil(void) {
  return mp_tx_u8(0xC0);
}
static bool mp_tx_float(float f) {
  union { float f; uint32_t u; } u;
  u.f = f;
  if (!mp_tx_u8(0xCA)) return false;
  return mp_tx_u32(u.u);
}
static bool mp_tx_array(uint32_t n) {
  if (n < 16) {
    return mp_tx_u8(0x90 | (uint8_t)n);
  }
  if (n < 65536) {
    if (!mp_tx_u8(0xDC)) return false;
    return mp_tx_u16((uint16_t)n);
  }
  return false;
}
static bool mp_tx_str(const char *s) {
  size_t n = strlen(s);
  if (n < 32) {
    if (!mp_tx_u8(0xA0 | (uint8_t)n)) return false;
    return mp_tx_bytes(s, n);
  }
  if (n < 256) {
    if (!mp_tx_u8(0xD9)) return false;
    if (!mp_tx_u8((uint8_t)n)) return false;
    return mp_tx_bytes(s, n);
  }
  return false;
}
static void mp_tx_send(void) {
  if (g_tx_len > 0) {
    LOG_SERIAL.write(g_tx_buf, g_tx_len);
  }
}

static bool mp_rx_u8(const uint8_t *buf, size_t len, size_t *idx, uint8_t *out) {
  if (*idx >= len) return false;
  *out = buf[(*idx)++];
  return true;
}
static bool mp_rx_u16(const uint8_t *buf, size_t len, size_t *idx, uint16_t *out) {
  if ((*idx + 1) >= len) return false;
  uint16_t v = ((uint16_t)buf[*idx] << 8) | buf[*idx + 1];
  *idx += 2;
  *out = v;
  return true;
}
static bool mp_rx_u32(const uint8_t *buf, size_t len, size_t *idx, uint32_t *out) {
  if ((*idx + 3) >= len) return false;
  uint32_t v = ((uint32_t)buf[*idx] << 24) | ((uint32_t)buf[*idx + 1] << 16) |
               ((uint32_t)buf[*idx + 2] << 8) | buf[*idx + 3];
  *idx += 4;
  *out = v;
  return true;
}
static bool mp_rx_int(const uint8_t *buf, size_t len, size_t *idx, int32_t *out) {
  if (*idx >= len) return false;
  uint8_t t = buf[*idx];
  if (t <= 0x7F) {
    *out = t;
    (*idx)++;
    return true;
  }
  if (t >= 0xE0) {
    *out = (int8_t)t;
    (*idx)++;
    return true;
  }
  (*idx)++;
  if (t == 0xD0) {
    if (*idx >= len) return false;
    *out = (int8_t)buf[*idx];
    (*idx)++;
    return true;
  }
  if (t == 0xD1) {
    uint16_t v;
    if (!mp_rx_u16(buf, len, idx, &v)) return false;
    *out = (int16_t)v;
    return true;
  }
  if (t == 0xD2) {
    uint32_t v;
    if (!mp_rx_u32(buf, len, idx, &v)) return false;
    *out = (int32_t)v;
    return true;
  }
  if (t == 0xCC) {
    if (*idx >= len) return false;
    *out = buf[(*idx)++];
    return true;
  }
  if (t == 0xCD) {
    uint16_t v;
    if (!mp_rx_u16(buf, len, idx, &v)) return false;
    *out = v;
    return true;
  }
  if (t == 0xCE) {
    uint32_t v;
    if (!mp_rx_u32(buf, len, idx, &v)) return false;
    *out = (int32_t)v;
    return true;
  }
  return false;
}
static bool mp_rx_array(const uint8_t *buf, size_t len, size_t *idx, uint32_t *out) {
  if (*idx >= len) return false;
  uint8_t t = buf[*idx];
  if ((t & 0xF0) == 0x90) {
    *out = (uint32_t)(t & 0x0F);
    (*idx)++;
    return true;
  }
  (*idx)++;
  if (t == 0xDC) {
    uint16_t v;
    if (!mp_rx_u16(buf, len, idx, &v)) return false;
    *out = v;
    return true;
  }
  if (t == 0xDD) {
    uint32_t v;
    if (!mp_rx_u32(buf, len, idx, &v)) return false;
    *out = v;
    return true;
  }
  return false;
}
static bool mp_rx_map(const uint8_t *buf, size_t len, size_t *idx, uint32_t *out) {
  if (*idx >= len) return false;
  uint8_t t = buf[*idx];
  if ((t & 0xF0) == 0x80) {
    *out = (uint32_t)(t & 0x0F);
    (*idx)++;
    return true;
  }
  (*idx)++;
  if (t == 0xDE) {
    uint16_t v;
    if (!mp_rx_u16(buf, len, idx, &v)) return false;
    *out = v;
    return true;
  }
  if (t == 0xDF) {
    uint32_t v;
    if (!mp_rx_u32(buf, len, idx, &v)) return false;
    *out = v;
    return true;
  }
  return false;
}
static bool mp_rx_str(const uint8_t *buf, size_t len, size_t *idx, char *out, size_t out_len) {
  if (*idx >= len) return false;
  uint8_t t = buf[*idx];
  uint32_t n = 0;
  if ((t & 0xE0) == 0xA0) {
    n = (uint32_t)(t & 0x1F);
    (*idx)++;
  } else {
    (*idx)++;
    if (t == 0xD9) {
      if (*idx >= len) return false;
      n = buf[(*idx)++];
    } else if (t == 0xDA) {
      uint16_t v;
      if (!mp_rx_u16(buf, len, idx, &v)) return false;
      n = v;
    } else if (t == 0xDB) {
      uint32_t v;
      if (!mp_rx_u32(buf, len, idx, &v)) return false;
      n = v;
    } else if (t == 0xC4) { // bin8
      if (*idx >= len) return false;
      n = buf[(*idx)++];
    } else if (t == 0xC5) { // bin16
      uint16_t v;
      if (!mp_rx_u16(buf, len, idx, &v)) return false;
      n = v;
    } else if (t == 0xC6) { // bin32
      uint32_t v;
      if (!mp_rx_u32(buf, len, idx, &v)) return false;
      n = v;
    } else {
      return false;
    }
  }
  if ((*idx + n) > len) return false;
  uint32_t copy = (n < (out_len - 1)) ? n : (out_len - 1);
  memcpy(out, &buf[*idx], copy);
  out[copy] = '\0';
  *idx += n;
  return true;
}
static bool mp_rx_cmd_string(const uint8_t *buf, size_t len, size_t *idx, char *out, size_t out_len);
static bool mp_skip(const uint8_t *buf, size_t len, size_t *idx);
static bool mp_skip_array(const uint8_t *buf, size_t len, size_t *idx, uint32_t count) {
  for (uint32_t i = 0; i < count; i++) {
    if (!mp_skip(buf, len, idx)) return false;
  }
  return true;
}
static bool mp_skip_map(const uint8_t *buf, size_t len, size_t *idx, uint32_t count) {
  for (uint32_t i = 0; i < count; i++) {
    if (!mp_skip(buf, len, idx)) return false; // key
    if (!mp_skip(buf, len, idx)) return false; // value
  }
  return true;
}
static bool mp_skip(const uint8_t *buf, size_t len, size_t *idx) {
  if (*idx >= len) return false;
  uint8_t t = buf[(*idx)++];
  if (t <= 0x7F || t >= 0xE0) {
    return true;
  }
  if ((t & 0xE0) == 0xA0) {
    uint32_t n = (uint32_t)(t & 0x1F);
    if ((*idx + n) > len) return false;
    *idx += n;
    return true;
  }
  if (t == 0xC4) { // bin8
    if (*idx >= len) return false;
    uint32_t n = buf[(*idx)++];
    if ((*idx + n) > len) return false;
    *idx += n;
    return true;
  }
  if (t == 0xC5) { // bin16
    uint16_t n;
    if (!mp_rx_u16(buf, len, idx, &n)) return false;
    if ((*idx + n) > len) return false;
    *idx += n;
    return true;
  }
  if (t == 0xC6) { // bin32
    uint32_t n;
    if (!mp_rx_u32(buf, len, idx, &n)) return false;
    if ((*idx + n) > len) return false;
    *idx += n;
    return true;
  }
  if ((t & 0xF0) == 0x90) {
    uint32_t n = (uint32_t)(t & 0x0F);
    return mp_skip_array(buf, len, idx, n);
  }
  if ((t & 0xF0) == 0x80) {
    uint32_t n = (uint32_t)(t & 0x0F);
    return mp_skip_map(buf, len, idx, n);
  }
  if (t == 0xCC || t == 0xD0) {
    if (*idx >= len) return false;
    (*idx)++;
    return true;
  }
  if (t == 0xCD || t == 0xD1) {
    if ((*idx + 1) >= len) return false;
    *idx += 2;
    return true;
  }
  if (t == 0xCE || t == 0xD2 || t == 0xCA) {
    if ((*idx + 3) >= len) return false;
    *idx += 4;
    return true;
  }
  if (t == 0xCB) {
    if ((*idx + 7) >= len) return false;
    *idx += 8;
    return true;
  }
  if (t == 0xC0 || t == 0xC2 || t == 0xC3) {
    return true;
  }
  if (t == 0xD9) {
    if (*idx >= len) return false;
    uint32_t n = buf[(*idx)++];
    if ((*idx + n) > len) return false;
    *idx += n;
    return true;
  }
  if (t == 0xDA) {
    uint16_t n;
    if (!mp_rx_u16(buf, len, idx, &n)) return false;
    if ((*idx + n) > len) return false;
    *idx += n;
    return true;
  }
  if (t == 0xDB) {
    uint32_t n;
    if (!mp_rx_u32(buf, len, idx, &n)) return false;
    if ((*idx + n) > len) return false;
    *idx += n;
    return true;
  }
  if (t == 0xDC) {
    uint16_t n;
    if (!mp_rx_u16(buf, len, idx, &n)) return false;
    return mp_skip_array(buf, len, idx, n);
  }
  if (t == 0xDD) {
    uint32_t n;
    if (!mp_rx_u32(buf, len, idx, &n)) return false;
    return mp_skip_array(buf, len, idx, n);
  }
  if (t == 0xDE) {
    uint16_t n;
    if (!mp_rx_u16(buf, len, idx, &n)) return false;
    return mp_skip_map(buf, len, idx, n);
  }
  if (t == 0xDF) {
    uint32_t n;
    if (!mp_rx_u32(buf, len, idx, &n)) return false;
    return mp_skip_map(buf, len, idx, n);
  }
  return false;
}
static bool mp_rx_cmd_string(const uint8_t *buf, size_t len, size_t *idx, char *out, size_t out_len) {
  if (*idx >= len) return false;
  size_t start = *idx;
  if (mp_rx_str(buf, len, idx, out, out_len)) {
    return true;
  }
  // Reset and try container types.
  *idx = start;
  uint8_t t = buf[*idx];
  // Array: try first element as string, then skip the rest.
  if ((t & 0xF0) == 0x90 || t == 0xDC || t == 0xDD) {
    uint32_t n = 0;
    if (!mp_rx_array(buf, len, idx, &n)) return false;
    bool ok = false;
    if (n > 0) {
      ok = mp_rx_cmd_string(buf, len, idx, out, out_len);
      for (uint32_t i = 1; i < n; i++) {
        if (!mp_skip(buf, len, idx)) {
          *idx = len;
          break;
        }
      }
    }
    return ok;
  }
  // Map: accept {"cmd": "..."} as a convenience.
  if ((t & 0xF0) == 0x80 || t == 0xDE || t == 0xDF) {
    uint32_t n = 0;
    if (!mp_rx_map(buf, len, idx, &n)) return false;
    bool found = false;
    for (uint32_t i = 0; i < n; i++) {
      char key[16];
      size_t k0 = *idx;
      if (!mp_rx_str(buf, len, idx, key, sizeof(key))) {
        *idx = k0;
        if (!mp_skip(buf, len, idx)) { *idx = len; break; }
        if (!mp_skip(buf, len, idx)) { *idx = len; break; }
        continue;
      }
      if (strcmp(key, "cmd") == 0) {
        found = mp_rx_str(buf, len, idx, out, out_len);
        if (!found) {
          // Consume value even if we couldn't decode it as a string.
          (void)mp_skip(buf, len, idx);
        }
      } else {
        if (!mp_skip(buf, len, idx)) { *idx = len; break; }
      }
    }
    return found;
  }

  // Unknown type: consume it and report failure.
  if (!mp_skip(buf, len, idx)) {
    *idx = len;
  }
  return false;
}
static void rpc_send_response_bool(int32_t msgid, bool ok) {
  mp_tx_reset();
  mp_tx_array(4);
  mp_tx_int(1);       // response
  mp_tx_int(msgid);
  mp_tx_nil();
  mp_tx_bool(ok);
  mp_tx_send();
}
static void rpc_send_response_error(int32_t msgid, const char *err) {
  mp_tx_reset();
  mp_tx_array(4);
  mp_tx_int(1);
  mp_tx_int(msgid);
  mp_tx_str(err);
  mp_tx_nil();
  mp_tx_send();
}
static void rpc_send_response_get(int32_t msgid) {
  float ia = g_last_ia;
  float ib = g_last_ib;
  float ic = g_last_ic;
  mp_tx_reset();
  mp_tx_array(4);
  mp_tx_int(1);
  mp_tx_int(msgid);
  mp_tx_nil();
  // Keep this in sync with web_hmi/server.py (array result mapping).
  mp_tx_array(91);
  mp_tx_int((int32_t)g_state);
  mp_tx_int((int32_t)g_mode);
  mp_tx_int(g_pwm_enabled ? 1 : 0);
  mp_tx_float(g_freq_ref);
  mp_tx_float((g_freq_ref * 60.0f) / POLE_PAIRS);
  mp_tx_float(ia);
  mp_tx_float(ib);
  mp_tx_float(ic);
  mp_tx_float(g_vdc);
  mp_tx_float(g_last_id);
  mp_tx_float(g_last_iq);
  mp_tx_float(g_last_i_rms);
  mp_tx_int(g_mic_active ? 1 : 0);
  mp_tx_float(g_mic_id_ref);
  mp_tx_float(g_mic_saving_pct);
  mp_tx_float(g_freq_cmd);
  mp_tx_int(g_estop_latched ? 1 : 0);
  mp_tx_int(0);  // Legacy NTC field; J2-21 is unused on STEVAL-IPM15B.
  mp_tx_int((g_ext_flags & BP_EXT_PFC) ? 1 : 0);
  mp_tx_int((g_ext_flags & BP_EXT_BRAKE_PWM) ? 1 : 0);
  float brake = (g_ext_flags & BP_EXT_BRAKE_PWM) ? ((float)g_brake_q15 / 32767.0f) : 0.0f;
  mp_tx_float(brake);

  // Encoder telemetry from the motor controller.
  bool enc_recent = (uint32_t)(millis() - g_bp_enc_ms) < 500U;
  int enc_ok = (g_bp_enc_ok && enc_recent) ? 1 : 0;
  float enc_deg = ((float)g_bp_enc_raw * 360.0f) / 4096.0f;
  mp_tx_int((int32_t)g_bp_enc_raw);
  mp_tx_int(enc_ok);
  mp_tx_float(enc_deg);

  // Motor-controller link stats (UNO Q-side counters + ages).
  uint32_t bp_age = (g_nucleo_last_rx_ms == 0) ? 999999U : (uint32_t)(millis() - g_nucleo_last_rx_ms);
  mp_tx_int((int32_t)g_nucleo_rx_good);
  mp_tx_int((int32_t)g_nucleo_rx_bad);
  mp_tx_int((int32_t)bp_age);

  // Decoded fields from the last motor-controller reply.
  mp_tx_int((int32_t)g_bp_status);
  mp_tx_int((int32_t)g_bp_fault_code);
  mp_tx_int((int32_t)g_bp_last_mode);
  mp_tx_int((int32_t)g_bp_last_seq);

  // Boot ping detector (0x5A 0xA5 ...) ages.
  uint32_t ping_age = (g_bp_ping_ms == 0) ? 999999U : (uint32_t)(millis() - g_bp_ping_ms);
  mp_tx_int((int32_t)g_bp_ping_pairs);
  mp_tx_int((int32_t)ping_age);

  uint32_t rsp_age = (g_bp_last_rsp_ms == 0) ? 999999U : (uint32_t)(millis() - g_bp_last_rsp_ms);
  mp_tx_int((int32_t)rsp_age);
  // Extended encoder telemetry (append-only).
  mp_tx_float(enc_ok ? g_enc_rpm : 0.0f);
  mp_tx_float(enc_ok ? g_enc_mech_hz : 0.0f);
  mp_tx_float(enc_ok ? g_enc_elec_hz : 0.0f);
  mp_tx_int((int32_t)g_mic_gated);
  mp_tx_int((int32_t)g_mic_enable_ai);
  mp_tx_int(g_mic_enc_used ? 1 : 0);
  mp_tx_float(g_mic_freq_meas_hz);
  mp_tx_float(g_mic_speed_err_hz);
  mp_tx_float(g_mic_speed_tol_hz);
  mp_tx_int((int32_t)g_mic_link_flags);
  mp_tx_int((int32_t)g_mic_status_flags);
  mp_tx_int(g_diag_pwm ? 1 : 0);
  mp_tx_int(g_duty_mode ? 1 : 0);
  uint32_t bp_vbus_age = (g_bp_vbus_ms == 0) ? 999999U : (uint32_t)(millis() - g_bp_vbus_ms);
  mp_tx_int((int32_t)g_bp_vbus_raw);
  mp_tx_float(g_bp_vdc);
  mp_tx_int((int32_t)bp_vbus_age);
  mp_tx_int((int32_t)g_bp_temp_raw);
  mp_tx_float(g_bp_temp_v);
  mp_tx_float(g_bp_temp_c);
  mp_tx_int((int32_t)g_bp_temp_flags);
  mp_tx_int((int32_t)g_bp_phase_a_raw);
  mp_tx_int((int32_t)g_bp_phase_b_raw);
  mp_tx_int((int32_t)g_bp_phase_c_raw);
  mp_tx_float(g_bp_phase_a_v);
  mp_tx_float(g_bp_phase_b_v);
  mp_tx_float(g_bp_phase_c_v);
  mp_tx_int((int32_t)g_bp_phase_flags);
  uint32_t bp_phase_age = (g_bp_phase_ms == 0) ? 999999U : (uint32_t)(millis() - g_bp_phase_ms);
  mp_tx_int((int32_t)bp_phase_age);
  mp_tx_int((int32_t)g_bp_ext_flags);
  mp_tx_int(g_io_test_mode ? 1 : 0);
  mp_tx_int((g_bp_ext_flags & BP_EXT_PRECHARGE_RELAY) ? 1 : 0);
  mp_tx_float((float)g_fan_q15 / 32767.0f);
  mp_tx_float(g_bp_fan_duty);
  mp_tx_float(g_bp_fan_rpm);
  mp_tx_int(g_bp_foc_backend ? 1 : 0);
  mp_tx_int((int32_t)g_bp_cmd_mode);
  mp_tx_int((int32_t)FW_BUILD_ID);
  mp_tx_int(matrix_test_active() ? 1 : 0);
  mp_tx_int(g_bp_mcsdk_telemetry ? 1 : 0);
  mp_tx_int(g_bp_vbus_valid ? 1 : 0);
  mp_tx_int(0);  // RPC index 74: legacy precharge_managed, always false.
  mp_tx_int((int32_t)RPC_SCHEMA_VERSION);
  mp_tx_int(g_bp_softstart_ready ? 1 : 0);
  mp_tx_int((int32_t)MC_CAP_VF);  // Current Nucleo MCSDK image supports scalar V/f only.
  mp_tx_int((int32_t)g_bp_fw_build);  // RPC index 78: Nucleo firmware identity.
  mp_tx_int(g_mc_diagnostics.valid ? 1 : 0);
  mp_tx_int(g_mc_diagnostics.reason);
  mp_tx_int(g_mc_diagnostics.uart_errors);
  mp_tx_int(g_mc_diagnostics.motor_state);
  mp_tx_int(g_mc_diagnostics.current_faults);
  mp_tx_int(g_mc_diagnostics.occurred_faults);
  mp_tx_int(g_mc_diagnostics.sequence);
  mp_tx_int(g_mc_diagnostics.tx_status);
  mp_tx_int(g_mc_diagnostics.last_bad_valid ? 1 : 0);
  mp_tx_int(g_mc_diagnostics.last_bad_reason);
  mp_tx_int(g_mc_diagnostics.last_uart_errors);
  mp_tx_int(g_mc_diagnostics.last_tx_status);
  mp_tx_send();
}
static void rpc_send_register(const char *name) {
  mp_tx_reset();
  const int32_t msgid = g_rpc_msgid++;
  mp_tx_array(4);
  mp_tx_int(0);  // request
  mp_tx_int(msgid);
  mp_tx_str("$/register");
  mp_tx_array(1);
  mp_tx_str(name);
  mp_tx_send();
}
static void rpc_send_reset(void) {
  mp_tx_reset();
  mp_tx_array(3);
  mp_tx_int(2);
  mp_tx_str("$/reset");
  mp_tx_array(0);
  mp_tx_send();
}
static void rpc_send_mon_write(const char *line) {
  mp_tx_reset();
  mp_tx_array(3);
  mp_tx_int(2);
  mp_tx_str("mon/write");
  mp_tx_array(1);
  mp_tx_str(line);
  mp_tx_send();
}
static bool icmp(const char *a, const char *b) {
  while (*a && *b) {
    char ca = (char)tolower(*a++);
    char cb = (char)tolower(*b++);
    if (ca != cb) return false;
  }
  return (*a == '\0' && *b == '\0');
}
static bool starts_ci(const char *s, const char *prefix) {
  while (*prefix) {
    char cs = (char)tolower(*s++);
    char cp = (char)tolower(*prefix++);
    if (cs != cp) return false;
  }
  return true;
}
static bool is_digit_char(char c) {
  return c >= '0' && c <= '9';
}
static bool parse_float_token(const char **p, float *out) {
  while (**p == ' ' || **p == '\t') (*p)++;
  if (**p == '\0') return false;
  const char *start = *p;
  const char *s = start;
  if (*s == '+' || *s == '-') s++;
  bool any_digit = false;
  while (is_digit_char(*s)) {
    any_digit = true;
    s++;
  }
  if (*s == '.') {
    s++;
    while (is_digit_char(*s)) {
      any_digit = true;
      s++;
    }
  }
  if (!any_digit) return false;
  if (*s == 'e' || *s == 'E') {
    s++;
    if (*s == '+' || *s == '-') s++;
    bool exp_digit = false;
    while (is_digit_char(*s)) {
      exp_digit = true;
      s++;
    }
    if (!exp_digit) return false;
  }
  if (*s != '\0' && *s != ' ' && *s != '\t') return false;
  float v = (float)atof(start);
  if (isnan(v) || isinf(v)) return false;
  *out = v;
  *p = s;
  return true;
}
static bool parse_single_float_arg(const char *p, float *out) {
  if (!parse_float_token(&p, out)) return false;
  while (*p == ' ' || *p == '\t') p++;
  return *p == '\0';
}
static int parse_duty_triple(const char *p, float *a, float *b, float *c) {
  float vals[3] = {0};
  int count = 0;
  while (*p && count < 3) {
    float v = 0.0f;
    if (!parse_float_token(&p, &v)) {
      return 0;
    }
    vals[count++] = v;
  }
  while (*p == ' ' || *p == '\t') p++;
  if (*p != '\0') return 0;
  if (count == 1) {
    *a = vals[0];
    *b = vals[0];
    *c = vals[0];
    return 1;
  }
  if (count >= 3) {
    *a = vals[0];
    *b = vals[1];
    *c = vals[2];
    return 3;
  }
  return 0;
}
static void clear_estop_latch() {
  g_estop_latched = false;
  g_fault = 0;
  g_nucleo_rx_bad = 0;
  g_bp_bad_cnt = 0;
  g_clear_fault_req = true;
  g_estop_auto_clear_deadline_ms = 0;
  hard_stop(false, true);
  brake_set(false);
  ext_brake_set(0.0f);
}
static void request_estop_stop() {
  g_estop_latched = true;
  g_fault = 2;
  // Emergency stop wins over any pending motor-controller CLEAR handshake.
  g_clear_fault_req = false;
  g_estop_auto_clear_deadline_ms = (ESTOP_AUTO_CLEAR_MS > 0) ? (millis() + ESTOP_AUTO_CLEAR_MS) : 0;
  hard_stop(false, true);
  brake_set(false);
  ext_brake_set(0.0f);
  pwm_write(0, 0, 0);
}
static void handle_estop_command(const char *arg) {
  while (*arg == ' ' || *arg == '\t') arg++;
  if (icmp(arg, "CLEAR") || icmp(arg, "OFF") || icmp(arg, "RESET")) {
    clear_estop_latch();
  } else {
    request_estop_stop();
  }
}
static bool handle_fan_command(const char *arg) {
  while (*arg == ' ' || *arg == '\t') arg++;
  if (icmp(arg, "ON") || icmp(arg, "1")) {
    fan_set(1.0f);
    return true;
  }
  if (icmp(arg, "OFF") || icmp(arg, "0")) {
    fan_set(0.0f);
    return true;
  }
  if (starts_ci(arg, "PWM")) {
    arg += 3;
  }
  float duty = 0.0f;
  if (!parse_single_float_arg(arg, &duty)) {
    return false;
  }
  fan_set(clampf(duty, 0.0f, 1.0f));
  return true;
}
static bool handle_mcfoc_command(const char *arg) {
  while (*arg == ' ' || *arg == '\t') arg++;
  if (icmp(arg, "OFF") || icmp(arg, "0")) {
    g_bp_foc_backend = false;
    if (g_pwm_enabled || g_state != STATE_SAFE) {
      request_normal_stop();
    } else {
      nucleo_send_stop(true);
    }
    return true;
  }
  if (icmp(arg, "ON") || icmp(arg, "1")) {
    if (NUCLEO_MCSDK_ACIM_BACKEND) {
      return false;
    }
    if (g_pwm_enabled || g_state != STATE_SAFE || g_estop_latched || g_fault != 0) {
      return false;
    }
    g_bp_foc_backend = true;
    nucleo_send_stop(true);
    return true;
  }
  return false;
}
static void estop_auto_clear_tick() {
  if (!g_estop_latched) {
    return;
  }
  if (g_estop_auto_clear_deadline_ms == 0) {
    return;
  }
  if (g_state != STATE_SAFE || g_pwm_enabled) {
    return;
  }
  uint32_t now = millis();
  if ((int32_t)(now - g_estop_auto_clear_deadline_ms) < 0) {
    return;
  }
  clear_estop_latch();
}
static bool bp_fault_or_timeout(uint32_t now_ms) {
  bool bp_fault = (g_bp_fault_code != 0) ||
                  ((g_bp_status & BP_STATUS_FAULT) != 0u) ||
                  ((g_bp_status & BP_STATUS_TIMEOUT) != 0u);
  bool bp_stale = false;
  if (g_pwm_enabled) {
    if (g_bp_last_rsp_ms == 0) {
      if (g_nucleo_last_tx_ms != 0) {
        bp_stale = (uint32_t)(now_ms - g_nucleo_last_tx_ms) > BP_REPLY_TIMEOUT_MS;
      }
    } else {
      bp_stale = (uint32_t)(now_ms - g_bp_last_rsp_ms) > BP_REPLY_TIMEOUT_MS;
    }
  }
  return bp_fault || bp_stale;
}
static const char *start_precheck(uint32_t now_ms) {
  if (g_estop_latched) {
    return "estop latched";
  }
  if (g_state != STATE_SAFE) {
    return "not safe";
  }
  if (g_pwm_enabled) {
    return "pwm already enabled";
  }
  if (START_REQUIRE_RUN_LIMIT && g_run_limit_ms == 0U) {
    return "runlimit required";
  }
  if (USE_EXTERNAL_PWM) {
    if (g_nucleo_last_rx_ms == 0 ||
        (uint32_t)(now_ms - g_nucleo_last_rx_ms) > BP_REPLY_TIMEOUT_MS ||
        g_bp_last_rsp_ms == 0 ||
        (uint32_t)(now_ms - g_bp_last_rsp_ms) > BP_REPLY_TIMEOUT_MS) {
      return "bluepill link stale";
    }
    if ((g_bp_status & BP_STATUS_LINK_OK) == 0U) {
      return "bluepill link not ready";
    }
    if (g_bp_fault_code != 0 ||
        (g_bp_status & (BP_STATUS_ESTOP | BP_STATUS_FAULT | BP_STATUS_TIMEOUT)) != 0U) {
      return "bluepill unsafe";
    }
    if ((g_bp_status & BP_STATUS_PWM_ACTIVE) != 0U) {
      return "bluepill pwm active";
    }
    if (g_nucleo_rx_bad != 0U || g_bp_bad_cnt != 0U) {
      return "bluepill bad counter";
    }
  }
  return nullptr;
}
class NullStream : public Stream {
 public:
  int available() override { return 0; }
  int read() override { return -1; }
  int peek() override { return -1; }
  void flush() override {}
  size_t write(uint8_t) override { return 1; }
};
static NullStream g_null_stream;
static void rpc_process_request(int32_t msgid, const char *method, const uint8_t *buf, size_t len, size_t *idx, uint32_t param_count) {
  if (strcmp(method, "cmd") == 0) {
    char cmd_buf[80];
    if (param_count < 1) {
      rpc_send_response_error(msgid, "bad params");
      return;
    }
    // Consume the full request even on parse errors to avoid desyncing the stream.
    if (!mp_rx_cmd_string(buf, len, idx, cmd_buf, sizeof(cmd_buf))) {
      for (uint32_t i = 1; i < param_count; i++) {
        (void)mp_skip(buf, len, idx);
      }
      rpc_send_response_error(msgid, "bad params");
      return;
    }
    for (uint32_t i = 1; i < param_count; i++) {
      if (!mp_skip(buf, len, idx)) {
        // Drop remaining payload on failure.
        *idx = len;
        rpc_send_response_error(msgid, "bad params");
        return;
      }
    }
    const char *cmd = cmd_buf;
    while (*cmd == ' ' || *cmd == '\t') cmd++;
    bool handled = true;
    if (icmp(cmd, "START")) {
      const char *start_err = start_precheck(millis());
      if (start_err != nullptr) {
        rpc_send_response_error(msgid, start_err);
        return;
      }
      if (g_mode == MODE_MIC && g_freq_cmd < 0.1f) {
        g_freq_cmd = (g_last_nonzero_freq > 0.1f) ? g_last_nonzero_freq : 10.0f;
      }
      g_start_req = true;
    } else if (icmp(cmd, "STOP")) {
      request_normal_stop();
    } else if (icmp(cmd, "CLEAR") || icmp(cmd, "RESET")) {
      clear_estop_latch();
    } else if (starts_ci(cmd, "MODE")) {
      const char *p = cmd + 4;
      while (*p == ' ' || *p == '\t') p++;
      if (icmp(p, "VF")) {
        request_mode(MODE_VF, false, false);
      } else if (icmp(p, "FOC")) {
        request_mode(MODE_FOC, false, false);
      } else if (icmp(p, "MIC")) {
        request_mode(MODE_MIC, false, false);
      } else if (icmp(p, "DUTY")) {
        request_mode(MODE_VF, true, false);
      } else {
        handled = false;
      }
    } else if (starts_ci(cmd, "DIAG")) {
      const char *p = cmd + 4;
      while (*p == ' ' || *p == '\t') p++;
      if (icmp(p, "ON") || icmp(p, "1")) {
        request_mode(MODE_VF, false, true);
      } else if (icmp(p, "OFF") || icmp(p, "0")) {
        g_diag_pwm = false;
      } else {
        handled = false;
      }
    } else if (starts_ci(cmd, "DUTY")) {
      const char *p = cmd + 4;
      float du = g_duty_u;
      float dv = g_duty_v;
      float dw = g_duty_w;
      if (parse_duty_triple(p, &du, &dv, &dw) > 0) {
        g_duty_u = clampf(du, 0.0f, 1.0f);
        g_duty_v = clampf(dv, 0.0f, 1.0f);
        g_duty_w = clampf(dw, 0.0f, 1.0f);
        g_duty_mode = true;
        g_diag_pwm = false;
      } else {
        handled = false;
      }
    } else if (starts_ci(cmd, "SET FREQ")) {
      const char *p = cmd + 8;
      float f = 0.0f;
      if (parse_single_float_arg(p, &f)) {
        f = clampf(f, 0.0f, AIR56B2_MAX_ELECTRICAL_FREQ_HZ);
        g_freq_cmd = f;
        if (f > 0.1f) g_last_nonzero_freq = f;
      } else {
        handled = false;
      }
    } else if (starts_ci(cmd, "SET VFBOOST")) {
      const char *p = cmd + 11;
      float v = 0.0f;
      if (parse_single_float_arg(p, &v)) {
        g_vf_start_boost_v = clampf(v, 0.0f, 120.0f);
      } else {
        handled = false;
      }
    } else if (starts_ci(cmd, "SET VFRATIO")) {
      const char *p = cmd + 11;
      float r = 0.0f;
      if (parse_single_float_arg(p, &r)) {
        g_vf_volt_per_hz_ratio = clampf(r, 0.0f, 1.0f);
      } else {
        handled = false;
      }
    } else if (starts_ci(cmd, "SET RUNLIMIT")) {
      const char *p = cmd + 12;
      float seconds = 0.0f;
      if (parse_single_float_arg(p, &seconds)) {
        set_run_limit(seconds);
      } else {
        handled = false;
      }
    } else if (icmp(cmd, "DISPLAY TEST")) {
      matrix_start_test(15000U);
    } else if (starts_ci(cmd, "ESTOP")) {
      const char *p = cmd + 5;
      handle_estop_command(p);
    } else if (starts_ci(cmd, "SCOPE")) {
      const char *p = cmd + 5;
      while (*p == ' ' || *p == '\t') p++;
      if (icmp(p, "ON") || icmp(p, "1")) {
        scope_set(true);
      } else if (icmp(p, "OFF") || icmp(p, "0")) {
        scope_set(false);
      } else {
        handled = false;
      }
    } else if (starts_ci(cmd, "PWMTEST")) {
      const char *p = cmd + 7;
      while (*p == ' ' || *p == '\t') p++;
      if (icmp(p, "ON") || icmp(p, "1")) {
        pwm_test_set(true);
      } else if (icmp(p, "OFF") || icmp(p, "0")) {
        pwm_test_set(false);
      } else {
        handled = false;
      }
    } else if (starts_ci(cmd, "IOTEST")) {
      const char *p = cmd + 6;
      while (*p == ' ' || *p == '\t') p++;
      if (icmp(p, "ON") || icmp(p, "1")) {
        io_test_set(true);
      } else if (icmp(p, "OFF") || icmp(p, "0")) {
        io_test_set(false);
      } else {
        handled = false;
      }
    } else if (starts_ci(cmd, "PFC")) {
      const char *p = cmd + 3;
      while (*p == ' ' || *p == '\t') p++;
      if (icmp(p, "ON") || icmp(p, "1")) {
        ext_flag_set(BP_EXT_PFC, true);
      } else if (icmp(p, "OFF") || icmp(p, "0")) {
        ext_flag_set(BP_EXT_PFC, false);
      } else {
        handled = false;
      }
    } else if (starts_ci(cmd, "PRECHARGE") || starts_ci(cmd, "RELAY")) {
      const char *p = starts_ci(cmd, "PRECHARGE") ? (cmd + 9) : (cmd + 5);
      while (*p == ' ' || *p == '\t') p++;
      if (icmp(p, "ON") || icmp(p, "1")) {
        if (BP_PRECHARGE_RELAY_PRESENT) {
          ext_flag_set(BP_EXT_PRECHARGE_RELAY, true);
        } else {
          handled = false;
        }
      } else if (icmp(p, "OFF") || icmp(p, "0")) {
        ext_flag_set(BP_EXT_PRECHARGE_RELAY, false);
      } else {
        handled = false;
      }
    } else if (starts_ci(cmd, "FAN")) {
      handled = handle_fan_command(cmd + 3);
    } else if (starts_ci(cmd, "MCFOC")) {
      handled = handle_mcfoc_command(cmd + 5);
    } else if (starts_ci(cmd, "BPFOC")) {
      handled = handle_mcfoc_command(cmd + 5);  // Legacy alias.
    } else if (starts_ci(cmd, "BRAKE")) {
      const char *p = cmd + 5;
      while (*p == ' ' || *p == '\t') p++;
      if (starts_ci(p, "PWM")) {
        p += 3;
        float duty = 0.0f;
        if (parse_single_float_arg(p, &duty)) {
          ext_brake_set(clampf(duty, 0.0f, 1.0f));
        } else {
          handled = false;
        }
      } else if (icmp(p, "OFF") || icmp(p, "0")) {
        brake_set(false);
        ext_brake_set(0.0f);
      } else if (icmp(p, "ON") || icmp(p, "1")) {
        brake_set(true);
        ext_brake_set(0.0f);
      } else {
        handled = false;
      }
    } else {
      handled = false;
    }
    if (!handled) {
      rpc_send_response_error(msgid, "unknown cmd");
      return;
    }
    rpc_send_response_bool(msgid, true);
    return;
  }
  if (strcmp(method, "get") == 0) {
    for (uint32_t i = 0; i < param_count; i++) {
      if (!mp_skip(buf, len, idx)) {
        rpc_send_response_error(msgid, "bad params");
        return;
      }
    }
    rpc_send_response_get(msgid);
    return;
  }
  for (uint32_t i = 0; i < param_count; i++) {
    if (!mp_skip(buf, len, idx)) {
      return;
    }
  }
  rpc_send_response_error(msgid, "no method");
}
static bool rpc_try_parse_one(size_t *consumed) {
  size_t idx = 0;
  uint32_t arr_len = 0;
  if (!mp_rx_array(g_rx_buf, g_rx_len, &idx, &arr_len)) {
    return false;
  }
  if (arr_len < 3) {
    *consumed = idx;
    return true;
  }
  int32_t msg_type = 0;
  if (!mp_rx_int(g_rx_buf, g_rx_len, &idx, &msg_type)) return false;
  if (msg_type == 0) {
    int32_t msgid = 0;
    if (!mp_rx_int(g_rx_buf, g_rx_len, &idx, &msgid)) return false;
    char method[32];
    if (!mp_rx_str(g_rx_buf, g_rx_len, &idx, method, sizeof(method))) return false;
    uint32_t param_count = 0;
    if (!mp_rx_array(g_rx_buf, g_rx_len, &idx, &param_count)) return false;
    // arduino-router may deliver the request over UART in multiple chunks (e.g. up to the
    // params array header first, then the actual string bytes). Do not dispatch until the
    // full params payload is present, otherwise we'll incorrectly answer "bad params" and
    // break framing.
    size_t idx_check = idx;
    for (uint32_t i = 0; i < param_count; i++) {
      if (!mp_skip(g_rx_buf, g_rx_len, &idx_check)) {
        return false; // need more bytes
      }
    }
    rpc_process_request(msgid, method, g_rx_buf, g_rx_len, &idx, param_count);
    idx = idx_check;
  } else if (msg_type == 1) {
    int32_t msgid = 0;
    if (!mp_rx_int(g_rx_buf, g_rx_len, &idx, &msgid)) return false;
    if (!mp_skip(g_rx_buf, g_rx_len, &idx)) return false; // error
    if (!mp_skip(g_rx_buf, g_rx_len, &idx)) return false; // result
  } else if (msg_type == 2) {
    char method[32];
    if (!mp_rx_str(g_rx_buf, g_rx_len, &idx, method, sizeof(method))) return false;
    uint32_t param_count = 0;
    if (!mp_rx_array(g_rx_buf, g_rx_len, &idx, &param_count)) return false;
    for (uint32_t i = 0; i < param_count; i++) {
      if (!mp_skip(g_rx_buf, g_rx_len, &idx)) {
        return false;
      }
    }
  } else {
    // Unknown message type: try to skip remaining elements
    for (uint32_t i = 1; i < arr_len; i++) {
      if (!mp_skip(g_rx_buf, g_rx_len, &idx)) {
        return false;
      }
    }
  }
  *consumed = idx;
  return true;
}
static void rpc_poll(void) {
  while (LOG_SERIAL.available() > 0) {
    if (g_rx_len >= RX_BUF_SIZE) {
      g_rx_len = 0;
      break;
    }
    g_rx_buf[g_rx_len++] = (uint8_t)LOG_SERIAL.read();
  }
  while (g_rx_len > 0) {
    size_t consumed = 0;
    if (!rpc_try_parse_one(&consumed)) {
      break;
    }
    if (consumed == 0 || consumed > g_rx_len) {
      g_rx_len = 0;
      break;
    }
    memmove(g_rx_buf, &g_rx_buf[consumed], g_rx_len - consumed);
    g_rx_len -= consumed;
  }
}
// ----------------------- Helpers -----------------------
static const char *state_name(ControlState s) {
  switch (s) {
    case STATE_SAFE: return "SAFE";
    case STATE_VF_RUN: return "VF_RUN";
    case STATE_FOC_ALIGN: return "FOC_ALIGN";
    case STATE_FOC_RUN: return "FOC_RUN";
    case STATE_FAULT: return "FAULT";
    default: return "UNKNOWN";
  }
}
static const char *mode_name(ControlMode m) {
  if (m == MODE_VF) return "VF";
  if (m == MODE_MIC) return "MIC";
  return "FOC";
}
static void bridge_notify_line(const String &line) {
#if USE_ROUTER_BRIDGE
  const unsigned int key = irq_lock();
  g_deferred_log.push(line.c_str(), micros());
  irq_unlock(key);
#elif USE_MSGPACK_RPC
  rpc_send_mon_write(line.c_str());
#else
  LOG_SERIAL.println(line);
#endif
}
static String format_fixed(float value, uint8_t decimals) {
  if (isnan(value)) return String("nan");
  if (isinf(value)) return value < 0.0f ? String("-inf") : String("inf");

  bool negative = value < 0.0f;
  float mag = negative ? -value : value;
  uint32_t scale = 1U;
  for (uint8_t i = 0; i < decimals; ++i) {
    scale *= 10U;
  }
  uint32_t scaled = (uint32_t)(mag * (float)scale + 0.5f);
  uint32_t whole = (scale > 0U) ? (scaled / scale) : scaled;
  uint32_t frac = (scale > 0U) ? (scaled % scale) : 0U;

  String out;
  out.reserve(20);
  if (negative && (whole != 0U || frac != 0U)) {
    out += '-';
  }
  out += String((unsigned long)whole);
  if (decimals == 0U) {
    return out;
  }
  out += '.';
  uint32_t div = scale / 10U;
  while (div > 0U) {
    out += (char)('0' + ((frac / div) % 10U));
    div /= 10U;
  }
  return out;
}
static float mic_estimate_p_loss(float id, float iq, float omega_e) {
  float i2 = (id * id) + (iq * iq);
  float p_cu = 1.5f * MIC_RS * i2;
  float psi = MIC_LM * id;
  float p_fe = MIC_K_FE * omega_e * omega_e * psi * psi;
  float p_sw = MIC_K_SW * MIC_F_SW * sqrtf(i2);
  return p_cu + p_fe + p_sw;
}
static bool mic_encoder_feedback_recent(uint32_t now_ms) {
  return g_bp_enc_ok &&
         g_enc_speed_valid &&
         ((uint32_t)(now_ms - g_bp_enc_ms) < MIC_ENC_STALE_MS);
}
static uint16_t mic_link_flags(uint32_t now_ms) {
  uint16_t flags = 0u;
  if (g_nucleo_last_rx_ms == 0) {
    flags |= 0x01u;
  } else {
    uint32_t age = (uint32_t)(now_ms - g_nucleo_last_rx_ms);
    if (age > BP_REPLY_TIMEOUT_MS) {
      flags |= 0x01u;
    }
  }
  if ((g_bp_status & 0x01u) == 0u) {
    flags |= 0x02u;
  }
  if (g_pwm_enabled && ((g_bp_status & 0x20u) == 0u)) {
    flags |= 0x04u;
  }
  if (!mic_encoder_feedback_recent(now_ms)) {
    flags |= 0x08u;
  }
  return flags;
}
static float mic_feedback_elec_hz(uint32_t now_ms, bool *enc_used) {
  bool enc_recent = mic_encoder_feedback_recent(now_ms);
  if (enc_used) {
    *enc_used = enc_recent;
  }
  if (enc_recent) {
    return fabsf(g_enc_elec_hz);
  }
  return 0.0f;
}
static void mic_update_metrics() {
  float omega_e = CTRL_TWO_PI * g_freq_ref;
  float p_loss = mic_estimate_p_loss(g_last_id, g_last_iq, omega_e);
  float p_loss_base = mic_estimate_p_loss(RUN_ID_REF_A, g_last_iq, omega_e);
  float saving = 0.0f;
  if (p_loss_base > 1e-6f) {
    saving = (p_loss_base - p_loss) / p_loss_base * 100.0f;
  }
  if (!g_mic_active) {
    saving = 0.0f;
  }
  g_mic_p_loss = p_loss;
  g_mic_p_loss_base = p_loss_base;
  g_mic_saving_pct = saving;
}
static void mic_diag_reset() {
  g_mic_active = false;
  g_mic_id_ref = RUN_ID_REF_A;
  g_mic_saving_pct = 0.0f;
  g_mic_id_ref_q10 = (int16_t)(RUN_ID_REF_A * 1024.0f);
  g_mic_gated = 0;
  g_mic_enable_ai = 0;
  g_mic_enc_used = false;
  g_mic_freq_meas_hz = 0.0f;
  g_mic_speed_err_hz = 0.0f;
  g_mic_speed_tol_hz = 0.0f;
  g_mic_link_flags = 0u;
  g_mic_status_flags = 0u;
}
static void scope_set(bool enabled) {
  if (USE_EXTERNAL_PWM && enabled) {
    bridge_notify_line(String("LOG SCOPE IGNORED (EXT PWM)"));
    return;
  }
  if (enabled == g_scope_test) return;
  g_scope_test = enabled;
  g_start_req = false;
  g_stop_req = false;
  g_stop_requested = false;
  g_freq_cmd = 0.0f;
  g_freq_ref = 0.0f;
  g_pwm_enabled = false;
  g_io_test_mode = false;
  g_state = STATE_SAFE;
  g_scope_u = false;
  g_scope_v = false;
  g_scope_w = false;
  g_scope_last_u_us = micros();
  g_scope_last_v_us = g_scope_last_u_us;
  g_scope_last_w_us = g_scope_last_u_us;
  pwm_force_off();
  bridge_notify_line(enabled ? String("LOG SCOPE ON") : String("LOG SCOPE OFF"));
}
static void scope_tick() {
  if (USE_EXTERNAL_PWM) {
    return;
  }
  uint32_t now = micros();
  if ((uint32_t)(now - g_scope_last_u_us) >= 500U) { // ~1 kHz
    g_scope_last_u_us = now;
    g_scope_u = !g_scope_u;
    analogWrite(PWM_UH_PIN, pwm_level(g_scope_u, false));
    analogWrite(PWM_UL_PIN, PWM_THREE_PWM_MODE ? (PWM_LOW_INVERTED ? PWM_FULL : 0)
                                               : pwm_level(!g_scope_u, PWM_LOW_INVERTED));
  }
  if ((uint32_t)(now - g_scope_last_v_us) >= 800U) { // ~625 Hz
    g_scope_last_v_us = now;
    g_scope_v = !g_scope_v;
    analogWrite(PWM_VH_PIN, pwm_level(g_scope_v, false));
    analogWrite(PWM_VL_PIN, PWM_THREE_PWM_MODE ? (PWM_LOW_INVERTED ? PWM_FULL : 0)
                                               : pwm_level(!g_scope_v, PWM_LOW_INVERTED));
  }
  if ((uint32_t)(now - g_scope_last_w_us) >= 1200U) { // ~416 Hz
    g_scope_last_w_us = now;
    g_scope_w = !g_scope_w;
    analogWrite(PWM_WH_PIN, pwm_level(g_scope_w, false));
    analogWrite(PWM_WL_PIN, PWM_THREE_PWM_MODE ? (PWM_LOW_INVERTED ? PWM_FULL : 0)
                                               : pwm_level(!g_scope_w, PWM_LOW_INVERTED));
  }
}
static void pwm_test_set(bool enabled) {
  if (enabled == g_pwm_test) return;
  if (USE_EXTERNAL_PWM && enabled) {
    bridge_notify_line(String("LOG PWMTEST IGNORED (EXT PWM)"));
    return;
  }
  g_pwm_test = enabled;
  g_scope_test = false;
  g_start_req = false;
  g_stop_req = false;
  g_stop_requested = false;
  g_freq_cmd = 0.0f;
  g_freq_ref = 0.0f;
  g_state = STATE_SAFE;
  g_io_test_mode = false;
  g_pwm_enabled = enabled;
  bridge_notify_line(enabled ? String("LOG PWMTEST ON") : String("LOG PWMTEST OFF"));
  if (!enabled) {
    pwm_force_off();
  }
}
static bool handle_command_line_stream(const char *cmd, Stream &out) {
  while (*cmd == ' ' || *cmd == '	') cmd++;
  if (*cmd == '\0') {
    return false;
  }
  String line;
  line.reserve(96);
  line += "LOG CMD ";
  line += cmd;
  bridge_notify_line(line);
  bool handled = true;
  if (icmp(cmd, "START")) {
    const char *start_err = start_precheck(millis());
    if (start_err != nullptr) {
      out.print("ERR ");
      out.println(start_err);
      return false;
    }
    if (g_mode == MODE_MIC && g_freq_cmd < 0.1f) {
      g_freq_cmd = (g_last_nonzero_freq > 0.1f) ? g_last_nonzero_freq : 10.0f;
    }
    g_start_req = true;
  } else if (icmp(cmd, "STOP")) {
    request_normal_stop();
  } else if (icmp(cmd, "CLEAR") || icmp(cmd, "RESET")) {
    clear_estop_latch();
  } else if (starts_ci(cmd, "MODE")) {
    const char *p = cmd + 4;
    while (*p == ' ' || *p == '	') p++;
    if (icmp(p, "VF")) {
      request_mode(MODE_VF, false, false);
    } else if (icmp(p, "FOC")) {
      request_mode(MODE_FOC, false, false);
    } else if (icmp(p, "MIC")) {
      request_mode(MODE_MIC, false, false);
    } else if (icmp(p, "DUTY")) {
      request_mode(MODE_VF, true, false);
    } else {
      handled = false;
    }
  } else if (starts_ci(cmd, "DIAG")) {
    const char *p = cmd + 4;
    while (*p == ' ' || *p == '\t') p++;
    if (icmp(p, "ON") || icmp(p, "1")) {
      request_mode(MODE_VF, false, true);
    } else if (icmp(p, "OFF") || icmp(p, "0")) {
      g_diag_pwm = false;
    } else {
      handled = false;
    }
  } else if (starts_ci(cmd, "DUTY")) {
    const char *p = cmd + 4;
    float du = g_duty_u;
    float dv = g_duty_v;
    float dw = g_duty_w;
    if (parse_duty_triple(p, &du, &dv, &dw) > 0) {
      g_duty_u = clampf(du, 0.0f, 1.0f);
      g_duty_v = clampf(dv, 0.0f, 1.0f);
      g_duty_w = clampf(dw, 0.0f, 1.0f);
      g_duty_mode = true;
      g_diag_pwm = false;
    } else {
      handled = false;
    }
  } else if (starts_ci(cmd, "SET FREQ")) {
    const char *p = cmd + 8;
    float f = 0.0f;
    if (parse_single_float_arg(p, &f)) {
      f = clampf(f, 0.0f, AIR56B2_MAX_ELECTRICAL_FREQ_HZ);
      g_freq_cmd = f;
      if (f > 0.1f) g_last_nonzero_freq = f;
    } else {
      handled = false;
    }
  } else if (starts_ci(cmd, "SET VFBOOST")) {
    const char *p = cmd + 11;
    float v = 0.0f;
    if (parse_single_float_arg(p, &v)) {
      g_vf_start_boost_v = clampf(v, 0.0f, 120.0f);
    } else {
      handled = false;
    }
  } else if (starts_ci(cmd, "SET VFRATIO")) {
    const char *p = cmd + 11;
    float r = 0.0f;
    if (parse_single_float_arg(p, &r)) {
      g_vf_volt_per_hz_ratio = clampf(r, 0.0f, 1.0f);
    } else {
      handled = false;
    }
  } else if (starts_ci(cmd, "SET RUNLIMIT")) {
    const char *p = cmd + 12;
    float seconds = 0.0f;
    if (parse_single_float_arg(p, &seconds)) {
      set_run_limit(seconds);
    } else {
      handled = false;
    }
  } else if (icmp(cmd, "DISPLAY TEST")) {
    matrix_start_test(15000U);
  } else if (starts_ci(cmd, "ESTOP")) {
    const char *p = cmd + 5;
    handle_estop_command(p);
  } else if (starts_ci(cmd, "PFC")) {
    const char *p = cmd + 3;
    while (*p == ' ' || *p == '	') p++;
    if (icmp(p, "ON") || icmp(p, "1")) {
      ext_flag_set(BP_EXT_PFC, true);
    } else if (icmp(p, "OFF") || icmp(p, "0")) {
      ext_flag_set(BP_EXT_PFC, false);
    } else {
      handled = false;
    }
  } else if (starts_ci(cmd, "PRECHARGE") || starts_ci(cmd, "RELAY")) {
    const char *p = starts_ci(cmd, "PRECHARGE") ? (cmd + 9) : (cmd + 5);
    while (*p == ' ' || *p == '	') p++;
    if (icmp(p, "ON") || icmp(p, "1")) {
      if (BP_PRECHARGE_RELAY_PRESENT) {
        ext_flag_set(BP_EXT_PRECHARGE_RELAY, true);
      } else {
        handled = false;
      }
    } else if (icmp(p, "OFF") || icmp(p, "0")) {
      ext_flag_set(BP_EXT_PRECHARGE_RELAY, false);
    } else {
      handled = false;
    }
  } else if (starts_ci(cmd, "FAN")) {
    handled = handle_fan_command(cmd + 3);
  } else if (starts_ci(cmd, "MCFOC")) {
    handled = handle_mcfoc_command(cmd + 5);
  } else if (starts_ci(cmd, "BPFOC")) {
    handled = handle_mcfoc_command(cmd + 5);  // Legacy alias.
  } else if (starts_ci(cmd, "SCOPE")) {
    const char *p = cmd + 5;
    while (*p == ' ' || *p == '	') p++;
    if (icmp(p, "ON") || icmp(p, "1")) {
      scope_set(true);
    } else if (icmp(p, "OFF") || icmp(p, "0")) {
      scope_set(false);
    } else {
      handled = false;
    }
    } else if (starts_ci(cmd, "PWMTEST")) {
      const char *p = cmd + 7;
      while (*p == ' ' || *p == '	') p++;
      if (icmp(p, "ON") || icmp(p, "1")) {
        pwm_test_set(true);
      } else if (icmp(p, "OFF") || icmp(p, "0")) {
        pwm_test_set(false);
      } else {
        handled = false;
      }
    } else if (starts_ci(cmd, "IOTEST")) {
      const char *p = cmd + 6;
      while (*p == ' ' || *p == '	') p++;
      if (icmp(p, "ON") || icmp(p, "1")) {
        io_test_set(true);
      } else if (icmp(p, "OFF") || icmp(p, "0")) {
        io_test_set(false);
      } else {
        handled = false;
      }
    } else if (starts_ci(cmd, "BRAKE")) {
      const char *p = cmd + 5;
      while (*p == ' ' || *p == '	') p++;
      if (starts_ci(p, "PWM")) {
        p += 3;
        float duty = 0.0f;
        if (parse_single_float_arg(p, &duty)) {
          ext_brake_set(clampf(duty, 0.0f, 1.0f));
        } else {
          handled = false;
        }
      } else if (icmp(p, "OFF") || icmp(p, "0")) {
        brake_set(false);
        ext_brake_set(0.0f);
      } else if (icmp(p, "ON") || icmp(p, "1")) {
        brake_set(true);
        ext_brake_set(0.0f);
      } else {
        handled = false;
      }
    } else if (icmp(cmd, "GET") || icmp(cmd, "STATUS")) {
      out.println(rpc_get());
      return true;
    } else {
      handled = false;
    }
    if (!handled) {
      out.println("ERR unknown cmd");
      return false;
    }
    out.println("OK");
    return true;
}
static bool rpc_cmd(String cmd) {
  return handle_command_line_stream(cmd.c_str(), g_null_stream);
}

static String rpc_get() {
  const uint32_t timing_started = micros();
  const unsigned int timing_key = irq_lock();
  const LinkTiming timing = g_link_timing;
  const uint32_t log_dropped = g_deferred_log.dropped;
  const uint32_t log_pending = g_deferred_log.count;
  irq_unlock(timing_key);
  float ia = g_last_ia;
  float ib = g_last_ib;
  float ic = g_last_ic;
  float speed_rpm = (g_freq_ref * 60.0f) / POLE_PAIRS;
  String s;
  s.reserve(160);
  s += "DATA freq="; s += format_fixed(g_freq_ref, 2);
  s += " speed="; s += format_fixed(speed_rpm, 1);
  s += " ia="; s += format_fixed(ia, 2);
  s += " ib="; s += format_fixed(ib, 2);
  s += " ic="; s += format_fixed(ic, 2);
  s += " vdc="; s += format_fixed(g_vdc, 2);
  s += " state="; s += String(state_name(g_state));
  s += " mode="; s += String(mode_name(g_mode));
  s += " pwm="; s += String(g_pwm_enabled ? 1 : 0);
  s += " id="; s += format_fixed(g_last_id, 2);
  s += " iq="; s += format_fixed(g_last_iq, 2);
  s += " irm="; s += format_fixed(g_last_i_rms, 2);
  s += " mic="; s += String(g_mic_active ? 1 : 0);
  s += " idref="; s += format_fixed(g_mic_id_ref, 2);
  s += " save="; s += format_fixed(g_mic_saving_pct, 2);
  s += " freqcmd="; s += format_fixed(g_freq_cmd, 2);
  s += " estop="; s += String(g_estop_latched ? 1 : 0);
  s += " iotest="; s += String(g_io_test_mode ? 1 : 0);
  s += " ntc=0";
  s += " pfc="; s += String((g_ext_flags & BP_EXT_PFC) ? 1 : 0);
  s += " precharge="; s += String((g_ext_flags & BP_EXT_PRECHARGE_RELAY) ? 1 : 0);
  float brake = (g_ext_flags & BP_EXT_BRAKE_PWM) ? ((float)g_brake_q15 / 32767.0f) : 0.0f;
  s += " brake="; s += String((g_ext_flags & BP_EXT_BRAKE_PWM) ? 1 : 0);
  s += " brake_duty="; s += format_fixed(brake, 2);
  s += " fan_duty="; s += format_fixed((float)g_fan_q15 / 32767.0f, 2);
  s += " bp_fan_duty="; s += format_fixed(g_bp_fan_duty, 2);
  s += " bp_fan_rpm="; s += format_fixed(g_bp_fan_rpm, 0);
  s += " diag="; s += String(g_diag_pwm ? 1 : 0);
  s += " duty="; s += String(g_duty_mode ? 1 : 0);
  bool enc_recent = (uint32_t)(millis() - g_bp_enc_ms) < 500U;
  float enc_deg = ((float)g_bp_enc_raw * 360.0f) / 4096.0f;
  s += " enc_raw="; s += String((int)g_bp_enc_raw);
  s += " enc_ok="; s += String((g_bp_enc_ok && enc_recent) ? 1 : 0);
  s += " enc_deg="; s += format_fixed(enc_deg, 1);
  s += " enc_rpm="; s += format_fixed((g_bp_enc_ok && enc_recent) ? g_enc_rpm : 0.0f, 1);
  s += " enc_mech_hz="; s += format_fixed((g_bp_enc_ok && enc_recent) ? g_enc_mech_hz : 0.0f, 2);
  s += " enc_elec_hz="; s += format_fixed((g_bp_enc_ok && enc_recent) ? g_enc_elec_hz : 0.0f, 2);
  if (NUCLEO_MCSDK_ACIM_BACKEND) {
    s += " enc_source=uno_q_i2c2";
    s += " enc_bus_ok="; s += String(g_as5600.bus_ok ? 1 : 0);
    s += " enc_status="; s += String((int)g_as5600.status);
    s += " enc_speed_ok="; s += String(g_as5600.speed_ok ? 1 : 0);
    s += " enc_reads="; s += String((unsigned long)g_as5600.reads);
    s += " enc_errors="; s += String((unsigned long)g_as5600.errors);
    s += " enc_io_error="; s += String((long)g_as5600.io_error);
    s += " enc_init_error="; s += String((long)g_as5600.init_error);
    s += " enc_scl="; s += String((long)g_as5600.scl_level);
    s += " enc_sda="; s += String((long)g_as5600.sda_level);
    s += " enc_age_ms="; s += String((unsigned long)(millis() - g_as5600.timestamp_ms));
  }
  s += " mic_gated="; s += String((int)g_mic_gated);
  s += " mic_enable_ai="; s += String((int)g_mic_enable_ai);
  s += " mic_enc_used="; s += String(g_mic_enc_used ? 1 : 0);
  s += " mic_fmeas="; s += format_fixed(g_mic_freq_meas_hz, 2);
  s += " mic_ferr="; s += format_fixed(g_mic_speed_err_hz, 2);
  s += " mic_ftol="; s += format_fixed(g_mic_speed_tol_hz, 2);
  s += " mic_lflags="; s += String((int)g_mic_link_flags);
  s += " mic_sflags="; s += String((int)g_mic_status_flags);
  uint32_t bp_age = (g_nucleo_last_rx_ms == 0) ? 999999U : (uint32_t)(millis() - g_nucleo_last_rx_ms);
  s += " bp_good="; s += String((int)g_nucleo_rx_good);
  s += " bp_bad="; s += String((int)g_nucleo_rx_bad);
  s += " bp_superseded="; s += String((int)g_nucleo_rx_superseded);
  s += " bp_bad_integrity="; s += String((int)g_nucleo_rx_bad_integrity);
  s += " bp_bad_sequence="; s += String((int)g_nucleo_rx_bad_sequence);
  s += " bp_clear_pending="; s += String(g_clear_fault_req ? 1 : 0);
  s += " bp_age_ms="; s += String((int)bp_age);
  // Low-level motor-controller link observability.
  s += " bp_status="; s += String((int)g_bp_status);
  s += " bp_fault="; s += String((int)g_bp_fault_code);
  s += " mc_diag_valid="; s += String(g_mc_diagnostics.valid ? 1 : 0);
  s += " mc_fault_reason="; s += String((int)g_mc_diagnostics.reason);
  s += " mc_uart_error_flags="; s += String((int)g_mc_diagnostics.uart_errors);
  s += " mc_fault_motor_state="; s += String((int)g_mc_diagnostics.motor_state);
  s += " mc_fault_current_mask="; s += String((int)g_mc_diagnostics.current_faults);
  s += " mc_fault_occurred_mask="; s += String((int)g_mc_diagnostics.occurred_faults);
  s += " mc_fault_sequence="; s += String((int)g_mc_diagnostics.sequence);
  s += " mc_fault_tx_status="; s += String((int)g_mc_diagnostics.tx_status);
  s += " mc_last_bad_valid="; s += String(g_mc_diagnostics.last_bad_valid ? 1 : 0);
  s += " mc_last_bad_reason="; s += String((int)g_mc_diagnostics.last_bad_reason);
  s += " mc_last_uart_error_flags="; s += String((int)g_mc_diagnostics.last_uart_errors);
  s += " mc_last_tx_status="; s += String((int)g_mc_diagnostics.last_tx_status);
  s += " bp_mode="; s += String((int)g_bp_last_mode);
  s += " bp_cmd_mode="; s += String((int)g_bp_cmd_mode);
  s += " bp_foc_backend="; s += String(g_bp_foc_backend ? 1 : 0);
  s += " bp_seq="; s += String((int)g_bp_last_seq);
  s += " bp_good_cnt="; s += String((int)g_bp_good_cnt);
  s += " bp_bad_cnt="; s += String((int)g_bp_bad_cnt);
  s += " bp_ext="; s += String((int)g_bp_ext_flags);
  float bp_brake = (float)g_bp_brake_q15 / 32767.0f;
  s += " bp_brake_duty="; s += format_fixed(bp_brake, 2);
  s += " bp_vbus_raw="; s += String((int)g_bp_vbus_raw);
  s += " bp_vdc="; s += format_fixed(g_bp_vdc, 2);
  uint32_t bp_vbus_age = (g_bp_vbus_ms == 0) ? 999999U : (uint32_t)(millis() - g_bp_vbus_ms);
  s += " bp_vbus_age_ms="; s += String((int)bp_vbus_age);
  s += " bp_temp_raw="; s += String((int)g_bp_temp_raw);
  s += " bp_temp_v="; s += format_fixed(g_bp_temp_v, 3);
  s += " bp_temp_c="; s += format_fixed(g_bp_temp_c, 1);
  s += " bp_temp_flags="; s += String((int)g_bp_temp_flags);
  s += " bp_temp_valid="; s += String((g_bp_temp_flags & BP_TEMP_FLAG_VALID) ? 1 : 0);
  s += " bp_temp_fault="; s += String((g_bp_temp_flags & BP_TEMP_FLAG_FAULT) ? 1 : 0);
  uint32_t bp_temp_age = (g_bp_temp_ms == 0) ? 999999U : (uint32_t)(millis() - g_bp_temp_ms);
  s += " bp_temp_age_ms="; s += String((int)bp_temp_age);
  s += " bp_phase_a_raw="; s += String((int)g_bp_phase_a_raw);
  s += " bp_phase_b_raw="; s += String((int)g_bp_phase_b_raw);
  s += " bp_phase_c_raw="; s += String((int)g_bp_phase_c_raw);
  s += " bp_phase_a_v="; s += format_fixed(g_bp_phase_a_v, 3);
  s += " bp_phase_b_v="; s += format_fixed(g_bp_phase_b_v, 3);
  s += " bp_phase_c_v="; s += format_fixed(g_bp_phase_c_v, 3);
  s += " bp_phase_flags="; s += String((int)g_bp_phase_flags);
  s += " bp_mcsdk_telemetry="; s += String(g_bp_mcsdk_telemetry ? 1 : 0);
  s += " bp_vbus_valid="; s += String(g_bp_vbus_valid ? 1 : 0);
  s += " bp_softstart_ready="; s += String(g_bp_softstart_ready ? 1 : 0);
  s += " bp_fw_build="; s += String((unsigned long)g_bp_fw_build);
  s += " bp_precharge_managed=0";
  s += " bp_phase_valid="; s += String((g_bp_phase_flags & BP_PHASE_FLAG_VALID) ? 1 : 0);
  s += " bp_phase_c_virtual="; s += String((g_bp_phase_flags & BP_PHASE_FLAG_C_VIRTUAL) ? 1 : 0);
  uint32_t bp_phase_age = (g_bp_phase_ms == 0) ? 999999U : (uint32_t)(millis() - g_bp_phase_ms);
  s += " bp_phase_age_ms="; s += String((int)bp_phase_age);
  uint32_t bp_rsp_age = (g_bp_last_rsp_ms == 0) ? 999999U : (uint32_t)(millis() - g_bp_last_rsp_ms);
  s += " bp_rsp_age_ms="; s += String((int)bp_rsp_age);
  uint32_t ping_age = (g_bp_ping_ms == 0) ? 999999U : (uint32_t)(millis() - g_bp_ping_ms);
  s += " bp_ping_pairs="; s += String((unsigned long)g_bp_ping_pairs);
  s += " bp_ping_age_ms="; s += String((int)ping_age);
  s += " fw_build="; s += String((unsigned long)FW_BUILD_ID);
  s += " rpc_schema="; s += String((int)RPC_SCHEMA_VERSION);
  s += " mc_caps="; s += String((int)MC_CAP_VF);
  s += " matrix_test=";
  s += String(matrix_test_active() ? 1 : 0);
  s += " uno_loop_active_max_us="; s += String((unsigned long)timing.loop_active_max_us);
  s += " uno_tx_active_max_gap_us="; s += String((unsigned long)timing.tx_active_max_gap_us);
  s += " uno_rx_active_max_gap_us="; s += String((unsigned long)timing.rx_active_max_gap_us);
  s += " uno_tx_call_max_us="; s += String((unsigned long)timing.tx_call_max_us);
  s += " uno_rpc_max_us="; s += String((unsigned long)timing.rpc_max_us);
  s += " uno_tx_short_writes="; s += String((unsigned long)timing.tx_short_writes);
  s += " uno_tx_count="; s += String((unsigned long)timing.tx_count);
  s += " uno_rx_count="; s += String((unsigned long)timing.rx_count);
  s += " uno_log_dropped="; s += String((unsigned long)log_dropped);
  s += " uno_log_pending="; s += String((unsigned long)log_pending);
  const unsigned int timing_done_key = irq_lock();
  g_link_timing.rpc(micros() - timing_started);
  irq_unlock(timing_done_key);
  return s;
}

static void serial_poll() {
#if !USE_MSGPACK_RPC
  while (LOG_SERIAL.available() > 0) {
    char c = (char)LOG_SERIAL.read();
    if (c == '\n' || c == '\r') {
      if (g_line_len > 0) {
        g_line_buf[g_line_len] = '\0';
        handle_command_line_stream(g_line_buf, LOG_SERIAL);
        g_line_len = 0;
      }
    } else {
      if (g_line_len < (sizeof(g_line_buf) - 1)) {
        g_line_buf[g_line_len++] = c;
      }
    }
  }
#endif
#if !USE_ROUTER_BRIDGE
  while (UI_SERIAL.available() > 0) {
    char c = (char)UI_SERIAL.read();
    if (c == '\n' || c == '\r') {
      if (g_line_len_ui > 0) {
        g_line_buf_ui[g_line_len_ui] = '\0';
        handle_command_line_stream(g_line_buf_ui, UI_SERIAL);
        g_line_len_ui = 0;
      }
    } else {
      if (g_line_len_ui < (sizeof(g_line_buf_ui) - 1)) {
        g_line_buf_ui[g_line_len_ui++] = c;
      }
    }
  }
#endif
}
#if USE_ROUTER_BRIDGE
static void bridge_tick() {
  if (g_pwm_enabled || g_pwm_outputs_active || (g_bp_status & BP_STATUS_PWM_ACTIVE) != 0U) return;
  uint32_t now = millis();
  if ((uint32_t)(now - g_bridge_last_ms) < 1000U) {
    return;
  }
  g_bridge_last_ms = now;
  if (!Bridge) {
    g_bridge_ready = Bridge.begin(RPC_BAUD);
    g_bridge_cmd_ready = false;
    g_bridge_get_ready = false;
    g_monitor_ready = false;
    g_bridge_announced = false;
    return;
  }
  g_bridge_ready = true;
  if (!g_monitor_ready) {
    g_monitor_ready = Monitor.begin(RPC_BAUD);
  }
  if (!g_bridge_cmd_ready) {
    g_bridge_cmd_ready = Bridge.provide("cmd", rpc_cmd);
  }
  if (!g_bridge_get_ready) {
    g_bridge_get_ready = Bridge.provide("get", rpc_get);
  }
  if (!g_bridge_announced && g_bridge_cmd_ready && g_bridge_get_ready && g_monitor_ready) {
    g_bridge_announced = true;
    Monitor.println("LOG BRIDGE READY");
  }
}
K_THREAD_STACK_DEFINE(bridge_service_stack, 4096);
static k_thread bridge_service_thread;
static void bridge_service_worker(void *, void *, void *) {
  for (;;) {
    bridge_tick();
    if (Monitor) {
      DeferredLogLine line;
      const unsigned int key = irq_lock();
      const bool available = g_deferred_log.pop(line);
      irq_unlock(key);
      if (available) {
        // Deferred events are logs, never replayed as current STAT telemetry.
        String record("LOG DEFERRED t_us=");
        record += String((unsigned long)line.timestamp_us);
        record += " ";
        record += line.text;
        Monitor.println(record);
      }
    }
    k_msleep(5);
  }
}
static void bridge_service_begin() {
  k_thread_create(&bridge_service_thread, bridge_service_stack,
                  K_THREAD_STACK_SIZEOF(bridge_service_stack), bridge_service_worker,
                  nullptr, nullptr, nullptr, CONFIG_NUM_PREEMPT_PRIORITIES - 1, 0, K_NO_WAIT);
}
#endif
static void send_telemetry() {
  uint32_t now = millis();
  if ((uint32_t)(now - g_last_telem_ms) < TELEMETRY_MS) {
    return;
  }
  g_last_telem_ms = now;
  mic_update_metrics();

  if (g_state != g_last_state) {
    String line;
    line.reserve(32);
    line += "STAT ";
    line += state_name(g_state);
    bridge_notify_line(line);
    g_last_state = g_state;
  }

  if (g_fault != g_last_fault) {
    if (g_fault != 0) {
      String line;
      line.reserve(24);
      line += "FAULT ";
      line += g_fault;
      bridge_notify_line(line);
    }
    g_last_fault = g_fault;
  }

  if (g_pwm_enabled != g_last_pwm) {
    String line;
    line.reserve(24);
    line += "LOG PWM ";
    line += (g_pwm_enabled ? "ON" : "OFF");
    bridge_notify_line(line);
    g_last_pwm = g_pwm_enabled;
  }

  if (g_mic_active != g_last_mic_active) {
    String line;
    line.reserve(20);
    line += "LOG MIC ";
    line += (g_mic_active ? "ON" : "OFF");
    bridge_notify_line(line);
    g_last_mic_active = g_mic_active;
  }

#if LOG_TELEMETRY_DATA
  float speed_rpm = (g_freq_ref * 60.0f) / POLE_PAIRS;
  String line;
  line.reserve(192);
  line += "DATA freq=";
  line += format_fixed(g_freq_ref, 2);
  line += " speed=";
  line += format_fixed(speed_rpm, 1);
  line += " ia=";
  line += format_fixed(g_last_ia, 2);
  line += " ib=";
  line += format_fixed(g_last_ib, 2);
  line += " ic=";
  line += format_fixed(g_last_ic, 2);
  line += " vdc=";
  line += format_fixed(g_vdc, 2);
  line += " id=";
  line += format_fixed(g_last_id, 2);
  line += " iq=";
  line += format_fixed(g_last_iq, 2);
  line += " vd=";
  line += format_fixed(g_last_vd, 2);
  line += " vq=";
  line += format_fixed(g_last_vq, 2);
  line += " pwm=";
  line += (g_pwm_enabled ? 1 : 0);
  bridge_notify_line(line);
#endif
}
static void rpc_service() {
  uint32_t now = millis();
  if ((uint32_t)(now - g_last_reg_ms) >= 1000U) {
    g_last_reg_ms = now;
    rpc_send_register("cmd");
    rpc_send_register("get");
  }
}
static float clampf(float v, float lo, float hi) {
  if (isnan(v) || isinf(v)) return lo;
  if (v < lo) return lo;
  if (v > hi) return hi;
  return v;
}
static float sanitize_small_float(float v, float eps = 1e-6f) {
  if (!isfinite(v) || fabsf(v) < eps) {
    return 0.0f;
  }
  return v;
}
static float ramp_toward(float v, float target, float step) {
  if (v < target) {
    v += step;
    if (v > target) v = target;
  } else if (v > target) {
    v -= step;
    if (v < target) v = target;
  }
  return v;
}
static void pi_init(PIController *pi, float kp, float ki, float out_min, float out_max) {
  pi->kp = kp;
  pi->ki = ki;
  pi->integrator = 0.0f;
  pi->out_min = out_min;
  pi->out_max = out_max;
}
static float pi_run(PIController *pi, float error, float ts) {
  pi->integrator += pi->ki * error * ts;
  pi->integrator = clampf(pi->integrator, pi->out_min, pi->out_max);
  float out = pi->kp * error + pi->integrator;
  return clampf(out, pi->out_min, pi->out_max);
}
static uint8_t duty_u8(float duty) {
  return (uint8_t)(clampf(duty, 0.0f, 1.0f) * PWM_MAX);
}
static uint16_t q15_unit(float duty) {
  duty = clampf(duty, 0.0f, 1.0f);
  return (uint16_t)(duty * 32767.0f);
}
static int16_t q15_signed(float value) {
  value = clampf(value, -1.0f, 1.0f);
  return (int16_t)(value * 32767.0f);
}
static int16_t bp_foc_current_q15(float current_a) {
  float scale = BP_FOC_CURRENT_A_PER_PU;
  if (scale < 0.001f) {
    scale = 1.0f;
  }
  return q15_signed(current_a / scale);
}
static uint32_t bp_freq_millihz(float freq_hz) {
  freq_hz = clampf(freq_hz, 0.0f, AIR56B2_MAX_ELECTRICAL_FREQ_HZ);
  int32_t value = (int32_t)(freq_hz * 1000.0f);
  return (uint32_t)value;
}
static uint16_t bp_scalar_vmag_q15() {
  float freq_abs = fabsf(g_freq_ref);
  float boost_v = 0.0f;
  if (freq_abs >= VF_START_BOOST_MIN_FREQ_HZ) {
    float boost_taper = 1.0f - clampf(freq_abs / VF_START_BOOST_TAPER_HZ, 0.0f, 1.0f);
    boost_v = g_vf_start_boost_v * boost_taper;
  }
  float v_mag = (g_vf_v_per_hz * g_freq_ref) + boost_v;
  v_mag = clampf(v_mag, 0.0f, g_v_limit);
  // MODE_SCALAR uses alpha/beta magnitude in per-unit and then
  // maps it to duty with 0.5 + 0.5*v. Match the UNO Q voltage-domain SVM.
  float mag_pu = (g_vdc > 0.1f) ? ((2.0f * v_mag) / g_vdc) : 0.0f;
  return q15_unit(clampf(mag_pu, 0.0f, 0.95f));
}
static void ext_flag_set(uint8_t flag, bool on) {
  if (flag == BP_EXT_PRECHARGE_RELAY && !BP_PRECHARGE_RELAY_PRESENT) {
    g_ext_flags &= (uint8_t)(~BP_EXT_PRECHARGE_RELAY);
    return;
  }
  if (on) {
    g_ext_flags |= flag;
  } else {
    g_ext_flags &= (uint8_t)(~flag);
  }
  if (USE_EXTERNAL_PWM && !g_pwm_enabled) {
    // Service outputs must reach the motor controller immediately in normal Wi-Fi mode;
    // waiting for the SAFE heartbeat made relay operation nondeterministic.
    nucleo_send_stop(true);
  }
}
static void ext_brake_set(float duty) {
  if (duty <= 0.0001f) {
    g_brake_q15 = 0;
    g_ext_flags &= (uint8_t)(~BP_EXT_BRAKE_PWM);
    return;
  }
  g_brake_q15 = q15_unit(duty);
  g_ext_flags |= BP_EXT_BRAKE_PWM;
}
static void fan_set(float duty) {
  g_fan_q15 = q15_unit(duty);
  if (USE_EXTERNAL_PWM && !g_pwm_enabled) {
    nucleo_send_stop(true);
  }
}
static void io_test_set(bool on) {
  g_io_test_mode = on;
  g_pwm_enabled = false;
  g_state = STATE_SAFE;
  g_stop_requested = false;
  g_start_req = false;
  g_stop_req = false;
  g_run_limit_ms = 0;
  g_run_deadline_ms = 0;
  g_mode_switch_pending = false;
  g_restart_after_mode_switch = false;
  g_diag_pwm = false;
  g_duty_mode = false;
  if (!on) {
    g_ext_flags &= (uint8_t)(~(BP_EXT_RESERVED_0 | BP_EXT_PFC | BP_EXT_BRAKE_PWM | BP_EXT_PRECHARGE_RELAY));
    g_brake_q15 = 0;
    nucleo_send_stop(true);
    return;
  }
  // Service I/O test: allow the motor controller to apply ext_flags while keeping PWM off.
  nucleo_send_pwm(0.0f, 0.0f, 0.0f, true, true);
}
static uint8_t nucleo_crc8(const uint8_t *buf, size_t len) {
  uint8_t c = 0;
  for (size_t i = 0; i < len; i++) {
    c ^= buf[i];
  }
  return c;
}
static float bp_temp_voltage_from_raw(uint16_t raw) {
  return ((float)raw * BP_TEMP_VREF) / 4095.0f;
}
static float bp_vdc_from_raw(uint16_t raw) {
  if (raw <= BP_VBUS_ZERO_RAW) {
    return 0.0f;
  }
  const float denom = (float)BP_VBUS_CAL_RAW - (float)BP_VBUS_ZERO_RAW;
  if (denom <= 1.0f) {
    return 0.0f;
  }
  return ((float)raw - (float)BP_VBUS_ZERO_RAW) * (BP_VBUS_CAL_V / denom);
}
static float bp_phase_voltage_from_raw(uint16_t raw) {
  return ((float)raw * BP_PHASE_VREF) / 4095.0f;
}
static bool bp_temp_c_from_raw(uint16_t raw, float *temp_c) {
  if (!temp_c || raw == 0U || raw >= 4095U) {
    return false;
  }
  const float v = bp_temp_voltage_from_raw(raw);
  if (v <= 0.001f || v >= (BP_TEMP_VREF - 0.001f)) {
    return false;
  }
  if (BP_TEMP_SENSOR_MODE == BP_TEMP_SENSOR_TSO) {
    *temp_c = 25.0f + ((v - BP_TEMP_TSO_V25) * 1000.0f) / BP_TEMP_TSO_MV_PER_C;
    return isfinite(*temp_c);
  }
  const float r_ntc = BP_TEMP_PULLUP_OHM * v / (BP_TEMP_VREF - v);
  if (!isfinite(r_ntc) || r_ntc <= 0.0f) {
    return false;
  }
  const float inv_t = (1.0f / 298.15f) + (logf(r_ntc / BP_TEMP_NTC_R25_OHM) / BP_TEMP_NTC_BETA_K);
  if (!isfinite(inv_t) || inv_t <= 0.0f) {
    return false;
  }
  *temp_c = (1.0f / inv_t) - 273.15f;
  return true;
}
static void enc_speed_update(uint16_t raw, bool ok, uint32_t now_ms) {
  if (!ok) {
    g_enc_speed_valid = false;
    g_enc_accum_counts = 0;
    g_enc_accum_ms = 0;
    g_enc_rpm = 0.0f;
    g_enc_mech_hz = 0.0f;
    g_enc_elec_hz = 0.0f;
    return;
  }
  if (!g_enc_speed_valid) {
    g_enc_speed_valid = true;
    g_enc_prev_raw = raw;
    g_enc_prev_ms = now_ms;
    g_enc_accum_counts = 0;
    g_enc_accum_ms = 0;
    return;
  }
  uint32_t dt_ms = now_ms - g_enc_prev_ms;
  if (dt_ms == 0 || dt_ms > 250U) {
    // Large gaps or duplicate timestamps: re-sync without producing a spike.
    g_enc_prev_raw = raw;
    g_enc_prev_ms = now_ms;
    g_enc_accum_counts = 0;
    g_enc_accum_ms = 0;
    return;
  }
  int32_t dr = (int32_t)raw - (int32_t)g_enc_prev_raw;
  // 12-bit wrap handling: choose the shortest path.
  if (dr > 2048) dr -= 4096;
  if (dr < -2048) dr += 4096;
  g_enc_prev_raw = raw;
  g_enc_prev_ms = now_ms;
  g_enc_accum_counts += dr;
  g_enc_accum_ms += dt_ms;

  // Accumulate over >=20ms to reduce quantization noise on small dt.
  if (g_enc_accum_ms < 20U) {
    return;
  }
  float dt_s = (float)g_enc_accum_ms * 0.001f;
  float rev = (float)g_enc_accum_counts / 4096.0f;
  float rpm_inst = (dt_s > 1e-6f) ? (rev / dt_s) * 60.0f : 0.0f;
  // 1st order low-pass: alpha tuned for 20..50ms updates.
  const float alpha = 0.25f;
  g_enc_rpm = g_enc_rpm + alpha * (rpm_inst - g_enc_rpm);
  g_enc_mech_hz = g_enc_rpm / 60.0f;
  g_enc_elec_hz = (g_enc_rpm * POLE_PAIRS) / 60.0f;
  g_enc_rpm = sanitize_small_float(g_enc_rpm);
  g_enc_mech_hz = sanitize_small_float(g_enc_mech_hz);
  g_enc_elec_hz = sanitize_small_float(g_enc_elec_hz);
  g_enc_accum_counts = 0;
  g_enc_accum_ms = 0;
}
static bool nucleo_check_reply(const uint8_t *rx, bool require_sequence, uint8_t expected_sequence) {
  if (!rx) return false;
  if (rx[0] != 0x55 || rx[1] != 0xAA) return false;
  if (rx[2] != BP_VER) return false;
  uint8_t crc = nucleo_crc8(rx, BP_CRC_OFF);
  if (crc != rx[BP_CRC_OFF]) return false;
  if (require_sequence && rx[4] != expected_sequence) return false;
  const bool clear_ack = unoq_clear_reply_ack(
      require_sequence && g_nucleo_waiting_rsp && rx[4] == g_nucleo_waiting_seq,
      g_nucleo_waiting_clear, rx[10], rx[3]);
  uint32_t now_ms = millis();
  g_bp_status = rx[3];
  g_bp_last_seq = rx[4];
  g_bp_good_cnt = (uint16_t)rx[5] | ((uint16_t)rx[6] << 8);
  g_bp_bad_cnt = (uint16_t)rx[7] | ((uint16_t)rx[8] << 8);
  g_bp_fault_code = rx[9];
  g_bp_last_mode = rx[10];
  if (!NUCLEO_MCSDK_ACIM_BACKEND) {
    g_bp_enc_raw = (uint16_t)rx[11] | ((uint16_t)rx[12] << 8);
    g_bp_enc_ok = (rx[13] != 0);
    g_bp_enc_ms = now_ms;
    enc_speed_update(g_bp_enc_raw, g_bp_enc_ok, now_ms);
  }
  g_bp_ext_flags = rx[14];
  g_bp_brake_q15 = (uint16_t)rx[15] | ((uint16_t)rx[16] << 8);
  g_bp_phase_flags = rx[29];
  g_bp_mcsdk_telemetry = (g_bp_phase_flags & MC_TELEMETRY_FLAG_MCSDK_UNITS) != 0U;
  g_bp_vbus_valid = (g_bp_phase_flags & MC_TELEMETRY_FLAG_VBUS_VALID) != 0U;
  g_bp_softstart_ready = (g_bp_phase_flags & MC_TELEMETRY_FLAG_SOFTSTART_READY) != 0U;
  if ((g_bp_phase_flags & MC_TELEMETRY_FLAG_FW_BUILD_VALID) != 0U &&
      (g_bp_phase_flags & BP_PHASE_FLAG_VALID) == 0U) {
    g_bp_fw_build = (uint32_t)rx[23] |
                    ((uint32_t)rx[24] << 8U) |
                    ((uint32_t)rx[25] << 16U) |
                    ((uint32_t)rx[26] << 24U);
  } else {
    g_bp_fw_build = 0U;
  }
  g_mc_diagnostics = decode_nucleo_fault_diagnostics(rx, g_bp_mcsdk_telemetry, g_bp_fw_build);
  if (g_mc_diagnostics.valid) g_bp_brake_q15 = 0U;
  g_bp_vbus_raw = (uint16_t)rx[17] | ((uint16_t)rx[18] << 8);
  if (g_bp_mcsdk_telemetry) {
    g_bp_vdc = (float)g_bp_vbus_raw * 0.1f;
  } else {
    if (g_bp_vbus_raw > 4095U) {
      g_bp_vbus_raw = 4095U;
    }
    g_bp_vdc = bp_vdc_from_raw(g_bp_vbus_raw);
  }
  g_bp_vbus_ms = now_ms;
  g_bp_temp_raw = (uint16_t)rx[19] | ((uint16_t)rx[20] << 8);
  g_bp_temp_flags = rx[21];
  if (g_bp_mcsdk_telemetry) {
    g_bp_temp_v = 0.0f;
    g_bp_temp_c = ((float)(int16_t)g_bp_temp_raw) * 0.1f;
  } else {
    if (g_bp_temp_raw > 4095U) {
      g_bp_temp_raw = 4095U;
    }
    g_bp_temp_v = bp_temp_voltage_from_raw(g_bp_temp_raw);
    float temp_c = 0.0f;
    if ((g_bp_temp_flags & BP_TEMP_FLAG_VALID) != 0 && bp_temp_c_from_raw(g_bp_temp_raw, &temp_c)) {
      g_bp_temp_c = temp_c;
    } else {
      g_bp_temp_c = 0.0f;
    }
  }
  g_bp_temp_ms = now_ms;
  g_bp_fan_duty_q8 = g_mc_diagnostics.valid ? 0U : rx[BP_RSP_FAN_DUTY_Q8];
  g_bp_fan_tach_x30 = g_mc_diagnostics.valid ? 0U : rx[BP_RSP_FAN_TACH_X30];
  g_bp_fan_duty = (float)g_bp_fan_duty_q8 / 255.0f;
  g_bp_fan_rpm = (float)g_bp_fan_tach_x30 * BP_FAN_TACH_RPM_STEP;
  if ((g_bp_phase_flags & BP_PHASE_FLAG_VALID) != 0U) {
    g_bp_phase_a_raw = (uint16_t)rx[23] | ((uint16_t)rx[24] << 8);
    g_bp_phase_b_raw = (uint16_t)rx[25] | ((uint16_t)rx[26] << 8);
    g_bp_phase_c_raw = (uint16_t)rx[27] | ((uint16_t)rx[28] << 8);
  } else {
    g_bp_phase_a_raw = 0U;
    g_bp_phase_b_raw = 0U;
    g_bp_phase_c_raw = 0U;
  }
  if (g_bp_phase_a_raw > 4095U) g_bp_phase_a_raw = 4095U;
  if (g_bp_phase_b_raw > 4095U) g_bp_phase_b_raw = 4095U;
  if (g_bp_phase_c_raw > 4095U) g_bp_phase_c_raw = 4095U;
  g_bp_phase_a_v = bp_phase_voltage_from_raw(g_bp_phase_a_raw);
  g_bp_phase_b_v = bp_phase_voltage_from_raw(g_bp_phase_b_raw);
  g_bp_phase_c_v = bp_phase_voltage_from_raw(g_bp_phase_c_raw);
  g_bp_phase_ms = now_ms;
  g_bp_last_rsp_ms = now_ms;
  const unsigned int timing_rx_key = irq_lock();
  g_link_timing.rx(micros(), g_pwm_enabled || ((rx[3] & BP_STATUS_PWM_ACTIVE) != 0U));
  irq_unlock(timing_rx_key);
  if (g_nucleo_waiting_rsp && g_bp_last_seq == g_nucleo_waiting_seq) {
    g_nucleo_waiting_rsp = false;
    g_nucleo_last_ack_us = micros();
  }
  // A correlated safe-off reply acknowledges delivery, not removal of a
  // physical fault. Never keep resetting Nucleo's counters during undervoltage.
  if (g_clear_fault_req) {
    bool fault = (g_bp_fault_code != 0) || ((g_bp_status & 0x08u) != 0u);
    if (clear_ack || (!require_sequence && !fault)) {
      g_clear_fault_req = false;
    }
  }
  return true;
}

// Non-blocking UART reply parser (Nucleo -> UNO Q).
// We keep it simple: sync to 0x55 0xAA header, then collect one reply frame.
static void nucleo_uart_poll() {
  static uint8_t st = 0;
  static uint8_t idx = 0;
  static uint8_t buf[BP_FRAME_LEN];
  while (NUCLEO_SERIAL.available() > 0) {
    uint8_t b = (uint8_t)NUCLEO_SERIAL.read();
    // Detect the motor controller's boot ping (0x5A 0xA5 ...) to diagnose RX wiring/baud
    // even when no valid reply frames are received yet.
    if (g_bp_ping_prev == 0x5A && b == 0xA5) {
      if (g_bp_ping_pairs < 0xFFFFFFFFu) g_bp_ping_pairs++;
      g_bp_ping_ms = millis();
    }
    g_bp_ping_prev = b;
    if (st == 0) {
      if (b == 0x55) {
        buf[0] = b;
        st = 1;
      }
      continue;
    }
    if (st == 1) {
      if (b == 0xAA) {
        buf[1] = b;
        idx = 2;
        st = 2;
      } else if (b == 0x55) {
        buf[0] = b;
        st = 1;
      } else {
        st = 0;
      }
      continue;
    }
    // st == 2
    buf[idx++] = b;
    if (idx >= sizeof(buf)) {
      st = 0;
      idx = 0;
      const bool integrity_ok = buf[0] == 0x55 && buf[1] == 0xAA &&
          buf[2] == BP_VER && nucleo_crc8(buf, BP_CRC_OFF) == buf[BP_CRC_OFF];
      if (integrity_ok && g_nucleo_superseded.consume(
              buf[4], micros(), BP_REPLY_TIMEOUT_MS * 1000U)) {
        if (g_nucleo_rx_superseded < 0xFFFFu) g_nucleo_rx_superseded++;
      } else if (g_nucleo_waiting_rsp &&
          nucleo_check_reply(buf, true, g_nucleo_waiting_seq)) {
        if (g_nucleo_rx_good < 0xFFFFu) g_nucleo_rx_good++;
        g_nucleo_last_rx_ms = millis();
        g_link_led_ms = g_nucleo_last_rx_ms;
      } else {
        if (g_nucleo_rx_bad < 0xFFFFu) g_nucleo_rx_bad++;
        if (!integrity_ok) {
          if (g_nucleo_rx_bad_integrity < 0xFFFFu) g_nucleo_rx_bad_integrity++;
        } else if (g_nucleo_rx_bad_sequence < 0xFFFFu) {
          g_nucleo_rx_bad_sequence++;
        }
      }
    }
  }
}
static void nucleo_spi_init() {
  if (!USE_NUCLEO_SPI) {
    return;
  }
  pinMode(NUCLEO_SPI_CS, OUTPUT);
  digitalWrite(NUCLEO_SPI_CS, HIGH);
  if (FORCE_SPI_BITBANG) {
    pinMode(NUCLEO_SPI_SCK, OUTPUT);
    pinMode(NUCLEO_SPI_MOSI, OUTPUT);
    pinMode(NUCLEO_SPI_MISO, INPUT);
    digitalWrite(NUCLEO_SPI_SCK, LOW);
    digitalWrite(NUCLEO_SPI_MOSI, LOW);
    return;
  }
  SPI.begin();
}
static void nucleo_uart_init() {
  if (!USE_EXTERNAL_PWM) {
    return;
  }
  if (USE_NUCLEO_SPI) {
    nucleo_spi_init();
    if (USE_NUCLEO_UART_FALLBACK) {
      NUCLEO_SERIAL.begin(NUCLEO_UART_BAUD);
    }
    return;
  }
  NUCLEO_SERIAL.begin(NUCLEO_UART_BAUD);
  while (NUCLEO_SERIAL.available() > 0) {
    (void)NUCLEO_SERIAL.read();
  }
}
static void nucleo_spi_transfer(const uint8_t *tx, uint8_t *rx, size_t len) {
  if (!USE_NUCLEO_SPI || tx == nullptr || rx == nullptr || len == 0) {
    return;
  }
  if (FORCE_SPI_BITBANG) {
    digitalWrite(NUCLEO_SPI_CS, LOW);
    delayMicroseconds(2);
    for (size_t i = 0; i < len; ++i) {
      uint8_t t = tx[i];
      uint8_t r = 0;
      for (int bit = 7; bit >= 0; --bit) {
        digitalWrite(NUCLEO_SPI_MOSI, (t & (1U << bit)) ? HIGH : LOW);
        digitalWrite(NUCLEO_SPI_SCK, HIGH);
        delayMicroseconds(2);
        if (digitalRead(NUCLEO_SPI_MISO)) {
          r |= (uint8_t)(1U << bit);
        }
        digitalWrite(NUCLEO_SPI_SCK, LOW);
        delayMicroseconds(2);
      }
      rx[i] = r;
    }
    digitalWrite(NUCLEO_SPI_CS, HIGH);
    return;
  }
  SPI.beginTransaction(g_spi_settings);
  digitalWrite(NUCLEO_SPI_CS, LOW);
  delayMicroseconds(2);
  for (size_t i = 0; i < len; ++i) {
    rx[i] = SPI.transfer(tx[i]);
  }
  delayMicroseconds(2);
  digitalWrite(NUCLEO_SPI_CS, HIGH);
  SPI.endTransaction();
}
static void nucleo_send_pwm(float d_u, float d_v, float d_w, bool enable, bool force) {
  if (!USE_EXTERNAL_PWM) {
    return;
  }
  uint32_t now = millis();
  uint32_t now_us = micros();
  const bool mcsdk_scalar =
      NUCLEO_MCSDK_ACIM_BACKEND && enable && !g_estop_latched && !g_io_test_mode;
  const bool local_scalar = mcsdk_scalar ||
      (enable && !g_estop_latched && !g_diag_pwm && !g_duty_mode &&
       g_mode == MODE_VF && g_state == STATE_VF_RUN);
  // When outputs are off we throttle updates to a heartbeat rate,
  // but if a CLEAR is pending we keep sending until it is acknowledged.
  if (!force && !enable && !g_clear_fault_req && (uint32_t)(now - g_nucleo_last_send_ms) < NUCLEO_HEARTBEAT_MS) {
    return;
  }
  if (!force && !g_estop_latched && USE_NUCLEO_UART_FALLBACK) {
    nucleo_uart_poll();
    if (g_nucleo_waiting_rsp) {
      if ((uint32_t)(now_us - g_nucleo_last_send_us) < NUCLEO_RUN_REPLY_GUARD_US) {
        return;
      }
      g_nucleo_superseded.retire(g_nucleo_waiting_seq, g_nucleo_last_send_us);
      g_nucleo_waiting_rsp = false;
    }
  }
  const uint32_t min_send_us = local_scalar ? NUCLEO_SCALAR_MIN_SEND_US : NUCLEO_RUN_MIN_SEND_US;
  if (!force && (enable || g_clear_fault_req) &&
      (uint32_t)(now_us - g_nucleo_last_send_us) < min_send_us) {
    return;
  }
  uint8_t pkt[BP_FRAME_LEN] = {0};
  uint8_t seq = g_nucleo_seq++;
  bool enable_eff = enable;
  bool estop_eff = g_estop_latched;
  bool diag_eff = g_diag_pwm;
  bool clear_eff = g_clear_fault_req;
  bool io_test_eff = enable && g_io_test_mode && !g_pwm_enabled;
  uint8_t mode = BP_MODE_OFF;
  uint8_t ext_flags = g_ext_flags;
  if (!BP_PRECHARGE_RELAY_PRESENT) {
    ext_flags &= (uint8_t)(~BP_EXT_PRECHARGE_RELAY);
  }
  uint16_t brake_q15 = g_brake_q15;
  uint16_t fan_q15 = g_fan_q15;
  int16_t bp_id_q15 = 0;
  int16_t bp_iq_q15 = 0;
  uint32_t bp_foc_freq_millihz = 0;
  float du_eff = d_u;
  float dv_eff = d_v;
  float dw_eff = d_w;

  if (NUCLEO_MCSDK_ACIM_BACKEND) {
    // Service outputs belong to separate hardware. They are never tunnelled
    // through the motor-control UART adapter.
    ext_flags = 0;
    brake_q15 = 0;
    fan_q15 = 0;
    io_test_eff = false;
    diag_eff = false;
    // An UNO-side I/O test has no matching MCSDK service endpoint. Keep the
    // drive stopped instead of issuing a legacy mode that Nucleo must reject.
    if (g_io_test_mode || unoq_mcsdk_zero_stop(true, g_freq_cmd)) {
      enable_eff = false;
    }
  }

  // For CLEAR we must send a "safe" frame: MODE OFF + ENABLE=0 + ESTOP=0
  // (see the motor-controller can_clear_fault()).
  if (clear_eff) {
    enable_eff = false;
    estop_eff = false;
    diag_eff = false;
    mode = BP_MODE_OFF;
    ext_flags = 0;
    brake_q15 = 0;
    du_eff = 0.0f;
    dv_eff = 0.0f;
    dw_eff = 0.0f;
  } else if (io_test_eff && !estop_eff) {
    // The motor controller applies service outputs in its MODE_OFF/ENABLE=0 path.
    // Keeping this frame disabled prevents any PWM mode from being entered.
    enable_eff = false;
    diag_eff = false;
    mode = BP_MODE_OFF;
    ext_flags &= (uint8_t)(~BP_EXT_BRAKE_PWM);
    brake_q15 = 0;
    du_eff = 0.0f;
    dv_eff = 0.0f;
    dw_eff = 0.0f;
  } else if (enable_eff && !estop_eff) {
    if (mcsdk_scalar) {
      mode = BP_MODE_SCALAR;
    } else {
      const bool foc_backend_allowed =
          g_bp_foc_backend &&
          !diag_eff &&
          !g_duty_mode &&
          (g_mode == MODE_FOC || g_mode == MODE_MIC) &&
          (g_state == STATE_FOC_ALIGN || g_state == STATE_FOC_RUN);
      if (foc_backend_allowed) {
        mode = BP_MODE_FOC;
        bp_id_q15 = bp_foc_current_q15(g_id_ref);
        bp_iq_q15 = bp_foc_current_q15(g_iq_ref);
        bp_foc_freq_millihz = bp_freq_millihz(g_freq_ref);
      } else if (local_scalar) {
        mode = BP_MODE_SCALAR;
      } else {
        mode = diag_eff ? BP_MODE_DIAG : BP_MODE_DUTY;
      }
    }
  }

  uint8_t flags = 0;
  if (enable_eff) flags |= BP_FLAG_ENABLE;
  if (estop_eff) flags |= BP_FLAG_ESTOP;
  if (clear_eff) flags |= BP_FLAG_CLEAR_FAULT;
  if (diag_eff) flags |= BP_FLAG_DIAG_PWM;

  uint16_t du_q15 = q15_unit(du_eff);
  uint16_t dv_q15 = q15_unit(dv_eff);
  uint16_t dw_q15 = q15_unit(dw_eff);

  pkt[0] = 0xAA;
  pkt[1] = 0x55;
  pkt[2] = BP_VER;
  pkt[3] = flags;
  pkt[4] = mode;
  pkt[5] = seq;
  if (mode == BP_MODE_FOC) {
    pkt[6] = (uint8_t)((uint16_t)bp_id_q15 & 0xFF);
    pkt[7] = (uint8_t)(((uint16_t)bp_id_q15 >> 8) & 0xFF);
    pkt[8] = (uint8_t)((uint16_t)bp_iq_q15 & 0xFF);
    pkt[9] = (uint8_t)(((uint16_t)bp_iq_q15 >> 8) & 0xFF);
    pkt[10] = (uint8_t)(bp_foc_freq_millihz & 0xFF);
    pkt[11] = (uint8_t)((bp_foc_freq_millihz >> 8) & 0xFF);
    pkt[12] = (uint8_t)((bp_foc_freq_millihz >> 16) & 0xFF);
    pkt[13] = (uint8_t)((bp_foc_freq_millihz >> 24) & 0xFF);
  } else if (mode == BP_MODE_SCALAR) {
    uint32_t scalar_freq_millihz = bp_freq_millihz(
        unoq_scalar_wire_frequency(mcsdk_scalar, g_freq_cmd, g_freq_ref));
    uint16_t scalar_vmag_q15 = bp_scalar_vmag_q15();
    pkt[6] = (uint8_t)(scalar_freq_millihz & 0xFF);
    pkt[7] = (uint8_t)((scalar_freq_millihz >> 8) & 0xFF);
    pkt[8] = (uint8_t)((scalar_freq_millihz >> 16) & 0xFF);
    pkt[9] = (uint8_t)((scalar_freq_millihz >> 24) & 0xFF);
    pkt[10] = (uint8_t)(scalar_vmag_q15 & 0xFF);
    pkt[11] = (uint8_t)((scalar_vmag_q15 >> 8) & 0xFF);
    pkt[12] = 0;
    pkt[13] = 0;
  } else {
    pkt[6] = (uint8_t)(du_q15 & 0xFF);
    pkt[7] = (uint8_t)((du_q15 >> 8) & 0xFF);
    pkt[8] = (uint8_t)(dv_q15 & 0xFF);
    pkt[9] = (uint8_t)((dv_q15 >> 8) & 0xFF);
    pkt[10] = (uint8_t)(dw_q15 & 0xFF);
    pkt[11] = (uint8_t)((dw_q15 >> 8) & 0xFF);
    pkt[12] = 0;
    pkt[13] = 0;
  }
  pkt[14] = ext_flags;
  pkt[15] = (uint8_t)(brake_q15 & 0xFF);
  pkt[16] = (uint8_t)((brake_q15 >> 8) & 0xFF);
  pkt[BP_CMD_FAN_DUTY_LO] = (uint8_t)(fan_q15 & 0xFF);
  pkt[BP_CMD_FAN_DUTY_HI] = (uint8_t)((fan_q15 >> 8) & 0xFF);
  pkt[BP_CRC_OFF] = nucleo_crc8(pkt, BP_CRC_OFF);
  g_bp_cmd_mode = mode;
  if (USE_NUCLEO_SPI) {
    uint8_t rx[BP_FRAME_LEN] = {0};
    nucleo_spi_transfer(pkt, rx, sizeof(pkt));
    if (nucleo_check_reply(rx, false, seq)) {
      if (g_nucleo_rx_good < 0xFFFFu) g_nucleo_rx_good++;
      g_nucleo_last_rx_ms = now;
      g_link_led_ms = now;
    } else {
      if (g_nucleo_rx_bad < 0xFFFFu) g_nucleo_rx_bad++;
    }
  }
  if (USE_NUCLEO_UART_FALLBACK) {
    // Accept only the reply that echoes this command sequence. A delayed or
    // replayed valid frame must not refresh status or acknowledge CLEAR.
    if (force && g_nucleo_waiting_rsp) {
      g_nucleo_superseded.retire(g_nucleo_waiting_seq, g_nucleo_last_send_us);
    }
    g_nucleo_superseded.forget(seq);
    g_nucleo_waiting_rsp = true;
    g_nucleo_waiting_seq = seq;
    g_nucleo_waiting_clear = clear_eff;
    const uint32_t timing_tx_begin = micros();
    const size_t timing_written = NUCLEO_SERIAL.write(pkt, sizeof(pkt));
    const uint32_t timing_tx_end = micros();
    const unsigned int timing_tx_key = irq_lock();
    g_link_timing.tx(timing_tx_end, timing_tx_end - timing_tx_begin, timing_written,
                     (flags & BP_FLAG_ENABLE) != 0U);
    irq_unlock(timing_tx_key);
    nucleo_uart_poll();
  }
  g_nucleo_last_send_ms = now;
  g_nucleo_last_send_us = now_us;
  g_nucleo_last_tx_ms = now;
}
static void nucleo_send_stop(bool force) {
  nucleo_send_pwm(0.0f, 0.0f, 0.0f, false, force);
}
static void pwm_force_off(bool force_link) {
  if (USE_EXTERNAL_PWM) {
    // The first shutdown frame is forced by hard_stop(). Repeated SAFE/ESTOP
    // control ticks use the normal heartbeat limiter to avoid UART flooding.
    nucleo_send_stop(force_link);
    g_pwm_outputs_active = false;
    g_pwm_forced_gpio = false;
    return;
  }
  analogWrite(PWM_UH_PIN, 0);
  analogWrite(PWM_UL_PIN, PWM_LOW_INVERTED ? PWM_FULL : 0);
  analogWrite(PWM_VH_PIN, 0);
  analogWrite(PWM_VL_PIN, PWM_LOW_INVERTED ? PWM_FULL : 0);
  analogWrite(PWM_WH_PIN, 0);
  analogWrite(PWM_WL_PIN, PWM_LOW_INVERTED ? PWM_FULL : 0);
  g_pwm_outputs_active = false;
  g_pwm_forced_gpio = false;
}
static void brake_set(bool on) {
  if (NUCLEO_MCSDK_ACIM_BACKEND) {
    pinMode(BRAKE_PIN, INPUT);
    g_brake_on = false;
    return;
  }
  g_brake_on = on;
  if (BRAKE_ACTIVE_HIGH) {
    digitalWrite(BRAKE_PIN, on ? HIGH : LOW);
  } else {
    digitalWrite(BRAKE_PIN, on ? LOW : HIGH);
  }
}
static void pwm_restore() {
  if (USE_EXTERNAL_PWM) {
    return;
  }
  if (!g_pwm_forced_gpio) {
    return;
  }
  analogWrite(PWM_UH_PIN, 0);
  analogWrite(PWM_UL_PIN, PWM_LOW_INVERTED ? PWM_FULL : 0);
  analogWrite(PWM_VH_PIN, 0);
  analogWrite(PWM_VL_PIN, PWM_LOW_INVERTED ? PWM_FULL : 0);
  analogWrite(PWM_WH_PIN, 0);
  analogWrite(PWM_WL_PIN, PWM_LOW_INVERTED ? PWM_FULL : 0);
  g_pwm_forced_gpio = false;
}
static void pwm_write_phase(uint8_t pin_hi, uint8_t pin_lo, float duty) {
  float hi_on = clampf(duty, 0.0f, 1.0f);
  float hi_pwm = hi_on;
  if (PWM_THREE_PWM_MODE) {
    // High-side PWM only; low-side forced off for safety.
    analogWrite(pin_hi, duty_u8(hi_pwm));
    analogWrite(pin_lo, PWM_LOW_INVERTED ? PWM_FULL : 0);
    return;
  }
  float lo_on = 1.0f - hi_on;
  hi_on = clampf(hi_on - PWM_DEADTIME_DUTY, 0.0f, 1.0f);
  lo_on = clampf(lo_on - PWM_DEADTIME_DUTY, 0.0f, 1.0f);
  hi_pwm = hi_on;
  float lo_pwm = PWM_LOW_INVERTED ? (1.0f - lo_on) : lo_on;
  analogWrite(pin_hi, duty_u8(hi_pwm));
  analogWrite(pin_lo, duty_u8(lo_pwm));
}
static void pwm_write(float d_u, float d_v, float d_w) {
  if (!g_pwm_enabled) {
    if (g_pwm_outputs_active) {
      pwm_force_off();
    }
    // Keep SPI heartbeat even when outputs are disabled.
    if (USE_EXTERNAL_PWM) {
      nucleo_send_pwm(0.0f, 0.0f, 0.0f, g_io_test_mode);
    }
    return;
  }
  if (g_duty_mode || g_diag_pwm) {
    d_u = g_duty_u;
    d_v = g_duty_v;
    d_w = g_duty_w;
  }
  if (USE_EXTERNAL_PWM) {
    g_pwm_outputs_active = true;
    nucleo_send_pwm(d_u, d_v, d_w, true);
    return;
  }
  pwm_restore();
  g_pwm_outputs_active = true;
  d_u = clampf(d_u, 0.0f, 1.0f);
  d_v = clampf(d_v, 0.0f, 1.0f);
  d_w = clampf(d_w, 0.0f, 1.0f);
  pwm_write_phase(PWM_UH_PIN, PWM_UL_PIN, d_u);
  pwm_write_phase(PWM_VH_PIN, PWM_VL_PIN, d_v);
  pwm_write_phase(PWM_WH_PIN, PWM_WL_PIN, d_w);
}
static void hard_stop(bool clear_cmd, bool force_link) {
  const bool outputs_were_active = g_pwm_enabled || g_pwm_outputs_active || g_state != STATE_SAFE;
  g_io_test_mode = false;
  g_pwm_enabled = false;
  g_state = STATE_SAFE;
  g_stop_requested = false;
  g_start_req = false;
  g_stop_req = false;
  g_run_limit_ms = 0;
  g_run_deadline_ms = 0;
  g_mode_switch_pending = false;
  g_restart_after_mode_switch = false;
  g_align_ticks = 0;
  g_freq_ref = 0.0f;
  g_omega_ref = 0.0f;
  g_id_ref = 0.0f;
  g_iq_ref = 0.0f;
  g_id_target = 0.0f;
  g_iq_target = 0.0f;
  g_theta = 0.0f;
  mic_diag_reset();
  g_last_vd = 0.0f;
  g_last_vq = 0.0f;
  if (clear_cmd) {
    g_freq_cmd = 0.0f;
  }
  // Every stop path must release service outputs. This also covers run-limit,
  // link-loss and ESTOP shutdowns when no HMI request can follow.
  g_ext_flags &= (uint8_t)(~(BP_EXT_RESERVED_0 | BP_EXT_PFC | BP_EXT_BRAKE_PWM | BP_EXT_PRECHARGE_RELAY));
  g_brake_q15 = 0;
  pwm_force_off(force_link || outputs_were_active);
}
static void request_normal_stop() {
  ext_brake_set(0.0f);
  hard_stop(true);
}
static uint8_t pwm_level(bool on, bool inverted) {
  if (inverted) {
    return on ? 0 : PWM_MAX;
  }
  return on ? PWM_MAX : 0;
}
static void svm(float v_alpha, float v_beta, float vdc, float *d_a, float *d_b, float *d_c) {
  float v_a = v_alpha;
  float v_b = (-0.5f * v_alpha) + (0.8660254f * v_beta);
  float v_c = (-0.5f * v_alpha) - (0.8660254f * v_beta);
  float v_max = v_a;
  if (v_b > v_max) v_max = v_b;
  if (v_c > v_max) v_max = v_c;
  float v_min = v_a;
  if (v_b < v_min) v_min = v_b;
  if (v_c < v_min) v_min = v_c;
  float v_offset = -0.5f * (v_max + v_min);
  v_a += v_offset;
  v_b += v_offset;
  v_c += v_offset;
  float inv_vdc = (vdc > 0.1f) ? (1.0f / vdc) : 0.0f;
  *d_a = 0.5f + (v_a * inv_vdc);
  *d_b = 0.5f + (v_b * inv_vdc);
  *d_c = 0.5f + (v_c * inv_vdc);
  float duty_min = DUTY_MIN;
  float duty_max = DUTY_MAX;
  if (g_stop_requested) {
    duty_min = 0.0f;
    duty_max = 1.0f;
  }
  *d_a = clampf(*d_a, duty_min, duty_max);
  *d_b = clampf(*d_b, duty_min, duty_max);
  *d_c = clampf(*d_c, duty_min, duty_max);
}
static void apply_mode_if_safe() {
  if (g_mode_change_pending && g_state == STATE_SAFE) {
    g_mode = g_mode_pending;
    g_mode_change_pending = false;
  }
}
static void cancel_mode_switch() {
  g_mode_pending = g_mode;
  g_mode_change_pending = false;
  g_mode_switch_pending = false;
  g_mode_switch_deadline_ms = 0;
  g_restart_after_mode_switch = false;
}
static void set_run_limit(float seconds) {
  if (seconds <= 0.0f) {
    if (g_pwm_enabled && START_REQUIRE_RUN_LIMIT) request_normal_stop();
    g_run_limit_ms = 0;
    g_run_deadline_ms = 0;
    return;
  }
  seconds = clampf(seconds, 0.1f, 600.0f);
  g_run_limit_ms = (uint32_t)(seconds * 1000.0f + 0.5f);
  if (g_pwm_enabled) {
    g_run_deadline_ms = unoq_bounded_run_deadline(millis(), g_run_limit_ms,
        g_run_deadline_ms, START_REQUIRE_RUN_LIMIT);
  }
}
static bool should_restart_after_mode_switch() {
  return g_pwm_enabled && !g_stop_req && !g_stop_requested && !g_estop_latched;
}
static void request_mode(ControlMode next_mode, bool duty_mode, bool diag_pwm) {
  if (NUCLEO_MCSDK_ACIM_BACKEND) {
    // This target is V/F only. Never label a scalar MCSDK run as FOC or MIC.
    next_mode = MODE_VF;
    duty_mode = false;
    diag_pwm = false;
    g_bp_foc_backend = false;
  }
  bool same_mode = (g_mode == next_mode);
  bool same_flags = (g_duty_mode == duty_mode && g_diag_pwm == diag_pwm);
  g_duty_mode = duty_mode;
  g_diag_pwm = diag_pwm;
  if (g_state == STATE_SAFE) {
    cancel_mode_switch();
    g_mode = next_mode;
    return;
  }
  if (same_mode && same_flags) {
    cancel_mode_switch();
    return;
  }
  schedule_mode_switch(next_mode, should_restart_after_mode_switch());
}
static void schedule_mode_switch(ControlMode next_mode, bool restart_after_switch) {
  g_mode_pending = next_mode;
  g_mode_change_pending = true;
  g_mode_switch_pending = true;
  g_restart_after_mode_switch = restart_after_switch;
  g_mode_switch_deadline_ms = 0;
  g_run_limit_ms = 0;
  g_run_deadline_ms = 0;
  g_stop_requested = false;
  g_start_req = false;
  g_stop_req = false;
  g_pwm_enabled = false;
  g_state = STATE_SAFE;
  g_freq_ref = 0.0f;
  g_iq_ref = 0.0f;
  g_id_ref = 0.0f;
  g_theta = 0.0f;
  g_omega_ref = 0.0f;
  mic_diag_reset();
  pwm_force_off();
  apply_mode_if_safe();
}
static float read_vdc() {
  if (USE_EXTERNAL_PWM && g_bp_vbus_ms != 0 &&
      (uint32_t)(millis() - g_bp_vbus_ms) <= BP_VBUS_STALE_MS) {
    return g_bp_vdc;
  }
  uint16_t raw = analogRead(ADC_VDC_PIN);
  float vdc = ((float)raw * VDC_ADC_VREF * VDC_ADC_DIVIDER) / 4095.0f;
  if (vdc < VDC_ADC_MIN_V || vdc > VDC_ADC_MAX_V) {
    return g_vdc;
  }
  return vdc;
}
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
