11lisov11/mic_practice/artifacts/current_pwm_20261008/uart_guard_801/baseline/server_before_710.py

#!/usr/bin/env python3
from __future__ import annotations

import argparse
import hashlib
import json
import math
import os
import select
import secrets
import socket
import subprocess
import sys
import threading
import time
import urllib.request
from collections import deque
from http.server import BaseHTTPRequestHandler, ThreadingHTTPServer
from typing import Callable, Deque, List, Optional, Tuple
from urllib.parse import parse_qs, urlparse

try:
    import termios
except Exception:  # pragma: no cover - Windows/local dev without POSIX TTY
    termios = None

try:
    import msgpack
except Exception:  # pragma: no cover - allow text-only mode without msgpack
    msgpack = None

STATE_NAMES = {
    0: "SAFE",
    1: "VF_RUN",
    2: "FOC_ALIGN",
    3: "FOC_RUN",
    4: "FAULT",
}
MODE_NAMES = {
    0: "VF",
    1: "FOC",
    2: "MIC",
    3: "DIAG",
    4: "DUTY",
}
STATE_CODES = {v: k for k, v in STATE_NAMES.items()}
MODE_CODES = {v: k for k, v in MODE_NAMES.items()}
MC_MODE_DIAG = 1
MC_MODE_DUTY = 2
MC_CAP_VF = 0x01
MC_CAP_FOC = 0x02
MC_CAP_MIC = 0x04
DEFAULT_REMOTEOCD = "/home/arduino/.arduino15/packages/arduino/tools/remoteocd/0.0.4-rc.4/remoteocd"
DEFAULT_REMOTEOCD_CFG = os.path.join(os.path.dirname(__file__), "flash_unoq_sketch_090.cfg")
DEFAULT_CMD_GUARD_MAX_VDC = 60.0
CMD_GUARD_MAX_AGE_MS = 1000.0
# Independent raw-ADC gate mirrored from the motor-controller firmware. The raw check does
# not trust the scaled Vbus field, but its calibration points must stay in sync
# with the firmware and are enforced by firmware_config_safety_check.py.
VBUS_RAW_MIN_VALID = 1
VBUS_RAW_MAX_VALID = 4094
VBUS_RAW_ZERO_CAL = 1966
VBUS_RAW_CAL = 3459
VBUS_RAW_CAL_V = 315.0
# Legacy compile-time override. Production remains False; an authenticated,
# persisted two-point verification is the normal way to unlock HV arming.
VBUS_HV_CALIBRATION_VALID = False
VBUS_RAW_WINDOW_MARGIN_V = 5.0
VBUS_RAW_ZERO_LOW_MARGIN = 128
DEFAULT_VBUS_CALIBRATION_FILE = os.path.expanduser("~/.config/mic-ai/vbus_calibration.json")
VBUS_CAL_ZERO_MAX_METER_V = 2.0
VBUS_CAL_ZERO_MAX_REPORTED_V = 5.0
VBUS_CAL_HV_MIN_METER_V = 250.0
VBUS_CAL_HV_MAX_METER_V = 360.0
VBUS_CAL_HV_MAX_ERROR_PERCENT = 3.0
VBUS_CAL_HV_MAX_ERROR_FLOOR_V = 5.0
VBUS_CAL_ZERO_MAX_STD_V = 0.5
VBUS_CAL_HV_MAX_STD_FLOOR_V = 1.0
VBUS_CAL_HV_MAX_STD_PERCENT = 0.5
VBUS_CAL_CAPTURE_SAMPLES = 20
DEFAULT_START_RUNLIMIT_SEC = 15.0
DEFAULT_HV_ARM_TTL_SEC = 30.0
DEFAULT_HV_ARM_MIN_VDC = 100.0
DEFAULT_HV_ARM_MAX_VDC = 400.0
DEFAULT_HV_ARM_CONFIRM = "ARM 310V"
DEFAULT_HV_ARM_MIN_TEMP_C = -20.0
DEFAULT_HV_ARM_MAX_TEMP_C = 90.0
DEFAULT_LV_ARM_TTL_SEC = 30.0
DEFAULT_LV_ARM_MIN_VDC = 0.0
DEFAULT_LV_ARM_MAX_VDC = 10.0
DEFAULT_LV_ARM_CONFIRM = "ARM LV HV OFF"
DEFAULT_LV_START_RUNLIMIT_SEC = 3.0
DEFAULT_OPERATOR_HEARTBEAT_TIMEOUT_SEC = 3.0
DEFAULT_RELAY_CONFIRM_TIMEOUT_SEC = 1.5
DEFAULT_RELAY_SETTLE_SEC = 0.35
DEFAULT_RUN_CONFIRM_TIMEOUT_SEC = 6.0
ARM_PROFILE_HV = "hv"
ARM_PROFILE_LV = "lv"
HV_RUNTIME_BAD_BURST_LIMIT = 3
HV_RUNTIME_BAD_WINDOW_SEC = 1.0

TOOLS_DIR = os.path.abspath(os.path.join(os.path.dirname(__file__), "..", "tools"))
if TOOLS_DIR not in sys.path:
    sys.path.insert(0, TOOLS_DIR)

try:
    from active_pwm_guard import start_allowed_by_bench_gate
except Exception:  # pragma: no cover - fail closed if tooling import is broken
    start_allowed_by_bench_gate = None  # type: ignore[assignment]

def effective_mode(
    mode_code: int,
    mc_mode: int,
    diag_mode: Optional[int] = None,
    duty_mode: Optional[int] = None,
) -> tuple[int, str]:
    if diag_mode is not None:
        if int(diag_mode) != 0:
            return 3, MODE_NAMES[3]
    elif mc_mode == MC_MODE_DIAG:
        return 3, MODE_NAMES[3]
    if duty_mode is not None:
        if int(duty_mode) != 0:
            return 4, MODE_NAMES[4]
    elif mc_mode == MC_MODE_DUTY:
        return 4, MODE_NAMES[4]
    return mode_code, MODE_NAMES.get(mode_code, str(mode_code))


def _now_ts() -> float:
    return time.time()


def _fmt_ts(ts: float) -> str:
    return time.strftime("%Y-%m-%d %H:%M:%S", time.localtime(ts))


def termios_baud_constant(baud: int) -> int:
    if termios is None:
        raise RuntimeError("termios not available on this platform")
    name = f"B{int(baud)}"
    if not hasattr(termios, name):
        raise RuntimeError(f"termios baud {baud} is not supported by this platform")
    return int(getattr(termios, name))


class LogStore:
    def __init__(self, max_bytes: int, log_path: Optional[str], file_max_bytes: int) -> None:
        self._max_bytes = max_bytes
        self._total_bytes = 0
        self._items: Deque[Tuple[float, str]] = deque()
        self._lock = threading.Lock()
        self._log_path = log_path
        self._file_max_bytes = file_max_bytes
        if self._log_path:
            log_dir = os.path.dirname(self._log_path)
            if log_dir:
                os.makedirs(log_dir, exist_ok=True)

    def add(self, line: str) -> None:
        ts = _now_ts()
        entry = f"{_fmt_ts(ts)} {line}"
        size = len(entry) + 1
        with self._lock:
            self._items.append((ts, entry))
            self._total_bytes += size
            while self._total_bytes > self._max_bytes and self._items:
                _, old = self._items.popleft()
                self._total_bytes -= (len(old) + 1)
            if self._log_path:
                self._append_to_file(entry)

    def _append_to_file(self, entry: str) -> None:
        if not self._log_path:
            return
        try:
            with open(self._log_path, "a", encoding="utf-8") as f:
                f.write(entry + "\n")
            if self._file_max_bytes <= 0:
                return
            size = os.path.getsize(self._log_path)
            if size <= self._file_max_bytes:
                return
            self._truncate_file_tail()
        except Exception:
            pass

    def _truncate_file_tail(self) -> None:
        if not self._log_path:
            return
        try:
            with open(self._log_path, "rb") as f:
                f.seek(0, os.SEEK_END)
                size = f.tell()
                keep = min(size, self._file_max_bytes)
                f.seek(max(size - keep, 0))
                data = f.read()
            # Drop partial line at start
            nl = data.find(b"\n")
            if nl != -1:
                data = data[nl + 1 :]
            with open(self._log_path, "wb") as f:
                f.write(data)
        except Exception:
            pass

    @staticmethod
    def _parse_ts(entry: str) -> Optional[float]:
        try:
            ts_str = entry[:19]
            return time.mktime(time.strptime(ts_str, "%Y-%m-%d %H:%M:%S"))
        except Exception:
            return None

    def dump_since(self, since_ts: float) -> List[str]:
        if self._log_path and os.path.exists(self._log_path):
            try:
                with open(self._log_path, "r", encoding="utf-8", errors="ignore") as f:
                    lines = f.read().splitlines()
                out: List[str] = []
                for raw_line in lines:
                    # Concurrent legacy writers could leave sparse NUL bytes in
                    # the persistent log. Never expose them through /api/logs.
                    line = raw_line.replace("\x00", "").strip()
                    if not line:
                        continue
                    ts = self._parse_ts(line)
                    if ts is None or ts >= since_ts:
                        out.append(line)
                return out
            except Exception:
                pass
        with self._lock:
            return [entry for ts, entry in self._items if ts >= since_ts]


def _tail_text(text: str, max_chars: int = 4000) -> str:
    if len(text) <= max_chars:
        return text
    return text[-max_chars:]


def _as_float(data: dict, key: str, default: float = 0.0) -> float:
    if key.startswith("bp_") and f"mc_{key[3:]}" in data:
        key = f"mc_{key[3:]}"
    try:
        return float(data.get(key, default))
    except (TypeError, ValueError):
        return default


def _as_int(data: dict, key: str, default: int = 0) -> int:
    if key.startswith("bp_") and f"mc_{key[3:]}" in data:
        key = f"mc_{key[3:]}"
    try:
        return int(float(data.get(key, default)))
    except (TypeError, ValueError):
        return default


def with_motor_controller_aliases(data: dict) -> dict:
    """Publish mc_* as the canonical API while retaining bp_* compatibility."""
    for key, value in list(data.items()):
        if key.startswith("mc_") and key not in ("mc_capabilities", "mc_supported_modes"):
            data[f"bp_{key[3:]}"] = value
    for key, value in list(data.items()):
        if key.startswith("bp_"):
            data.setdefault(f"mc_{key[3:]}", value)
    data["mc_fault_detail"] = motor_fault_detail(data)
    if _as_int(data, "bp_mcsdk_telemetry", 0) == 1:
        data["mc_current_telemetry_valid"] = 0
        data["mc_current_telemetry_source"] = "uno_q_local_adc_unqualified"
    return data


MC_FAULT_REASONS = {
    0: "NONE", 1: "CRC", 2: "PROTOCOL_VERSION", 3: "ENABLE_REPLAY",
    4: "ESTOP", 5: "SERVICE_FIELD", 6: "COMMAND_REJECTED",
    7: "FREQUENCY_REJECTED", 8: "MCSDK_FAULT", 9: "BUS_OUT_OF_RANGE",
    10: "START_REJECTED", 11: "UART_TX_FAILED", 12: "UART_RX_ERROR",
    13: "LINK_TIMEOUT", 14: "RX_BUFFER_OVERFLOW",
}
MCSDK_FAULT_BITS = {
    0x0001: "MC_DURATION", 0x0002: "MC_OVER_VOLT", 0x0004: "MC_UNDER_VOLT",
    0x0008: "MC_OVER_TEMP", 0x0010: "MC_START_UP", 0x0020: "MC_SPEED_FDBK",
    0x0040: "MC_OVER_CURR", 0x0080: "MC_SW_ERROR", 0x0400: "MC_DP_FAULT",
}


def motor_fault_detail(data: dict) -> str:
    if _as_int(data, "mc_diag_valid", 0) != 1:
        return "cause unavailable in installed firmware"
    reason = _as_int(data, "mc_fault_reason", -1)
    label = MC_FAULT_REASONS.get(reason, f"UNKNOWN_REASON_{reason}")
    uart = _as_int(data, "mc_uart_error_flags", 0)
    uart_names = [name for bit, name in ((1, "PE"), (2, "FE"), (4, "NE"), (8, "ORE")) if uart & bit]
    masks = []
    for field in ("mc_fault_current_mask", "mc_fault_occurred_mask"):
        mask = _as_int(data, field, 0)
        names = [name for bit, name in MCSDK_FAULT_BITS.items() if mask & bit]
        unknown = mask & ~sum(MCSDK_FAULT_BITS)
        if unknown:
            names.append(f"UNKNOWN_BITS_0x{unknown:04X}")
        masks.append(f"0x{mask:04X}[{'|'.join(names) or 'NONE'}]")
    return (f"first={label} UART={'|'.join(uart_names) or 'NONE'} "
            f"MCSDK_current={masks[0]} MCSDK_occurred={masks[1]} "
            f"state={_as_int(data, 'mc_fault_motor_state', -1)} "
            f"seq={_as_int(data, 'mc_fault_sequence', -1)} "
            f"TX_status={_as_int(data, 'mc_fault_tx_status', 0)} "
            f"last_bad={MC_FAULT_REASONS.get(_as_int(data, 'mc_last_bad_reason', 0), 'UNKNOWN') if _as_int(data, 'mc_last_bad_valid', 0) == 1 else 'UNAVAILABLE'} "
            f"last_UART_flags=0x{_as_int(data, 'mc_last_uart_error_flags', 0):02X} "
            f"last_TX_status={_as_int(data, 'mc_last_tx_status', 0)}")


class MotorFaultRecorder:
    """Bounded, observational flight recorder; never sends control commands."""

    FIELDS = (
        "ts", "state", "mode", "pwm", "estop", "vdc", "freq", "freq_cmd",
        "fw_build", "mc_fw_build", "mc_status", "mc_fault", "mc_age_ms",
        "mc_seq", "mc_good_cnt", "mc_bad_cnt", "mc_bad_integrity", "mc_bad_sequence",
        "mc_vbus_raw", "mc_vbus_age_ms", "mc_vbus_valid", "mc_softstart_ready",
        "mc_temp_c", "mc_temp_fault", "mc_temp_age_ms", "mc_current_telemetry_valid",
        "mc_diag_valid", "mc_fault_reason", "mc_uart_error_flags", "mc_fault_motor_state",
        "mc_fault_current_mask", "mc_fault_occurred_mask", "mc_fault_sequence",
        "mc_fault_tx_status", "mc_last_bad_valid", "mc_last_bad_reason",
        "mc_last_uart_error_flags", "mc_last_tx_status", "enc_bus_ok", "enc_ok",
        "enc_speed_ok", "enc_reads", "enc_errors", "enc_io_error", "enc_age_ms",
        "enc_status", "hmi_hv_armed", "hmi_operator_heartbeat_age_s",
    )
    KEY_FIELDS = (
        "mc_fw_build", "mc_diag_valid", "mc_fault_reason", "mc_uart_error_flags",
        "mc_fault_current_mask", "mc_fault_occurred_mask", "mc_fault_motor_state",
        "mc_fault_sequence", "mc_fault_tx_status", "mc_bad_cnt",
        "mc_last_bad_reason", "mc_last_uart_error_flags", "mc_last_tx_status",
    )

    def __init__(self) -> None:
        self._history = deque(maxlen=64)
        self._key = None
        self._event_id = ""
        self._event_summary = ""
        self._last_sample = -math.inf
        self._post_until = -math.inf
        self._lock = threading.Lock()

    @staticmethod
    def compact(data: dict, now: float) -> dict:
        sample = {"observed_monotonic_s": round(now, 6), "observed_unix_s": _now_ts()}
        for key in MotorFaultRecorder.FIELDS:
            value = data.get(key)
            if key.startswith("mc_") and value is None:
                value = data.get("bp_" + key[3:])
            if type(value) in (str, bool, int) or value is None:
                sample[key] = value
            elif type(value) is float and math.isfinite(value):
                sample[key] = value
            else:
                sample[key] = None
        return sample

    def observe(self, data: dict, now: Optional[float] = None) -> list[str]:
        now = time.monotonic() if now is None else now
        sample = self.compact(data, now)
        valid = _as_int(data, "mc_diag_valid", 0) == 1
        active = _as_int(data, "bp_fault", 0)
        first_reason = _as_int(data, "mc_fault_reason", 0)
        has_cause = bool(first_reason or active)
        key = tuple(sample.get(k) for k in self.KEY_FIELDS) if has_cause else None
        if key is not None and not valid:
            key += (active,)
        lines = []
        with self._lock:
            changed = key is not None and key != self._key
            self._key = key
            if changed:
                recent_bad = (_as_int(data, "mc_last_bad_valid", 0) == 1
                              and _as_int(data, "bp_bad_cnt", 0) > 0
                              and _as_int(data, "mc_last_bad_reason", 0) != 0)
                reason = _as_int(data, "mc_last_bad_reason", 0) if recent_bad else first_reason
                flags = _as_int(data, "mc_last_uart_error_flags" if recent_bad else "mc_uart_error_flags", 0)
                uart_names = [name for bit, name in ((1, "PE"), (2, "FE"), (4, "NE"), (8, "ORE")) if flags & bit]
                label = MC_FAULT_REASONS.get(reason, "UNKNOWN") if valid else "DIAGNOSTICS_UNAVAILABLE"
                self._event_id = secrets.token_hex(8)
                self._event_summary = f"{label}; UART={'|'.join(uart_names) or 'NONE'}; physical source not identified"
                before = [s for s in self._history if 0 <= now - s["observed_monotonic_s"] <= 5]
                payload = {
                    "schema": "mic_ai.fault_context.v1", "event_id": self._event_id,
                    "phase": "fault", "summary": self._event_summary,
                    "physical_source_identified": False,
                    "controller_masks_are_first_fault_snapshot": True,
                    "time_basis": "Linux observation, not exact MCU interrupt timestamp",
                    "detail": motor_fault_detail(data), "before": before, "at": sample,
                    "history_samples": len(before), "post_window_s": 5,
                    "sampling_note": "observed RPC snapshots; intervening transients are not measured",
                }
                lines.append("MC_FAULT_CONTEXT " + json.dumps(payload, separators=(",", ":"), allow_nan=False))
                self._post_until = now + 5
            transition = bool(self._history and any(
                sample.get(field) != self._history[-1].get(field)
                for field in ("state", "pwm", "mc_fault", "enc_bus_ok", "enc_errors")
            ))
            if changed or transition or now - self._last_sample >= .19:
                if not changed and now <= self._post_until:
                    lines.append("MC_FAULT_CONTEXT " + json.dumps({
                        "schema": "mic_ai.fault_context.v1", "event_id": self._event_id,
                        "phase": "after", "at": sample,
                    }, separators=(",", ":"), allow_nan=False))
                self._history.append(sample)
                self._last_sample = now
        return lines

    def snapshot(self) -> dict:
        with self._lock:
            return {"hmi_fault_log_schema": "mic_ai.fault_context.v1",
                    "hmi_last_fault_event_id": self._event_id,
                    "hmi_last_fault_summary": self._event_summary,
                    "hmi_fault_physical_source_identified": 0}


def supported_modes_from_caps(capabilities: int) -> list[str]:
    modes: list[str] = []
    if capabilities & MC_CAP_VF:
        modes.append("VF")
    if capabilities & MC_CAP_FOC:
        modes.append("FOC")
    if capabilities & MC_CAP_MIC:
        modes.append("MIC")
    return modes


def _truthy_env(name: str) -> bool:
    return os.environ.get(name, "").strip().lower() in ("1", "true", "yes", "on")


def _vbus_calibration_identity(data: dict) -> dict:
    return {
        "fw_build": _as_int(data, "fw_build", -1),
        "mc_fw_build": _as_int(data, "mc_fw_build", -1),
        "rpc_schema_version": _as_int(data, "rpc_schema_version", -1),
        "mc_capabilities": _as_int(data, "mc_capabilities", -1),
        "mc_mcsdk_telemetry": _as_int(data, "bp_mcsdk_telemetry", 0),
    }


def _vbus_calibration_identity_matches(stored: dict, current: dict) -> bool:
    if stored == current:
        return True
    # Audited diagnostic-only updates retain the same Vbus word (0.1 V/LSB).
    # Keep the original capture identities; do not authorize unknown firmware.
    firmware_pairs = {
        (2026092901, 2026100601), (2026100612, 2026100601),
        (2026100701, 2026100601), (2026100701, 2026100701),
        (2026100702, 2026100601), (2026100702, 2026100701), (2026100702, 2026100702),
        (2026100703, 2026100601), (2026100703, 2026100701),
        (2026100703, 2026100702), (2026100703, 2026100703),
        (2026100704, 2026100601), (2026100704, 2026100701),
        (2026100704, 2026100702), (2026100704, 2026100703), (2026100704, 2026100704),
        (2026100705, 2026100704), (2026100705, 2026100705),
        (2026100706, 2026100705),
        (2026100707, 2026100707),
        (2026100708, 2026100707), (2026100708, 2026100708),
        (2026100709, 2026100708),
    }
    contract = {
        "rpc_schema_version": 3,
        "mc_capabilities": MC_CAP_VF,
        "mc_mcsdk_telemetry": 1,
    }
    expected_keys = set(contract) | {"fw_build", "mc_fw_build"}
    return (
        set(stored) == expected_keys
        and set(current) == expected_keys
        and isinstance(stored["fw_build"], int) and isinstance(stored["mc_fw_build"], int)
        and isinstance(current["fw_build"], int) and isinstance(current["mc_fw_build"], int)
        and (stored["fw_build"], stored["mc_fw_build"]) in firmware_pairs
        and (current["fw_build"], current["mc_fw_build"]) in firmware_pairs
        and all(stored[key] == value and current[key] == value
                for key, value in contract.items())
    )


class VbusCalibrationStore:
    SCHEMA = "mic_ai.vbus_calibration.v1"

    def __init__(self, path: Optional[str] = None) -> None:
        self.path = os.path.abspath(os.path.expanduser(path)) if path else None
        self._lock = threading.RLock()
        self._record: dict = {}
        self._load_error = ""
        self._load()

    @staticmethod
    def _digest(record: dict) -> str:
        payload = dict(record)
        payload.pop("integrity_sha256", None)
        encoded = json.dumps(payload, sort_keys=True, separators=(",", ":"), ensure_ascii=True).encode("utf-8")
        return hashlib.sha256(encoded).hexdigest()

    def _load(self) -> None:
        if not self.path or not os.path.exists(self.path):
            return
        try:
            with open(self.path, "r", encoding="utf-8") as source:
                record = json.load(source)
            if not isinstance(record, dict) or record.get("schema") != self.SCHEMA:
                raise ValueError("unsupported calibration schema")
            expected = str(record.get("integrity_sha256", ""))
            if not expected or not secrets.compare_digest(expected, self._digest(record)):
                raise ValueError("calibration integrity check failed")
            self._record = record
        except Exception as exc:
            self._record = {}
            self._load_error = str(exc)

    def _save_locked(self) -> None:
        if not self.path:
            return
        directory = os.path.dirname(self.path)
        if directory:
            os.makedirs(directory, mode=0o700, exist_ok=True)
        self._record["integrity_sha256"] = self._digest(self._record)
        temporary = f"{self.path}.tmp.{os.getpid()}.{threading.get_ident()}"
        try:
            with open(temporary, "w", encoding="utf-8", newline="\n") as target:
                json.dump(self._record, target, indent=2, sort_keys=True, ensure_ascii=True)
                target.write("\n")
                target.flush()
                os.fsync(target.fileno())
            try:
                os.chmod(temporary, 0o600)
            except OSError:
                pass
            os.replace(temporary, self.path)
        finally:
            try:
                if os.path.exists(temporary):
                    os.remove(temporary)
            except OSError:
                pass

    def _evaluate_locked(self, status: Optional[dict] = None) -> tuple[bool, str]:
        if VBUS_HV_CALIBRATION_VALID:
            return True, "compile-time calibration override"
        if self._load_error:
            return False, f"stored calibration rejected: {self._load_error}"
        if not self._record:
            return False, "zero-point capture is required"
        if self._record.get("schema") != self.SCHEMA:
            return False, "stored calibration schema is invalid"
        points = self._record.get("points")
        if not isinstance(points, dict):
            return False, "stored calibration points are missing"
        zero = points.get("zero")
        high = points.get("high")
        if not isinstance(zero, dict):
            return False, "zero-point capture is required"
        if not isinstance(high, dict):
            return False, "known-HV capture is required"
        identity = self._record.get("identity")
        if not isinstance(identity, dict):
            return False, "calibration identity is missing"
        if (
            _as_int(identity, "fw_build", -1) <= 0
            or _as_int(identity, "mc_fw_build", -1) <= 0
            or _as_int(identity, "rpc_schema_version", -1) < 3
            or _as_int(identity, "mc_mcsdk_telemetry", 0) != 1
        ):
            return False, "calibration identity is incomplete"
        if status is not None and not _vbus_calibration_identity_matches(
            identity, _vbus_calibration_identity(status)
        ):
            return False, "firmware or telemetry identity changed; recalibration is required"
        try:
            meter_span = float(high.get("meter_vdc")) - float(zero.get("meter_vdc"))
            reported_span = float(high.get("mc_vdc_mean")) - float(zero.get("mc_vdc_mean"))
        except (TypeError, ValueError):
            return False, "calibration point values are invalid"
        if not (math.isfinite(meter_span) and math.isfinite(reported_span)):
            return False, "calibration point values are invalid"
        if meter_span < (VBUS_CAL_HV_MIN_METER_V - VBUS_CAL_ZERO_MAX_METER_V) or reported_span <= 0.0:
            return False, "calibration span is invalid"
        gain = meter_span / reported_span
        if gain < 0.97 or gain > 1.03:
            return False, f"calibration gain mismatch: {gain:.5f}"
        return True, "two-point Vbus verification passed"

    def is_valid(self, status: Optional[dict] = None) -> bool:
        with self._lock:
            valid, _ = self._evaluate_locked(status)
            return valid

    def snapshot(self, status: Optional[dict] = None) -> dict:
        with self._lock:
            valid, reason = self._evaluate_locked(status)
            points = self._record.get("points", {}) if isinstance(self._record, dict) else {}
            zero = points.get("zero") if isinstance(points, dict) else None
            high = points.get("high") if isinstance(points, dict) else None
            return {
                "valid": bool(valid),
                "reason": reason,
                "zero_captured": isinstance(zero, dict),
                "high_captured": isinstance(high, dict),
                "zero_meter_vdc": zero.get("meter_vdc") if isinstance(zero, dict) else None,
                "zero_mc_vdc": zero.get("mc_vdc_mean") if isinstance(zero, dict) else None,
                "high_meter_vdc": high.get("meter_vdc") if isinstance(high, dict) else None,
                "high_mc_vdc": high.get("mc_vdc_mean") if isinstance(high, dict) else None,
                "updated_at": self._record.get("updated_at") if isinstance(self._record, dict) else None,
            }

    def record_capture(self, capture: dict, status: dict) -> tuple[bool, str, dict]:
        meter_vdc = capture.get("meter_vdc")
        try:
            meter = float(meter_vdc)
            reported = float(capture["mc_vdc"]["mean"])
            reported_std = float(capture["mc_vdc"]["std"])
            raw_mean = float(capture["mc_vbus_raw"]["mean"])
            bad_min = int(capture["mc_bad"]["min"])
            bad_max = int(capture["mc_bad"]["max"])
            sample_count = int(capture["mc_vdc"]["samples"])
        except (KeyError, TypeError, ValueError):
            return False, "calibration capture is incomplete", self.snapshot(status)
        if sample_count != VBUS_CAL_CAPTURE_SAMPLES:
            return False, (
                f"calibration capture requires {VBUS_CAL_CAPTURE_SAMPLES} samples; got {sample_count}"
            ), self.snapshot(status)
        if not all(math.isfinite(value) for value in (meter, reported, reported_std, raw_mean)):
            return False, "calibration capture contains non-finite values", self.snapshot(status)
        if _as_int(status, "bp_mcsdk_telemetry", 0) != 1 or _as_int(status, "bp_vbus_valid", 0) != 1:
            return False, "MCSDK Vbus telemetry is not valid", self.snapshot(status)
        if _as_int(status, "mc_fw_build", 0) <= 0:
            return False, "Nucleo firmware identity is not available", self.snapshot(status)
        if abs((raw_mean * 0.1) - reported) > 1.0:
            return False, "MCSDK Vbus telemetry fields disagree", self.snapshot(status)
        if bad_min != bad_max:
            return False, "motor-controller UART error counter changed during capture", self.snapshot(status)

        if 0.0 <= meter <= VBUS_CAL_ZERO_MAX_METER_V:
            kind = "zero"
            if reported < 0.0 or reported > VBUS_CAL_ZERO_MAX_REPORTED_V:
                return False, f"reported zero-bus voltage is too high: {reported:.2f} V", self.snapshot(status)
            if reported_std > VBUS_CAL_ZERO_MAX_STD_V:
                return False, f"zero-point capture is unstable: std={reported_std:.3f} V", self.snapshot(status)
            if abs(reported - meter) > VBUS_CAL_ZERO_MAX_METER_V:
                return False, f"zero-point mismatch is too large: meter={meter:.2f} V, MCSDK={reported:.2f} V", self.snapshot(status)
        elif VBUS_CAL_HV_MIN_METER_V <= meter <= VBUS_CAL_HV_MAX_METER_V:
            kind = "high"
            if bad_max != 0:
                return False, "clear motor-controller UART error counters before known-HV capture", self.snapshot(status)
            allowed_error = max(VBUS_CAL_HV_MAX_ERROR_FLOOR_V, meter * VBUS_CAL_HV_MAX_ERROR_PERCENT / 100.0)
            if abs(reported - meter) > allowed_error:
                return False, (
                    f"known-HV mismatch is too large: meter={meter:.2f} V, "
                    f"MCSDK={reported:.2f} V, allowed={allowed_error:.2f} V"
                ), self.snapshot(status)
            allowed_std = max(VBUS_CAL_HV_MAX_STD_FLOOR_V, meter * VBUS_CAL_HV_MAX_STD_PERCENT / 100.0)
            if reported_std > allowed_std:
                return False, f"known-HV capture is unstable: std={reported_std:.3f} V", self.snapshot(status)
        else:
            return False, "meter voltage must be 0..2 V for zero or 250..360 V for known HV", self.snapshot(status)

        identity = _vbus_calibration_identity(status)
        point = {
            "kind": kind,
            "captured_at": _now_ts(),
            "meter_vdc": round(meter, 6),
            "mc_vdc_mean": round(reported, 6),
            "mc_vdc_std": round(reported_std, 6),
            "mc_vbus_raw_mean": round(raw_mean, 6),
            "samples": sample_count,
        }
        with self._lock:
            if kind == "zero":
                self._record = {
                    "schema": self.SCHEMA,
                    "updated_at": _now_ts(),
                    "identity": identity,
                    "points": {"zero": point},
                }
                self._load_error = ""
                self._save_locked()
                valid, reason = self._evaluate_locked(status)
            else:
                points = self._record.get("points", {}) if isinstance(self._record, dict) else {}
                stored_identity = self._record.get("identity")
                if (not isinstance(stored_identity, dict)
                        or not _vbus_calibration_identity_matches(stored_identity, identity)
                        or not isinstance(points.get("zero"), dict)):
                    valid, reason = False, "capture a new zero point before the known-HV point"
                    return valid, reason, self.snapshot(status)
                points["high"] = point
                self._record["points"] = points
                self._record["updated_at"] = _now_ts()
                self._save_locked()
                valid, reason = self._evaluate_locked(status)
            snapshot = self.snapshot(status)
        return valid or kind == "zero", reason, snapshot

    def reset(self) -> dict:
        with self._lock:
            self._record = {}
            self._load_error = ""
            if self.path:
                try:
                    os.remove(self.path)
                except FileNotFoundError:
                    pass
            return self.snapshot()


def _cmd_tokens(cmd: str) -> list[str]:
    return cmd.strip().split()


def _cmd_head(cmd: str) -> str:
    parts = _cmd_tokens(cmd)
    return parts[0].upper() if parts else ""


def _on_off_arg(parts: list[str], index: int = 1) -> Optional[bool]:
    if len(parts) <= index:
        return None
    val = parts[index].strip().upper()
    if val in ("1", "ON", "TRUE", "YES"):
        return True
    if val in ("0", "OFF", "FALSE", "NO"):
        return False
    return None


def _positive_arg(parts: list[str], index: int) -> bool:
    if len(parts) <= index:
        return False
    try:
        return float(parts[index]) > 0.0001
    except (TypeError, ValueError):
        return False


def command_requests_start(cmd: str) -> bool:
    parts = _cmd_tokens(cmd)
    return len(parts) == 1 and parts[0].upper() == "START"


def command_requests_service_output(cmd: str) -> bool:
    parts = _cmd_tokens(cmd)
    if not parts:
        return False
    head = parts[0].upper()
    if head == "IOTEST":
        return _on_off_arg(parts) is True
    if head in ("MCFOC", "BPFOC"):
        return _on_off_arg(parts) is True
    if head in ("PFC", "PRECHARGE"):
        return _on_off_arg(parts) is True
    if head == "FAN":
        if len(parts) == 2:
            arg = parts[1].upper()
            if arg == "ON":
                return True
            if arg == "OFF":
                return False
            return _positive_arg(parts, 1)
        if len(parts) == 3 and parts[1].upper() in ("PWM", "DUTY"):
            return _positive_arg(parts, 2)
        return False
    if head == "BRAKE":
        if len(parts) == 2:
            if parts[1].upper() == "OFF":
                return False
            return _positive_arg(parts, 1)
        if len(parts) == 3 and parts[1].upper() in ("PWM", "DUTY"):
            return _positive_arg(parts, 2)
        return False
    return False


def command_releases_service_output(cmd: str) -> bool:
    parts = _cmd_tokens(cmd)
    if not parts:
        return False
    head = parts[0].upper()
    if head in ("IOTEST", "MCFOC", "BPFOC", "PFC", "PRECHARGE"):
        return _on_off_arg(parts) is False
    if head == "FAN":
        if len(parts) == 2:
            return parts[1].upper() == "OFF" or not _positive_arg(parts, 1)
        if len(parts) == 3 and parts[1].upper() in ("PWM", "DUTY"):
            return not _positive_arg(parts, 2)
    if head == "BRAKE":
        if len(parts) == 2:
            return parts[1].upper() == "OFF" or not _positive_arg(parts, 1)
        if len(parts) == 3 and parts[1].upper() in ("PWM", "DUTY"):
            return not _positive_arg(parts, 2)
    return False


def status_has_active_outputs(data: Optional[dict]) -> bool:
    if data is None:
        return True
    return bool(
        _as_int(data, "pwm", 1) != 0
        or _as_int(data, "precharge", 1) != 0
        or (_as_int(data, "bp_ext", 0xFF) & 0x0E) != 0
        or _as_int(data, "pfc", 1) != 0
        or _as_int(data, "brake", 1) != 0
        or _as_float(data, "brake_duty", 1.0) > 0.0001
        or _as_float(data, "fan_duty", 1.0) > 0.0001
        or _as_float(data, "bp_fan_duty", 1.0) > 0.0001
    )


class CommandGuardConfig:
    def __init__(
        self,
        max_vdc: float,
        allow_hv: bool = False,
        disabled: bool = False,
        bench_gate_url: str = "",
        bench_gate_runner: Optional[Callable[[Callable[[str], None], Optional[str]], bool]] = None,
        local_bench_gate: bool = False,
    ) -> None:
        self.max_vdc = max_vdc
        self.allow_hv = allow_hv
        self.disabled = disabled
        self.bench_gate_url = bench_gate_url
        self.bench_gate_runner = bench_gate_runner
        self.local_bench_gate = local_bench_gate


def start_bench_gate_check(cfg: CommandGuardConfig) -> tuple[bool, str]:
    if cfg.local_bench_gate:
        return True, "standalone live safety gate"
    logs: list[str] = []
    if cfg.bench_gate_runner is not None:
        ok = bool(cfg.bench_gate_runner(logs.append, cfg.bench_gate_url or None))
    elif start_allowed_by_bench_gate is not None:
        ok = bool(start_allowed_by_bench_gate(logs.append, url=cfg.bench_gate_url or None))
    else:
        ok = False
        logs.append("active_pwm_guard import failed")
    if ok:
        return True, "ok"
    detail = "; ".join(logs) if logs else "bench gate refused START"
    return False, f"bench gate blocked START: {detail}"


def validate_bench_gate_attestation(payload: object, now: Optional[float] = None) -> tuple[bool, str]:
    if not isinstance(payload, dict):
        return False, "attestation payload is not an object"
    if payload.get("ready_for_active_pwm") is not True:
        return False, "attestation is not green"
    current = time.time() if now is None else float(now)
    try:
        issued_at = float(payload.get("issued_at"))
        expires_at = float(payload.get("expires_at"))
    except (TypeError, ValueError):
        return False, "attestation timestamps are missing"
    if not (math.isfinite(issued_at) and math.isfinite(expires_at)):
        return False, "attestation timestamps are invalid"
    if issued_at > current + 1.0:
        return False, "attestation was issued in the future"
    if current - issued_at > 10.0:
        return False, "attestation is stale"
    if expires_at < current:
        return False, "attestation has expired"
    if expires_at - issued_at > 10.0:
        return False, "attestation validity window is too long"
    return True, "ok"


def attested_bench_gate_runner(log_fn: Callable[[str], None], url: Optional[str]) -> bool:
    target = str(url or "").strip()
    if not target:
        log_fn("bench-gate attestation URL is missing")
        return False
    try:
        request = urllib.request.Request(target, headers={"Accept": "application/json"})
        with urllib.request.urlopen(request, timeout=12.0) as response:
            payload = json.loads(response.read().decode("utf-8"))
    except Exception as exc:
        log_fn(f"bench-gate attestation request failed: {type(exc).__name__}: {exc}")
        return False
    ok, detail = validate_bench_gate_attestation(payload)
    if not ok:
        log_fn(f"bench-gate attestation rejected: {detail}")
    return ok


def _status_mc_bad(data: dict) -> int:
    values = [
        _as_int(data, key, 999999)
        for key in ("mc_bad_cnt", "mc_bad", "bp_bad_cnt", "bp_bad")
        if key in data
    ]
    if not values:
        return 999999
    return max(values)


def _status_vdc(data: dict) -> float:
    values: list[float] = []
    for key in ("vdc", "mc_vdc", "bp_vdc"):
        if key not in data:
            continue
        value = _as_float(data, key, float("nan"))
        if math.isfinite(value) and value >= 0.0:
            values.append(value)
    return max(values) if values else float("nan")


def _vbus_raw_for_voltage(vdc: float) -> float:
    span = float(VBUS_RAW_CAL - VBUS_RAW_ZERO_CAL)
    return float(VBUS_RAW_ZERO_CAL) + max(0.0, float(vdc)) * span / float(VBUS_RAW_CAL_V)


def raw_vbus_window_check(data: dict, min_vdc: float, max_vdc: float) -> tuple[bool, str]:
    if _as_float(data, "bp_vbus_age_ms", 999999.0) > CMD_GUARD_MAX_AGE_MS:
        return False, "raw DC bus telemetry is stale"
    if "bp_vbus_raw" not in data and "mc_vbus_raw" not in data:
        return False, "raw DC bus telemetry is missing"
    raw = _as_int(data, "bp_vbus_raw", -1)
    if _as_int(data, "bp_mcsdk_telemetry", 0) == 1:
        if _as_int(data, "bp_vbus_valid", 0) != 1:
            return False, "MCSDK DC bus telemetry is not valid"
        if raw < 0 or raw > 5000:
            return False, f"MCSDK DC bus telemetry is invalid: decivolts={raw}"
        direct_vdc = float(raw) * 0.1
        scaled_vdc = _status_vdc(data)
        if not math.isfinite(scaled_vdc) or abs(scaled_vdc - direct_vdc) > 1.0:
            return False, "MCSDK DC bus telemetry fields disagree"
        if direct_vdc < min_vdc or direct_vdc > max_vdc:
            return False, f"MCSDK DC bus is outside window: vdc={direct_vdc:.1f} V"
        return True, "ok"
    if raw < VBUS_RAW_MIN_VALID or raw > VBUS_RAW_MAX_VALID:
        return False, f"raw DC bus telemetry is invalid: raw={raw}"

    if max_vdc <= DEFAULT_CMD_GUARD_MAX_VDC:
        raw_min = VBUS_RAW_ZERO_CAL - VBUS_RAW_ZERO_LOW_MARGIN
        raw_max = math.ceil(_vbus_raw_for_voltage(max_vdc + VBUS_RAW_WINDOW_MARGIN_V))
        if raw < raw_min or raw > raw_max:
            label = "zero-bus" if max_vdc <= DEFAULT_LV_ARM_MAX_VDC else "low-voltage"
            return False, f"raw DC bus is outside the calibrated {label} window: raw={raw} expected={raw_min}..{raw_max}"
    if min_vdc >= DEFAULT_HV_ARM_MIN_VDC:
        raw_min = math.floor(_vbus_raw_for_voltage(min_vdc - VBUS_RAW_WINDOW_MARGIN_V))
        if raw < raw_min:
            return False, f"raw DC bus does not confirm an energized HV bus: raw={raw} expected>={raw_min}"
    return True, "ok"


def vbus_capture_precheck(data: Optional[dict], meter_vdc: Optional[float] = None) -> tuple[bool, str]:
    if data is None:
        return False, "status unavailable"
    state = str(data.get("state", "")).upper()
    state_code = _as_int(data, "state_code", STATE_CODES.get(state, -1))
    if state != "SAFE" and state_code != STATE_CODES["SAFE"]:
        return False, f"not SAFE: state={data.get('state')}"
    if _as_int(data, "pwm", 1) != 0:
        return False, "PWM is not off"
    if _as_int(data, "estop", 1) != 0:
        return False, "ESTOP is active"
    if not _status_link_live(data):
        return False, "motor-controller link is stale or down"
    if _as_float(data, "bp_vbus_age_ms", 999999.0) > CMD_GUARD_MAX_AGE_MS:
        return False, "DC bus telemetry is stale"
    if "bp_vbus_raw" not in data and "mc_vbus_raw" not in data:
        return False, "raw DC bus telemetry is missing"
    raw = _as_int(data, "bp_vbus_raw", -1)
    raw_max = 5000 if _as_int(data, "bp_mcsdk_telemetry", 0) == 1 else 4095
    if raw < 0 or raw > raw_max:
        return False, f"raw DC bus telemetry is invalid: raw={raw}"
    vdc = _status_vdc(data)
    if not math.isfinite(vdc):
        return False, "scaled DC bus telemetry is not readable"
    if _as_int(data, "bp_mcsdk_telemetry", 0) != 1 or _as_int(data, "bp_vbus_valid", 0) != 1:
        return False, "MCSDK Vbus telemetry is not valid"
    if _as_int(data, "bp_temp_valid", 0) != 1 or _as_int(data, "bp_temp_fault", 1) != 0:
        return False, "heatsink temperature protection is not healthy"
    if not math.isfinite(_as_float(data, "bp_temp_c", float("nan"))):
        return False, "heatsink temperature is not readable"
    for key in ("precharge", "pfc", "brake", "bp_ext"):
        if _as_int(data, key, 0) != 0:
            return False, f"output must be off during Vbus capture: {key}={_as_int(data, key, 0)}"
    zero_capture = meter_vdc is not None and 0.0 <= float(meter_vdc) <= VBUS_CAL_ZERO_MAX_METER_V
    if zero_capture:
        # MCSDK normally reports undervoltage while the bus is discharged. The
        # zero-point path may observe that fault, but still requires SAFE,
        # fresh telemetry, healthy temperature sensing and every output off.
        if vdc > VBUS_CAL_ZERO_MAX_REPORTED_V:
            return False, f"DC bus is too high for zero-point capture: vdc={vdc:.2f} V"
    else:
        if _as_int(data, "bp_fault", 255) != 0:
            return False, f"motor-controller fault is active: mc_fault={_as_int(data, 'bp_fault', 255)}"
        if _status_mc_bad(data) != 0:
            return False, "motor-controller bad-frame counter is non-zero"
    return True, "ok"


def vbus_capture_summary(samples: list[dict], meter_vdc: Optional[float]) -> dict:
    def stats(values: list[float]) -> dict:
        count = len(values)
        mean = sum(values) / count
        variance = sum((value - mean) ** 2 for value in values) / count
        return {
            "samples": count,
            "mean": mean,
            "std": math.sqrt(variance),
            "min": min(values),
            "max": max(values),
        }

    raw_values = [float(_as_int(sample, "bp_vbus_raw", -1)) for sample in samples]
    vdc_values = [float(_status_vdc(sample)) for sample in samples]
    temp_values = [float(_as_float(sample, "bp_temp_c", float("nan"))) for sample in samples]
    bad_values = [float(_status_mc_bad(sample)) for sample in samples]
    return with_motor_controller_aliases({
        "timestamp": _now_ts(),
        "meter_vdc": meter_vdc,
        "outputs_commanded": False,
        "state": "SAFE",
        "pwm": 0,
        "bp_vbus_raw": stats(raw_values),
        "bp_vdc": stats(vdc_values),
        "bp_temp_c": stats(temp_values),
        "bp_bad": stats(bad_values),
    })


def _status_link_live(data: dict) -> bool:
    if data.get("link") is False:
        return False
    ages: list[float] = []
    for key in ("mc_rsp_age_ms", "mc_age_ms", "bp_rsp_age_ms", "bp_age_ms"):
        if key in data:
            ages.append(_as_float(data, key, 999999.0))
    if data.get("last_rx_age_s") is not None:
        ages.append(_as_float(data, "last_rx_age_s", 999999.0) * 1000.0)
    return (bool(ages) and all(math.isfinite(age) and age >= 0 for age in ages)
            and min(ages) <= CMD_GUARD_MAX_AGE_MS)


def command_guard_check(cmd: str, data: Optional[dict], cfg: CommandGuardConfig) -> tuple[bool, str]:
    if not (command_requests_start(cmd) or command_requests_service_output(cmd)):
        return True, "not guarded"
    if data is None:
        return False, "status unavailable"
    state = str(data.get("state", "")).upper()
    state_code = _as_int(data, "state_code", STATE_CODES.get(state, -1))
    if state != "SAFE" and state_code != STATE_CODES["SAFE"]:
        return False, f"not SAFE: state={data.get('state')}"
    if _as_int(data, "pwm", 1) != 0:
        return False, f"PWM is not off: pwm={_as_int(data, 'pwm', 1)}"
    if _as_int(data, "estop", 1) != 0:
        return False, f"ESTOP is active: estop={_as_int(data, 'estop', 1)}"
    if _as_int(data, "bp_fault", 255) != 0:
        return False, f"motor-controller fault is active: mc_fault={_as_int(data, 'bp_fault', 255)}"
    bad = _status_mc_bad(data)
    if bad != 0:
        return False, f"motor-controller bad-frame counter is non-zero: mc_bad={bad}"
    if not _status_link_live(data):
        return False, "motor-controller link is stale or down"
    vdc = _status_vdc(data)
    if not math.isfinite(vdc):
        return False, "DC bus telemetry is not readable"
    if not (cfg.allow_hv or cfg.disabled):
        if vdc > cfg.max_vdc:
            return False, f"DC bus too high for command: vdc={vdc:.1f} V"
        raw_ok, raw_reason = raw_vbus_window_check(data, 0.0, cfg.max_vdc)
        if not raw_ok:
            return False, raw_reason
    if command_requests_start(cmd):
        return start_bench_gate_check(cfg)
    return True, "ok"


class HvArmConfig:
    def __init__(
        self,
        enabled: bool = False,
        ttl_sec: float = DEFAULT_HV_ARM_TTL_SEC,
        min_vdc: float = DEFAULT_HV_ARM_MIN_VDC,
        max_vdc: float = DEFAULT_HV_ARM_MAX_VDC,
        confirm: str = DEFAULT_HV_ARM_CONFIRM,
        min_temp_c: float = DEFAULT_HV_ARM_MIN_TEMP_C,
        max_temp_c: float = DEFAULT_HV_ARM_MAX_TEMP_C,
        profile: str = "hv",
    ) -> None:
        self.enabled = bool(enabled)
        self.ttl_sec = max(1.0, float(ttl_sec))
        self.min_vdc = float(min_vdc)
        self.max_vdc = float(max_vdc)
        self.confirm = str(confirm)
        self.min_temp_c = float(min_temp_c)
        self.max_temp_c = float(max_temp_c)
        self.profile = str(profile).strip().lower() or "hv"

    @property
    def profile_label(self) -> str:
        return self.profile.upper()


def hv_arm_precheck(
    data: Optional[dict], cfg: HvArmConfig, vbus_calibrated: Optional[bool] = None
) -> tuple[bool, str]:
    if not cfg.enabled:
        return False, "standalone arm mode is disabled"
    calibration_ready = VBUS_HV_CALIBRATION_VALID if vbus_calibrated is None else bool(vbus_calibrated)
    if cfg.profile == ARM_PROFILE_HV and not calibration_ready:
        return False, "HV Vbus calibration is incomplete; capture a known-voltage point before arming"
    if data is None:
        return False, "status unavailable"
    state = str(data.get("state", "")).upper()
    state_code = _as_int(data, "state_code", STATE_CODES.get(state, -1))
    if state != "SAFE" and state_code != STATE_CODES["SAFE"]:
        return False, f"not SAFE: state={data.get('state')}"
    if _as_int(data, "pwm", 1) != 0:
        return False, "PWM is not off"
    if _as_int(data, "estop", 1) != 0:
        return False, "ESTOP is active"
    if _as_int(data, "bp_fault", 255) != 0:
        return False, f"motor-controller fault is active: mc_fault={_as_int(data, 'bp_fault', 255)}"
    bad = _status_mc_bad(data)
    if bad != 0:
        return False, f"motor-controller bad-frame counter is non-zero: mc_bad={bad}"
    if not _status_link_live(data):
        return False, "motor-controller link is stale or down"

    vdc = _status_vdc(data)
    if not math.isfinite(vdc):
        return False, "DC bus telemetry is not readable"
    if vdc < cfg.min_vdc or vdc > cfg.max_vdc:
        return False, f"DC bus is outside {cfg.profile_label} arm window: vdc={vdc:.1f} V"
    raw_ok, raw_reason = raw_vbus_window_check(data, cfg.min_vdc, cfg.max_vdc)
    if not raw_ok:
        return False, raw_reason

    if _as_int(data, "bp_temp_valid", 0) != 1:
        return False, "heatsink temperature is invalid"
    if _as_int(data, "bp_temp_fault", 1) != 0:
        return False, "heatsink temperature fault is active"
    if _as_float(data, "bp_temp_age_ms", 999999.0) > CMD_GUARD_MAX_AGE_MS:
        return False, "heatsink temperature is stale"
    temp_c = _as_float(data, "bp_temp_c", float("nan"))
    if not math.isfinite(temp_c) or temp_c < cfg.min_temp_c or temp_c > cfg.max_temp_c:
        return False, f"heatsink temperature is implausible: temp={temp_c:.1f} C"
    return True, "ok"


def arm_profile_switch_precheck(data: Optional[dict], cfg: HvArmConfig) -> tuple[bool, str]:
    """Allow profile changes only while every commanded power output is inactive."""
    if data is None:
        return False, "status unavailable"
    state = str(data.get("state", "")).upper()
    state_code = _as_int(data, "state_code", STATE_CODES.get(state, -1))
    if state != "SAFE" and state_code != STATE_CODES["SAFE"]:
        return False, f"not SAFE: state={data.get('state')}"
    if _as_int(data, "pwm", 1) != 0:
        return False, "PWM is not off"
    if _as_int(data, "estop", 1) != 0:
        return False, "ESTOP is active"
    if _as_int(data, "precharge", 1) != 0:
        return False, "precharge relay is active"
    if _as_int(data, "pfc", 1) != 0:
        return False, "PFC output is active"
    if _as_int(data, "brake", 1) != 0 or _as_float(data, "brake_duty", 1.0) > 0.0001:
        return False, "brake output is active"
    if _as_int(data, "bp_fault", 255) != 0:
        return False, f"motor-controller fault is active: mc_fault={_as_int(data, 'bp_fault', 255)}"
    bad = _status_mc_bad(data)
    if bad != 0:
        return False, f"motor-controller bad-frame counter is non-zero: mc_bad={bad}"
    if not _status_link_live(data):
        return False, "motor-controller link is stale or down"

    if cfg.profile == ARM_PROFILE_LV:
        # LV selection itself is fail-closed. Arming repeats the complete check.
        vdc = _status_vdc(data)
        if not math.isfinite(vdc) or vdc < cfg.min_vdc or vdc > cfg.max_vdc:
            return False, f"DC bus is outside {cfg.profile_label} profile window: vdc={vdc:.1f} V"
        raw_ok, raw_reason = raw_vbus_window_check(data, cfg.min_vdc, cfg.max_vdc)
        if not raw_ok:
            return False, raw_reason
    return True, "ok"


def hv_runtime_check(
    data: Optional[dict], cfg: HvArmConfig, allow_nonzero_bad: bool = False,
    vbus_calibrated: Optional[bool] = None,
) -> tuple[bool, str]:
    calibration_ready = VBUS_HV_CALIBRATION_VALID if vbus_calibrated is None else bool(vbus_calibrated)
    if cfg.profile == ARM_PROFILE_HV and not calibration_ready:
        return False, "HV Vbus calibration is incomplete"
    if data is None:
        return False, "status unavailable"
    if _as_int(data, "estop", 1) != 0:
        return False, "ESTOP is active"
    if _as_int(data, "bp_fault", 255) != 0:
        return False, f"motor-controller fault is active: mc_fault={_as_int(data, 'bp_fault', 255)}"
    bad = _status_mc_bad(data)
    if bad != 0 and not allow_nonzero_bad:
        return False, f"motor-controller bad-frame counter is non-zero: mc_bad={bad}"
    if not _status_link_live(data):
        return False, "motor-controller link is stale or down"

    vdc = _status_vdc(data)
    if not math.isfinite(vdc) or vdc < cfg.min_vdc or vdc > cfg.max_vdc:
        return False, f"DC bus is outside {cfg.profile_label} runtime window: vdc={vdc:.1f} V"
    raw_ok, raw_reason = raw_vbus_window_check(data, cfg.min_vdc, cfg.max_vdc)
    if not raw_ok:
        return False, raw_reason

    if _as_int(data, "bp_temp_valid", 0) != 1:
        return False, "heatsink temperature is invalid"
    if _as_int(data, "bp_temp_fault", 1) != 0:
        return False, "heatsink temperature fault is active"
    if _as_float(data, "bp_temp_age_ms", 999999.0) > CMD_GUARD_MAX_AGE_MS:
        return False, "heatsink temperature is stale"
    temp_c = _as_float(data, "bp_temp_c", float("nan"))
    if not math.isfinite(temp_c) or temp_c < cfg.min_temp_c or temp_c > cfg.max_temp_c:
        return False, f"heatsink temperature is implausible: temp={temp_c:.1f} C"
    return True, "ok"


def output_sequence_health_check(
    data: Optional[dict], arm_cfg: HvArmConfig, guard_cfg: CommandGuardConfig,
    vbus_calibrated: Optional[bool] = None,
) -> tuple[bool, str]:
    if arm_cfg.enabled:
        return hv_runtime_check(data, arm_cfg, vbus_calibrated=vbus_calibrated)
    if data is None:
        return False, "status unavailable"
    if _as_int(data, "estop", 1) != 0:
        return False, "ESTOP is active"
    if _as_int(data, "bp_fault", 255) != 0:
        return False, f"motor-controller fault is active: mc_fault={_as_int(data, 'bp_fault', 255)}"
    bad = _status_mc_bad(data)
    if bad != 0:
        return False, f"motor-controller bad-frame counter is non-zero: mc_bad={bad}"
    if not _status_link_live(data):
        return False, "motor-controller link is stale or down"
    vdc = _status_vdc(data)
    if not math.isfinite(vdc):
        return False, "DC bus telemetry is not readable"
    if not (guard_cfg.allow_hv or guard_cfg.disabled):
        if vdc > guard_cfg.max_vdc:
            return False, f"DC bus too high for command: vdc={vdc:.1f} V"
        raw_ok, raw_reason = raw_vbus_window_check(data, 0.0, guard_cfg.max_vdc)
        if not raw_ok:
            return False, raw_reason
    return True, "ok"


class HvRuntimeBadFrameMonitor:
    """Trip on an error burst, not on one CRC-rejected frame under PWM EMI."""

    def __init__(
        self,
        burst_limit: int = HV_RUNTIME_BAD_BURST_LIMIT,
        window_sec: float = HV_RUNTIME_BAD_WINDOW_SEC,
    ) -> None:
        self.burst_limit = max(1, int(burst_limit))
        self.window_sec = max(0.1, float(window_sec))
        self._previous: dict[str, int] = {}
        self._events: Deque[tuple[float, int]] = deque()

    def reset(self) -> None:
        self._previous.clear()
        self._events.clear()

    def observe(self, data: dict, now: Optional[float] = None) -> tuple[bool, str]:
        timestamp = _now_ts() if now is None else float(now)
        delta = 0
        current: dict[str, int] = {}
        for key in ("mc_bad_cnt", "mc_bad", "bp_bad_cnt", "bp_bad"):
            if key not in data:
                continue
            value = max(0, _as_int(data, key, 999999))
            current[key] = value
            previous = self._previous.get(key, 0)
            if value >= previous:
                delta += value - previous
        self._previous = current

        if delta > 0:
            self._events.append((timestamp, delta))
        cutoff = timestamp - self.window_sec
        while self._events and self._events[0][0] < cutoff:
            self._events.popleft()
        burst = sum(count for _, count in self._events)
        if burst >= self.burst_limit:
            return False, f"motor-controller UART error burst: {burst} errors/{self.window_sec:.1f}s"
        if delta > 0:
            return True, f"isolated motor-controller UART errors: delta={delta}, window={burst}"
        return True, "ok"


class HvArmState:
    def __init__(
        self,
        cfg: HvArmConfig,
        calibration_provider: Optional[Callable[[Optional[dict]], bool]] = None,
    ) -> None:
        self.cfg = cfg
        self._lock = threading.Lock()
        self._expires_at = 0.0
        self._started = False
        self._calibration_provider = calibration_provider

    def set_calibration_provider(
        self, provider: Optional[Callable[[Optional[dict]], bool]]
    ) -> None:
        with self._lock:
            self._calibration_provider = provider

    def _calibration_valid(self, data: Optional[dict]) -> Optional[bool]:
        provider = self._calibration_provider
        return provider(data) if provider is not None else None

    def arm(self, confirm: str, data: Optional[dict]) -> tuple[bool, str]:
        if not secrets.compare_digest(str(confirm), self.cfg.confirm):
            return False, "confirmation phrase mismatch"
        ok, reason = hv_arm_precheck(data, self.cfg, self._calibration_valid(data))
        if not ok:
            return False, reason
        with self._lock:
            self._expires_at = _now_ts() + self.cfg.ttl_sec
            self._started = False
        return True, "armed"

    def disarm(self) -> None:
        with self._lock:
            self._expires_at = 0.0
            self._started = False

    def set_config(self, cfg: HvArmConfig) -> None:
        with self._lock:
            self.cfg = cfg
            self._expires_at = 0.0
            self._started = False

    def command_allowed(self, data: Optional[dict]) -> tuple[bool, str]:
        with self._lock:
            remaining = self._expires_at - _now_ts()
            if remaining <= 0.0:
                if not self._started:
                    self._expires_at = 0.0
                return False, f"{self.cfg.profile_label} arm is not active"
        return hv_arm_precheck(data, self.cfg, self._calibration_valid(data))

    def mark_started(self) -> None:
        with self._lock:
            if self._expires_at > _now_ts():
                self._started = True

    def mark_stopped(self) -> None:
        with self._lock:
            self._started = False

    def take_expired_session_action(self) -> bool:
        with self._lock:
            if self._expires_at <= 0.0:
                return False
            if self._expires_at > _now_ts():
                return False
            must_stop = self._started
            self._expires_at = 0.0
            self._started = False
            return must_stop

    def runtime_monitor_required(self) -> bool:
        with self._lock:
            return self._started and self._expires_at > _now_ts()

    def snapshot(self) -> dict:
        with self._lock:
            remaining = max(0.0, self._expires_at - _now_ts())
            if remaining <= 0.0 and not self._started:
                self._expires_at = 0.0
            return {
                "hmi_hv_enabled": int(self.cfg.enabled),
                "hmi_hv_armed": int(remaining > 0.0),
                "hmi_hv_started": int(self._started and remaining > 0.0),
                "hmi_hv_remaining_s": round(remaining, 1),
                "hmi_hv_min_vdc": self.cfg.min_vdc,
                "hmi_hv_max_vdc": self.cfg.max_vdc,
                "hmi_arm_profile": self.cfg.profile if self.cfg.enabled else "none",
                "hmi_arm_confirm": self.cfg.confirm if self.cfg.enabled else "",
            }


class ControlAccessConfig:
    def __init__(self, token_file: Optional[str] = None) -> None:
        self.token_file = token_file

    @property
    def enabled(self) -> bool:
        return bool(self.token_file)

    def read_token(self) -> Optional[str]:
        if not self.token_file:
            return None
        try:
            with open(os.path.expanduser(self.token_file), "r", encoding="utf-8") as f:
                token = f.read().strip()
        except OSError:
            return None
        if len(token) < 16:
            return None
        return token


class FirmwareUpdateConfig:
    def __init__(
        self,
        token_file: Optional[str],
        upload_dir: str,
        remoteocd_bin: str,
        remoteocd_cfg: str,
        max_bytes: int,
        timeout_sec: float,
        max_vdc: float,
    ) -> None:
        self.token_file = token_file
        self.upload_dir = upload_dir
        self.remoteocd_bin = remoteocd_bin
        self.remoteocd_cfg = remoteocd_cfg
        self.max_bytes = max_bytes
        self.timeout_sec = timeout_sec
        self.max_vdc = max_vdc

    @property
    def enabled(self) -> bool:
        return bool(self.token_file)

    def read_token(self) -> Optional[str]:
        if not self.token_file:
            return None
        try:
            with open(os.path.expanduser(self.token_file), "r", encoding="utf-8") as f:
                token = f.read().strip()
        except OSError:
            return None
        if len(token) < 16:
            return None
        return token


class RouterClient:
    def __init__(self, endpoint: str) -> None:
        if msgpack is None:
            raise RuntimeError("msgpack not available")
        self._endpoint = endpoint
        self._sock: Optional[socket.socket] = None
        self._unpacker: Optional[msgpack.Unpacker] = None
        self._packer = msgpack.Packer(use_bin_type=False)
        self._msgid = 1
        self._lock = threading.Lock()

    def close(self) -> None:
        if self._sock is not None:
            try:
                self._sock.close()
            except Exception:
                pass
        self._sock = None
        self._unpacker = None

    def _connect(self) -> None:
        if self._sock is not None:
            return
        endpoint = self._endpoint
        if endpoint.startswith("unix:"):
            path = endpoint[5:]
            sock = socket.socket(socket.AF_UNIX, socket.SOCK_STREAM)
            sock.connect(path)
        elif "/" in endpoint or endpoint.startswith("."):
            sock = socket.socket(socket.AF_UNIX, socket.SOCK_STREAM)
            sock.connect(endpoint)
        else:
            host, port = self._parse_tcp(endpoint)
            sock = socket.create_connection((host, port), timeout=1.0)
        sock.settimeout(0.2)
        self._sock = sock
        self._unpacker = msgpack.Unpacker(raw=False)

    @staticmethod
    def _parse_tcp(endpoint: str) -> tuple[str, int]:
        if ":" in endpoint:
            host, port_str = endpoint.rsplit(":", 1)
        else:
            host, port_str = endpoint, "7501"
        host = host or "127.0.0.1"
        try:
            port = int(port_str)
        except ValueError:
            port = 7501
        return host, port

    def call(self, method: str, params: list, timeout: float = 1.5, retries: int = 1) -> Optional[list]:
        for attempt in range(retries + 1):
            with self._lock:
                try:
                    self._connect()
                    if self._sock is None or self._unpacker is None:
                        raise RuntimeError("no socket")
                    msgid = self._msgid
                    self._msgid += 1
                    self._sock.sendall(self._packer.pack([0, msgid, method, params]))
                    deadline = _now_ts() + timeout
                    while _now_ts() < deadline:
                        try:
                            data = self._sock.recv(4096)
                        except socket.timeout:
                            continue
                        if not data:
                            raise RuntimeError("router closed")
                        self._unpacker.feed(data)
                        for obj in self._unpacker:
                            if isinstance(obj, list) and len(obj) >= 4 and obj[0] == 1 and obj[1] == msgid:
                                return obj
                    raise RuntimeError("router timeout")
                except Exception:
                    self.close()
            if attempt < retries:
                time.sleep(0.05)
        return None


class SerialClient:
    def __init__(self, device: str, baud: int = 115200) -> None:
        if msgpack is None:
            raise RuntimeError("msgpack not available")
        self._device = device
        self._baud = baud
        self._fd: Optional[int] = None
        self._unpacker: Optional[msgpack.Unpacker] = None
        self._packer = msgpack.Packer(use_bin_type=False)
        self._msgid = 1
        self._lock = threading.Lock()

    def close(self) -> None:
        if self._fd is not None:
            try:
                os.close(self._fd)
            except Exception:
                pass
        self._fd = None
        self._unpacker = None

    def _connect(self) -> None:
        if termios is None:
            raise RuntimeError("termios not available on this platform")
        if self._fd is not None:
            return
        fd = os.open(self._device, os.O_RDWR | os.O_NOCTTY | os.O_NONBLOCK)
        attrs = termios.tcgetattr(fd)
        attrs[0] = 0  # iflag
        attrs[1] = 0  # oflag
        attrs[3] = 0  # lflag
        attrs[2] = termios.CS8 | termios.CREAD | termios.CLOCAL
        baud_const = termios_baud_constant(self._baud)
        attrs[4] = baud_const
        attrs[5] = baud_const
        attrs[6][termios.VMIN] = 0
        attrs[6][termios.VTIME] = 0
        termios.tcsetattr(fd, termios.TCSANOW, attrs)
        self._fd = fd
        self._unpacker = msgpack.Unpacker(raw=False)

    def call(self, method: str, params: list, timeout: float = 1.5, retries: int = 1) -> Optional[list]:
        for attempt in range(retries + 1):
            with self._lock:
                try:
                    self._connect()
                    if self._fd is None or self._unpacker is None:
                        raise RuntimeError("serial not open")
                    msgid = self._msgid
                    self._msgid += 1
                    os.write(self._fd, self._packer.pack([0, msgid, method, params]))
                    deadline = _now_ts() + timeout
                    while _now_ts() < deadline:
                        r, _, _ = select.select([self._fd], [], [], 0.05)
                        if not r:
                            continue
                        data = os.read(self._fd, 4096)
                        if not data:
                            raise RuntimeError("serial closed")
                        self._unpacker.feed(data)
                        for obj in self._unpacker:
                            if isinstance(obj, list) and len(obj) >= 4 and obj[0] == 1 and obj[1] == msgid:
                                return obj
                    raise RuntimeError("serial timeout")
                except Exception:
                    self.close()
            if attempt < retries:
                time.sleep(0.05)
        return None


class TextSerialClient:
    def __init__(self, device: str, baud: int = 115200) -> None:
        self._device = device
        self._baud = baud
        self._fd: Optional[int] = None
        self._lock = threading.Lock()
        self._rx_buf = bytearray()

    def close(self) -> None:
        if self._fd is not None:
            try:
                os.close(self._fd)
            except Exception:
                pass
        self._fd = None
        self._rx_buf.clear()

    def _connect(self) -> None:
        if termios is None:
            raise RuntimeError("termios not available on this platform")
        if self._fd is not None:
            return
        fd = os.open(self._device, os.O_RDWR | os.O_NOCTTY | os.O_NONBLOCK)
        attrs = termios.tcgetattr(fd)
        attrs[0] = 0
        attrs[1] = 0
        attrs[3] = 0
        attrs[2] = termios.CS8 | termios.CREAD | termios.CLOCAL
        baud_const = termios_baud_constant(self._baud)
        attrs[4] = baud_const
        attrs[5] = baud_const
        attrs[6][termios.VMIN] = 0
        attrs[6][termios.VTIME] = 0
        termios.tcsetattr(fd, termios.TCSANOW, attrs)
        self._fd = fd

    def _read_lines(self, deadline: float) -> list[str]:
        lines: list[str] = []
        while _now_ts() < deadline:
            if self._fd is None:
                break
            r, _, _ = select.select([self._fd], [], [], 0.05)
            if not r:
                continue
            data = os.read(self._fd, 4096)
            if not data:
                raise RuntimeError("serial closed")
            self._rx_buf.extend(data)
            while True:
                nl = self._rx_buf.find(b"\n")
                if nl == -1:
                    break
                line = self._rx_buf[:nl].decode("utf-8", errors="ignore").strip()
                del self._rx_buf[: nl + 1]
                if line:
                    lines.append(line)
        return lines

    def _write_line(self, text: str) -> None:
        if self._fd is None:
            raise RuntimeError("serial not open")
        if not text.endswith("\n"):
            text += "\n"
        os.write(self._fd, text.encode("utf-8"))

    def cmd(self, cmd: str, timeout: float = 0.5, retries: int = 1) -> bool:
        for attempt in range(retries + 1):
            with self._lock:
                try:
                    self._connect()
                    self._write_line(cmd)
                    for line in self._read_lines(_now_ts() + timeout):
                        if line == "OK" or line.startswith("OK "):
                            return True
                        if line.startswith("ERR") or line.startswith("ERROR"):
                            return False
                    raise RuntimeError("serial command not acknowledged")
                except Exception:
                    self.close()
            if attempt < retries:
                time.sleep(0.05)
        return False

    def get(self, timeout: float = 1.0, retries: int = 1) -> Optional[str]:
        for attempt in range(retries + 1):
            with self._lock:
                try:
                    self._connect()
                    self._write_line("GET")
                    deadline = _now_ts() + timeout
                    while _now_ts() < deadline:
                        lines = self._read_lines(deadline)
                        for line in lines:
                            if line.startswith("DATA"):
                                return line
                    raise RuntimeError("serial timeout")
                except Exception:
                    self.close()
            if attempt < retries:
                time.sleep(0.05)
        return None


class RpcBridge:
    def __init__(self, endpoint: str, serial_baud: int = 115200) -> None:
        self._router: Optional[RouterClient] = None
        self._serial: Optional[SerialClient] = None
        self._serial_text: Optional[TextSerialClient] = None
        if endpoint.startswith("serial:"):
            self._serial_text = TextSerialClient(endpoint.replace("serial:", "", 1), baud=serial_baud)
        elif endpoint.startswith("/dev/"):
            self._serial_text = TextSerialClient(endpoint, baud=serial_baud)
        else:
            try:
                self._router = RouterClient(endpoint)
            except RuntimeError:
                self._router = None
            self._serial_text = TextSerialClient("/dev/ttyHS1", baud=serial_baud)

    def _call(self, method: str, params: list, timeout: float = 1.5, retries: int = 1) -> Optional[list]:
        if self._router is not None:
            resp = self._router.call(method, params, timeout=timeout, retries=retries)
            if resp is not None:
                return resp
        return None

    def cmd(self, cmd: str) -> Tuple[bool, Optional[str]]:
        resp = self._call("cmd", [cmd], timeout=0.8, retries=2)
        if resp and len(resp) >= 4:
            err = resp[2]
            if err is not None:
                return False, str(err)
            if resp[3] is False:
                return False, "rejected"
            return True, None
        if self._serial_text is not None:
            ok = self._serial_text.cmd(cmd, timeout=0.8, retries=2)
            return (ok, None if ok else "no response")
        return False, "no response"

    def get(self) -> Tuple[bool, Optional[dict], Optional[str]]:
        resp = self._call("get", [], timeout=2.0, retries=2)
        if resp and len(resp) >= 4:
            err = resp[2]
            if err is not None:
                return False, None, str(err)
            result = resp[3]
            if isinstance(result, str):
                parsed = self._parse_status_string(result)
                if parsed is None:
                    return False, None, "bad result"
                return True, parsed, None
            if not isinstance(result, list) or len(result) < 9:
                return False, None, "bad result"
            state_code = int(result[0])
            mode_code = int(result[1])
            mc_mode = int(result[29]) if len(result) >= 31 else 0
            diag_mode = int(result[45]) if len(result) >= 47 else None
            duty_mode = int(result[46]) if len(result) >= 47 else None
            mode_code_eff, mode_name_eff = effective_mode(mode_code, mc_mode, diag_mode, duty_mode)
            data = {
                "state_code": state_code,
                "state": STATE_NAMES.get(state_code, str(state_code)),
                "mode_code": mode_code_eff,
                "mode": mode_name_eff,
                "pwm": int(result[2]),
                "freq": float(result[3]),
                "speed": float(result[4]),
                "ia": float(result[5]),
                "ib": float(result[6]),
                "ic": float(result[7]),
                "vdc": float(result[8]),
                "ts": int(_now_ts() * 1000.0),
            }
            if len(result) >= 12:
                data["id"] = float(result[9])
                data["iq"] = float(result[10])
                data["i_rms"] = float(result[11])
            else:
                ia = data["ia"]
                ib = data["ib"]
                ic = data["ic"]
                data["i_rms"] = float(((ia * ia + ib * ib + ic * ic) / 3.0) ** 0.5)
            if len(result) >= 15:
                data["mic_active"] = int(result[12])
                data["id_ref"] = float(result[13])
                data["mic_saving_pct"] = float(result[14])
            else:
                data["mic_active"] = 0
                data["id_ref"] = 0.0
                data["mic_saving_pct"] = 0.0
            if len(result) >= 17:
                data["freq_cmd"] = float(result[15])
                data["estop"] = int(result[16])
            else:
                data["freq_cmd"] = data.get("freq", 0.0)
                data["estop"] = 0
            if len(result) >= 21:
                data["ntc"] = int(result[17])
                data["pfc"] = int(result[18])
                data["brake"] = int(result[19])
                data["brake_duty"] = float(result[20])
            else:
                data["ntc"] = 0
                data["pfc"] = 0
                data["brake"] = 0
                data["brake_duty"] = 0.0

            # Optional extended telemetry (keep in sync with UNOQ_MOTOR/UNOQ_MOTOR.ino rpc_send_response_get()).
            if len(result) >= 24:
                data["enc_raw"] = int(result[21])
                data["enc_ok"] = int(result[22])
                data["enc_deg"] = float(result[23])
            else:
                data["enc_raw"] = 0
                data["enc_ok"] = 0
                data["enc_deg"] = 0.0

            if len(result) >= 27:
                data["bp_good"] = int(result[24])
                data["bp_bad"] = int(result[25])
                data["bp_age_ms"] = int(result[26])
            else:
                data["bp_good"] = 0
                data["bp_bad"] = 999999
                data["bp_age_ms"] = 999999

            if len(result) >= 31:
                data["bp_status"] = int(result[27])
                data["bp_pwm_active"] = 1 if (data["bp_status"] & 0x20) else 0
                data["bp_fault"] = int(result[28])
                data["bp_mode"] = mc_mode
                data["bp_seq"] = int(result[30])
            else:
                data["bp_status"] = 0
                data["bp_pwm_active"] = 0
                data["bp_fault"] = 255
                data["bp_mode"] = 0
                data["bp_seq"] = 0

            if len(result) >= 33:
                data["bp_ping_pairs"] = int(result[31])
                data["bp_ping_age_ms"] = int(result[32])
            else:
                data["bp_ping_pairs"] = 0
                data["bp_ping_age_ms"] = 999999

            if len(result) >= 34:
                data["bp_rsp_age_ms"] = int(result[33])
            else:
                data["bp_rsp_age_ms"] = 999999

            # Optional extended encoder telemetry (append-only after bp_rsp_age_ms).
            if len(result) >= 37:
                data["enc_rpm"] = float(result[34])
                data["enc_mech_hz"] = float(result[35])
                data["enc_elec_hz"] = float(result[36])
            else:
                data["enc_rpm"] = 0.0
                data["enc_mech_hz"] = 0.0
                data["enc_elec_hz"] = 0.0
            if len(result) >= 45:
                data["mic_gated"] = int(result[37])
                data["mic_enable_ai"] = int(result[38])
                data["mic_enc_used"] = int(result[39])
                data["mic_freq_meas_hz"] = float(result[40])
                data["mic_speed_err_hz"] = float(result[41])
                data["mic_speed_tol_hz"] = float(result[42])
                data["mic_link_flags"] = int(result[43])
                data["mic_status_flags"] = int(result[44])
            else:
                data["mic_gated"] = 0
                data["mic_enable_ai"] = 0
                data["mic_enc_used"] = 0
                data["mic_freq_meas_hz"] = 0.0
                data["mic_speed_err_hz"] = 0.0
                data["mic_speed_tol_hz"] = 0.0
                data["mic_link_flags"] = 0
                data["mic_status_flags"] = 0
            if len(result) >= 47:
                data["diag_mode"] = int(result[45])
                data["duty_mode"] = int(result[46])
            else:
                data["diag_mode"] = 1 if mode_code_eff == 3 else 0
                data["duty_mode"] = 1 if mode_code_eff == 4 else 0
            if len(result) >= 50:
                data["bp_vbus_raw"] = int(result[47])
                data["bp_vdc"] = float(result[48])
                data["bp_vbus_age_ms"] = int(result[49])
                data["vdc"] = data["bp_vdc"]
            else:
                data["bp_vbus_raw"] = 0
                data["bp_vdc"] = 0.0
                data["bp_vbus_age_ms"] = 999999
            if len(result) >= 54:
                temp_flags = int(result[53])
                data["bp_temp_raw"] = int(result[50])
                data["bp_temp_v"] = float(result[51])
                data["bp_temp_c"] = float(result[52])
                data["bp_temp_flags"] = temp_flags
                data["bp_temp_valid"] = 1 if (temp_flags & 0x01) else 0
                data["bp_temp_fault"] = 1 if (temp_flags & 0x02) else 0
                data["bp_temp_age_ms"] = data.get("bp_rsp_age_ms", 999999)
            else:
                data["bp_temp_raw"] = 0
                data["bp_temp_v"] = 0.0
                data["bp_temp_c"] = 0.0
                data["bp_temp_flags"] = 0
                data["bp_temp_valid"] = 0
                data["bp_temp_fault"] = 0
                data["bp_temp_age_ms"] = 999999
            if len(result) >= 62:
                phase_flags = int(result[60])
                data["bp_phase_a_raw"] = int(result[54])
                data["bp_phase_b_raw"] = int(result[55])
                data["bp_phase_c_raw"] = int(result[56])
                data["bp_phase_a_v"] = float(result[57])
                data["bp_phase_b_v"] = float(result[58])
                data["bp_phase_c_v"] = float(result[59])
                data["bp_phase_flags"] = phase_flags
                data["bp_phase_valid"] = 1 if (phase_flags & 0x01) else 0
                data["bp_phase_c_virtual"] = 1 if (phase_flags & 0x02) else 0
                data["bp_phase_age_ms"] = int(result[61])
            else:
                data["bp_phase_a_raw"] = 0
                data["bp_phase_b_raw"] = 0
                data["bp_phase_c_raw"] = 0
                data["bp_phase_a_v"] = 0.0
                data["bp_phase_b_v"] = 0.0
                data["bp_phase_c_v"] = 0.0
                data["bp_phase_flags"] = 0
                data["bp_phase_valid"] = 0
                data["bp_phase_c_virtual"] = 0
                data["bp_phase_age_ms"] = 999999
            if len(result) >= 63:
                data["bp_ext"] = int(result[62])
            else:
                data["bp_ext"] = 0
            if len(result) >= 64:
                data["iotest"] = int(result[63])
            else:
                data["iotest"] = 0
            if len(result) >= 65:
                data["precharge"] = int(result[64])
            else:
                data["precharge"] = 0
            if len(result) >= 68:
                data["fan_duty"] = float(result[65])
                data["bp_fan_duty"] = float(result[66])
                data["bp_fan_rpm"] = float(result[67])
            else:
                data["fan_duty"] = 0.0
                data["bp_fan_duty"] = 0.0
                data["bp_fan_rpm"] = 0.0
            if len(result) >= 70:
                data["bp_foc_backend"] = int(result[68])
                data["bp_cmd_mode"] = int(result[69])
            else:
                data["bp_foc_backend"] = 0
                data["bp_cmd_mode"] = data.get("bp_mode", 0)
            data["fw_build"] = int(result[70]) if len(result) >= 71 else 0
            data["matrix_test"] = int(result[71]) if len(result) >= 72 else 0
            data["bp_mcsdk_telemetry"] = int(result[72]) if len(result) >= 73 else 0
            data["bp_vbus_valid"] = int(result[73]) if len(result) >= 74 else 0
            data["bp_precharge_managed"] = int(result[74]) if len(result) >= 75 else 0
            data["rpc_schema_version"] = int(result[75]) if len(result) >= 76 else 1
            if data["rpc_schema_version"] >= 2 and len(result) >= 78:
                data["bp_softstart_ready"] = int(result[76])
                data["mc_capabilities"] = int(result[77])
            else:
                # Fail closed for the ambiguous 75-element transition format.
                data["bp_softstart_ready"] = 0
                data["mc_capabilities"] = 0
            data["mc_fw_build"] = (
                int(result[78])
                if data["rpc_schema_version"] >= 3 and len(result) >= 79
                else 0
            )
            data["mc_supported_modes"] = supported_modes_from_caps(data["mc_capabilities"])
            for index, field in enumerate(("mc_diag_valid", "mc_fault_reason", "mc_uart_error_flags",
                                           "mc_fault_motor_state", "mc_fault_current_mask",
                                           "mc_fault_occurred_mask", "mc_fault_sequence", "mc_fault_tx_status"), 79):
                data[field] = int(result[index]) if len(result) >= 87 else 0
            for index, field in enumerate(("mc_last_bad_valid", "mc_last_bad_reason",
                                           "mc_last_uart_error_flags", "mc_last_tx_status"), 87):
                data[field] = int(result[index]) if len(result) >= 91 else 0
            return True, with_motor_controller_aliases(data), None
        if self._serial_text is not None:
            line = self._serial_text.get(timeout=1.2, retries=2)
            if not line:
                return False, None, "no response"
            parsed = self._parse_status_string(line)
            if parsed is None:
                return False, None, "bad result"
            return True, parsed, None
        return False, None, "no response"

    @staticmethod
    def _parse_status_string(text: str) -> Optional[dict]:
        # Expected format: DATA freq=.. speed=.. ia=.. ib=.. ic=.. vdc=.. state=.. mode=.. pwm=..
        try:
            parts = text.replace("DATA", "").strip().split()
            kv = {}
            for part in parts:
                if "=" not in part:
                    continue
                k, v = part.split("=", 1)
                kv[k.strip()] = v.strip()
            state_s = kv.get("state", "")
            mode_s = kv.get("mode", "")
            state_code = STATE_CODES.get(state_s, -1)
            mode_code = MODE_CODES.get(mode_s, -1)
            diag_mode = int(float(kv.get("diag", "0")))
            duty_mode = int(float(kv.get("duty", "0")))
            mode_code_eff, mode_name_eff = effective_mode(mode_code, int(float(kv.get("bp_mode", "0"))), diag_mode, duty_mode)
            capabilities = int(float(kv.get("mc_caps", "0")))
            return with_motor_controller_aliases({
                "state_code": int(state_code),
                "state": state_s or str(state_code),
                "mode_code": int(mode_code_eff),
                "mode": mode_name_eff,
                "pwm": int(float(kv.get("pwm", "0"))),
                "freq": float(kv.get("freq", "0")),
                "speed": float(kv.get("speed", "0")),
                "ia": float(kv.get("ia", "0")),
                "ib": float(kv.get("ib", "0")),
                "ic": float(kv.get("ic", "0")),
                "vdc": float(kv.get("vdc", "0")),
                "id": float(kv.get("id", "0")),
                "iq": float(kv.get("iq", "0")),
                "i_rms": float(kv.get("irm", "0")),
                "mic_active": int(float(kv.get("mic", "0"))),
                "id_ref": float(kv.get("idref", "0")),
                "mic_saving_pct": float(kv.get("save", "0")),
                "freq_cmd": float(kv.get("freqcmd", kv.get("freq", "0"))),
                "estop": int(float(kv.get("estop", "0"))),
                "iotest": int(float(kv.get("iotest", "0"))),
                "ntc": int(float(kv.get("ntc", "0"))),
                "pfc": int(float(kv.get("pfc", "0"))),
                "precharge": int(float(kv.get("precharge", "0"))),
                "brake": int(float(kv.get("brake", "0"))),
                "brake_duty": float(kv.get("brake_duty", "0")),
                "fan_duty": float(kv.get("fan_duty", "0")),
                "bp_fan_duty": float(kv.get("bp_fan_duty", "0")),
                "bp_fan_rpm": float(kv.get("bp_fan_rpm", "0")),
                "enc_raw": int(float(kv.get("enc_raw", "0"))),
                "enc_ok": int(float(kv.get("enc_ok", "0"))),
                "enc_source": kv.get("enc_source", "motor_controller_uart"),
                "enc_bus_ok": int(float(kv.get("enc_bus_ok", "0"))),
                "enc_status": int(float(kv.get("enc_status", "0"))),
                "enc_speed_ok": int(float(kv.get("enc_speed_ok", "0"))),
                "enc_reads": int(float(kv.get("enc_reads", "0"))),
                "enc_errors": int(float(kv.get("enc_errors", "0"))),
                "enc_io_error": int(float(kv.get("enc_io_error", "0"))),
                "enc_init_error": int(float(kv.get("enc_init_error", "0"))),
                "enc_scl": int(float(kv.get("enc_scl", "-1"))),
                "enc_sda": int(float(kv.get("enc_sda", "-1"))),
                "enc_age_ms": int(float(kv.get("enc_age_ms", "999999"))),
                "enc_deg": float(kv.get("enc_deg", "0")),
                "enc_rpm": float(kv.get("enc_rpm", "0")),
                "enc_mech_hz": float(kv.get("enc_mech_hz", "0")),
                "enc_elec_hz": float(kv.get("enc_elec_hz", "0")),
                "mic_gated": int(float(kv.get("mic_gated", "0"))),
                "mic_enable_ai": int(float(kv.get("mic_enable_ai", "0"))),
                "mic_enc_used": int(float(kv.get("mic_enc_used", "0"))),
                "mic_freq_meas_hz": float(kv.get("mic_fmeas", "0")),
                "mic_speed_err_hz": float(kv.get("mic_ferr", "0")),
                "mic_speed_tol_hz": float(kv.get("mic_ftol", "0")),
                "mic_link_flags": int(float(kv.get("mic_lflags", "0"))),
                "mic_status_flags": int(float(kv.get("mic_sflags", "0"))),
                "diag_mode": diag_mode,
                "duty_mode": duty_mode,
                "bp_good": int(float(kv.get("bp_good", "0"))),
                "bp_bad": int(float(kv.get("bp_bad", "999999"))),
                "bp_bad_integrity": int(float(kv["bp_bad_integrity"])) if "bp_bad_integrity" in kv else None,
                "bp_bad_sequence": int(float(kv["bp_bad_sequence"])) if "bp_bad_sequence" in kv else None,
                "bp_superseded": int(float(kv["bp_superseded"])) if "bp_superseded" in kv else None,
                "bp_clear_pending": int(float(kv["bp_clear_pending"])) if "bp_clear_pending" in kv else None,
                "bp_age_ms": int(float(kv.get("bp_age_ms", "999999"))),
                "bp_status": int(float(kv.get("bp_status", "0"))),
                "bp_fault": int(float(kv.get("bp_fault", "255"))),
                "mc_diag_valid": int(float(kv.get("mc_diag_valid", "0"))),
                "mc_fault_reason": int(float(kv.get("mc_fault_reason", "0"))),
                "mc_uart_error_flags": int(float(kv.get("mc_uart_error_flags", "0"))),
                "mc_fault_motor_state": int(float(kv.get("mc_fault_motor_state", "0"))),
                "mc_fault_current_mask": int(float(kv.get("mc_fault_current_mask", "0"))),
                "mc_fault_occurred_mask": int(float(kv.get("mc_fault_occurred_mask", "0"))),
                "mc_fault_sequence": int(float(kv.get("mc_fault_sequence", "0"))),
                "mc_fault_tx_status": int(float(kv.get("mc_fault_tx_status", "0"))),
                "mc_last_bad_valid": int(float(kv.get("mc_last_bad_valid", "0"))),
                "mc_last_bad_reason": int(float(kv.get("mc_last_bad_reason", "0"))),
                "mc_last_uart_error_flags": int(float(kv.get("mc_last_uart_error_flags", "0"))),
                "mc_last_tx_status": int(float(kv.get("mc_last_tx_status", "0"))),
                "bp_mode": int(float(kv.get("bp_mode", "0"))),
                "bp_cmd_mode": int(float(kv.get("bp_cmd_mode", kv.get("bp_mode", "0")))),
                "bp_foc_backend": int(float(kv.get("bp_foc_backend", "0"))),
                "fw_build": int(float(kv.get("fw_build", "0"))),
                "mc_fw_build": int(float(kv.get("bp_fw_build", "0"))),
                "matrix_test": int(float(kv.get("matrix_test", "0"))),
                "bp_seq": int(float(kv.get("bp_seq", "0"))),
                "bp_good_cnt": int(float(kv.get("bp_good_cnt", kv.get("bp_good", "0")))),
                "bp_bad_cnt": int(float(kv.get("bp_bad_cnt", kv.get("bp_bad", "999999")))),
                "bp_ext": int(float(kv.get("bp_ext", "0"))),
                "bp_brake_duty": float(kv.get("bp_brake_duty", "0")),
                "bp_vbus_raw": int(float(kv.get("bp_vbus_raw", "0"))),
                "bp_vdc": float(kv.get("bp_vdc", kv.get("vdc", "0"))),
                "bp_vbus_age_ms": int(float(kv.get("bp_vbus_age_ms", "999999"))),
                "bp_mcsdk_telemetry": int(float(kv.get("bp_mcsdk_telemetry", "0"))),
                "bp_vbus_valid": int(float(kv.get("bp_vbus_valid", "0"))),
                "bp_softstart_ready": int(float(kv.get("bp_softstart_ready", "0"))),
                "bp_precharge_managed": 0,
                "rpc_schema_version": int(float(kv.get("rpc_schema", "1"))),
                "mc_capabilities": capabilities,
                "mc_supported_modes": supported_modes_from_caps(capabilities),
                "bp_temp_raw": int(float(kv.get("bp_temp_raw", "0"))),
                "bp_temp_v": float(kv.get("bp_temp_v", "0")),
                "bp_temp_c": float(kv.get("bp_temp_c", "0")),
                "bp_temp_flags": int(float(kv.get("bp_temp_flags", "0"))),
                "bp_temp_valid": int(float(kv.get("bp_temp_valid", "0"))),
                "bp_temp_fault": int(float(kv.get("bp_temp_fault", "0"))),
                "bp_temp_age_ms": int(float(kv.get("bp_temp_age_ms", "999999"))),
                "bp_phase_a_raw": int(float(kv.get("bp_phase_a_raw", "0"))),
                "bp_phase_b_raw": int(float(kv.get("bp_phase_b_raw", "0"))),
                "bp_phase_c_raw": int(float(kv.get("bp_phase_c_raw", "0"))),
                "bp_phase_a_v": float(kv.get("bp_phase_a_v", "0")),
                "bp_phase_b_v": float(kv.get("bp_phase_b_v", "0")),
                "bp_phase_c_v": float(kv.get("bp_phase_c_v", "0")),
                "bp_phase_flags": int(float(kv.get("bp_phase_flags", "0"))),
                "bp_phase_valid": int(float(kv.get("bp_phase_valid", "0"))),
                "bp_phase_c_virtual": int(float(kv.get("bp_phase_c_virtual", "0"))),
                "bp_phase_age_ms": int(float(kv.get("bp_phase_age_ms", "999999"))),
                "bp_rsp_age_ms": int(float(kv.get("bp_rsp_age_ms", "999999"))),
                "bp_ping_pairs": int(float(kv.get("bp_ping_pairs", "0"))),
                "bp_ping_age_ms": int(float(kv.get("bp_ping_age_ms", "999999"))),
                "ts": int(_now_ts() * 1000.0),
            })
        except Exception:
            return None


class AppState:
    def __init__(
        self,
        rpc: RpcBridge,
        logs: LogStore,
        status_log_interval: float,
        firmware_update: Optional[FirmwareUpdateConfig] = None,
        command_guard: Optional[CommandGuardConfig] = None,
        hv_arm: Optional[HvArmState] = None,
        start_runlimit_sec: float = DEFAULT_START_RUNLIMIT_SEC,
        arm_profiles: Optional[dict[str, HvArmConfig]] = None,
        profile_runlimits: Optional[dict[str, float]] = None,
        guard_max_vdc: float = DEFAULT_CMD_GUARD_MAX_VDC,
        control_access: Optional[ControlAccessConfig] = None,
        operator_heartbeat_timeout_sec: float = DEFAULT_OPERATOR_HEARTBEAT_TIMEOUT_SEC,
        vbus_calibration: Optional[VbusCalibrationStore] = None,
    ) -> None:
        self.rpc = rpc
        self.logs = logs
        self.firmware_update = firmware_update
        self.command_guard = command_guard or CommandGuardConfig(DEFAULT_CMD_GUARD_MAX_VDC)
        self.hv_arm = hv_arm or HvArmState(HvArmConfig())
        self.start_runlimit_sec = max(0.1, float(start_runlimit_sec))
        self.arm_profiles = dict(arm_profiles or {})
        self.profile_runlimits = {
            str(name).lower(): max(0.1, float(limit))
            for name, limit in (profile_runlimits or {}).items()
        }
        self.guard_max_vdc = float(guard_max_vdc)
        self.control_access = control_access or ControlAccessConfig()
        self.vbus_calibration = vbus_calibration or VbusCalibrationStore()
        self.hv_arm.set_calibration_provider(self.vbus_calibration.is_valid)
        self.operator_heartbeat_timeout_sec = max(1.0, float(operator_heartbeat_timeout_sec))
        self._operator_heartbeat_ts = 0.0
        self.control_lock = threading.Lock()
        self._status_log_interval = status_log_interval
        self._last_status_log = 0.0
        self._last_fault_diag_key = None
        self._lock = threading.Lock()
        self._watchdog_stop = threading.Event()
        self._watchdog_thread: Optional[threading.Thread] = None
        self._runtime_bad_monitor = HvRuntimeBadFrameMonitor()
        self._fault_recorder = MotorFaultRecorder()
        self._last_diag_idle_poll = 0.0

    def _precharge_off(self) -> tuple[bool, str]:
        return True, "external-autonomous-no-control"

    def mark_operator_heartbeat(self) -> None:
        with self._lock:
            self._operator_heartbeat_ts = time.monotonic()

    def operator_heartbeat_age(self) -> float:
        with self._lock:
            stamp = self._operator_heartbeat_ts
        if stamp <= 0.0:
            return math.inf
        return max(0.0, time.monotonic() - stamp)

    def operator_heartbeat_fresh(self) -> bool:
        return self.operator_heartbeat_age() <= self.operator_heartbeat_timeout_sec

    def stop_sequence(
        self,
        emergency: bool = False,
        confirm_timeout_sec: float = 0.75,
        poll_sec: float = 0.05,
    ) -> tuple[bool, str, Optional[dict]]:
        """Stop PWM and confirm that every motor-control output is off."""
        primary_cmd = "ESTOP" if emergency else "STOP"
        primary_ok, primary_err = self.rpc.cmd(primary_cmd)
        relay_ok, relay_err = self._precharge_off()
        self.hv_arm.disarm()
        self._runtime_bad_monitor.reset()

        deadline = time.monotonic() + max(0.0, float(confirm_timeout_sec))
        status_ok = False
        status: Optional[dict] = None
        status_err = "status unavailable"
        off_confirmed = False
        while True:
            status_ok, candidate, status_err = self.rpc.get()
            if status_ok and candidate is not None:
                status = candidate
                off_confirmed = bool(
                    _status_link_live(candidate)
                    and _as_int(candidate, "bp_status", 0) & 0x01
                    and _as_int(candidate, "pwm", 1) == 0
                    and (_as_int(candidate, "bp_status", 0x20) & 0x20) == 0
                    and _as_int(candidate, "precharge", 1) == 0
                    and (_as_int(candidate, "bp_ext", 0x08) & 0x08) == 0
                )
                if off_confirmed:
                    break
            if time.monotonic() >= deadline:
                break
            time.sleep(max(0.0, float(poll_sec)))
        ok = bool(primary_ok and relay_ok and off_confirmed)
        detail = (
            f"{primary_cmd}={primary_err or primary_ok}; "
            f"PRECHARGE_OFF={relay_err or relay_ok}; "
            f"outputs_off={int(off_confirmed)}"
        )
        if not status_ok:
            detail += f"; status={status_err or 'unavailable'}"
        self.logs.add(f"WIFI_STOP_SEQUENCE emergency={int(emergency)} ok={int(ok)} {detail}")
        return ok, detail, status

    def start_sequence(
        self,
        relay_timeout_sec: float = DEFAULT_RELAY_CONFIRM_TIMEOUT_SEC,
        relay_settle_sec: float = DEFAULT_RELAY_SETTLE_SEC,
        run_timeout_sec: float = DEFAULT_RUN_CONFIRM_TIMEOUT_SEC,
        poll_sec: float = 0.05,
    ) -> tuple[bool, str, Optional[dict]]:
        """Confirm safety, then wait for the autonomous AC soft-start and PWM."""
        st_ok, status, st_err = self.rpc.get()
        allowed, guard_err = command_guard_check(
            "START", status if st_ok else None, self.command_guard
        )
        if not allowed:
            detail = guard_err if st_ok else f"{guard_err}: {st_err or 'no status'}"
            self.logs.add(f"WIFI_START_REJECT guard {detail}")
            return False, detail, status

        if self.hv_arm.cfg.enabled:
            arm_ok, arm_err = self.hv_arm.command_allowed(status)
            if not arm_ok:
                self.logs.add(f"WIFI_START_REJECT arm {arm_err}")
                return False, arm_err, status

        if status is None:
            return False, "status unavailable", None
        if _as_int(status, "precharge", 0) != 0 or (_as_int(status, "bp_ext", 0) & 0x08) != 0:
            self.stop_sequence(emergency=False)
            return False, "reserved precharge bit was nonzero; outputs were forced off, retry START", status

        return self._start_without_precharge(status, run_timeout_sec, poll_sec)

    def _start_without_precharge(
        self,
        initial_status: dict,
        run_timeout_sec: float,
        poll_sec: float,
    ) -> tuple[bool, str, Optional[dict]]:
        mcsdk_backend = _as_int(initial_status, "bp_mcsdk_telemetry", 0) == 1
        self.logs.add(
            "WIFI_START_STEP SOFTSTART owner=external-autonomous "
            f"ready={_as_int(initial_status, 'bp_softstart_ready', 0)} "
            f"mcsdk={int(mcsdk_backend)}"
        )
        arm_ok, arm_err = self.hv_arm.command_allowed(initial_status)
        if self.hv_arm.cfg.enabled and not arm_ok:
            self.stop_sequence(emergency=False)
            self.logs.add(f"WIFI_START_FAIL arm_recheck {arm_err}")
            return False, arm_err, initial_status

        runlimit_cmd = f"SET RUNLIMIT {self.start_runlimit_sec:.3f}"
        limit_ok, limit_err = self.rpc.cmd(runlimit_cmd)
        if not limit_ok:
            self.stop_sequence(emergency=False)
            detail = f"run limit rejected: {limit_err or 'no acknowledgement'}"
            self.logs.add(f"WIFI_START_FAIL runlimit {detail}")
            return False, detail, initial_status

        start_ok, start_err = self.rpc.cmd("START")
        if not start_ok:
            self.stop_sequence(emergency=True)
            detail = f"START rejected: {start_err or 'no acknowledgement'}"
            self.logs.add(f"WIFI_START_FAIL start_cmd {detail}")
            return False, detail, initial_status

        run_deadline = time.monotonic() + max(0.0, float(run_timeout_sec))
        run_status: Optional[dict] = None
        last_run_error = "PWM did not start"
        while True:
            read_ok, candidate, read_err = self.rpc.get()
            if read_ok and candidate is not None:
                self.maybe_log_fault_diagnostics(candidate)
                run_status = candidate
                run_ok, run_err = output_sequence_health_check(
                    candidate,
                    self.hv_arm.cfg,
                    self.command_guard,
                    vbus_calibrated=self.vbus_calibration.is_valid(candidate),
                )
                reserved_relay_bit = bool(
                    _as_int(candidate, "precharge", 0) != 0
                    or (_as_int(candidate, "bp_ext", 0) & 0x08) != 0
                )
                softstart_ready = (
                    _as_int(candidate, "bp_softstart_ready", 0) == 1
                    if mcsdk_backend
                    else True
                )
                nucleo_pwm_ok = (
                    (_as_int(candidate, "bp_status", 0) & 0x20) != 0
                    if mcsdk_backend
                    else True
                )
                running = (
                    _as_int(candidate, "pwm", 0) == 1
                    and str(candidate.get("state", "")).upper()
                    in ("VF_RUN", "FOC_ALIGN", "FOC_RUN")
                    and not reserved_relay_bit
                    and softstart_ready
                    and nucleo_pwm_ok
                )
                if run_ok and running:
                    self.hv_arm.mark_started()
                    self.logs.add(
                        f"WIFI_START_OK state={candidate.get('state')} "
                        f"freq={_as_float(candidate, 'freq', 0.0):.2f} "
                        f"speed={_as_float(candidate, 'speed', 0.0):.1f} "
                        "softstart=external-ready"
                    )
                    return True, "PWM started; external soft-start bus is stable", candidate
                if not softstart_ready:
                    last_run_error = "external soft-start bus is not stable yet"
                else:
                    last_run_error = run_err if not run_ok else "PWM did not enter a running state"
            else:
                last_run_error = read_err or "status unavailable"
            if time.monotonic() >= run_deadline:
                self.stop_sequence(emergency=True)
                detail = f"START confirmation failed: {last_run_error}"
                self.logs.add(f"WIFI_START_FAIL run_feedback {detail}")
                return False, detail, run_status
            time.sleep(max(0.0, float(poll_sec)))

    def arm_snapshot(self, status: Optional[dict] = None) -> dict:
        snapshot = self.hv_arm.snapshot()
        available = [name for name in (ARM_PROFILE_HV, ARM_PROFILE_LV) if name in self.arm_profiles]
        snapshot["hmi_arm_profiles"] = available
        snapshot["hmi_start_runlimit_s"] = round(self.start_runlimit_sec, 1)
        snapshot["hmi_precharge_relay_present"] = 0
        snapshot["hmi_external_softstart_ready"] = int(
            status is not None and _as_int(status, "bp_softstart_ready", 0) == 1
        )
        calibration = self.vbus_calibration.snapshot(status)
        snapshot["hmi_vbus_hv_calibrated"] = int(calibration["valid"])
        snapshot["hmi_vbus_calibration_reason"] = calibration["reason"]
        snapshot["hmi_vbus_zero_captured"] = int(calibration["zero_captured"])
        snapshot["hmi_vbus_high_captured"] = int(calibration["high_captured"])
        snapshot["hmi_vbus_zero_meter_vdc"] = calibration["zero_meter_vdc"]
        snapshot["hmi_vbus_zero_mc_vdc"] = calibration["zero_mc_vdc"]
        snapshot["hmi_vbus_high_meter_vdc"] = calibration["high_meter_vdc"]
        snapshot["hmi_vbus_high_mc_vdc"] = calibration["high_mc_vdc"]
        current_cfg = self.hv_arm.cfg
        switch_ok, _ = arm_profile_switch_precheck(status, current_cfg) if status is not None else (False, "")
        snapshot["hmi_arm_profile_switch_ready"] = int(switch_ok and not snapshot["hmi_hv_armed"])
        heartbeat_age = self.operator_heartbeat_age()
        snapshot["hmi_operator_heartbeat_age_s"] = round(heartbeat_age, 2) if math.isfinite(heartbeat_age) else None
        snapshot["hmi_operator_heartbeat_ok"] = int(
            not self.control_access.enabled or heartbeat_age <= self.operator_heartbeat_timeout_sec
        )
        snapshot["hmi_operator_heartbeat_timeout_s"] = self.operator_heartbeat_timeout_sec
        return snapshot

    def switch_arm_profile(self, profile: str, status: Optional[dict]) -> tuple[bool, str]:
        target = str(profile).strip().lower()
        cfg = self.arm_profiles.get(target)
        if cfg is None:
            return False, f"unsupported arm profile: {profile}"
        ok, reason = arm_profile_switch_precheck(status, cfg)
        if not ok:
            return False, reason

        self.hv_arm.set_config(cfg)
        if target == ARM_PROFILE_LV:
            self.command_guard.max_vdc = min(self.guard_max_vdc, cfg.max_vdc)
            self.command_guard.allow_hv = False
        else:
            self.command_guard.max_vdc = self.guard_max_vdc
            self.command_guard.allow_hv = True
        self.start_runlimit_sec = self.profile_runlimits.get(target, DEFAULT_START_RUNLIMIT_SEC)
        self._runtime_bad_monitor.reset()
        return True, "profile selected"

    def start_safety_watchdog(self) -> None:
        if self._watchdog_thread is not None and self._watchdog_thread.is_alive():
            return
        self._watchdog_stop.clear()
        self._watchdog_thread = threading.Thread(target=self._safety_watchdog_loop, daemon=True)
        self._watchdog_thread.start()

    def stop_safety_watchdog(self) -> None:
        self._watchdog_stop.set()
        if self._watchdog_thread is not None:
            self._watchdog_thread.join(timeout=1.0)

    def _safety_watchdog_loop(self) -> None:
        while not self._watchdog_stop.wait(0.2):
            reason = ""
            if self.hv_arm.take_expired_session_action():
                reason = "HV_ARM_EXPIRED"
            elif self.hv_arm.runtime_monitor_required():
                if self.control_access.enabled and not self.operator_heartbeat_fresh():
                    reason = f"OPERATOR_HEARTBEAT_LOST age={self.operator_heartbeat_age():.2f}s"
                    self.hv_arm.disarm()
                else:
                    status_ok, status, status_err = self.rpc.get()
                    if status_ok and status is not None:
                        self.maybe_log_fault_diagnostics(status)
                    live_ok, live_err = hv_runtime_check(
                        status if status_ok else None,
                        self.hv_arm.cfg,
                        allow_nonzero_bad=True,
                        vbus_calibrated=self.vbus_calibration.is_valid(status if status_ok else None),
                    )
                    if live_ok and status is not None:
                        live_ok, bad_err = self._runtime_bad_monitor.observe(status)
                        if live_ok and bad_err != "ok":
                            self.logs.add(f"HV_RUNTIME_UART_WARN {bad_err}")
                        elif not live_ok:
                            live_err = bad_err
                    if not live_ok:
                        reason = f"HV_RUNTIME_REJECT {status_err or live_err}"
                        self.hv_arm.disarm()
            else:
                self._runtime_bad_monitor.reset()
                # Keep a small idle prehistory even when no browser is open.
                # Armed operation already polls above; do not add a second poll.
                now = time.monotonic()
                if now - self._last_diag_idle_poll >= 1.0:
                    self._last_diag_idle_poll = now
                    status_ok, status, _ = self.rpc.get()
                    if status_ok and status is not None:
                        self.maybe_log_fault_diagnostics(status)
            if not reason:
                continue
            stop_ok, stop_err = self.rpc.cmd("STOP")
            estop_ok, estop_err = self.rpc.cmd("ESTOP")
            relay_ok, relay_err = self._precharge_off()
            self.logs.add(
                f"{reason} "
                f"stop_ok={int(stop_ok)} stop_err={stop_err or '-'} "
                f"estop_ok={int(estop_ok)} estop_err={estop_err or '-'} "
                f"relay_ok={int(relay_ok)} relay_err={relay_err or '-'}"
            )

    def maybe_log_fault_diagnostics(self, data: dict) -> None:
        for line in self._fault_recorder.observe(data):
            self.logs.add(line)
        data.update(self._fault_recorder.snapshot())
        reason = _as_int(data, "mc_fault_reason", 0)
        active = _as_int(data, "bp_fault", 0)
        key = None
        if reason or active:
            key = tuple(data.get(k) for k in ("mc_fw_build", "mc_diag_valid", "mc_fault_reason",
                                             "mc_uart_error_flags", "mc_fault_current_mask",
                                             "mc_fault_occurred_mask", "mc_fault_motor_state",
                                             "mc_fault_sequence", "mc_fault_tx_status", "mc_bad_cnt",
                                             "mc_last_bad_reason", "mc_last_uart_error_flags", "mc_last_tx_status"))
            if _as_int(data, "mc_diag_valid", 0) != 1:
                key += (active,)
        with self._lock:
            if key == self._last_fault_diag_key:
                return
            self._last_fault_diag_key = key
        if key is not None:
            self.logs.add(f"MC_FAULT_DIAG code={active} bad={_as_int(data, 'bp_bad_cnt', 0)} "
                          + motor_fault_detail(data))

    def maybe_log_status(self, data: dict) -> None:
        self.maybe_log_fault_diagnostics(data)
        now = _now_ts()
        with self._lock:
            if (now - self._last_status_log) < self._status_log_interval:
                return
            self._last_status_log = now
        line = (
            f"STAT state={data.get('state')} mode={data.get('mode')} pwm={data.get('pwm')} "
            f"freq={data.get('freq'):.2f} speed={data.get('speed'):.1f} vdc={data.get('vdc'):.2f} "
            f"bp_temp_c={data.get('bp_temp_c', 0.0):.1f} bp_temp_fault={data.get('bp_temp_fault', 0)} "
            f"bp_phase_c_v={data.get('bp_phase_c_v', 0.0):.3f} bp_phase_c_virtual={data.get('bp_phase_c_virtual', 0)} "
            f"fan_duty={data.get('fan_duty', 0.0):.2f} bp_fan_rpm={data.get('bp_fan_rpm', 0.0):.0f} "
            f"bp_cmd_mode={data.get('bp_cmd_mode', 0)} bp_foc_backend={data.get('bp_foc_backend', 0)}"
            f" mc_diag_valid={data.get('mc_diag_valid', 0)} mc_fault_reason={data.get('mc_fault_reason', 0)}"
        )
        self.logs.add(line)
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
