11lisov11/mic_practice/bluepill_uart_pwm_pio/include/encoder_as5600.h

#pragma once

#include <stdbool.h>
#include <stdint.h>

bool encoder_as5600_init(void);
void encoder_as5600_poll(void);
bool encoder_as5600_get_cached_raw(uint16_t *raw);
bool encoder_as5600_get_raw(uint16_t *raw);
bool encoder_as5600_get_theta(float *theta_rad);
