11lisov11/mic_practice/(commit log)

2026-03-23 Stabilize UNOQ motor stack and expose MIC diagnostics
    [UNOQ_MOTOR.ino, config.h, encoder_as5600.cpp, encoder_as5600.h, id_ref_lut_motor1.h, main.cpp, pwm_tim1.cpp, safety.cpp]
2026-05-03 Finalize HIL preflight tooling and wiring docs
2026-05-10 Finalize HIL preflight tooling and VBUS calibration
2026-05-10 Calibrate VBUS telemetry to meter reading
2026-05-10 Resync Blue Pill UART parser on RX errors
    [uart_link.cpp]
2026-05-10 Reduce UART frame loss under HV tests
2026-05-10 Document VBUS telemetry wiring guard
2026-06-05 Finalize low-voltage HIL preflight
2026-06-12 Add precharge relay tooling and PCB wiring docs
2026-07-27 Harden STM32 safety and PWM test tooling
2026-08-06 Finalize Wi-Fi HMI and PWM safety validation
2026-08-08 Harden autonomous control and add Nucleo migration tooling
    [flash_unoq_sketch_090.cfg]
2026-08-09 Finalize MIC AI identification and research readiness
    [load_step_deadbeat_current_baseline.csv, load_step_dtc_hysteresis_baseline.csv, load_step_dtc_svm_baseline.csv, load_step_fcs_mpc_one_step_baseline.csv, load_step_foc_svm_key_baseline.csv, load_step_protected_ai_pwm_h1_baseline.csv, load_step_safe_neural_horizon_pwm_h2.csv, load_step_sensorless_adaptive_foc_baseline.csv]
2026-08-09 Harden low-voltage HIL safety and tooling
2026-08-09 Add fail-closed Nucleo control benchmark
    [config.h, main.cpp, motor_backend.h, motor_backend_pwm_bench.cpp, motor_backend_stub.cpp, motor_control_benchmark.cpp, motor_control_benchmark.h, motor_control_benchmark_test.cpp]
2026-08-21 Add AIR56B2 motor-control firmware package
    [mcsdk_acim_motor_profile.iek_air56b2_catalog_candidate.json, mcsdk_acim_motor_profile.iek_air56b2_nameplate_verified_vf.json, mcsdk_acim_motor_profile.template.json]
2026-08-26 Harden motor control and add research package
    [mcsdk_acim_motor_profile.iek_air56b2_catalog_operator_confirmed_vf_candidate.json, mcsdk_acim_motor_profile.iek_air56b2_nameplate_verified_vf.json]
2026-08-26 Align AIR56 research and harden model transfer
    [mcsdk_acim_motor_profile.iek_air56b2_catalog_operator_confirmed_vf_candidate.json]
2026-08-26 Correct conformal coverage inference and audit replay
    [cyclic_conformal_reachability.py]
2026-08-26 Run locked C6 revalidation and power audit
2026-08-26 Prepare fail-safe Nucleo and Uno Q firmware
    [UNOQ_MOTOR.ino, firmware_config_safety_check.py, main.c, server.py, unoq_wifi_firmware_update_selftest.py, verify_board_flash_package_selftest.py]
2026-08-26 Fix standalone board flasher path resolution
2026-08-26 Add verified board flash package
    [flash_unoq_sketch_090.cfg]
2026-08-28 Freeze pre-hardware SIL research package
    [AIR56B2_EXPERIMENT_LOG_TEMPLATE.csv, AIR56B2_EXPERIMENT_MATRIX.csv, MIC_AI_NUCLEO_CONNECTIONS.csv, MIC_AI_REV2_BOM.csv, MIC_AI_REV2_CONNECTIONS.csv, MIC_AI_REV2_PINMAP.csv]
2026-09-14 Add autonomous safety gates and AIR56B2 research
    [nucleo_uart_pins_readonly.cfg, unoq_uart_pins_readonly.cfg, verify_unoq_sketch.cfg]
2026-10-08 Preserve bench debugging, Uno Q 804 and Nucleo 801 snapshots
    Include Wi-Fi observability, UART guards, deferred logging, AS5600 integration, wiring documentation and regression reports. Archive the installed firmware with exact-byte manifests; retain explicit limits of zero-bus fixture validation and no HV approval.
