11lisov11/mic_practice/(notices)

Notices in the files:
artifacts/current_pwm_20261008/uart_guard_801/baseline/main_708.c:
This software is licensed under terms that can be found in the LICENSE file
